ibm2030/EDUC8/E8Serial/Video terminal /ConstructionPack/Terminal.jpg

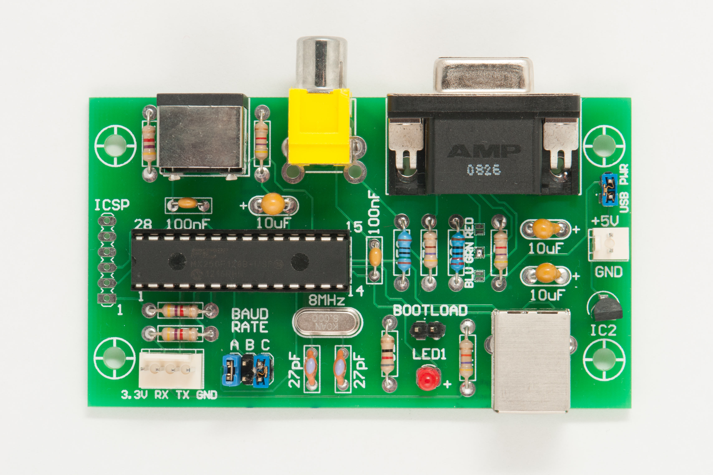
E8Serial/Video terminal /ConstructionPack/Terminal.jpg
