ibm2030/EDUC8/octal. keyboard/octal keyboard/assembled keyboard.jpeg

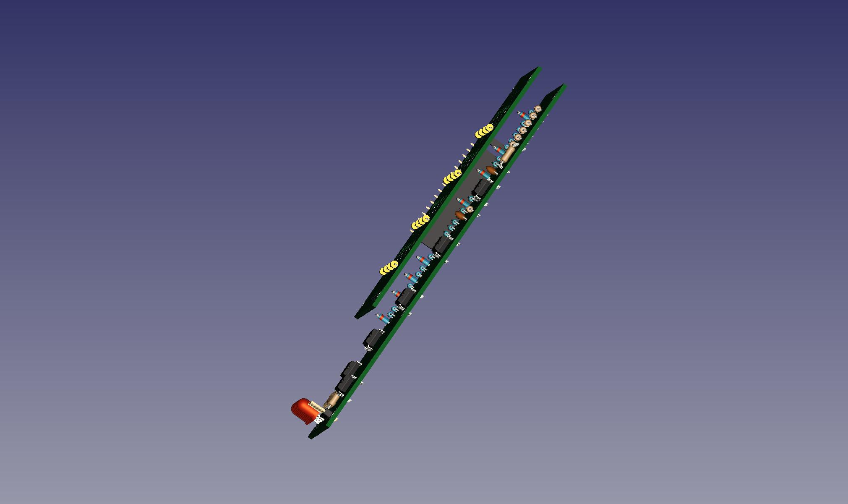
octal. keyboard/octal keyboard/assembled keyboard.jpeg
