ibm2030/EDUC8/README.md

# EDUC8
EDUC-8 recreation by Gwyllym Suter
