ibm2030/EDUC8/ASCII keyboard/DSAP008112.pdf

This Material Copyrighted By Its Respective Manufacturer
