ibm2030/EDUC8/256 word memory/2102.pdf - Google Drive.pdf

## Page 1 of 4

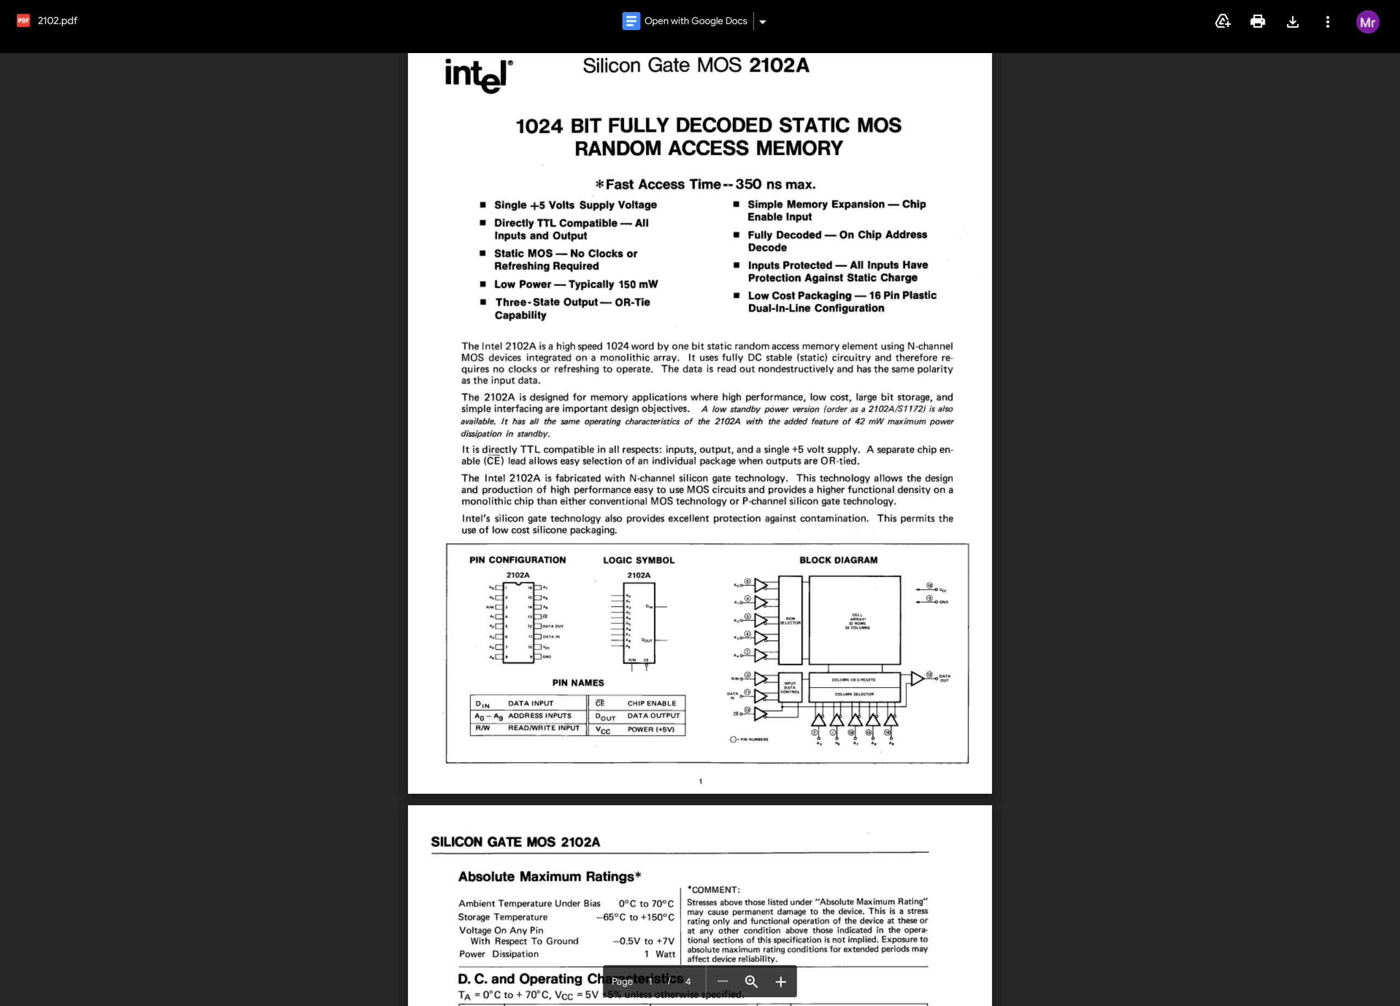
[picture p22: page 1]

## Page 2 of 4

Page | 1 | / | 4
2102.pdf | Open with Google Docs
