ibm2030/EDUC8/PC and ADDER 74LS74 MOD/7480.pdf

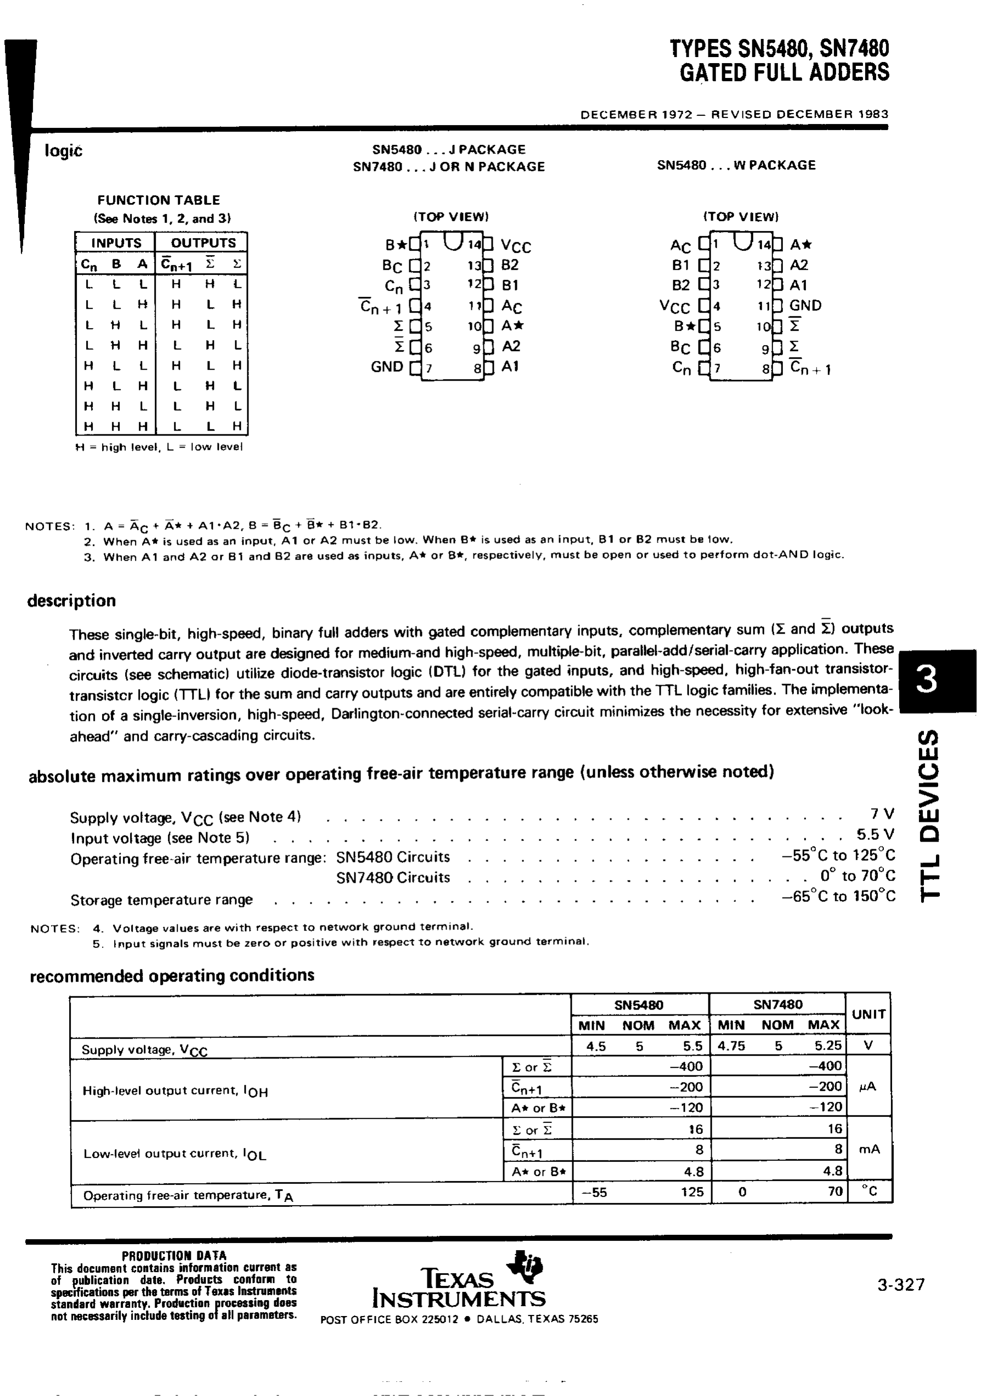
[picture p23: page 1]
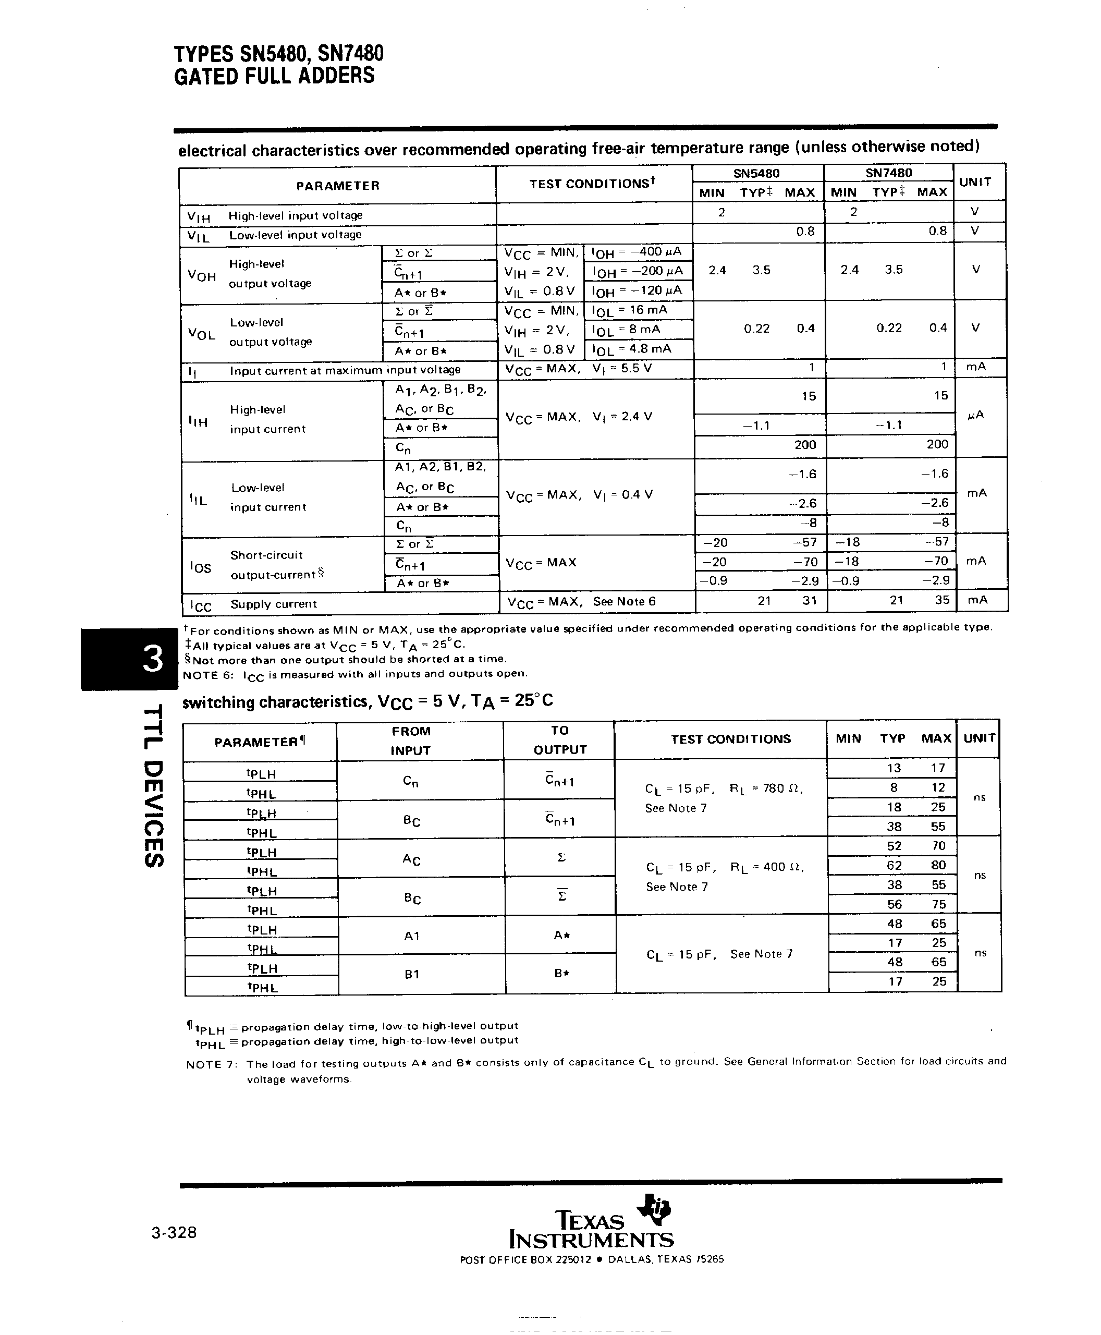
[picture p24: page 2]
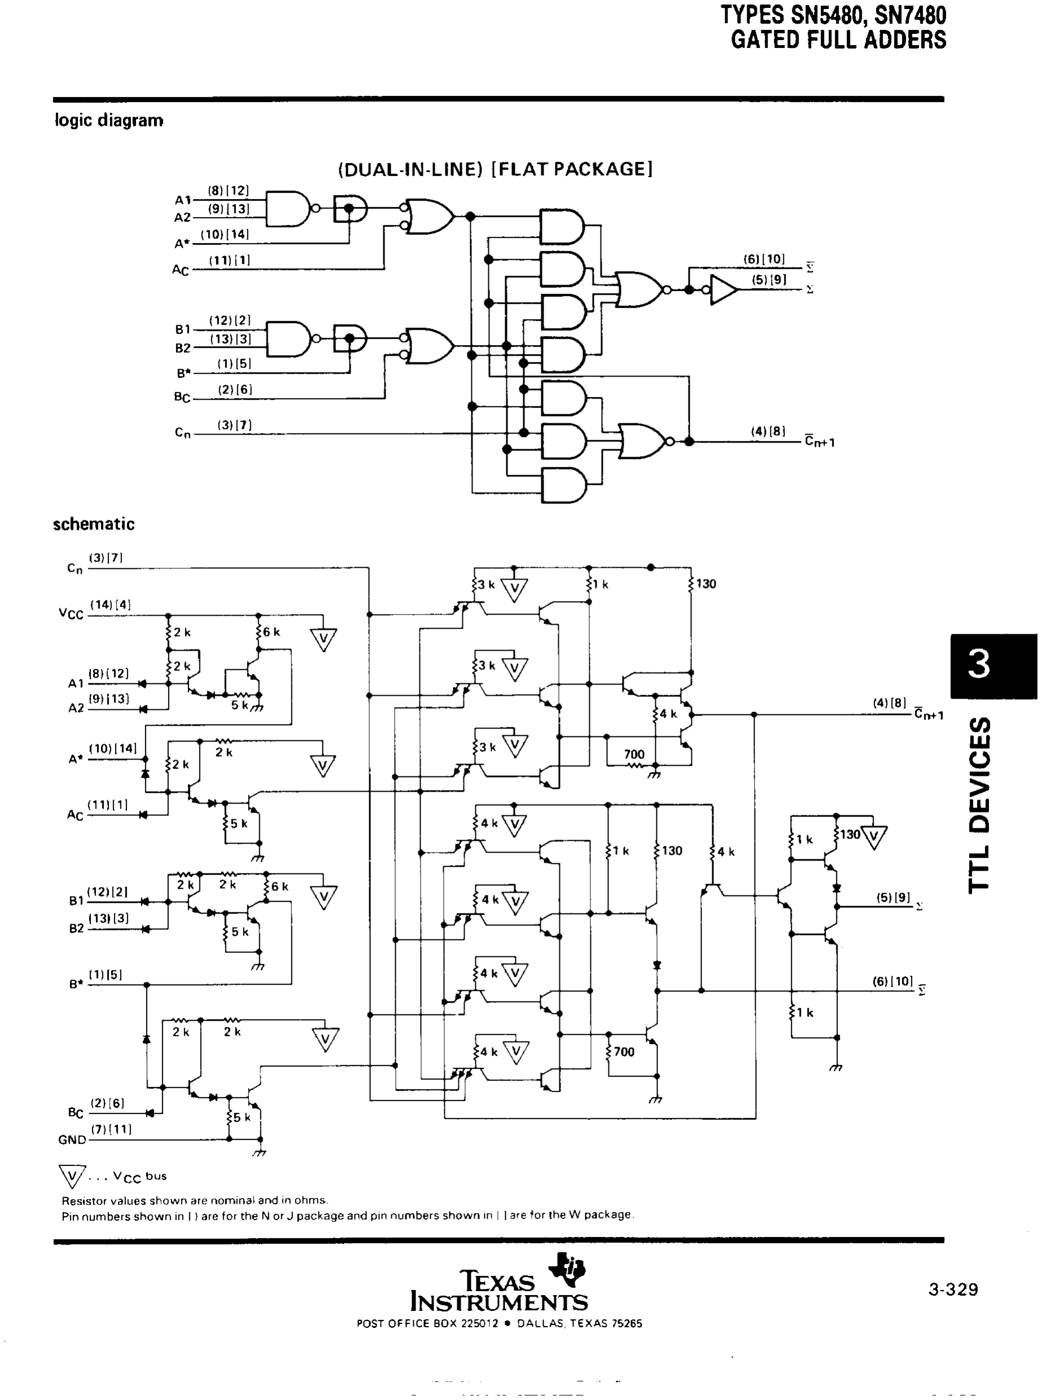
[picture p25: page 3]
