ibm2030/EDUC8/Octal display 2/DSA-300936.pdf

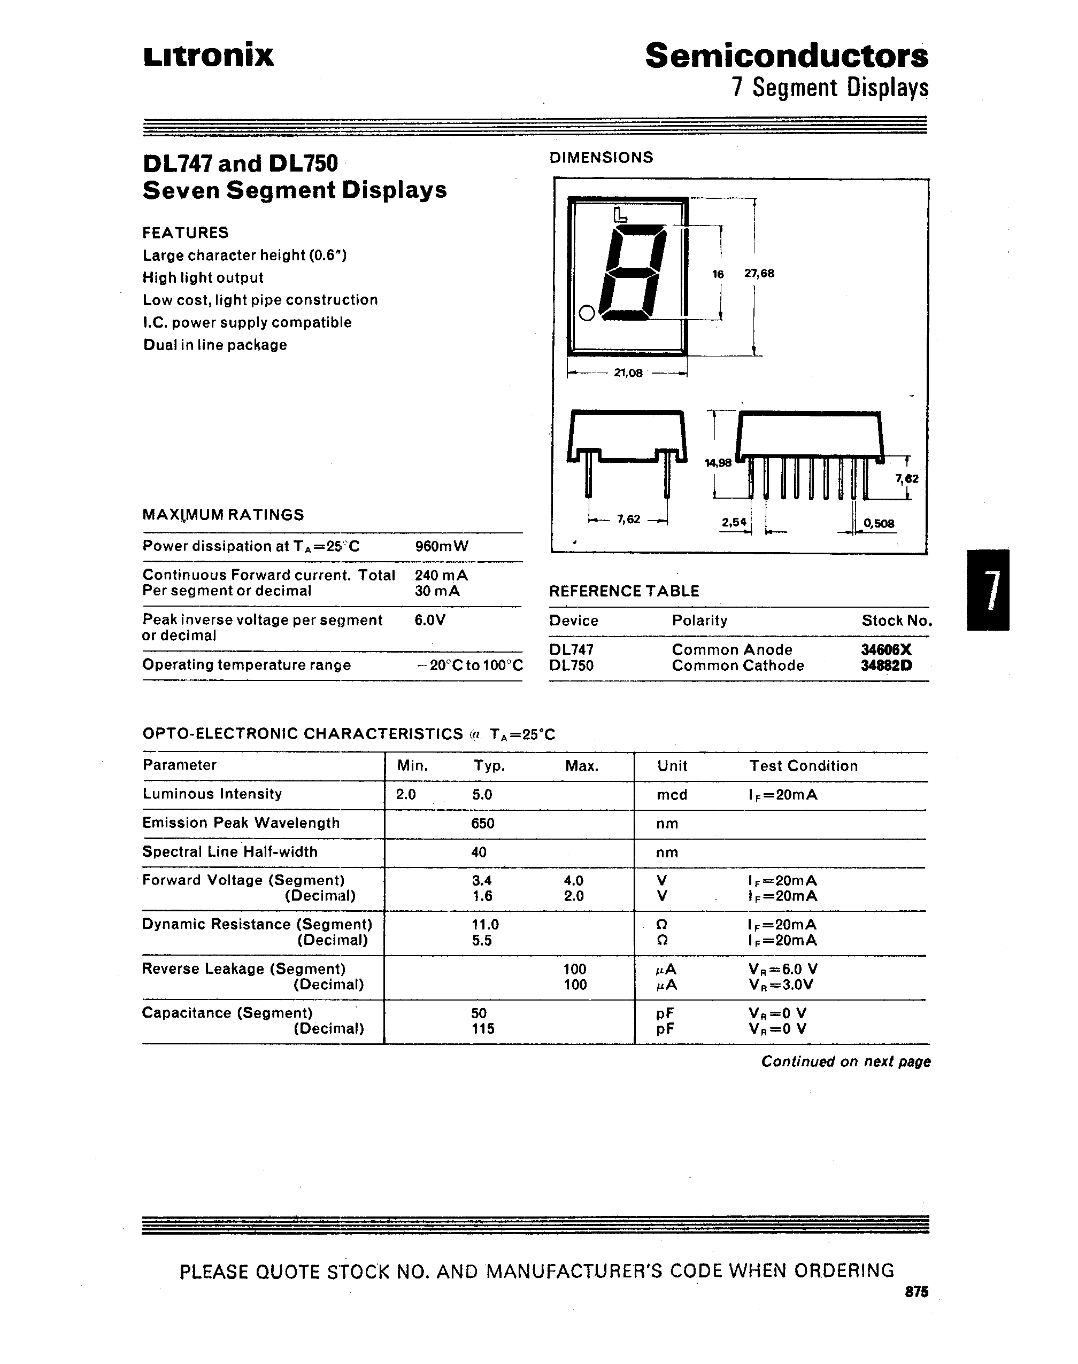
[picture p26: page 1]
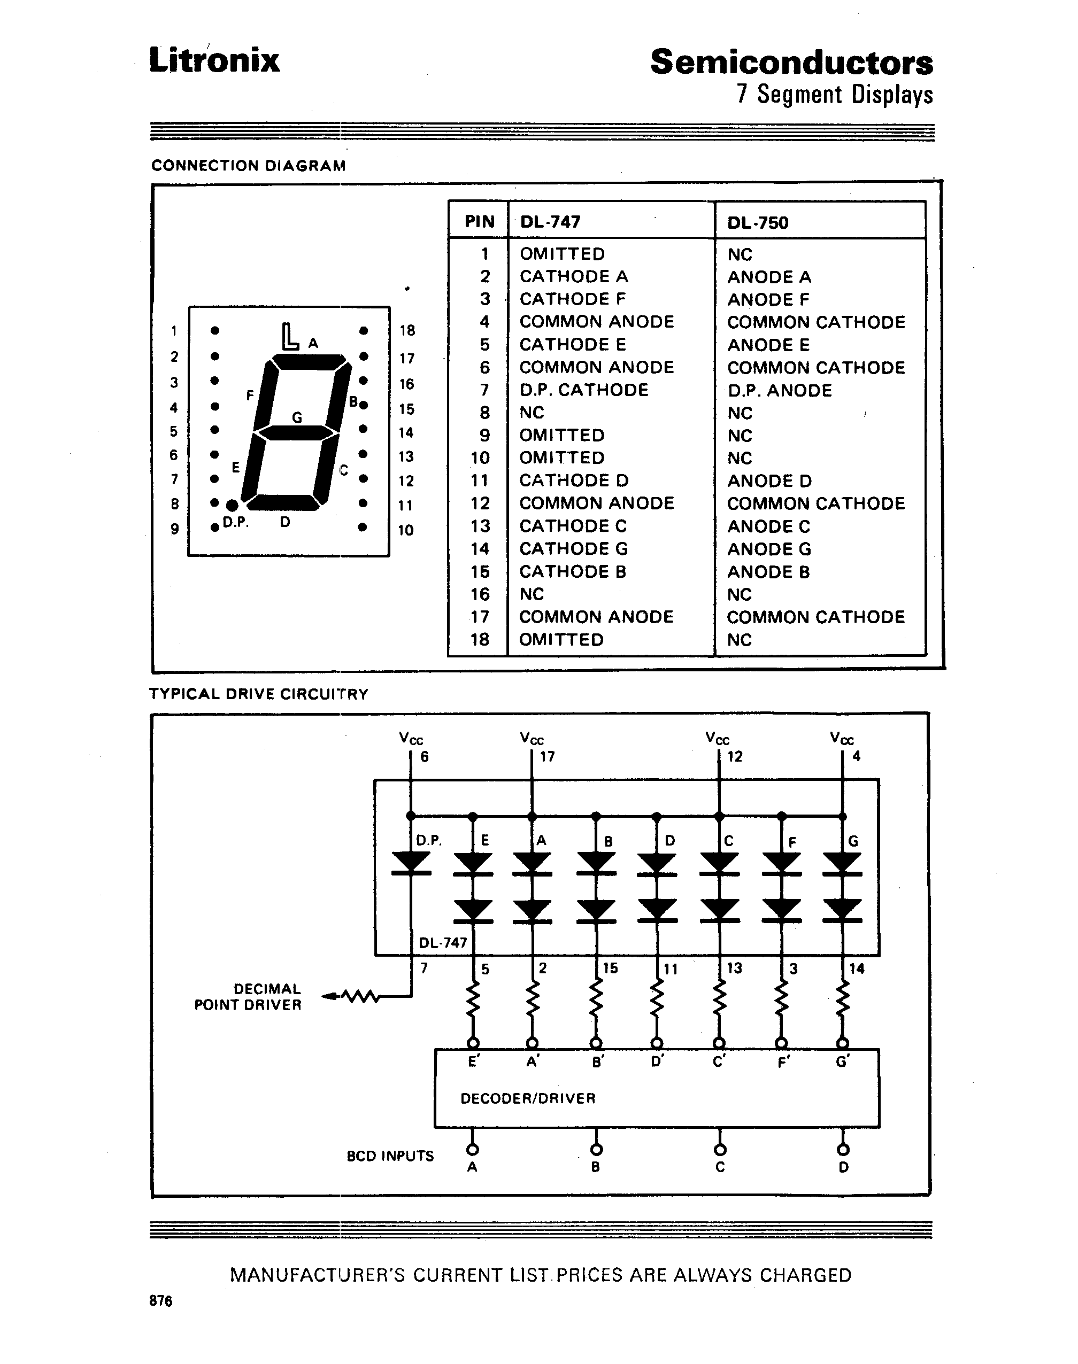
[picture p27: page 2]
