ibm2030/EDUC8/Music Player/DSA2IH0021361.pdf

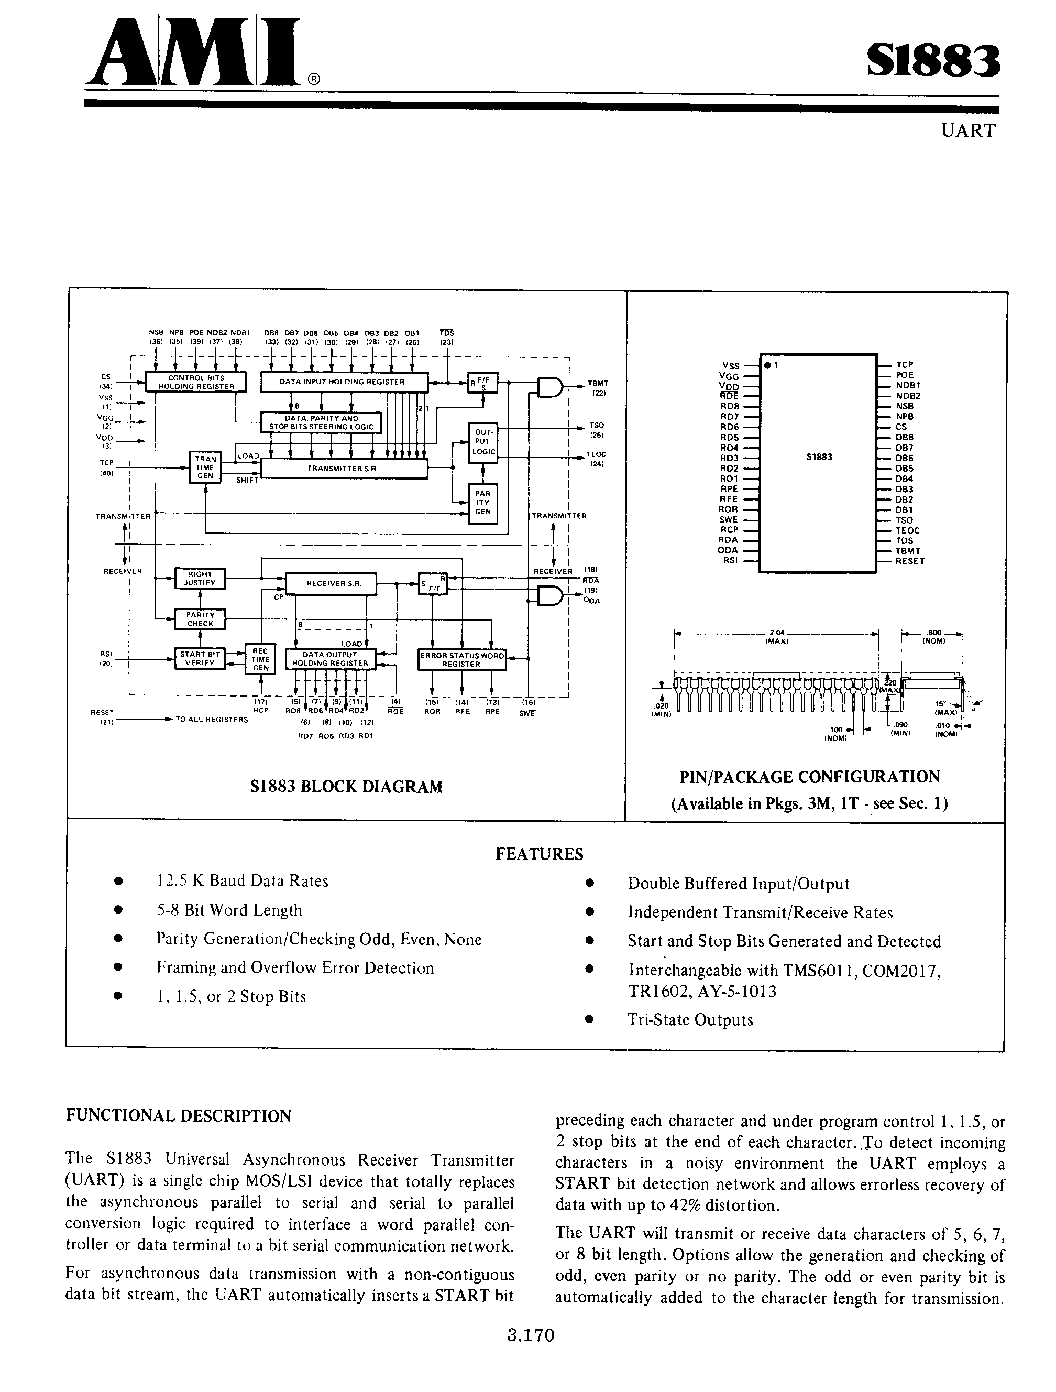
[picture p28: page 1]
