ibm2030/EDUC8/3D MODELS/din-5-connector-female-1/Renderings/IMG_002.JPG

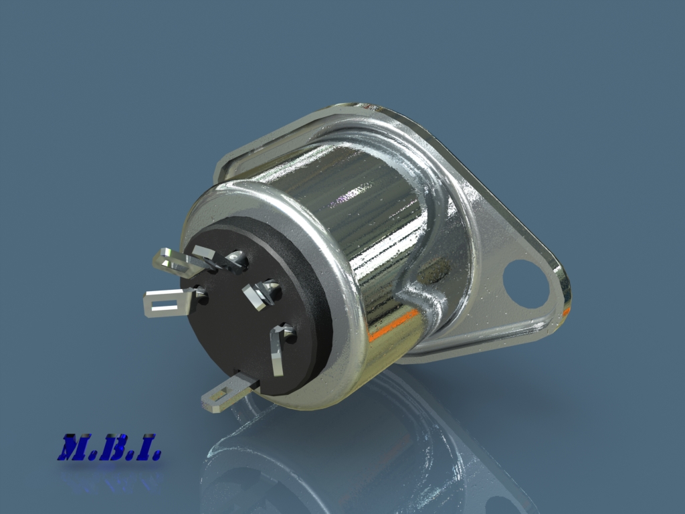
3D MODELS/din-5-connector-female-1/Renderings/IMG_002.JPG
