ibm2030/EDUC8/128 X 16 RAM V5 FINAL/128 X 16 RAM V4 FINAL .jpg

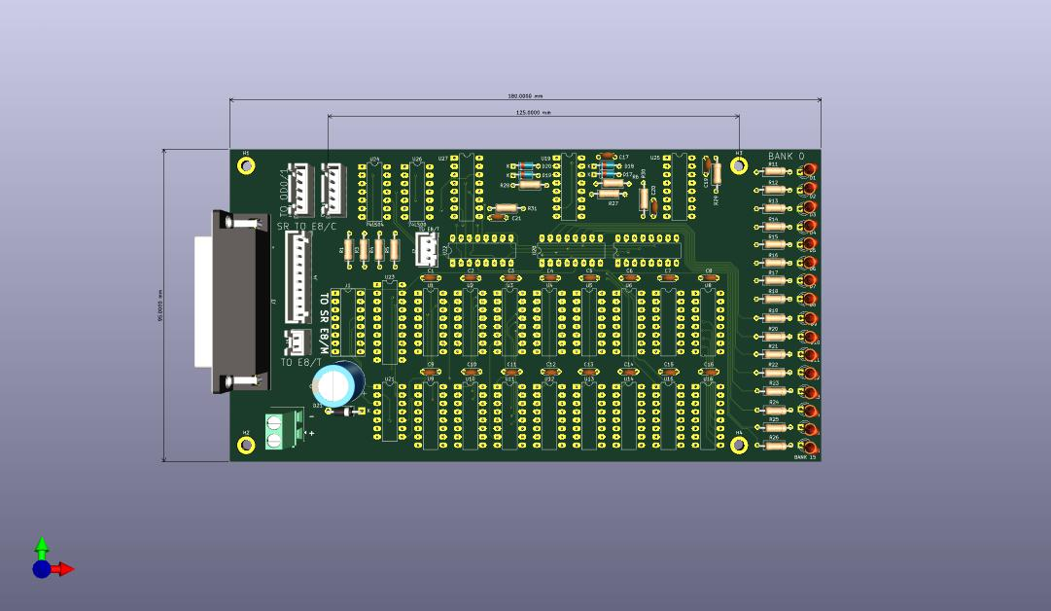
128 X 16 RAM V5 FINAL/128 X 16 RAM V4 FINAL .jpg
