ibm2030/EDUC8/256 word memory/256 word memory 2.0/256 word memory_2.0 bottom.jpg

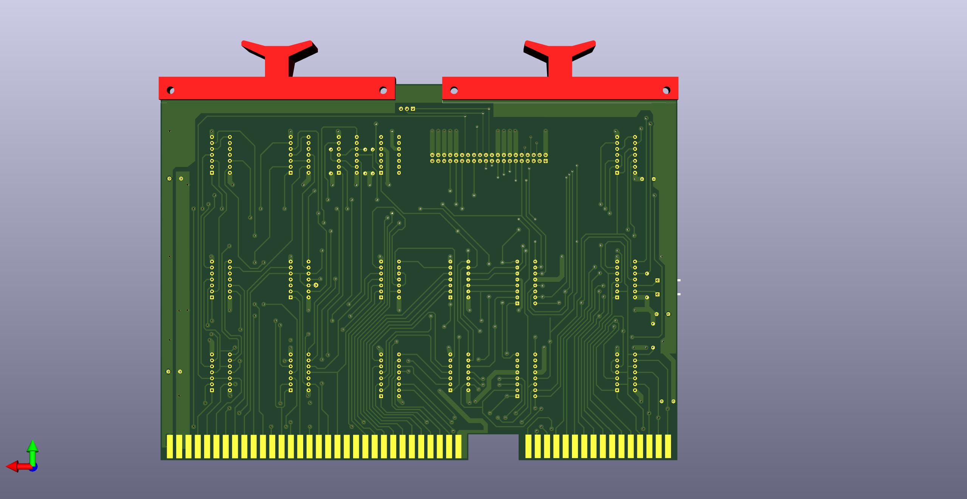
256 word memory/256 word memory 2.0/256 word memory_2.0 bottom.jpg
