ibm2030/EDUC8/256 word memory/256 word memory bottom.jpg

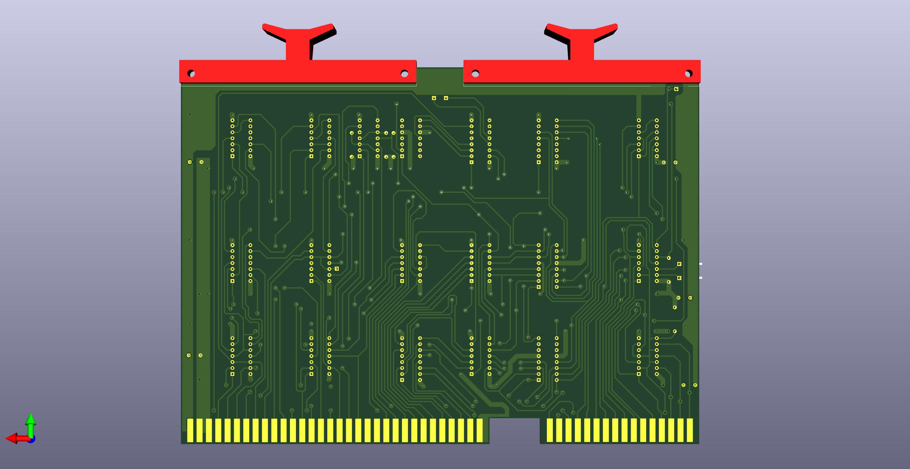
256 word memory/256 word memory bottom.jpg
