ibm2030/EDUC8/256 word memory/256 word memory.jpg

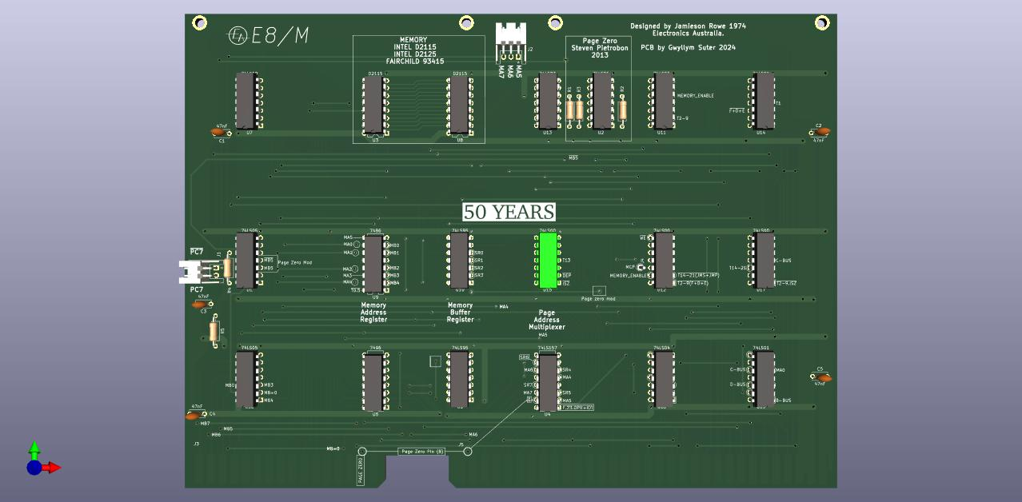
256 word memory/256 word memory.jpg
