ibm2030/EDUC8/20240601_193604.jpeg

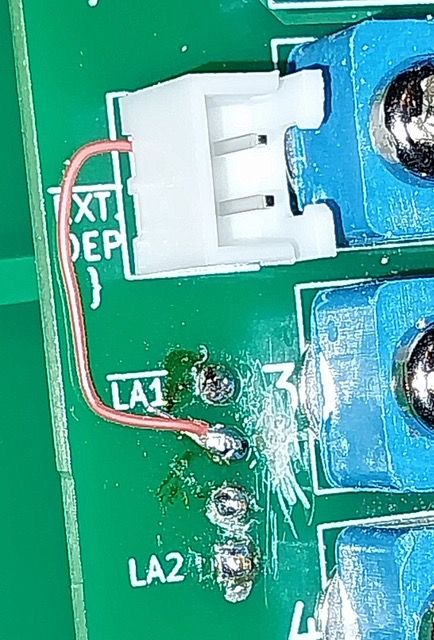
20240601_193604.jpeg
