ibm2030/EDUC8/Accumulator/Accumulator bottom.jpg

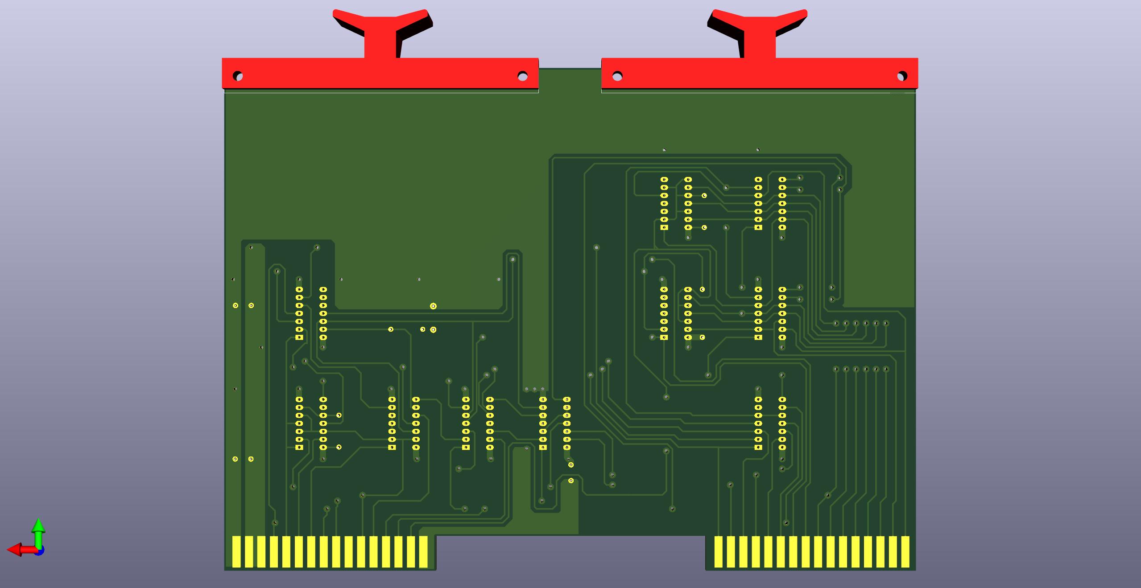
Accumulator/Accumulator bottom.jpg
