ibm2030/EDUC8/Accumulator/Accumulator top.jpg

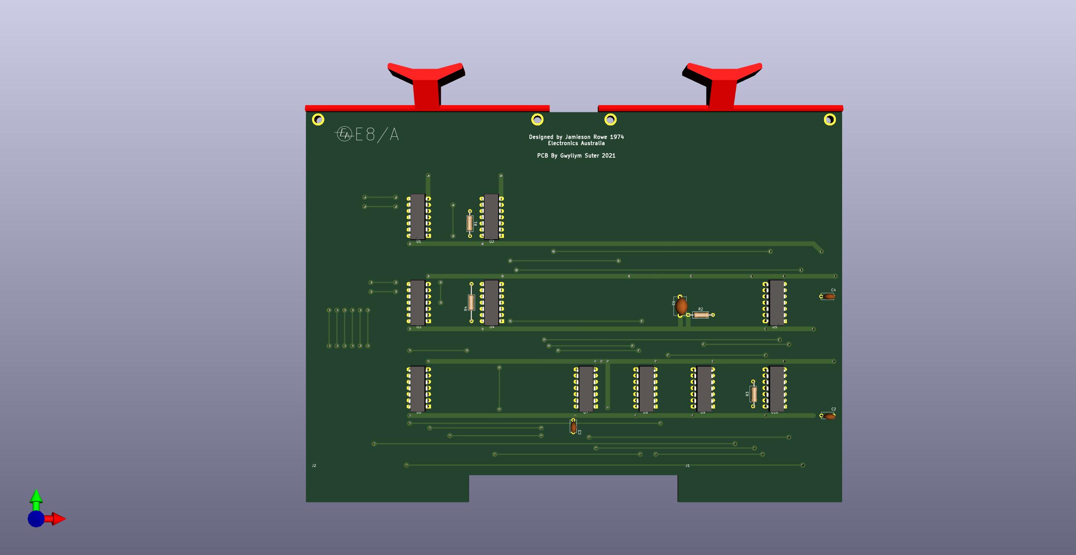
Accumulator/Accumulator top.jpg
