ibm2030/EDUC8/Accumulator/Accumulator.jpg

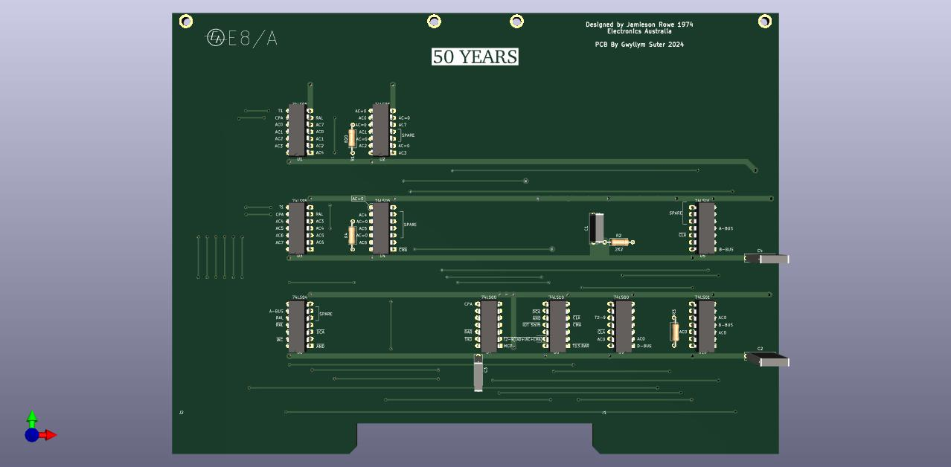
Accumulator/Accumulator.jpg
