ibm2030/EDUC8/ASCII keyboard/ASCII keyboard bottom..jpg

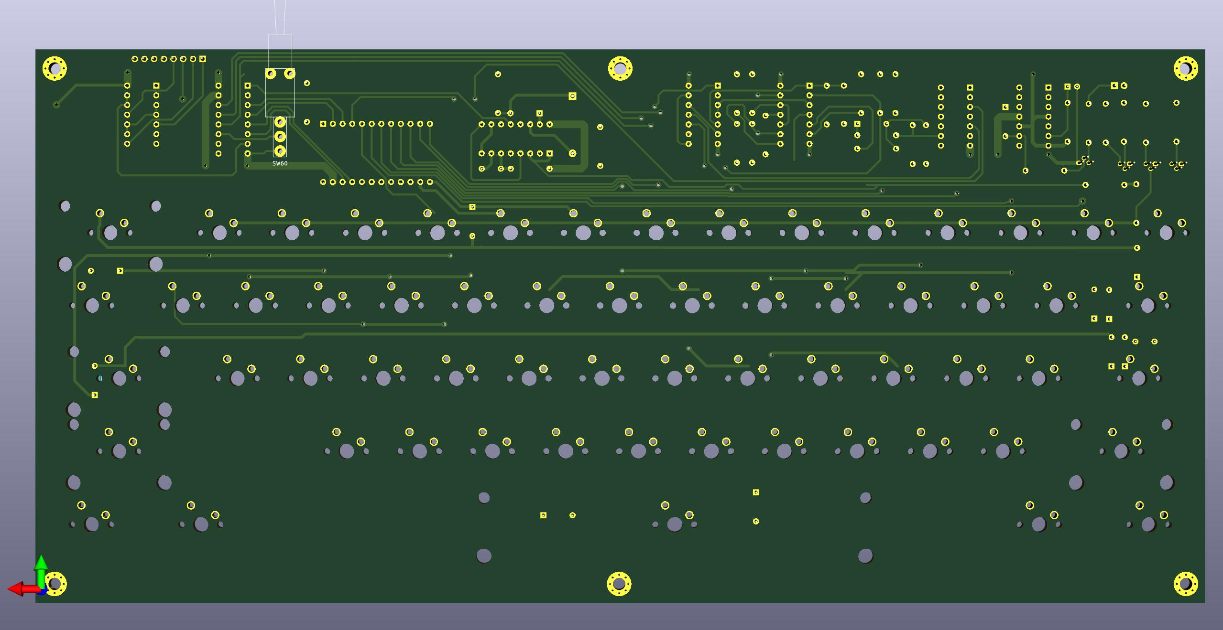
ASCII keyboard/ASCII keyboard bottom..jpg
