ibm2030/EDUC8/ASCII keyboard/ASCII keyboard.jpg

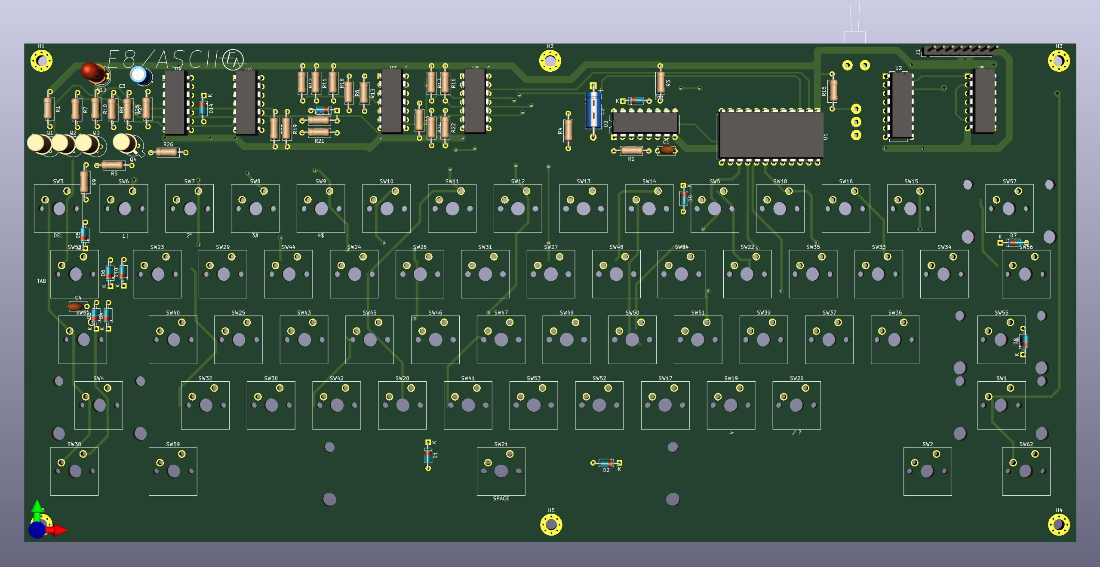
ASCII keyboard/ASCII keyboard.jpg
