ibm2030/EDUC8/ASCII keyboard/ASCII keyboard_bottom.jpg

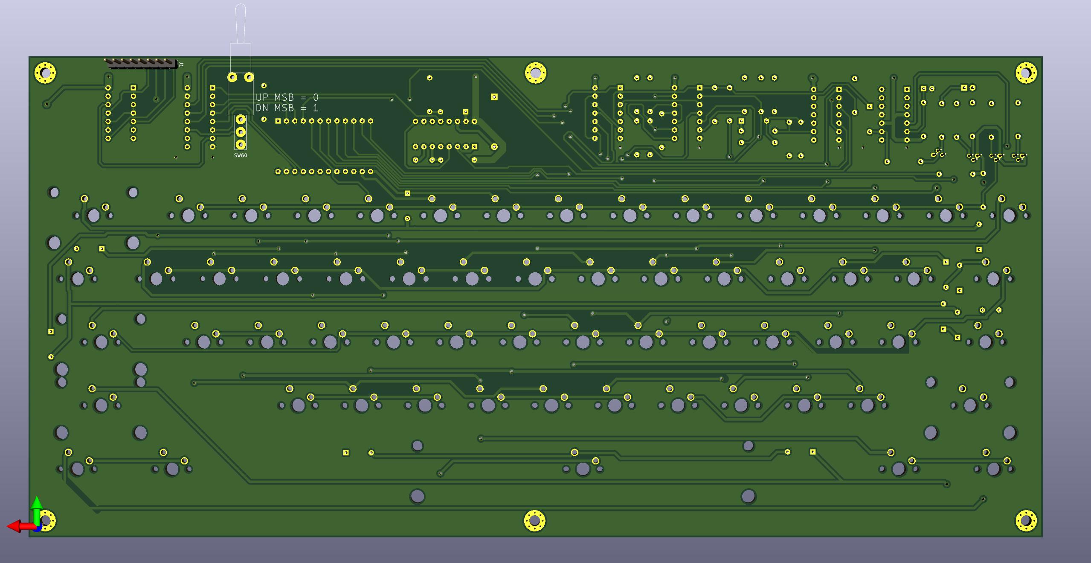
ASCII keyboard/ASCII keyboard_bottom.jpg
