ibm2030/EDUC8/ASCII keyboard/ASCII keyboard_top.jpg

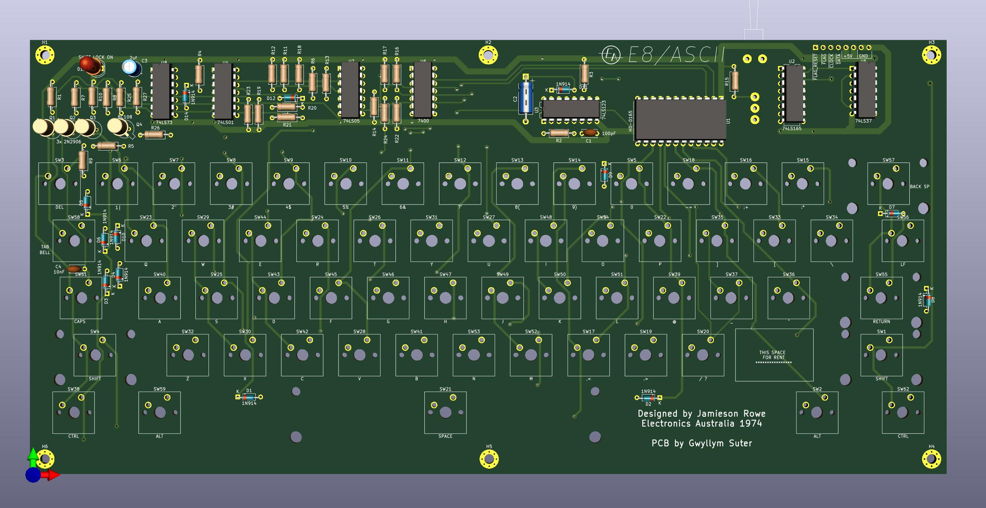
ASCII keyboard/ASCII keyboard_top.jpg
