ibm2030/EDUC8/Buffer/Buffer bottom.jpg

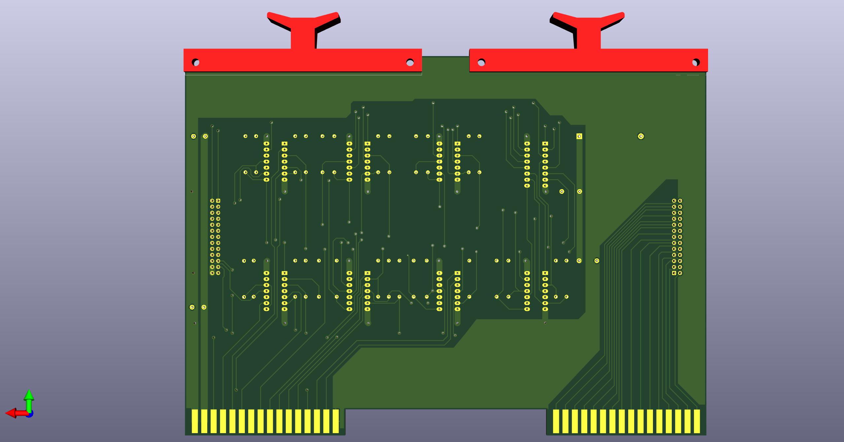
Buffer/Buffer bottom.jpg
