ibm2030/EDUC8/Buffer/Buffer.jpg

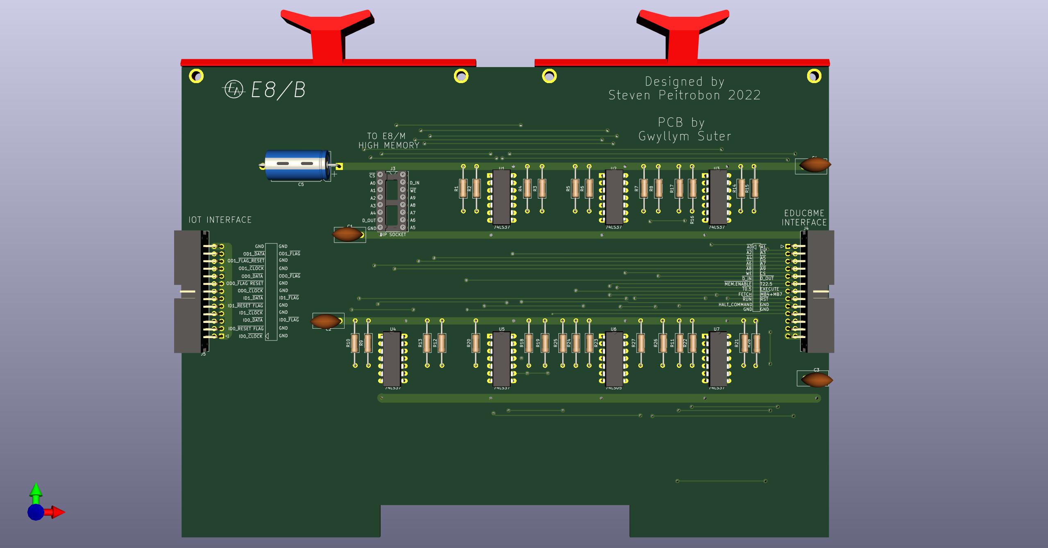
Buffer/Buffer.jpg
