ibm2030/EDUC8/Decoder/educ 8 decoder bottom.jpg

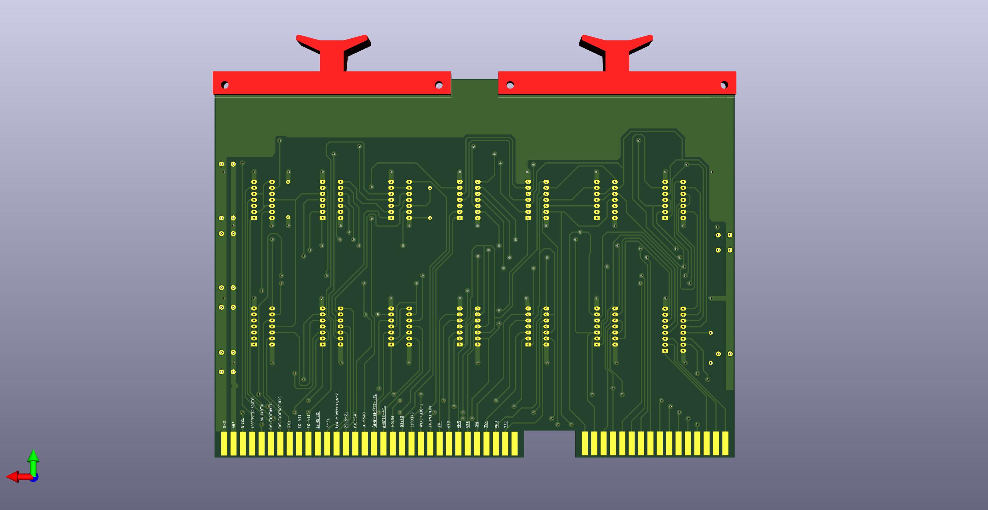
Decoder/educ 8 decoder bottom.jpg
