ibm2030/EDUC8/Decoder/educ 8 decoder top.jpg

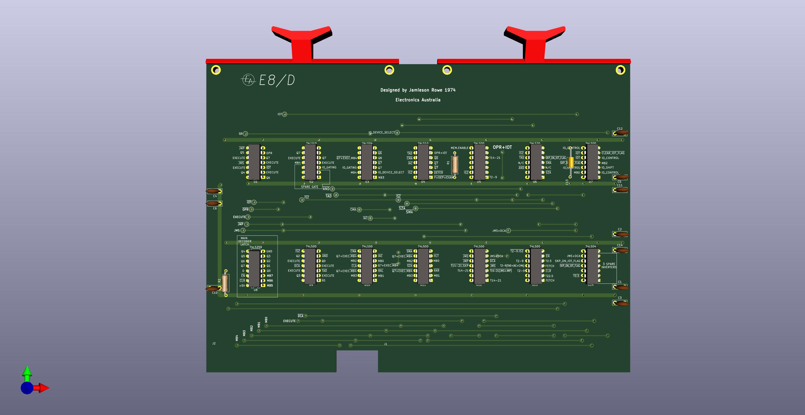
Decoder/educ 8 decoder top.jpg
