ibm2030/EDUC8/Decoder/educ 8 decoder.jpg

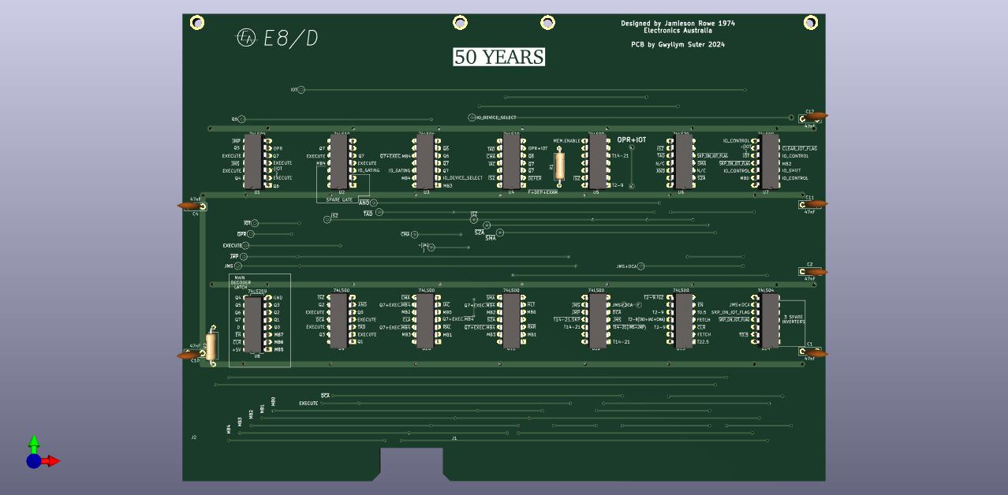
Decoder/educ 8 decoder.jpg
