ibm2030/EDUC8/Decoder/educ 8 decoder_bottom.jpg

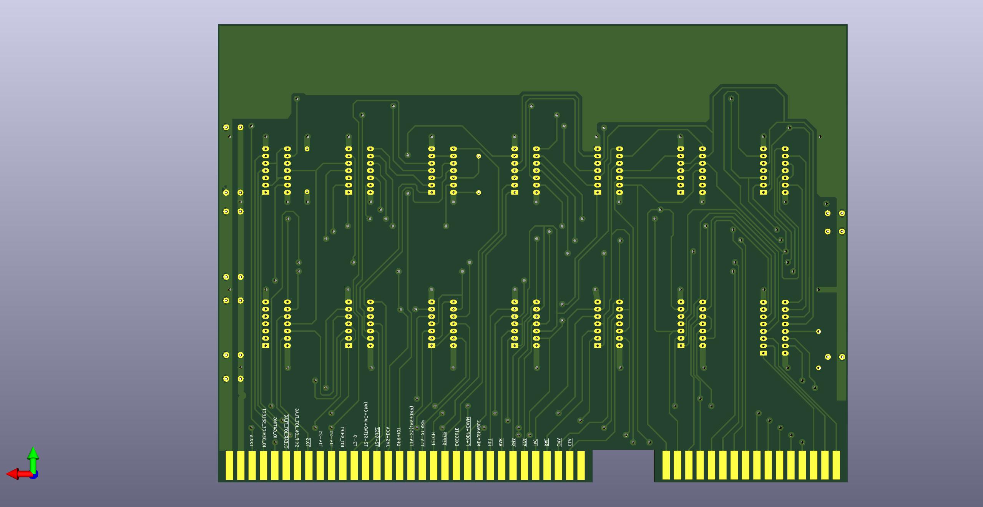
Decoder/educ 8 decoder_bottom.jpg
