ibm2030/EDUC8/E8Serial/Video terminal /ConstructionPack/Schematic V3.png

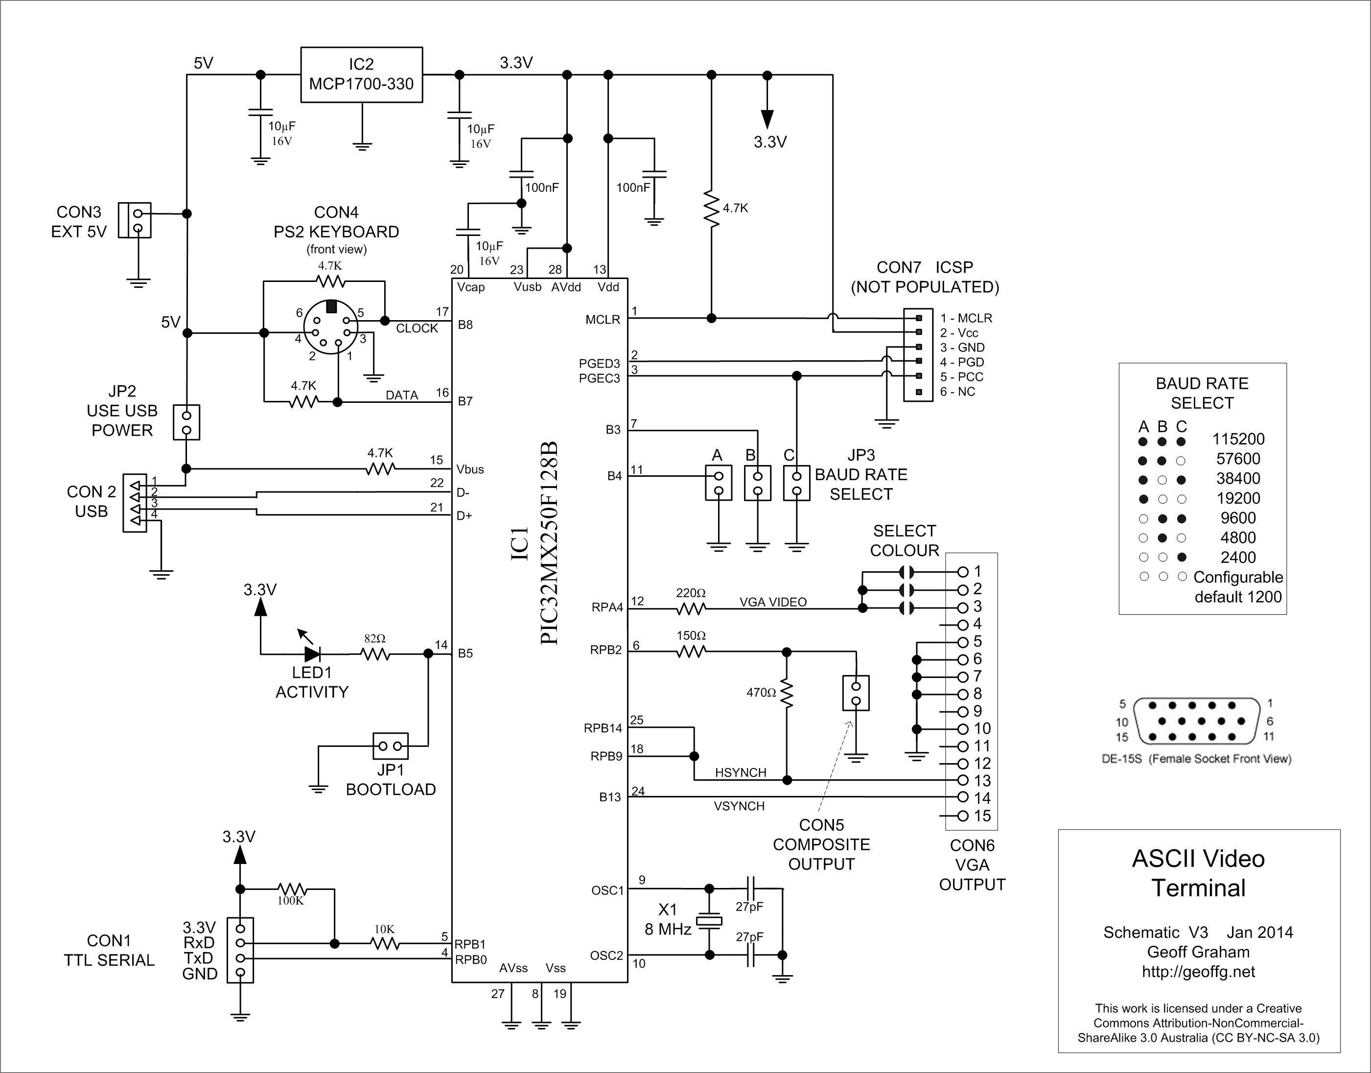
E8Serial/Video terminal /ConstructionPack/Schematic V3.png
