ibm2030/EDUC8/E8Serial/Video terminal /final video.jpeg

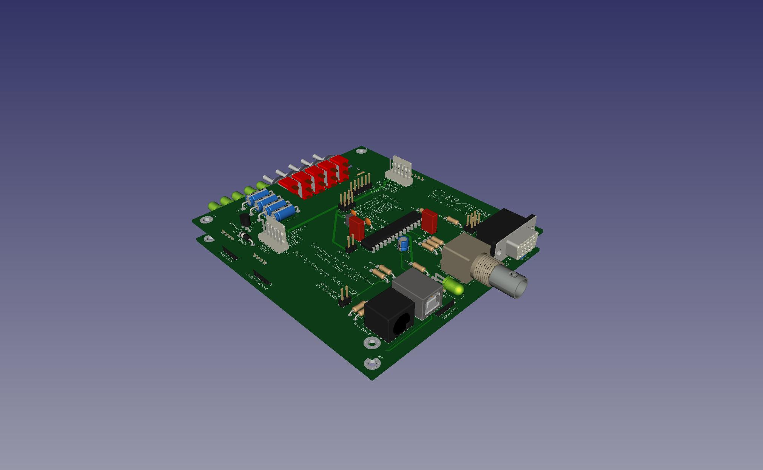
E8Serial/Video terminal /final video.jpeg
