ibm2030/EDUC8/E8Serial/Video terminal /Video terminal bottom.jpg

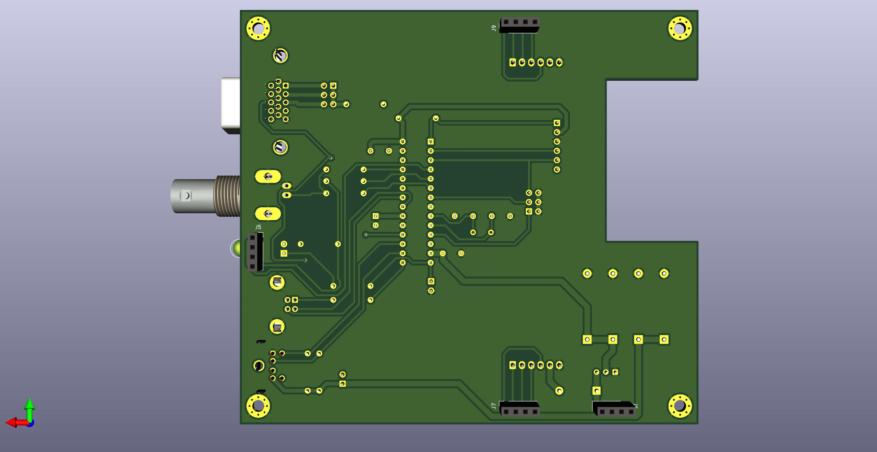
E8Serial/Video terminal /Video terminal bottom.jpg
