ibm2030/EDUC8/EXTENDER CARDS/EXTENDER CARD_BOTTOM.jpg

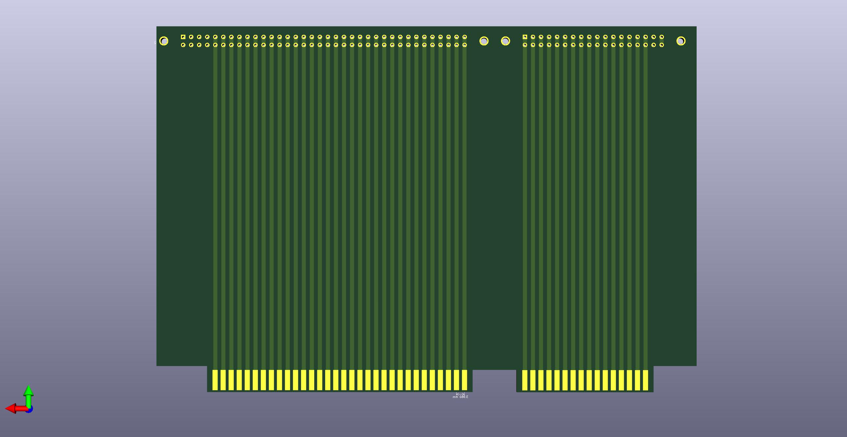
EXTENDER CARDS/EXTENDER CARD_BOTTOM.jpg
