ibm2030/EDUC8/EXTENDER CARDS/EXTENDER CARD_TOP.jpg

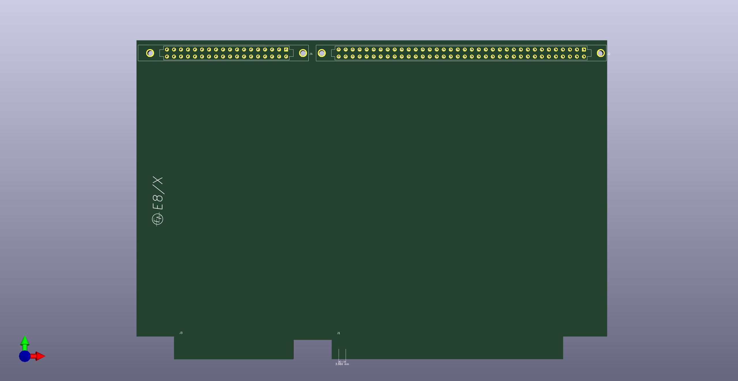
EXTENDER CARDS/EXTENDER CARD_TOP.jpg
