ibm2030/EDUC8/Front panel PCB/Front panel/Front panel.jpg

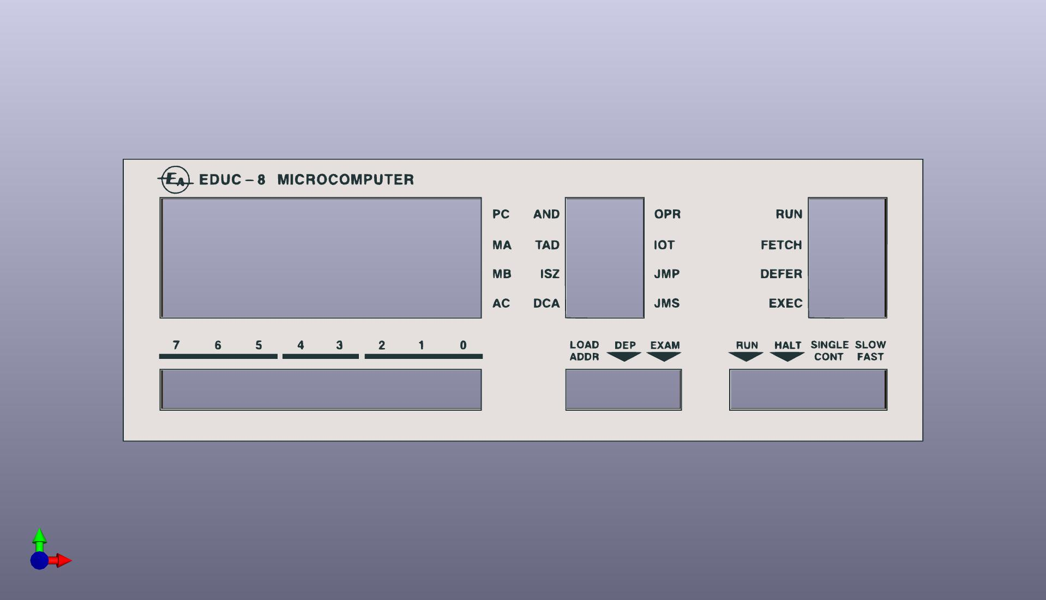
Front panel PCB/Front panel/Front panel.jpg
