ibm2030/EDUC8/front panel/Original with 9602/front panel 9602 bottom.jpg

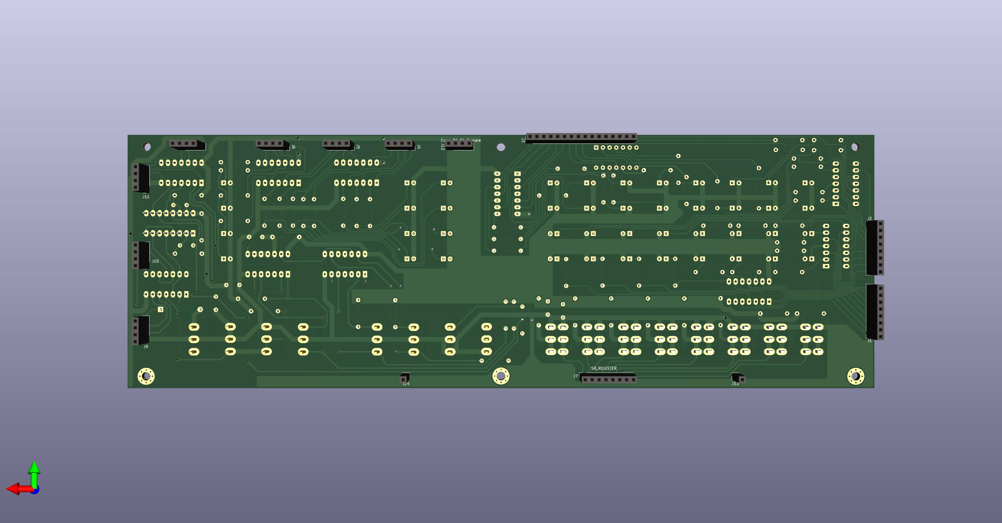
front panel/Original with 9602/front panel 9602 bottom.jpg
