ibm2030/EDUC8/Housing/switch lever/Blue swtich lever.jpeg

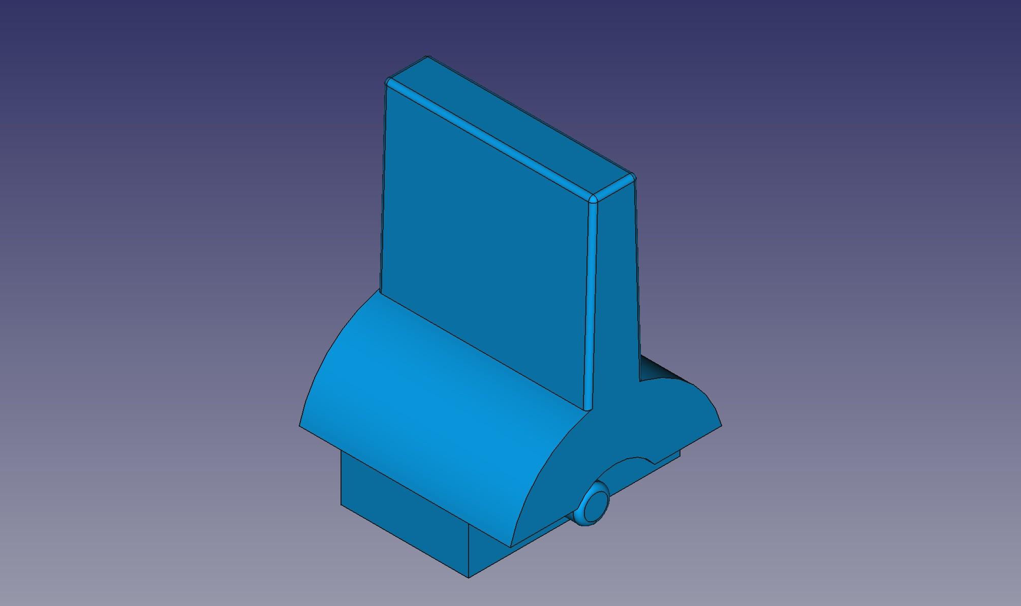
Housing/switch lever/Blue swtich lever.jpeg
