ibm2030/EDUC8/Housing/switch lever/Green switch lever.jpeg

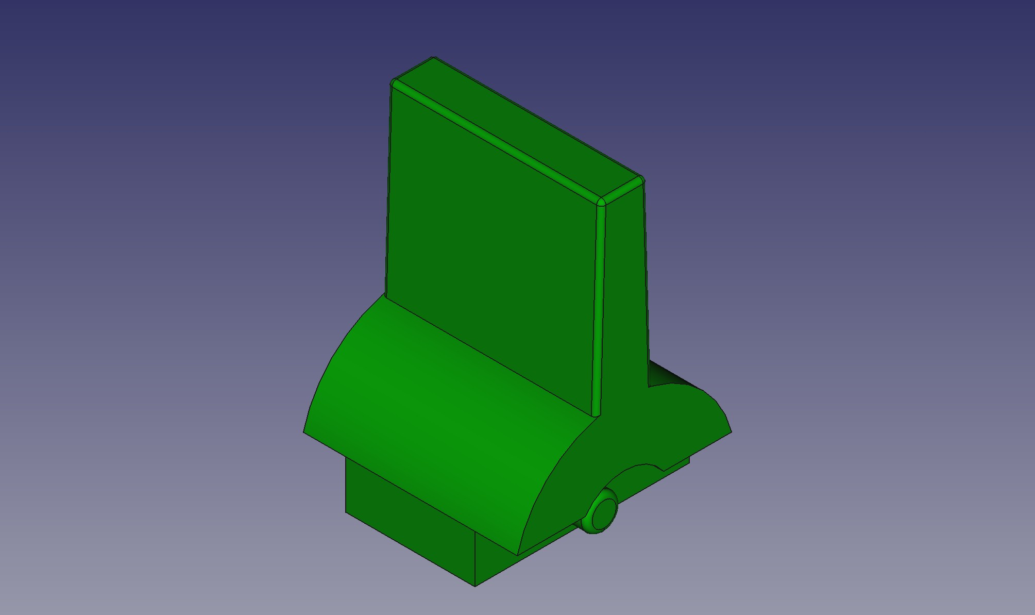
Housing/switch lever/Green switch lever.jpeg
