ibm2030/EDUC8/Input:Output Interface/Input:Output Interface.jpg

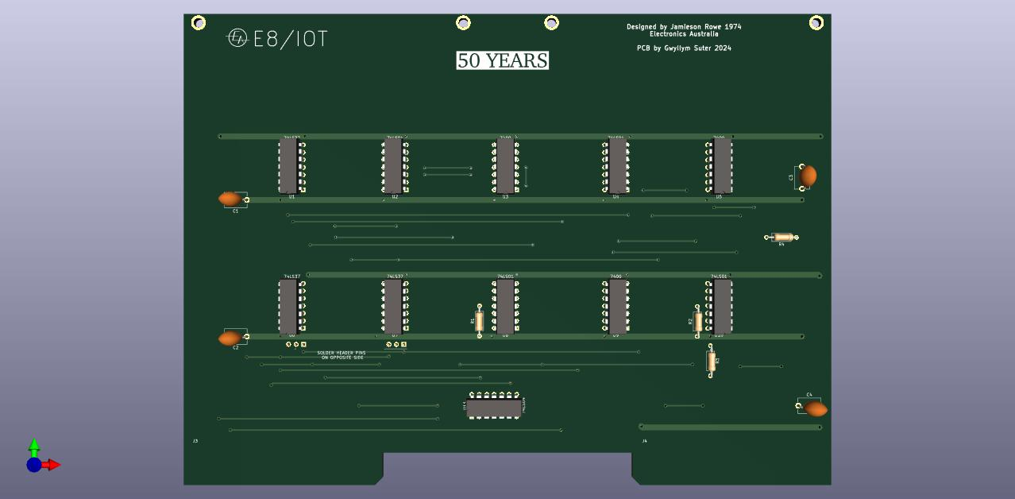
Input:Output Interface/Input:Output Interface.jpg
