ibm2030/EDUC8/motherboard/motherboard bottom.jpg

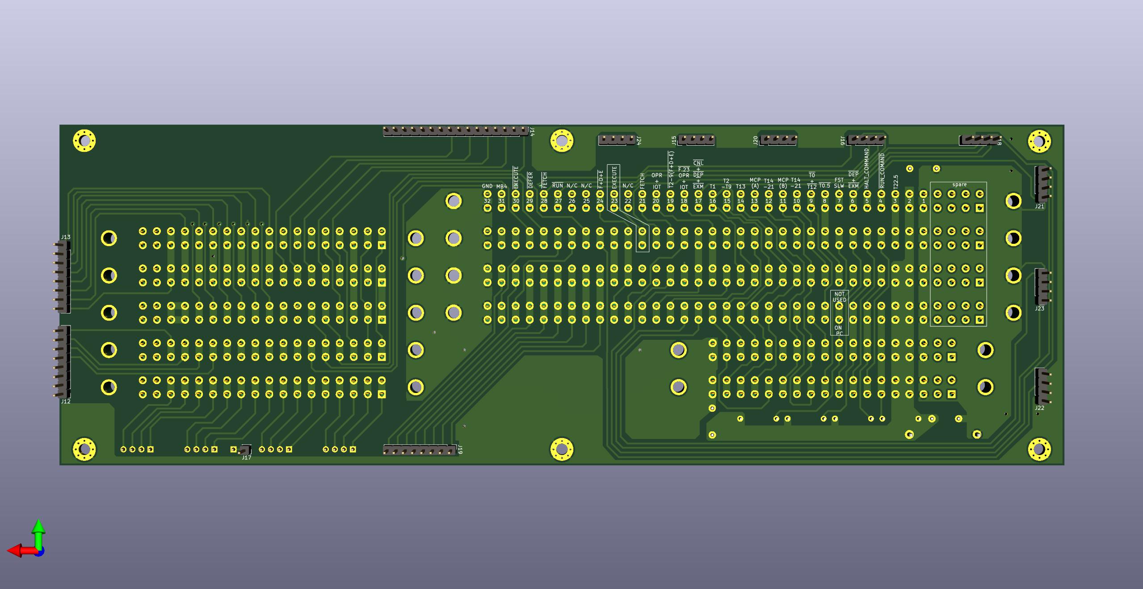
motherboard/motherboard bottom.jpg
