ibm2030/EDUC8/motherboard/motherboard top.jpg

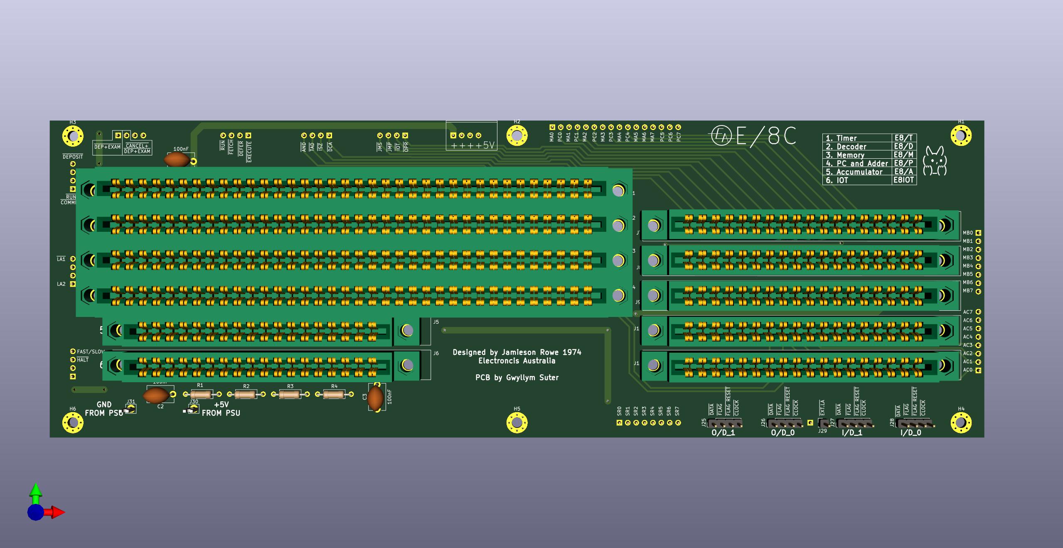
motherboard/motherboard top.jpg
