ibm2030/EDUC8/motherboard/motherboard.jpg

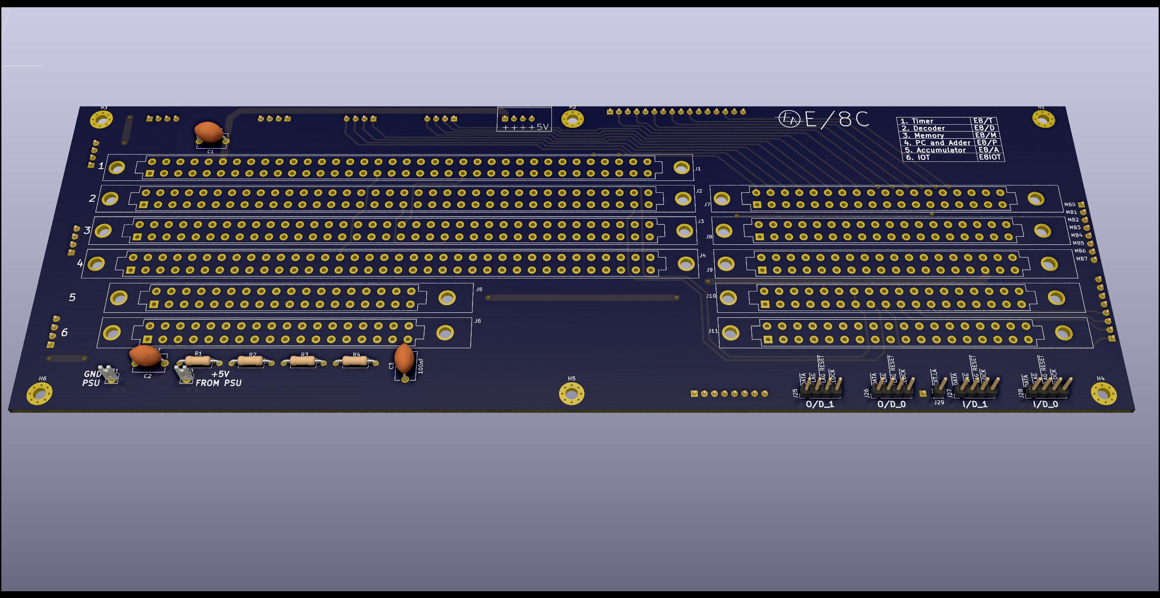
motherboard/motherboard.jpg
