ibm2030/EDUC8/motherboard/motherboard_bottom.jpg

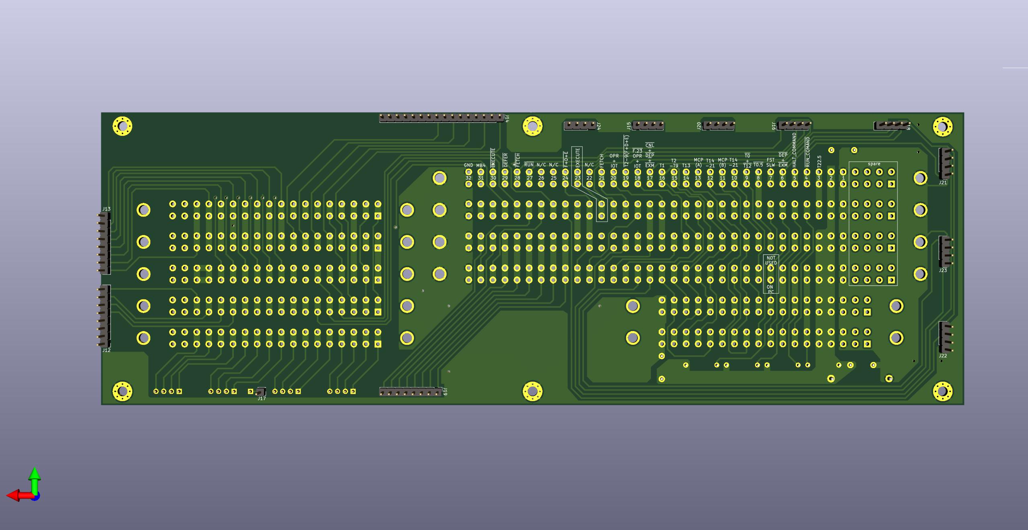
motherboard/motherboard_bottom.jpg
