ibm2030/EDUC8/multiplexer/E8MX:M/multiplexer bottom.jpg

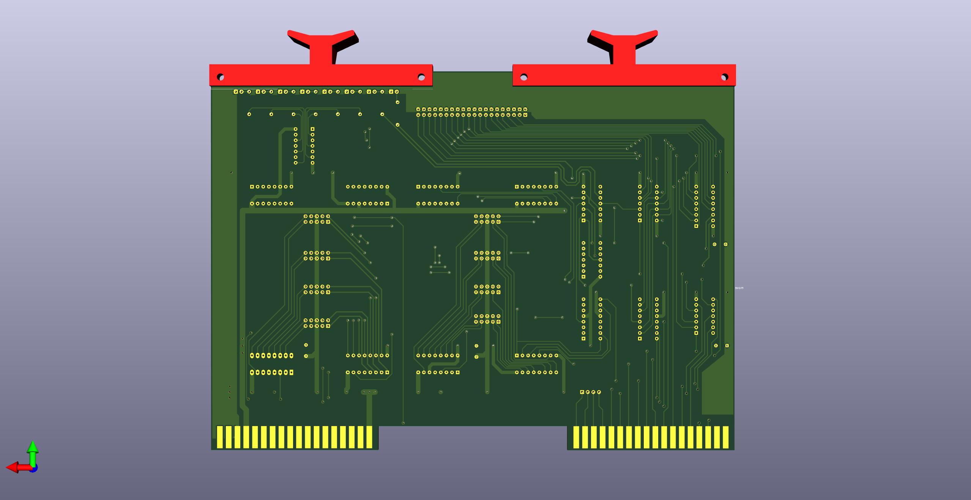
multiplexer/E8MX:M/multiplexer bottom.jpg
