ibm2030/EDUC8/multiplexer/E8MX:M/multiplexer top.jpg

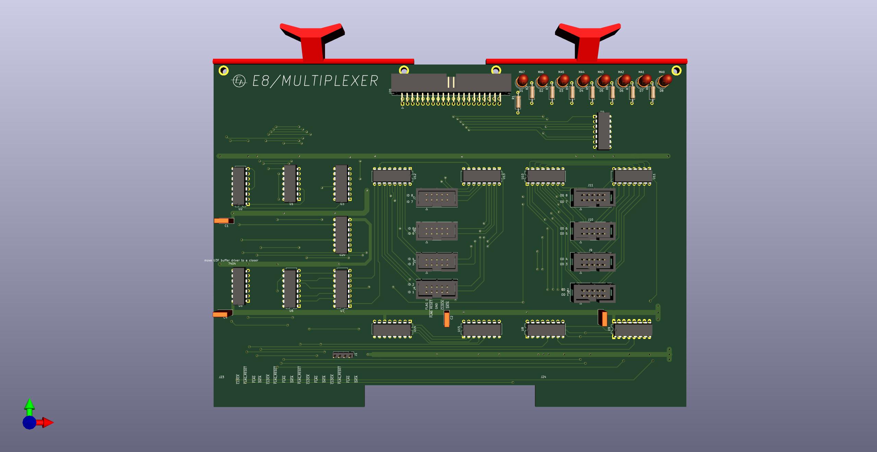
multiplexer/E8MX:M/multiplexer top.jpg
