ibm2030/EDUC8/multiplexer/E8MX:M/multiplexer.jpg

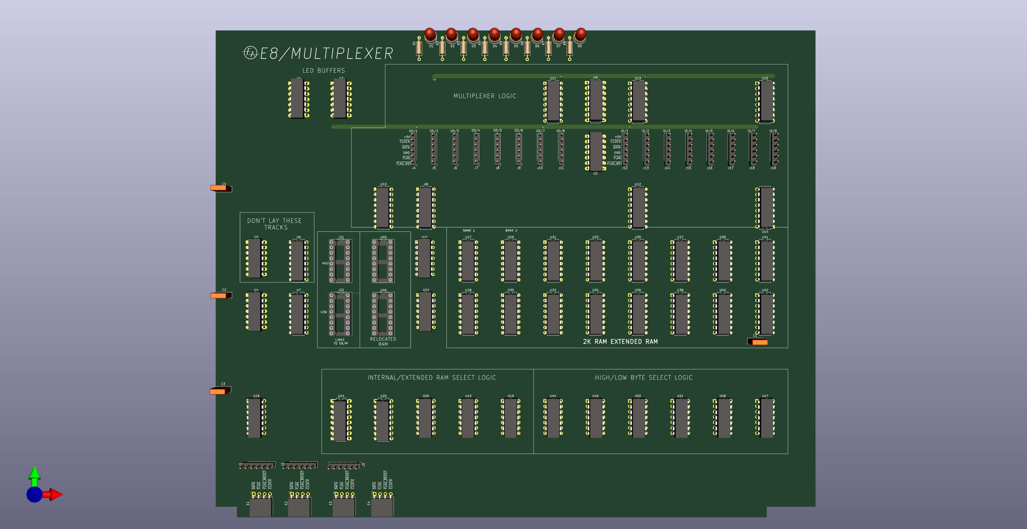
multiplexer/E8MX:M/multiplexer.jpg
