ibm2030/EDUC8/multiplexer/E8MX:M/multiplexer_BOTTOM.jpg

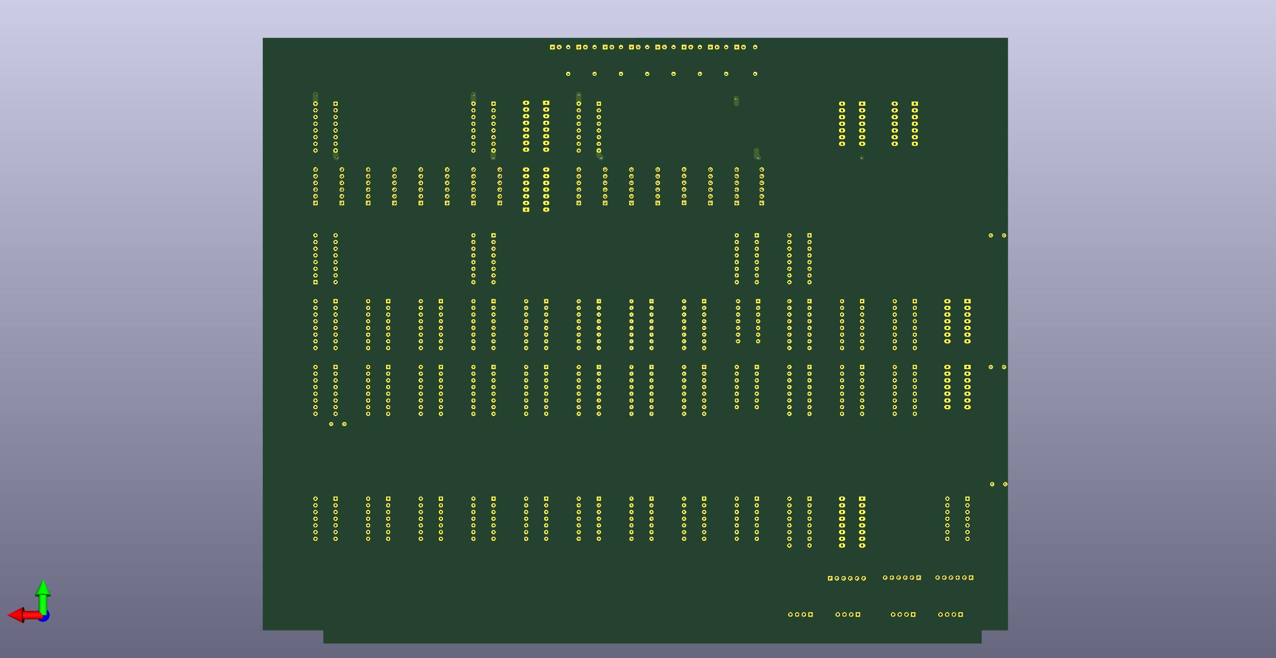
multiplexer/E8MX:M/multiplexer_BOTTOM.jpg
