ibm2030/EDUC8/multiplexer/E8MX:M/multiplexer_PLANNING-2.jpg

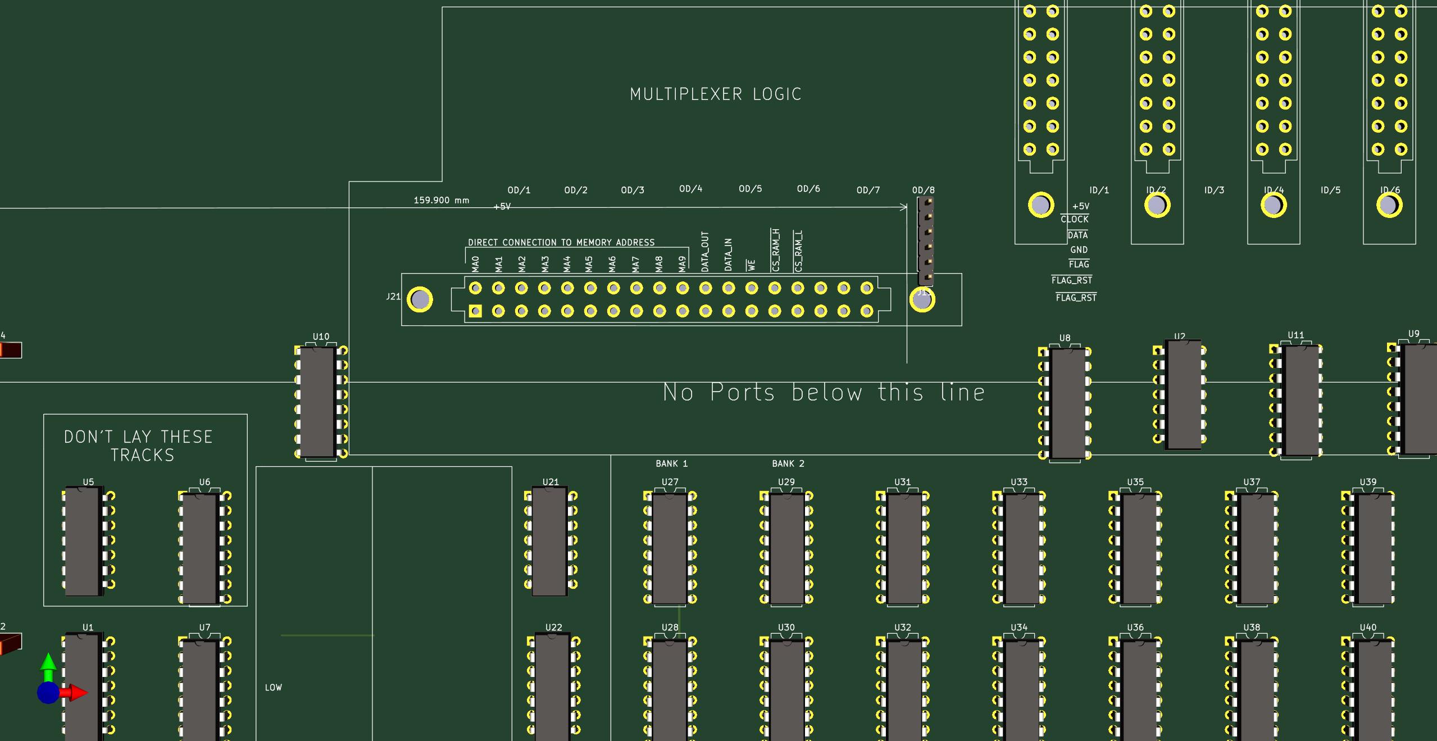
multiplexer/E8MX:M/multiplexer_PLANNING-2.jpg
