ibm2030/EDUC8/multiplexer/Rear connector board/Rear connector board bottom.jpg

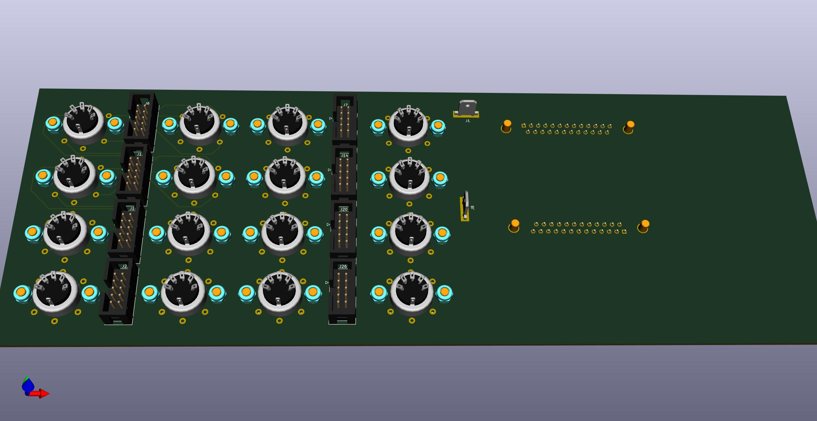
multiplexer/Rear connector board/Rear connector board bottom.jpg
