ibm2030/EDUC8/multiplexer/Rear connector board/Rear connector board top.jpg

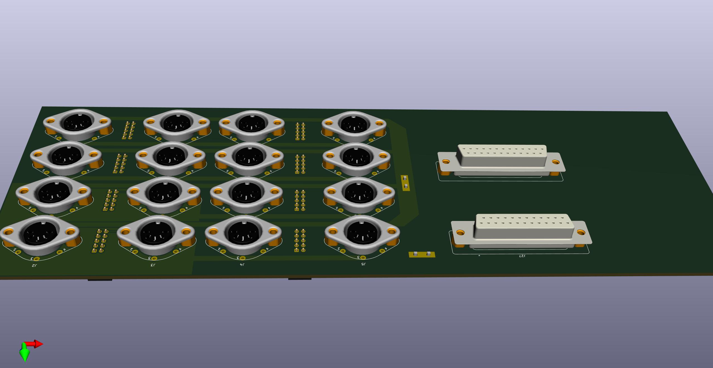
multiplexer/Rear connector board/Rear connector board top.jpg
