ibm2030/EDUC8/Octal display 2/Bit-FLASH-ADC-24.png

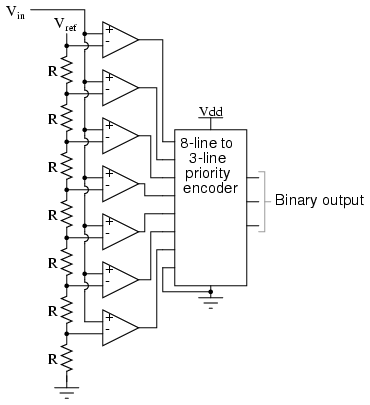
Octal display 2/Bit-FLASH-ADC-24.png
