ibm2030/EDUC8/Octal display 2/Octal display perspective.jpg

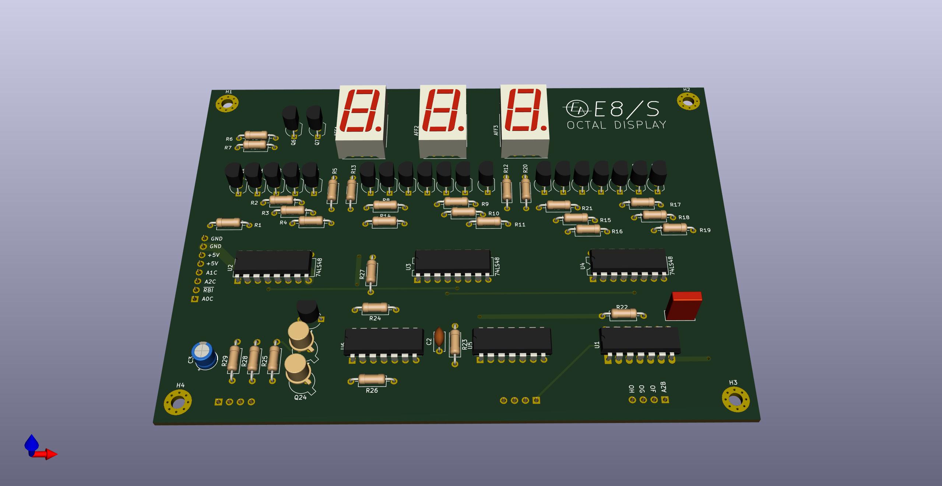
Octal display 2/Octal display perspective.jpg
