ibm2030/EDUC8/Octal display 2/Octal display_bottom.jpg

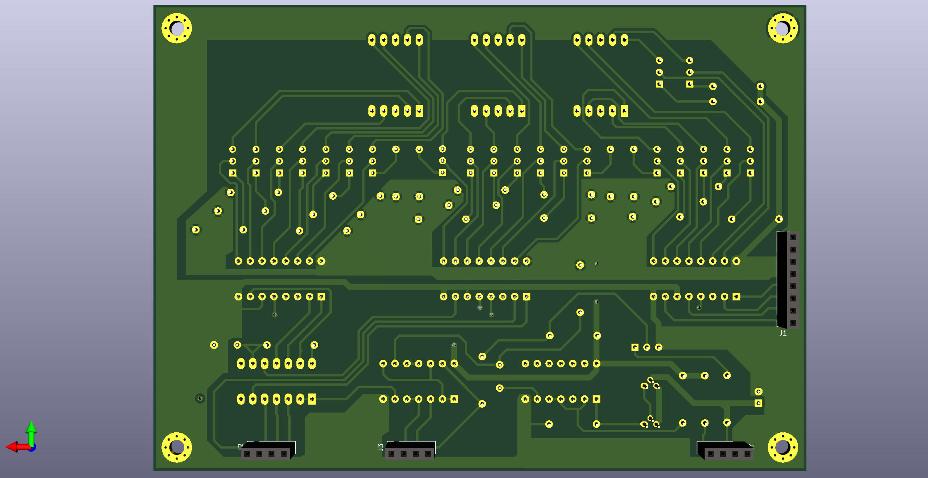
Octal display 2/Octal display_bottom.jpg
