ibm2030/EDUC8/Octal display 2/Octal display_top.jpg

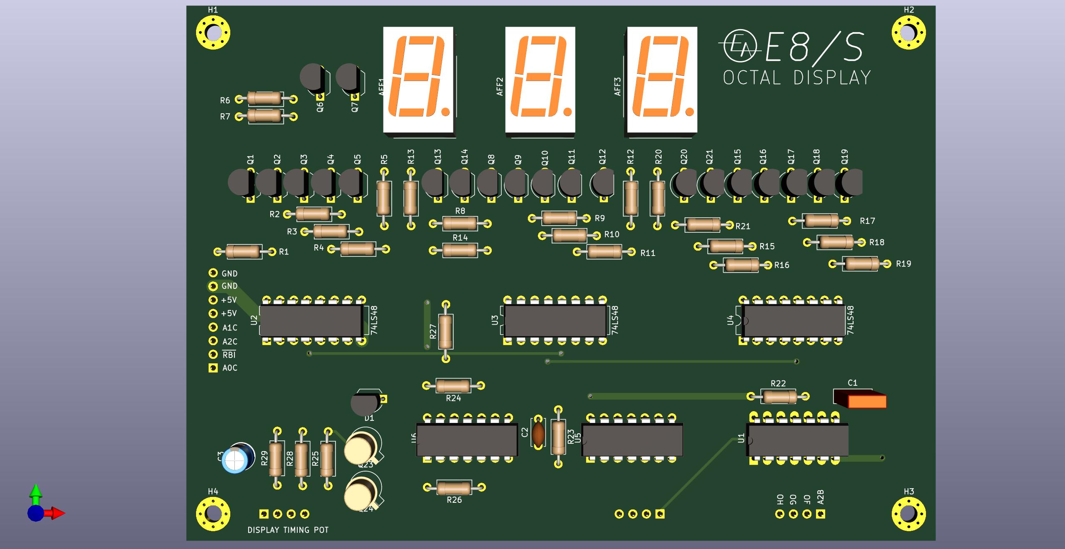
Octal display 2/Octal display_top.jpg
