ibm2030/EDUC8/Octal display 2/Pot and switch board/support PCB/support PCB bottom.jpg

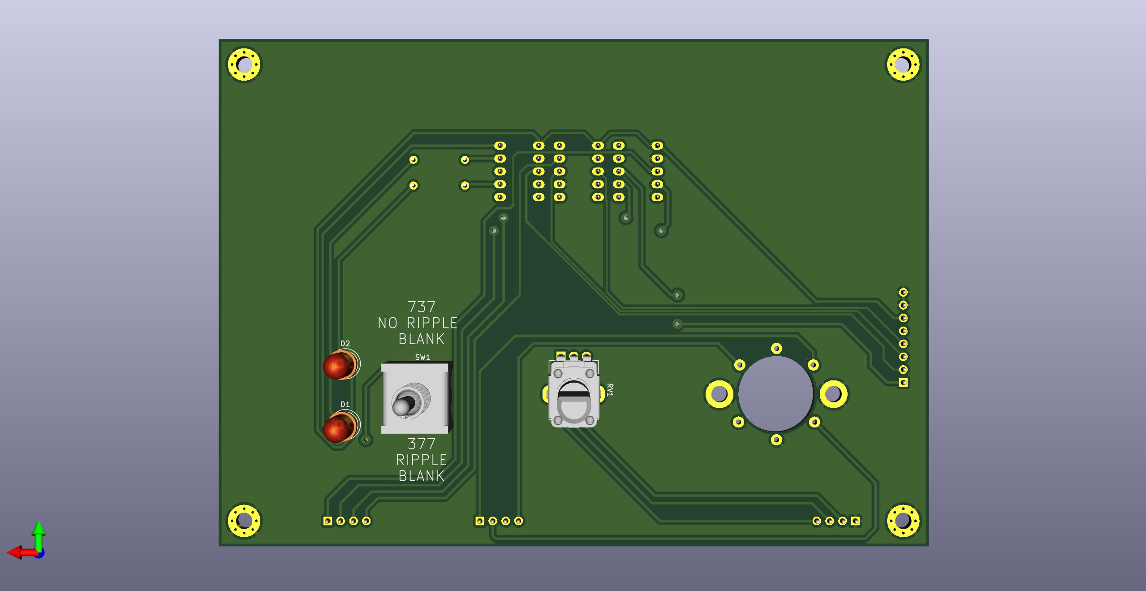
Octal display 2/Pot and switch board/support PCB/support PCB bottom.jpg
