ibm2030/EDUC8/Octal display 2/Pot and switch board/support PCB/support PCB top.jpg

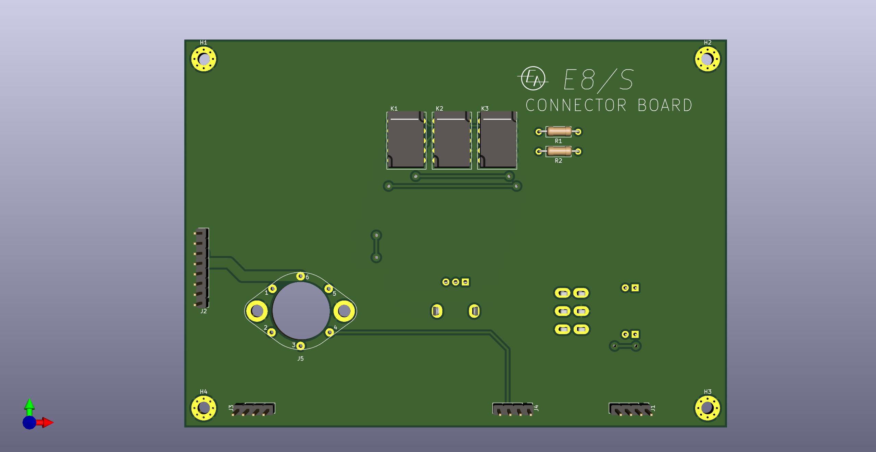
Octal display 2/Pot and switch board/support PCB/support PCB top.jpg
