ibm2030/EDUC8/octal. keyboard/octal keyboard/Keyboard interface bottom.jpg

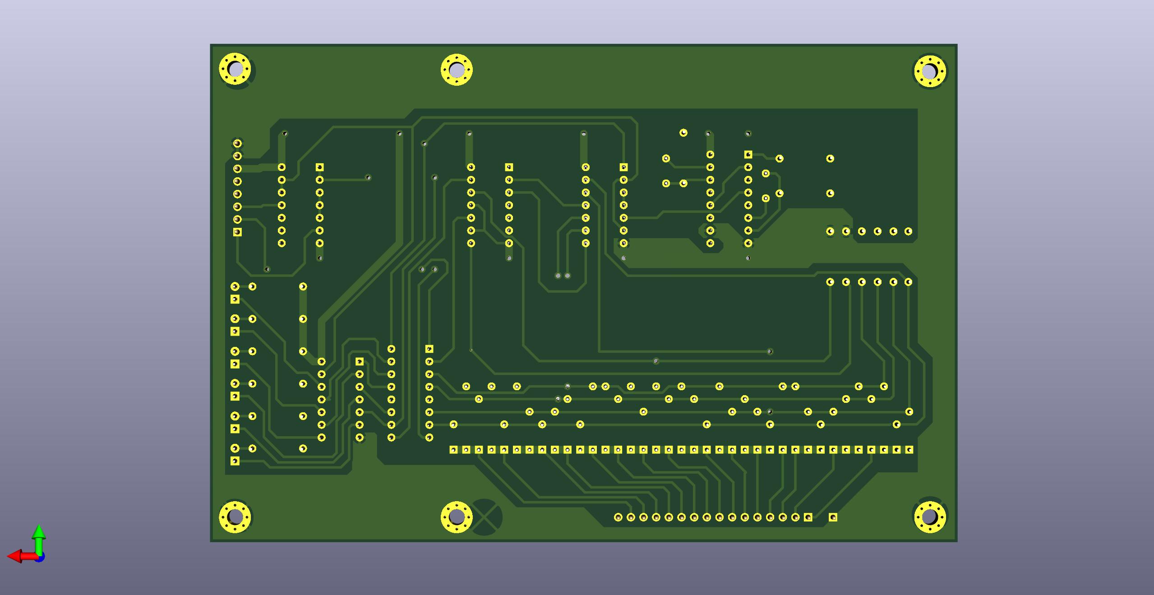
octal. keyboard/octal keyboard/Keyboard interface bottom.jpg
