ibm2030/EDUC8/octal. keyboard/octal keyboard/Keyboard interface top.jpg

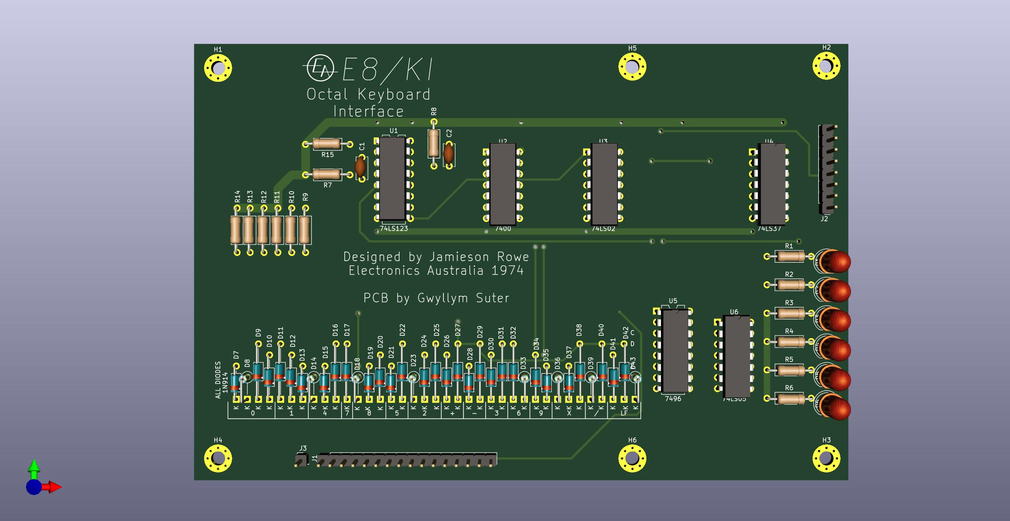
octal. keyboard/octal keyboard/Keyboard interface top.jpg
