ibm2030/EDUC8/octal. keyboard/octal keyboard/octal keyboard bottom.jpg

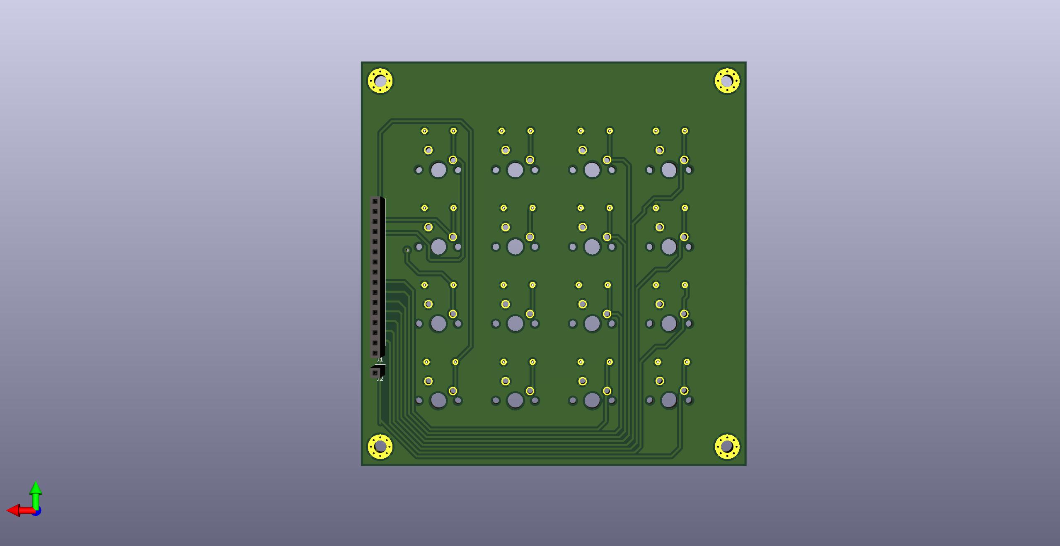
octal. keyboard/octal keyboard/octal keyboard bottom.jpg
