ibm2030/EDUC8/octal. keyboard/octal keyboard/octal keyboard top.jpg

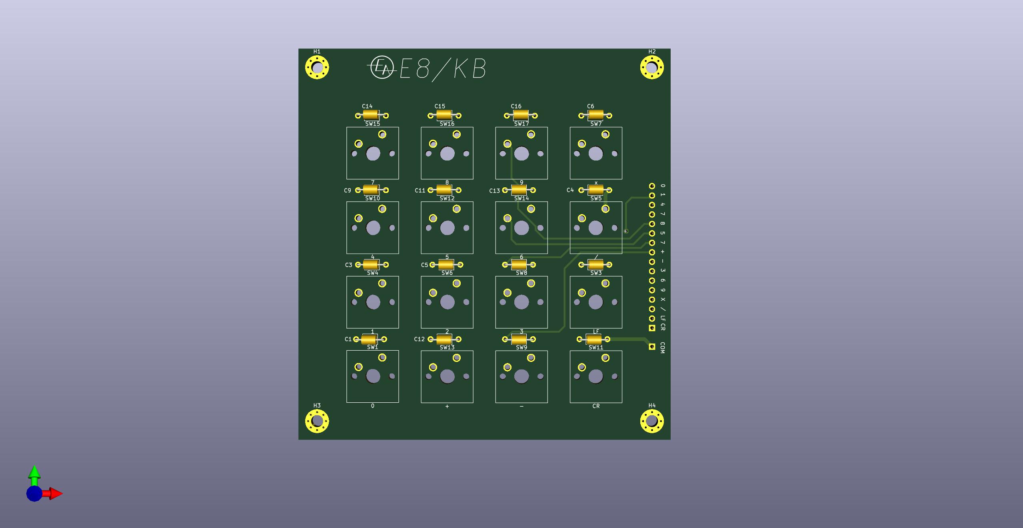
octal. keyboard/octal keyboard/octal keyboard top.jpg
