ibm2030/EDUC8/PC and ADDER 74LS74 MOD/PC and ADDER 74LS74 MOD.jpg

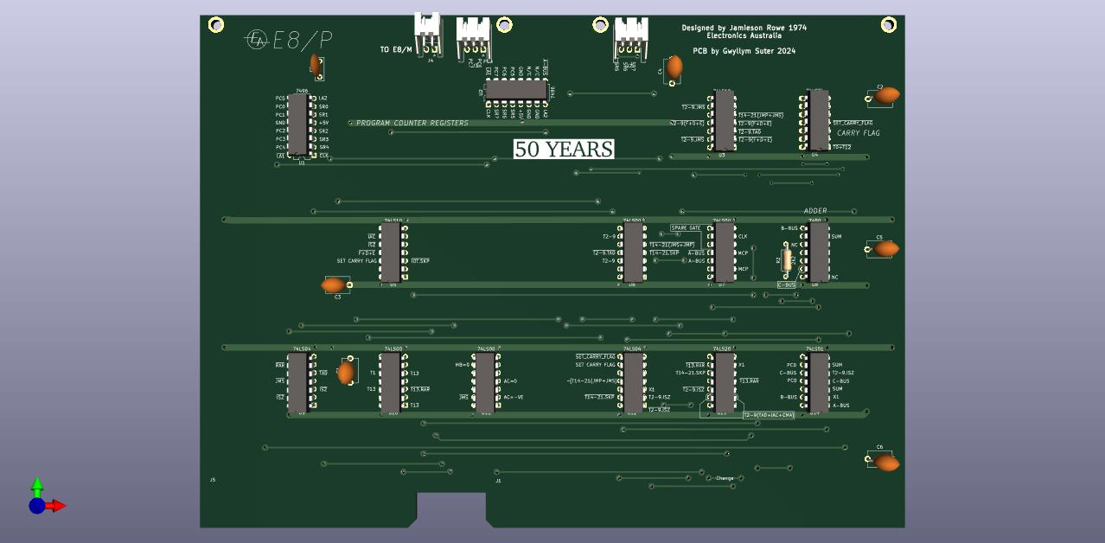
PC and ADDER 74LS74 MOD/PC and ADDER 74LS74 MOD.jpg
