ibm2030/EDUC8/Power Supply 2/EDUC-8 KiCAD.jpg

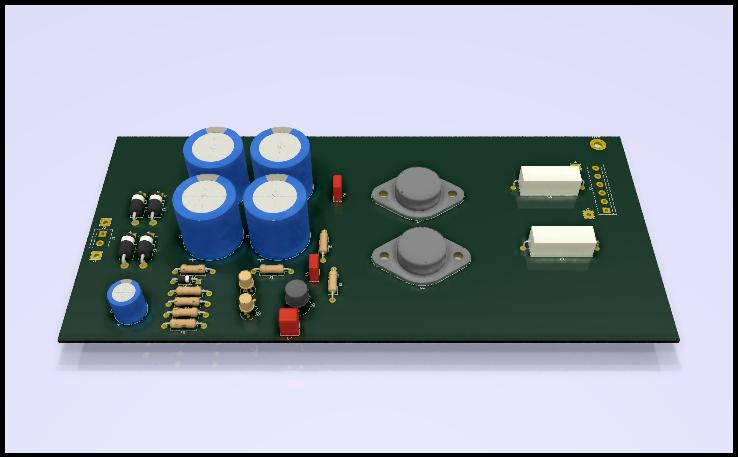
Power Supply 2/EDUC-8 KiCAD.jpg
