ibm2030/EDUC8/Power Supply 2/EDUC-8 PSU.jpg

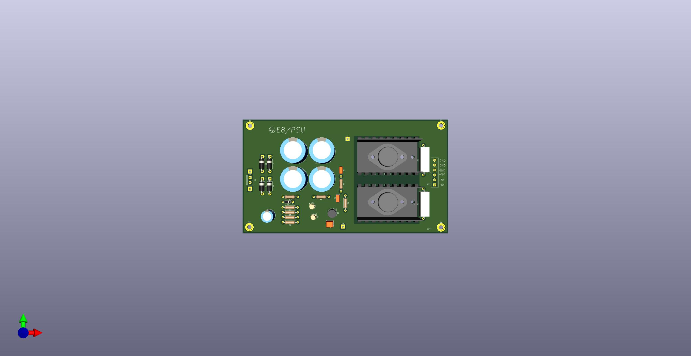
Power Supply 2/EDUC-8 PSU.jpg
