ibm2030/EDUC8/Power Supply/Crowbar/EDUC-8 Crowbar/EDUC-8 Crowbar.jpg

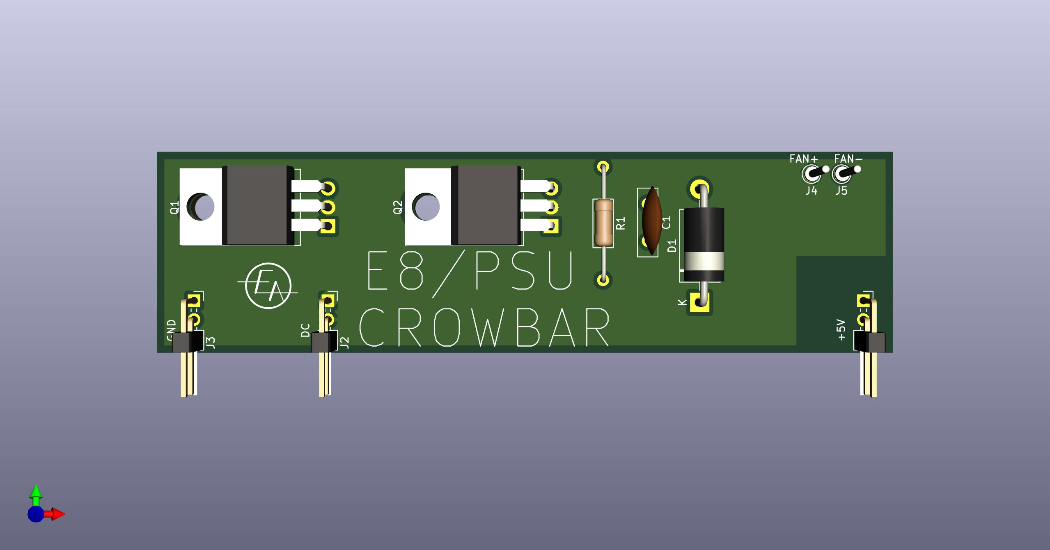
Power Supply/Crowbar/EDUC-8 Crowbar/EDUC-8 Crowbar.jpg
