ibm2030/EDUC8/Power Supply/EDUC-8 PSU.jpg

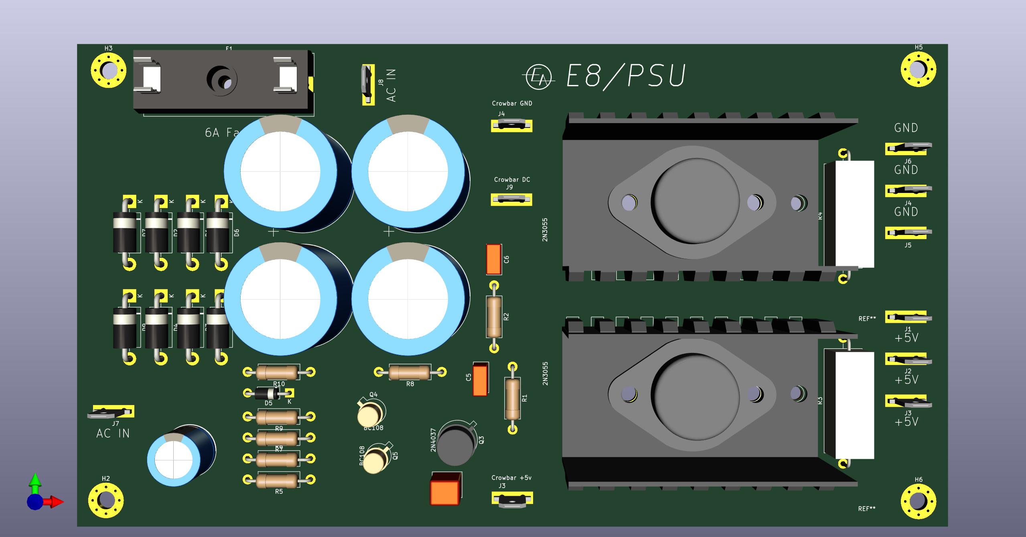
Power Supply/EDUC-8 PSU.jpg
