ibm2030/EDUC8/Serial interface/E8Serial/E8Serial TOP.jpg

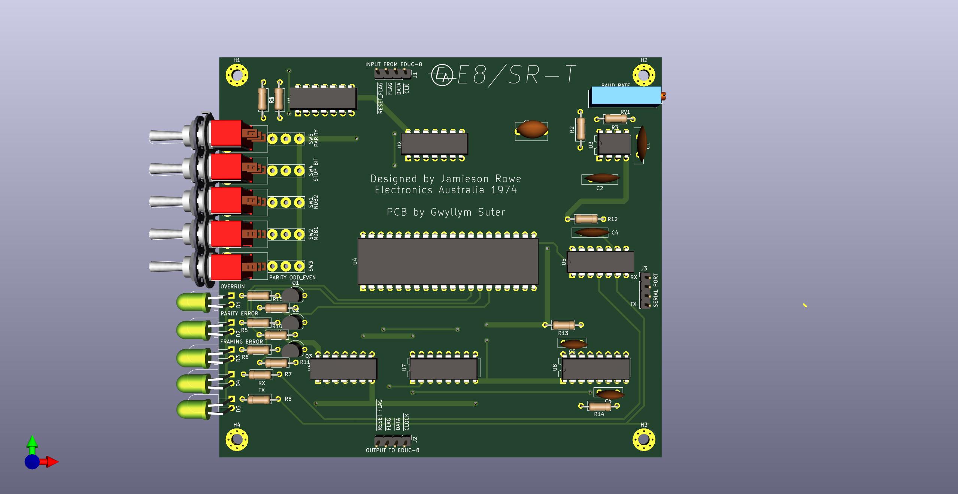
Serial interface/E8Serial/E8Serial TOP.jpg
