ibm2030/EDUC8/Serial interface/E8Serial/Video terminal /VIDEO TERMINAL.jpeg

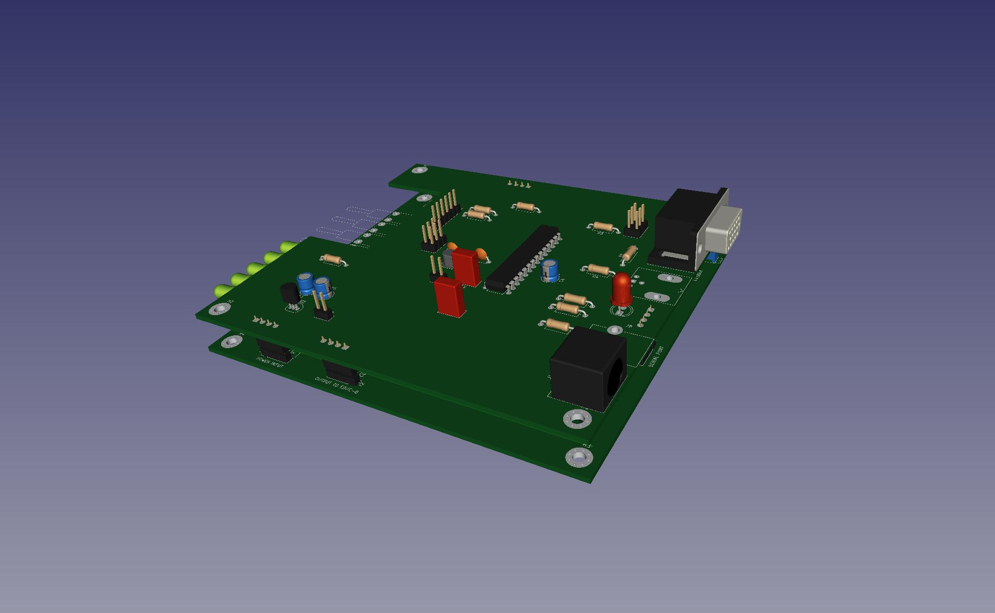
Serial interface/E8Serial/Video terminal /VIDEO TERMINAL.jpeg
