ibm2030/EDUC8/Serial interface/E8Serial/WIFI-MODEM/nodemcu-lua-wifi-esp8266-1/ESP8266 v7.png

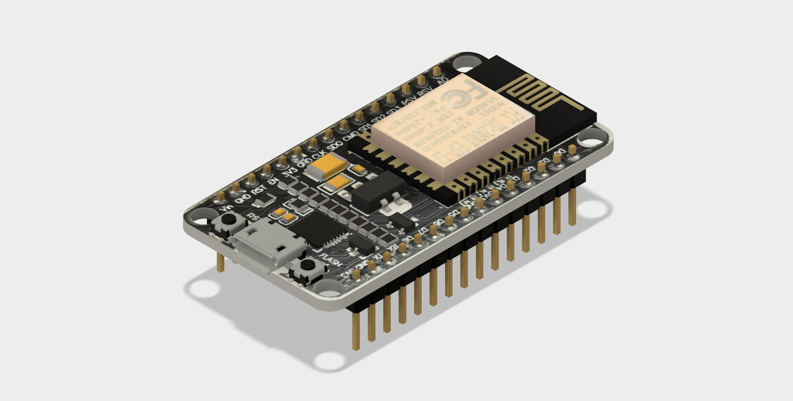
Serial interface/E8Serial/WIFI-MODEM/nodemcu-lua-wifi-esp8266-1/ESP8266 v7.png
