ibm2030/EDUC8/Serial interface/E8Serial/WIFI-MODEM/RS232 bottom.jpg

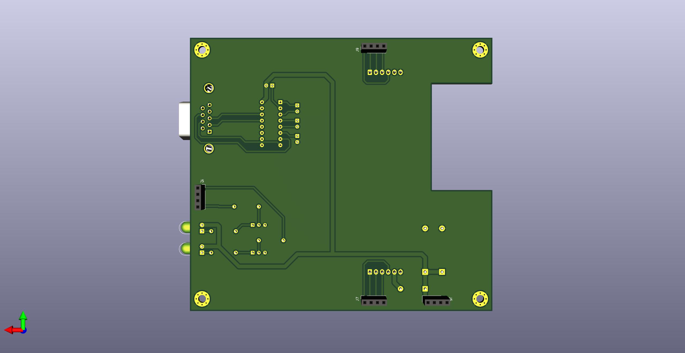
Serial interface/E8Serial/WIFI-MODEM/RS232 bottom.jpg
