ibm2030/EDUC8/Timing/educ 8 timing bottom.jpg

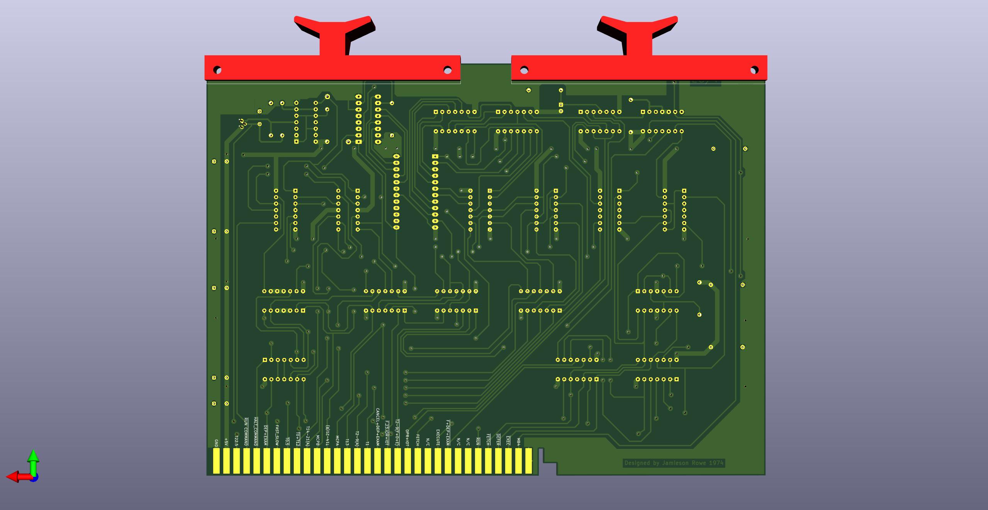
Timing/educ 8 timing bottom.jpg
