ibm2030/EDUC8/Timing/educ 8 timing top.jpg

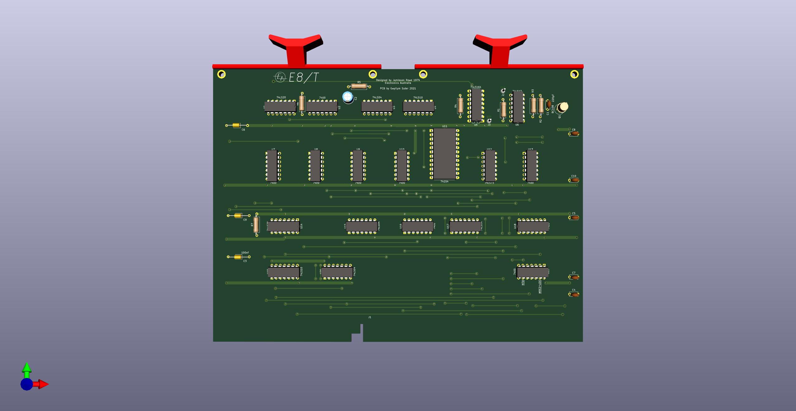
Timing/educ 8 timing top.jpg
