ibm2030/EDUC8/Timing/educ 8 timing with PDP8 handles.jpg

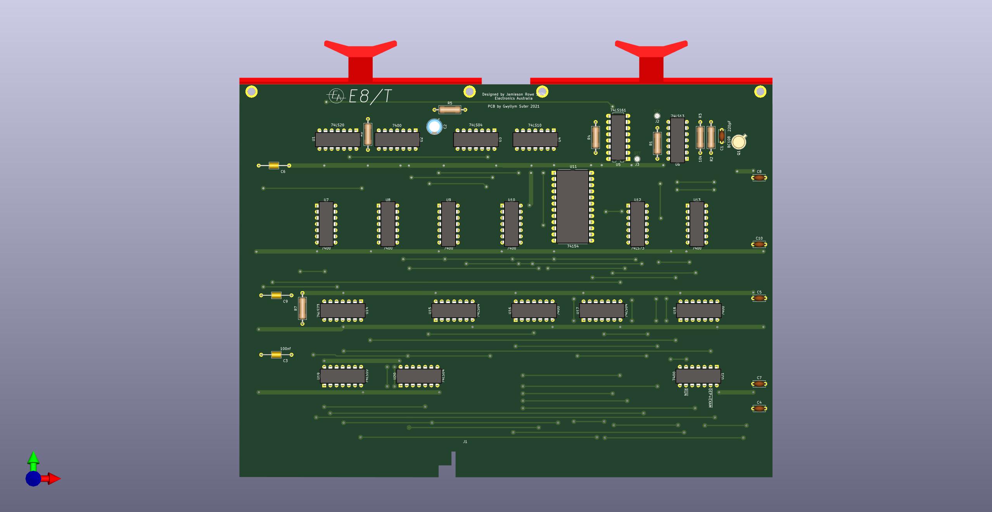
Timing/educ 8 timing with PDP8 handles.jpg
