ibm2030/EDUC8/BOM.odt

Unicorn Electronics http://www.unicornelectronics.com/ US$

15-pin D connector socket 1V CODB15S 1 0.45

1N753 6.2V 400 mW zener diode 1V 1N753 1 0.09

1N4148 Gene

Unicorn Electronics http://www.unicornelectronics.com/ US$

15-pin D connector socket 1V CODB15S 1 0.45

1N753 6.2V 400 mW zener diode 1V 1N753 1 0.09

1N4148 General purpose silicon diode 37K 1N4148 37 0.03

2N3055 TO-3 NPN power transisitors 2V 2N3055 2 0.79

BR1005 10 A, 50 V silcon rectifier bridge 1V BR1005 1 0.99

100pF 50V ceramic 1F+1K CPD10050 2 0.05

220pF 50V ceramic 1T CPD22050 1 0.05

.001µF 50V ceramic 1F+1K+1S CPD.00150 3 0.05

.022µF 50V ceramic 1V CPD.02250 1 0.06

.047µF 50V ceramic 2V+4T+3D+5A+6P+5M+4I+2K+1S CPD.04750 32 0.05

470µF 25V electrolytic 1V CPE47025 1 0.19

7400 quad 2-input gate IC 4F+9T+8D+2A+4P+6M+3I 7400 36 0.21

7401 quad 2-input gate (open collector) 2A+1P+1M+2I 7401 6 0.24

7402 quad 2-input positive NOR gate IC 1K 7402 1 0.24

7404 hex inverter IC 4T+2D+1A+2P+1M+3I 7404 13 0.24

7405 hex inverter (open collector) 5F+2A+2M 7405 9 0.24

7410 triple 3-input gate IC 2T+2D+1A+2P 7410 7 0.24

7413 dual Schmitt IC 1T+1S 7413 2 0.33

7417 hex buffer (open collector) 2F 7417 2 0.27

7420 dual 4-input gate IC 1T+1D+1P 7420 3 0.24

7437 quad 2-input buffer IC 3I+1K+1S 7437 5 0.19

7473 dual J-K flipflop IC 2T 7473 2 0.34

7480 gated full adder IC 1P 7480 1 0.79

7493 4-bit counter 1M 7493 1 0.34

7495 four-bit shift register 2A+2M 7495 4 0.39

7496 5-bit shift register 2P+2M+1K 7496 5 0.34

74105 high speed J-K flip-flop 1P 74105 1 1.99

74132 quad Schmitt trigger gate IC 1K 74132 1 0.39

74154 16-way decoder IC 1T 74154 1 1.19

74157 quad 2-input multiplexer 1M 74157 1 0.24

74161 synchronous 4-bit counter IC 1T 74161 1 0.39

74164 8-bit register IC 1S 74164 1 0.49

74248 decoders ICs 3S 74248 3 2.49

74259 eight bit addressable latch IC 1D 74259 1 0.69

9602 dual one-shot 1F+1K 9602 2 0.59

Intel 2115 1024-bit RAM 2M 2115-2 2 3.29

5mm red LED 44F LDRJ 44 0.10

16-pin DIL sockets 2M MT16 2 0.39

7493 4-bit counter 1M 7493 1 0.34ral purpose silicon diode 37K 1N4148 37 0.03

7495 four-bit shift register 2A+2M 7495 4 0.39

7496 5-bit shift register 2P+2M+1K 7496 5 0.34

74105 high speed J-K flip-flop 1P 74105 1 1.99

74132 quad Schmitt trigger gate IC 1K 74132 1 0.39

74154 16-way decoder IC 1T 74154 1 1.19

74157 quad 2-input multiplexer 1M 74157 1 0.24

74161 synchronous 4-bit counter IC 1T 74161 1 0.39

74164 8-bit register IC 1S 74164 1 0.49

74248 decoders ICs 3S 74248 3 2.49

74259 eight bit addressable latch IC 1D 74259 1 0.69

9602 dual one-shot 1F+1K 9602 2 0.59

Intel 2115 1024-bit RAM 2M 2115-2 2 3.29

5mm red LED 44F LDRJ 44 0.10

16-pin DIL sockets 2M MT16 2 0.39
