ibm2030/EDUC8/Octal display 2/Octal display.csv

Id | Designator | Package | Quantity | Designation | Supplier and ref
1 | R2,R21,R20,R19,R18,R17,R16,R15,R14,R13,R12,R11,R10,R9,R8,R7,R6,R5,R4,R3,R1 | R_Axial_DIN0207_L6.3mm_D2.5mm_P10.16mm_Horizontal | 21 | 81R
2 | U2,U4,U3 | DIP-16_W7.62mm | 3 | 74LS48
3 | U1 | DIP-14_W7.62mm_LongPads | 1 | 74164
4 | Q21,Q20,Q19,Q18,Q17,Q16,Q15,Q14,Q13,Q12,Q11,Q10,Q9,Q8,Q7,Q6,Q5,Q4,Q3,Q2,Q1 | TO-92_Inline_Wide | 21 | BC547
5 | AFF3,AFF2,AFF1 | 7SegmentLED_LTS6760_LTS6780 | 3 | LTS-6980HR
