ibm2030/EDUC8/Housing/Multiplexer/Main case multiplexer.FCStd

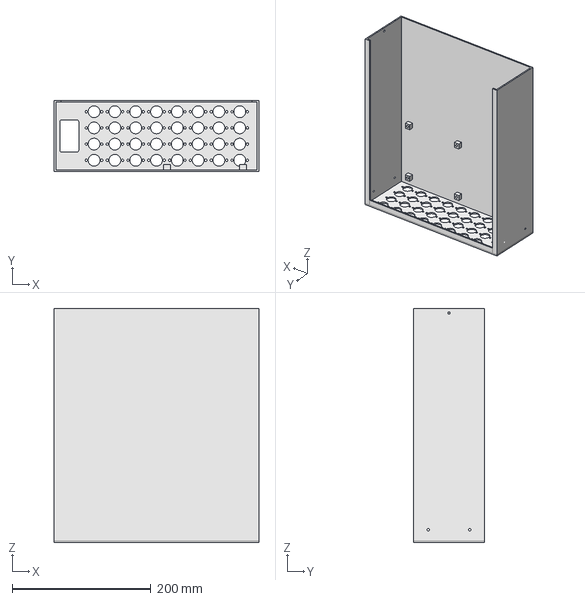
[picture p107: CAD file, 2025-07-23]
Housing/Multiplexer/Main case multiplexer.FCStd
295.0 x 103.0 x 337.4 mm
