ibm2030/EDUC8/ASCII keyboard/cherry-mx-1/asm_mx_asm_PCB.stp

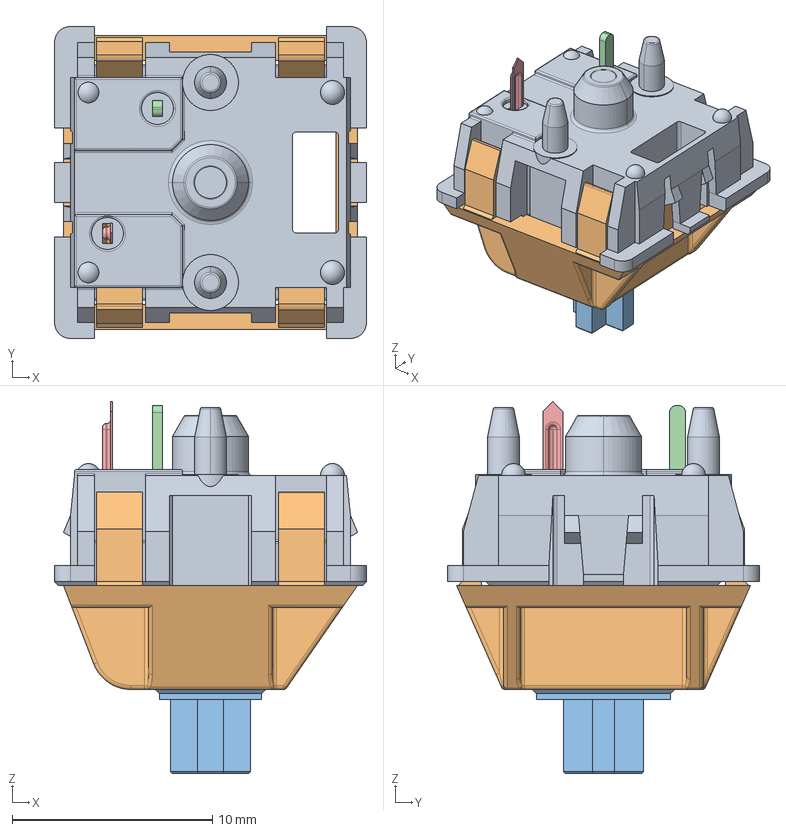
[picture p108: CAD file, 2023-03-05]
ASCII keyboard/cherry-mx-1/asm_mx_asm_PCB.stp
15.6 x 15.6 x 18.6 mm
MX_DOWN
MX_UP
UP_MX
MX_PIN
MX_SPRING
MX_CLICK
