ibm2030/EDUC8/ASCII keyboard/cherry-mx-stabilizer-mx-1/Cherry MX Stabilizer.SLDASM

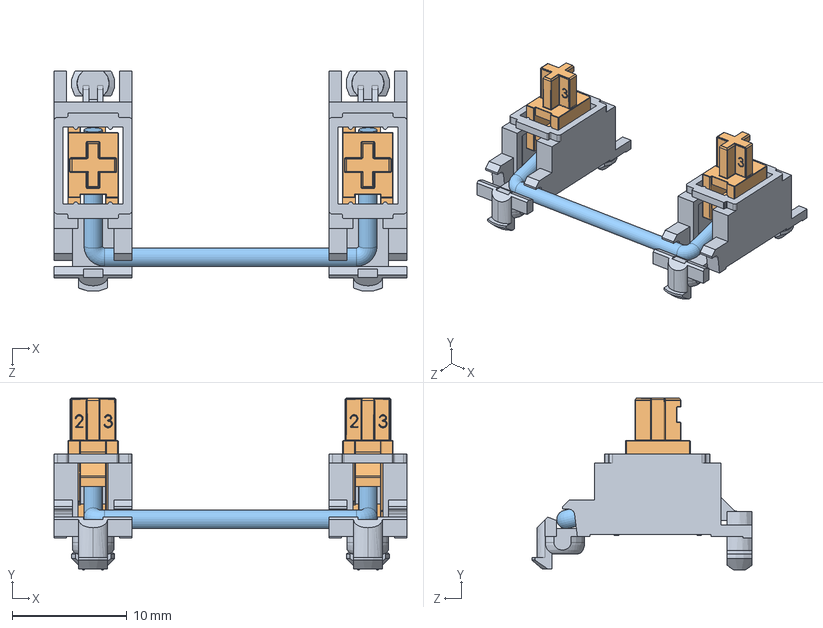
[picture p109: CAD file, 2023-03-05]
ASCII keyboard/cherry-mx-stabilizer-mx-1/Cherry MX Stabilizer.SLDASM
30.7 x 15.0 x 19.2 mm
mx Stabilizer base 16828 x 2
mx Stabilizer key 16828 x 2
metal stick 16828
