ibm2030/EDUC8/Housing/Main case-Body.3mf

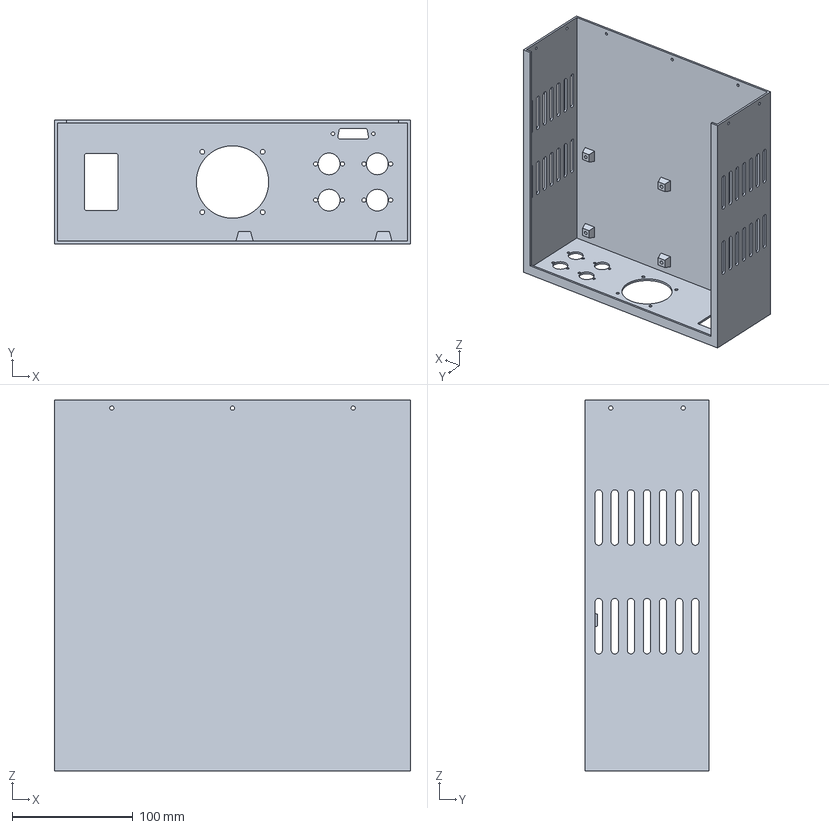
[picture p110: CAD file, 2025-07-23]
Housing/Main case-Body.3mf
295.0 x 103.0 x 307.4 mm
