ibm2030/EDUC8/256 word memory/256 word memory 2.0/E8M Gerber/256 word memory_2.0-PTH-drl_map.dxf

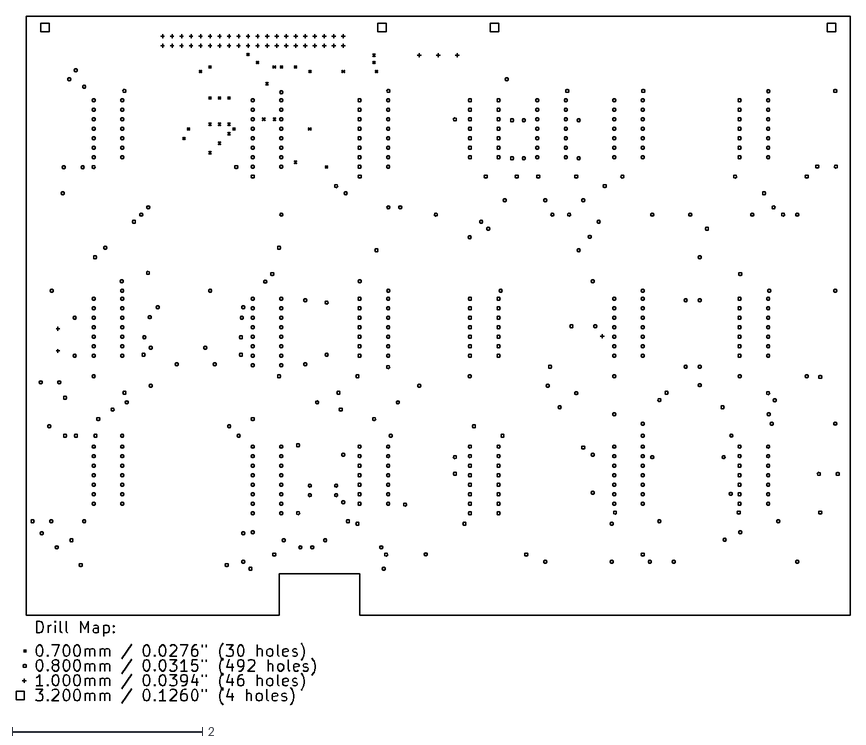
[picture p111: CAD file, 2023-03-05]
256 word memory/256 word memory 2.0/E8M Gerber/256 word memory_2.0-PTH-drl_map.dxf
8.77 x 7.24
