ibm2030/EDUC8/256 word memory/E8M Gerber/2.0_EXPANED/256 word memory-PTH-drl_map.dxf

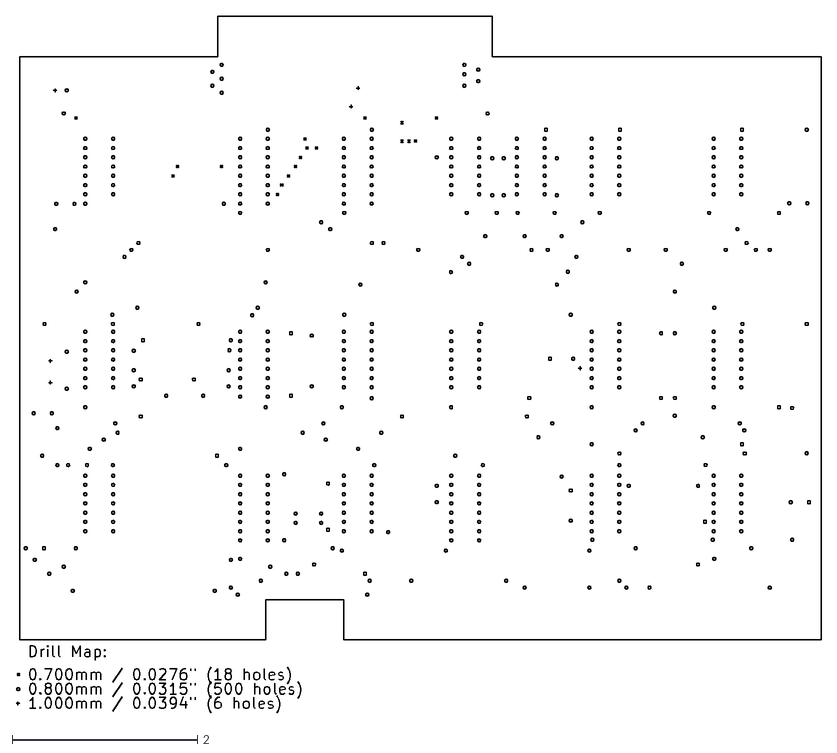
[picture p112: CAD file, 2023-03-05]
256 word memory/E8M Gerber/2.0_EXPANED/256 word memory-PTH-drl_map.dxf
8.70 x 7.53
