ibm2030/EDUC8/3D MODELS/36 pin edge conmnector.step

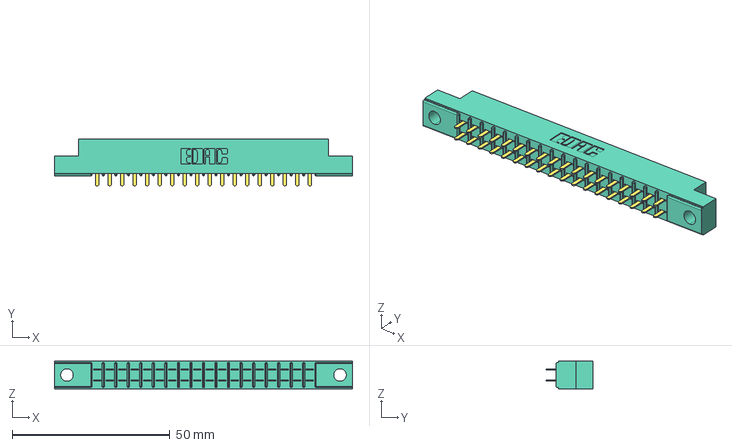
[picture p113: CAD file, 2023-03-05]
3D MODELS/36 pin edge conmnector.step
94.3 x 14.9 x 8.71 mm
305_Part_.156_Dia
