ibm2030/EDUC8/3D MODELS/din-5-connector-female-1/DIN 5 Connector (Female).STEP

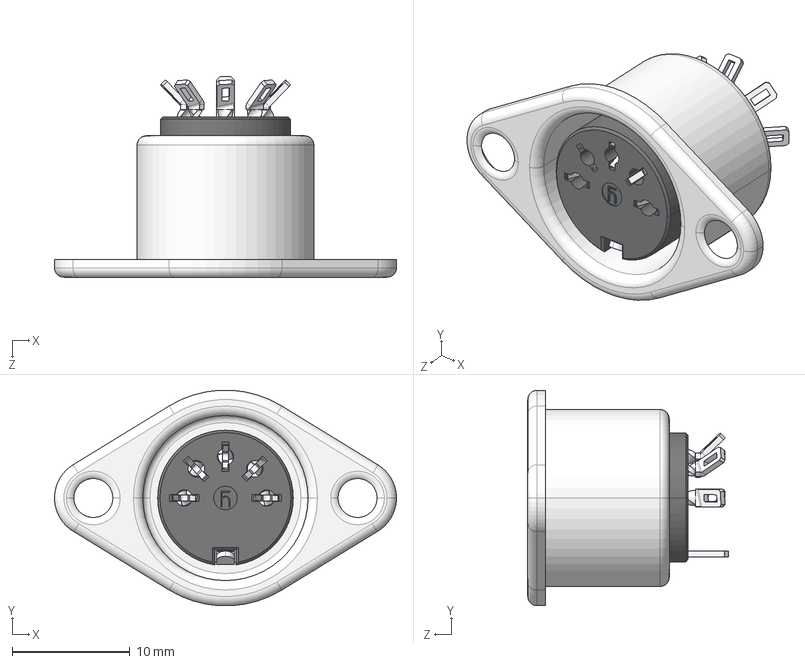
[picture p114: CAD file, 2023-03-05]
3D MODELS/din-5-connector-female-1/DIN 5 Connector (Female).STEP
29.0 x 18.3 x 17.0 mm
