ibm2030/EDUC8/Accumulator/Accumulator.step

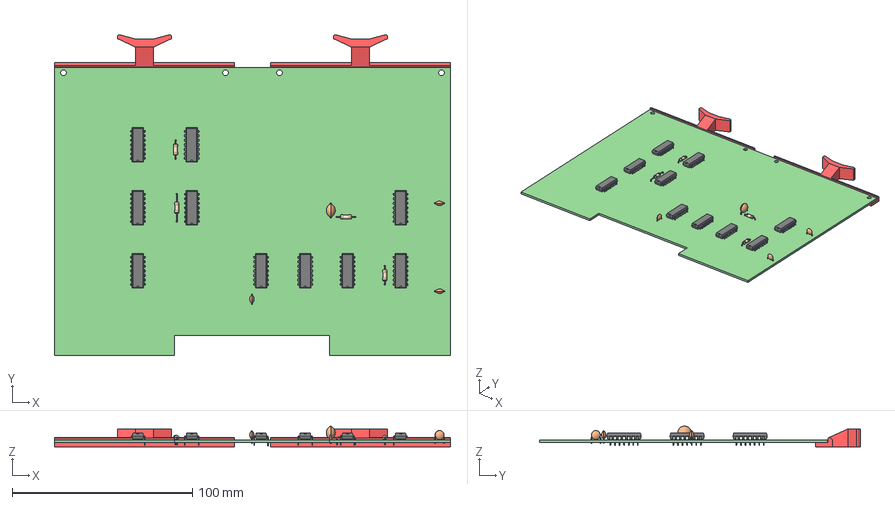
[picture p115: CAD file, 2023-03-05]
Accumulator/Accumulator.step
220.0 x 178.1 x 11.6 mm
