ibm2030/EDUC8/Accumulator/E8A Gerber/Accumulator-PTH-drl_map.dxf

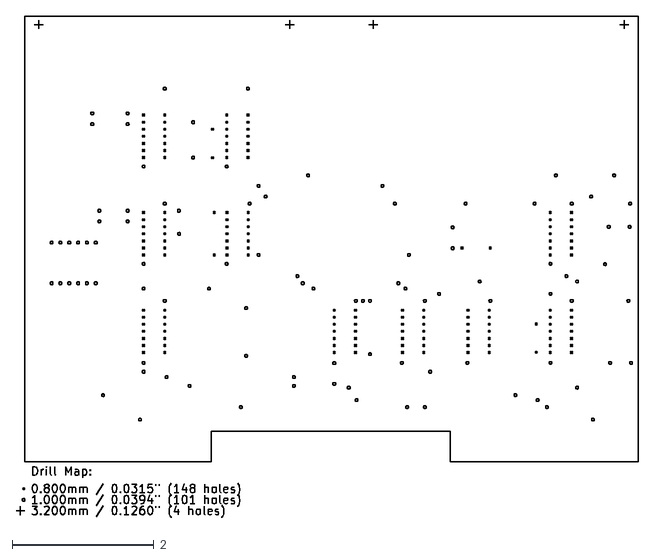
[picture p116: CAD file, 2023-03-05]
Accumulator/E8A Gerber/Accumulator-PTH-drl_map.dxf
8.79 x 7.09
