ibm2030/EDUC8/ASCII keyboard/cherry-mx-stabilizer-mx-1/mx Stabilizer base 16828.SLDPRT

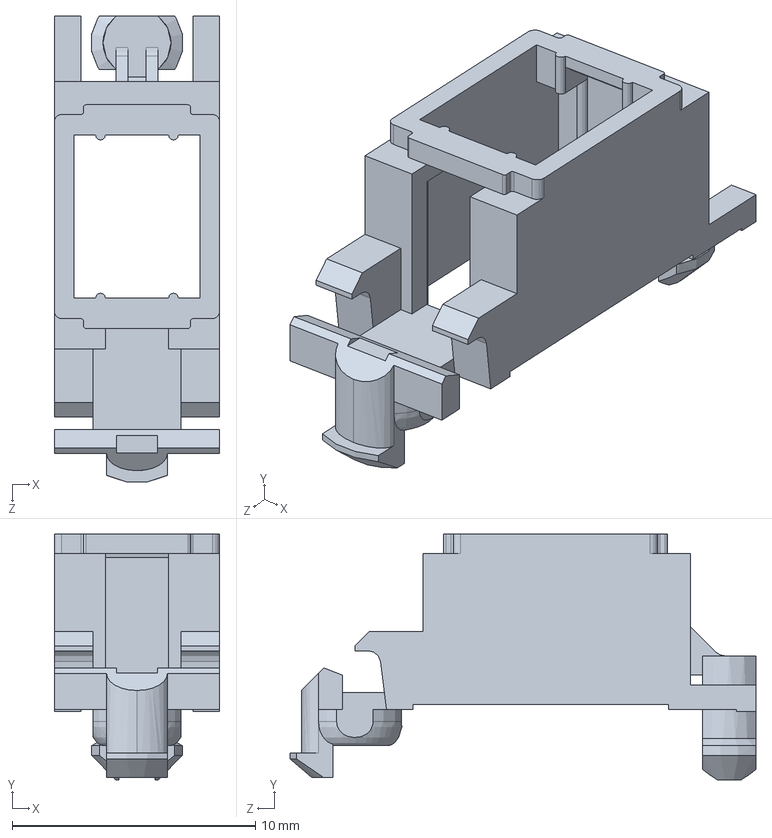
[picture p117: CAD file, 2023-03-05]
ASCII keyboard/cherry-mx-stabilizer-mx-1/mx Stabilizer base 16828.SLDPRT
6.80 x 10.1 x 19.2 mm
