ibm2030/EDUC8/ASCII keyboard/Gerber/ASCII keyboard-NPTH-drl_map.dxf

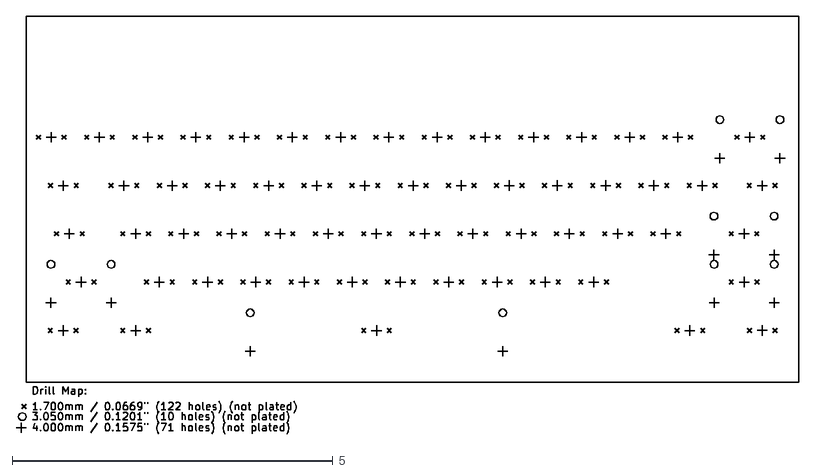
[picture p118: CAD file, 2023-03-05]
ASCII keyboard/Gerber/ASCII keyboard-NPTH-drl_map.dxf
12.2 x 6.51
