ibm2030/EDUC8/Buffer/Gerber/Buffer-NPTH-drl_map.dxf

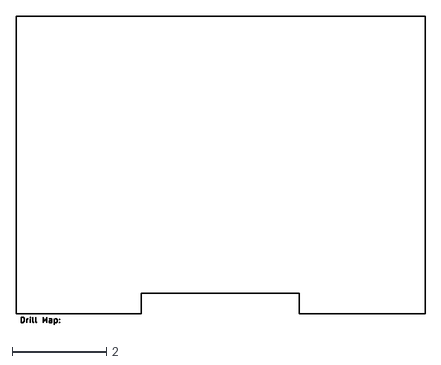
[picture p119: CAD file, 2023-03-05]
Buffer/Gerber/Buffer-NPTH-drl_map.dxf
8.66 x 6.52
