ibm2030/EDUC8/Decoder/E8D Gerber/educ 8 decoder-PTH-drl_map.dxf

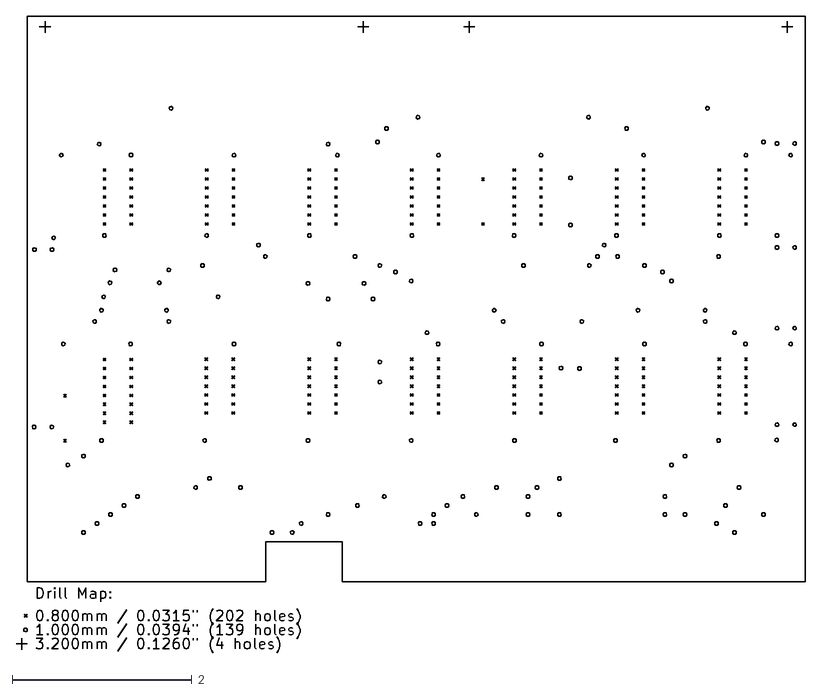
[picture p120: CAD file, 2023-03-05]
Decoder/E8D Gerber/educ 8 decoder-PTH-drl_map.dxf
8.79 x 7.09
