ibm2030/EDUC8/Decoder/educ 8 decoder.step

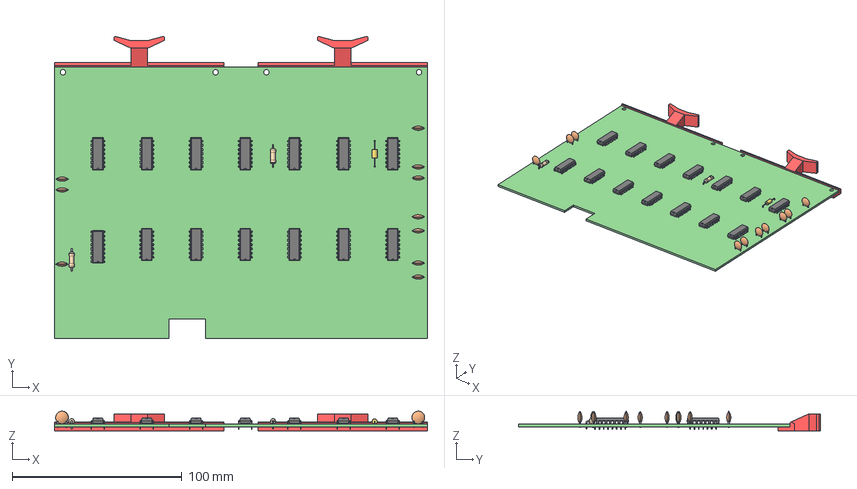
[picture p121: CAD file, 2023-03-05]
Decoder/educ 8 decoder.step
220.0 x 178.1 x 11.6 mm
