ibm2030/EDUC8/EXTENDER CARDS/Gerber/EXTENDER CARDS-PTH-drl_map.dxf

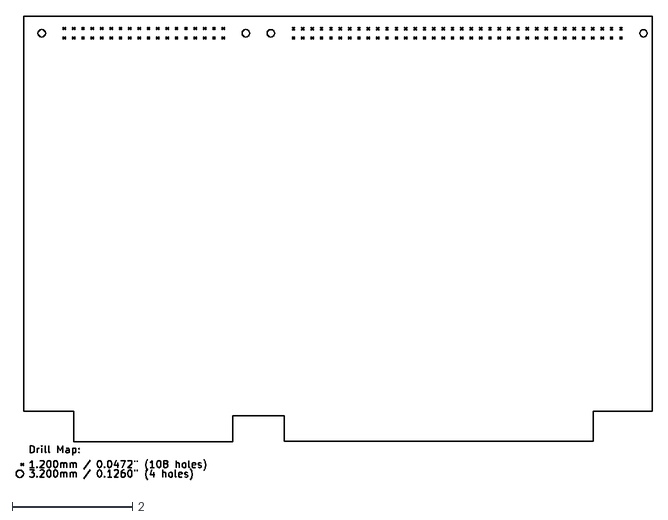
[picture p122: CAD file, 2023-03-05]
EXTENDER CARDS/Gerber/EXTENDER CARDS-PTH-drl_map.dxf
10.6 x 7.72
