ibm2030/EDUC8/Front panel PCB/Front panel/Front panel.step

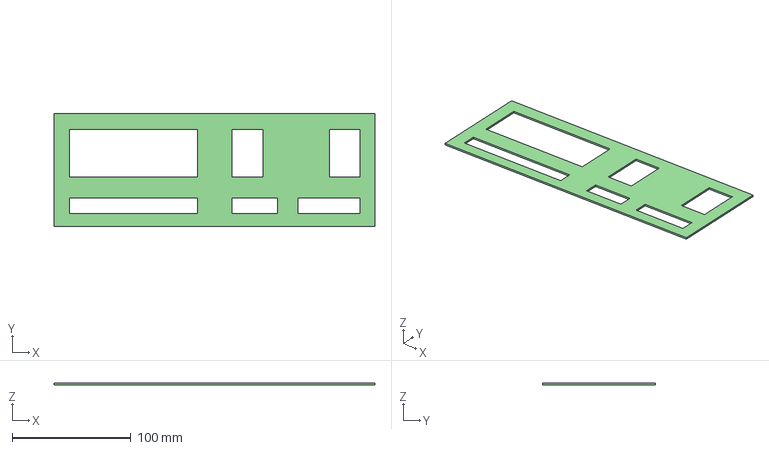
[picture p123: CAD file, 2023-03-05]
Front panel PCB/Front panel/Front panel.step
270.5 x 95.5 x 1.60 mm
