ibm2030/EDUC8/front panel/mechanical/Interboard support.FCStd

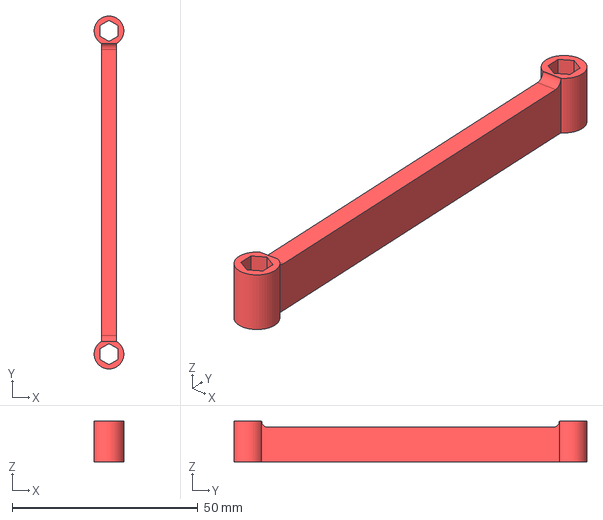
[picture p124: CAD file, 2023-03-05]
front panel/mechanical/Interboard support.FCStd
7.99 x 95.0 x 11.0 mm
