ibm2030/EDUC8/Housing/front panel 4.FCStd

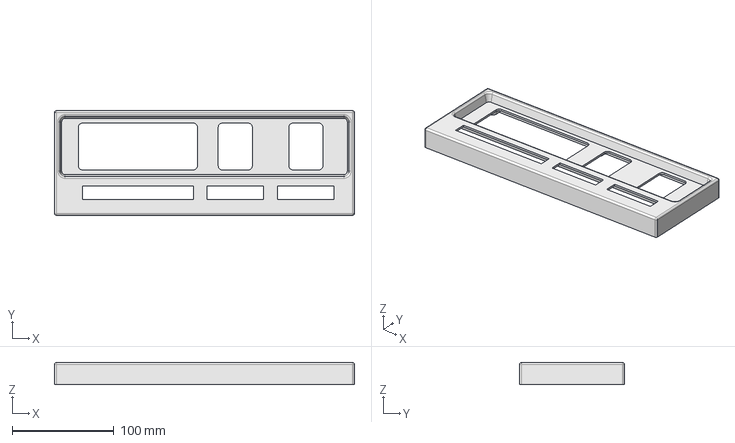
[picture p125: CAD file, 2025-07-23]
Housing/front panel 4.FCStd
295.0 x 103.0 x 22.0 mm
