ibm2030/EDUC8/Housing/Rubber feet/rubber feet.FCStd

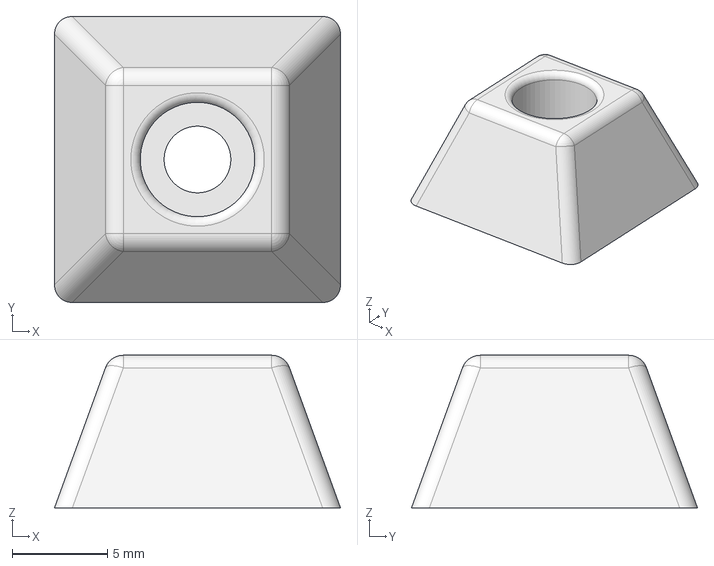
[picture p126: CAD file, 2025-07-23]
Housing/Rubber feet/rubber feet.FCStd
15.0 x 15.0 x 8.00 mm
