ibm2030/EDUC8/Input:Output Interface/E8T Gerber/Input:Output Interface-NPTH-drl_map.dxf

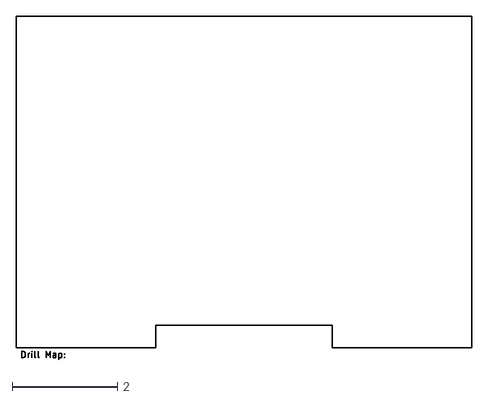
[picture p128: CAD file, 2023-03-05]
Input:Output Interface/E8T Gerber/Input:Output Interface-NPTH-drl_map.dxf
8.66 x 6.52
