ibm2030/EDUC8/Input:Output Interface/Input:Output Interface.step

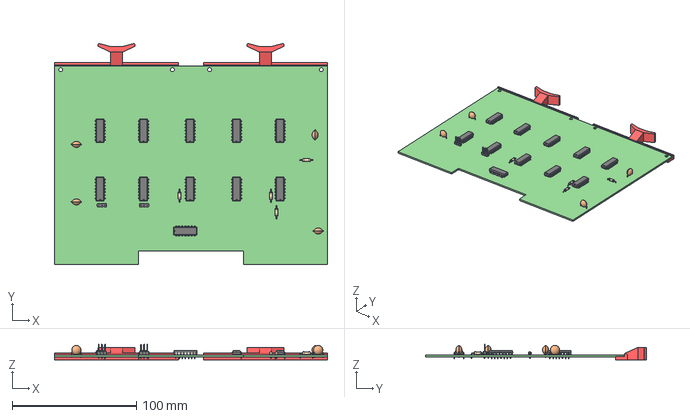
[picture p129: CAD file, 2023-03-05]
Input:Output Interface/Input:Output Interface.step
220.0 x 178.1 x 12.5 mm
