ibm2030/EDUC8/motherboard/Gerber/motherboard-PTH-drl_map.dxf

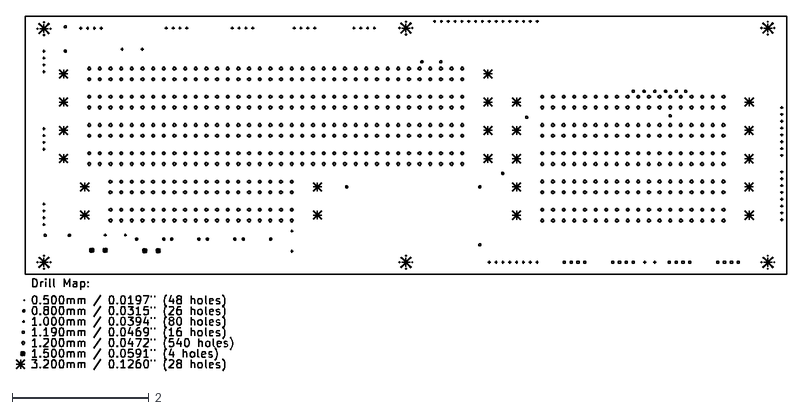
[picture p130: CAD file, 2023-03-05]
motherboard/Gerber/motherboard-PTH-drl_map.dxf
11.3 x 5.19
