ibm2030/EDUC8/Octal display 2/Gerber/Octal display-PTH-drl_map.dxf

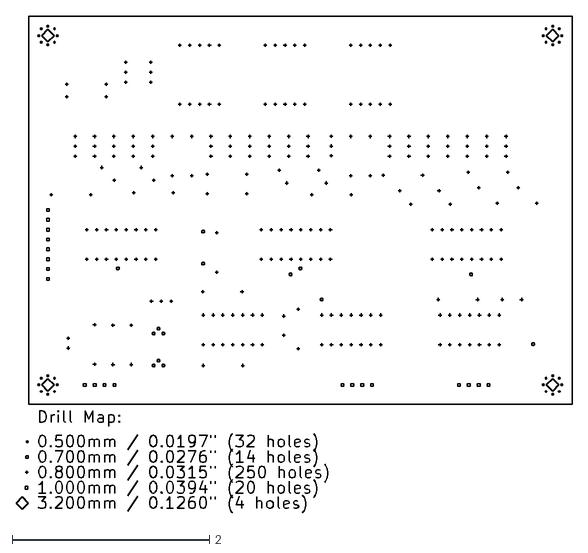
[picture p131: CAD file, 2023-03-05]
Octal display 2/Gerber/Octal display-PTH-drl_map.dxf
5.64 x 5.04
