ibm2030/EDUC8/Octal display 2/Pot and switch board/support PCB/Gerber/support PCB-NPTH-drl_map.dxf

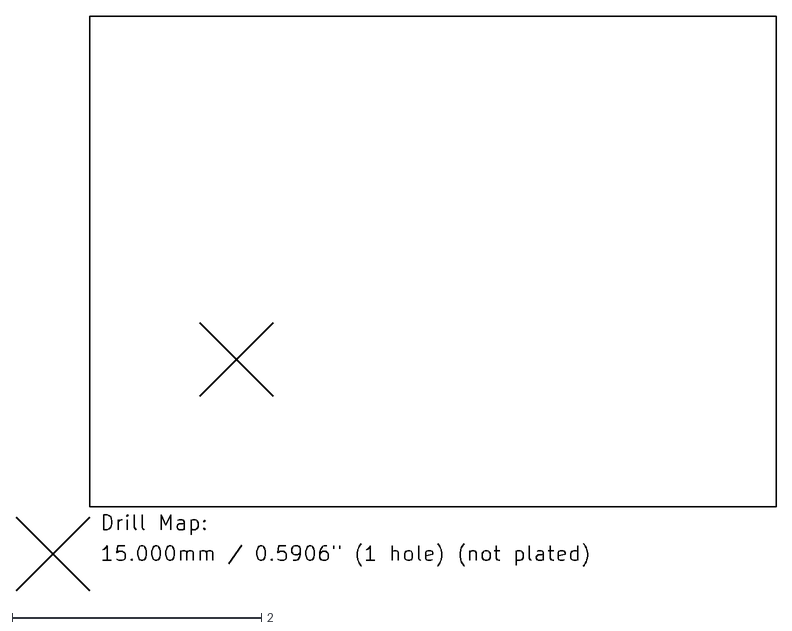
[picture p132: CAD file, 2023-03-05]
Octal display 2/Pot and switch board/support PCB/Gerber/support PCB-NPTH-drl_map.dxf
6.10 x 4.61
