ibm2030/EDUC8/Octal display/Housing for veroboard /Veroboard housing.FCStd

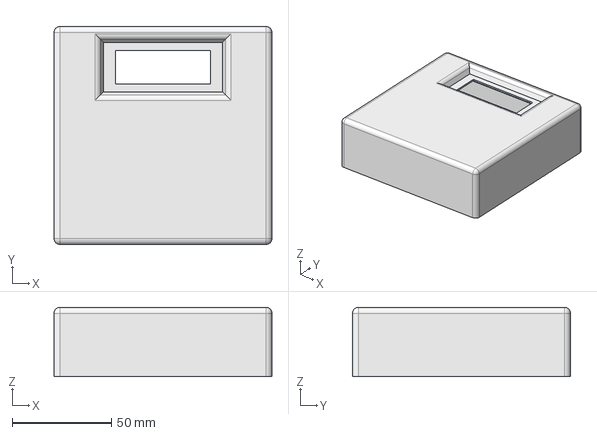
[picture p134: CAD file, 2024-06-13]
Octal display/Housing for veroboard /Veroboard housing.FCStd
110.0 x 110.0 x 35.0 mm
