ibm2030/EDUC8/Octal display/Production housing/octal display housing.FCStd

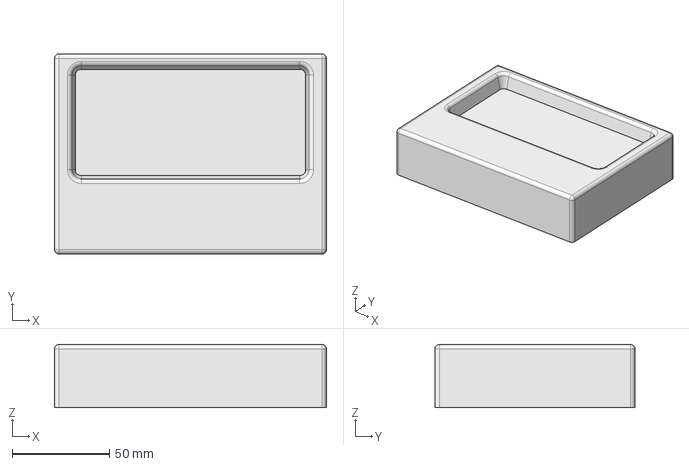
[picture p135: CAD file, 2024-06-13]
Octal display/Production housing/octal display housing.FCStd
139.8 x 103.0 x 32.4 mm
