ibm2030/EDUC8/octal. keyboard/octal keyboard/E8KB/octal keyboard-NPTH-drl_map.dxf

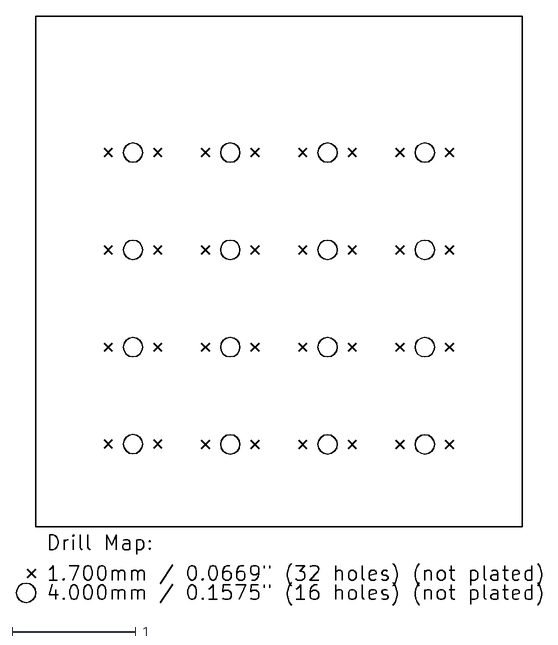
[picture p136: CAD file, 2023-03-05]
octal. keyboard/octal keyboard/E8KB/octal keyboard-NPTH-drl_map.dxf
4.25 x 4.77
