ibm2030/EDUC8/octal. keyboard/octal keyboard/Gerber/Keyboard interface-NPTH-drl_map.dxf

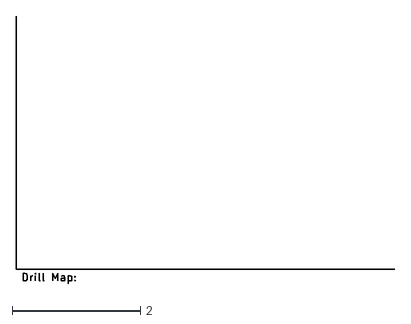
[picture p137: CAD file, 2023-03-05]
octal. keyboard/octal keyboard/Gerber/Keyboard interface-NPTH-drl_map.dxf
5.91 x 4.16
