ibm2030/EDUC8/Power Supply 2/Gerber/EDUC-8 PSU-PTH-drl_map.dxf

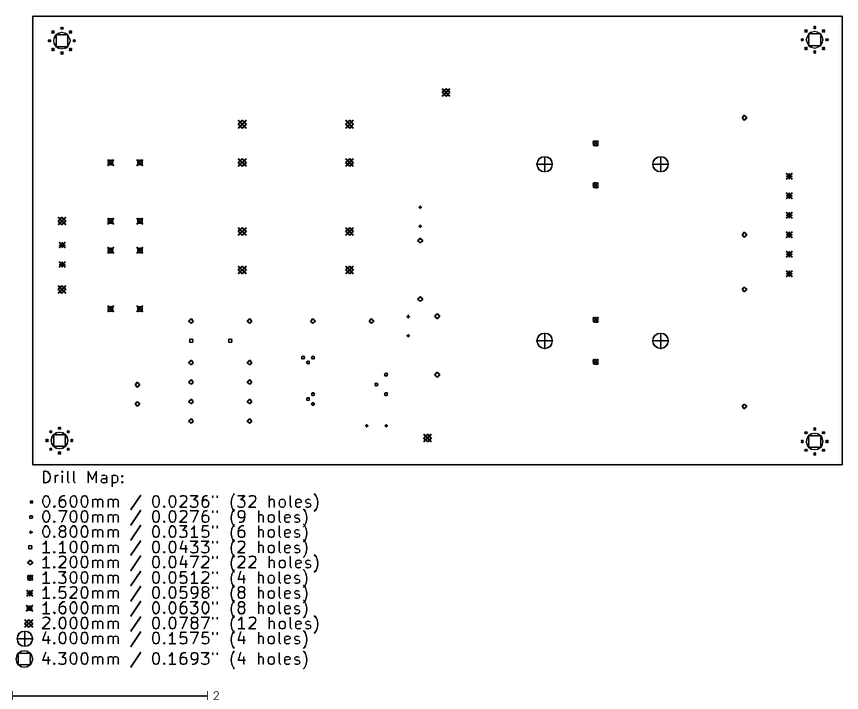
[picture p138: CAD file, 2023-03-05]
Power Supply 2/Gerber/EDUC-8 PSU-PTH-drl_map.dxf
8.47 x 6.69
