ibm2030/EDUC8/Power Supply/Crowbar/EDUC-8 Crowbar/GERBER/EDUC-8 Crowbar-NPTH-drl_map.dxf

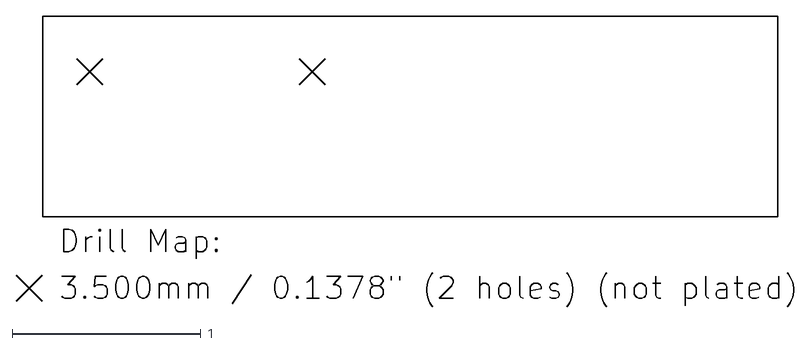
[picture p139: CAD file, 2023-03-05]
Power Supply/Crowbar/EDUC-8 Crowbar/GERBER/EDUC-8 Crowbar-NPTH-drl_map.dxf
4.12 x 1.54
