ibm2030/EDUC8/Power Supply/EDUC-8 PSU.step

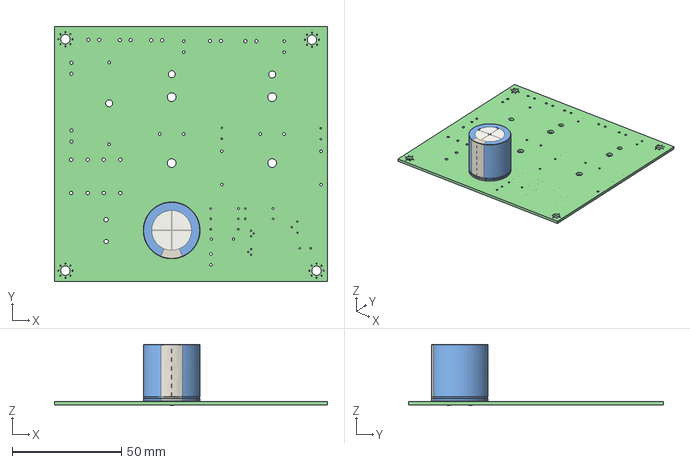
[picture p140: CAD file, 2023-03-05]
Power Supply/EDUC-8 PSU.step
125.0 x 116.8 x 28.0 mm
EDUC-8 PSU PCB
