ibm2030/EDUC8/Serial interface/E8Serial/Gerber/E8Serial-NPTH-drl_map.dxf

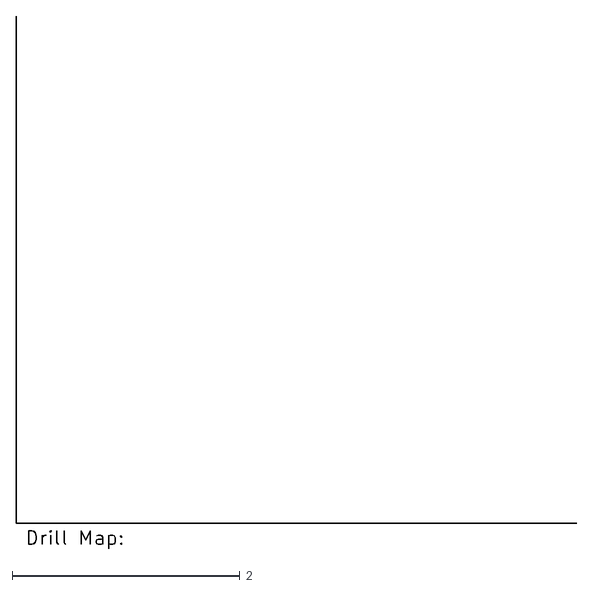
[picture p142: CAD file, 2023-03-05]
Serial interface/E8Serial/Gerber/E8Serial-NPTH-drl_map.dxf
4.92 x 4.67
