ibm2030/EDUC8/Serial interface/E8Serial/Housing/clam shell.FCStd

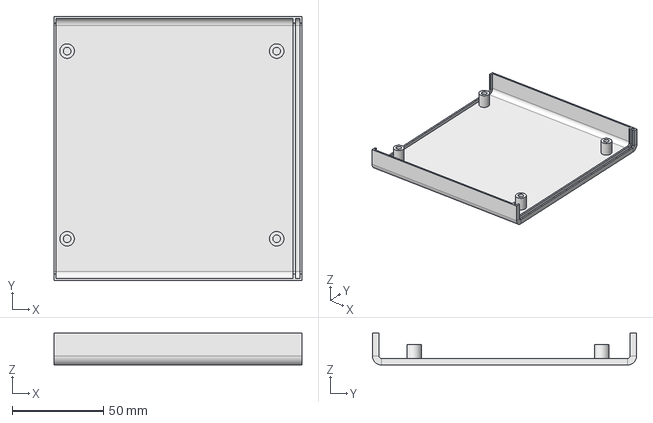
[picture p143: CAD file, 2024-06-13]
Serial interface/E8Serial/Housing/clam shell.FCStd
136.1 x 145.0 x 17.5 mm
