ibm2030/EDUC8/Serial interface/E8Serial/RS232-NEW/Gerber/FSK-PTH-drl_map.dxf

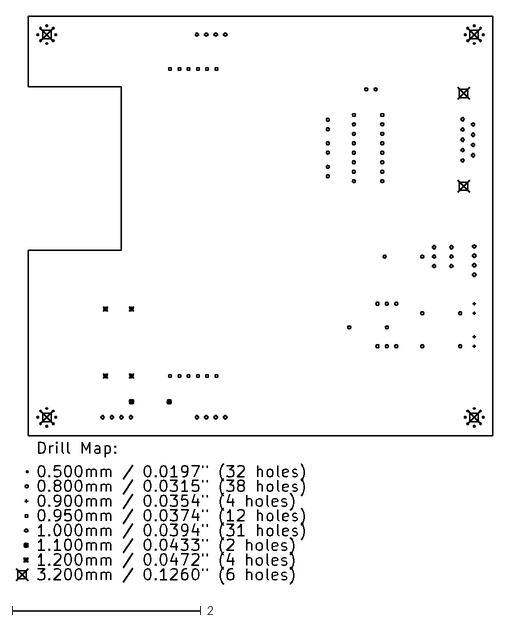
[picture p144: CAD file, 2023-03-05]
Serial interface/E8Serial/RS232-NEW/Gerber/FSK-PTH-drl_map.dxf
5.05 x 6.02
