ibm2030/EDUC8/Serial interface/E8Serial/Video terminal /GERBER/Video terminal -PTH-drl_map.dxf

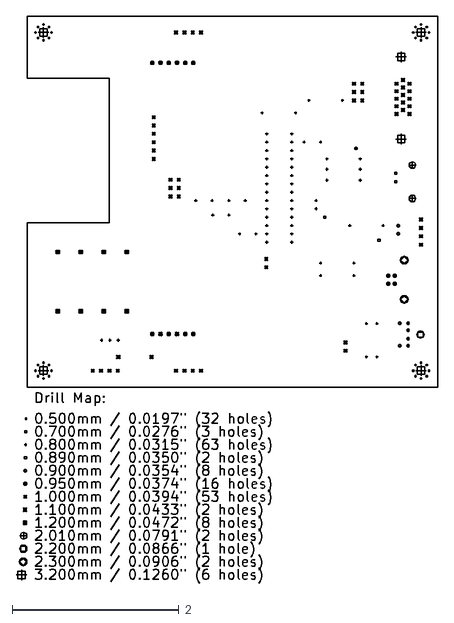
[picture p145: CAD file, 2023-03-05]
Serial interface/E8Serial/Video terminal /GERBER/Video terminal -PTH-drl_map.dxf
5.05 x 6.80
