ibm2030/EDUC8/Serial interface/E8Serial/WIFI-MODEM/Gerber/RS232-PTH-drl_map.dxf

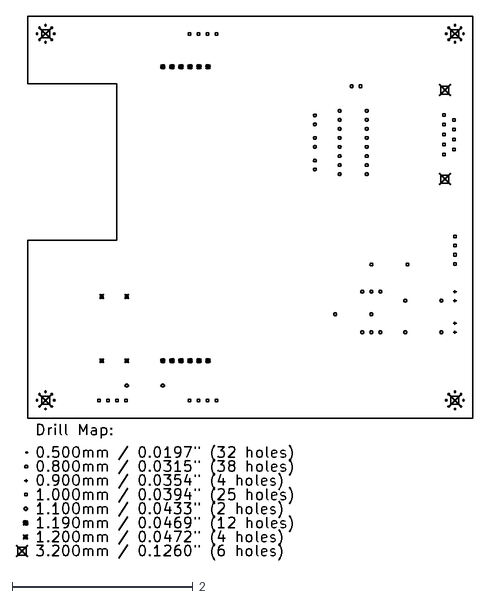
[picture p146: CAD file, 2023-03-05]
Serial interface/E8Serial/WIFI-MODEM/Gerber/RS232-PTH-drl_map.dxf
5.05 x 6.02
