ibm2030/EDUC8/Serial interface/E8Serial/WIFI-MODEM/nodemcu-lua-wifi-esp8266-1/ESP8266 v7.stp

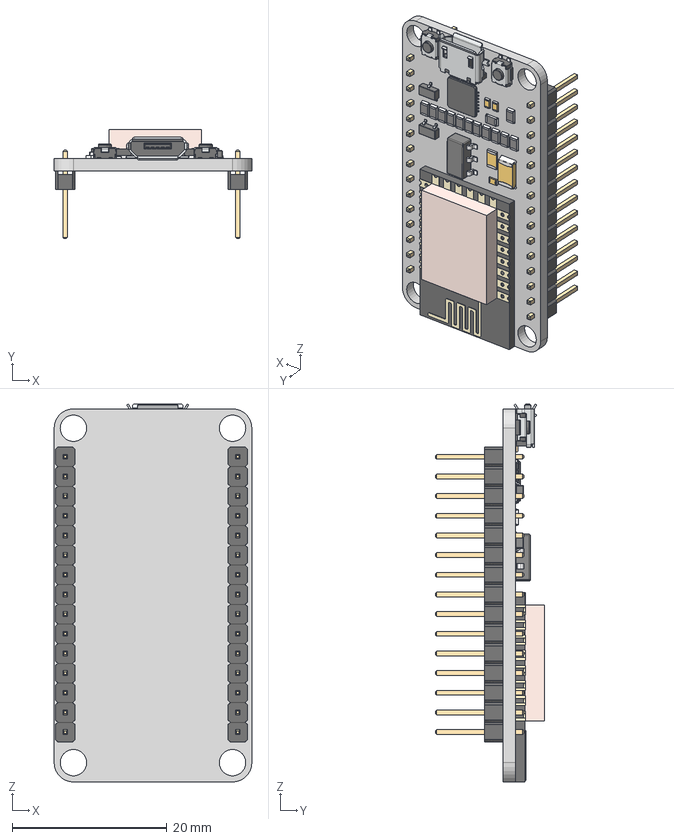
[picture p147: CAD file, 2023-03-05]
Serial interface/E8Serial/WIFI-MODEM/nodemcu-lua-wifi-esp8266-1/ESP8266 v7.stp
25.6 x 14.1 x 48.8 mm
micro usb shell
micro usb internal
micro usb contact x 5
switch v1
switch v1 (1)
spacer x 15
pin x 15
spacer (1) (1) x 15
pin (1) (1) x 15
TSOP-5 v4 v1
TSOP-5 v4 v1 (1)
TSOP-5 v4 v1 (1) (1)
R0805-NO v1 x 13
R0805-NO v1 (1) x 2
R0805-NO v1 (1) (1)
R0805-NO v1 (1) (2)
R0805-NO v1 (1) (3)
Cuerpo Microprocesador v1
