ibm2030/EDUC8/256 word memory/256 word memory 2.0/E8M Gerber/256 word memory_2.0-NPTH-drl_map.dxf

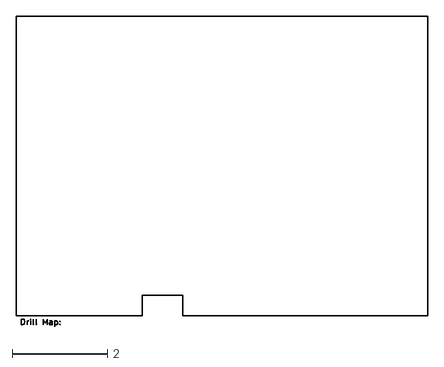
[picture p148: CAD file, 2023-03-05]
256 word memory/256 word memory 2.0/E8M Gerber/256 word memory_2.0-NPTH-drl_map.dxf
8.66 x 6.52
