ibm2030/EDUC8/256 word memory/E8M Gerber/2.0_EXPANED/256 word memory-NPTH-drl_map.dxf

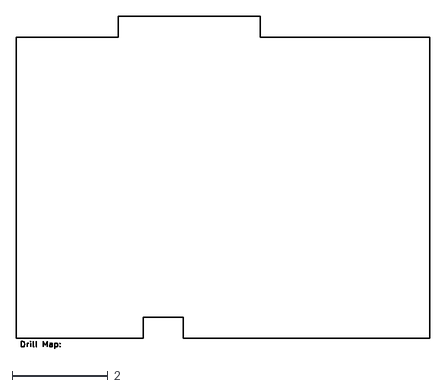
[picture p149: CAD file, 2023-03-05]
256 word memory/E8M Gerber/2.0_EXPANED/256 word memory-NPTH-drl_map.dxf
8.66 x 6.96
