ibm2030/EDUC8/3D MODELS/72 pin edge conmnector.step

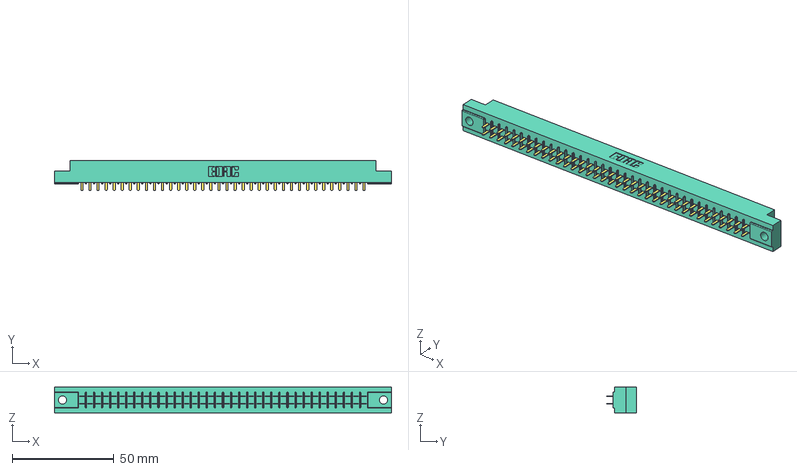
[picture p150: CAD file, 2023-03-05]
3D MODELS/72 pin edge conmnector.step
165.7 x 14.9 x 12.7 mm
305_Part_.156_Dia
