ibm2030/EDUC8/Accumulator/E8A Gerber/Accumulator-NPTH-drl_map.dxf

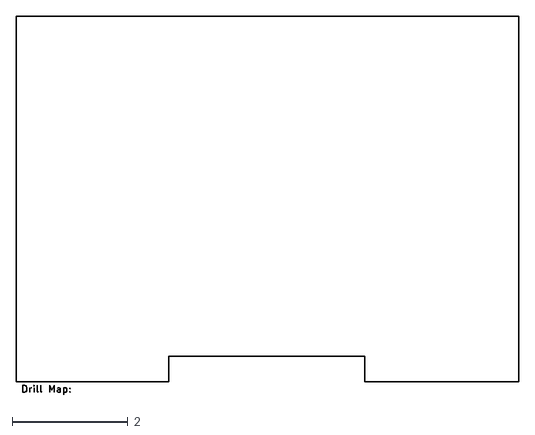
[picture p151: CAD file, 2023-03-05]
Accumulator/E8A Gerber/Accumulator-NPTH-drl_map.dxf
8.66 x 6.52
