ibm2030/EDUC8/ASCII keyboard/Gerber/ASCII keyboard-PTH-drl_map.dxf

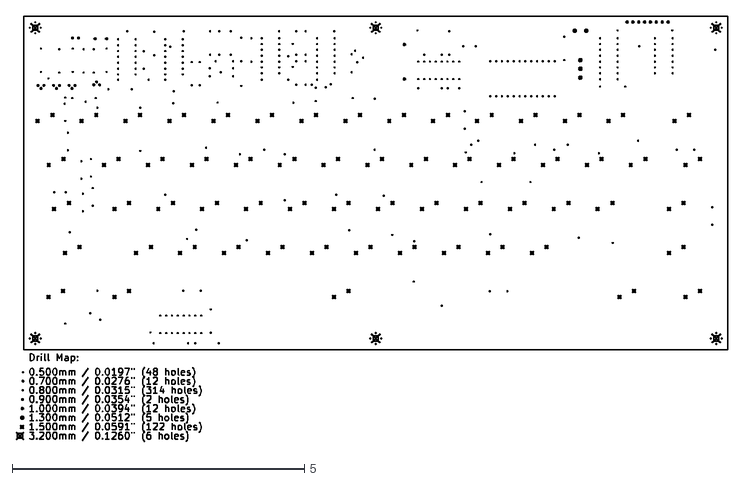
[picture p152: CAD file, 2023-03-05]
ASCII keyboard/Gerber/ASCII keyboard-PTH-drl_map.dxf
12.2 x 7.28
