ibm2030/EDUC8/Buffer/Gerber/Buffer-PTH-drl_map.dxf

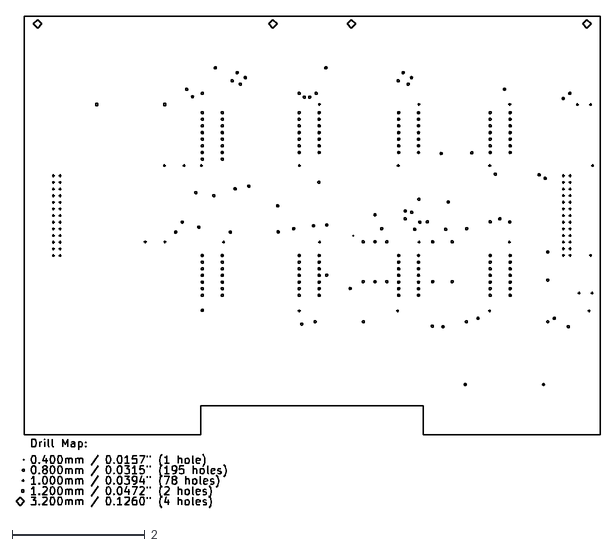
[picture p153: CAD file, 2023-03-05]
Buffer/Gerber/Buffer-PTH-drl_map.dxf
8.79 x 7.40
