ibm2030/EDUC8/Decoder/E8D Gerber/educ 8 decoder-NPTH-drl_map.dxf

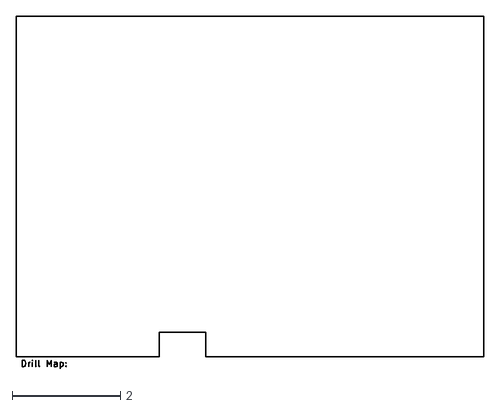
[picture p154: CAD file, 2023-03-05]
Decoder/E8D Gerber/educ 8 decoder-NPTH-drl_map.dxf
8.66 x 6.52
