ibm2030/EDUC8/EXTENDER CARDS/Gerber/EXTENDER CARDS-NPTH-drl_map.dxf

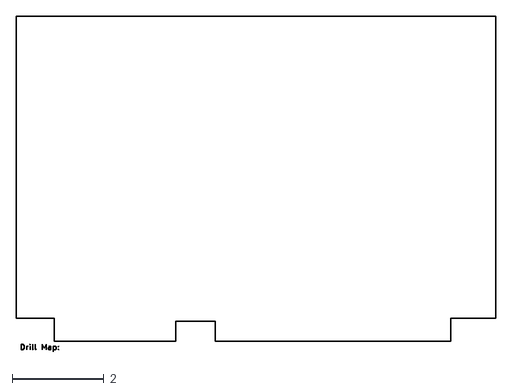
[picture p155: CAD file, 2023-03-05]
EXTENDER CARDS/Gerber/EXTENDER CARDS-NPTH-drl_map.dxf
10.5 x 7.31
