ibm2030/EDUC8/front panel/mechanical/Intercom-Body.stl

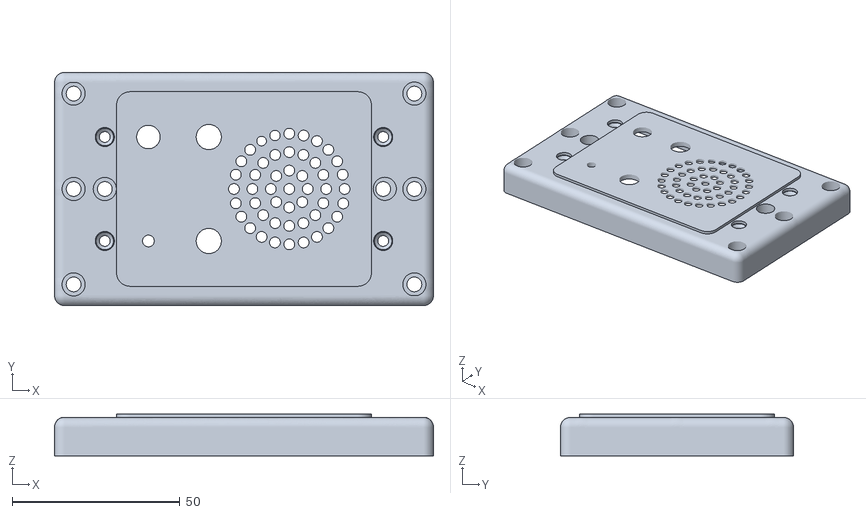
[picture p156: CAD file, 2023-03-05]
front panel/mechanical/Intercom-Body.stl
113.0 x 69.5 x 12.5
