ibm2030/EDUC8/Housing/switch lever/switch lever -Body (Meshed).stl

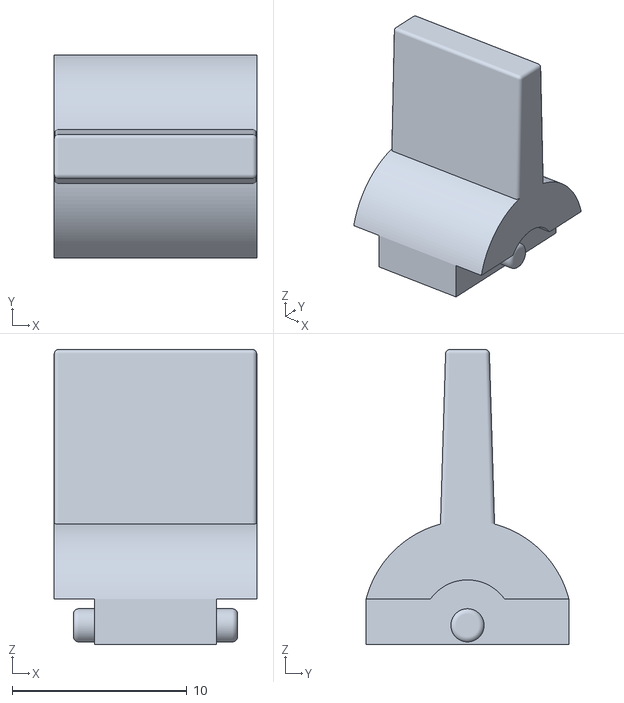
[picture p157: CAD file, 2025-07-23]
Housing/switch lever/switch lever -Body (Meshed).stl
11.6 x 11.6 x 16.9
