ibm2030/EDUC8/Input:Output Interface/E8T Gerber/Input:Output Interface-PTH-drl_map.dxf

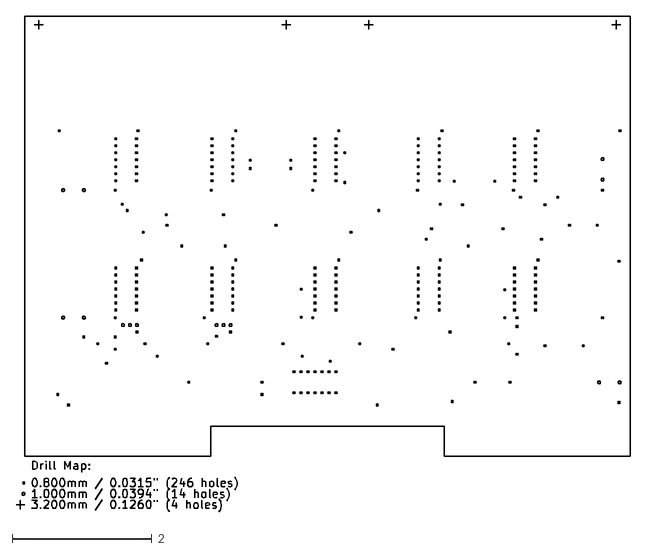
[picture p158: CAD file, 2023-03-05]
Input:Output Interface/E8T Gerber/Input:Output Interface-PTH-drl_map.dxf
8.79 x 7.09
