ibm2030/EDUC8/motherboard/Gerber/motherboard-NPTH-drl_map.dxf

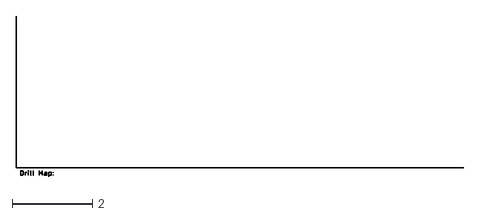
[picture p159: CAD file, 2023-03-05]
motherboard/Gerber/motherboard-NPTH-drl_map.dxf
11.1 x 4.00
