ibm2030/EDUC8/Octal display 2/Gerber/Octal display-NPTH-drl_map.dxf

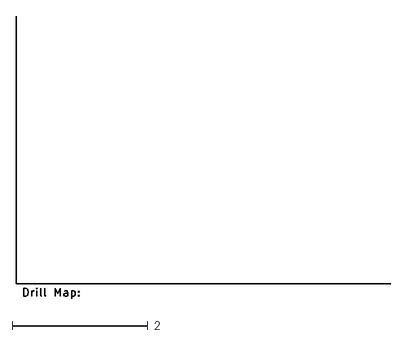
[picture p160: CAD file, 2023-03-05]
Octal display 2/Gerber/Octal display-NPTH-drl_map.dxf
5.51 x 4.16
