ibm2030/EDUC8/Octal display 2/Pot and switch board/support PCB/Gerber/support PCB-PTH-drl_map.dxf

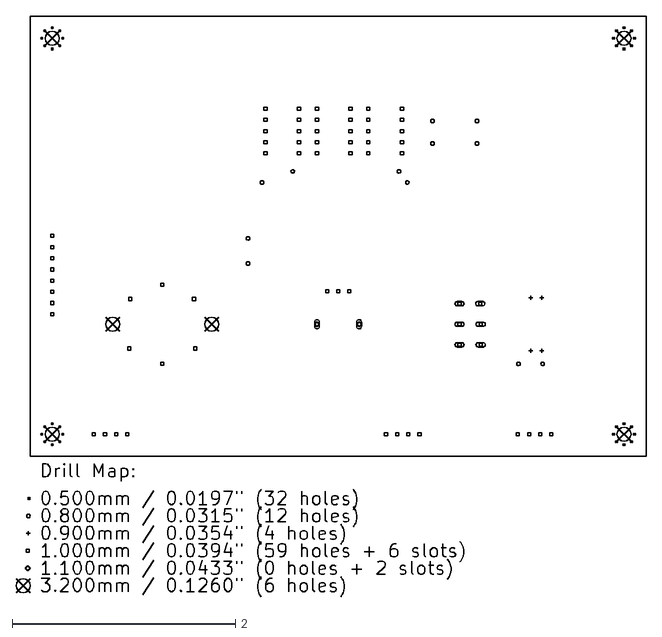
[picture p161: CAD file, 2023-03-05]
Octal display 2/Pot and switch board/support PCB/Gerber/support PCB-PTH-drl_map.dxf
5.64 x 5.19
