ibm2030/EDUC8/octal. keyboard/octal keyboard/E8KB/octal keyboard-PTH-drl_map.dxf

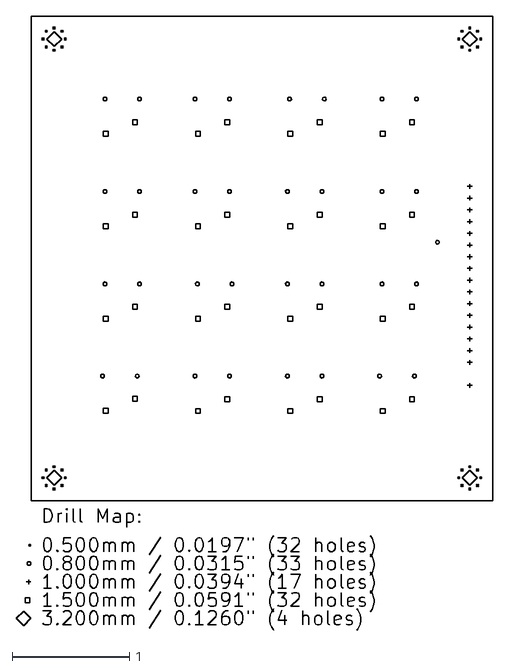
[picture p162: CAD file, 2023-03-05]
octal. keyboard/octal keyboard/E8KB/octal keyboard-PTH-drl_map.dxf
4.06 x 5.23
