ibm2030/EDUC8/octal. keyboard/octal keyboard/Gerber/Keyboard interface-PTH-drl_map.dxf

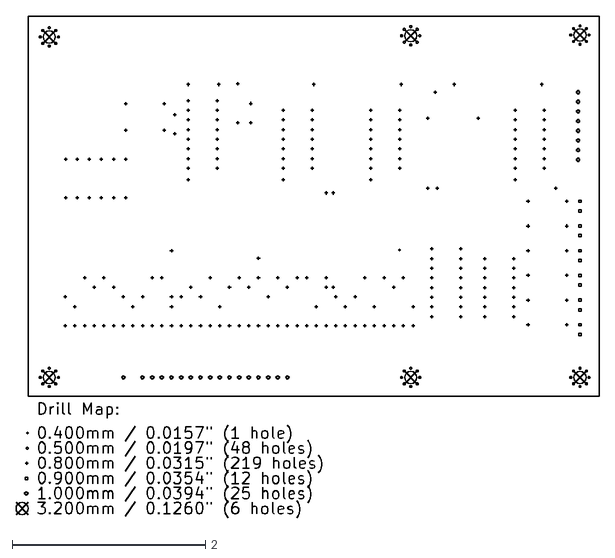
[picture p163: CAD file, 2023-03-05]
octal. keyboard/octal keyboard/Gerber/Keyboard interface-PTH-drl_map.dxf
6.03 x 5.19
