ibm2030/EDUC8/Power Supply 2/Gerber/EDUC-8 PSU-NPTH-drl_map.dxf

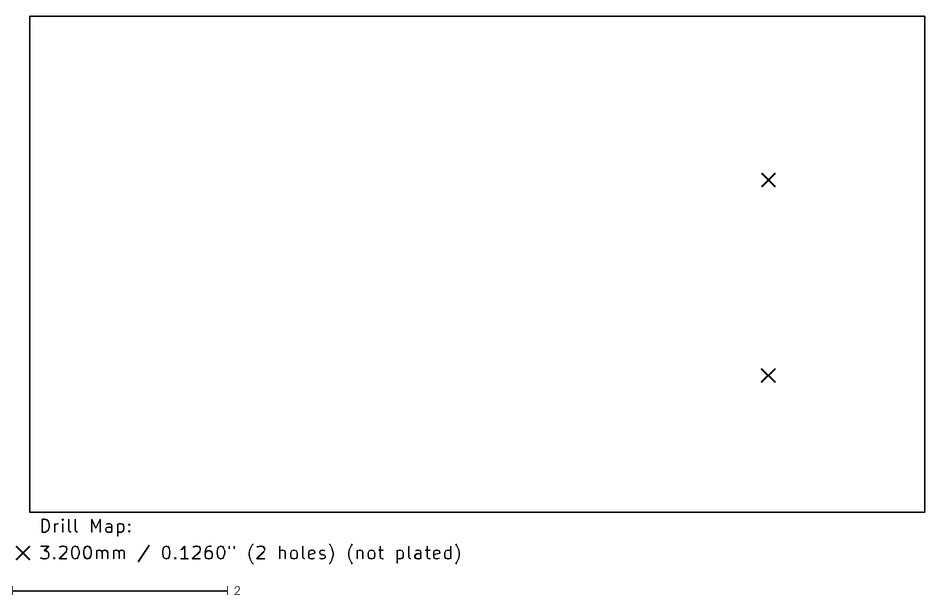
[picture p164: CAD file, 2023-03-05]
Power Supply 2/Gerber/EDUC-8 PSU-NPTH-drl_map.dxf
8.43 x 5.08
