ibm2030/EDUC8/Power Supply/Crowbar/EDUC-8 Crowbar/GERBER/EDUC-8 Crowbar-PTH-drl_map.dxf

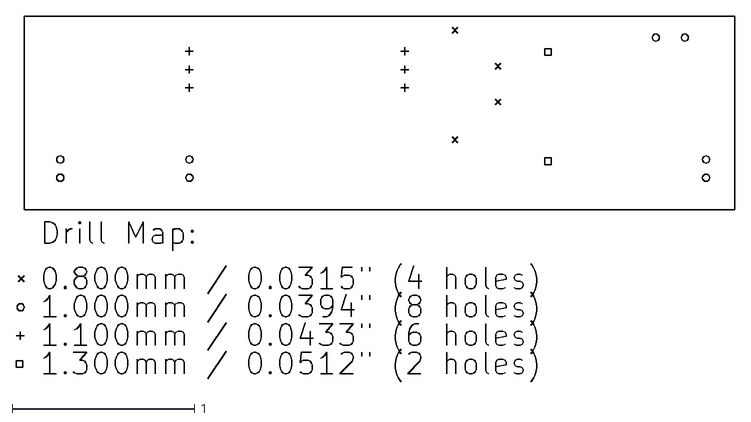
[picture p165: CAD file, 2023-03-05]
Power Supply/Crowbar/EDUC-8 Crowbar/GERBER/EDUC-8 Crowbar-PTH-drl_map.dxf
3.94 x 2.01
