ibm2030/EDUC8/Power Supply/Gerber/EDUC-8 PSU-PTH-drl_map.dxf

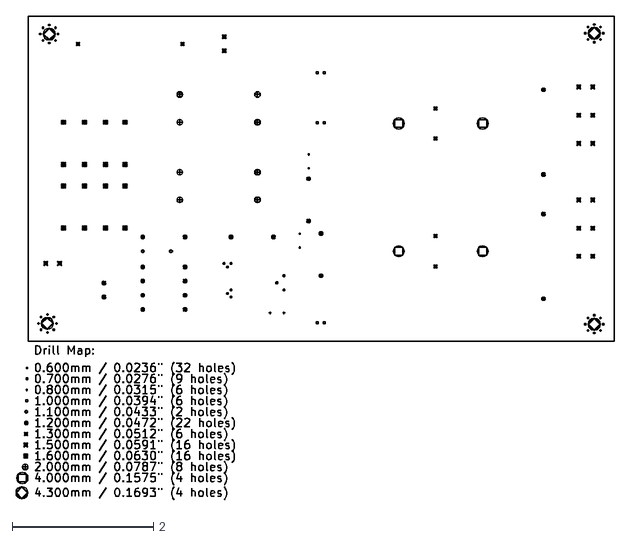
[picture p166: CAD file, 2023-03-05]
Power Supply/Gerber/EDUC-8 PSU-PTH-drl_map.dxf
8.47 x 6.85
