ibm2030/EDUC8/Serial interface/E8Serial/Gerber/E8Serial-PTH-drl_map.dxf

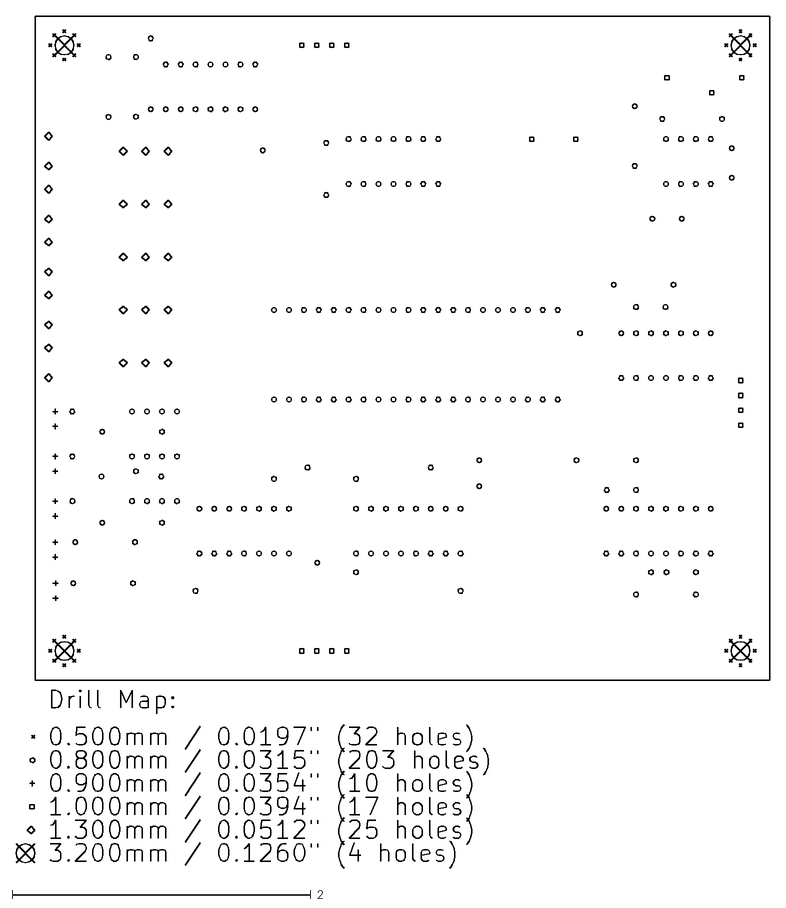
[picture p167: CAD file, 2023-03-05]
Serial interface/E8Serial/Gerber/E8Serial-PTH-drl_map.dxf
5.05 x 5.71
