ibm2030/EDUC8/Serial interface/E8Serial/Video terminal /GERBER/Video terminal -NPTH-drl_map.dxf

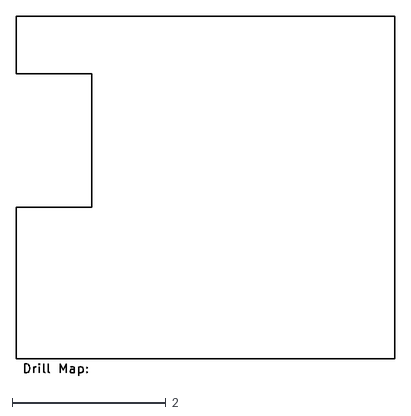
[picture p168: CAD file, 2023-03-05]
Serial interface/E8Serial/Video terminal /GERBER/Video terminal -NPTH-drl_map.dxf
4.92 x 4.67
