ibm2030/EDUC8/ASCII keyboard/cherry-mx-stabilizer-mx-1/mx Stabilizer key 16828.SLDPRT

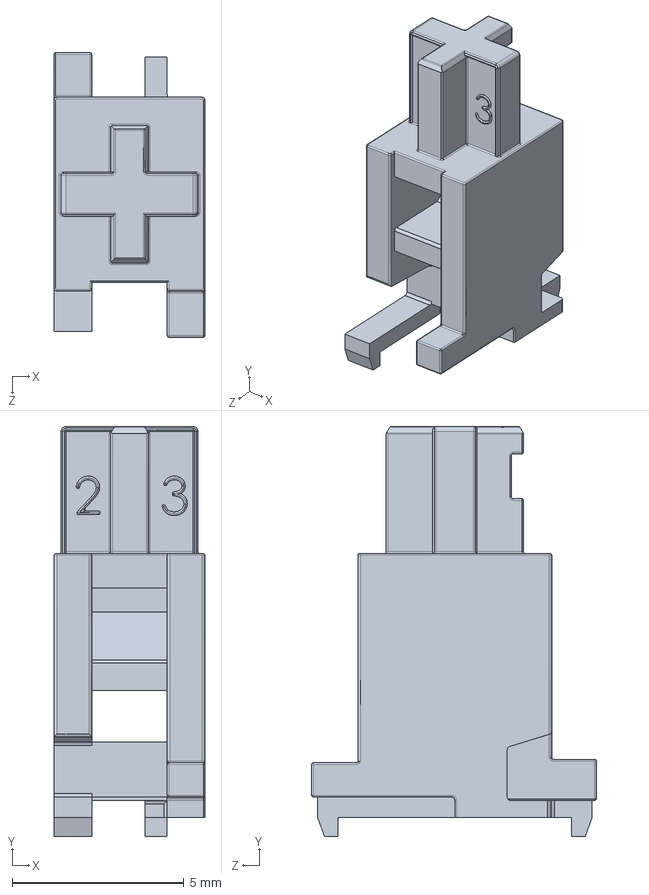
[picture p169: CAD file, 2023-03-05]
ASCII keyboard/cherry-mx-stabilizer-mx-1/mx Stabilizer key 16828.SLDPRT
4.40 x 11.9 x 8.30 mm
