ibm2030/EDUC8/front panel/mechanical/3D printed front panel.FCStd

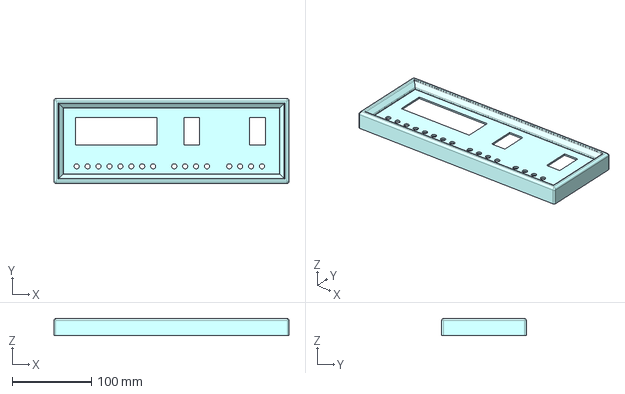
[picture p170: CAD file, 2023-03-05]
front panel/mechanical/3D printed front panel.FCStd
297.0 x 107.0 x 22.0 mm
