ibm2030/EDUC8/Housing/PCB support-Body.stl

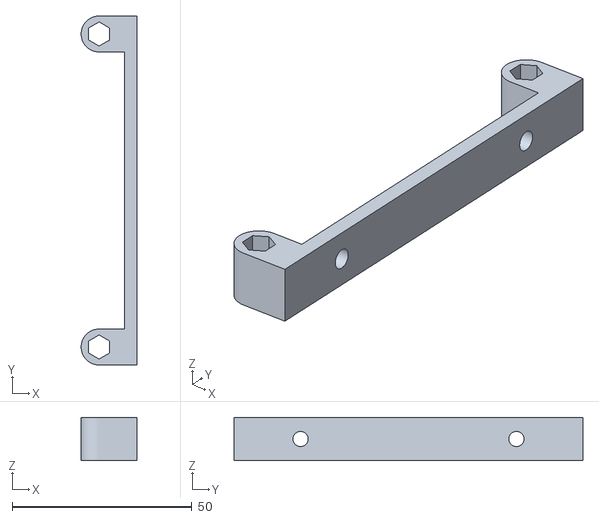
[picture p171: CAD file, 2025-07-23]
Housing/PCB support-Body.stl
15.5 x 97.0 x 12.0
