ibm2030/EDUC8/ASCII keyboard/cherry-mx-stabilizer-mx-1/metal stick 16828.SLDPRT

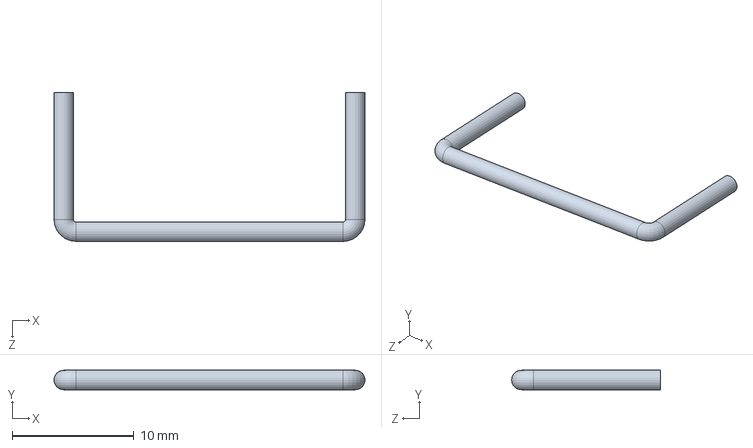
[picture p172: CAD file, 2023-03-05]
ASCII keyboard/cherry-mx-stabilizer-mx-1/metal stick 16828.SLDPRT
25.5 x 1.60 x 12.2 mm
