ibm2030/EDUC8/Housing/perspex window-Body.dxf

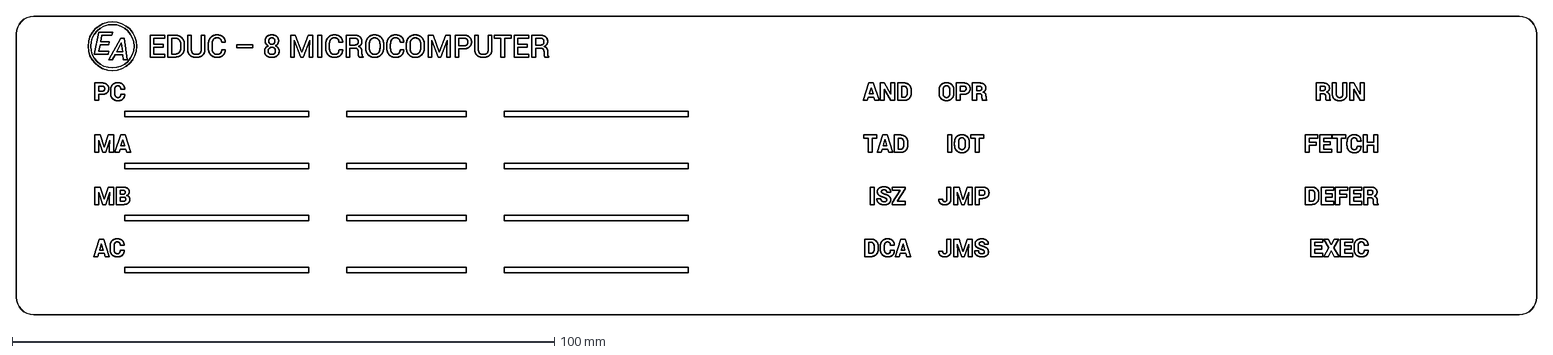
[picture p173: CAD file, 2025-07-23]
Housing/perspex window-Body.dxf
280.5 x 55.0 mm
