ibm2030/EDUC8/Housing/switch lever/switch lever MA-Body (Meshed).3mf

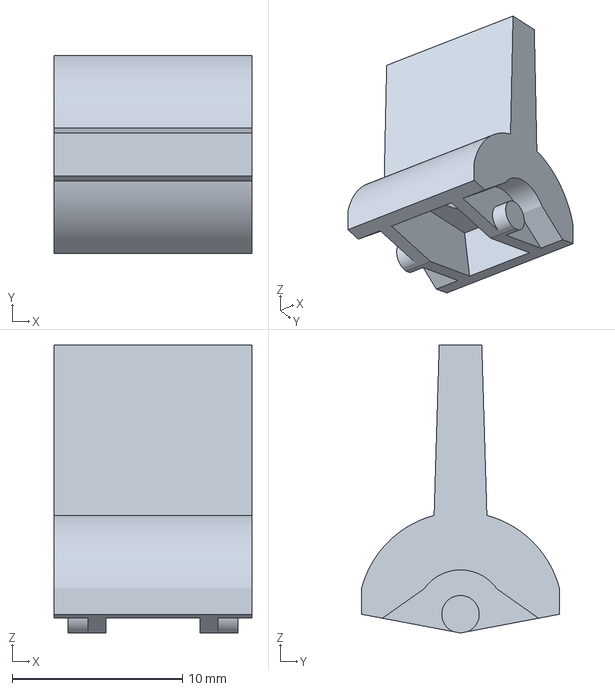
[picture p174: CAD file, 2025-07-23]
Housing/switch lever/switch lever MA-Body (Meshed).3mf
11.6 x 11.6 x 16.9 mm
