ibm2030/EDUC8/ASCII keyboard/cherry-mx-stabilizer-mx-1/Stabilizer - open.STEP

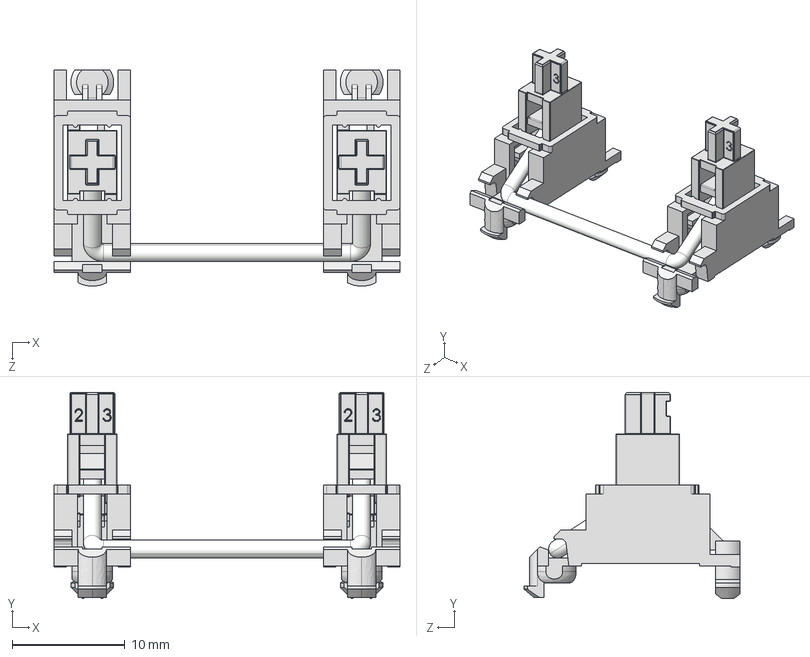
[picture p175: CAD file, 2023-03-05]
ASCII keyboard/cherry-mx-stabilizer-mx-1/Stabilizer - open.STEP
30.7 x 18.3 x 19.2 mm
mx Stabilizer base 16828 x 2
mx Stabilizer key 16828 x 2
metal stick 16828
