ibm2030/EDUC8/Housing/front panel-Body (Meshed).3mf

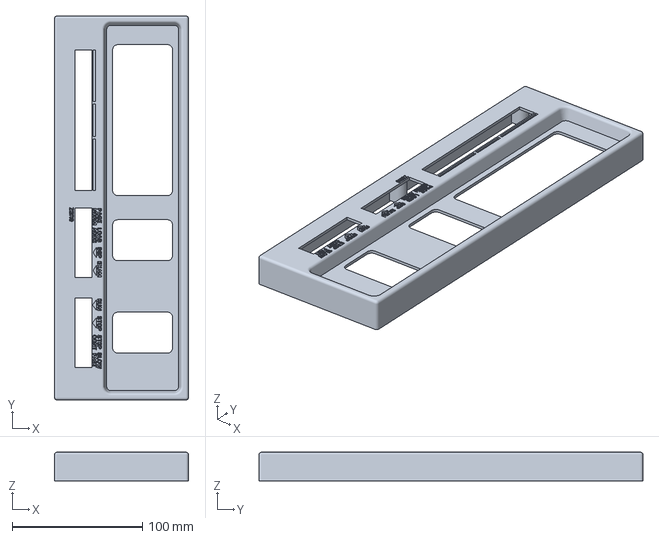
[picture p176: CAD file, 2025-07-23]
Housing/front panel-Body (Meshed).3mf
103.0 x 295.0 x 22.0 mm
