ibm2030/EDUC8/Housing/switch lever/switch lever .FCStd

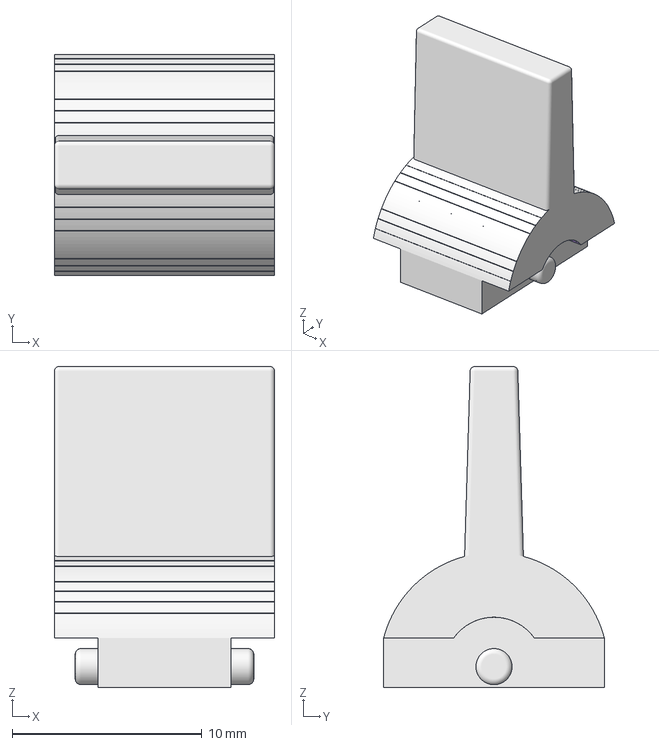
[picture p177: CAD file, 2025-07-23]
Housing/switch lever/switch lever .FCStd
11.6 x 11.6 x 16.9 mm
Body (Meshed)
