ibm2030/EDUC8/Housing/perspex window 3.FCStd

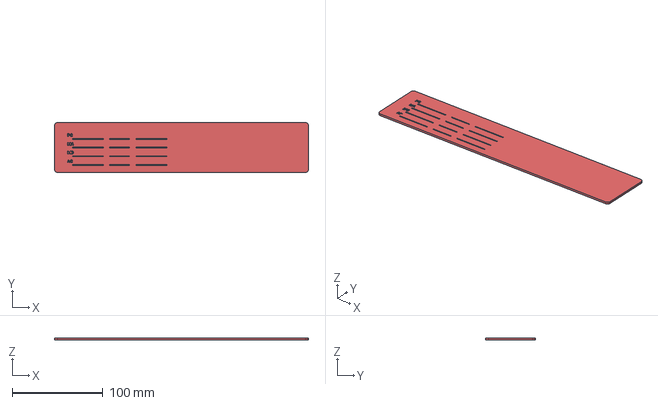
[picture p178: CAD file, 2025-07-23]
Housing/perspex window 3.FCStd
280.5 x 55.0 x 2.00 mm
