ibm2030/EDUC8/Housing/PCB support.FCStd

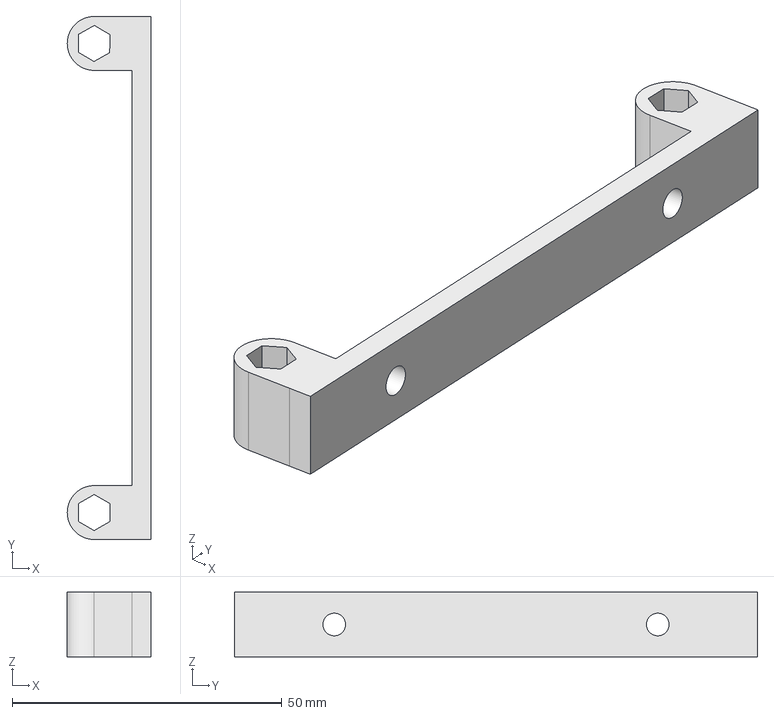
[picture p179: CAD file, 2025-07-23]
Housing/PCB support.FCStd
15.5 x 97.0 x 12.0 mm
