ibm2030/EDUC8/Housing/MULTIPLEXER FRONT PANEL.FCStd

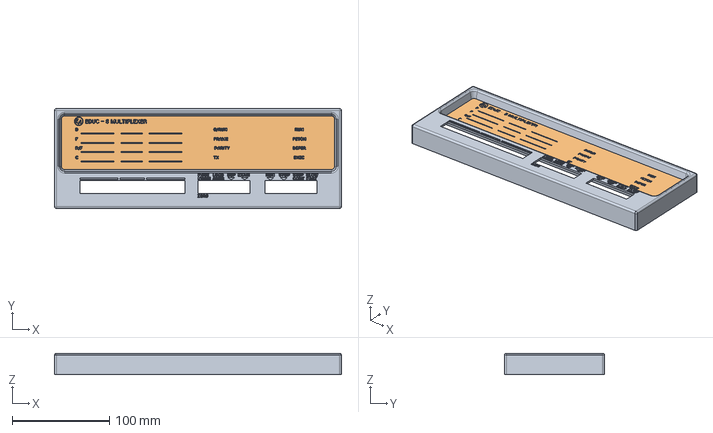
[picture p180: CAD file, 2025-07-23]
Housing/MULTIPLEXER FRONT PANEL.FCStd
295.0 x 103.0 x 22.0 mm
front panel_001
MULTIPLEXER perspex window_001
