ibm2030/EDUC8/Housing/gasket-PolarPattern (Meshed).stl

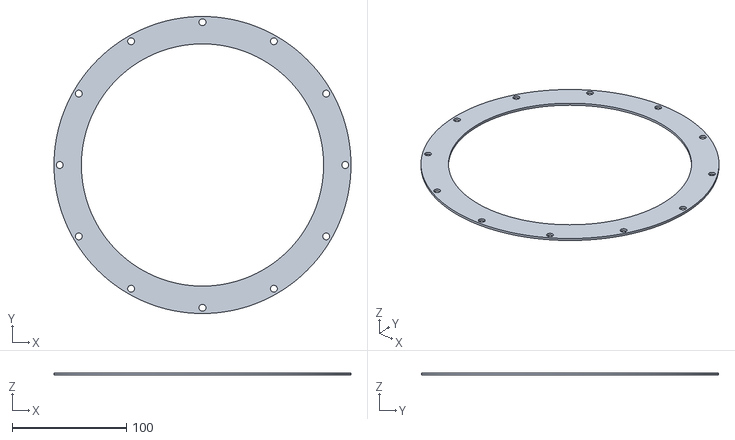
[picture p181: CAD file, 2025-07-23]
Housing/gasket-PolarPattern (Meshed).stl
260.0 x 260.0 x 2.00
