ibm2030/EDUC8/Housing/perspex window.FCStd

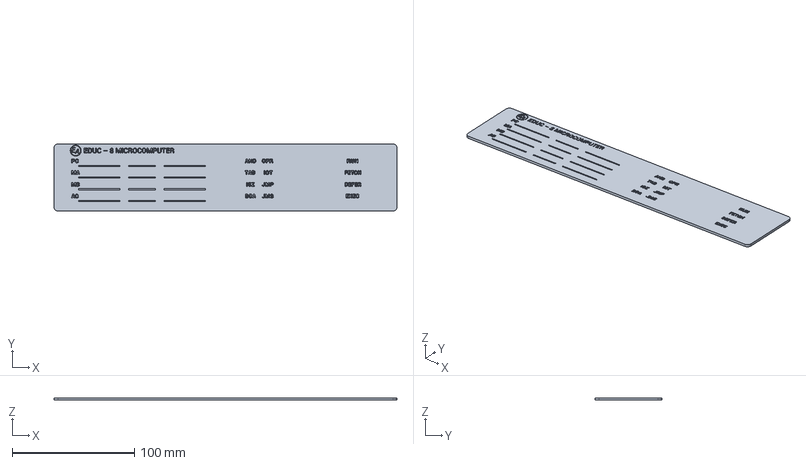
[picture p182: CAD file, 2025-07-23]
Housing/perspex window.FCStd
280.5 x 55.0 x 2.00 mm
