ibm2030/EDUC8/(list of files, cad)

Other CAD files:
ASCII keyboard/assembly.FCStd
Octal display 2/Pot and switch board/MECHANCAL ASSEMBLY/ASSY.FCStd
Housing/Main case-Body (Meshed).stl
Housing/Main case.FCStd
Mechanical front panel/Front panel mechanical drawings.FCStd
PC and ADDER 74LS74 MOD/PC and ADDER 74LS74 MOD.step
Housing/front panel 6.FCStd
Housing/Rubber feet/rubber feet-Body.stl
Mechanical front panel/Front panel.STEP
Octal display/Housing for veroboard /Veroboard housing-Body.stl
Housing/switch lever/Body (Meshed).stl
front panel/mechanical/3D printed front panel-Body.stl
Housing/front panel-Body.stl
Housing/switch lever/switch lever MA 3.FCStd
ASCII keyboard/cherry-mx-stabilizer-mx-1/Stabilizer - close.STEP
Housing/switch lever/switch lever MA-Body.3mf
Housing/front panel 5.FCStd
Housing/front panel 3.FCStd
Housing/perspex window 4.FCStd
Housing/front panel 7.FCStd
Housing/MULTIPLEXER perspex window.FCStd
Decoder/educ 8 decoder.stp
Housing/Main case-Body.stl
Housing/front panel-Body (Meshed).dxf
Housing/front panel-Body (Meshed).stl
Housing/switch lever/switch lever MA-Body (Meshed).stl
Serial interface/E8Serial/WIFI-MODEM/nodemcu-lua-wifi-esp8266-1/ESP8266 v7.f3d
Serial interface/E8Serial/WIFI-MODEM/nodemcu-lua-wifi-esp8266-1/Led RGB v4.f3d
