ibm2030/EDUC8/E8Serial/Video terminal /ConstructionPack/Composite Interface.png

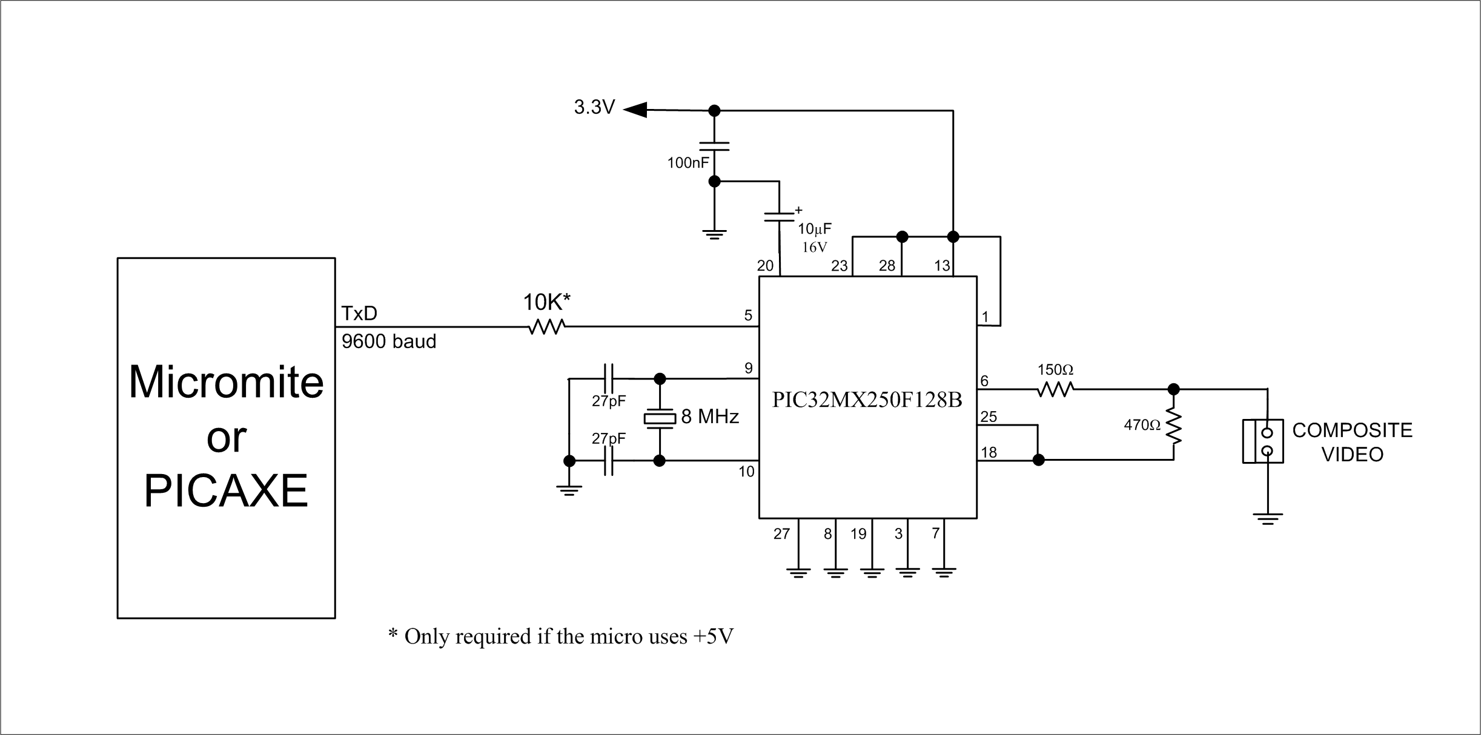
E8Serial/Video terminal /ConstructionPack/Composite Interface.png
