ibm2030/EDUC8/E8Serial/Video terminal /ConstructionPack/USB-to-Serial bridge.png

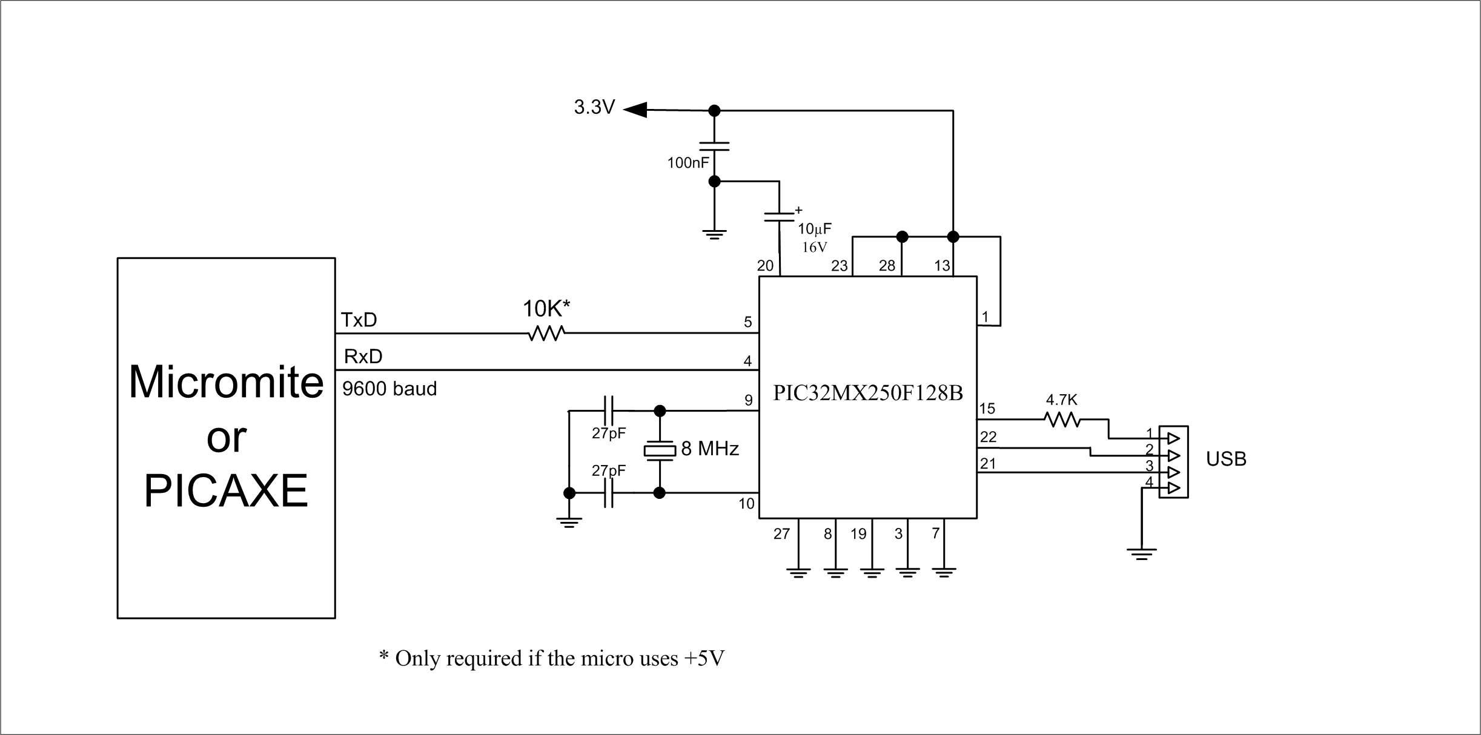
E8Serial/Video terminal /ConstructionPack/USB-to-Serial bridge.png
