ibm2030/EDUC8/Changelog 20-7-25.pdf

Changes 20-5-27

E8/T. Connected 3 missing supply rail tracks to ICS
Added flood fill top and bottom to reduce noise

E8/F Corrected labelling on RHS board to reflect EXT_LA not GND Changed fast slow switch operation so fast is in the DOWN position.

E8/C. Ran a new track to the 2 pin JST connector from EXT_LA from 10 pin connector on SR input.

Added files for E8MX, 2k byte memory expansion board
