ibm2030/EDUC8/rear panel wiring looms.pdf

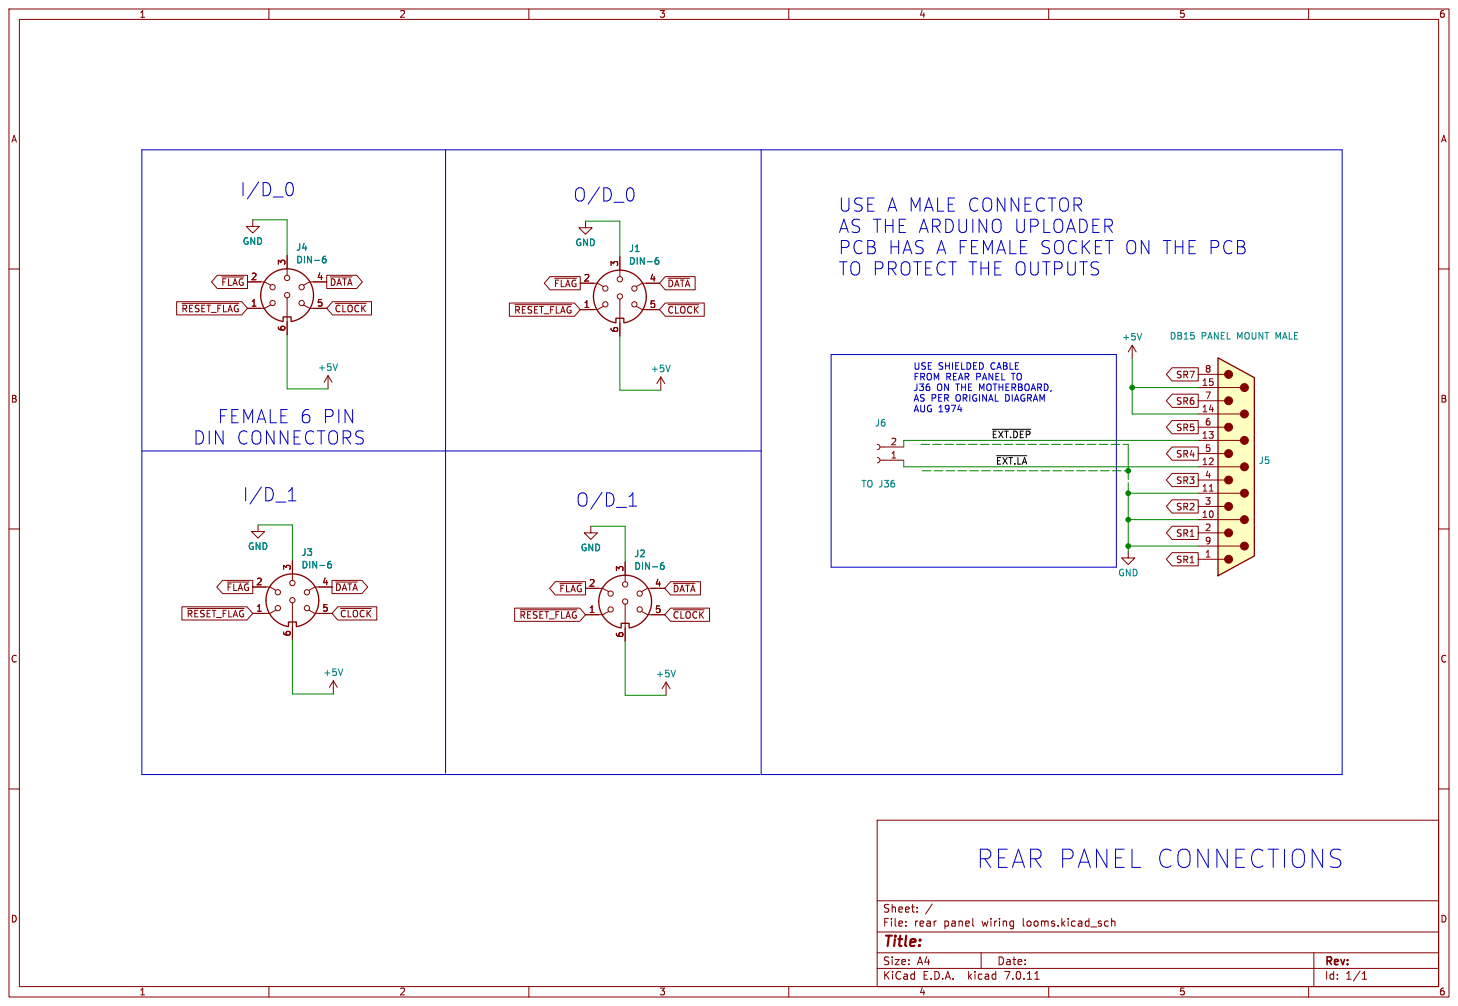
[picture p185: page 1]

USE A MALE CONNECTOR
AS THE ARDUINO UPLOADER
TO PROTECT THE OUTPUTS

USE SHIELDED CABLE
FROM REAR PANEL TO
J36 ON THE MOTHERBOARD, AS PER ORIGINAL DIAGRAM
