ibm2030/EDUC8/128 X 16 RAM V5 FINAL/plots/128 X 16 RAM V4 FINAL __Assembly.pdf

1 | 2 | 3 | 4 | 5 | 6

A

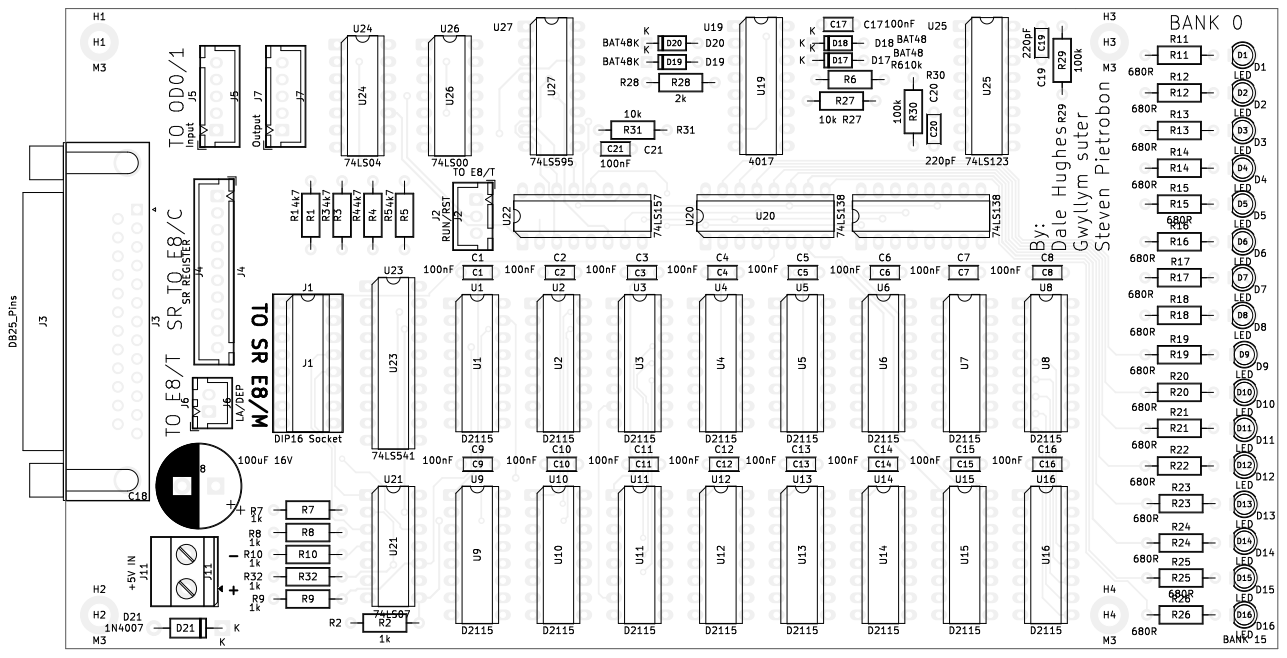
[picture p186: page 1]

Id: /1 Title: File: 128 X 16 RAM V4 FINAL .kicad_pcb Sheet: Black And White TOP

1 | 2 | 3 | 4 | 5 | 6

A

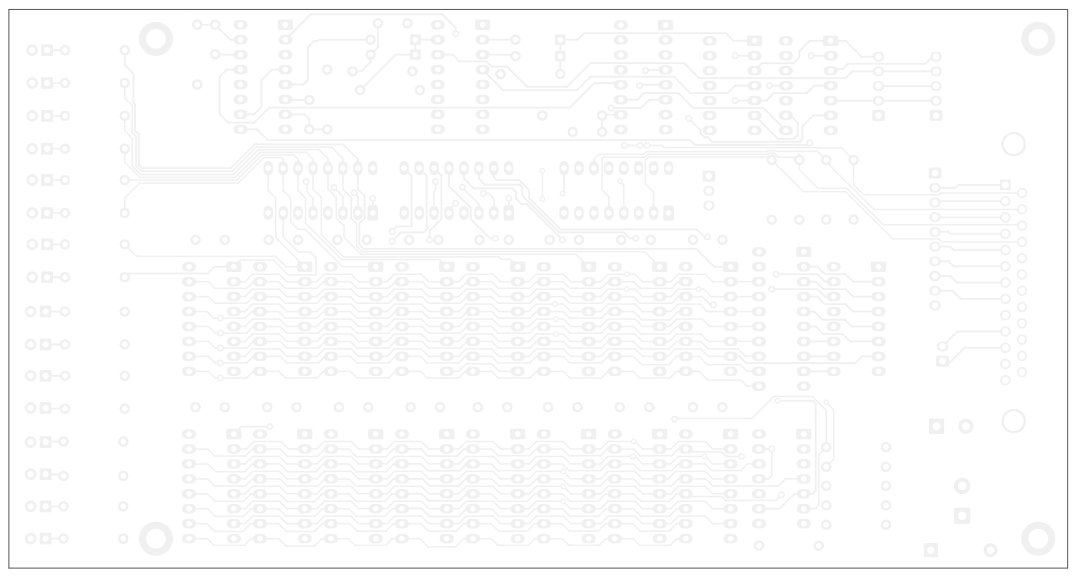
[picture p187: page 2]
D Date: KiCad; E.D.A. 9.0.1 Size: A4; Rev:; Id: /1 Title: File: 128 X; RAM V4; FINAL; .kicad_pcb Sheet: Black; And; White; BOT Board2Pdf:; Black; BOT -; Page 2/2
