ibm2030/EDUC8/Power Supply/plots/EDUC-8 PSU__Assembly.pdf

GND | +5V 2A Fast

# GND AC IN

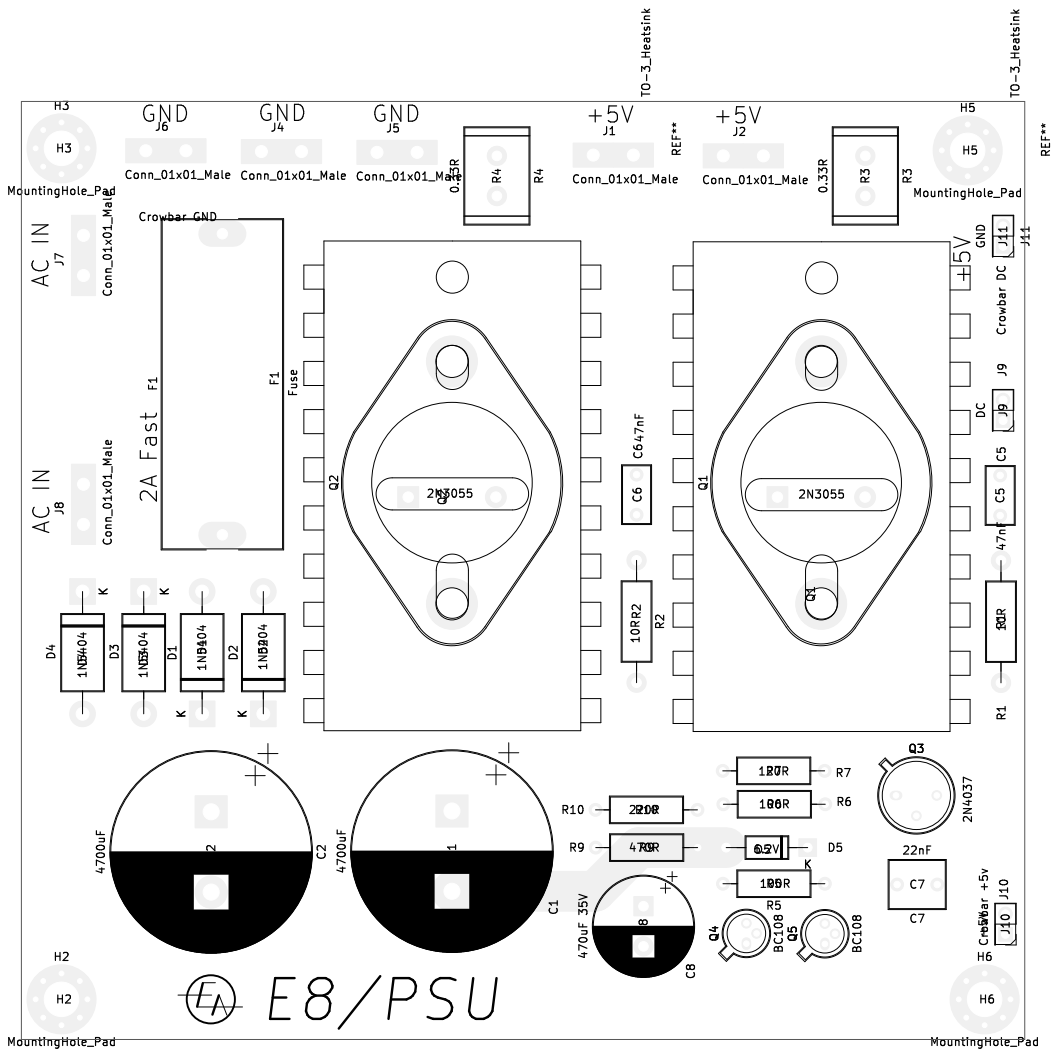
[picture p188: page 1]

1 | 2 | 3 | 4 | 5 | 6

A

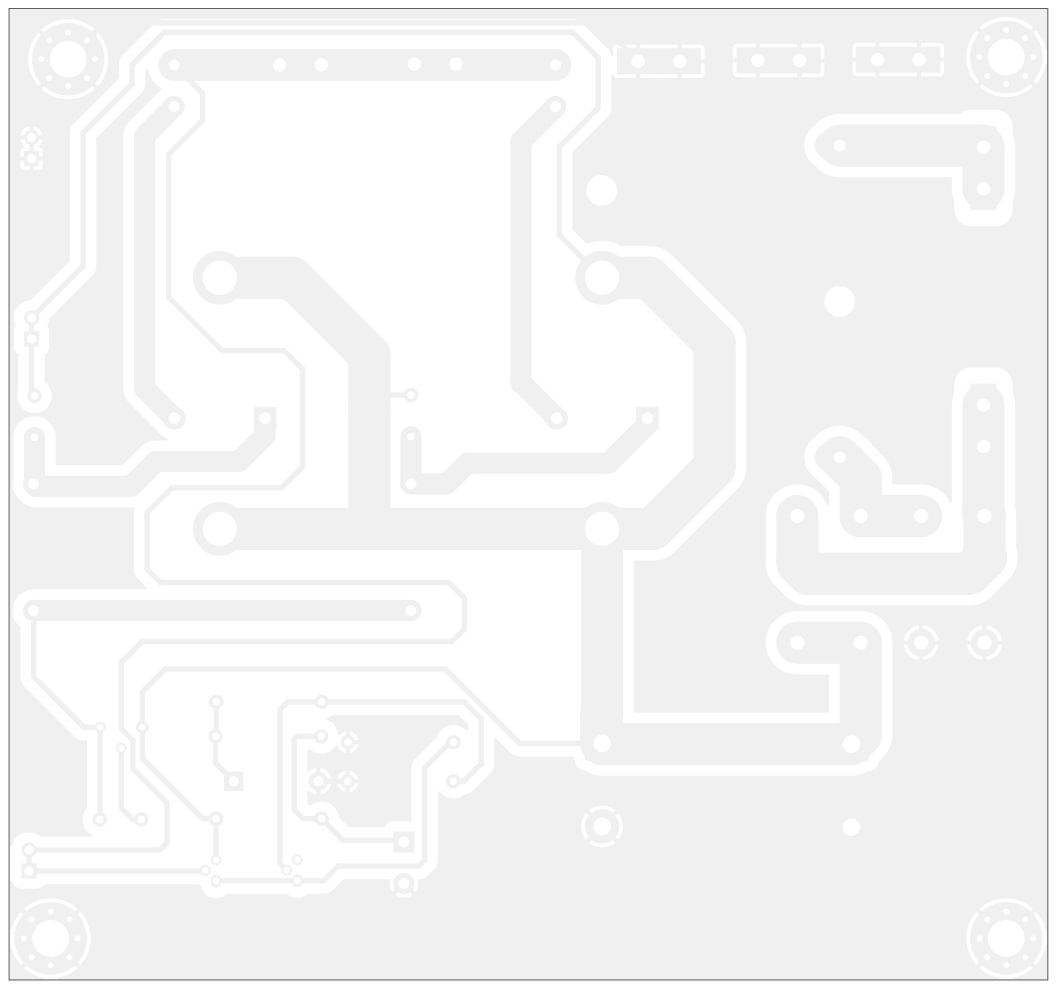
[picture p189: page 2]
D Date: KiCad; E.D.A. 9.0.1 Size: A4; Rev:; Id: /1 Title: File: EDUC-8; PSU.kicad_pcb Sheet: Black; And; White; BOT Board2Pdf:; Black; BOT -; Page 2/2
