ibm2030/EDUC8/Timing/plots/educ 8 timing __Assembly.pdf

# J2 CLK

# J4 Q¹ BC⁵⁴⁸

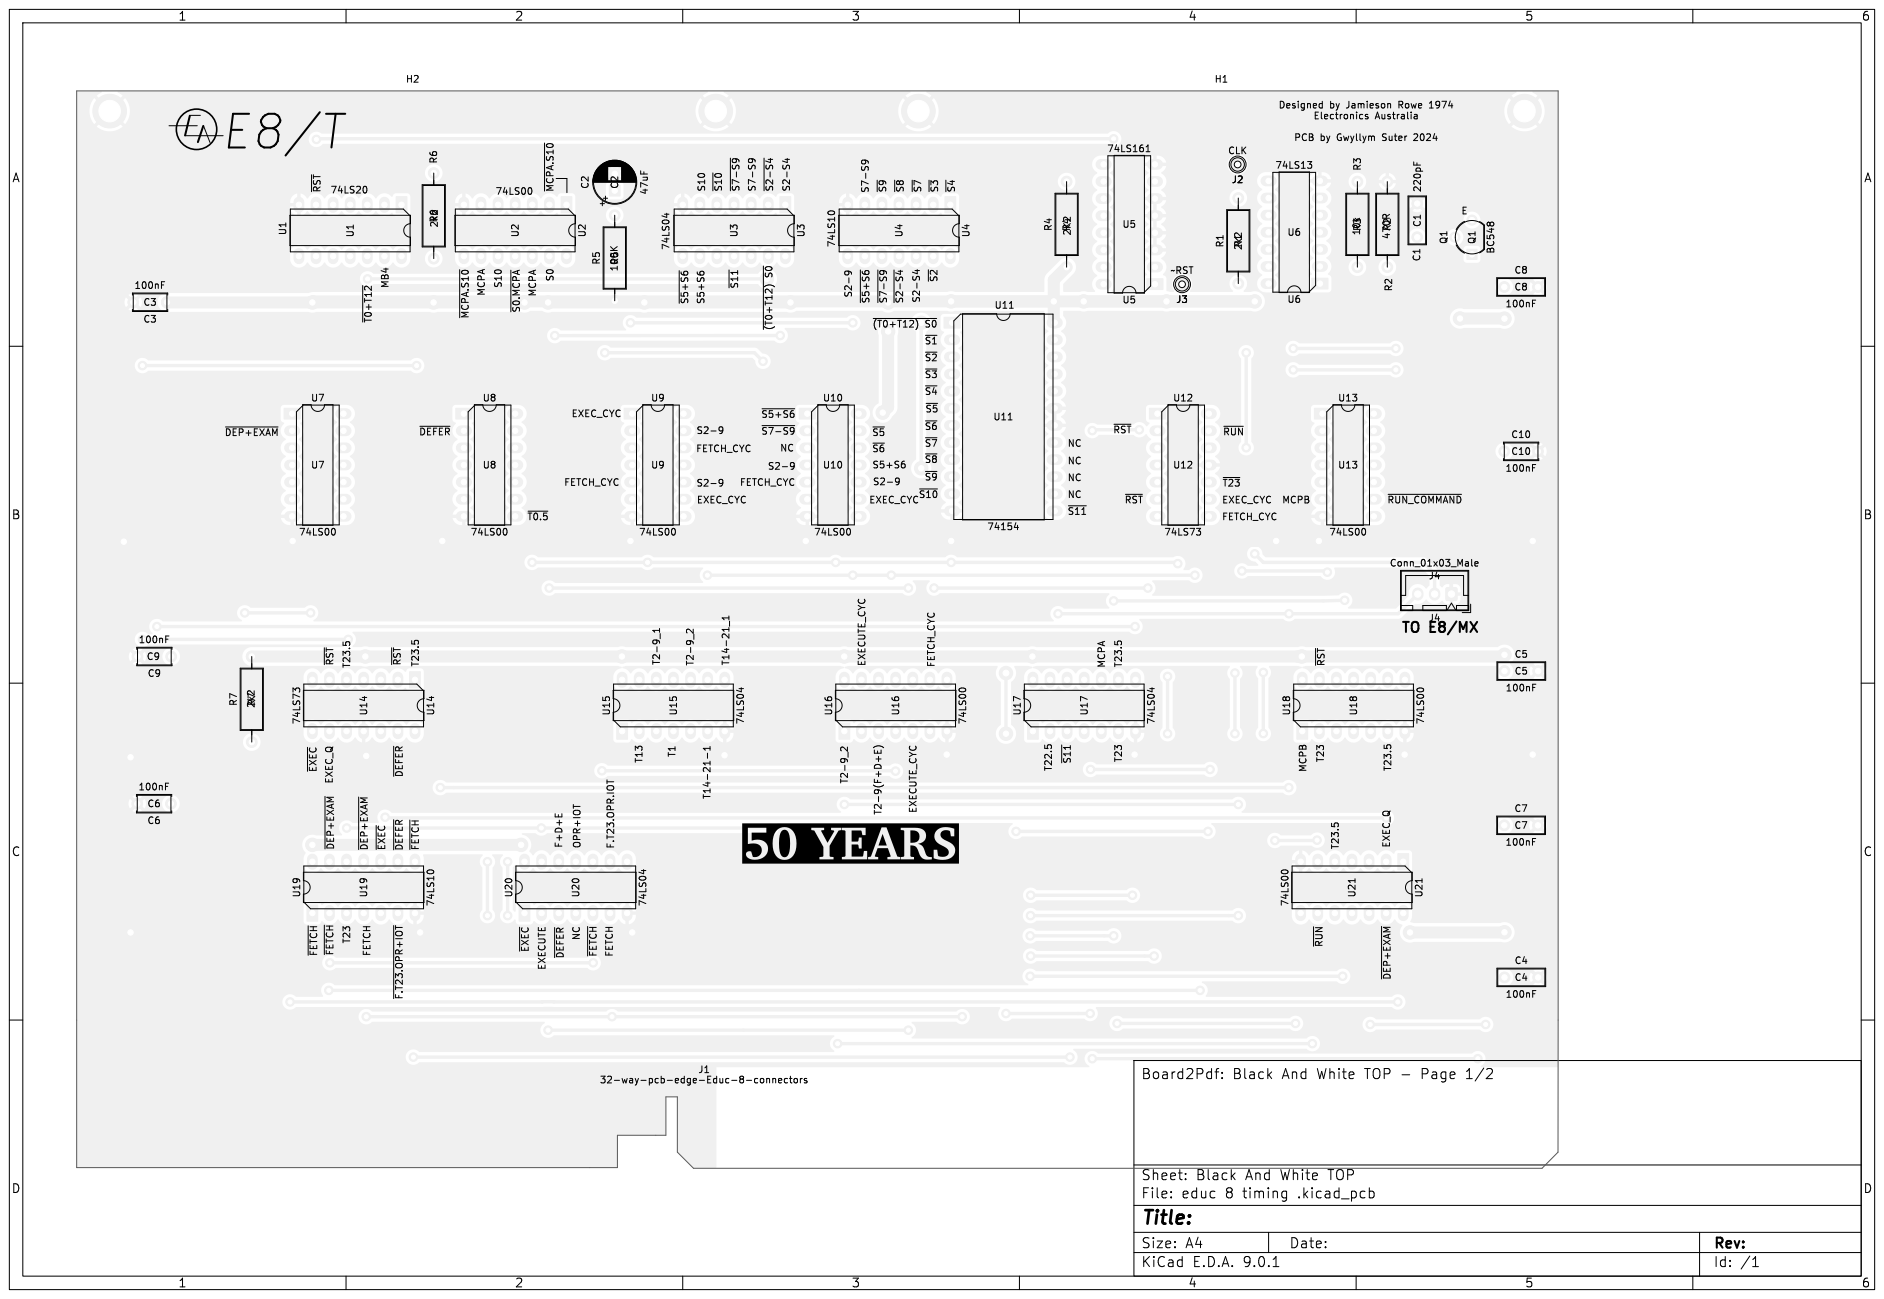
[picture p190: page 1]

32-way-pcb-edge-Educ-8-connectors

Id: /1 Title: File: educ 8 timing .kicad_pcb Sheet: Black And White TOP

1 | 2 | 3 | 4 | 5 | 6

A

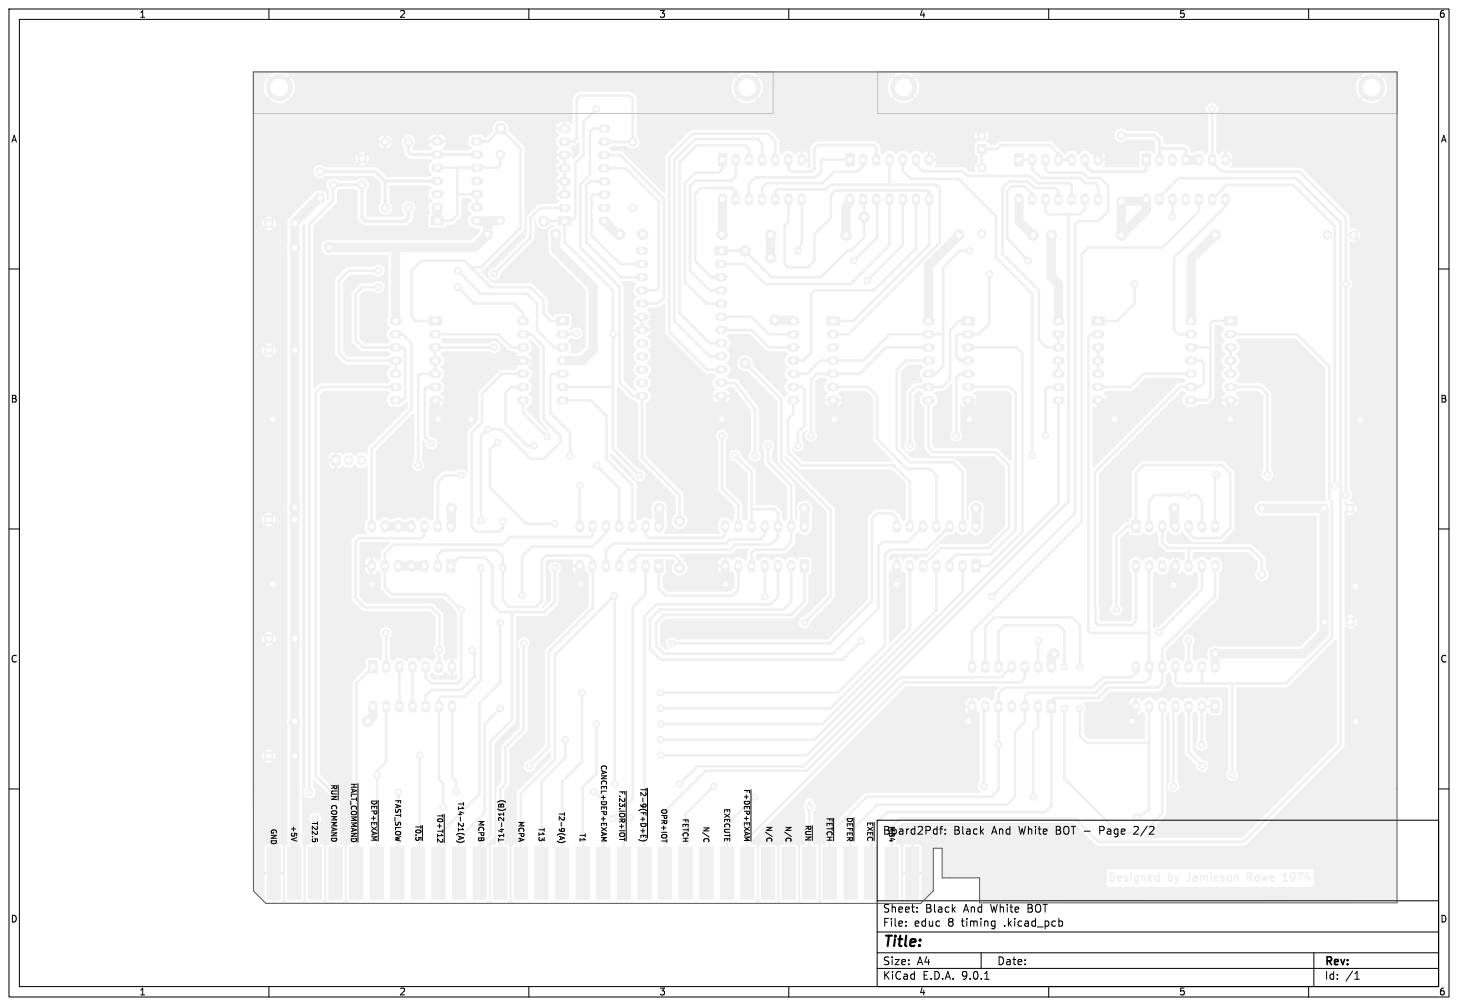
[picture p191: page 2]
Designed; by Jamieson; Rowe; ~{DEFER} N/C; MB4 FAST_SLOWGND; ~{F+DEP+EXAM} T2-9(A) ~{HALT_COMMAND}; ~{EXEC} T14-21(A) T22.5; FETCH OPR+IOT ~{F.23.IOR+IOT} T1; ~{FETCH} ~{RUN}COMMAND ⁺⁵V; ~{T2-9(F+D+E}) MCPA; EXECUTE ~{DEP+EXAM}; MCPB; ~{RUN} T14⁻21⁽B⁾; CANCEL+DEP+EXAM; D Date: KiCad; E.D.A. 9.0.1 Size: A4; Rev:; Id: /1 Title: File: educ 8 timing .kicad_pcb Sheet: Black; And; White; BOT Board2Pdf:; Black; BOT -; Page 2/2
