ibm2030/EDUC8/motherboard/rear panel loom/rear panel wiring looms/rear panel wiring looms.pdf

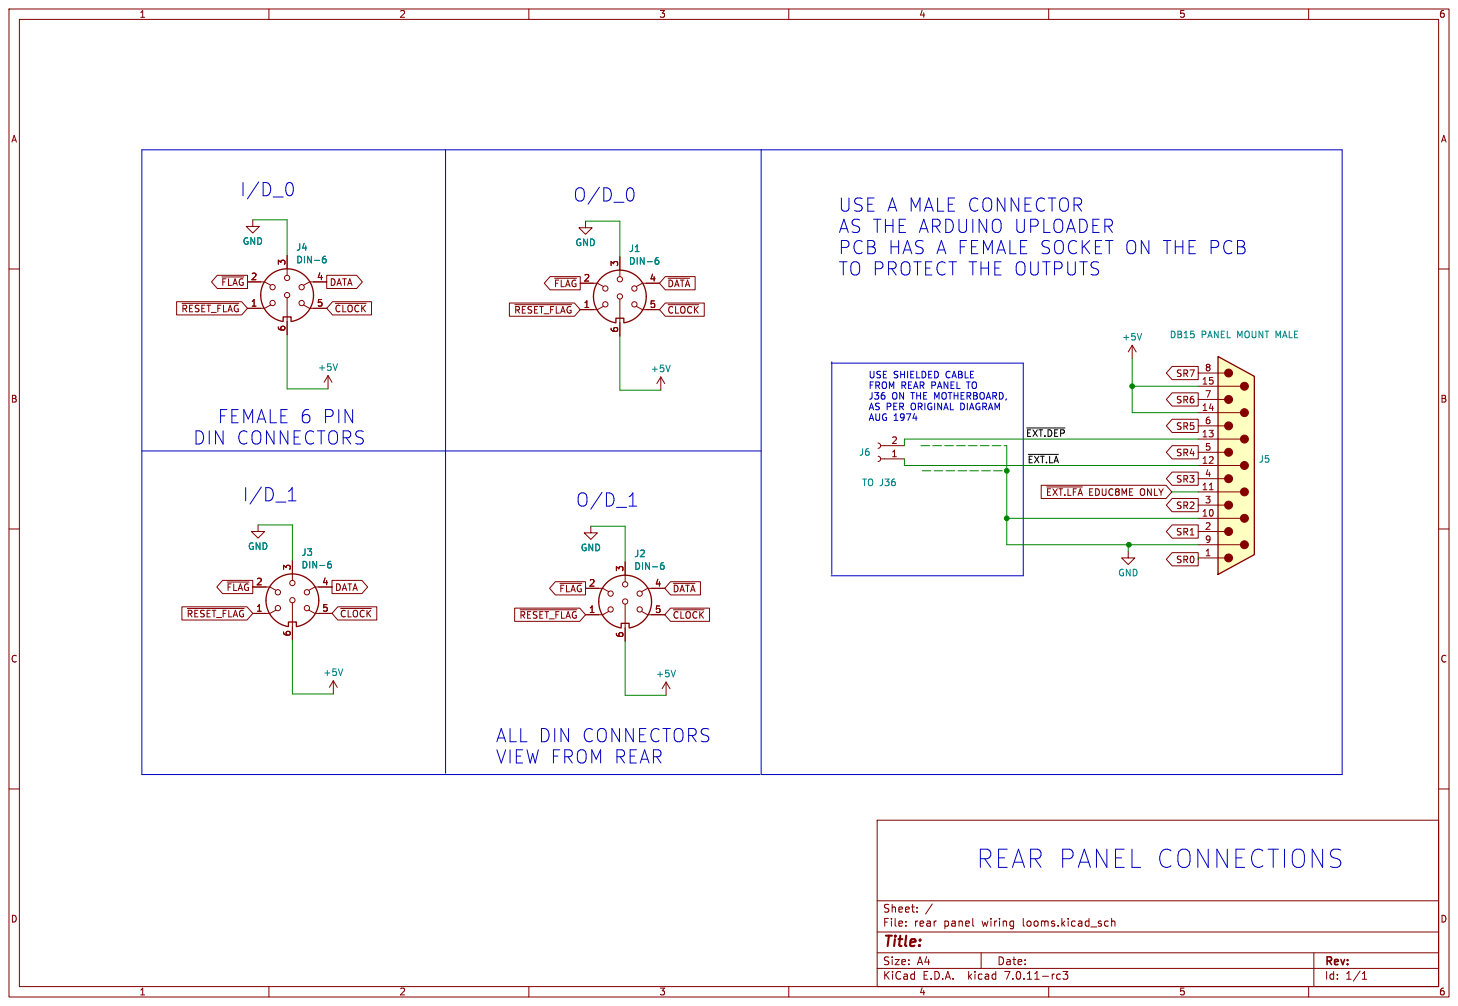
[picture p192: page 1]

USE A MALE CONNECTOR
AS THE ARDUINO UPLOADER
TO PROTECT THE OUTPUTS

J5 DB15 PANEL MOUNT MALE GND

USE SHIELDED CABLE
FROM REAR PANEL TO
J36 ON THE MOTHERBOARD, AS PER ORIGINAL DIAGRAM
