ibm2030/EDUC8/128 X 16 RAM V5 FINAL/128 X 16 RAM V4 FINAL .pdf

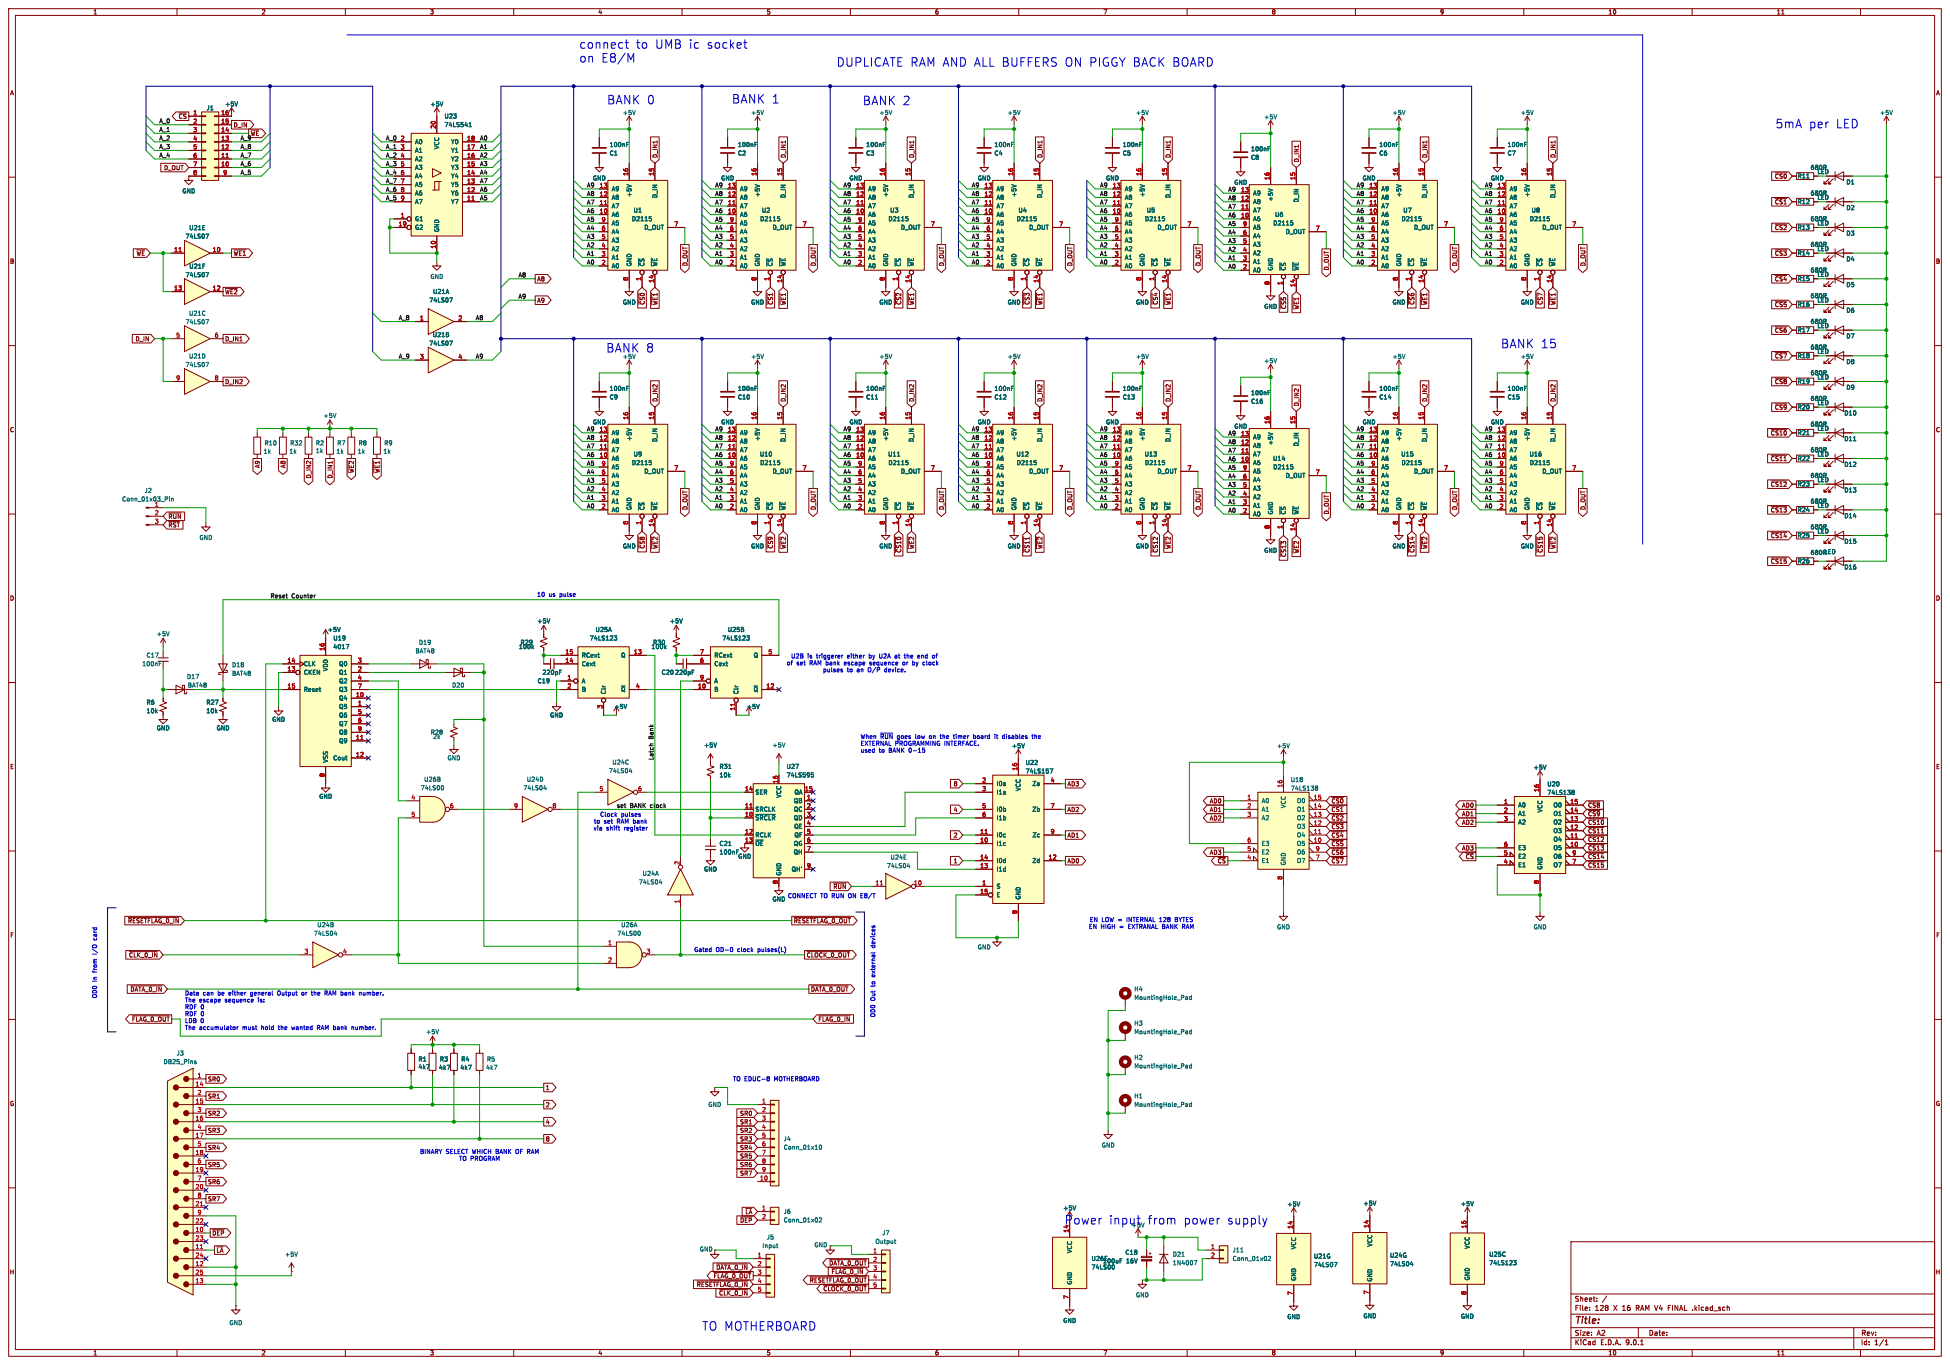
[picture p193: page 1]

connect to UMB ic socket

DUPLICATE RAM AND ALL BUFFERS ON PIGGY BACK BOARD

8 QA 15 QB 1 QC 2 QD 3 QE 4 QF 5 QG 6 QH 7 QH' 9 GND

8 Za 4 Zb 7 Zc 9 Zd 12 GND

set BANK clock
CONNECT TO RUN ON E8/T OD0 Out to external devices Clock pulses
to set RAM bank
via shift register

EN HIGH = EXTRANAL BANK RAM

Gated OD-0 clock pulses(L)

Data can be either general Output or the RAM bank number. The escape sequence is: RDF 0 RDF 0

BINARY SELECT WHICH BANK OF RAM

Power input from power supply
74LS00 VCC 14 GND
