ibm2030/EDUC8/Housing/main case.pdf

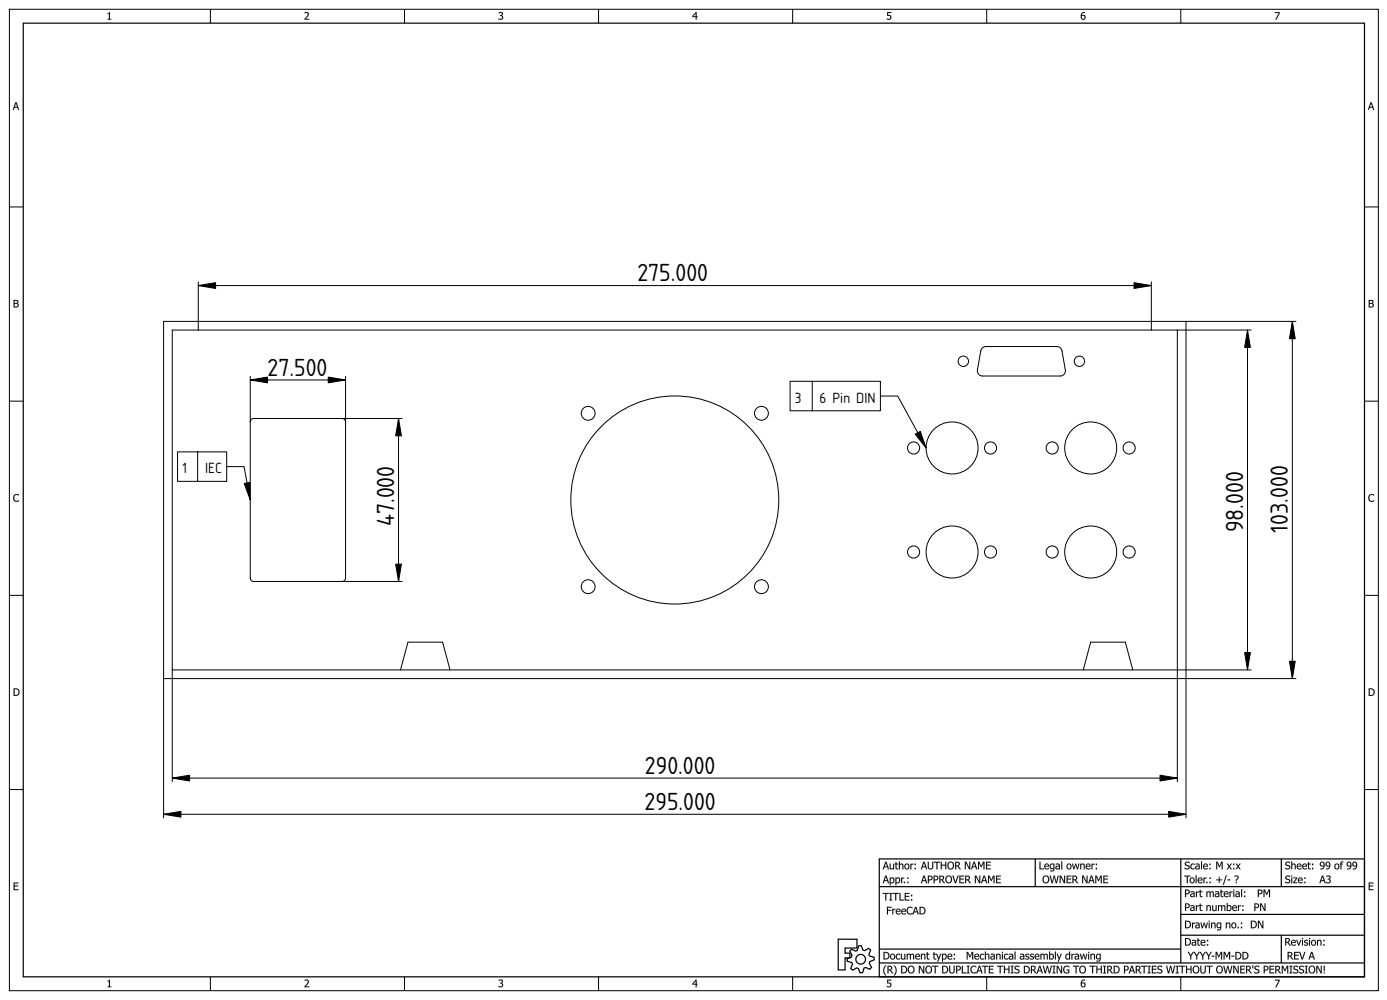
[picture p194: page 1]
DIN 1; IEC

3 | 6 Pin
