ibm2030/EDUC8/256 word memory/256 word memory.pdf

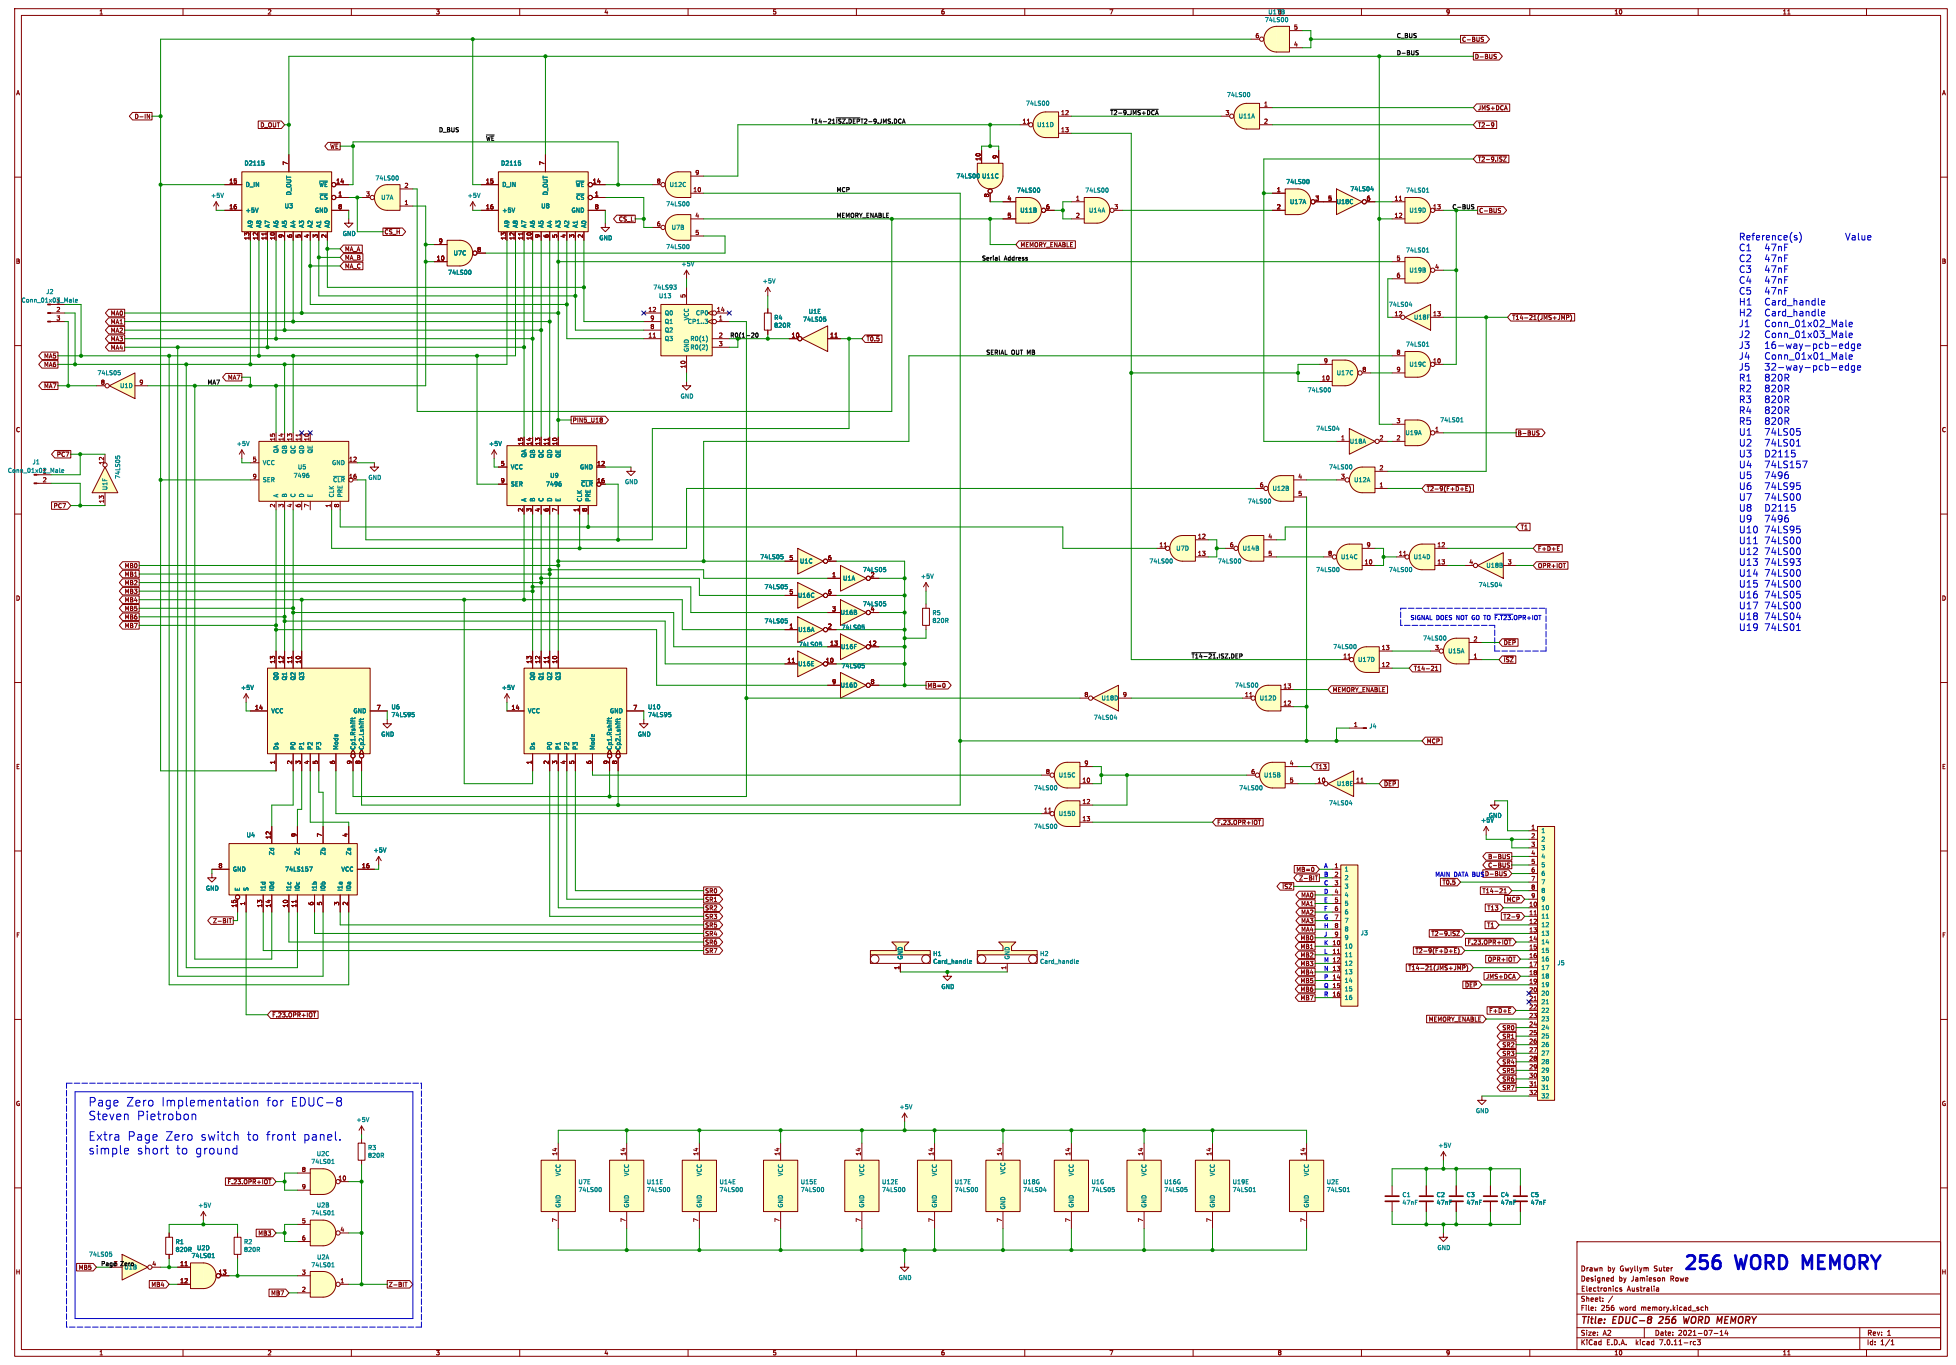
[picture p195: page 1]

T14-21~{ISZ.DEP}T2-9.JMS.DCA MEMORY_ENABLE

1 QE 10 QD 11 GND 12 QC 13 QB 14 QA 15

6 GND 7 Cp2.Lshift 8 Cp1.Rshift 9 GND

L Extra Page Zero switch to front panel.

simple short to ground
