ibm2030/EDUC8/Accumulator/Accumulator.pdf

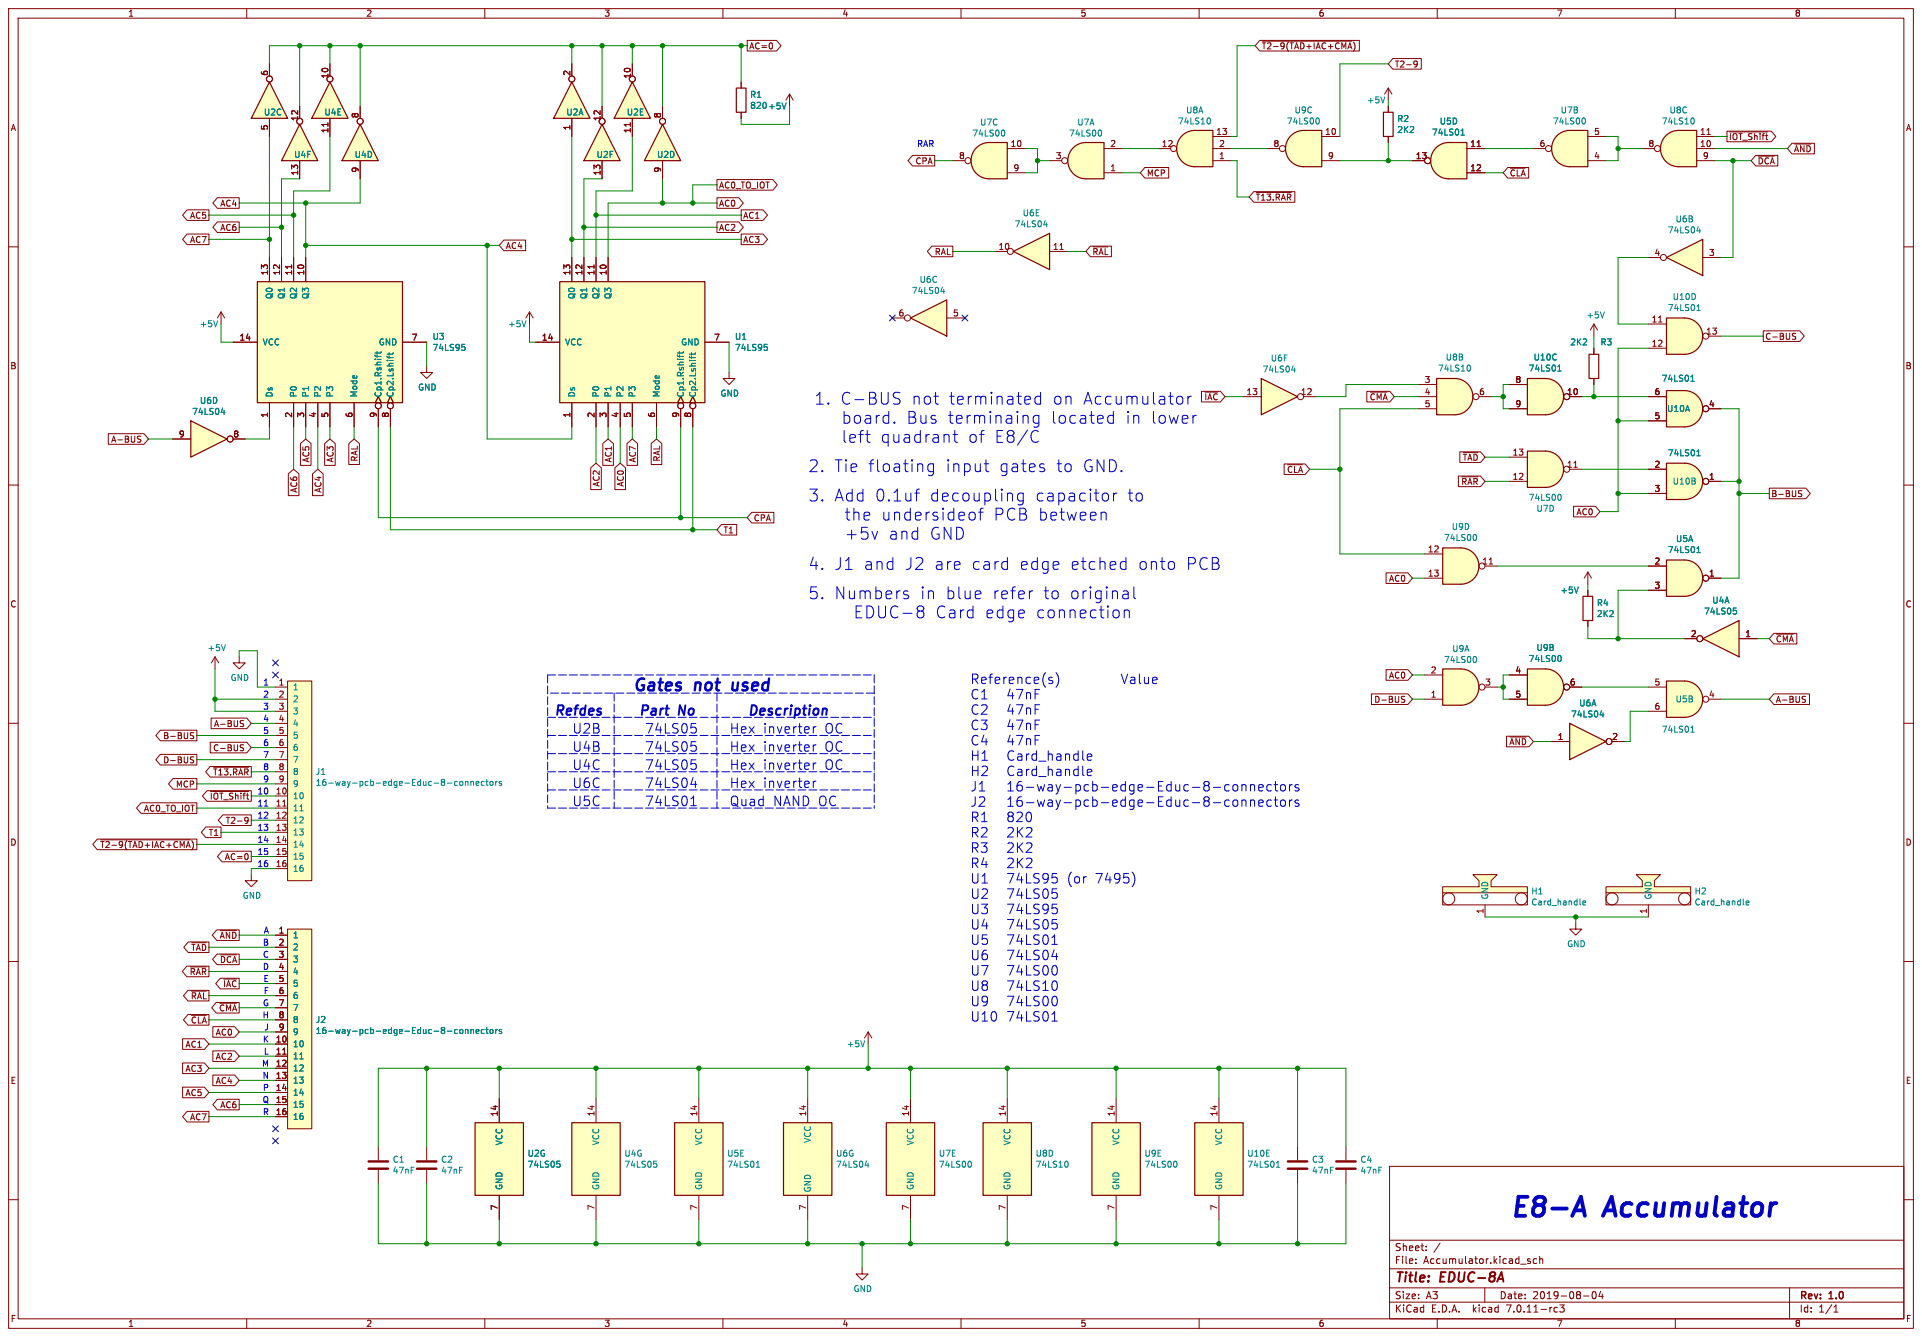
[picture p196: page 1]

6 GND 7 Cp2.Lshift 8 Cp1.Rshift 9 GND

EDUC-8 Card edge connection
