ibm2030/EDUC8/motherboard/motherboard.pdf

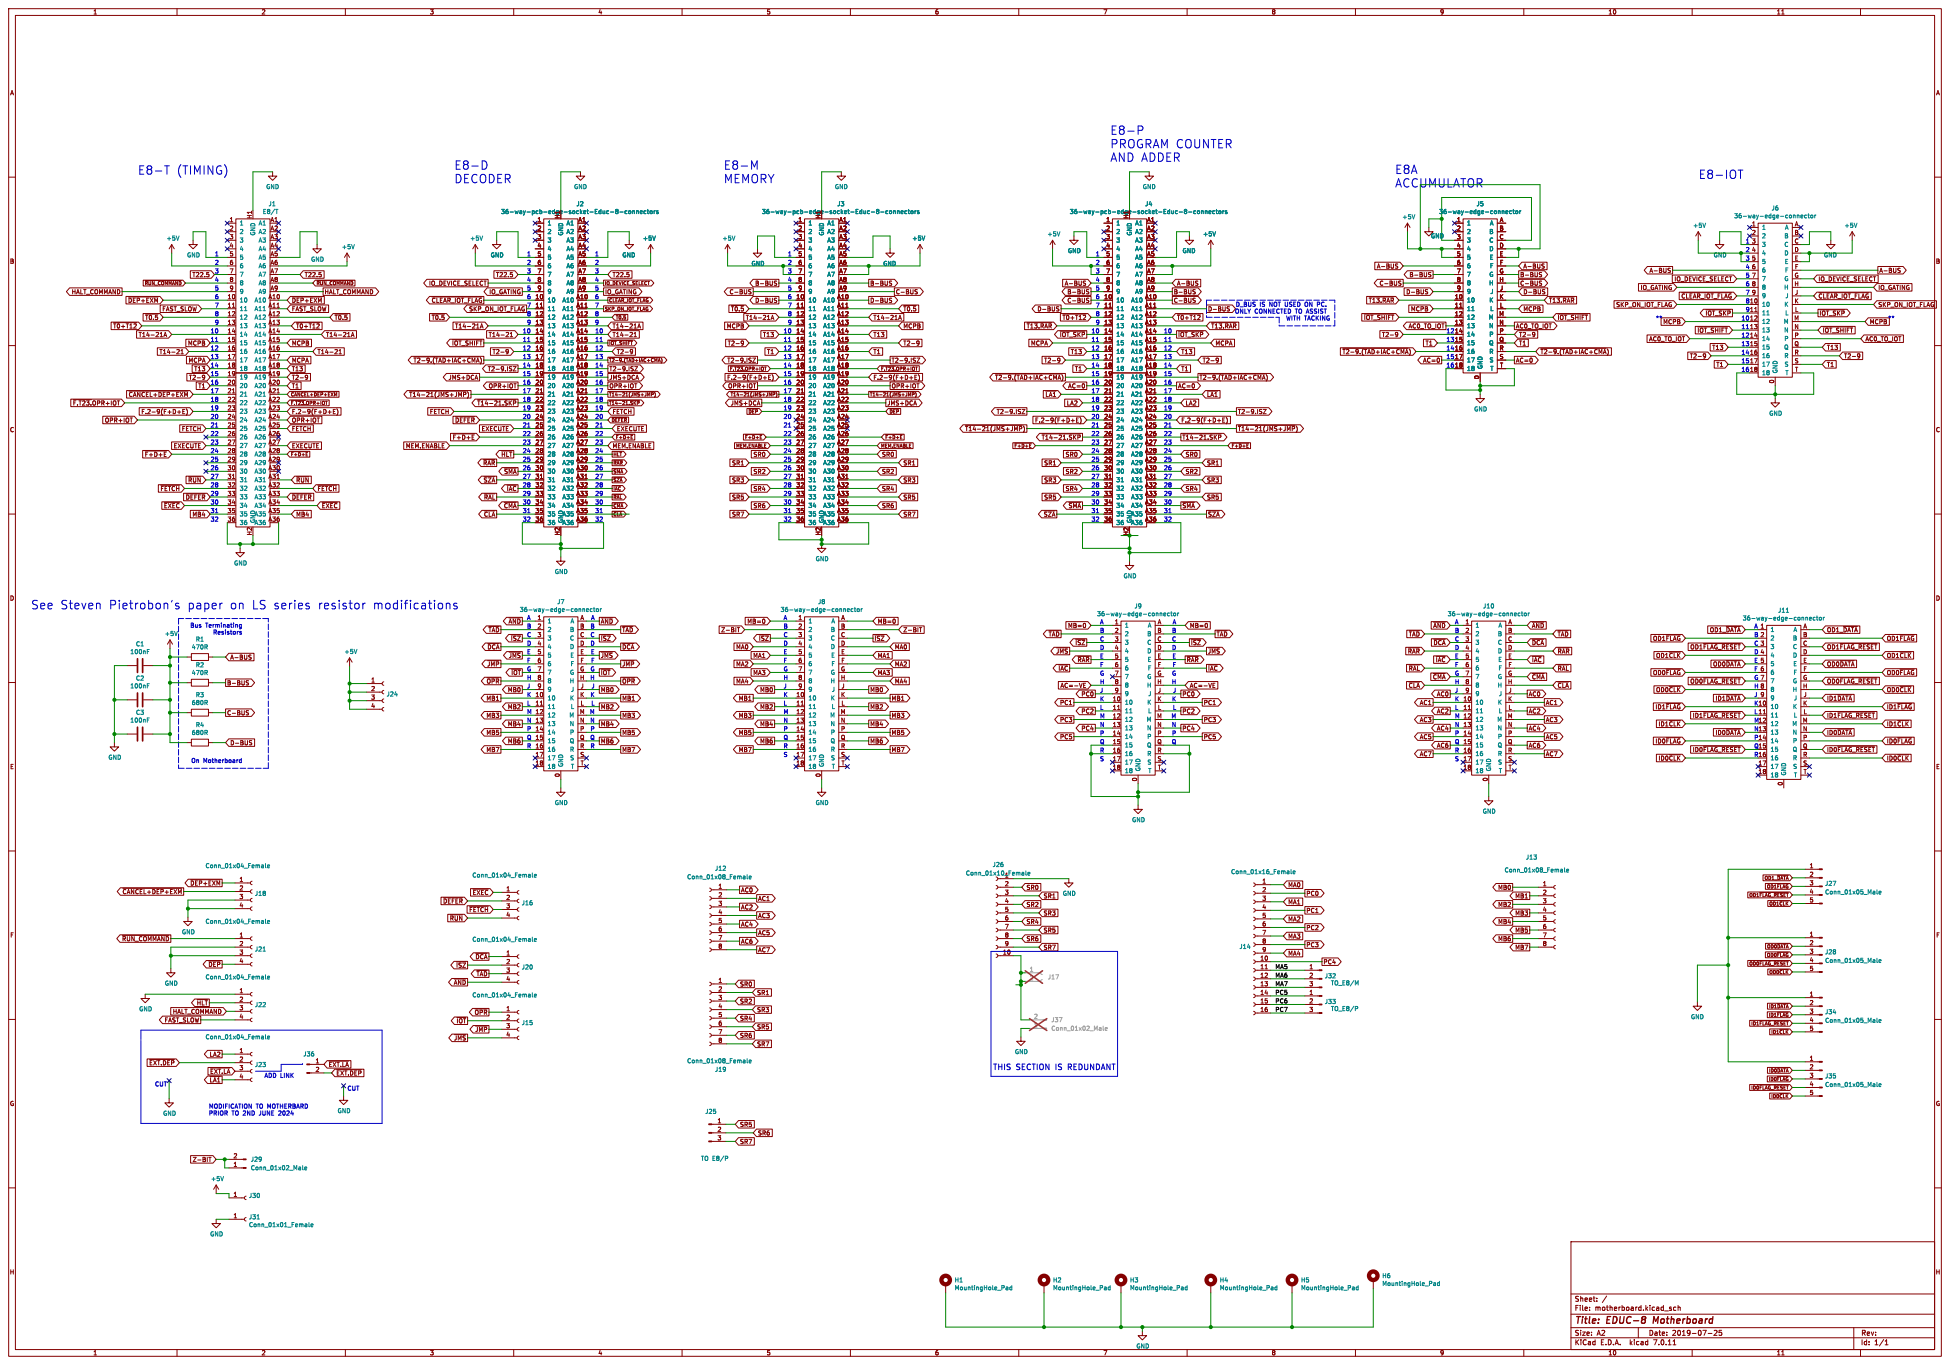
[picture p197: page 1]

36-way-edge-connector GND

36-way-pcb-edge-socket-Educ-8-connectors 1

D_BUS IS NOT USED ON PC. ONLY CONNECTED TO ASSIST WITH TACKING

T1 ~{ISZ} MB=0
~{T14-21(JMS+JMP}) SR3 SR1 MEM.ENABLE
JMS+DCA
~{DEP}

~{T2-9.(TAD+IAC+CMA}) AC=0 T1

~{T14-21(JMS+JMP}) OPR+IOT

MB=0 ~{CANCEL+DEP+EXM}

THIS SECTION IS REDUNDANT
