ibm2030/EDUC8/PC and ADDER 74LS74 MOD/PC and ADDER 74LS74 MOD.pdf

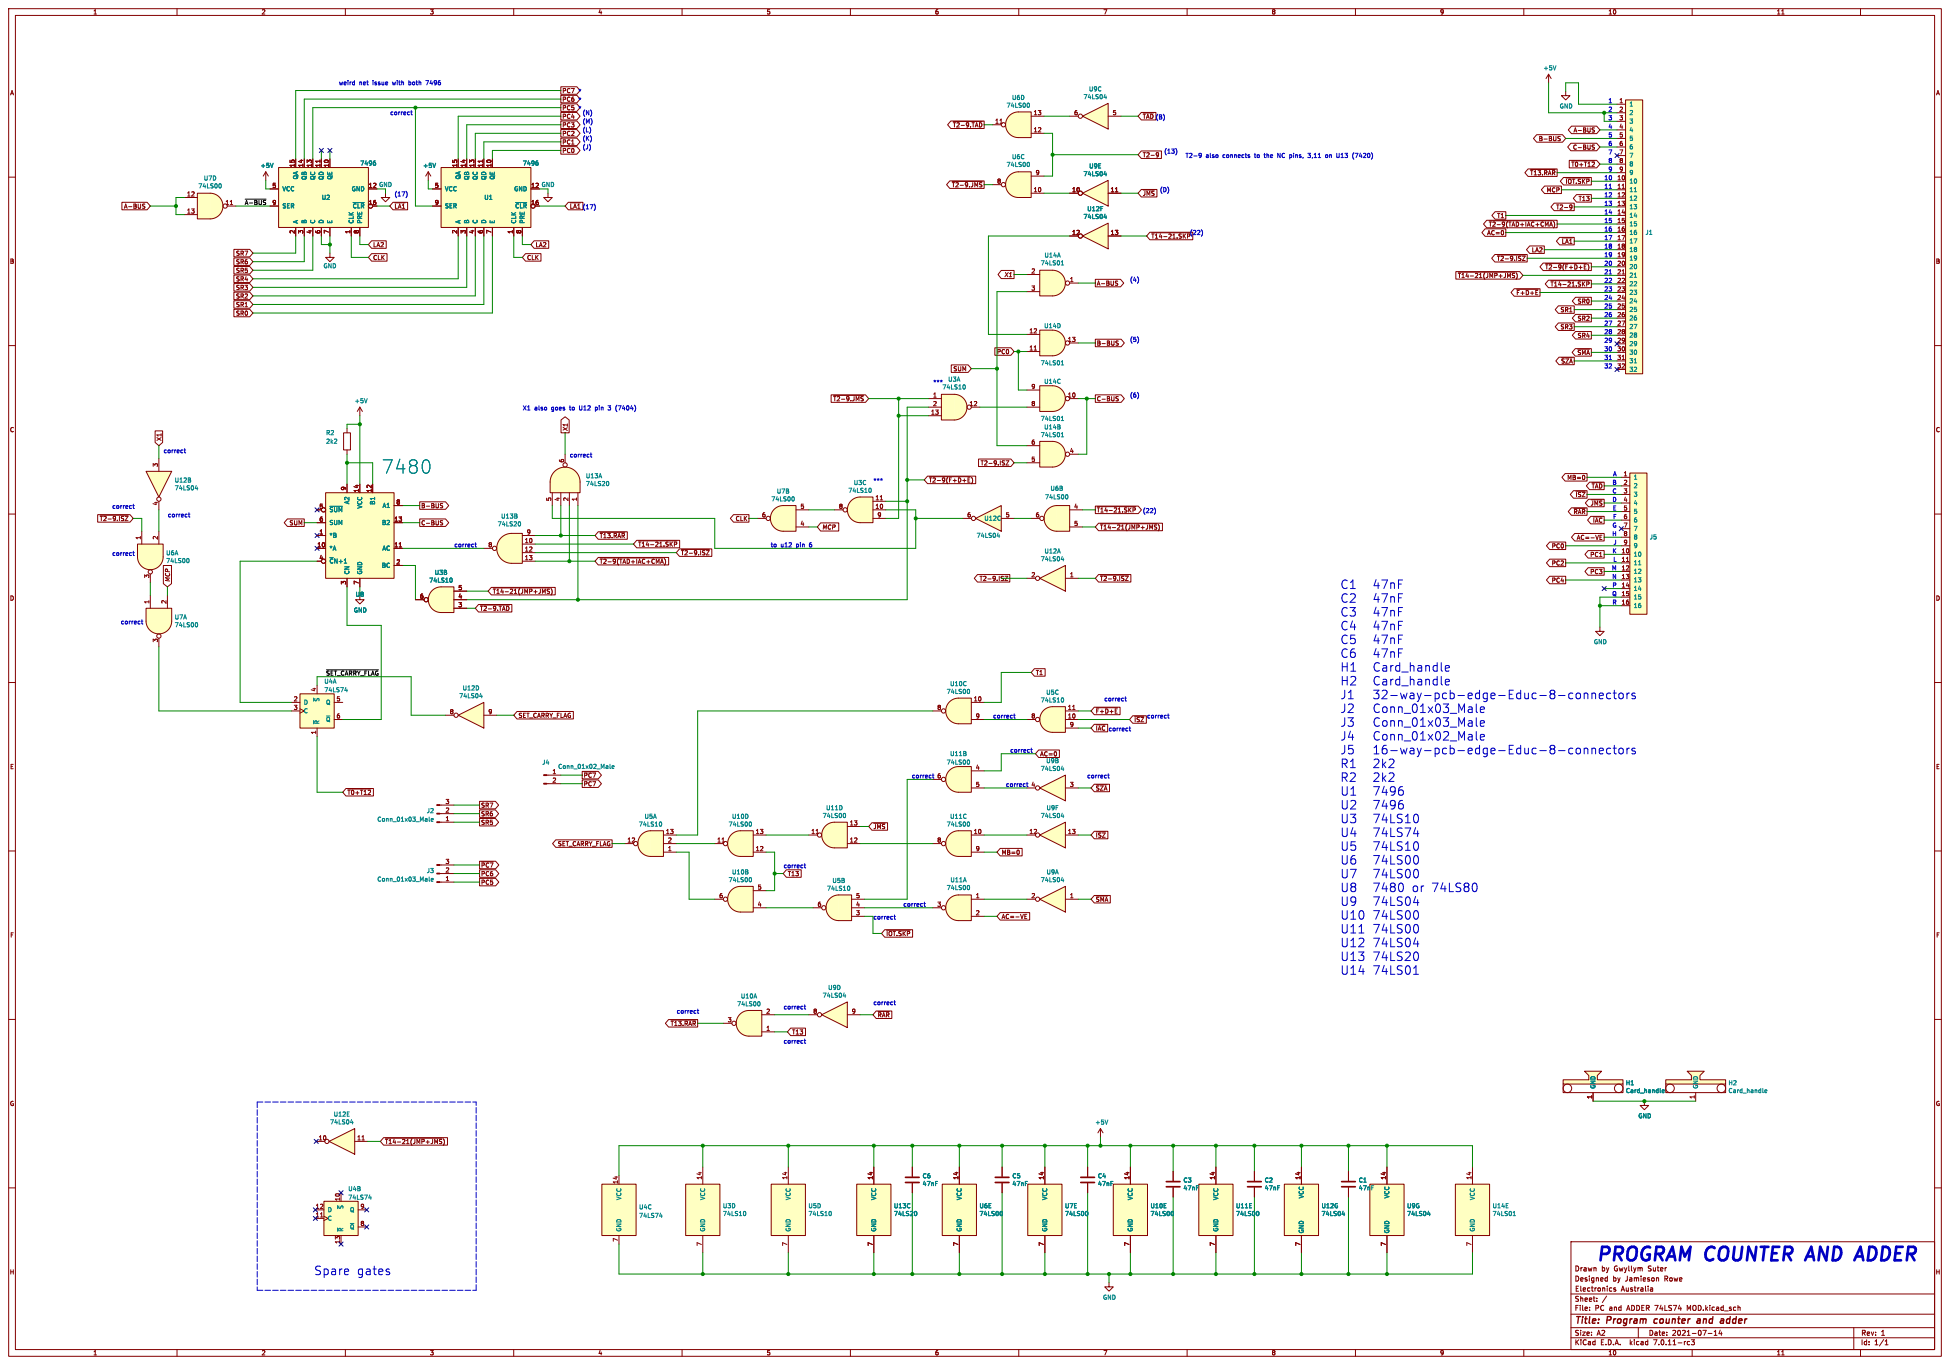
[picture p198: page 1]

weird net issue with both 7496

1 QE 10 QD 11 GND 12 QC 13 QB 14 QA 15

PROGRAM COUNTER AND ADDER
