ibm2030/EDUC8/Timing/educ 8 timing .pdf

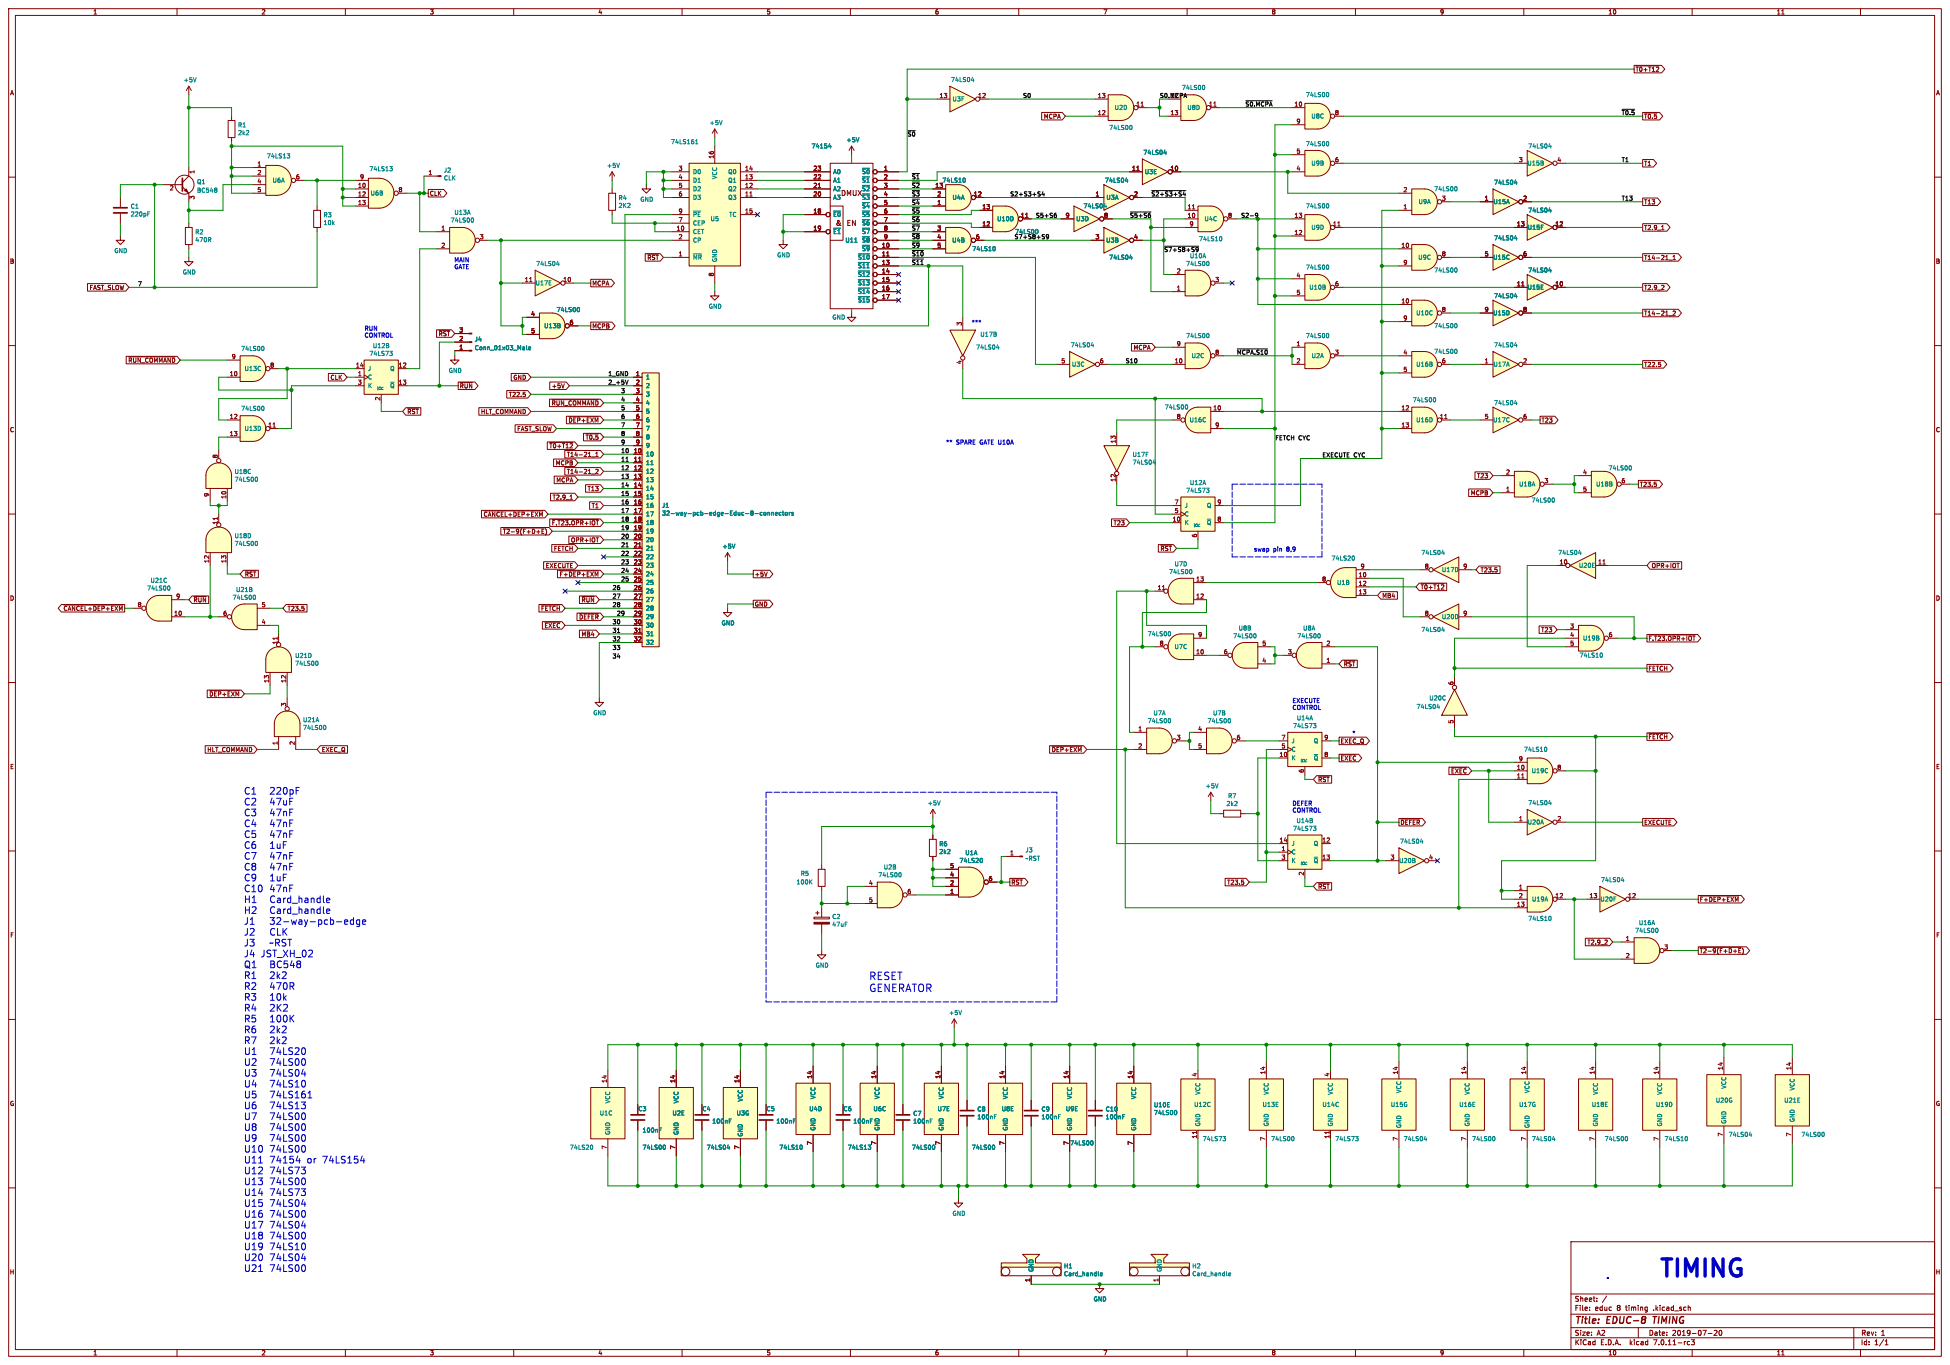
[picture p199: page 1]

T23 ~{DEFER} MB4 ~{FETCH} FETCHOPR+IOT

32-way-pcb-edge-Educ-8-connectors

File: educ 8 timing .kicad_sch Sheet: /
