ibm2030/EDUC8/Decoder/educ 8 decoder.pdf

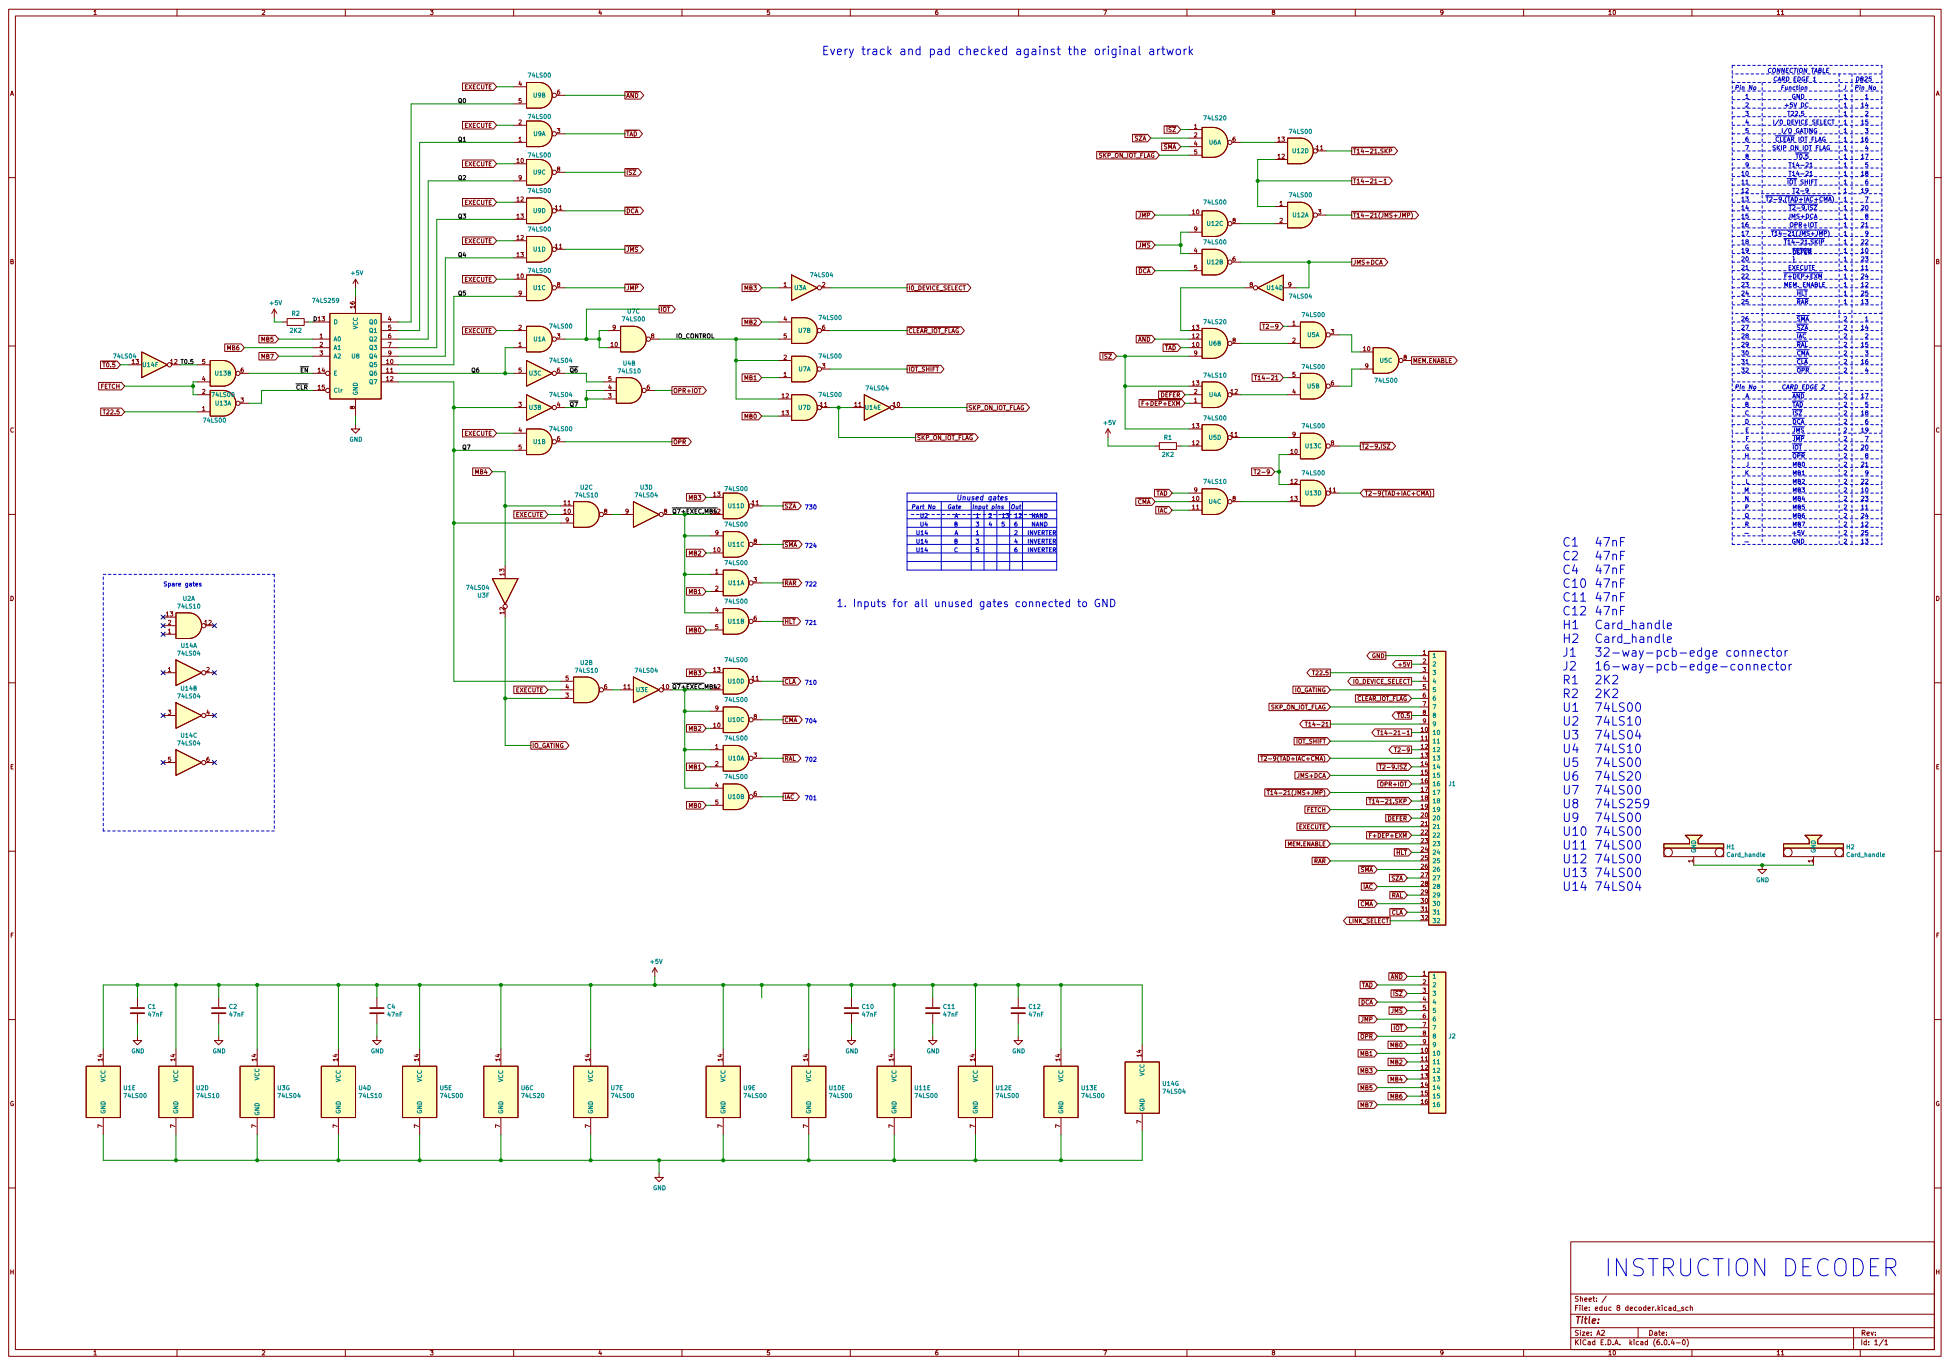
[picture p200: page 1]

1 Every track and pad checked against the original artwork

I/O GATING | 1 CONNECTION TABLE 1 | 3
6 3 | T14-21 Function | | 5 Pin No 2
2 | | 1 GND | 14
4 | I/0 DEVICE SELECT | 1 T22.5 ~{T0.5} 1

8 | EXECUTE CARD EDGE 1 ~{CLEAR} IOT FLAG | 1 | 16
Pin No
1 ~{F+DEP+EXM} 1 | 24 ~{T14-21(JMS+JMP}) 1 17
11 | ~{IAC} T14-21 +5V DC ~{IOT} SHIFT | 1 | 6

7 | SKIP ON IOT FLAG | 1 | 15 T2-9
5P 20 | | | 23

10 | | 1 | 18
2 | 8 MB0 FETCH 1

1 U2 1. Inputs for all unused gates connected to GND

12 | | | 19
13 | | 1 | 7
14 | | 1 | 20
15 | JMS+DCA | | 8
16 | OPR+IOT | 1 | 21

17 | | 1 ~{T2-9.ISZ} 1 1 | 9

25 | | 1 | 22 Pin No C
19 | ~{DEFER | | 10
} 26 ~{RAR}
21 | | 1
22 | ~{HLT} | 1 | 12
24 | ~{SMA} 23 | 1 | 13 MEM. ENABLE 25

27 | ~{SZA} | | 14

31D | ~{DCA} F ~{JMP} 30 | 2 ~{OPR} CARD EDGE 2

~{JMS} | 2 | 19

2 | 20

þÿ  KHG | | 2 | 9

~{IOT} | 2 2

~{T2-9(TAD+IAC+CMA}) FETCH

File: educ 8 decoder.kicad_sch Sheet: /
