ibm2030/EDUC8/program counter and adder logic/program counter and adder logic.pdf

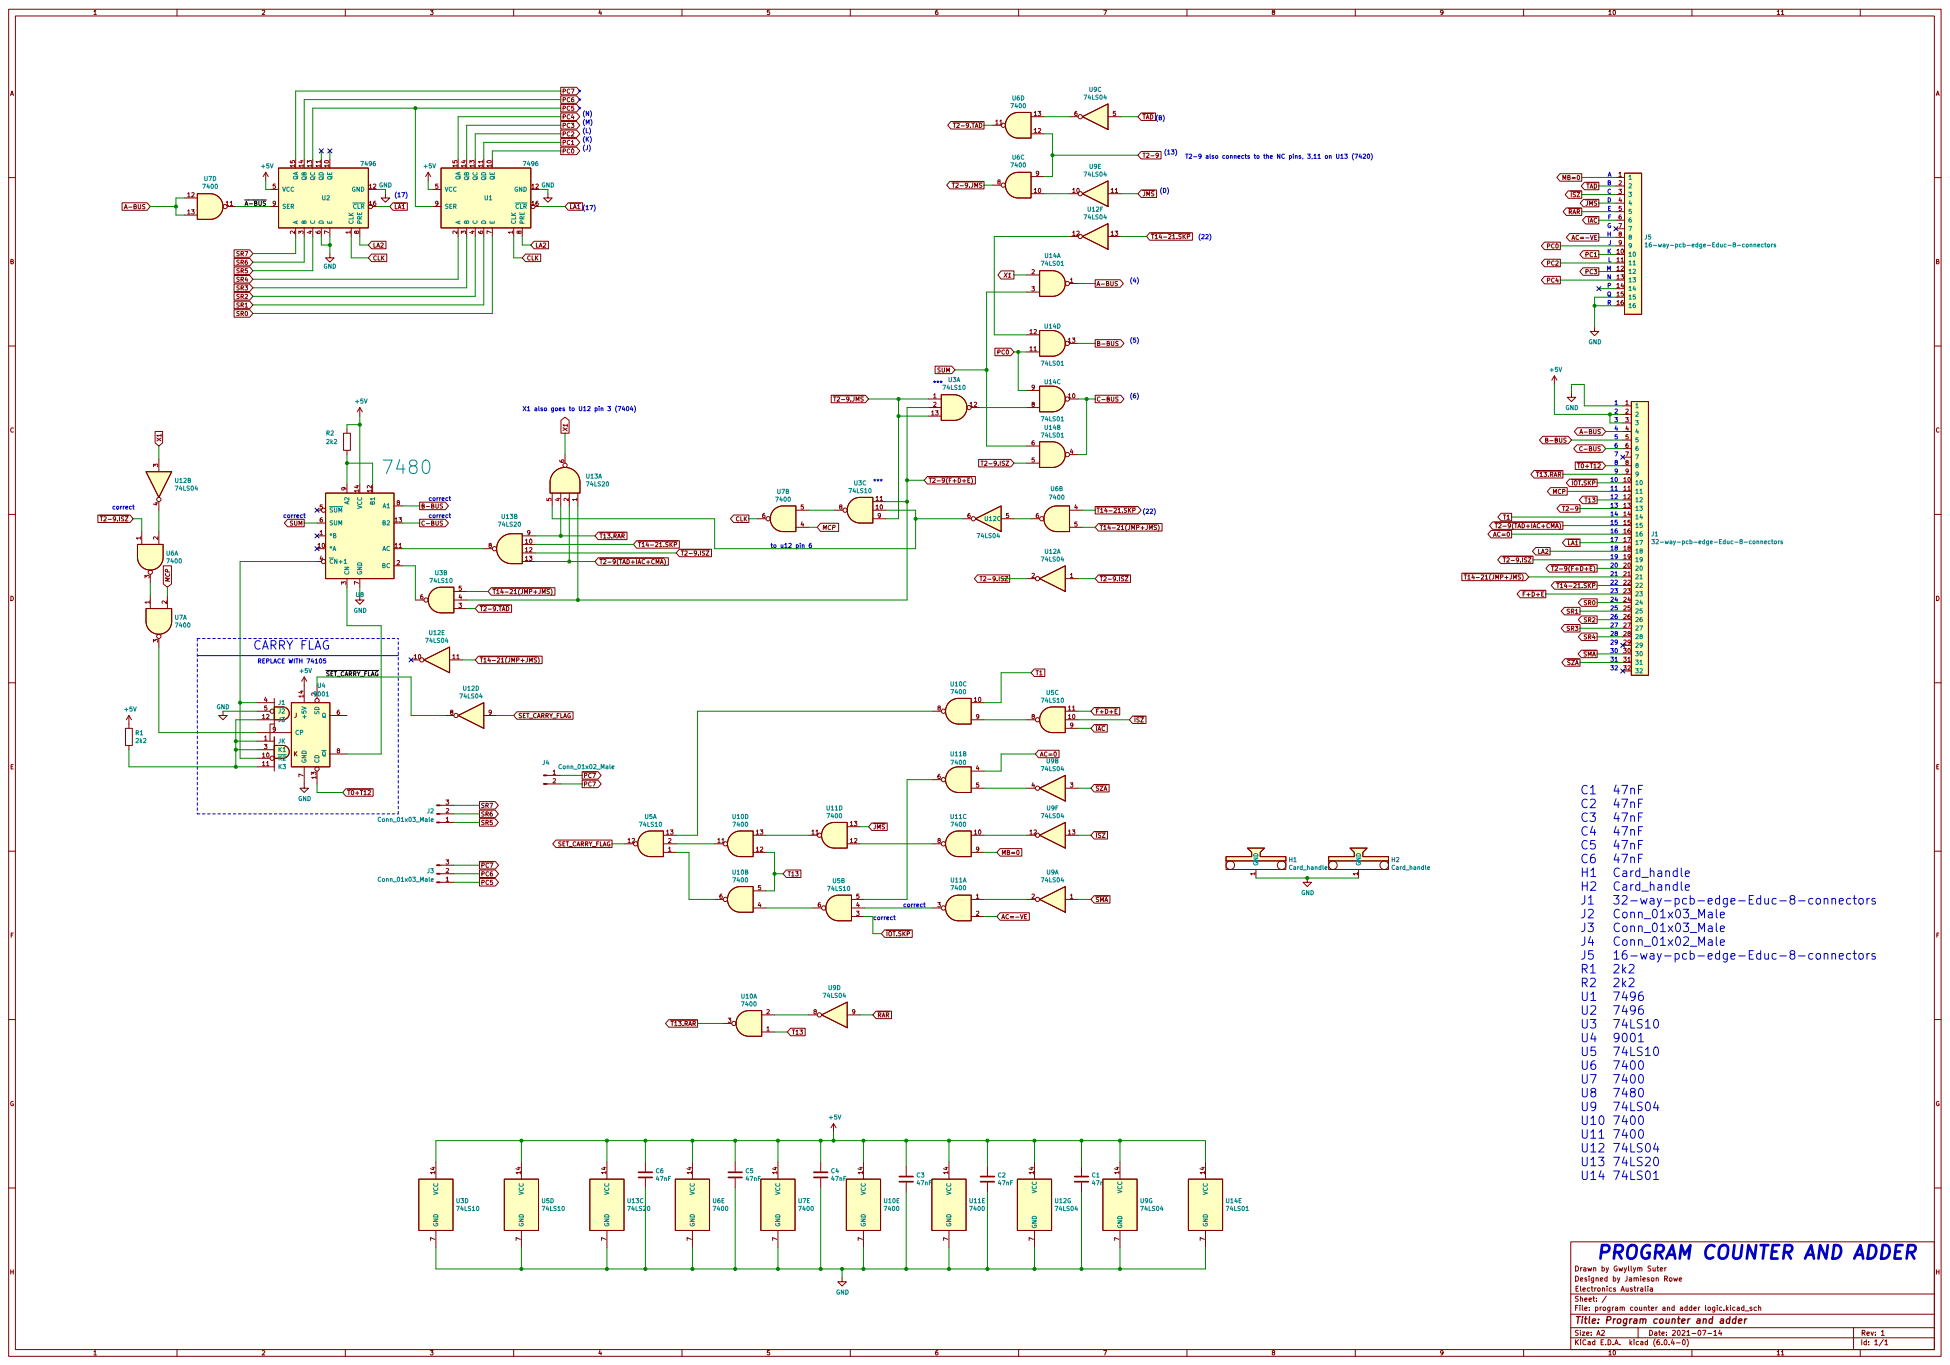
[picture p201: page 1]

T2-9 also connects to the NC pins, 3,11 on U13 (7420)

1 QE 10 QD 11 GND 12 QC 13 QB 14 QA 15

16-way-pcb-edge-Educ-8-connectors VCC 14 GND

32-way-pcb-edge-Educ-8-connectors VCC 14 GND

PROGRAM COUNTER AND ADDER

Drawn by Gwyllym Suter
File: program counter and adder logic.kicad_sch Sheet: / Electronics Australia Designed by Jamieson Rowe

Id: 1/1 Title: Program counter and adder
