ibm2030/EDUC8/Power Supply 2/EDUC-8 PSU.pdf

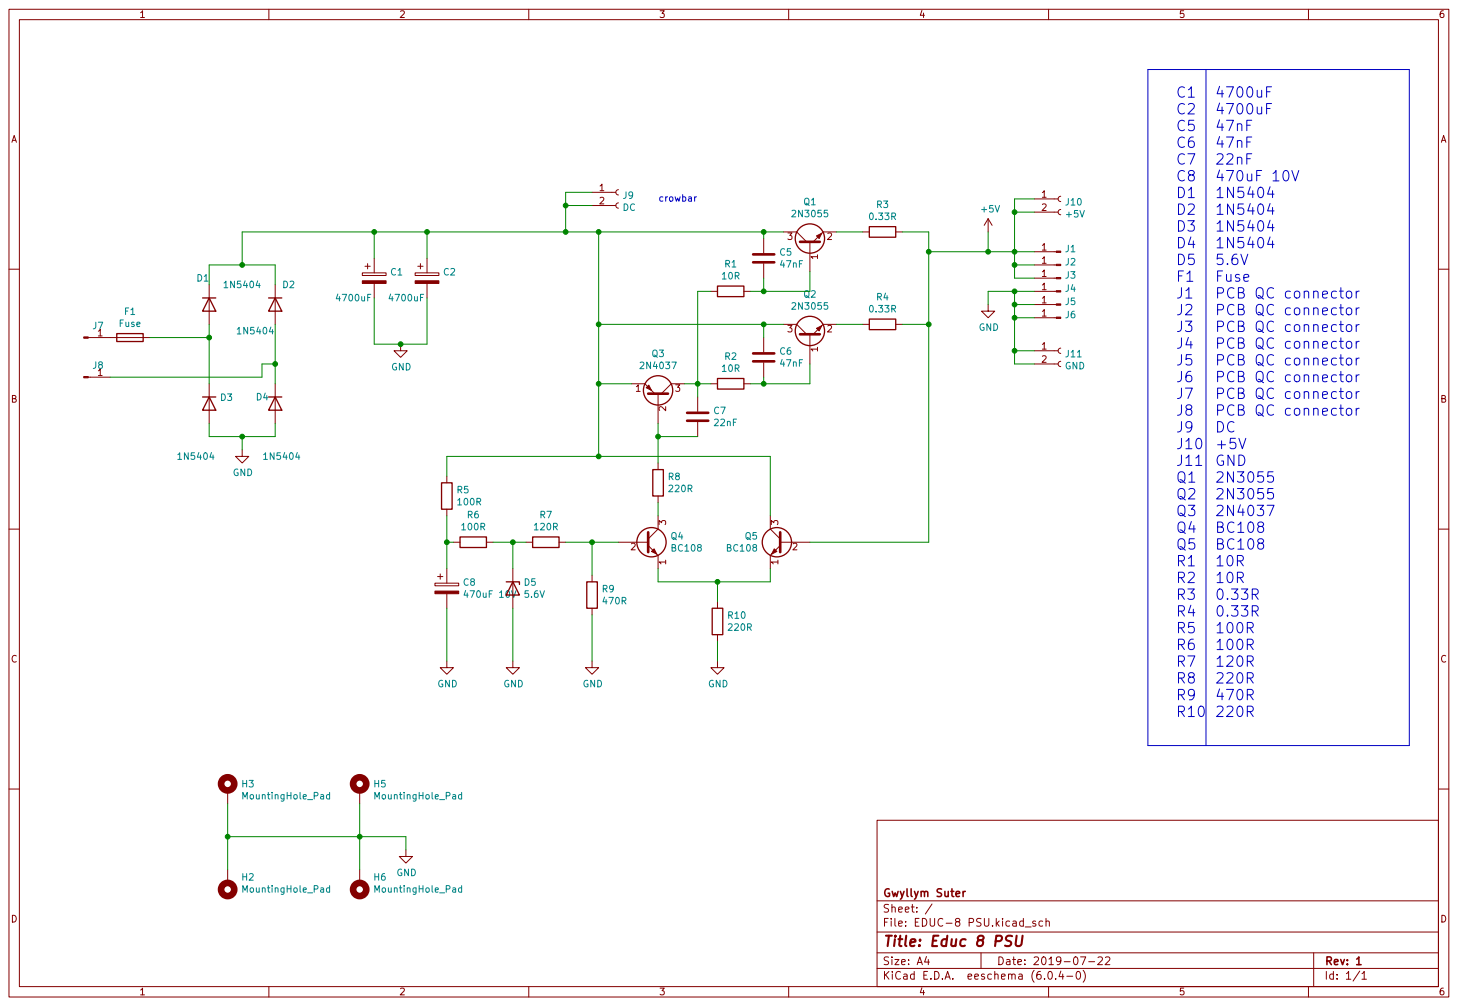
[picture p202: page 1]

File: EDUC-8 PSU.kicad_sch Sheet: / Gwyllym Suter

Id: 1/1 Title: Educ 8 PSU
