ibm2030/EDUC8/motherboard/motherboard 2.0.pdf

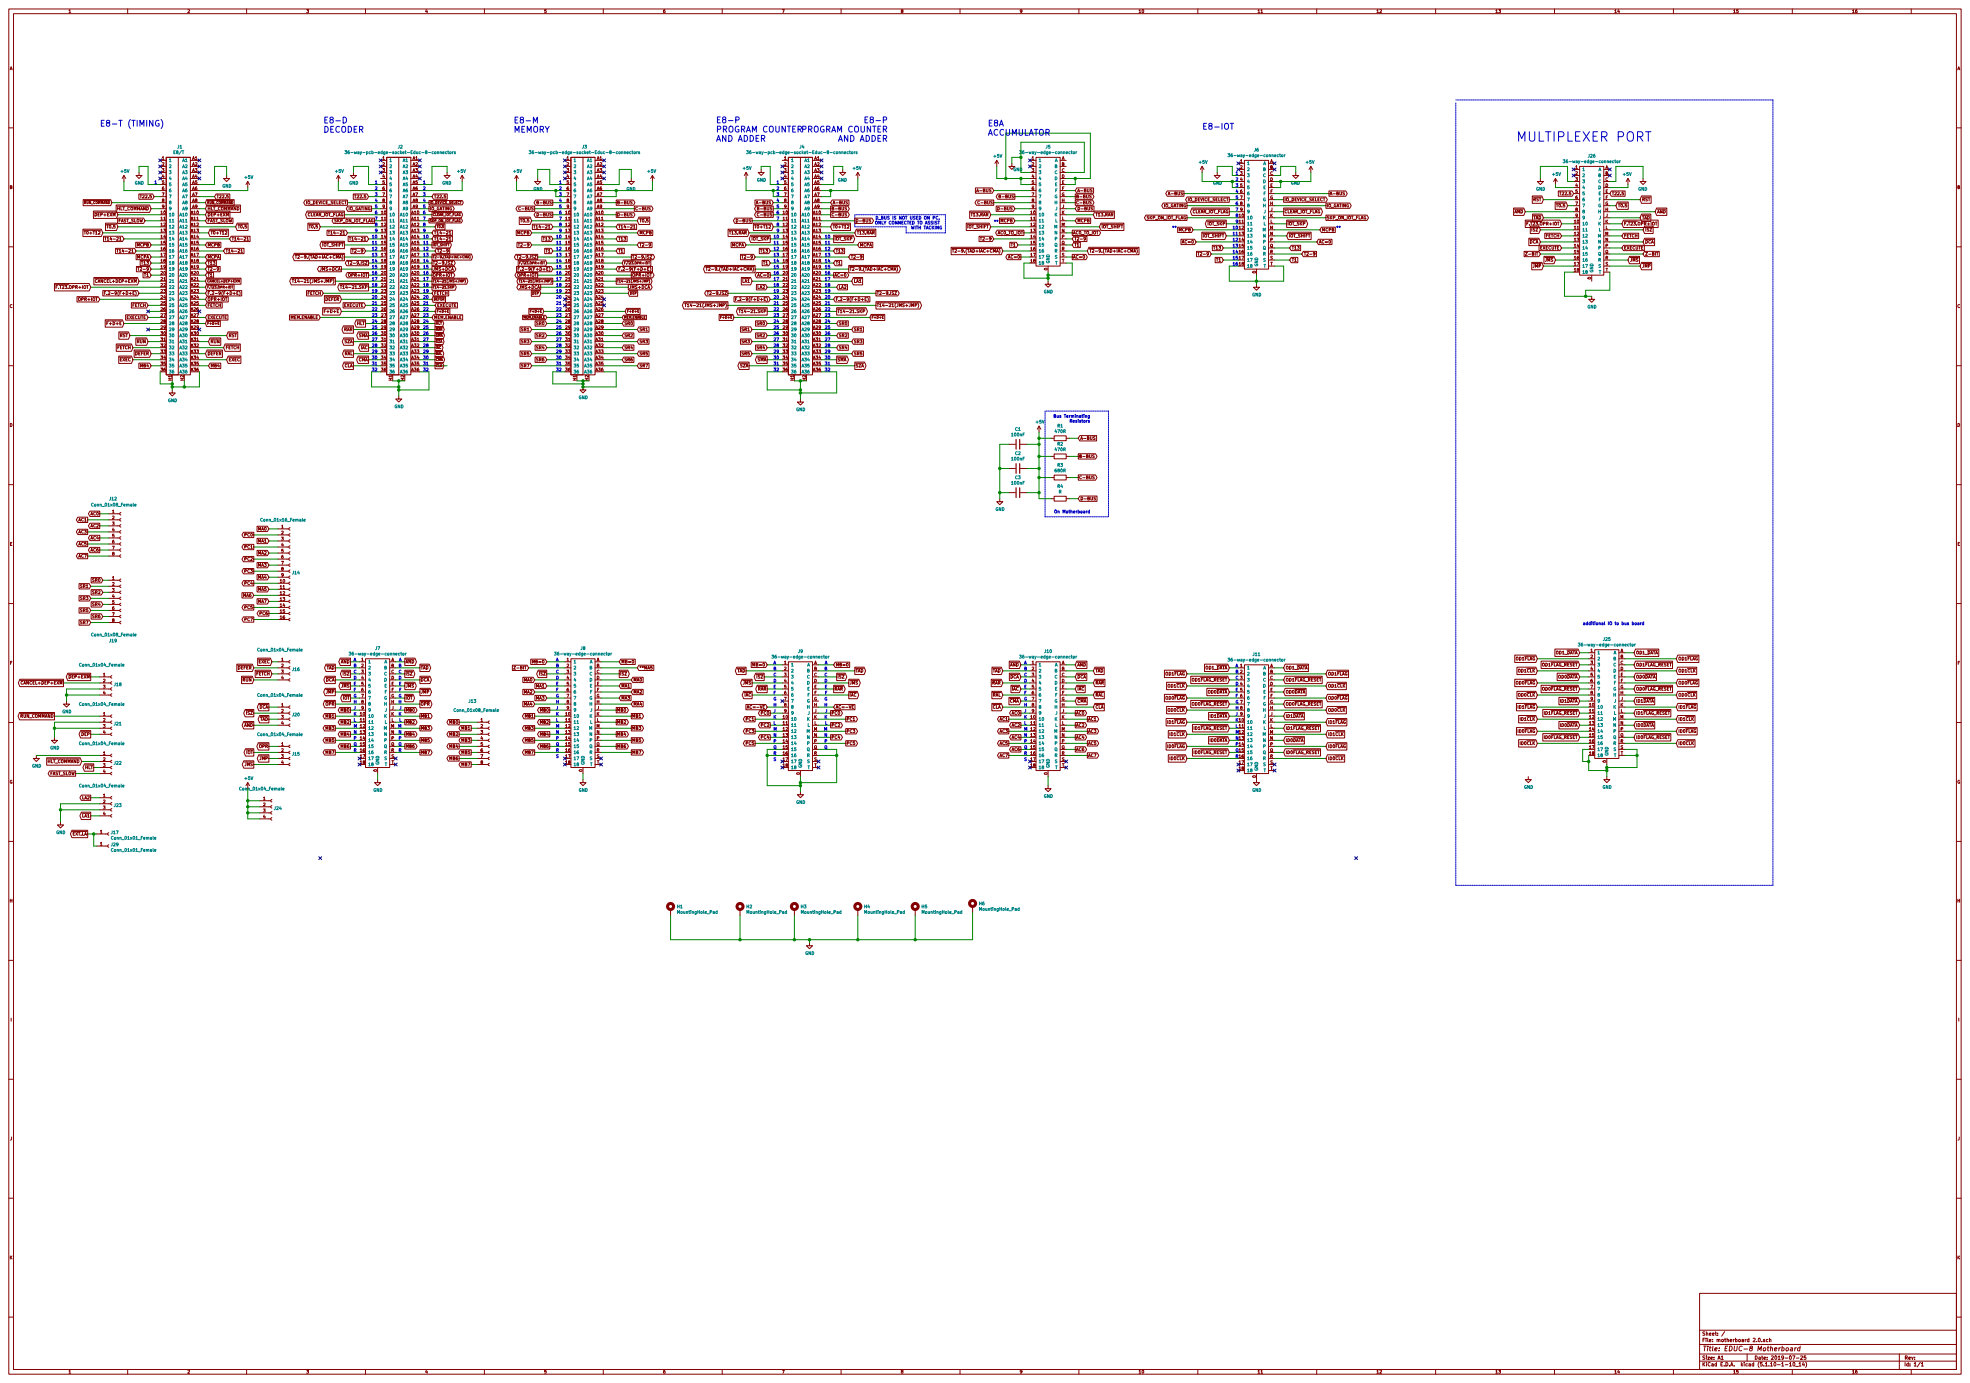
[picture p203: page 1]

36-way-pcb-edge-socket-Educ-8-connectors 1

36-way-pcb-edge-socket-Educ-8-connectors +5V

D_BUS IS NOT USED ON PC. ONLY CONNECTED TO ASSIST WITH TACKING

T14-21(JMS+JMP) OPR+IOT

CANCEL+DEP+EXM
F.T23.OPR+IOT OPR+IOT

Bus Terminating Resistors On Motherboard G

additional IO to bus board D

File: motherboard 2.0.sch Sheet: /
Id: 1/1 Title: EDUC-8 Motherboard
