ibm2030/EDUC8/EXTENDER CARDS/EXTENDER CARDS.pdf

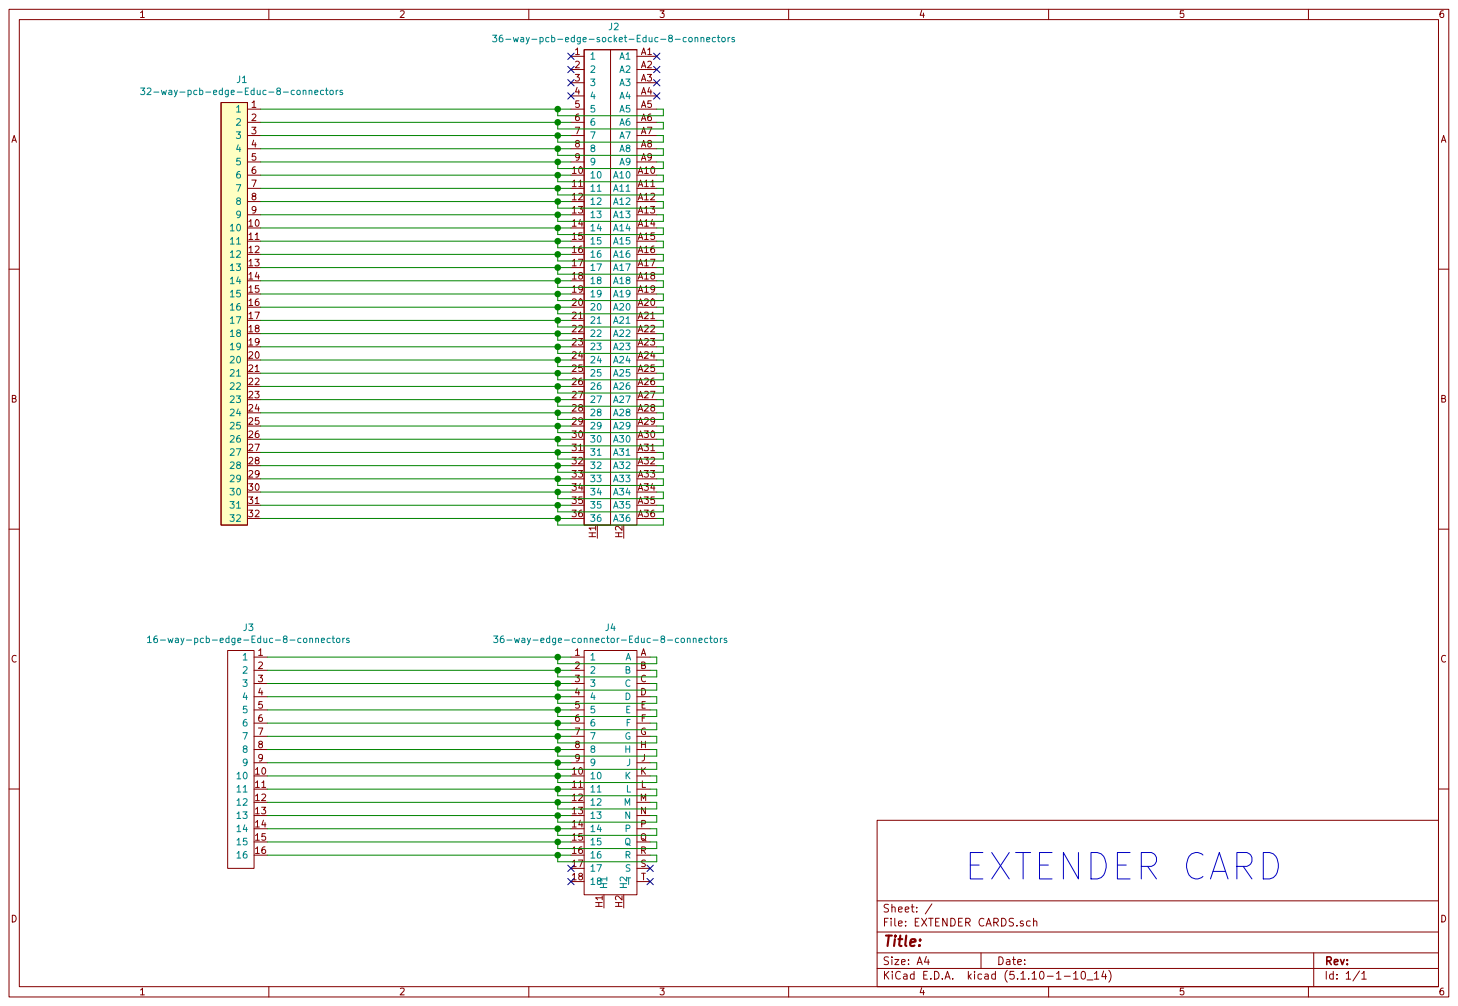
[picture p204: page 1]

Id: 1/1 Title: File: EXTENDER CARDS.sch Sheet: / 1 1

16-way-pcb-edge-Educ-8-connectors
