ibm2030/EDUC8/Buffer/e8me-b1.pdf

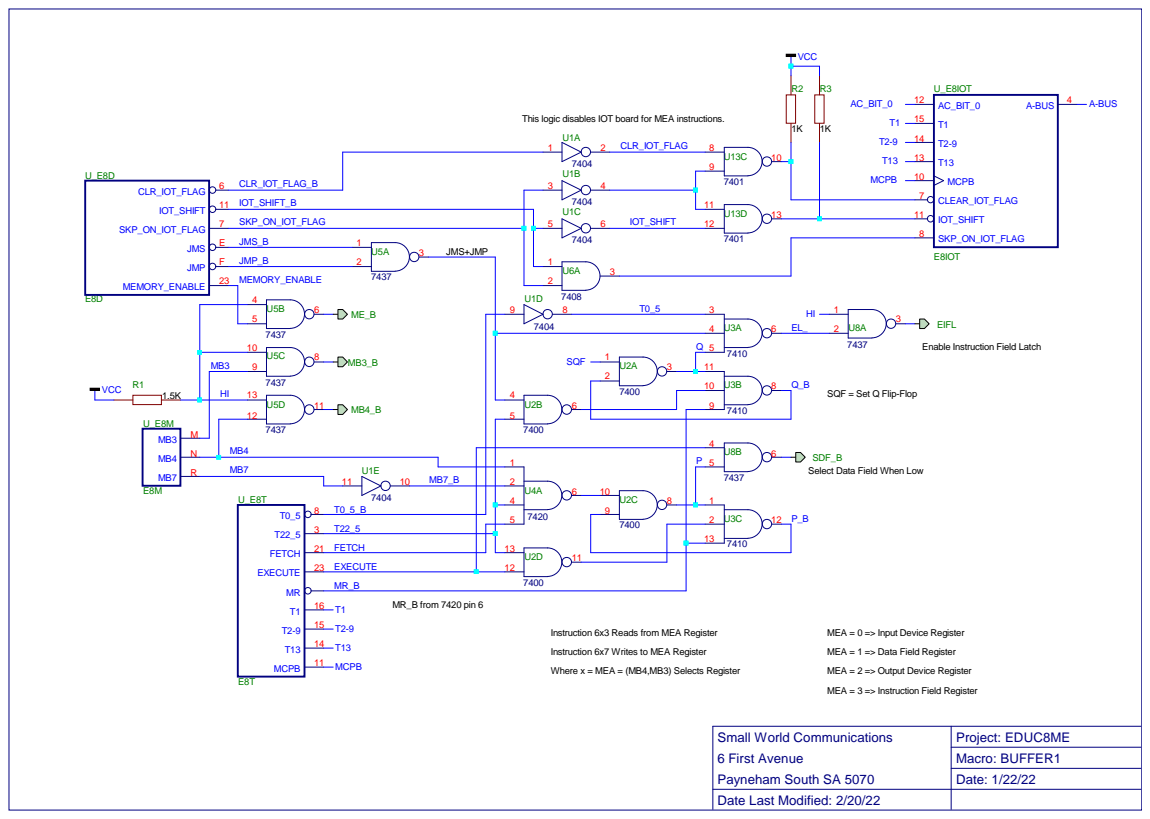
[picture p205: page 1]

This logic disables IOT board for MEA instructions.

Enable Instruction Field Latch

SQF = Set Q Flip-Flop

SDF_B
Select Data Field When Low

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

MEA = 0 => Input Device Register
MEA = 1 => Data Field Register
MEA = 2 => Output Device Register
MEA = 3 => Instruction Field Register
