ibm2030/EDUC8/Buffer/e8me-b2.pdf

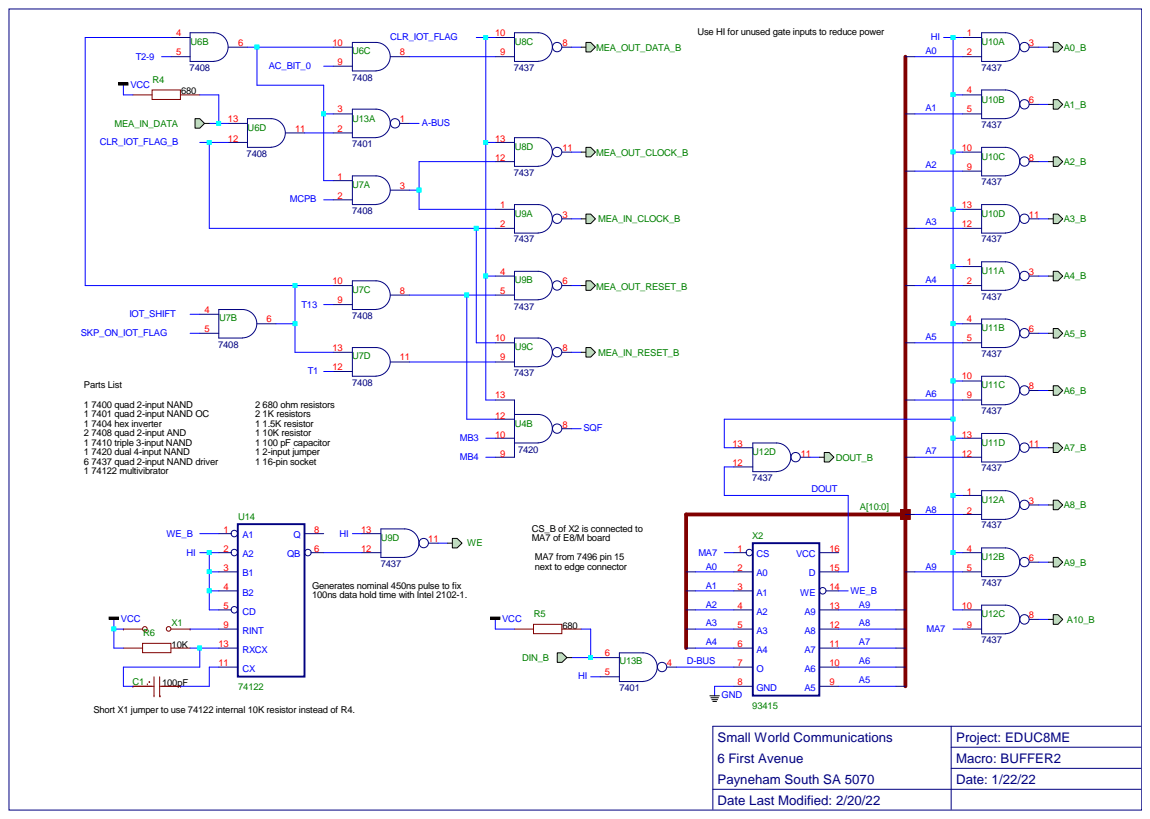
[picture p206: page 1]

Use HI for unused gate inputs to reduce power

Parts List
1 7400 quad 2-input NAND
1 7401 quad 2-input NAND OC
1 7404 hex inverter
2 7408 quad 2-input AND
1 7410 triple 3-input NAND
1 7420 dual 4-input NAND
6 7437 quad 2-input NAND driver
1 74122 multivibrator

CS_B of X2 is connected to
MA7 of E8/M board
MA7 from 7496 pin 15
next to edge connector

Generates nominal 450ns pulse to fix
100ns data hold time with Intel 2102-1.

Short X1 jumper to use 74122 internal 10K resistor instead of R4.
