ibm2030/EDUC8/256 word memory/256 word memory 2.0/256 word memory.pdf

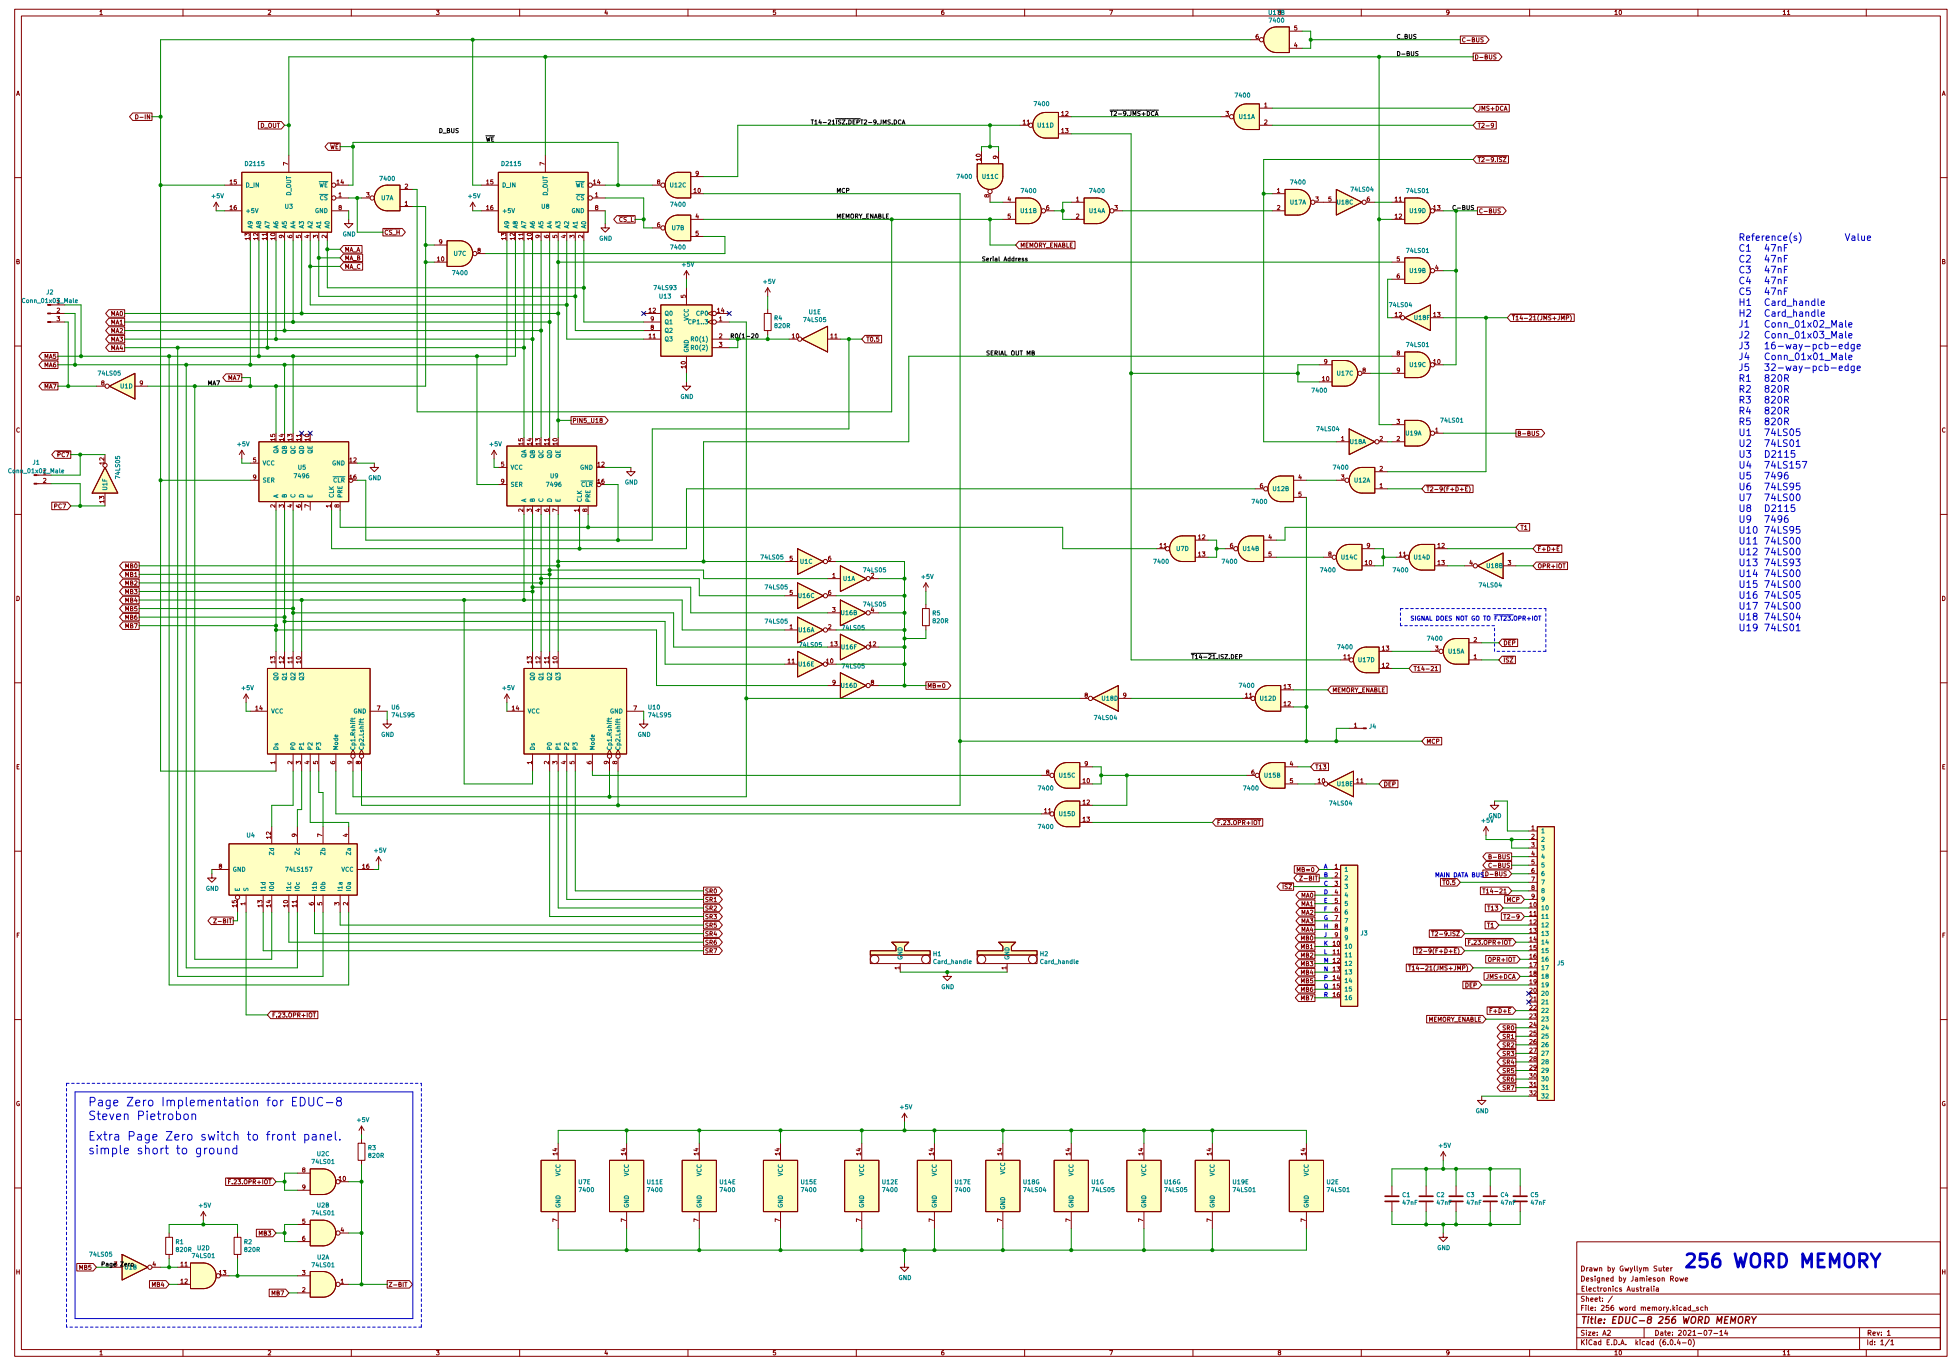
[picture p207: page 1]

Serial Address SERIAL OUT MB

1 QE 10 QD 11 GND 12 QC 13 QB 14 QA 15

SIGNAL DOES NOT GO TO ~{F.T23.}OPR+IOT

Page Zero Implementation for EDUC-8
Steven Pietrobon
Extra Page Zero switch to front panel.
simple short to ground

Drawn by Gwyllym Suter
File: 256 word memory.kicad_sch Sheet: / Electronics Australia Designed by Jamieson Rowe

Id: 1/1 Title: EDUC-8 256 WORD MEMORY
