ibm2030/EDUC8/octal. keyboard/octal keyboard/Keyboard interface.pdf

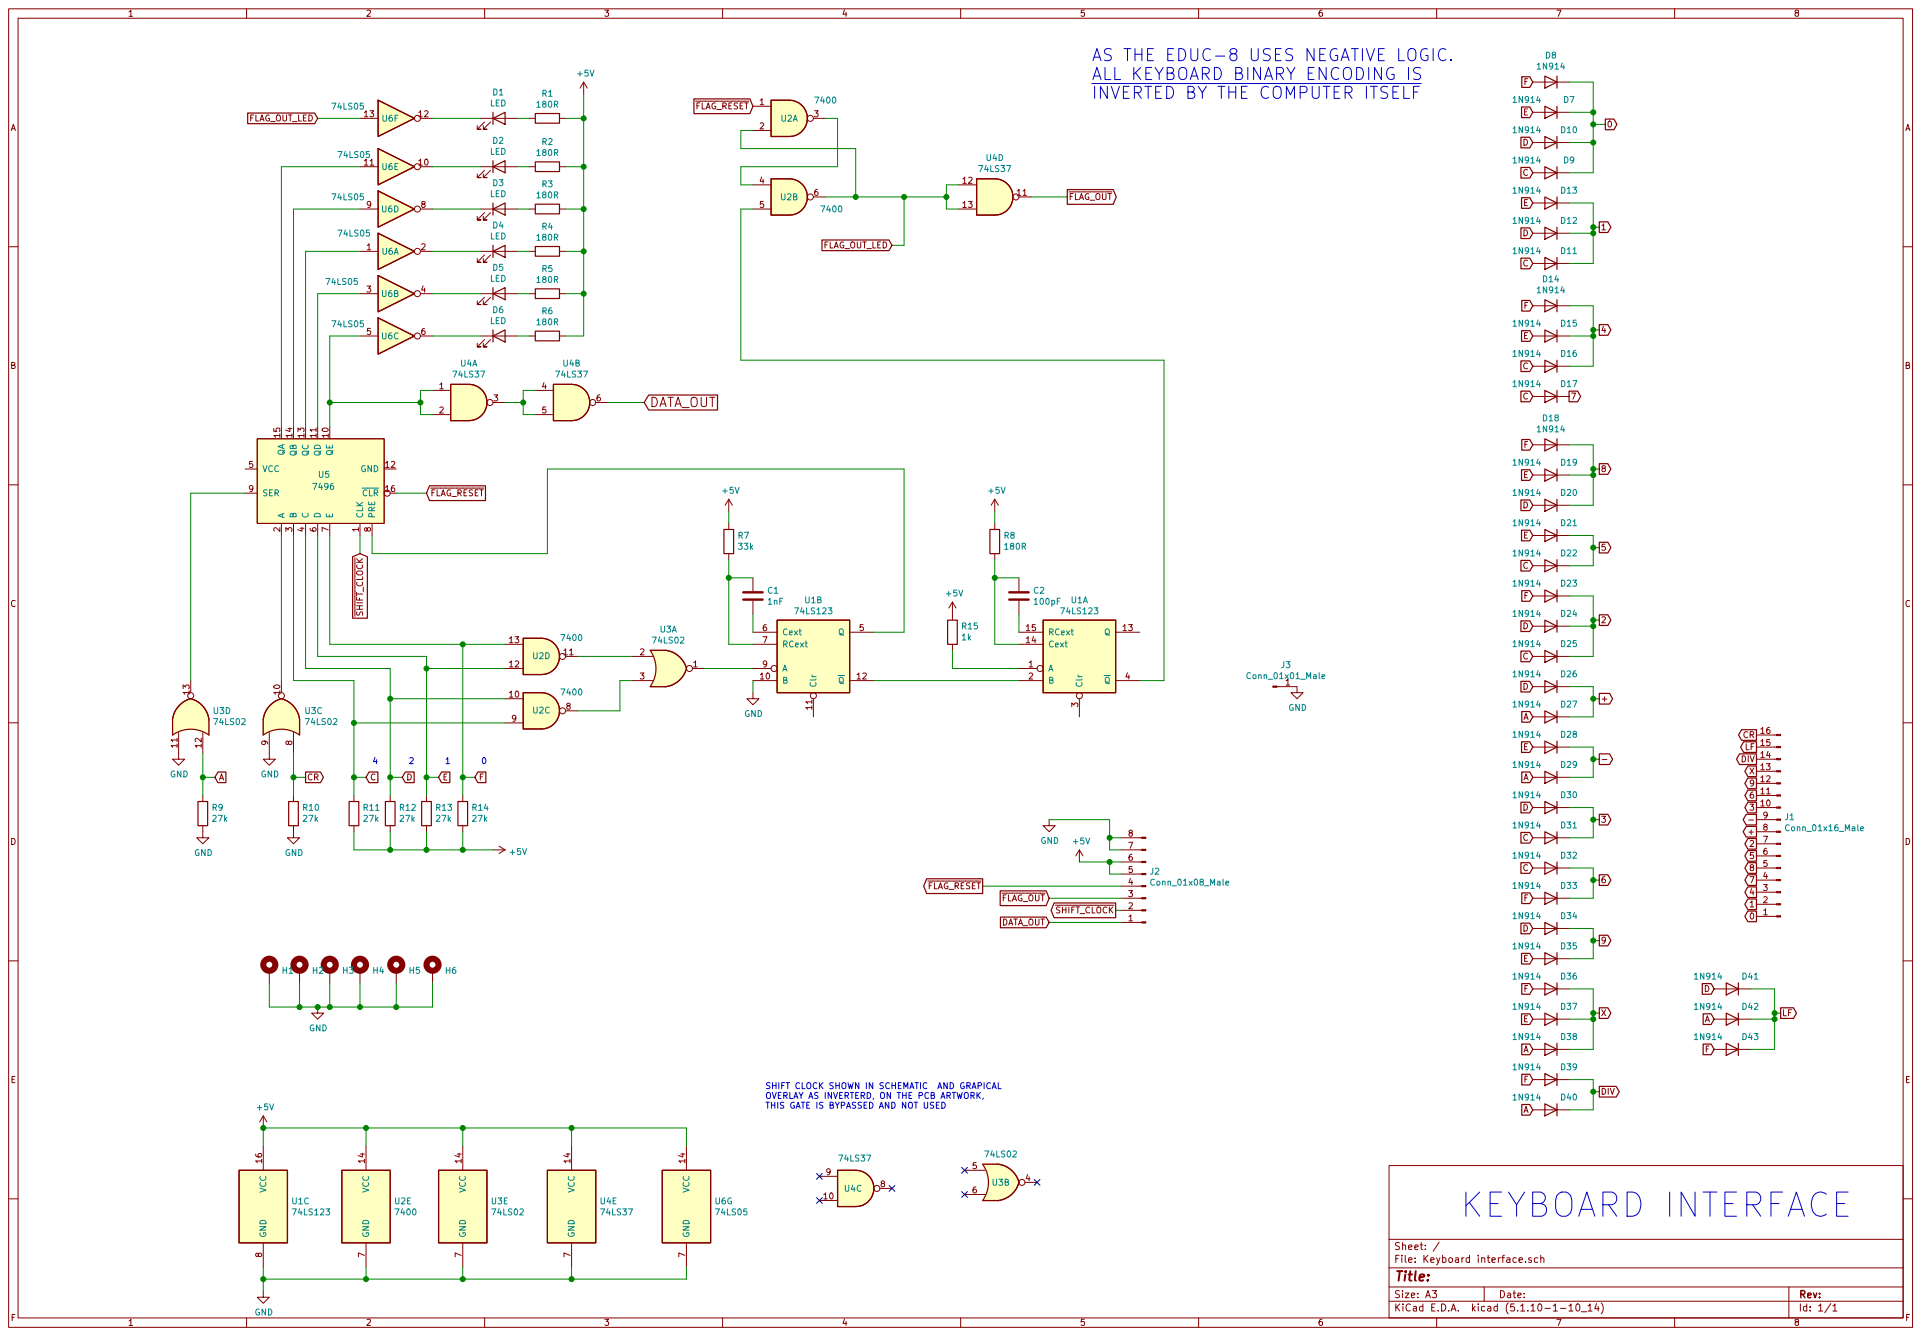
[picture p208: page 1]

AS THE EDUC-8 USES NEGATIVE LOGIC.
ALL KEYBOARD BINARY ENCODING IS
INVERTED BY THE COMPUTER ITSELF

1 QE 10 QD 11 GND 12 QC 13 QB 14 QA 15 CLR 16 A

File: Keyboard interface.sch Sheet: /
