ibm2030/EDUC8/multiplexer/E8MX:M/multiplexer.pdf

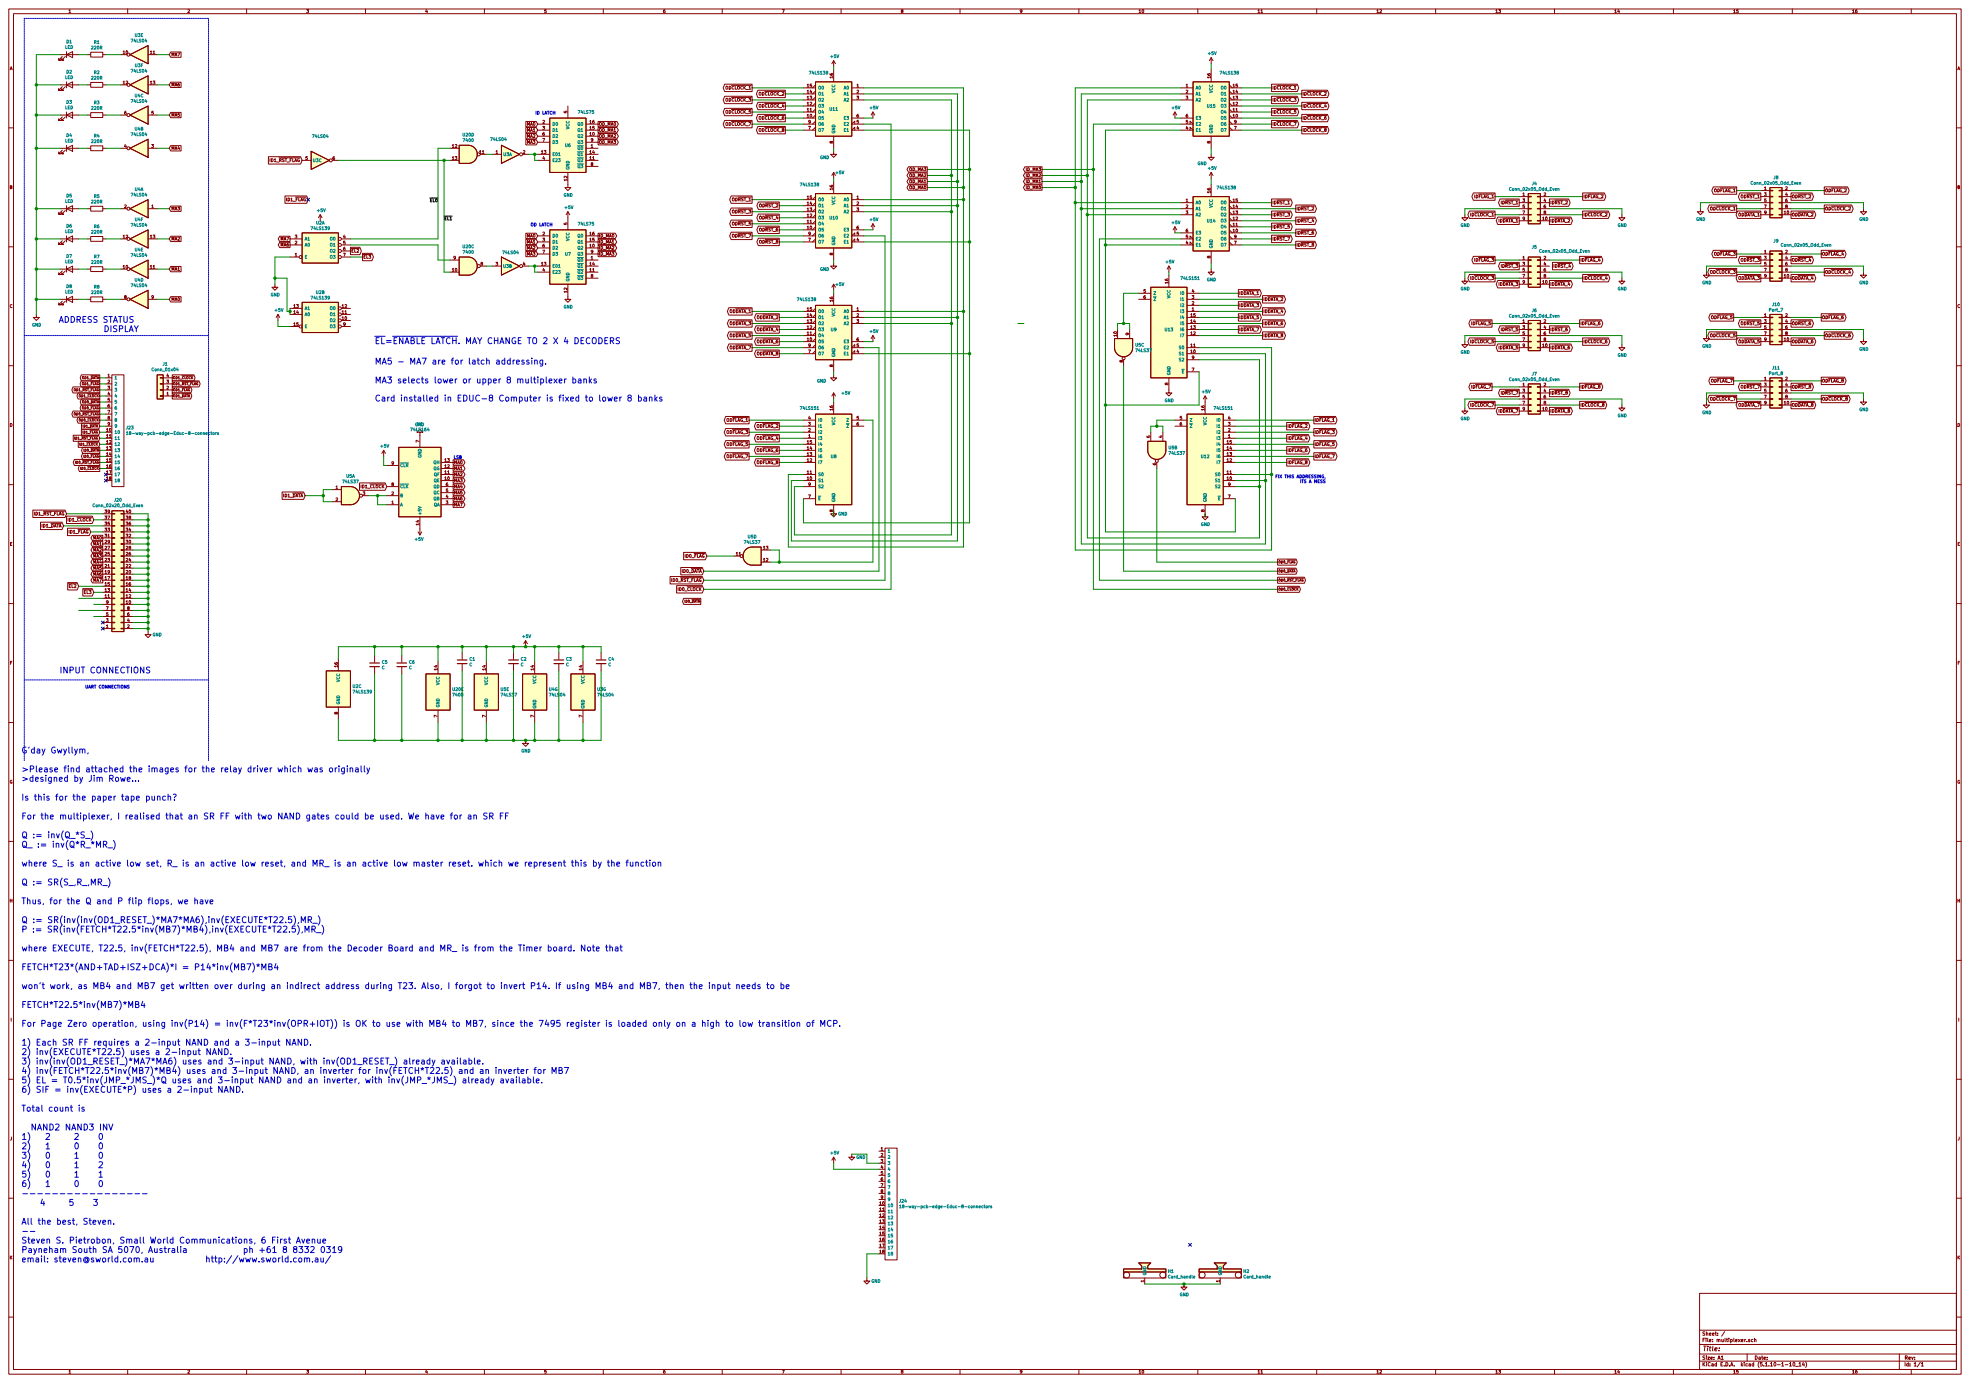
[picture p209: page 1]

EL=ENABLE LATCH. MAY CHANGE TO 2 X 4 DECODERS

MA5 - MA7 are for latch addressing.

MA3 selects lower or upper 8 multiplexer banks
Card installed in EDUC-8 Computer is fixed to lower 8 banks

>Please find attached the images for the relay driver which was originally
>designed by Jim Rowe...

Is this for the paper tape punch?

For the multiplexer, I realised that an SR FF with two NAND gates could be used. We have for an SR FF

where S_ is an active low set, R_ is an active low reset, and MR_ is an active low master reset. which we represent this by the function

Thus, for the Q and P flip flops, we have
Q := SR(inv(inv(OD1_RESET_)*MA7*MA6),inv(EXECUTE*T22.5),MR_)
P := SR(inv(FETCH*T22.5*inv(MB7)*MB4),inv(EXECUTE*T22.5),MR_)

where EXECUTE, T22.5, inv(FETCH*T22.5), MB4 and MB7 are from the Decoder Board and MR_ is from the Timer board. Note that

FETCH*T23*(AND+TAD+ISZ+DCA)*I = P14*inv(MB7)*MB4

won't work, as MB4 and MB7 get written over during an indirect address during T23. Also, I forgot to invert P14. If using MB4 and MB7, then the input needs to be

IJK
For Page Zero operation, using inv(P14) = inv(F*T23*inv(OPR+IOT)) is OK to use with MB4 to MB7, since the 7495 register is loaded only on a high to low transition of MCP.

1) Each SR FF requires a 2-input NAND and a 3-input NAND.
2) inv(EXECUTE*T22.5) uses a 2-input NAND.
3) inv(inv(OD1_RESET_)*MA7*MA6) uses and 3-input NAND, with inv(OD1_RESET_) already available.
4) inv(FETCH*T22.5*inv(MB7)*MB4) uses and 3-input NAND, an inverter for inv(FETCH*T22.5) and an inverter for MB7
5) EL = T0.5*inv(JMP_*JMS_)*Q uses and 3-input NAND and an inverter, with inv(JMP_*JMS_) already available.
6) SIF = inv(EXECUTE*P) uses a 2-input NAND.

18-way-pcb-edge-Educ-8-connectors

All the best, Steven. -- Steven S. Pietrobon, Small World Communications, 6 First Avenue

File: multiplexer.sch Sheet: /
