ibm2030/EDUC8/E8Serial/Video terminal /Video terminal .pdf

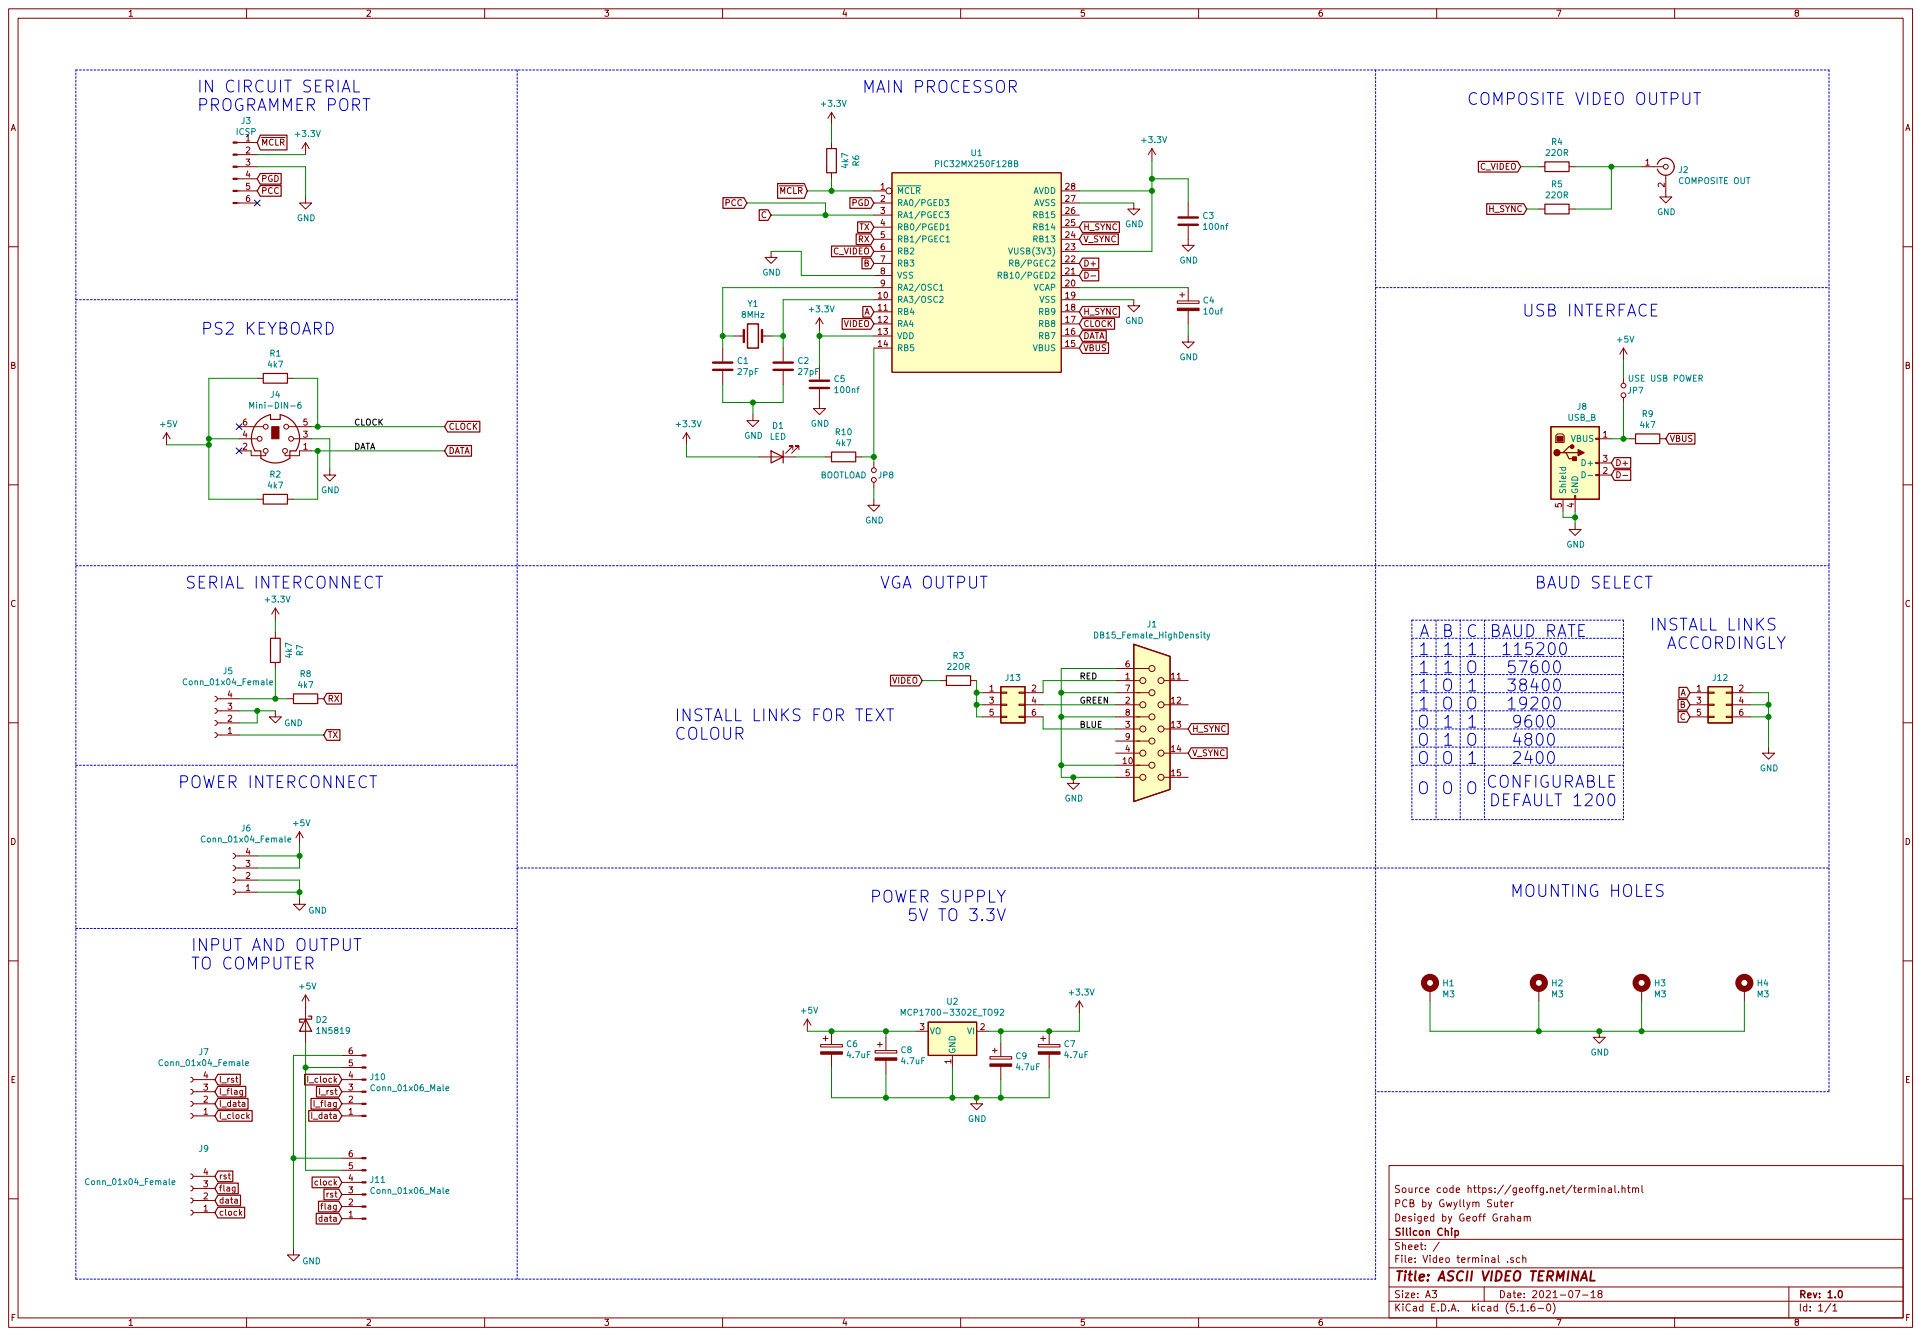
[picture p211: page 1]

+3.3V 4k7 R7 R8 | TX | VGA OUTPUT

B 1 OO | CO1 O1 O | BAUD SELECT A BAUD RATE O 115200

57600
38400

INSTALL LINKS FOR TEXT
COLOUR

PCB by Gwyllym Suter
Desiged by Geoff Graham
File: Video terminal .sch Sheet: / Silicon Chip

Id: 1/1 Title: ASCII VIDEO TERMINAL
