ibm2030/EDUC8/Octal display 2/Pot and switch board/support PCB/support PCB.pdf

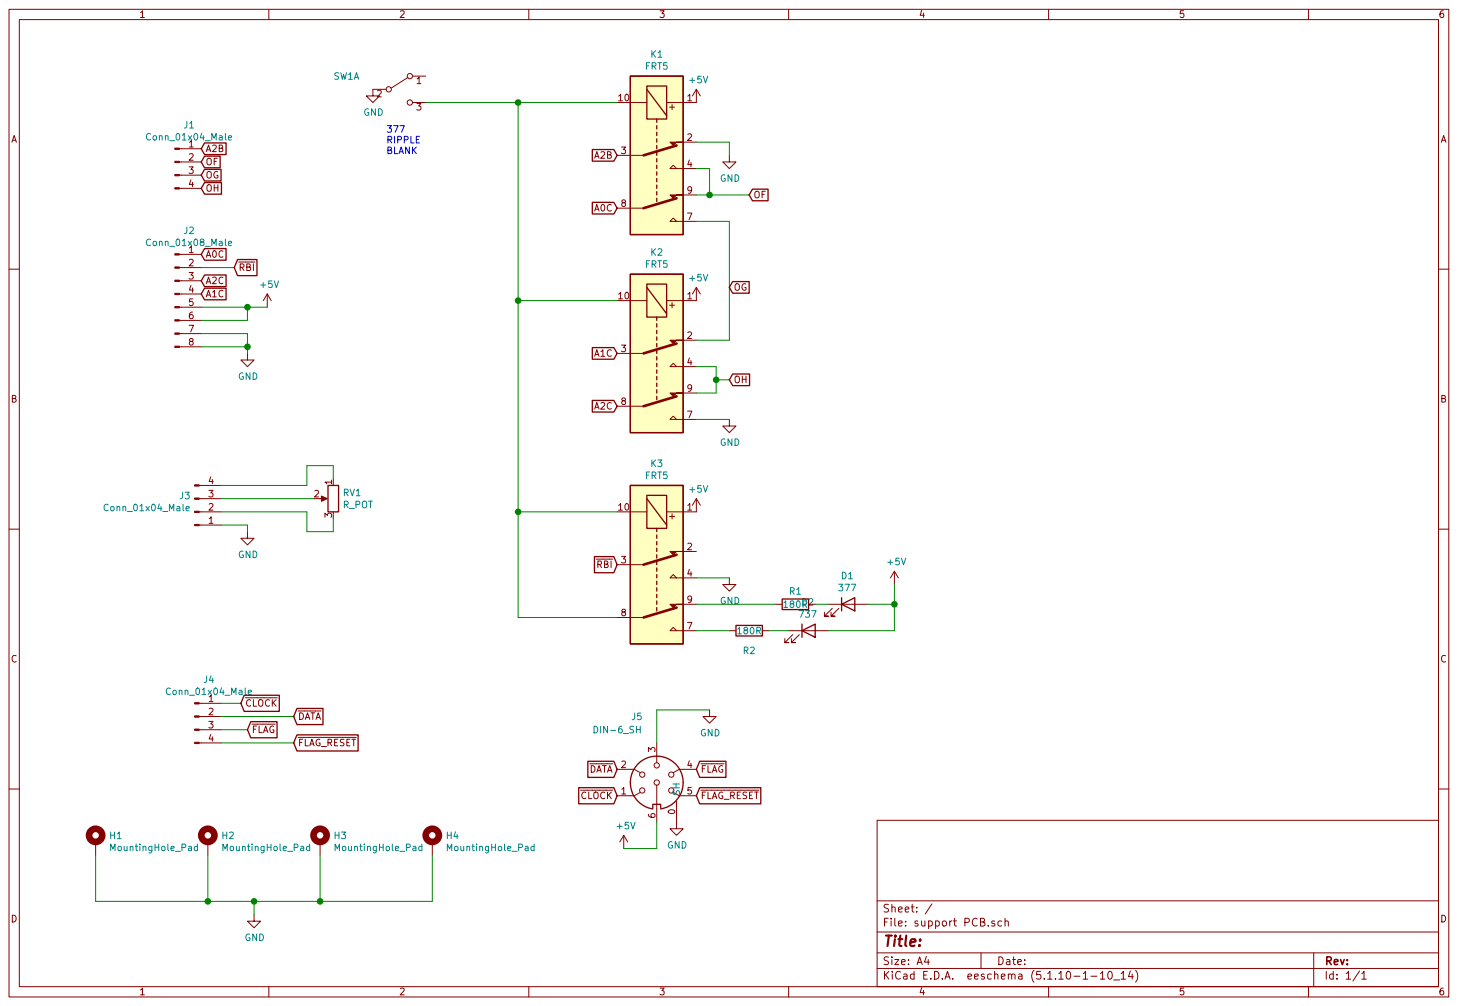
[picture p212: page 1]

File: support PCB.sch Sheet: /
