ibm2030/EDUC8/Housing/perspex window dimensions.pdf

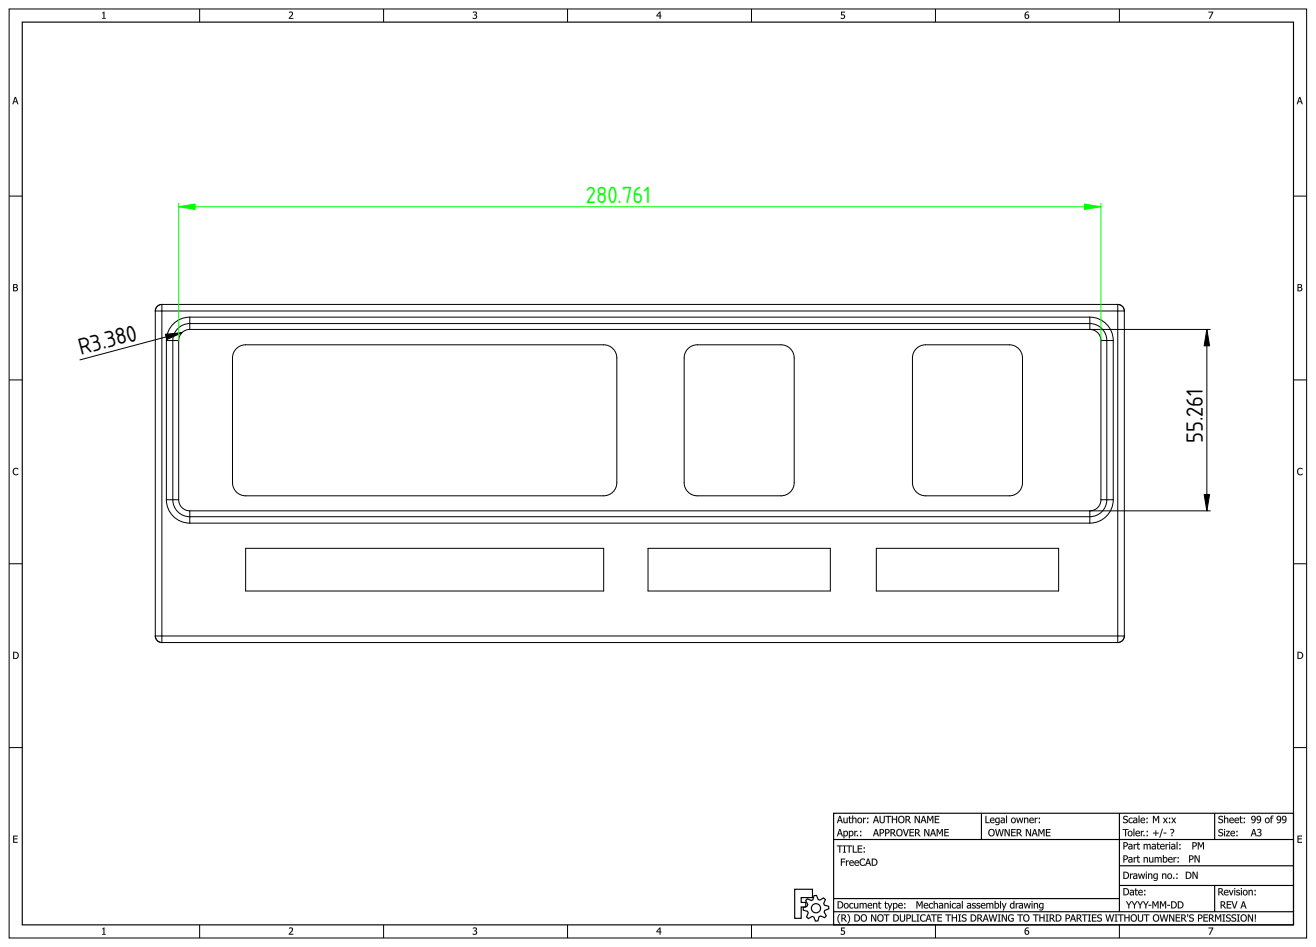
[picture p213: page 1]
