ibm2030/EDUC8/Input:Output Interface/Input-Output Interface.pdf

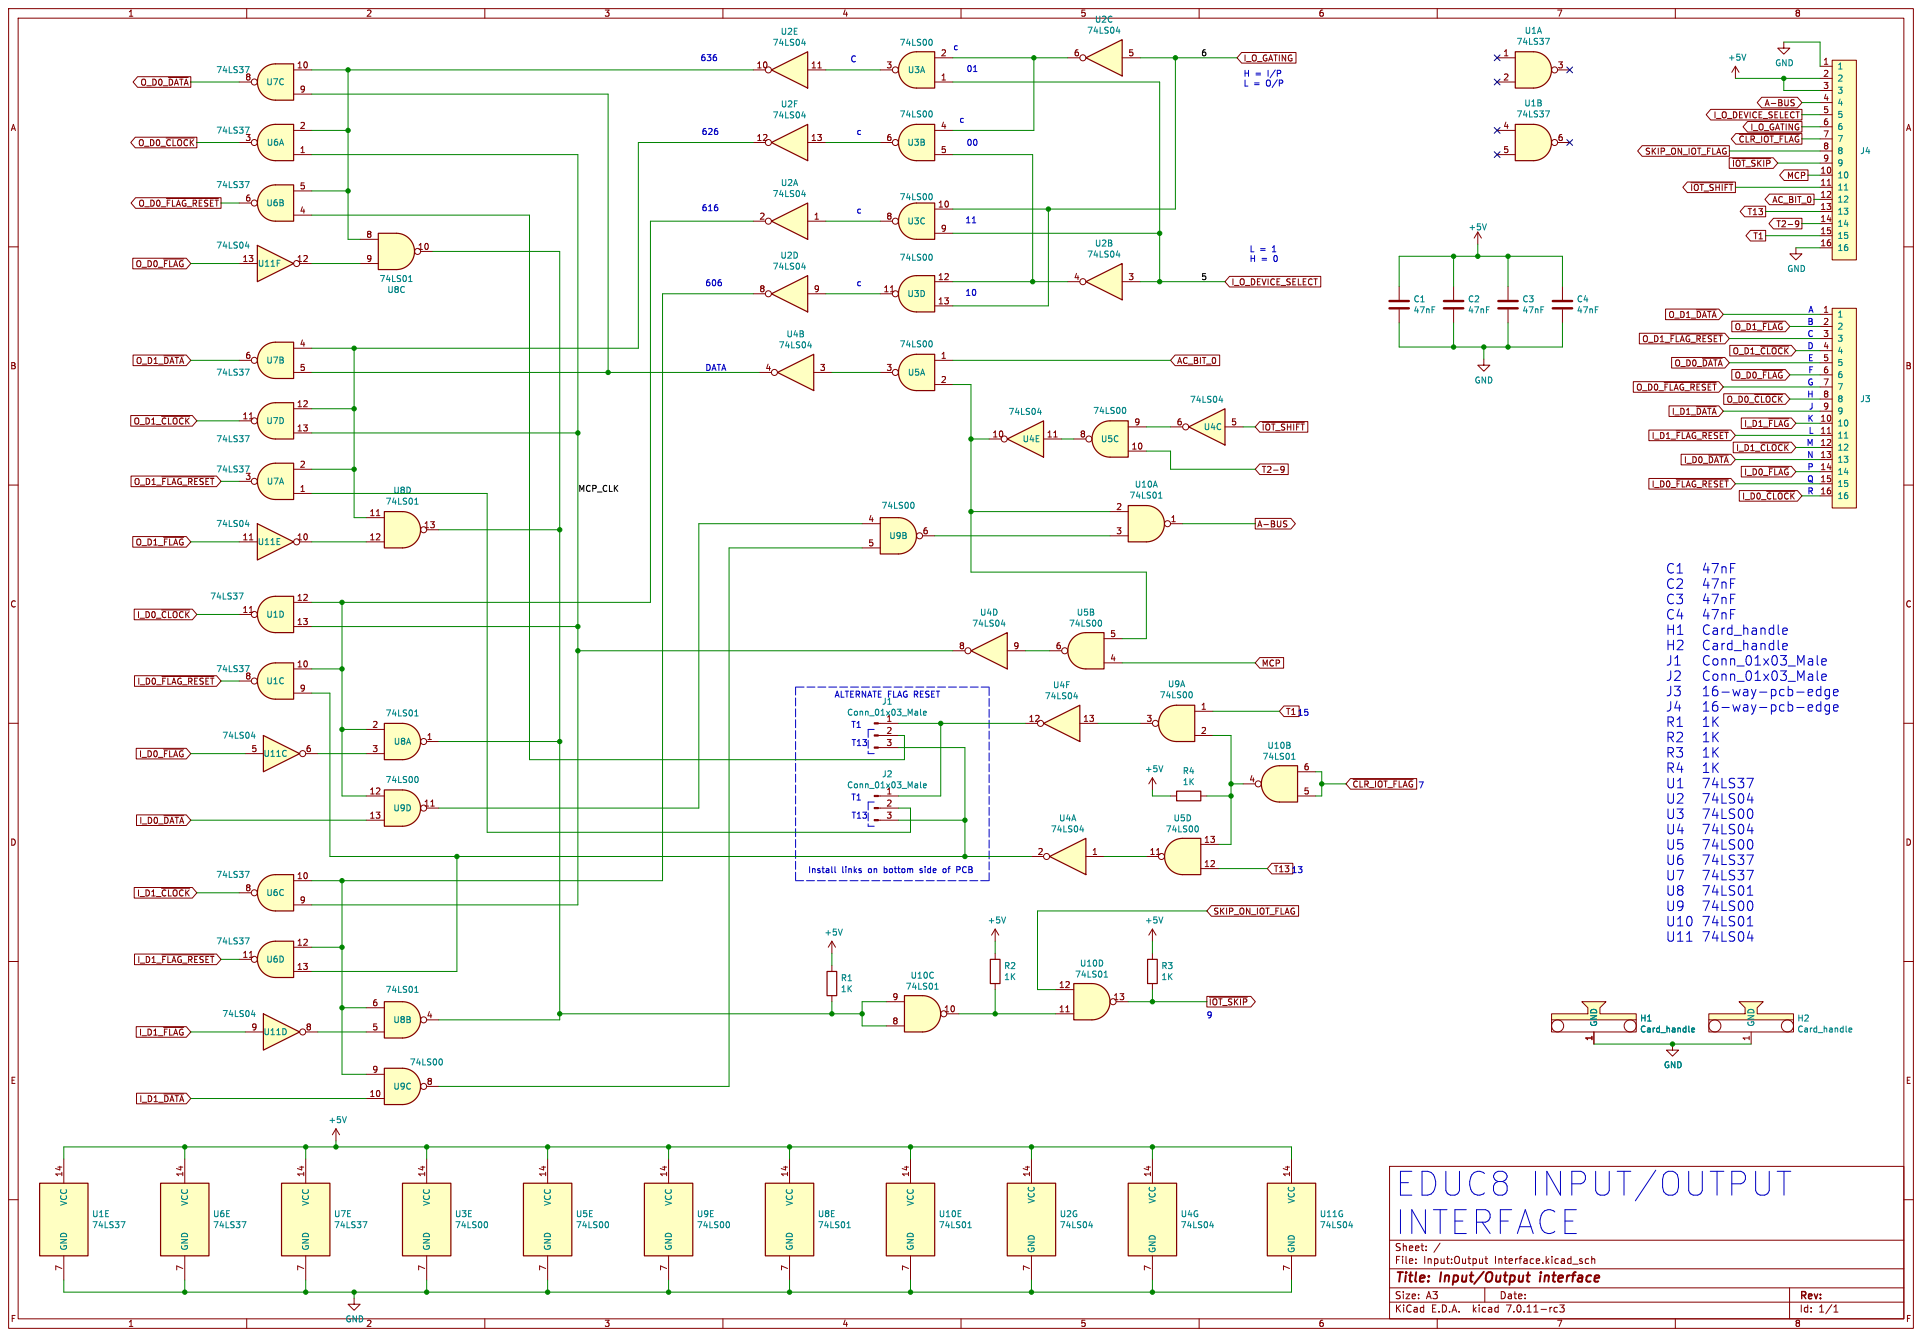
[picture p214: page 1]
