ibm2030/EDUC8/PC and ADDER 74LS74 MOD/74105 replacement.pdf

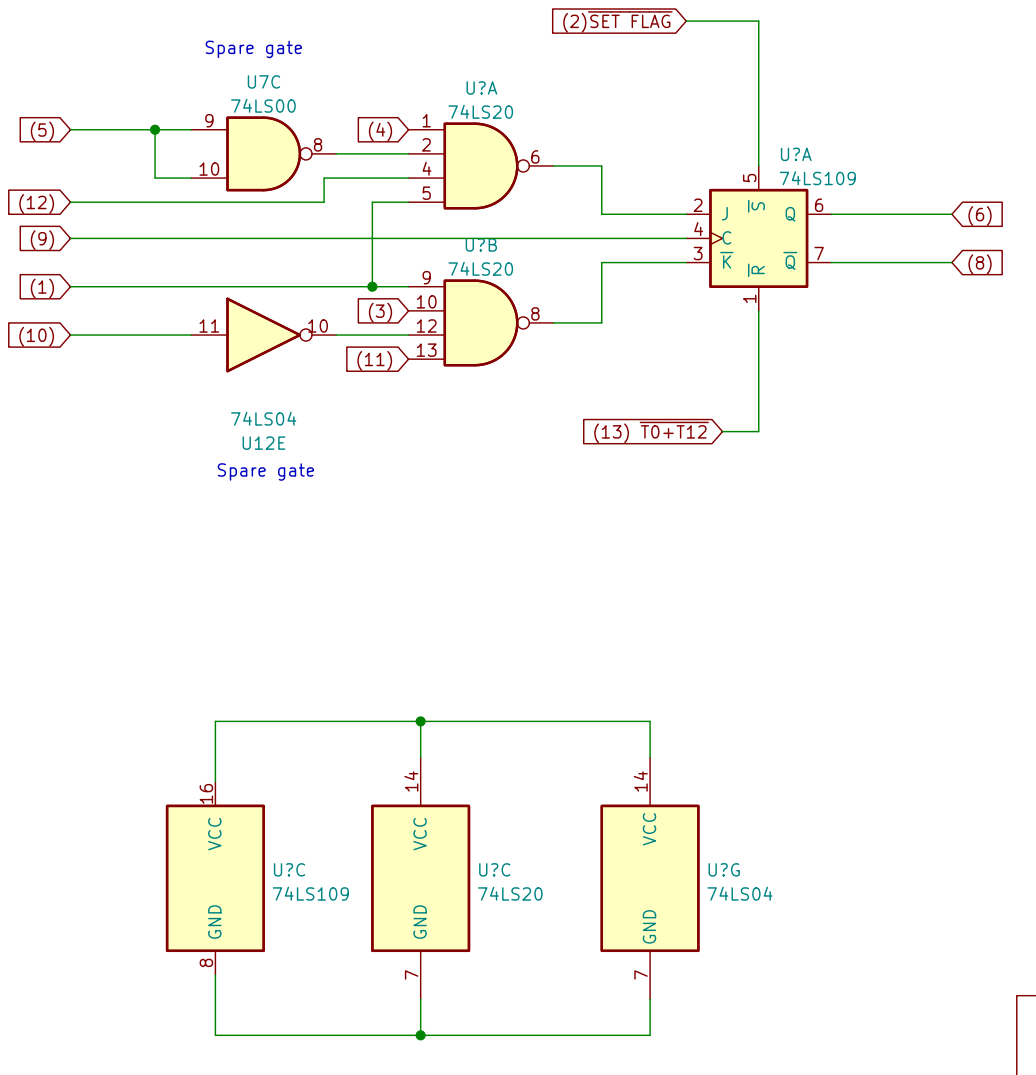
[picture p215: page 1]
