ibm2030/EDUC8/Octal display 2/Octal display.pdf

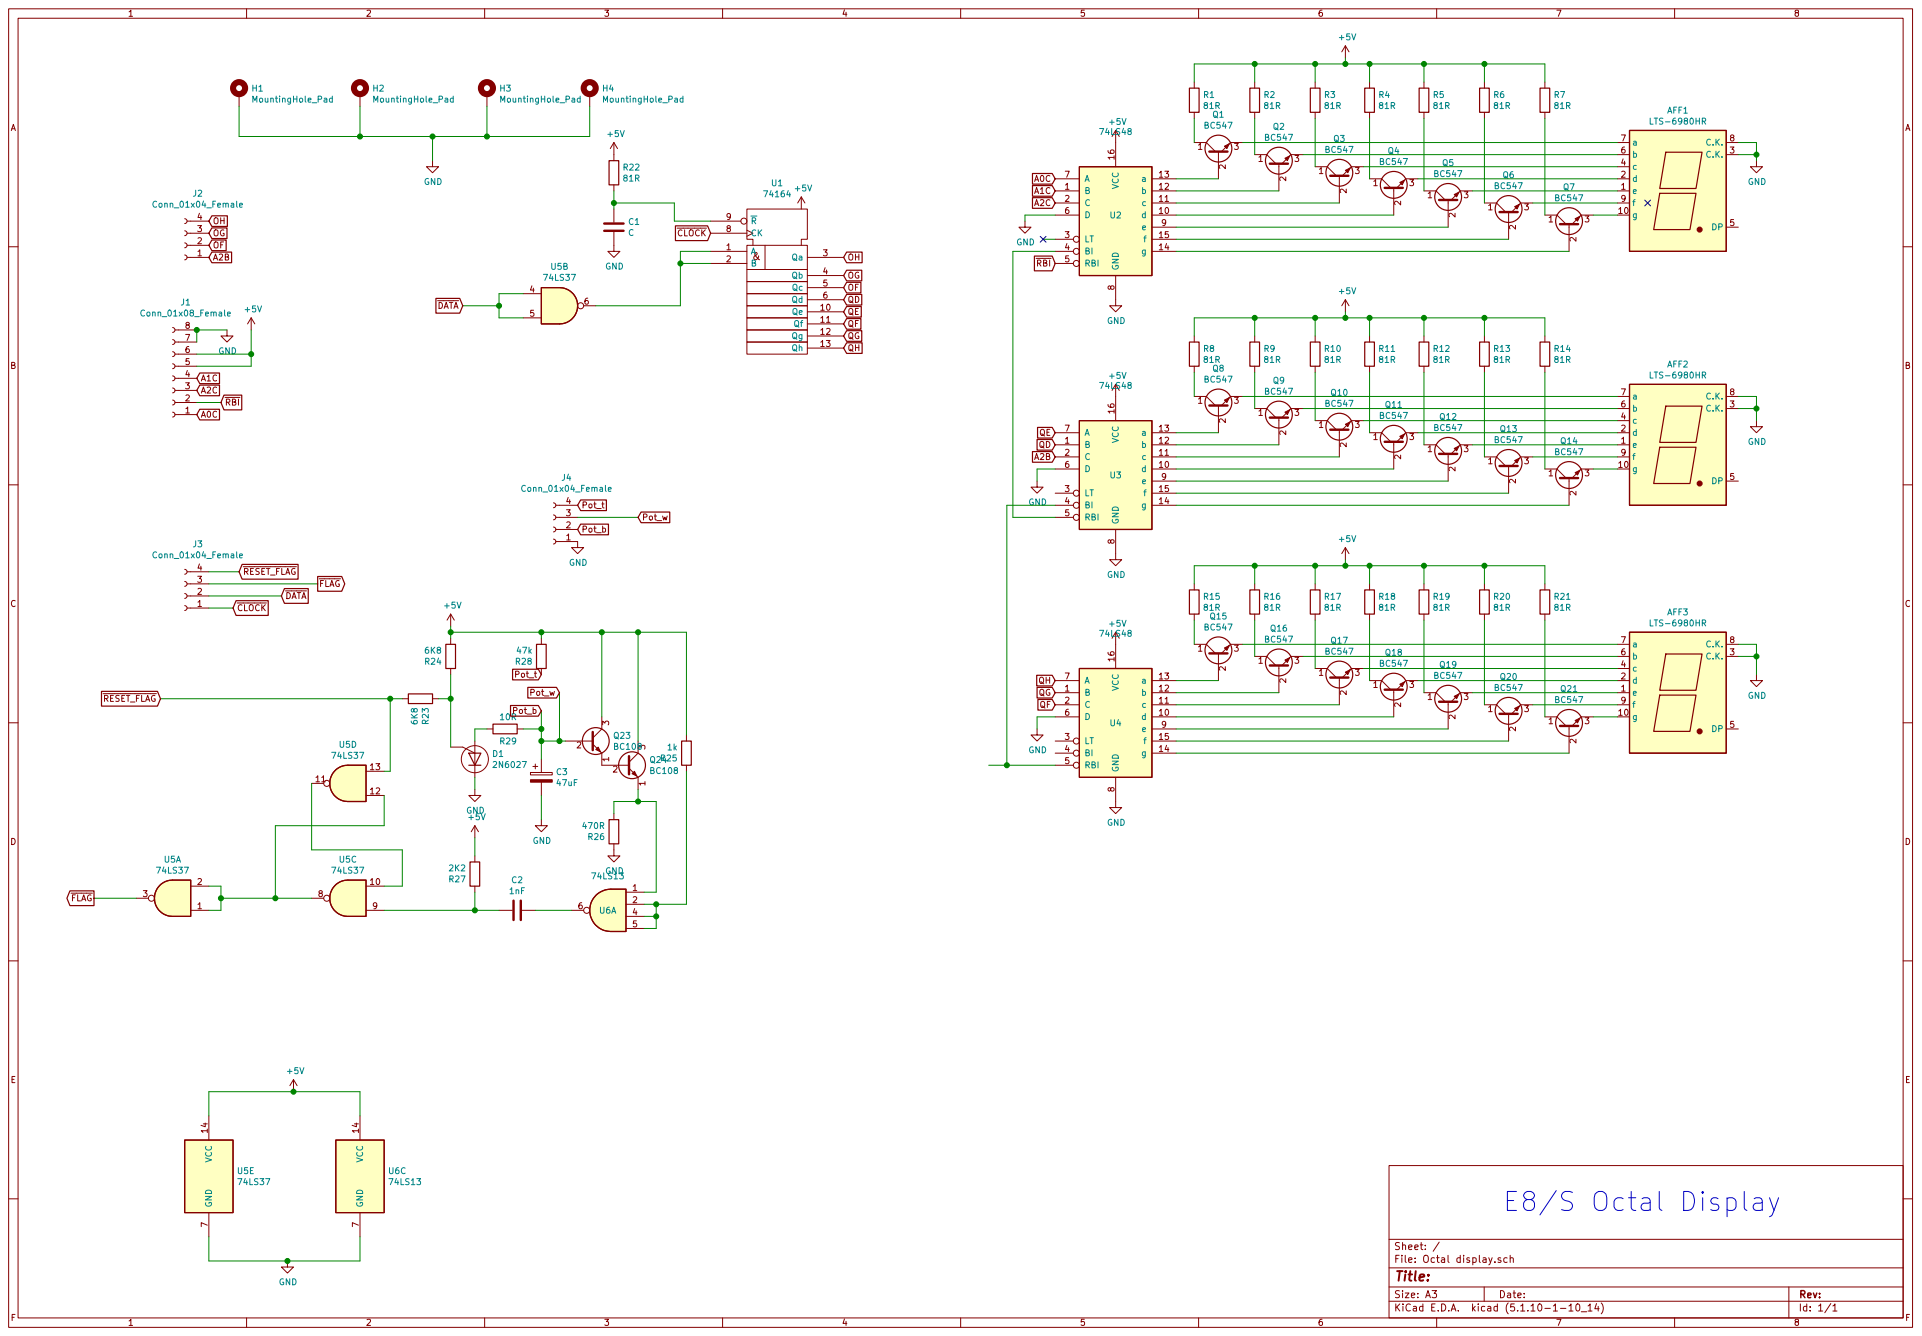
[picture p216: page 1]

File: Octal display.sch Sheet: /
