ibm2030/EDUC8/Buffer/Buffer.pdf

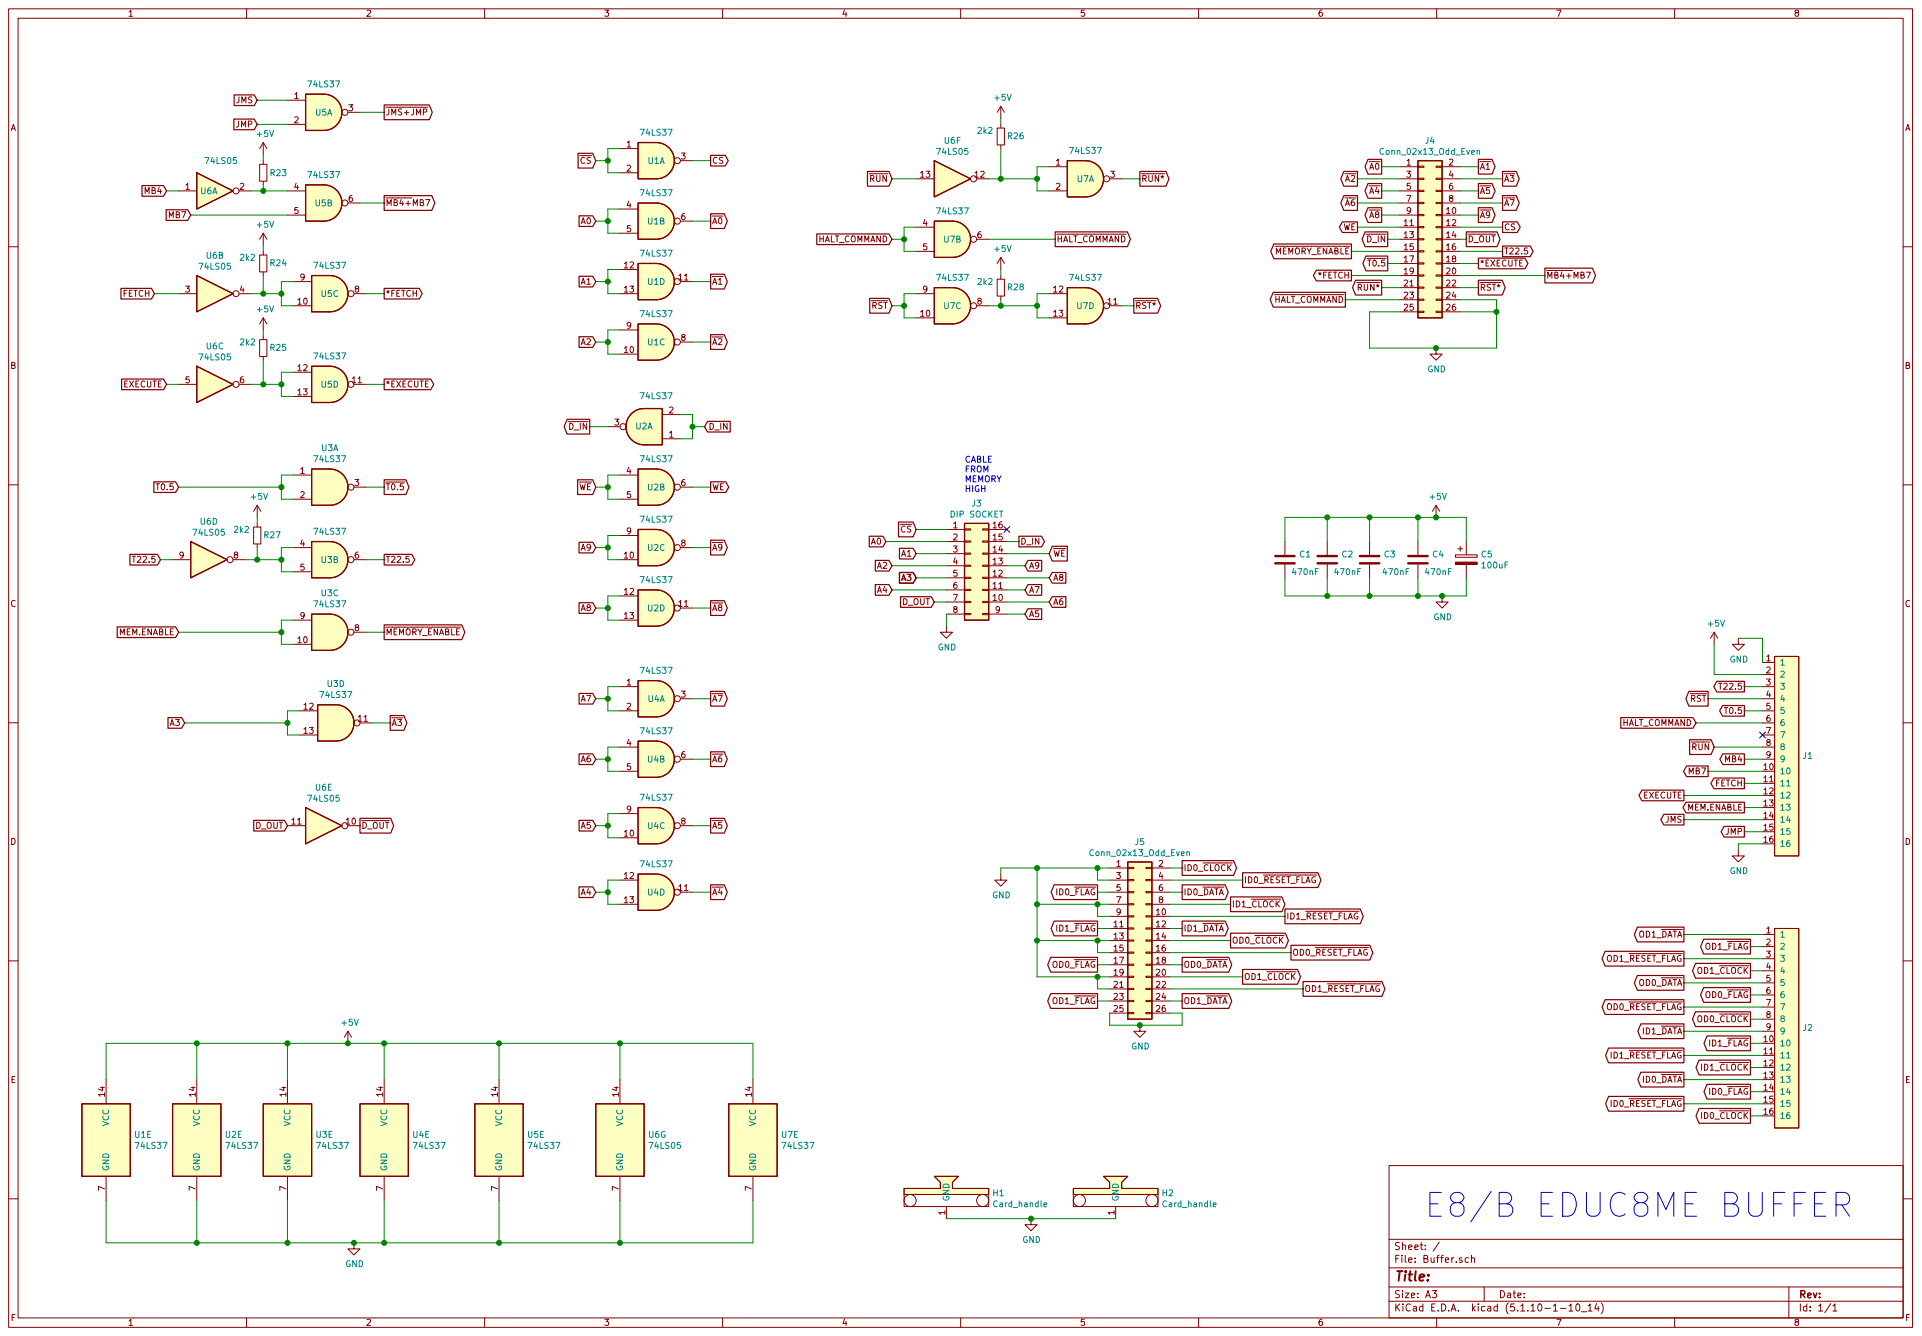
[picture p217: page 1]

Id: 1/1 Title: File: Buffer.sch Sheet: /
