ibm2030/EDUC8/ASCII keyboard/ASCII keyboard.pdf

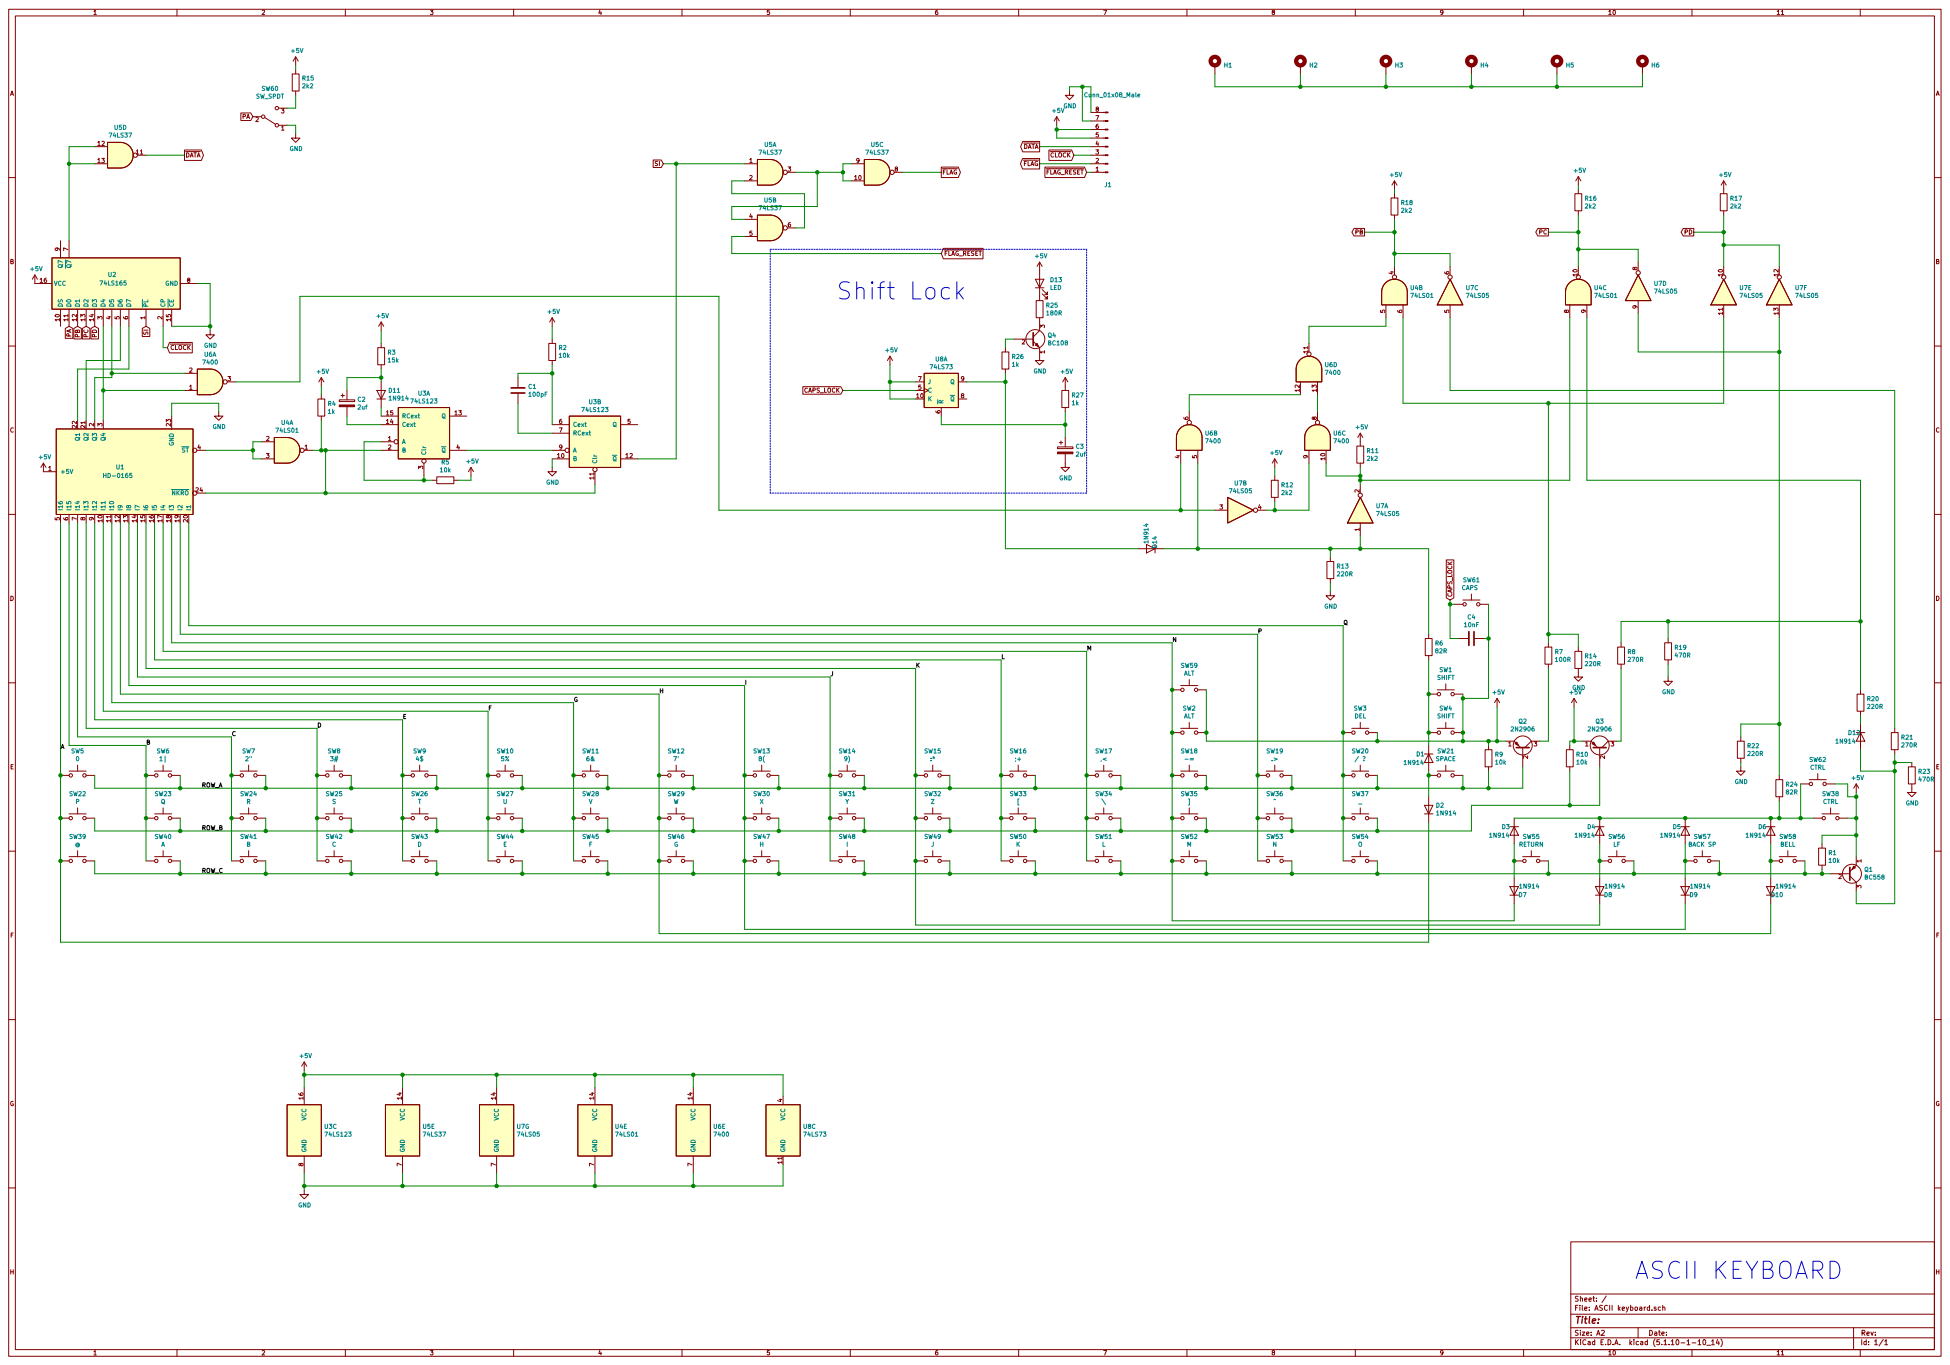
[picture p218: page 1]

1 DS 10 D0 11 D1 12 D2 13 D3 14 CE 15 VCC 16 CP

1N914 D3 | 1N914 D4 SW56 LF SW55 RETURN | 1N914 | SW58 BELL D5

File: ASCII keyboard.sch Sheet: /
