ibm2030/EDUC8/Accumulator/accumulator overlay.pdf

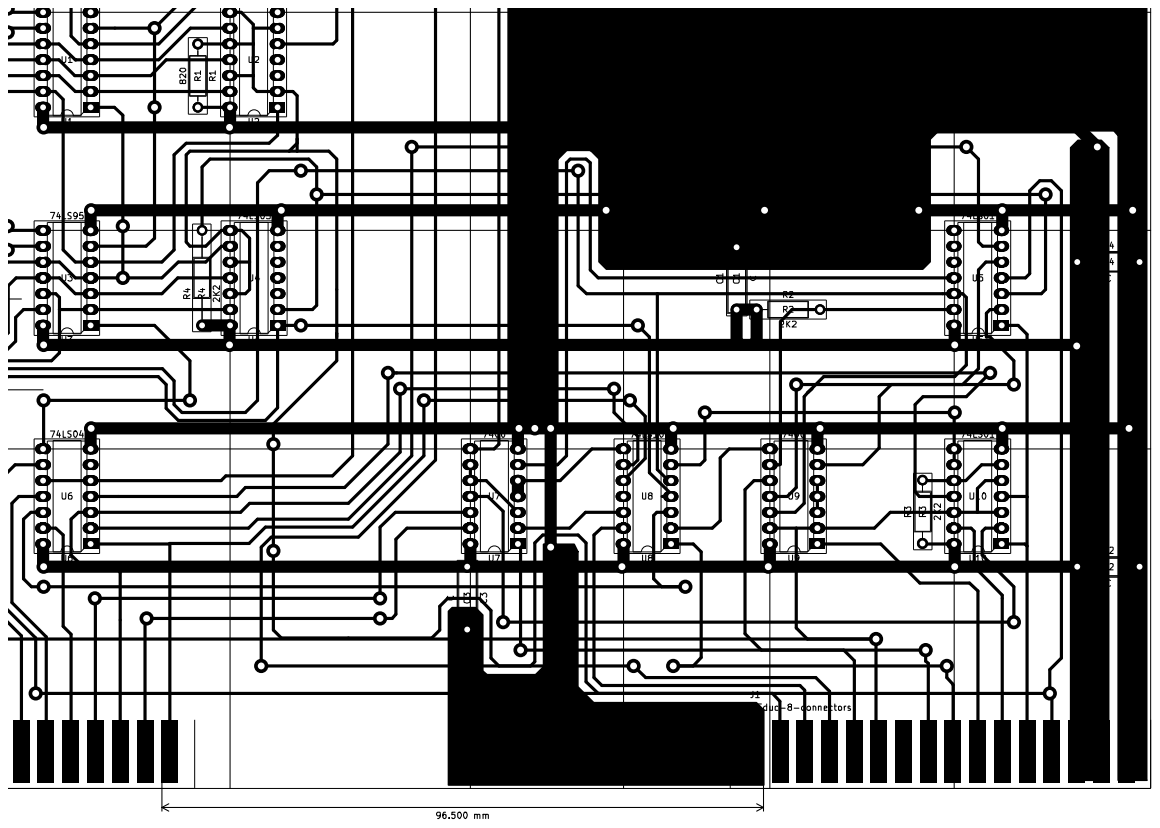
[picture p219: page 1]
