ibm2030/EDUC8/Original with 9602/PDF/front panel 9602-B_Silkscreen.pdf

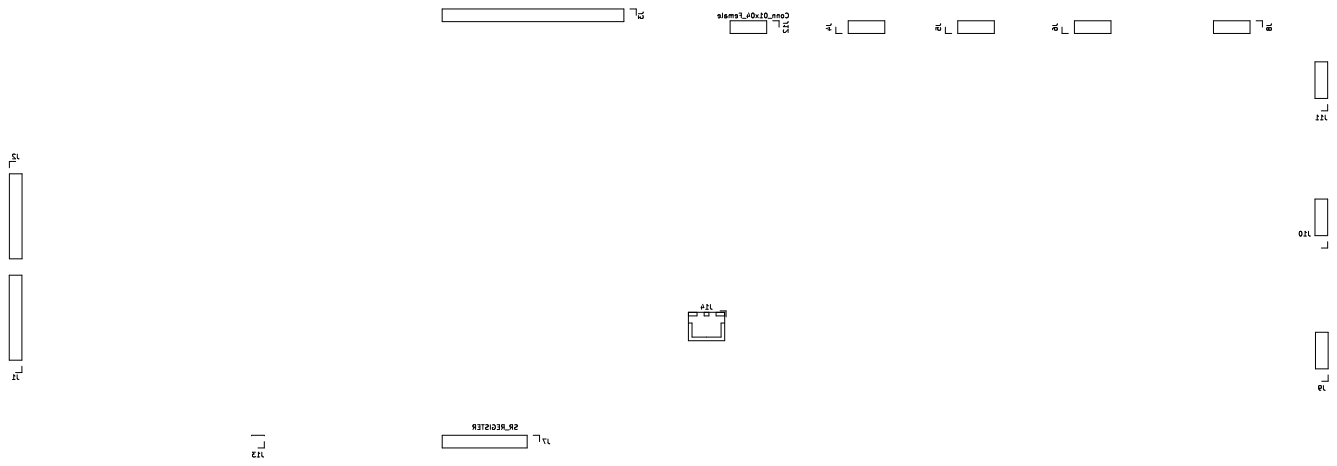
[picture p220: page 1]
