ibm2030/EDUC8/Original with 9602/PDF/front panel 9602-F_Silkscreen.pdf

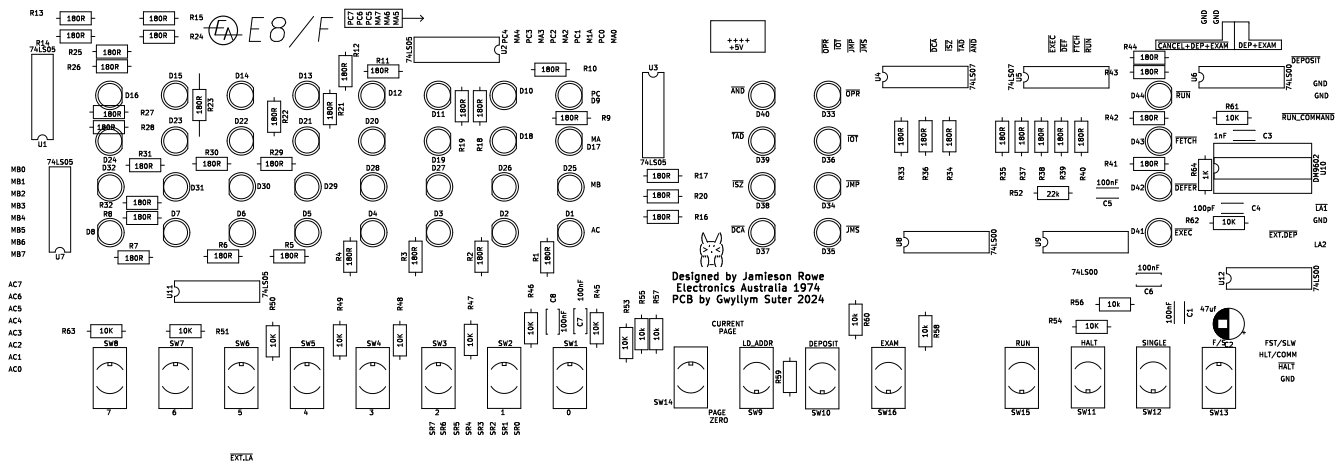
[picture p221: page 1]
