ibm2030/EDUC8/PC and ADDER 74LS74 MOD/74105 replacement/74105 replacement.pdf

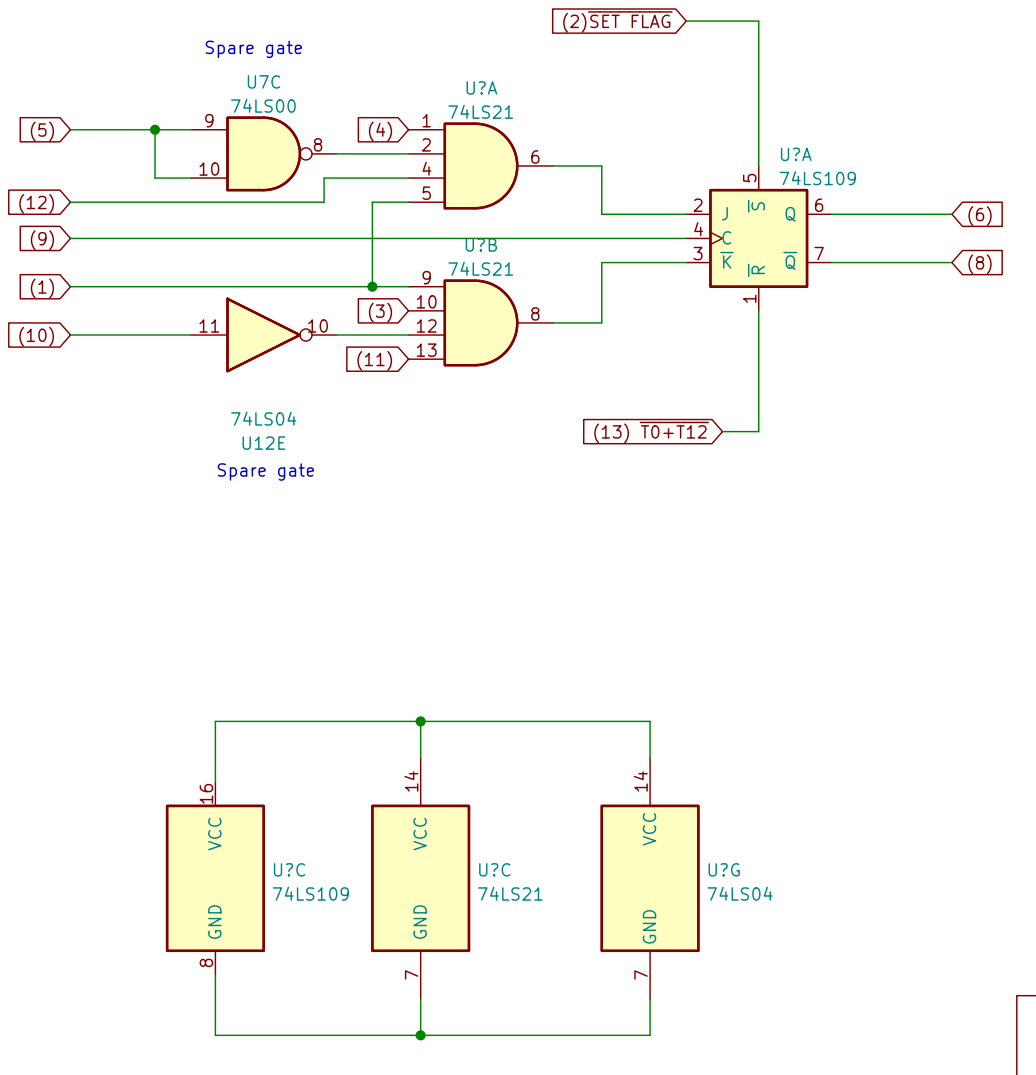
[picture p223: page 1]
