ibm2030/EDUC8/Music Player/Music player/Music player.pdf

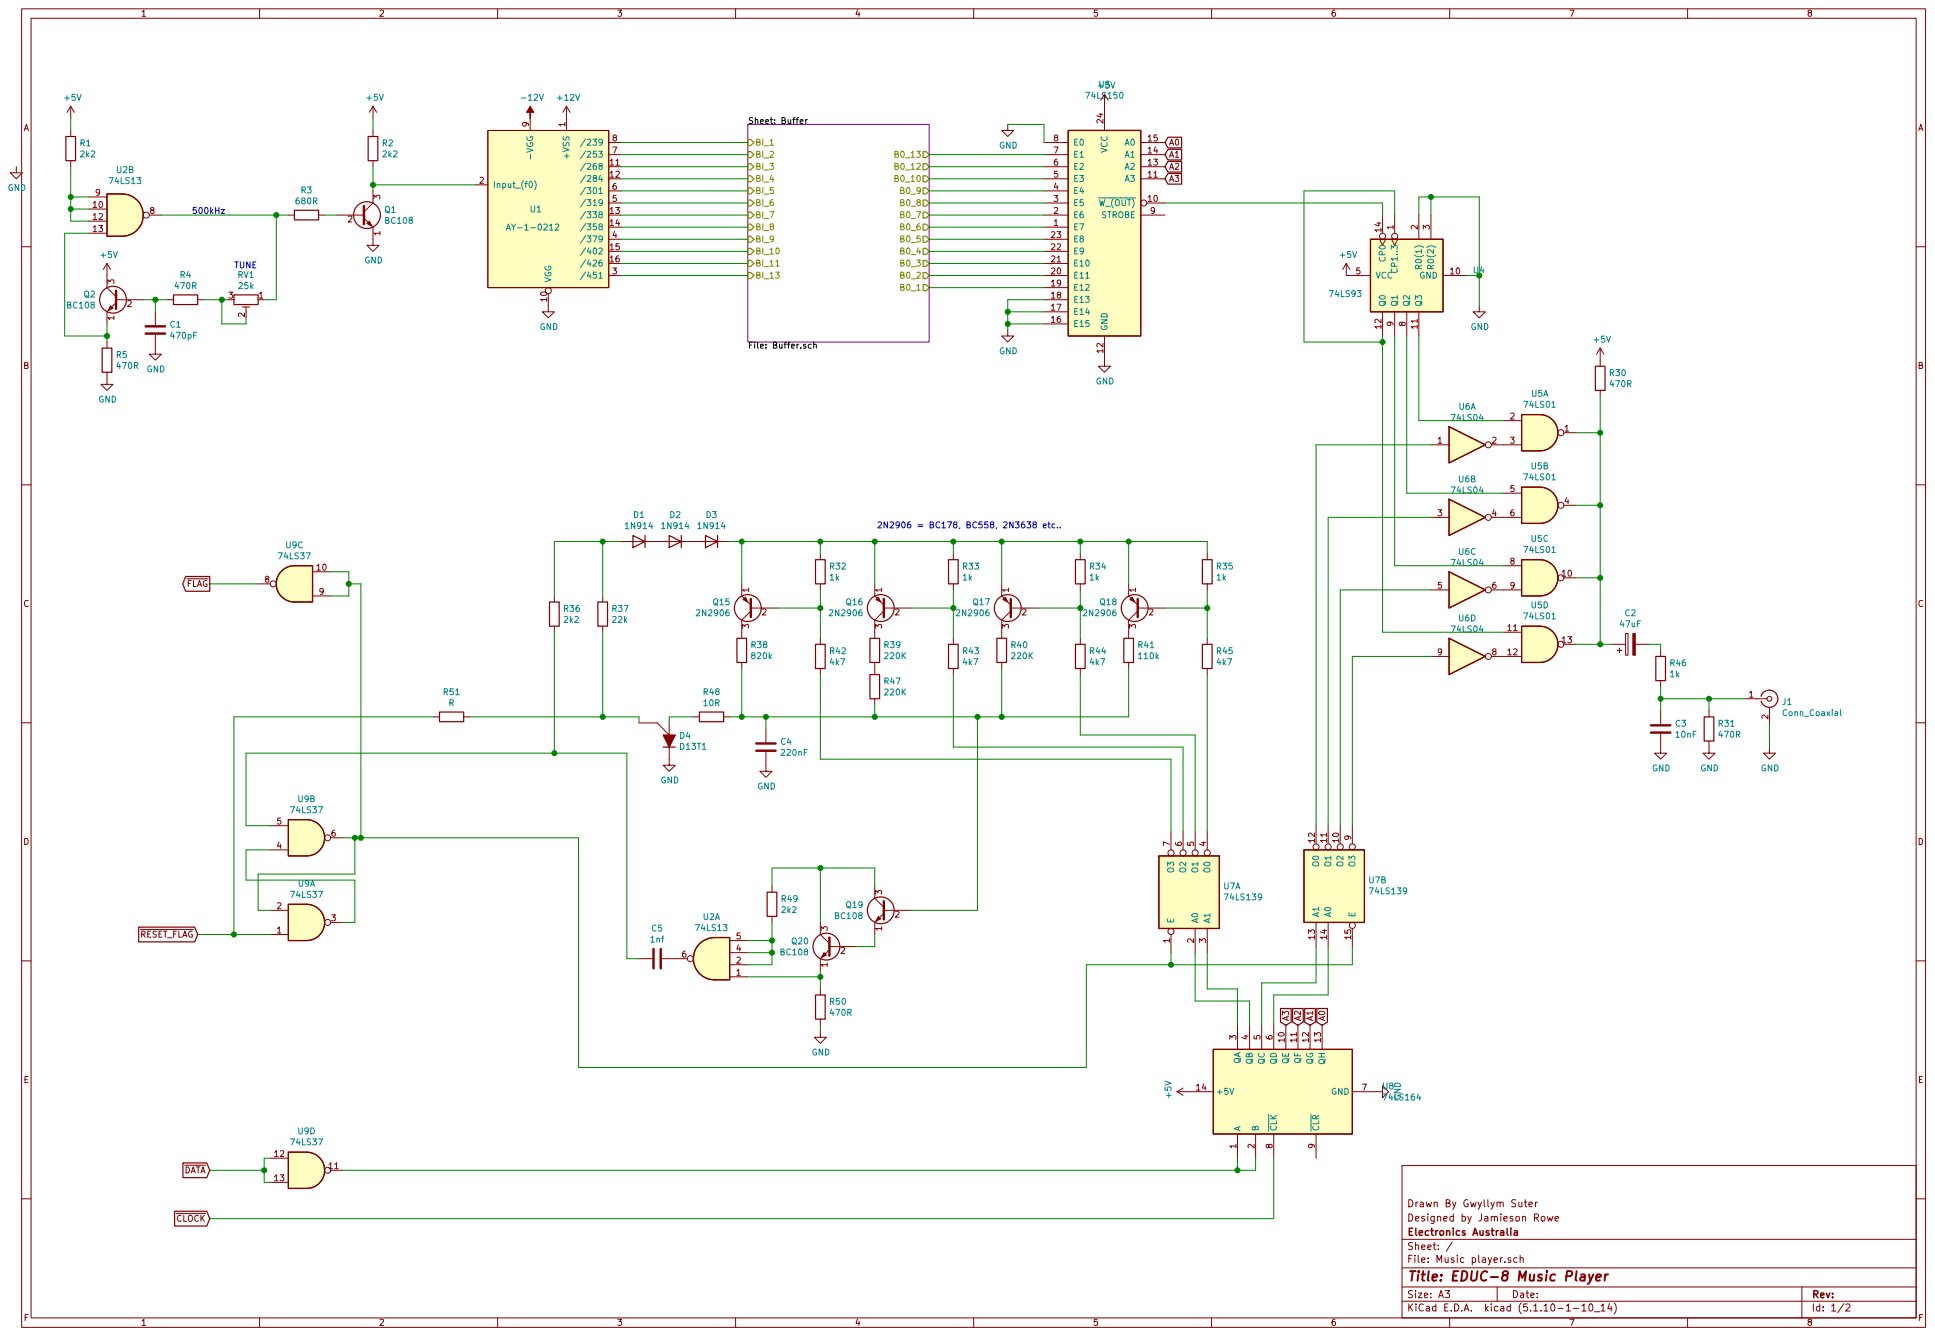
[picture p224: page 1]

9 U1 AY-1-0212 E7 1 W_(OUT) 10 A3 11 GND 12 A2 13 A1 14 A0 15 E15 16 E14 17 E13 18 E12 19 E6 2 E11 20 E10 21 E9 22 E8 23 VCC 24 E5 3 E4 4 E3 5 E2 6 E1 7 E0 8 STROBE 9 U3

Drawn By Gwyllym Suter
File: Music player.sch Sheet: / Electronics Australia Designed by Jamieson Rowe

Id: 1/2 Title: EDUC-8 Music Player

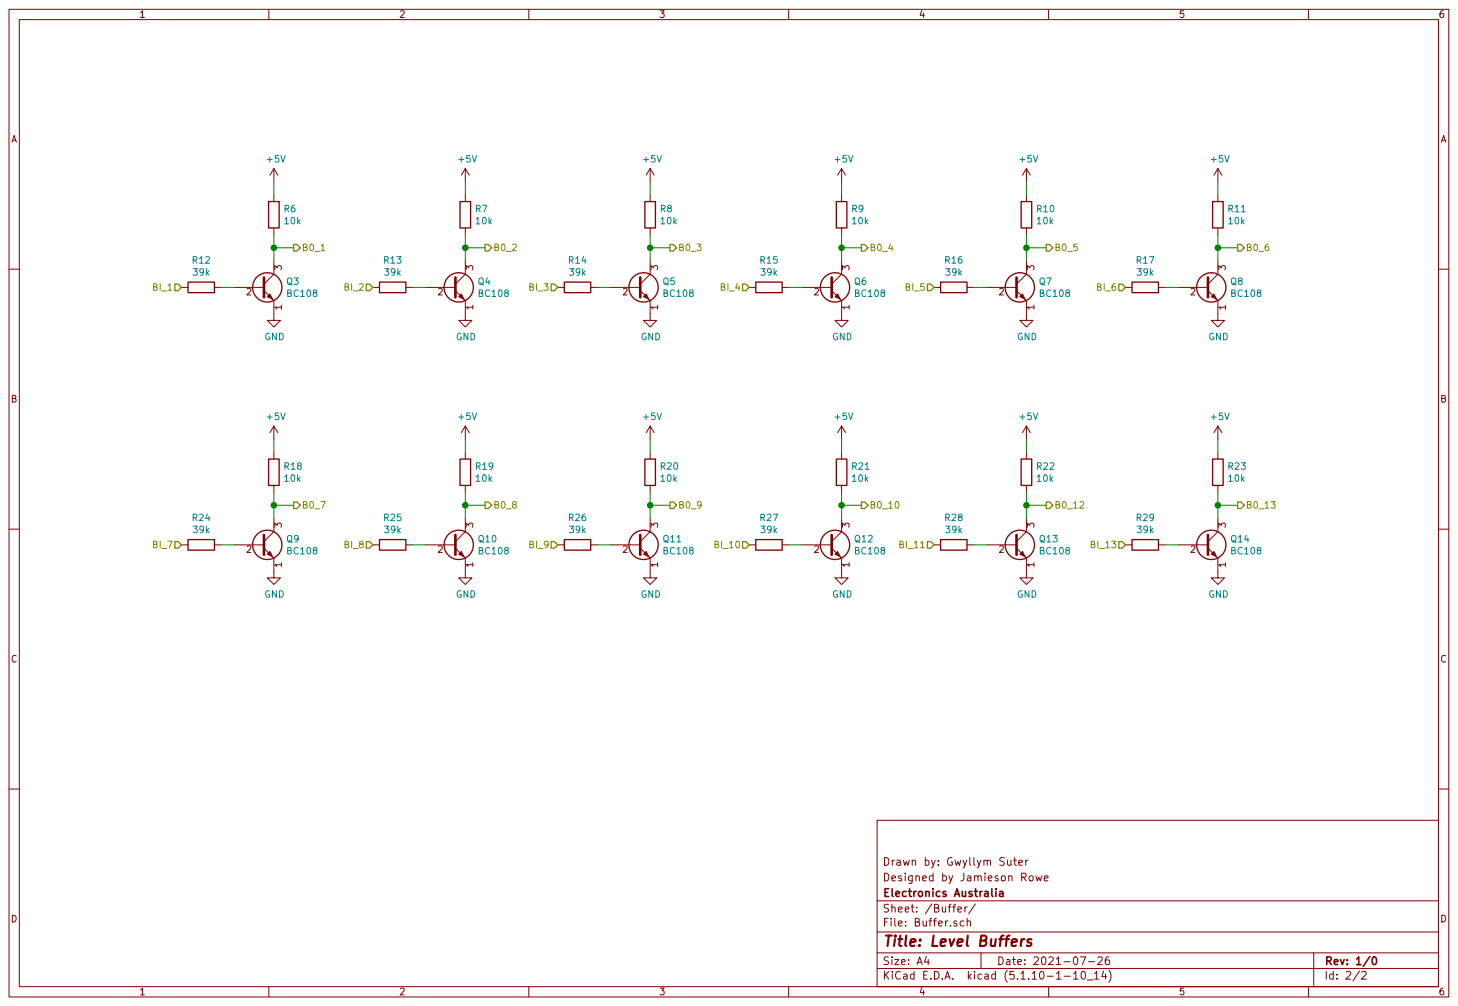
[picture p225: page 2]

Drawn by: Gwyllym Suter
File: Buffer.sch Sheet: /Buffer/ Electronics Australia Designed by Jamieson Rowe

Id: 2/2 Title: Level Buffers
