ibm2030/EDUC8/Serial interface/E8Serial/E8Serial.pdf

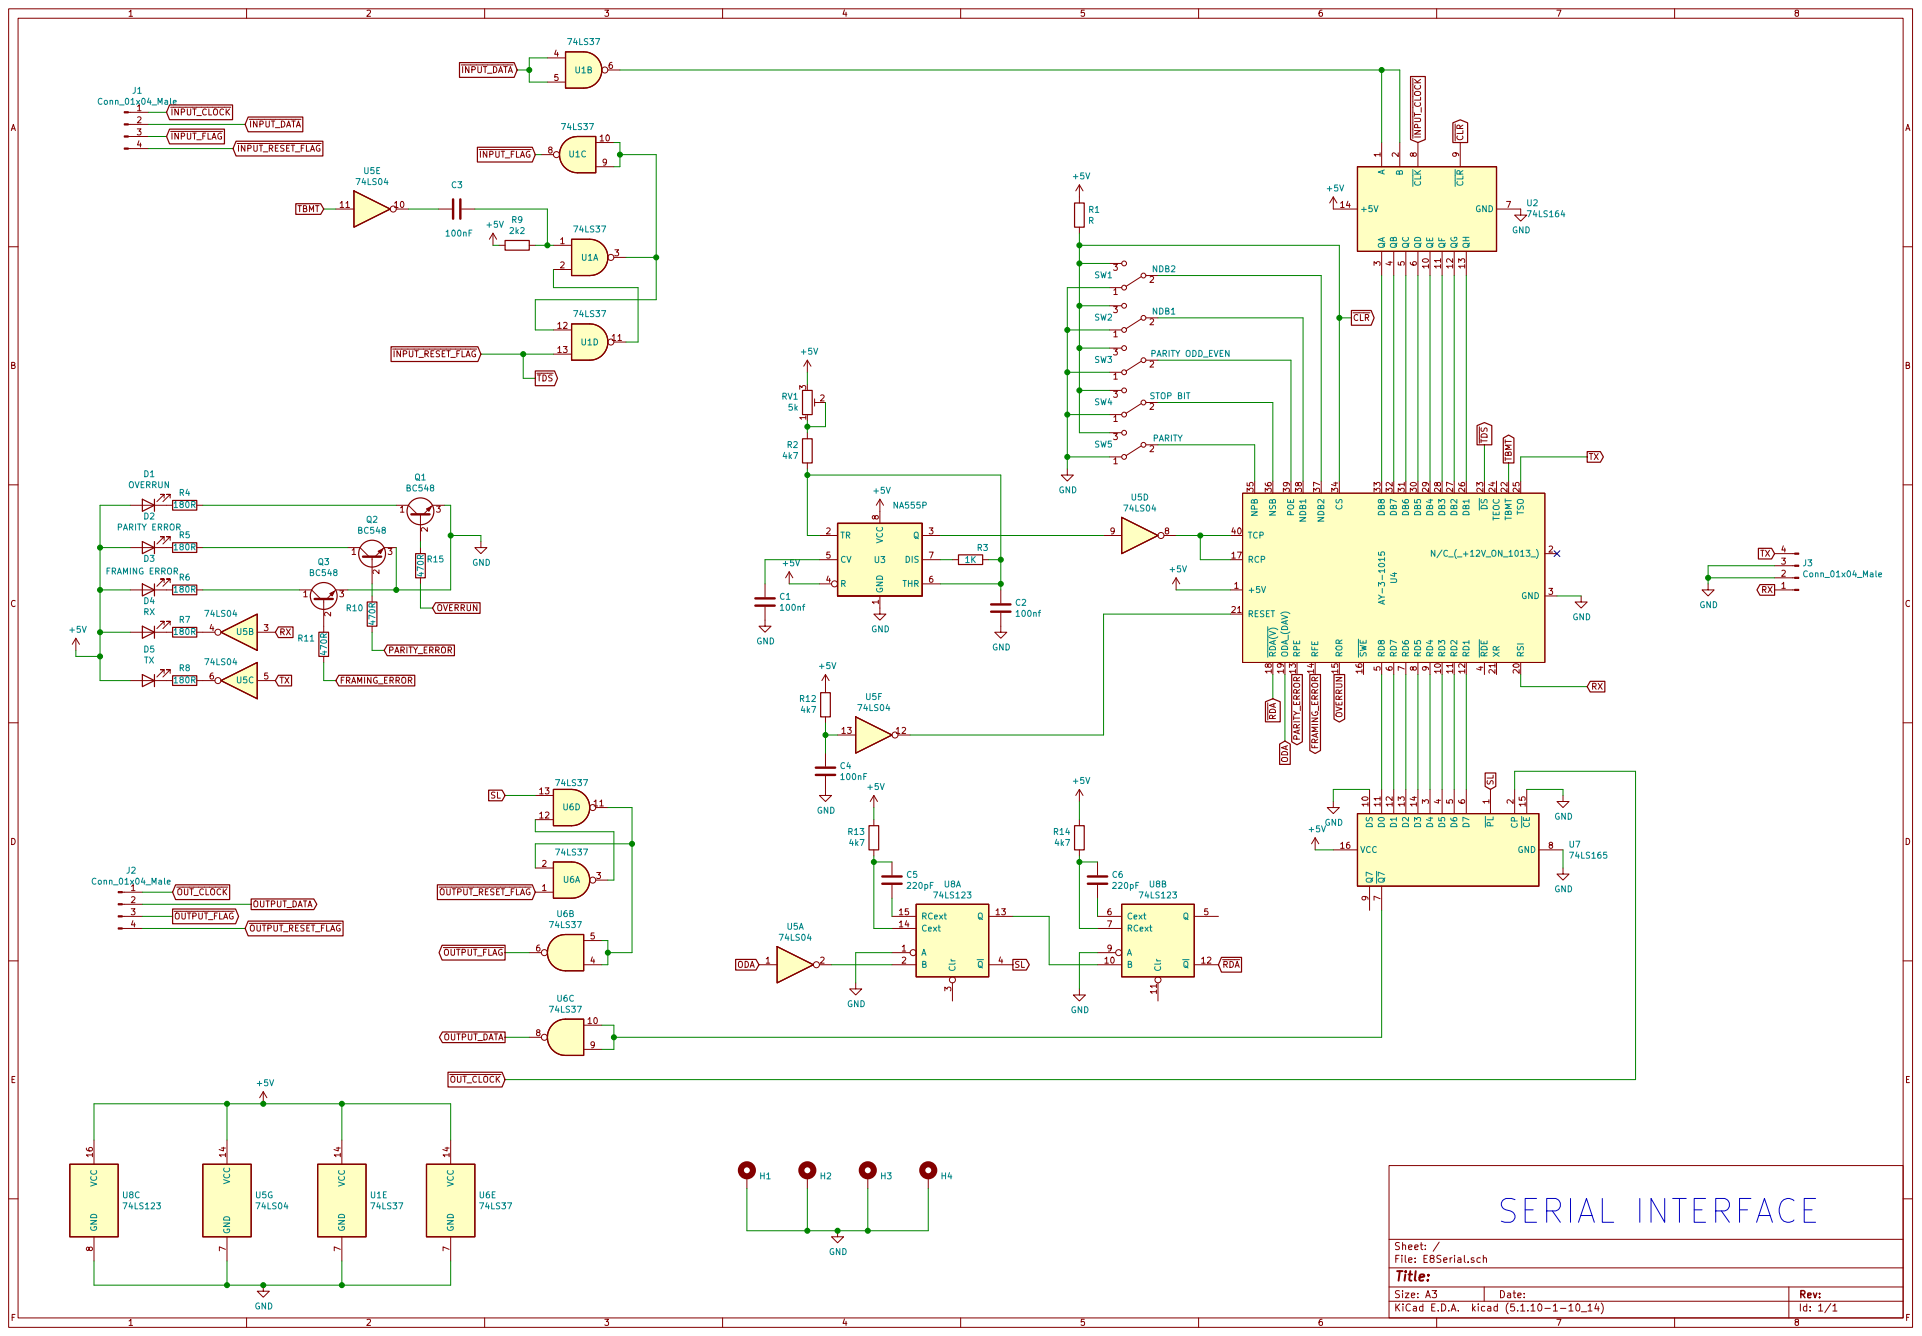
[picture p226: page 1]

1 DS 10 D0 11 D1 12 D2 13 D3 14 CE 15 VCC 16 CP
