ibm2030/EDUC8/octal. keyboard/octal keyboard/Octal Keyboard/octal keyboard.pdf

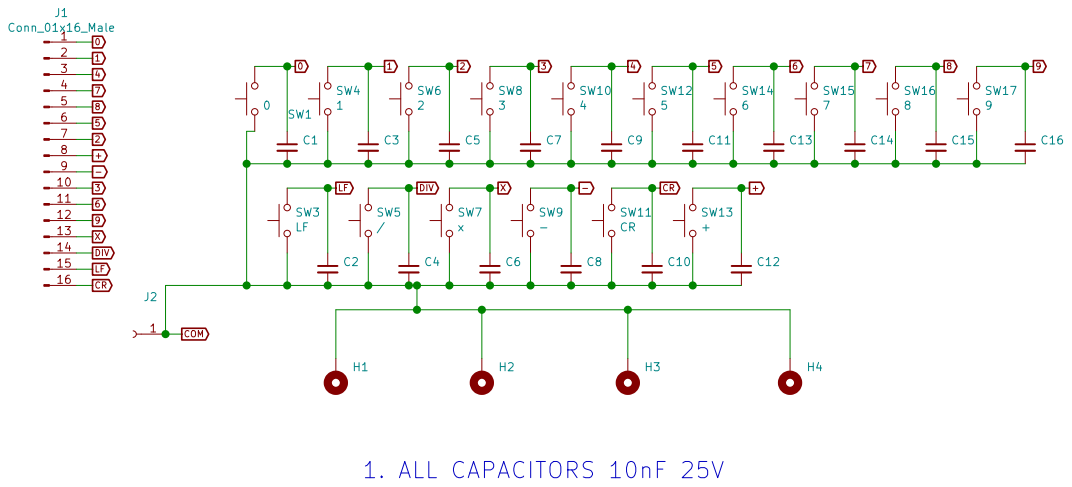
[picture p228: page 1]

File: octal keyboard.sch Sheet: /
Id: 1/1 Title:
