ibm2030/EDUC8/(list of files, drawings)

Other design files:
128 X 16 RAM V5 FINAL/temp-freerouting.dsn
