ibm2030/EDUC8/128 X 16 RAM V5 FINAL/128 X 16 RAM V4 FINAL .kicad_pcb

## KiCad design 128 X 16 RAM V5 FINAL/128 X 16 RAM V4 FINAL .kicad_pcb (2025-08-27)

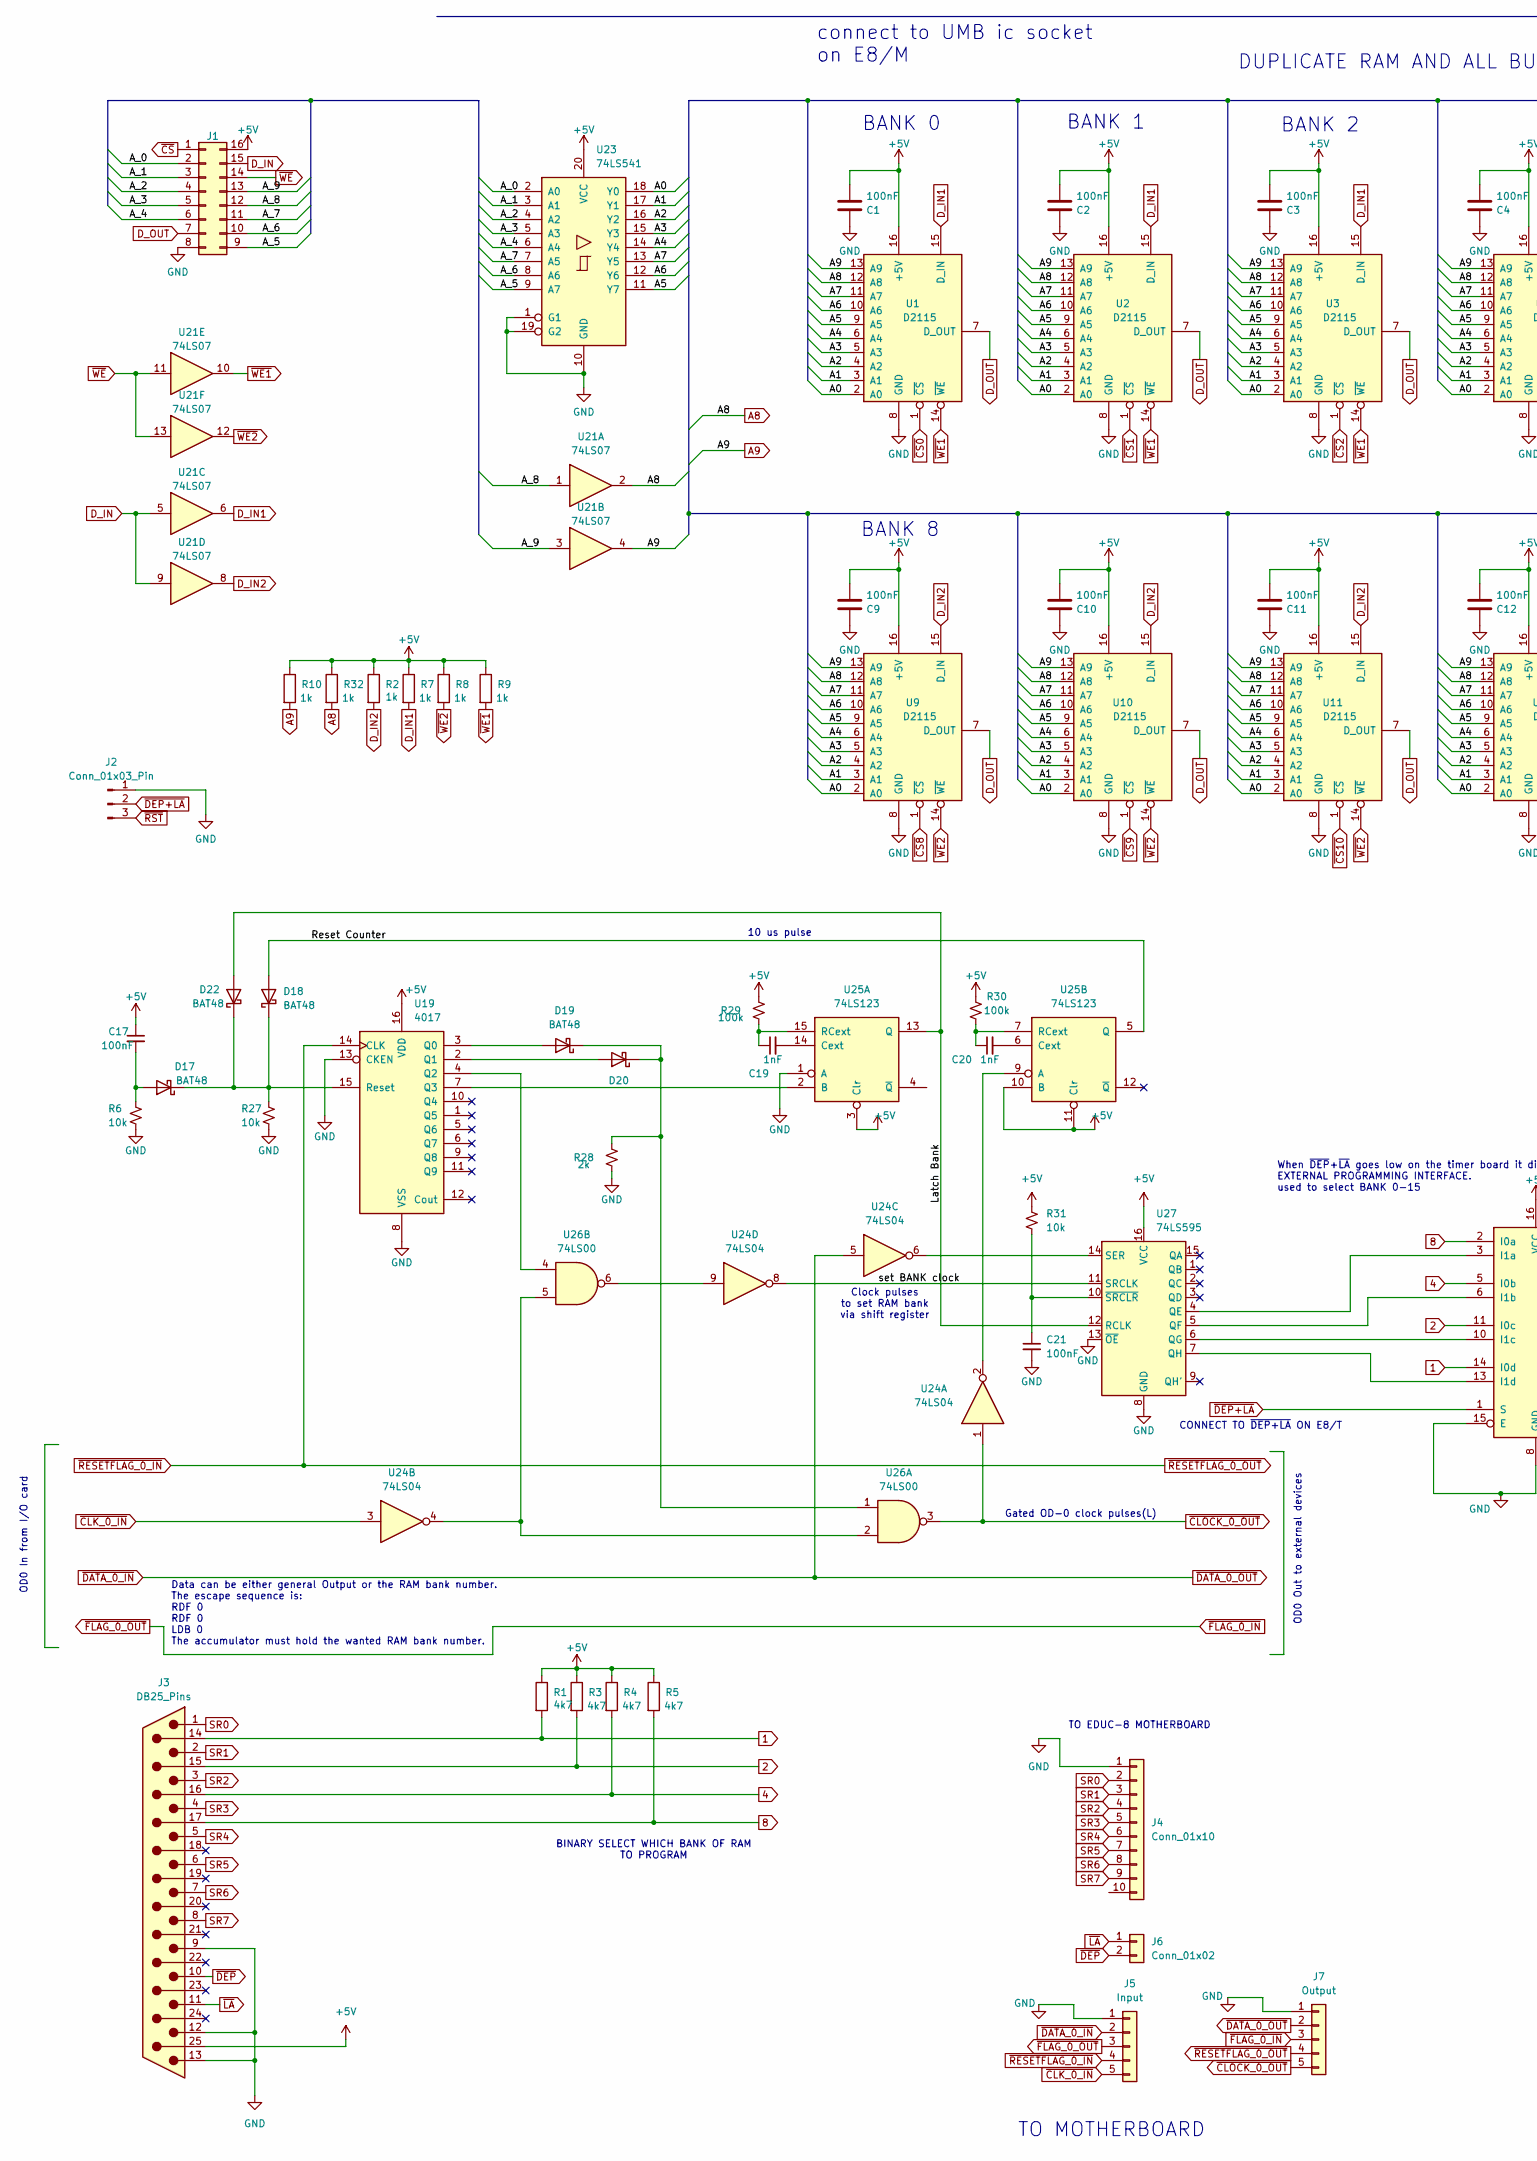
[picture p229: schematic 128 X 16 RAM V4 FINAL .kicad_sch, part in row 1, column 1]

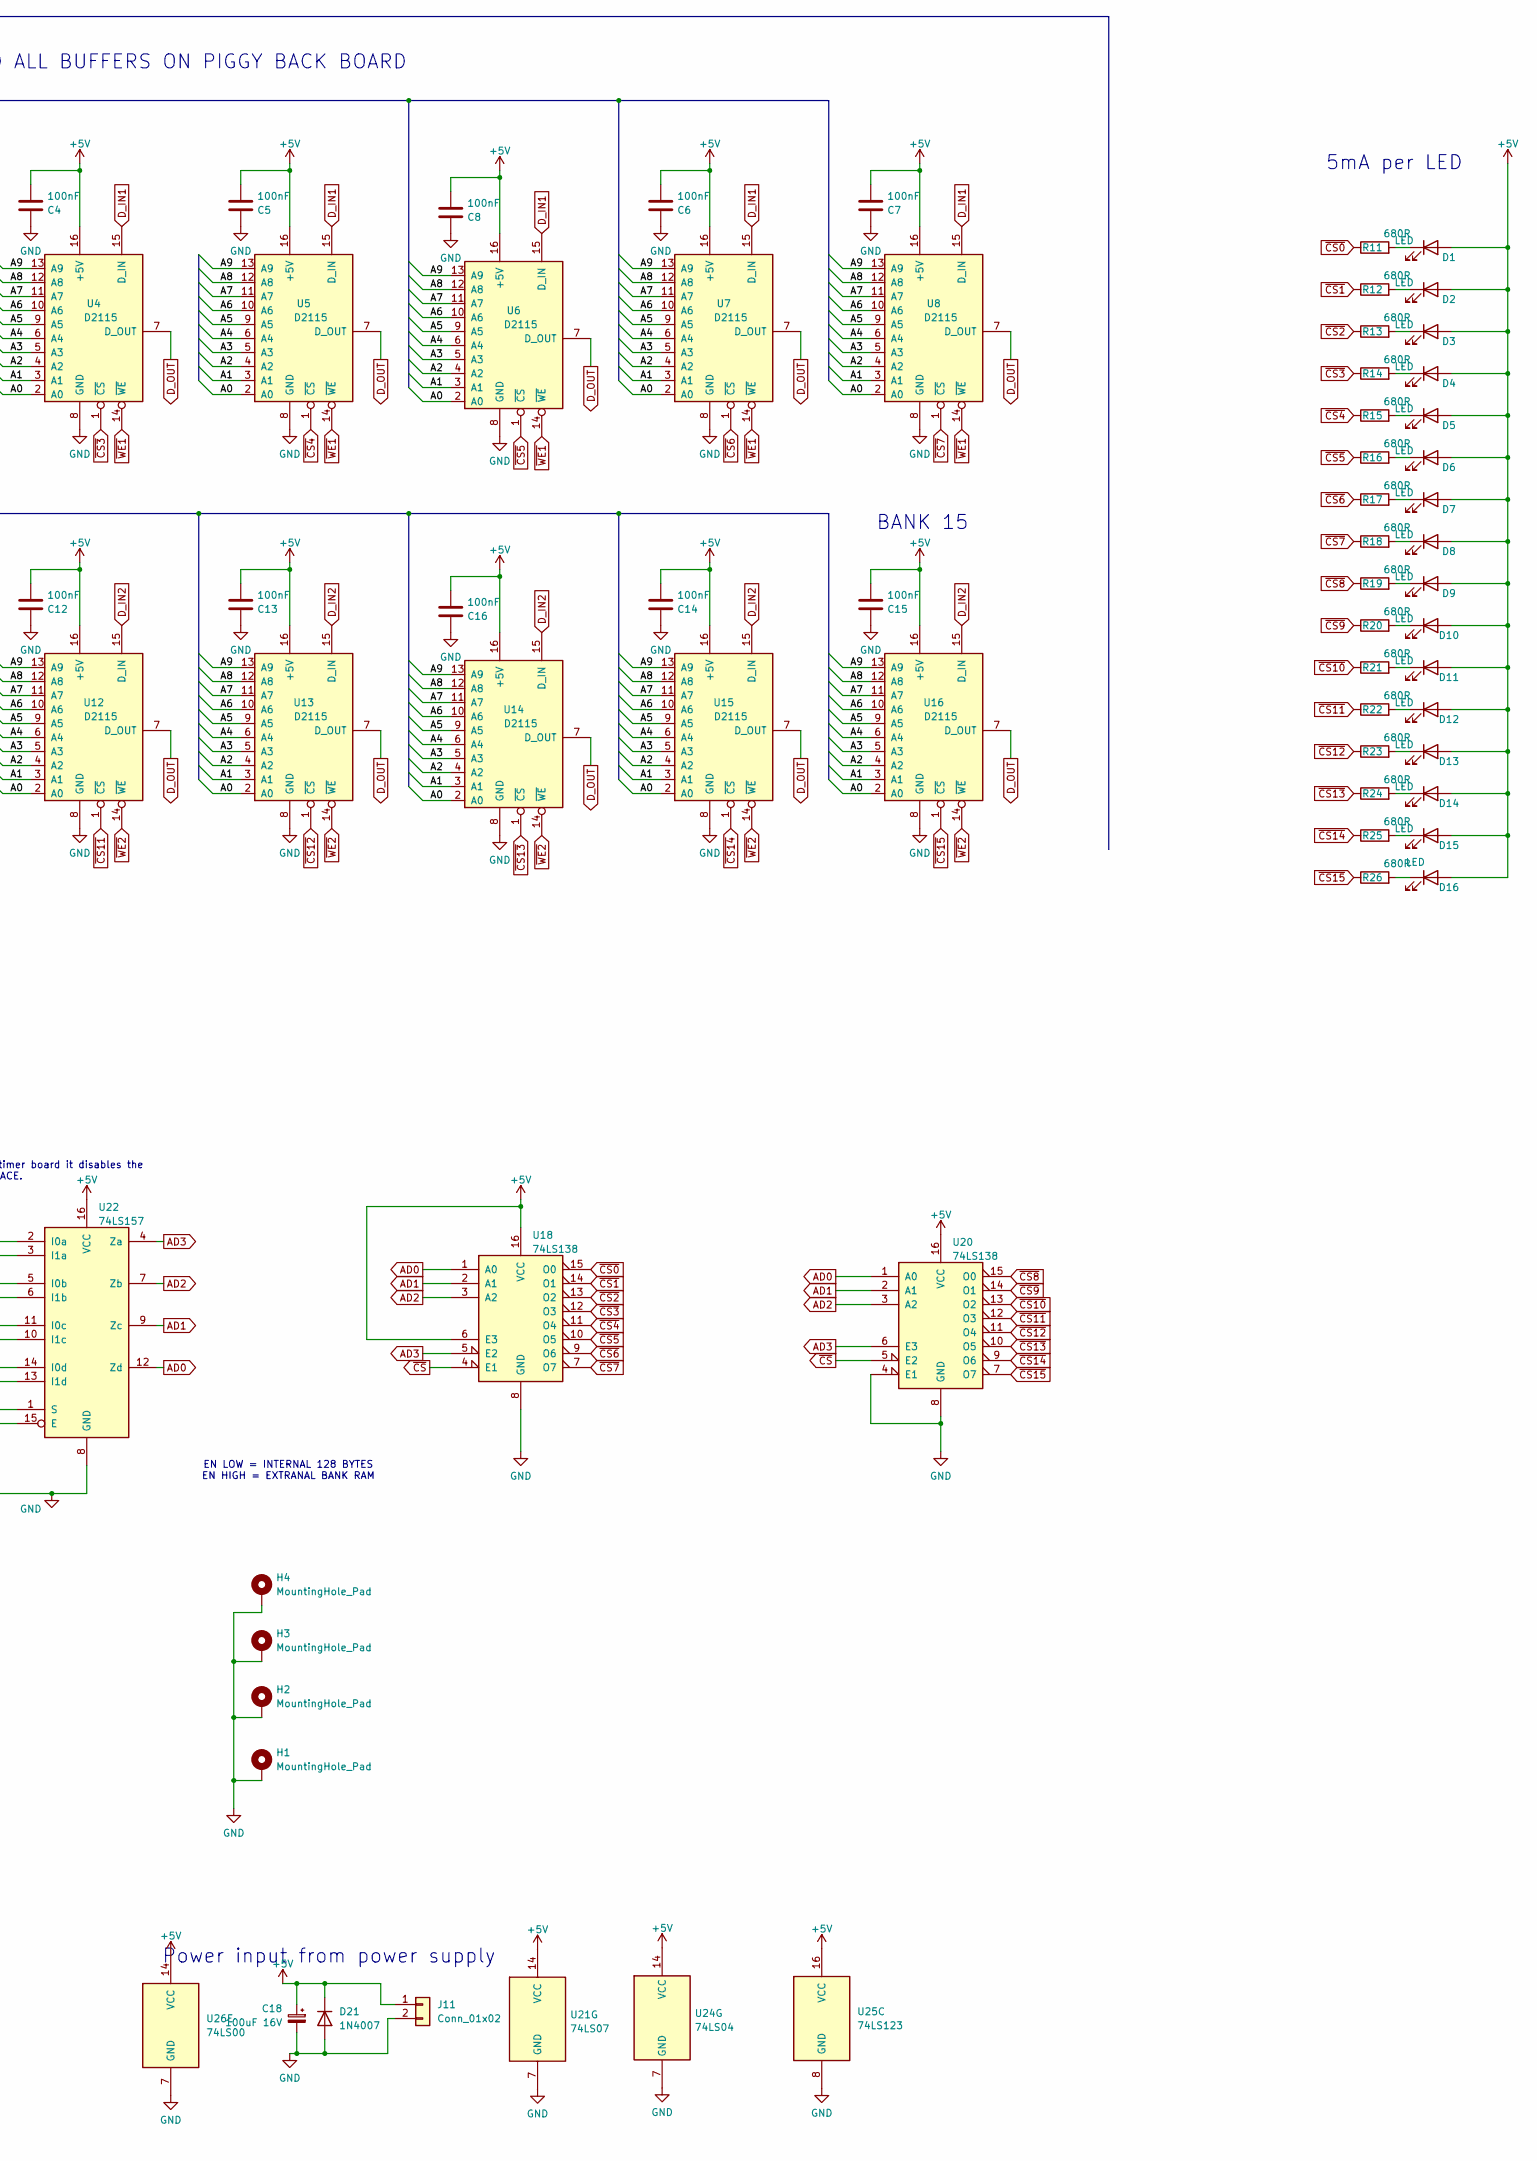
[picture p230: schematic 128 X 16 RAM V4 FINAL .kicad_sch, part in row 1, column 2]

Parts:
C1, C2, C3, C4, C5, C6, C7, C8, C9, C10, C11, C12, C13, C14, C15, C16, C17, C21: 100nF; C_Disc_D4.3mm_W1.9mm_P5.00mm
C18: 100uF 16V; CP_Radial_D12.5mm_P5.00mm
C19, C20: 1nF; C_Disc_D4.3mm_W1.9mm_P5.00mm
D1, D2, D3, D4, D5, D6, D7, D8, D9, D10, D11, D12, D13, D14, D15, D16: LED; LED_D3.0mm
D17, D18, D19, D20, D22: BAT48; D_DO-35_SOD27_P7.62mm_Horizontal
D21: 1N4007; D_DO-41_SOD81_P10.16mm_Horizontal
H1, H2, H3, H4: MountingHole_Pad; MountingHole_3.2mm_M3_DIN965_Pad
J1: Conn_02x08_Counter_Clockwise; DIP-16_W7.62mm_Socket_LongPads
J2: Conn_01x03_Pin; JST_XH_B3B-XH-A_1x03_P2.50mm_Vertical
J3: DB25_Pins; DSUB-25_Pins_Horizontal_P2.77x2.84mm_EdgePinOffset7.70mm_Ho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
J4: Conn_01x10; JST_XH_B10B-XH-A_1x10_P2.50mm_Vertical
J5: Input; JST_XH_B5B-XH-A_1x05_P2.50mm_Vertical
J6: Conn_01x02; JST_XH_B2B-XH-A_1x02_P2.50mm_Vertical
J7: Output; JST_XH_B5B-XH-A_1x05_P2.50mm_Vertical
J11: Conn_01x02; TerminalBlock_Phoenix_MKDS-1,5-2-5.08_1x02_P5.08mm_Horizont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
R1, R3, R4, R5: 4k7; R_Axial_DIN0207_L6.3mm_D2.5mm_P10.16mm_Horizontal
R2, R7, R8, R9, R10, R32: 1k; R_Axial_DIN0207_L6.3mm_D2.5mm_P10.16mm_Horizontal
R6, R27, R31: 10k; R_Axial_DIN0207_L6.3mm_D2.5mm_P10.16mm_Horizontal
R11, R12, R13, R14, R15, R16, R17, R18, R19, R20, R21, R22, R23, R24, R25, R26: 680R; R_Axial_DIN0207_L6.3mm_D2.5mm_P10.16mm_Horizontal
R28: 2k; R_Axial_DIN0207_L6.3mm_D2.5mm_P10.16mm_Horizontal
R29, R30: 100k; R_Axial_DIN0207_L6.3mm_D2.5mm_P10.16mm_Horizontal
U1, U2, U3, U4, U5, U6, U7, U8, U9, U10, U11, U12, U13, U14, U15, U16: D2115; DIP-16_W7.62mm_LongPads
U18, U20: 74LS138; DIP-16_W7.62mm_LongPads
U19: 4017; DIP-16_W7.62mm_LongPads
U21: 74LS07; DIP-14_W7.62mm_LongPads
U22: 74LS157; DIP-16_W7.62mm_LongPads
U23: 74LS541; DIP-20_W7.62mm_LongPads
U24: 74LS04; DIP-14_W7.62mm_LongPads
U25: 74LS123; DIP-16_W7.62mm_LongPads
U26: 74LS00; DIP-14_W7.62mm_LongPads
U27: 74LS595; DIP-16_W7.62mm

Connections:
1: J3.14, R1.2, U22.14 (I0d)
2: J3.15, R3.2, U22.11 (I0c)
4: J3.16, R4.2, U22.5 (I0b)
8: J3.17, R5.2, U22.2 (I0a)
+5V: C1.2, C2.2, C3.2, C4.2, C5.2, C6.2, C7.2, C8.2, C9.2, C10.2, C11.2, C12.2, C13.2, C14.2, C15.2, C16.2, C17.1, C18.1, D1.2 (A), D2.2 (A), D3.2 (A), D4.2 (A), D5.2 (A), D6.2 (A), D7.2 (A), D8.2 (A), D9.2 (A), D10.2 (A), D11.2 (A), D12.2 (A), D13.2 (A), D14.2 (A), D15.2 (A), D16.2 (A), D21.1 (K), J1.16, J3.25, J11.1, R1.1, R2.1, R3.1, R4.1, R5.1, R7.1, R8.1, R9.1, R10.1, R29.1, R30.1, R31.1, R32.1, U1.16 (+5V), U2.16 (+5V), U3.16 (+5V), U4.16 (+5V), U5.16 (+5V), U6.16 (+5V), U7.16 (+5V), U8.16 (+5V), U9.16 (+5V), U10.16 (+5V), U11.16 (+5V), U12.16 (+5V), U13.16 (+5V), U14.16 (+5V), U15.16 (+5V), U16.16 (+5V), U18.6 (E3), U18.16 (VCC), U19.16 (VDD), U20.16 (VCC), U21.14 (VCC), U22.16 (VCC), U23.20 (VCC), U24.14 (VCC), U25.3 (Clr), U25.10 (B), U25.11 (Clr), U25.16 (VCC), U26.14 (VCC), U27.16 (VCC)
/A0: U1.2 (A0), U2.2 (A0), U3.2 (A0), U4.2 (A0), U5.2 (A0), U6.2 (A0), U7.2 (A0), U8.2 (A0), U9.2 (A0), U10.2 (A0), U11.2 (A0), U12.2 (A0), U13.2 (A0), U14.2 (A0), U15.2 (A0), U16.2 (A0), U23.18 (Y0)
/A1: U1.3 (A1), U2.3 (A1), U3.3 (A1), U4.3 (A1), U5.3 (A1), U6.3 (A1), U7.3 (A1), U8.3 (A1), U9.3 (A1), U10.3 (A1), U11.3 (A1), U12.3 (A1), U13.3 (A1), U14.3 (A1), U15.3 (A1), U16.3 (A1), U23.17 (Y1)
/A2: U1.4 (A2), U2.4 (A2), U3.4 (A2), U4.4 (A2), U5.4 (A2), U6.4 (A2), U7.4 (A2), U8.4 (A2), U9.4 (A2), U10.4 (A2), U11.4 (A2), U12.4 (A2), U13.4 (A2), U14.4 (A2), U15.4 (A2), U16.4 (A2), U23.16 (Y2)
/A3: U1.5 (A3), U2.5 (A3), U3.5 (A3), U4.5 (A3), U5.5 (A3), U6.5 (A3), U7.5 (A3), U8.5 (A3), U9.5 (A3), U10.5 (A3), U11.5 (A3), U12.5 (A3), U13.5 (A3), U14.5 (A3), U15.5 (A3), U16.5 (A3), U23.15 (Y3)
/A4: U1.6 (A4), U2.6 (A4), U3.6 (A4), U4.6 (A4), U5.6 (A4), U6.6 (A4), U7.6 (A4), U8.6 (A4), U9.6 (A4), U10.6 (A4), U11.6 (A4), U12.6 (A4), U13.6 (A4), U14.6 (A4), U15.6 (A4), U16.6 (A4), U23.14 (Y4)
/A5: U1.9 (A5), U2.9 (A5), U3.9 (A5), U4.9 (A5), U5.9 (A5), U6.9 (A5), U7.9 (A5), U8.9 (A5), U9.9 (A5), U10.9 (A5), U11.9 (A5), U12.9 (A5), U13.9 (A5), U14.9 (A5), U15.9 (A5), U16.9 (A5), U23.11 (Y7)
/A6: U1.10 (A6), U2.10 (A6), U3.10 (A6), U4.10 (A6), U5.10 (A6), U6.10 (A6), U7.10 (A6), U8.10 (A6), U9.10 (A6), U10.10 (A6), U11.10 (A6), U12.10 (A6), U13.10 (A6), U14.10 (A6), U15.10 (A6), U16.10 (A6), U23.12 (Y6)
/A7: U1.11 (A7), U2.11 (A7), U3.11 (A7), U4.11 (A7), U5.11 (A7), U6.11 (A7), U7.11 (A7), U8.11 (A7), U9.11 (A7), U10.11 (A7), U11.11 (A7), U12.11 (A7), U13.11 (A7), U14.11 (A7), U15.11 (A7), U16.11 (A7), U23.13 (Y5)
/A_0: J1.2, U23.2 (A0)
/A_1: J1.3, U23.3 (A1)
/A_2: J1.4, U23.4 (A2)
/A_3: J1.5, U23.5 (A3)
/A_4: J1.6, U23.6 (A4)
/A_5: J1.9, U23.9 (A7)
/A_6: J1.10, U23.8 (A6)
/A_7: J1.11, U23.7 (A5)
/A_8: J1.12, U21.1
/A_9: J1.13, U21.3
/Latch Bank: D22.2 (A), U25.13 (Q), U27.12 (RCLK)
/Reset Counter: D18.2 (A), U25.5 (Q)
/set BANK clock: U24.8, U27.11 (SRCLK)
A8: R32.2, U1.12 (A8), U2.12 (A8), U3.12 (A8), U4.12 (A8), U5.12 (A8), U6.12 (A8), U7.12 (A8), U8.12 (A8), U9.12 (A8), U10.12 (A8), U11.12 (A8), U12.12 (A8), U13.12 (A8), U14.12 (A8), U15.12 (A8), U16.12 (A8), U21.2
A9: R10.2, U1.13 (A9), U2.13 (A9), U3.13 (A9), U4.13 (A9), U5.13 (A9), U6.13 (A9), U7.13 (A9), U8.13 (A9), U9.13 (A9), U10.13 (A9), U11.13 (A9), U12.13 (A9), U13.13 (A9), U14.13 (A9), U15.13 (A9), U16.13 (A9), U21.4
AD0: U18.1 (A0), U20.1 (A0), U22.12 (Zd)
AD1: U18.2 (A1), U20.2 (A1), U22.9 (Zc)
AD2: U18.3 (A2), U20.3 (A2), U22.7 (Zb)
AD3: U18.5 (E2), U20.6 (E3), U22.4 (Za)
D_IN: J1.15, U21.5, U21.9
D_IN1: R7.2, U1.15 (D_IN), U2.15 (D_IN), U3.15 (D_IN), U4.15 (D_IN), U5.15 (D_IN), U6.15 (D_IN), U7.15 (D_IN), U8.15 (D_IN), U21.6
D_IN2: R2.2, U9.15 (D_IN), U10.15 (D_IN), U11.15 (D_IN), U12.15 (D_IN), U13.15 (D_IN), U14.15 (D_IN), U15.15 (D_IN), U16.15 (D_IN), U21.8
D_OUT: J1.7, U1.7 (D_OUT), U2.7 (D_OUT), U3.7 (D_OUT), U4.7 (D_OUT), U5.7 (D_OUT), U6.7 (D_OUT), U7.7 (D_OUT), U8.7 (D_OUT), U9.7 (D_OUT), U10.7 (D_OUT), U11.7 (D_OUT), U12.7 (D_OUT), U13.7 (D_OUT), U14.7 (D_OUT), U15.7 (D_OUT), U16.7 (D_OUT)
GND: C1.1, C2.1, C3.1, C4.1, C5.1, C6.1, C7.1, C8.1, C9.1, C10.1, C11.1, C12.1, C13.1, C14.1, C15.1, C16.1, C18.2, C21.2, D21.2 (A), H1.1, H2.1, H3.1, H4.1, J1.8, J2.1, J3.9, J3.12, J3.13, J4.1, J5.1, J7.1, J11.2, R6.2, R27.2, R28.2, U1.8 (GND), U2.8 (GND), U3.8 (GND), U4.8 (GND), U5.8 (GND), U6.8 (GND), U7.8 (GND), U8.8 (GND), U9.8 (GND), U10.8 (GND), U11.8 (GND), U12.8 (GND), U13.8 (GND), U14.8 (GND), U15.8 (GND), U16.8 (GND), U18.8 (GND), U19.8 (VSS), U19.13 (CKEN), U20.4 (E1), U20.8 (GND), U21.7 (GND), U22.8 (GND), U22.15 (E), U23.1 (G1), U23.10 (GND), U23.19 (G2), U24.7 (GND), U25.1 (A), U25.8 (GND), U26.7 (GND), U27.8 (GND), U27.13 (~OE)
unnamed: D1.1 (K), R11.2
unnamed: D2.1 (K), R12.2
unnamed: D3.1 (K), R13.2
unnamed: D4.1 (K), R14.2
unnamed: D5.1 (K), R15.2
unnamed: D6.1 (K), R16.2
unnamed: D7.1 (K), R17.2
unnamed: D8.1 (K), R18.2
unnamed: D9.1 (K), R19.2
unnamed: D10.1 (K), R20.2
unnamed: D11.1 (K), R21.2
unnamed: D12.1 (K), R22.2
unnamed: D13.1 (K), R23.2
unnamed: D14.1 (K), R24.2
unnamed: D15.1 (K), R25.2
unnamed: D16.1 (K), R26.2
unnamed: C17.2, D17.2 (A), R6.1
unnamed: D17.1 (K), D18.1 (K), D22.1 (K), R27.1, U19.15 (Reset)
unnamed: D19.2 (A), U19.3 (Q0)
unnamed: D19.1 (K), D20.1 (K), R28.1, U26.1
unnamed: D20.2 (A), U19.2 (Q1)
unnamed: U19.4 (Q2), U26.4
unnamed: U19.7 (Q3), U25.2 (B)
unnamed: U22.3 (I1a), U27.4 (QE)
unnamed: U22.6 (I1b), U27.5 (QF)
unnamed: U22.10 (I1c), U27.6 (QG)
unnamed: U22.13 (I1d), U27.7 (QH)
unnamed: U24.4, U26.2, U26.5
unnamed: U24.9, U26.6
unnamed: C19.2, U25.14 (Cext)
unnamed: C19.1, R29.2, U25.15 (RCext)
unnamed: U24.2, U25.9 (A)
unnamed: C20.2, U25.6 (Cext)
unnamed: C20.1, R30.2, U25.7 (RCext)
unnamed: U24.6, U27.14 (SER)
unnamed: C21.1, R31.2, U27.10 (~SRCLR)
SR0: J3.1, J4.2
SR1: J3.2, J4.3
SR2: J3.3, J4.4
SR3: J3.4, J4.5
SR4: J3.5, J4.6
SR5: J3.6, J4.7
SR6: J3.7, J4.8
SR7: J3.8, J4.9
~CLK_0_IN: J5.5, U24.3
~CLOCK_0_OUT: J7.5, U24.1, U26.3
~CS0: R11.1, U1.1 (~CS), U18.15 (O0)
~CS1: R12.1, U2.1 (~CS), U18.14 (O1)
~CS2: R13.1, U3.1 (~CS), U18.13 (O2)
~CS3: R14.1, U4.1 (~CS), U18.12 (O3)
~CS4: R15.1, U5.1 (~CS), U18.11 (O4)
~CS5: R16.1, U6.1 (~CS), U18.10 (O5)
~CS6: R17.1, U7.1 (~CS), U18.9 (O6)
~CS7: R18.1, U8.1 (~CS), U18.7 (O7)
~CS8: R19.1, U9.1 (~CS), U20.15 (O0)
~CS9: R20.1, U10.1 (~CS), U20.14 (O1)
~CS10: R21.1, U11.1 (~CS), U20.13 (O2)
~CS11: R22.1, U12.1 (~CS), U20.12 (O3)
~CS12: R23.1, U13.1 (~CS), U20.11 (O4)
~CS13: R24.1, U14.1 (~CS), U20.10 (O5)
~CS14: R25.1, U15.1 (~CS), U20.9 (O6)
~CS15: R26.1, U16.1 (~CS), U20.7 (O7)
~CS: J1.1, U18.4 (E1), U20.5 (E2)
~DATA_0_IN: J5.2, J7.2, U24.5
~DEP+LA: J2.2, U22.1 (S)
~DEP: J3.10, J6.2
~FLAG_0_IN: J5.3, J7.3
~LA: J3.11, J6.1
~RESETFLAG_0_IN: J5.4, J7.4, U19.14 (CLK)
~RST: J2.3
~WE1: R9.2, U1.14 (~WE), U2.14 (~WE), U3.14 (~WE), U4.14 (~WE), U5.14 (~WE), U6.14 (~WE), U7.14 (~WE), U8.14 (~WE), U21.10
~WE2: R8.2, U9.14 (~WE), U10.14 (~WE), U11.14 (~WE), U12.14 (~WE), U13.14 (~WE), U14.14 (~WE), U15.14 (~WE), U16.14 (~WE), U21.12
~WE: J1.14, U21.11, U21.13

Notes on the sheet:
connect to UMB ic socket on E8/M
10 us pulse
BANK 15
EN LOW = INTERNAL 128 BYTES EN HIGH = EXTRANAL BANK RAM
BANK 0
DUPLICATE RAM AND ALL BUFFERS ON PIGGY BACK BOARD
Gated OD-0 clock pulses(L)
TO EDUC-8 MOTHERBOARD
OD0 Out to external devices
When ~{DEP}+~{LA} goes low on the timer board it disables the EXTERNAL PROGRAMMING INTERFACE. used to select BANK 0-15
OD0 In from I/O card
Clock pulses to set RAM bank via shift register
Power input from power supply
BANK 8
5mA per LED
Data can be either general Output or the RAM bank number. The escape sequence is: RDF 0 RDF 0 LDB 0 The accumulator must hold the wanted RAM bank number.
BANK 1
BANK 2
CONNECT TO ~{DEP+LA} ON E8/T
TO MOTHERBOARD
BINARY SELECT WHICH BANK OF RAM TO PROGRAM

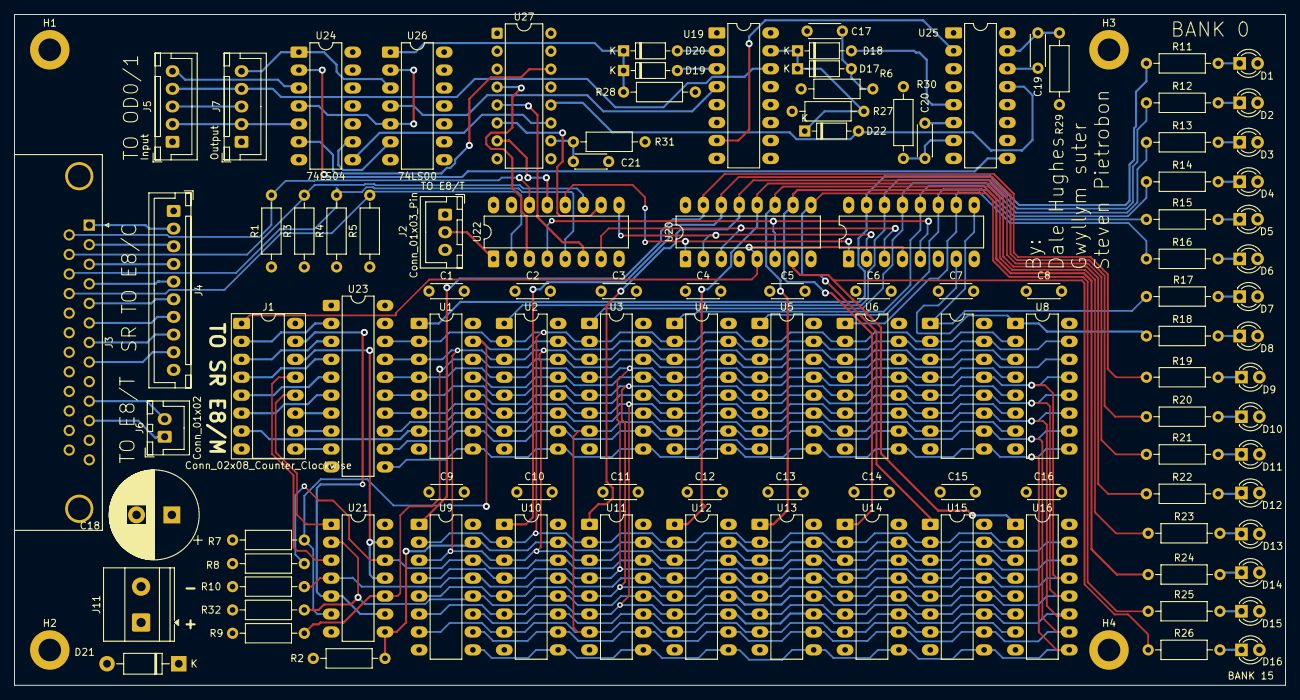
[picture p231: board 128 X 16 RAM V4 FINAL .kicad_pcb from above]

Board: 4 copper layers, 180.0 x 95.0 mm, 113 parts (0 on the bottom side), 109 nets.
