ibm2030/EDUC8/E8Serial/RS232/RS232.kicad_pcb

## KiCad design E8Serial/RS232/RS232.kicad_pcb (2025-07-23)

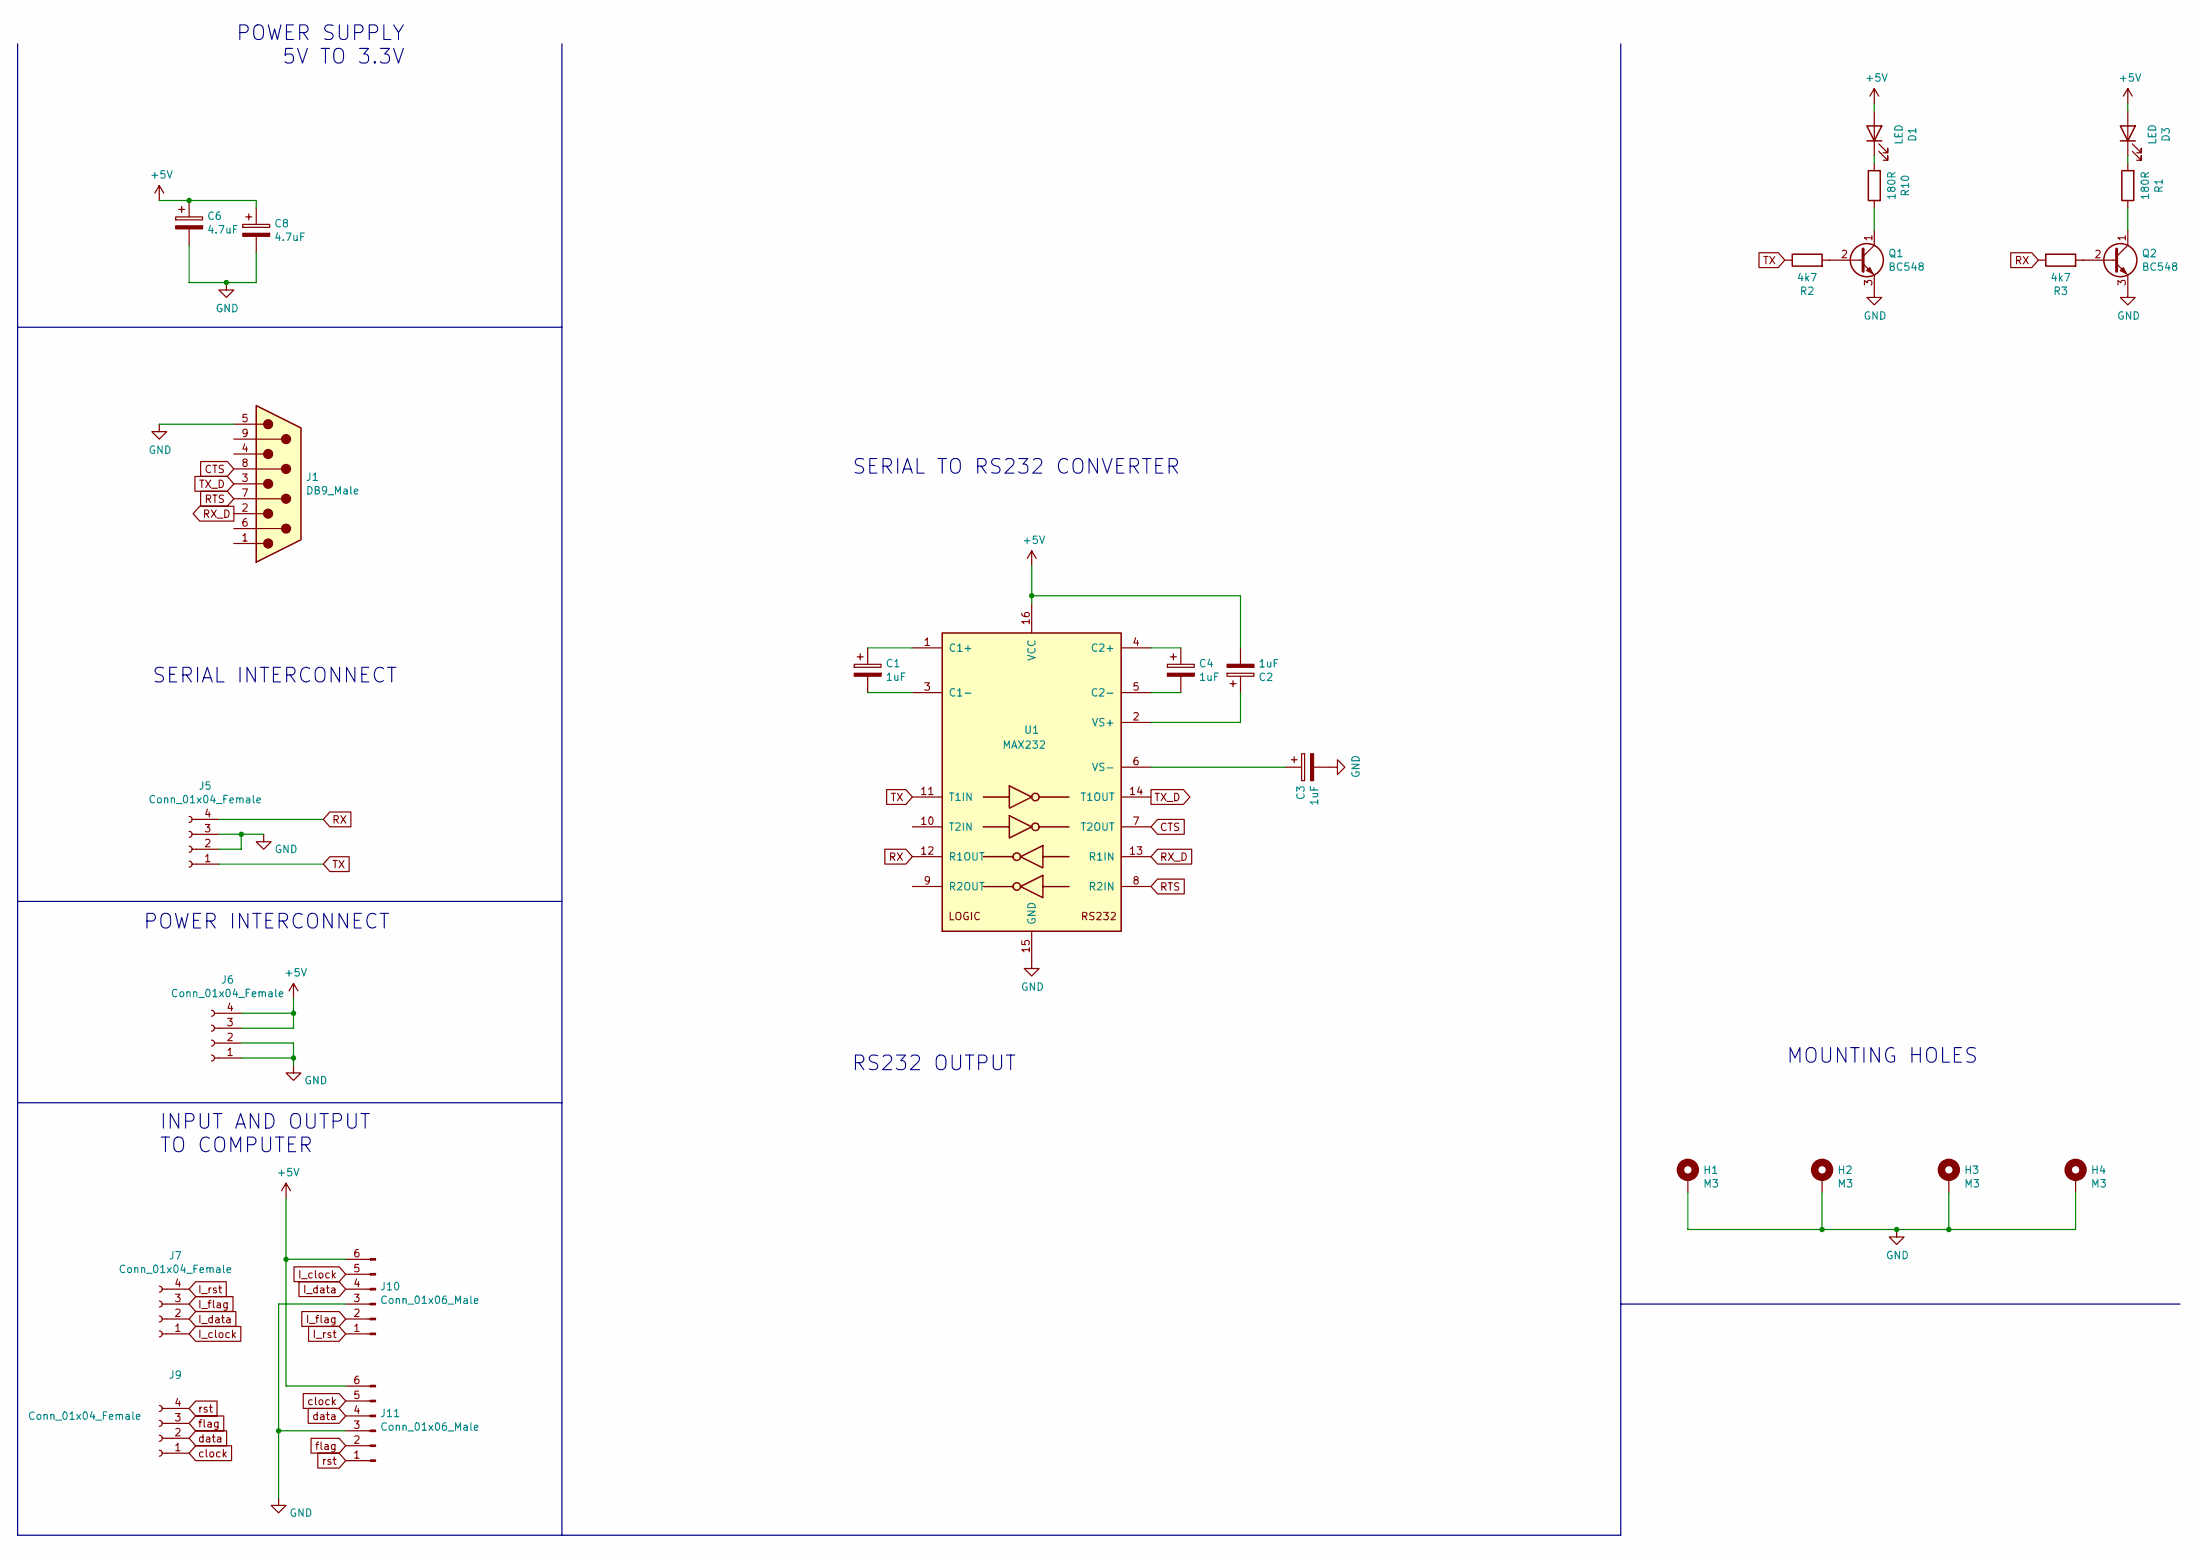
[picture p232: schematic RS232.kicad_sch, ASCII VIDEO TERMINAL]

Parts:
C1, C2, C3, C4: 1uF; CP_Radial_D5.0mm_P2.50mm
C6, C8: 4.7uF; CP_Axial_L11.0mm_D6.0mm_P18.00mm_Horizontal
D1, D3: LED; LED_D5.0mm_Horizontal_O1.27mm_Z3.0mm
H1, H2, H3, H4: M3; MountingHole_3.2mm_M3_Pad_Via
J1: DB9_Male; DSUB-9_Male_Horizontal_P2.77x2.84mm_EdgePinOffset4.94mm_Hou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
J5, J6, J7, J9: Conn_01x04_Female; PinSocket_1x04_P2.54mm_Vertical
J10, J11: Conn_01x06_Male; Molex_KK-254_AE-6410-06A_1x06_P2.54mm_Vertical
Q1, Q2: BC548; TO-92_Inline_Wide
R1, R10: 180R; R_Axial_DIN0207_L6.3mm_D2.5mm_P10.16mm_Horizontal
R2, R3: 4k7; R_Axial_DIN0207_L6.3mm_D2.5mm_P10.16mm_Horizontal
U1: MAX232; DIP-16_W7.62mm

Connections:
+5V: C2.2, C6.1, C8.1, D1.2 (A), D3.2 (A), J6.3, J6.4, J10.6, J11.6, U1.16 (VCC)
CTS: J1.8, U1.7 (T2OUT)
GND: C3.2, C6.2, C8.2, H1.1, H2.1, H3.1, H4.1, J1.5, J5.2, J5.3, J6.1, J6.2, J10.3, J11.3, Q1.3 (E), Q2.3 (E), U1.15 (GND)
I_clock: J7.1, J10.5
I_data: J7.2, J10.4
I_flag: J7.3, J10.2
I_rst: J7.4, J10.1
unnamed: C1.1, U1.1 (C1+)
unnamed: C1.2, U1.3 (C1-)
unnamed: C2.1, U1.2 (VS+)
unnamed: C3.1, U1.6 (VS-)
unnamed: C4.1, U1.4 (C2+)
unnamed: C4.2, U1.5 (C2-)
unnamed: D1.1 (K), R10.2
unnamed: D3.1 (K), R1.2
unnamed: Q1.1 (C), R10.1
unnamed: Q1.2 (B), R2.2
unnamed: Q2.1 (C), R1.1
unnamed: Q2.2 (B), R3.2
RTS: J1.7, U1.8 (R2IN)
RX: J5.4, R3.1, U1.12 (R1OUT)
RX_D: J1.2, U1.13 (R1IN)
TX: J5.1, R2.1, U1.11 (T1IN)
TX_D: J1.3, U1.14 (T1OUT)
clock: J9.1, J11.5
data: J9.2, J11.4
flag: J9.3, J11.2
rst: J9.4, J11.1

Notes on the sheet:
SERIAL INTERCONNECT
POWER INTERCONNECT
MOUNTING HOLES
SERIAL TO RS232 CONVERTER
POWER SUPPLY 5V TO 3.3V
RS232 OUTPUT
INPUT AND OUTPUT TO COMPUTER

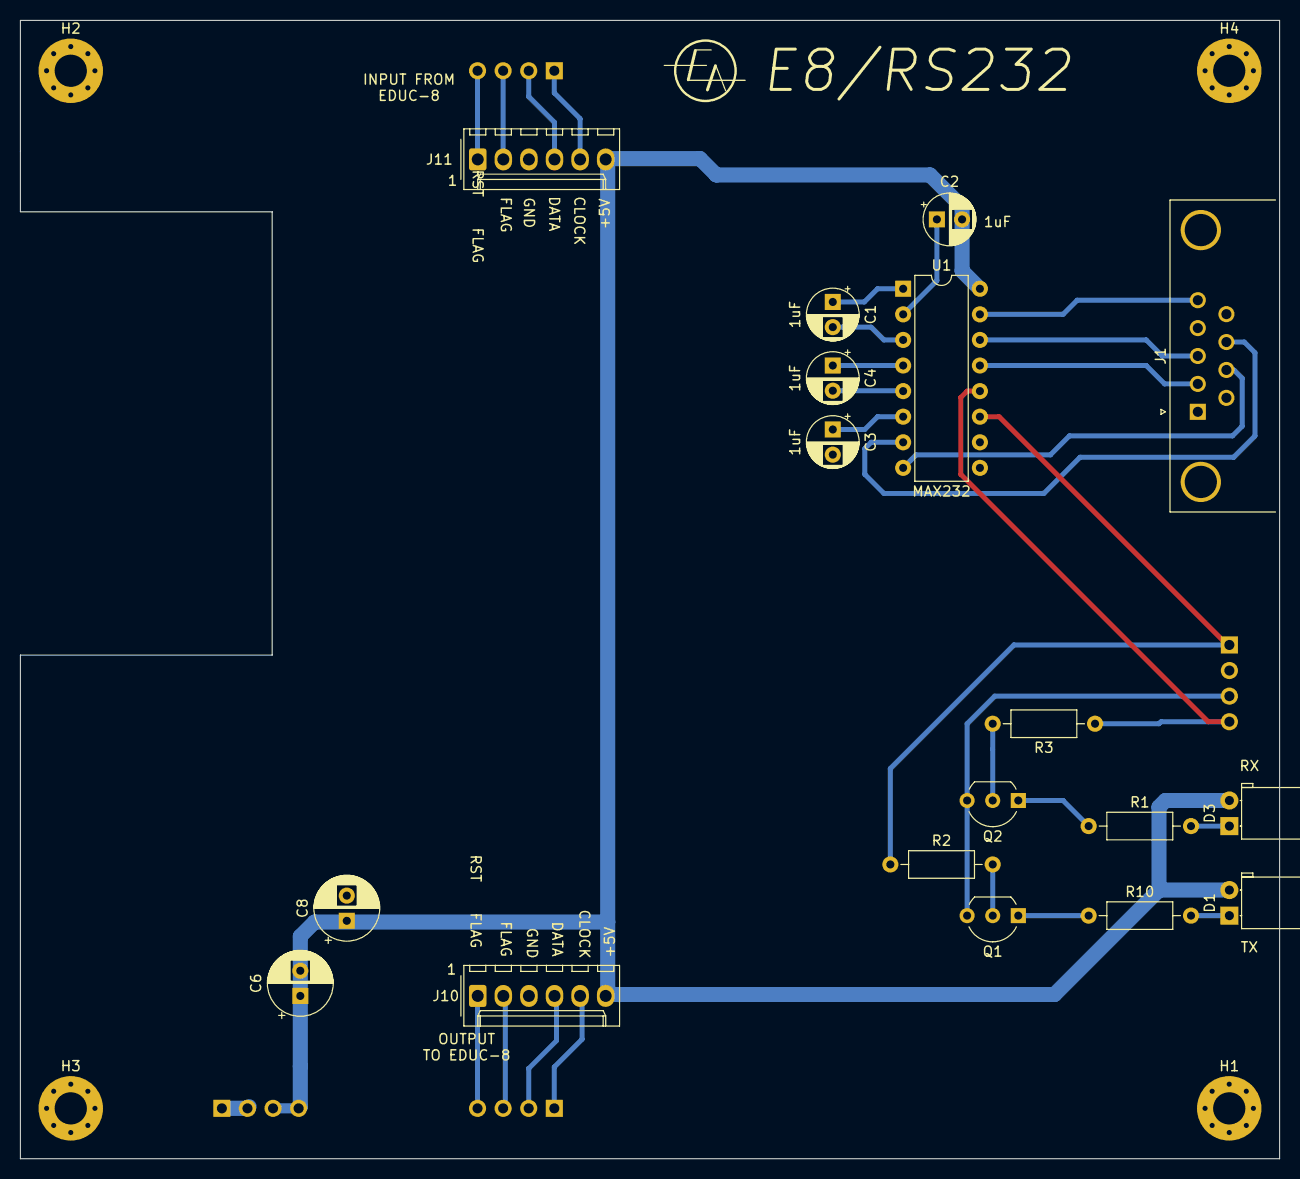
[picture p233: board E8Serial/RS232/RS232.kicad_pcb from above]

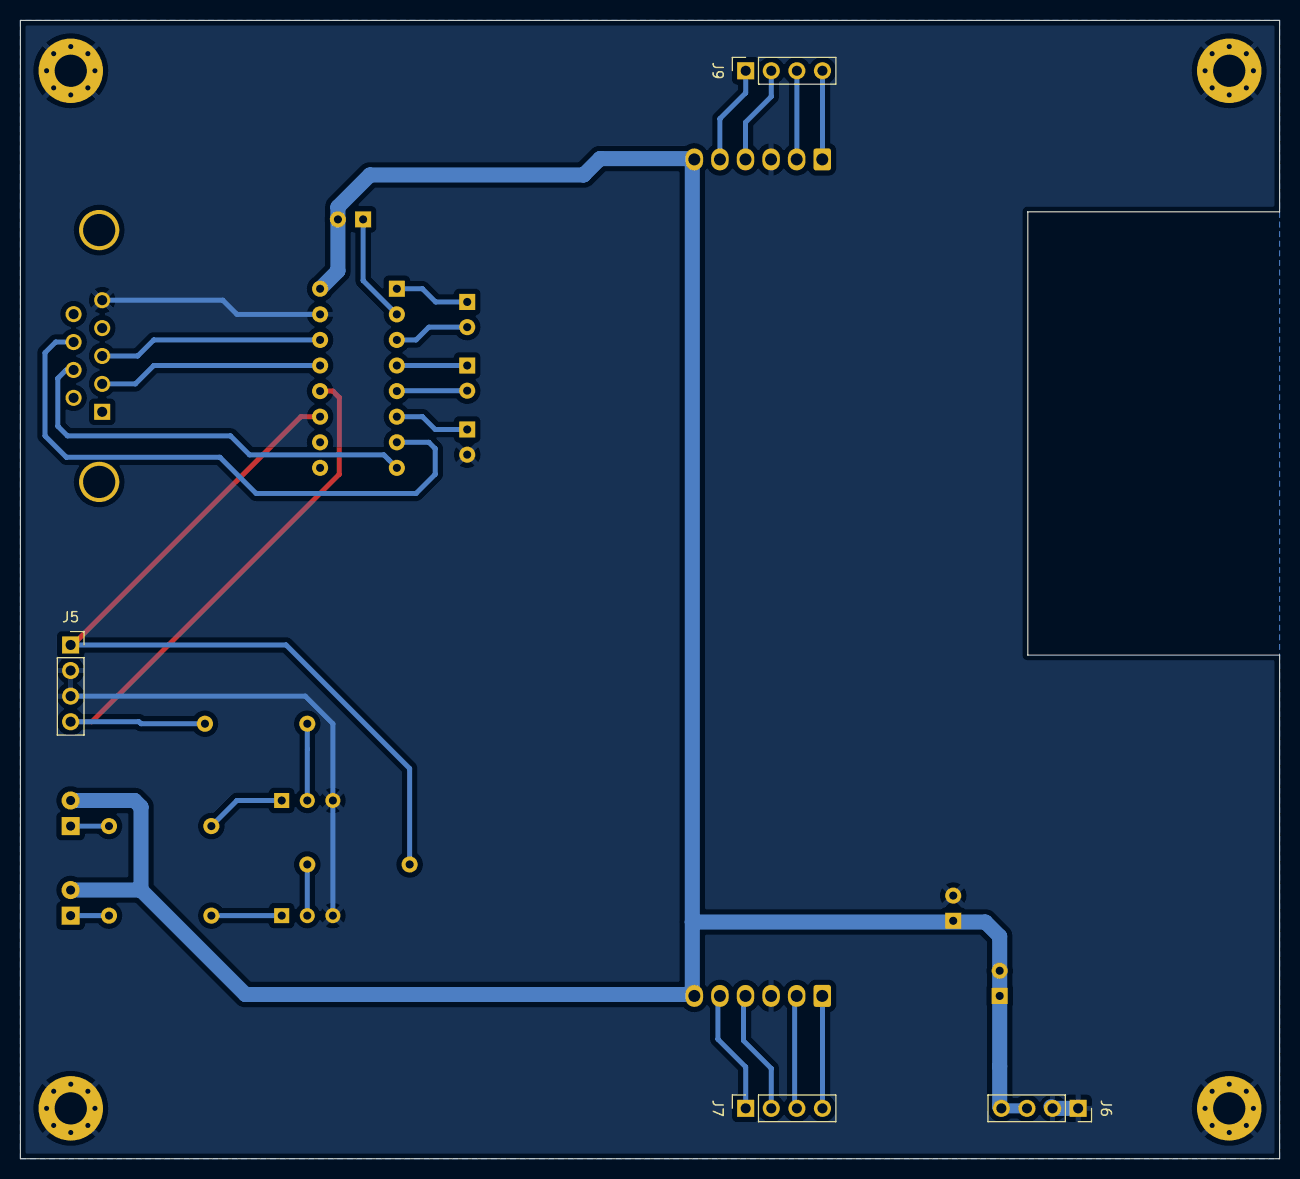
[picture p234: board E8Serial/RS232/RS232.kicad_pcb from below]

Board: 2 copper layers, 125.0 x 113.0 mm, 26 parts (4 on the bottom side), 28 nets.
