ibm2030/EDUC8/Power Supply/EDUC-8 PSU.kicad_pcb

## KiCad design Power Supply/EDUC-8 PSU.kicad_pcb (2025-07-23)

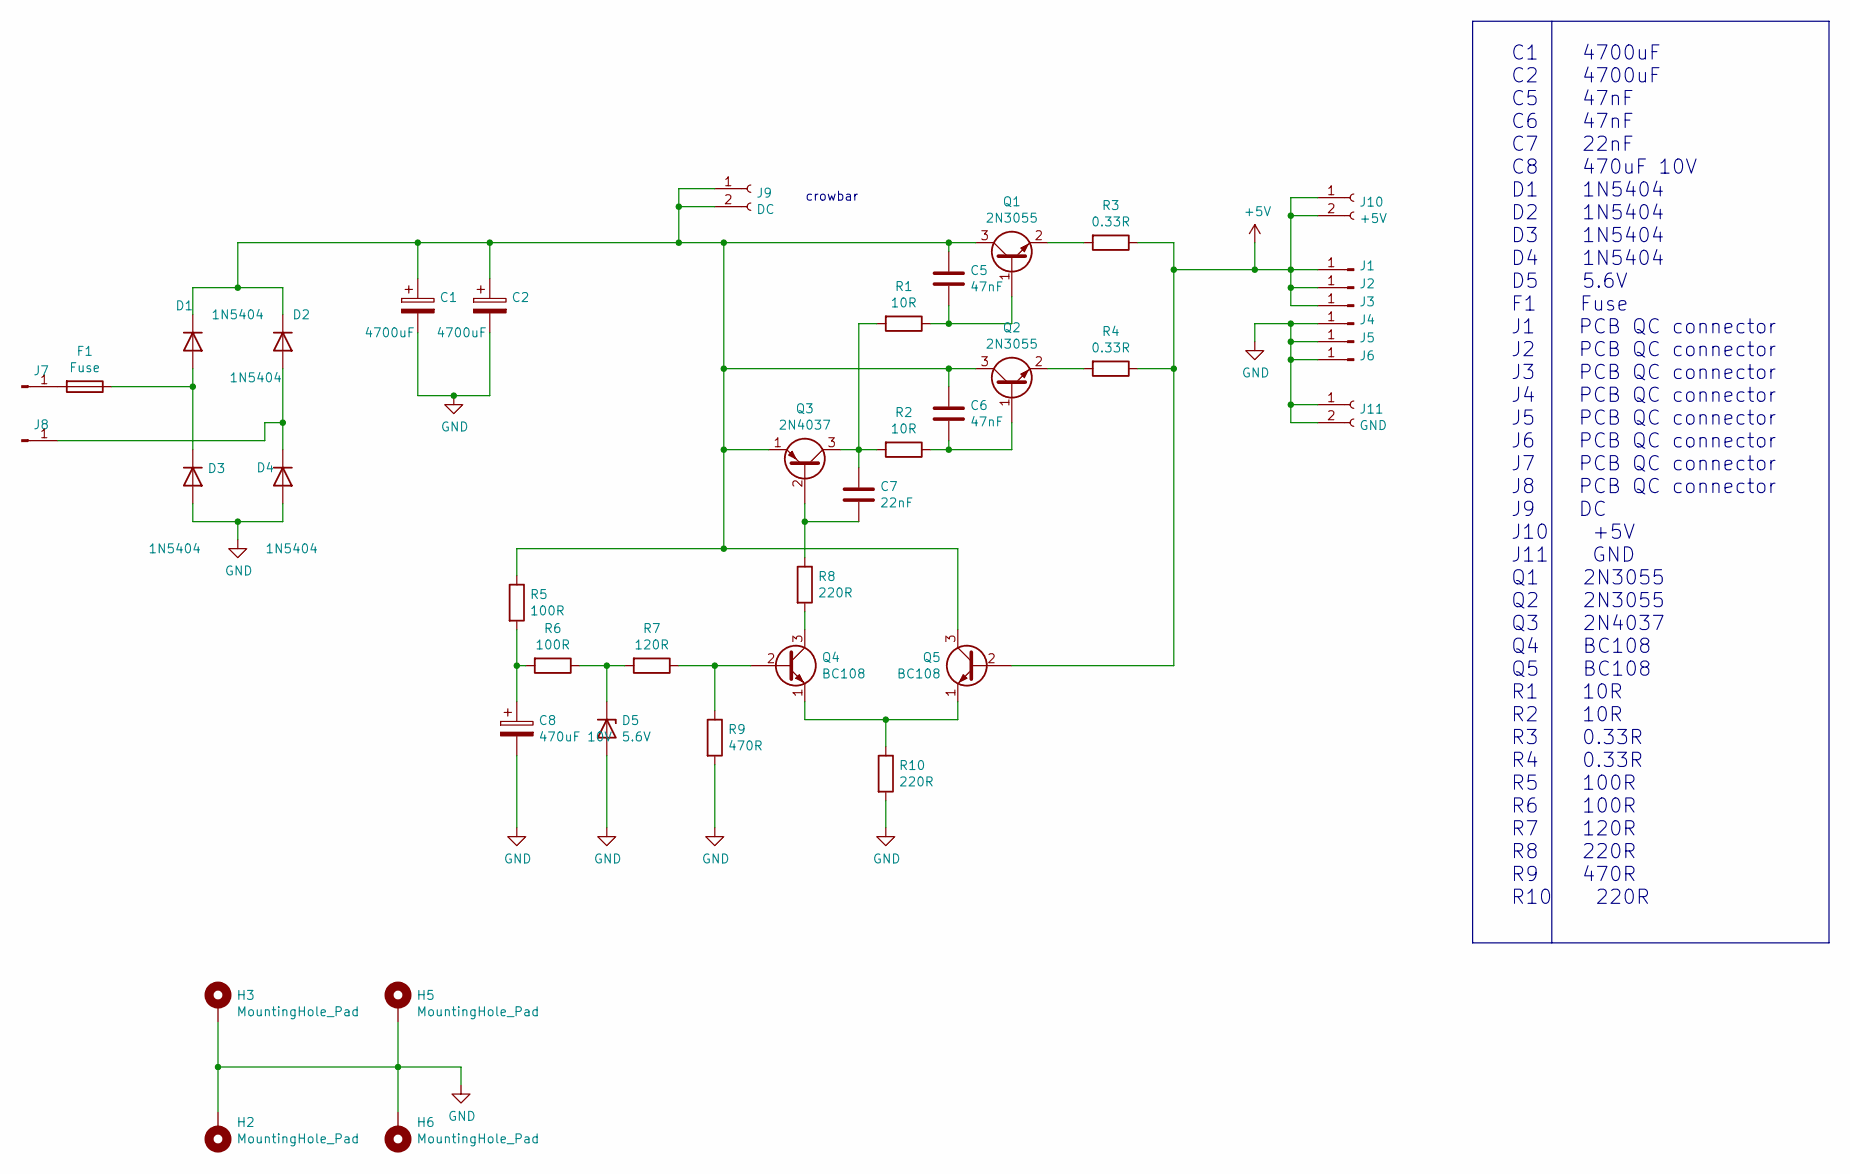
[picture p235: schematic EDUC-8 PSU.kicad_sch, Educ 8 PSU]

Parts:
C1, C2: 4700uF; CP_Radial_D25.0mm_P10.00mm_SnapIn
C5, C6: 47nF; C_Rect_L7.2mm_W3.5mm_P5.00mm_FKS2_FKP2_MKS2_MKP2
C7: 22nF; C_Rect_L7.0mm_W6.0mm_P5.00mm
C8: 470uF 10V; CP_Radial_D12.5mm_P5.00mm
D1, D2, D3, D4: 1N5404; D_DO-201AD_P15.24mm_Horizontal
D5: 5.6V; D_DO-41_SOD81_P10.16mm_Horizontal
F1: Fuse; Fuseholder_Cylinder-6.3x32mm_Schurter_0031-8002_Horizontal_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
H2, H3, H5, H6: MountingHole_Pad; MountingHole_4.3mm_M4_Pad_Via
J1, J2, J3, J4, J5, J6, J7, J8: Conn_01x01_Male; QC_Terminal_PCB_W6.3mm_P5mm_
J9: DC; PinSocket_2x01_P2.54mm_Vertical
J10: +5V; PinSocket_2x01_P2.54mm_Vertical
J11: GND; PinSocket_2x01_P2.54mm_Vertical
Q1, Q2: 2N3055; TO-3
Q3: 2N4037; TO-39-3
Q4, Q5: BC108; TO-18-3
R1, R2: 10R; R_Axial_DIN0411_L9.9mm_D3.6mm_P15.24mm_Horizontal
R3, R4: 0.33R; R_Axial_Power_L25.0mm_W9.0mm_P30.48mm
R5, R6: 100R; R_Axial_DIN0309_L9.0mm_D3.2mm_P12.70mm_Horizontal
R7: 120R; R_Axial_DIN0309_L9.0mm_D3.2mm_P12.70mm_Horizontal
R8, R10: 220R; R_Axial_DIN0309_L9.0mm_D3.2mm_P12.70mm_Horizontal
R9: 470R; R_Axial_DIN0309_L9.0mm_D3.2mm_P12.70mm_Horizontal

Connections:
+5V: J1.1, J2.1, J3.1, J10.1, J10.2, Q5.2 (B), R3.1, R4.1
GND: C1.2, C2.2, C8.2, D3.2 (A), D4.2 (A), D5.2 (A), H2.1, H3.1, H5.1, H6.1, J4.1, J5.1, J6.1, J11.1, J11.2, R9.2, R10.2
unnamed: C1.1, C2.1, C5.1, C6.1, D1.1 (K), D2.1 (K), J9.1, J9.2, Q1.3 (C), Q2.3 (C), Q3.1 (E), Q5.3 (C), R5.1
unnamed: C5.2, Q1.1 (B), R1.1
unnamed: C6.2, Q2.1 (B), R2.1
unnamed: C7.1, Q3.3 (C), R1.2, R2.2
unnamed: C7.2, Q3.2 (B), R8.1
unnamed: C8.1, R5.2, R6.2
unnamed: D1.2 (A), D3.1 (K), F1.1
unnamed: D2.2 (A), D4.1 (K), J8.1
unnamed: D5.1 (K), R6.1, R7.2
unnamed: F1.2, J7.1
unnamed: Q1.2 (E), R3.2
unnamed: Q2.2 (E), R4.2
unnamed: Q4.1 (E), Q5.1 (E), R10.1
unnamed: Q4.2 (B), R7.1, R9.1
unnamed: Q4.3 (C), R8.2

Notes on the sheet:
C1 4700uF C2 4700uF C5 47nF C6 47nF C7 22nF C8 470uF 10V D1 1N5404 D2 1N5404 D3 1N5404 D4 1N5404 D5 5.6V F1 Fuse J1 PCB QC connector J2 PCB QC connector J3 PCB QC connector J4 PCB QC connector J5 PCB QC connector J6 PCB QC connector J7 PCB QC connector J8 PCB QC connector J9 DC J10 +5V J11 GND Q1 2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
crowbar

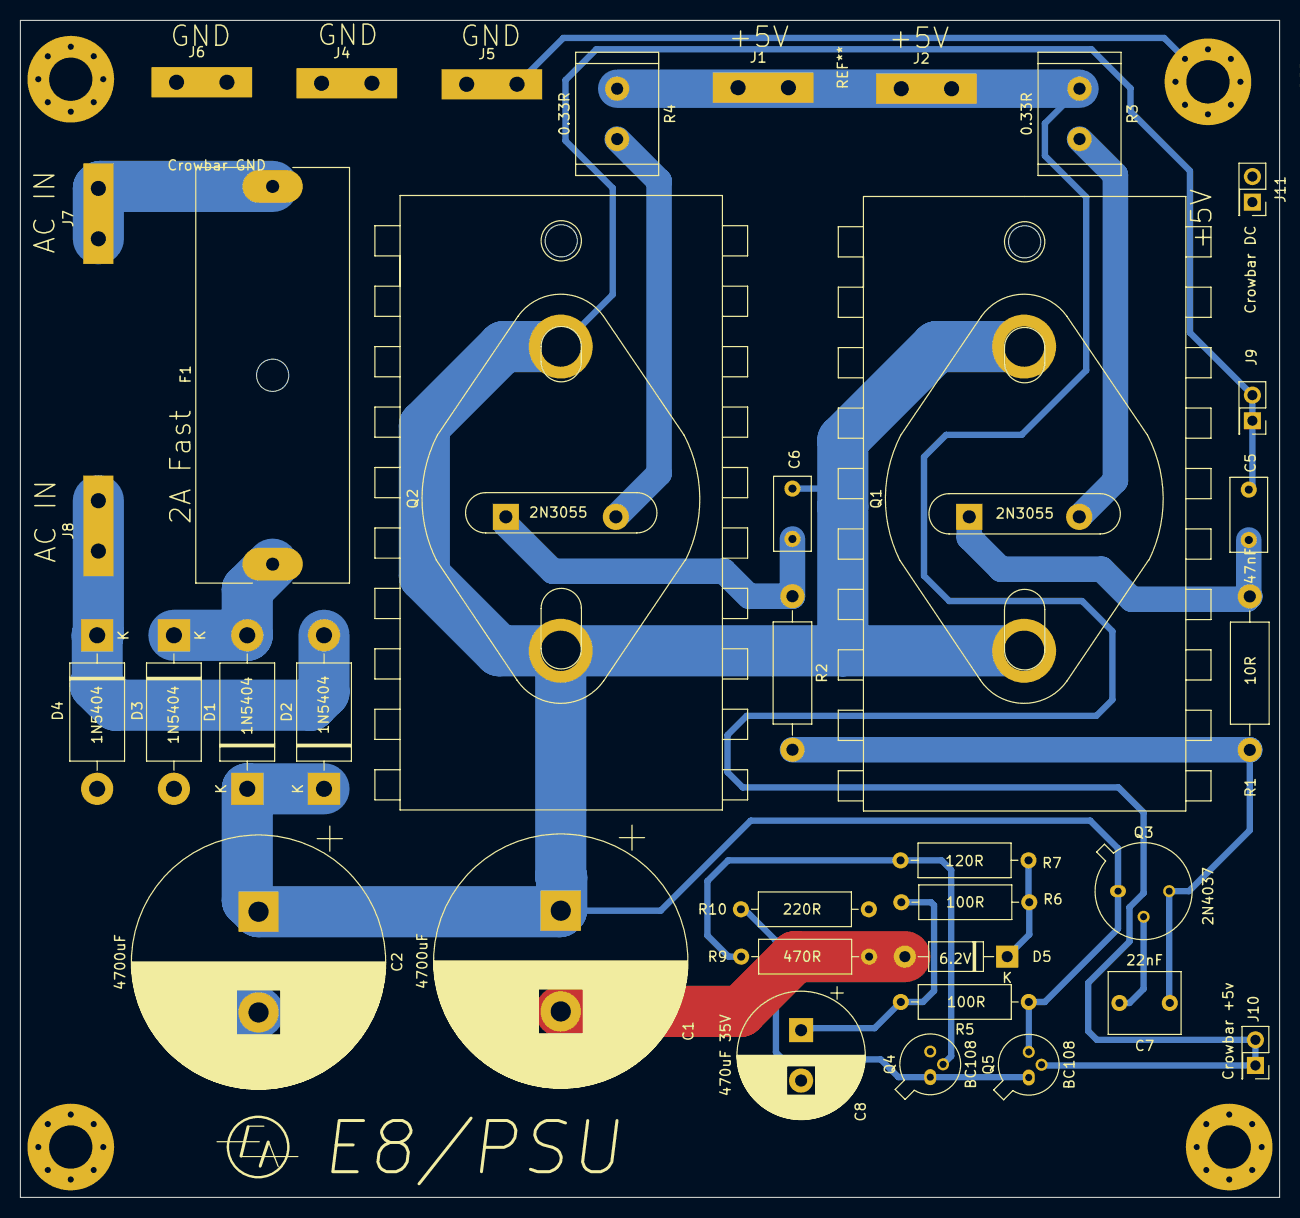
[picture p236: board EDUC-8 PSU.kicad_pcb from above]

Board: 2 copper layers, 125.0 x 116.8 mm, 40 parts (0 on the bottom side), 16 nets.
