ibm2030/EDUC8/PC and ADDER 74LS74 MOD/PC and ADDER 74LS74 MOD.kicad_pcb

## KiCad design PC and ADDER 74LS74 MOD/PC and ADDER 74LS74 MOD.kicad_pcb (2025-07-23)

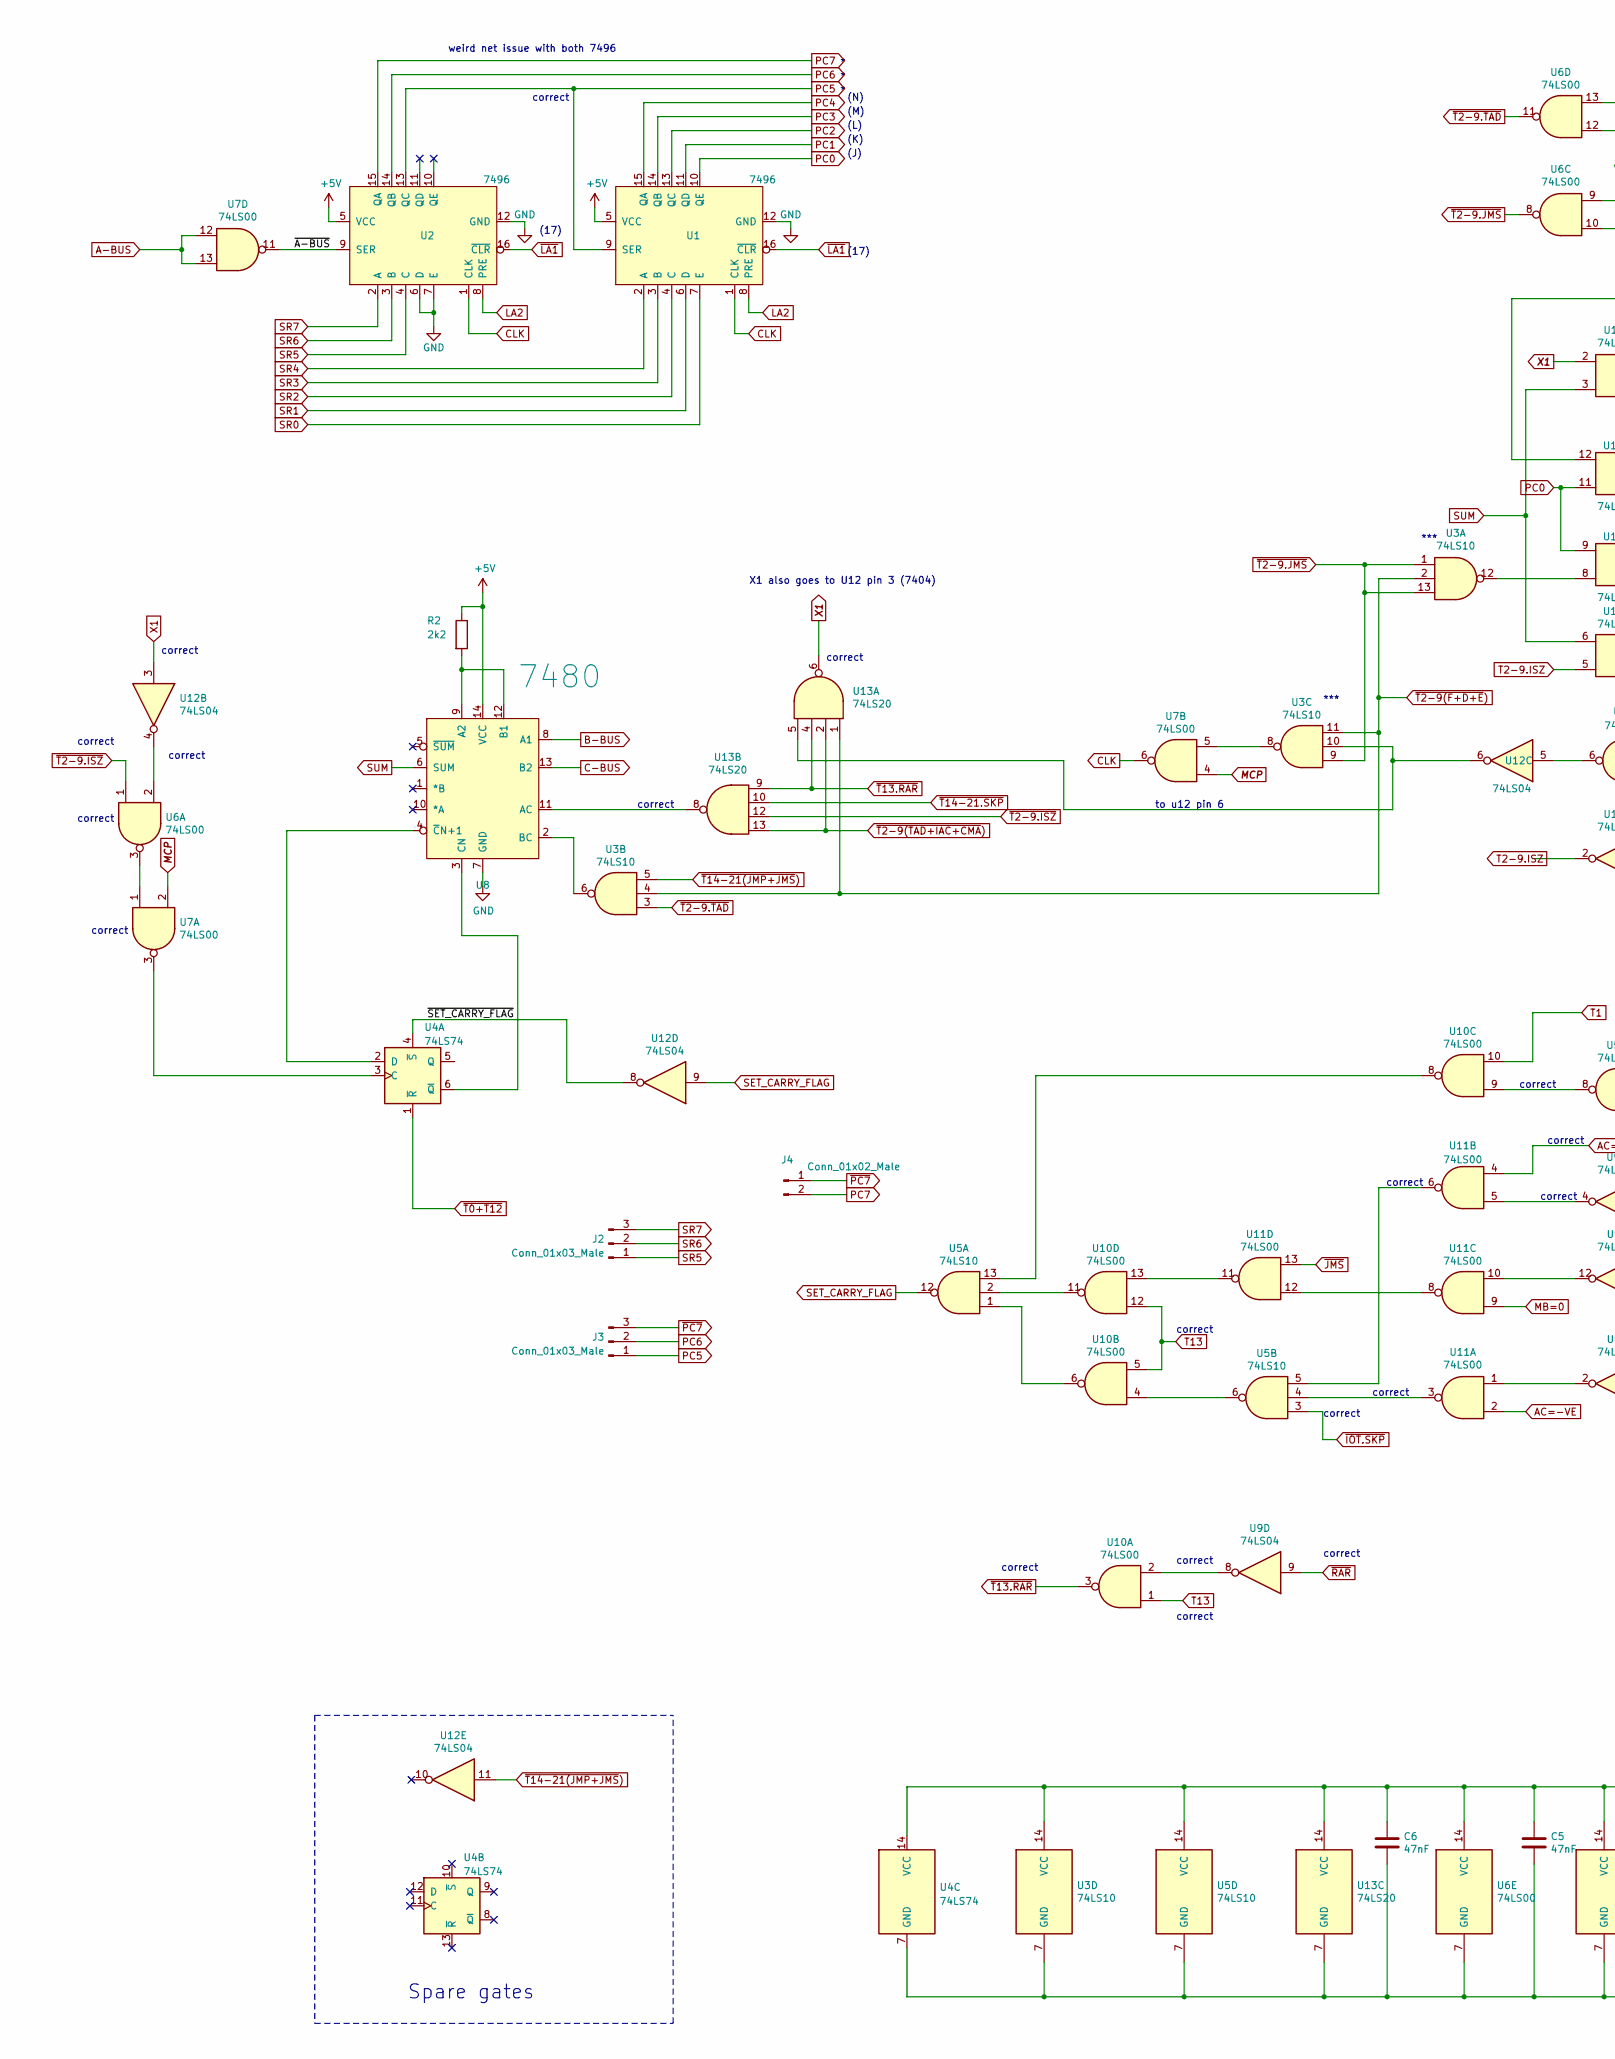
[picture p237: schematic PC and ADDER 74LS74 MOD.kicad_sch, Program counter and adder, part in row 1, column 1]

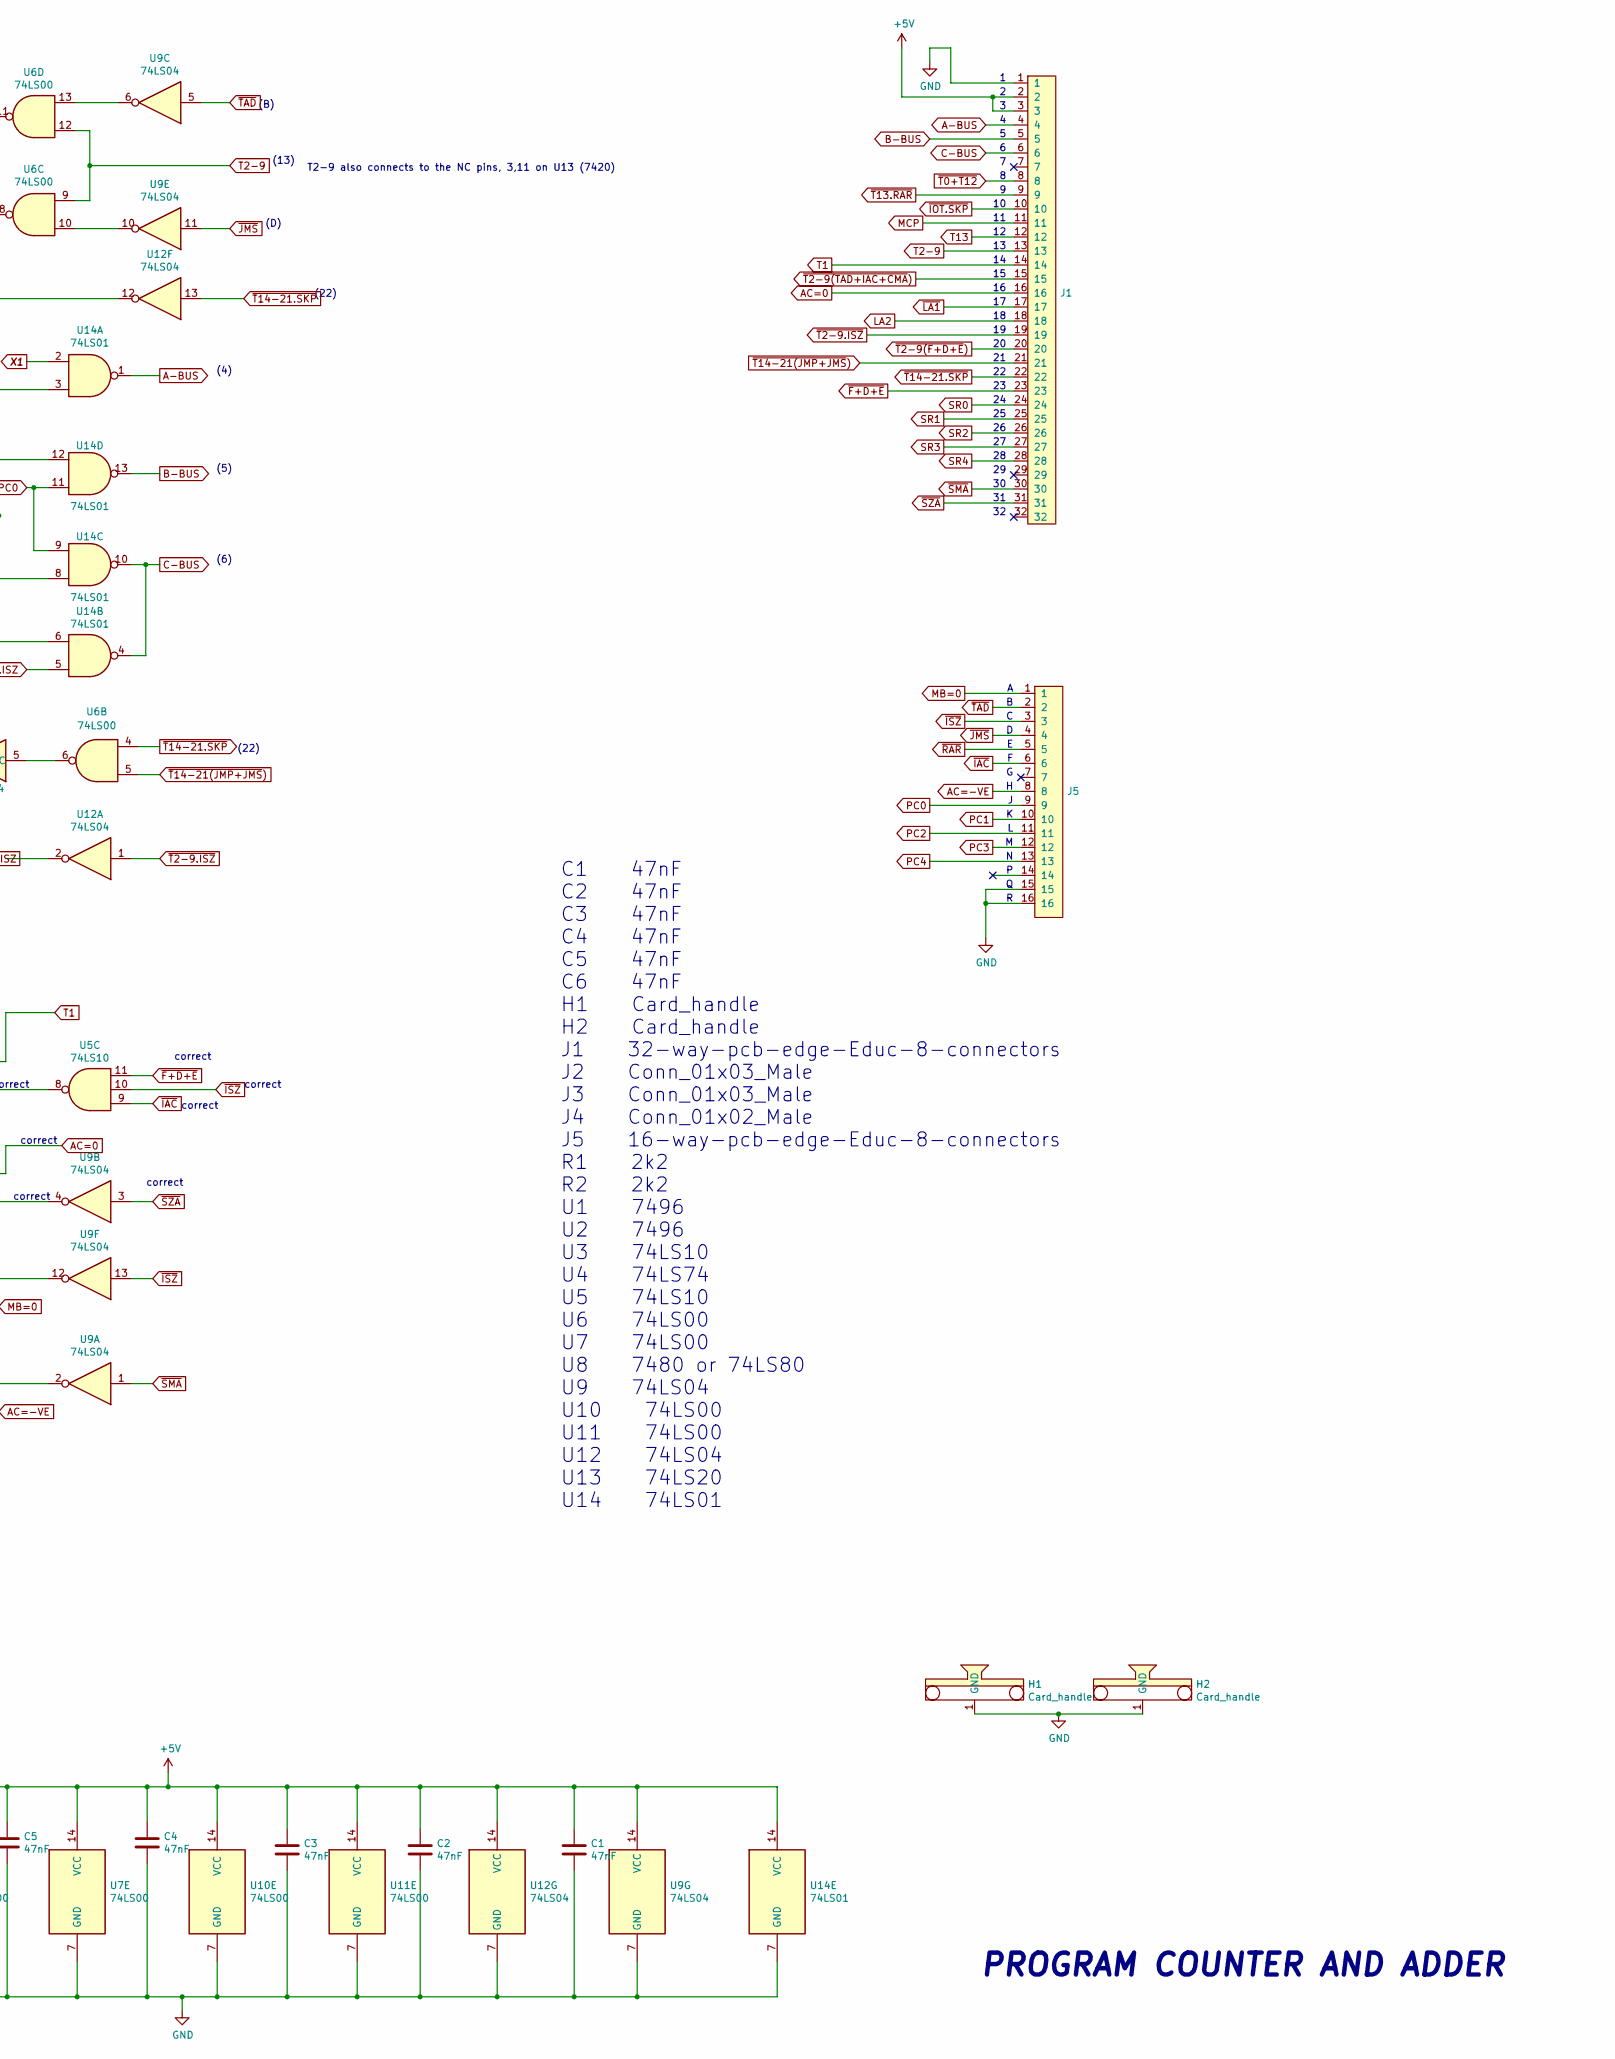
[picture p238: schematic PC and ADDER 74LS74 MOD.kicad_sch, Program counter and adder, part in row 1, column 2]

Parts:
C1, C2, C3, C4, C5, C6: 47nF; C_Disc_D7.5mm_W5.0mm_P7.50mm
H1, H2: Card_handle
J1: 32-way-pcb-edge-Educ-8-connectors; PCB_32pin
J2, J3: Conn_01x03_Male; JST_XH_B3B-XH-AM_1x03_P2.50mm_Vertical
J4: Conn_01x02_Male; JST_XH_B2B-XH-AM_1x02_P2.50mm_Vertical
J5: 16-way-pcb-edge-Educ-8-connectors; PCB_16pin
R2: 2k2; R_Axial_DIN0207_L6.3mm_D2.5mm_P10.16mm_Horizontal
U1, U2: 7496; DIP-16_W7.62mm
U3: 74LS10
U4: 74LS74; DIP-14_W7.62mm_LongPads
U5: 74LS10; DIP-14_W7.62mm
U6, U7: 74LS00; DIP-14_W7.62mm
U8: 7480; DIP-14_W7.62mm
U9: 74LS04
U10, U11: 74LS00
U12: 74LS04; DIP-14_W7.62mm
U13: 74LS20
U14: 74LS01

Connections:
+5V: C1.1, C2.1, C3.1, C4.1, C5.1, C6.1, J1.2, J1.3, R2.1, U1.5 (VCC), U2.5 (VCC), U3.14 (VCC), U4.14 (VCC), U5.14 (VCC), U6.14 (VCC), U7.14 (VCC), U8.14 (VCC), U9.14 (VCC), U10.14 (VCC), U11.14 (VCC), U12.14 (VCC), U13.14 (VCC), U14.14 (VCC); also elsewhere on the board
/~A-BUS: U2.9 (SER), U7.11
/~SET_CARRY_FLAG: U4.4 (~S), U12.8
A-BUS: J1.4, U7.12, U7.13, U14.1
AC=0: J1.16, U11.4
AC=-VE: J5.8, U11.2
B-BUS: J1.5, U8.8 (A1), U14.13
C-BUS: J1.6, U8.13 (B2), U14.4, U14.10
CLK: U1.1 (CLK), U2.1 (CLK), U7.6
GND: C1.2, C2.2, C3.2, C4.2, C5.2, C6.2, H1.1 (GND), H2.1 (GND), J1.1, J5.15, J5.16, U1.12 (GND), U2.6 (D), U2.7 (E), U2.12 (GND), U3.7 (GND), U4.7 (GND), U5.7 (GND), U6.7 (GND), U7.7 (GND), U8.7 (GND), U9.7 (GND), U10.7 (GND), U11.7 (GND), U12.7 (GND), U13.7 (GND), U14.7 (GND); also elsewhere on the board
LA2: J1.18, U1.8 (PRE), U2.8 (PRE)
MB=0: J5.1, U11.9
MCP: J1.11, U7.2, U7.4
unnamed: U3.8, U7.5
unnamed: U4.3 (C), U7.3
unnamed: U4.2 (D), U8.4 (~CN+1)
unnamed: U4.6 (~Q), U8.3 (CN)
unnamed: U6.3, U7.1
unnamed: U6.10, U9.10
unnamed: U6.13, U9.6
unnamed: R2.2, U8.9 (A2), U8.12 (B1)
unnamed: U8.11 (AC), U13.8
unnamed: U3.6, U8.2 (BC)
unnamed: U9.8, U10.2
unnamed: U5.6, U10.4
unnamed: U5.1, U10.6
unnamed: U5.13, U10.8
unnamed: U5.8, U10.9
unnamed: U5.2, U10.11
unnamed: U10.13, U11.11
unnamed: U9.2, U11.1
unnamed: U5.4, U11.3
unnamed: U9.4, U11.5
unnamed: U5.5, U11.6
unnamed: U9.12, U11.10
unnamed: U11.8, U11.12
unnamed: U6.2, U12.4
unnamed: U6.6, U12.5
unnamed: U3.10, U12.6, U13.5
unnamed: U12.12, U14.12
unnamed: U3.12, U14.8
PC0: J5.9, U1.10 (QE), U14.9, U14.11
PC1: J5.10, U1.11 (QD)
PC2: J5.11, U1.13 (QC)
PC3: J5.12, U1.14 (QB)
PC4: J5.13, U1.15 (QA)
PC5: J3.1, U1.9 (SER), U2.13 (QC)
PC6: J3.2, U2.14 (QB)
PC7: J4.2, U2.15 (QA)
SET_CARRY_FLAG: U5.12, U12.9
SR0: J1.24, U1.7 (E)
SR1: J1.25, U1.6 (D)
SR2: J1.26, U1.4 (C)
SR3: J1.27, U1.3 (B)
SR4: J1.28, U1.2 (A)
SR5: J2.1, U2.4 (C)
SR6: J2.2, U2.3 (B)
SR7: J2.3, U2.2 (A)
SUM: U8.6 (SUM), U14.3, U14.6
T1: J1.14, U10.10
T2-9: J1.13, U6.9, U6.12
T2-9.ISZ: U12.2, U14.5
T13: J1.12, U10.1, U10.5, U10.12
X1: U12.3, U13.6, U14.2
~F+D+E: J1.23, U5.11
~IAC: J5.6, U5.9
~IOT.SKP: J1.10, U5.3
~ISZ: J5.3, U5.10, U9.13
~JMS: J5.4, U9.11, U11.13
~LA1: J1.17, U1.16 (~CLR), U2.16 (~CLR)
~PC7: J3.3, J4.1
~RAR: J5.5, U9.9
~SMA: J1.30, U9.1
~SZA: J1.31, U9.3
~T0+T12: J1.8, U4.1 (~R)
~T2-9(F+D+E): J1.20, U3.2, U3.4, U3.11, U13.1
~T2-9(TAD+IAC+CMA): J1.15, U13.2, U13.13
~T2-9.ISZ: J1.19, U6.1, U12.1, U13.12
~T2-9.JMS: U3.1, U3.9, U3.13, U6.8
~T2-9.TAD: U3.3, U6.11
~T13.RAR: J1.9, U10.3, U13.4, U13.9
~T14-21(JMP+JMS): J1.21, U3.5, U6.5, U12.11
~T14-21.SKP: J1.22, U6.4, U12.13, U13.10
~TAD: J5.2, U9.5

Notes on the sheet:
correct
(M)
(B)
***
(L)
(22)
(17)
(13)
(6)
(5)
(K)
X1 also goes to U12 pin 3 (7404)
(J)
(N)
C1 47nF C2 47nF C3 47nF C4 47nF C5 47nF C6 47nF H1 Card_handle H2 Card_handle J1 32-way-pcb-edge-Educ-8-connectors J2 Conn_01x03_Male J3 Conn_01x03_Male J4 Conn_01x02_Male J5 16-way-pcb-edge-Educ-8-connectors R1 2k2 R2 2k2 U1 7496 U2 7496 U3 74LS10 U4 74LS74 U5 74LS10 U6 74LS00 U7 74LS00 U8 7480 or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
(4)
PROGRAM COUNTER AND ADDER
T2-9 also connects to the NC pins, 3,11 on U13 (7420)
weird net issue with both 7496
(D)
Spare gates
to u12 pin 6

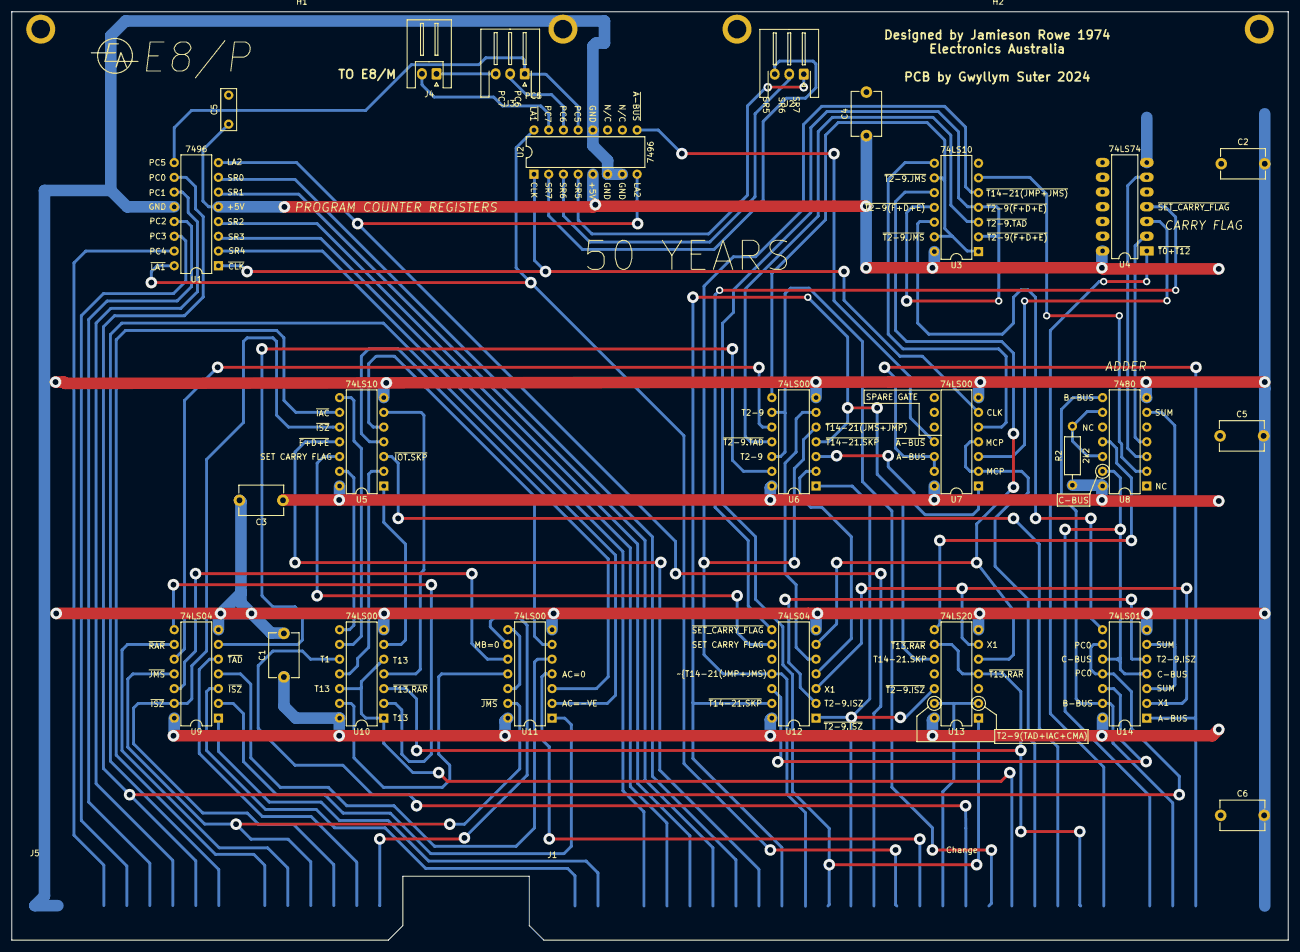
[picture p239: board PC and ADDER 74LS74 MOD.kicad_pcb from above]

Board: 2 copper layers, 220.0 x 160.0 mm, 29 parts (0 on the bottom side), 84 nets.

Other parts of the board:
C5#2: 47nF; C_Disc_D7.5mm_W5.0mm_P7.50mm

Their connections:
+5V: C5#2.1; also elsewhere on the board
GND: C5#2.2; also elsewhere on the board
