ibm2030/EDUC8/Timing/educ 8 timing .kicad_pcb

## KiCad design Timing/educ 8 timing .kicad_pcb (2025-07-23)

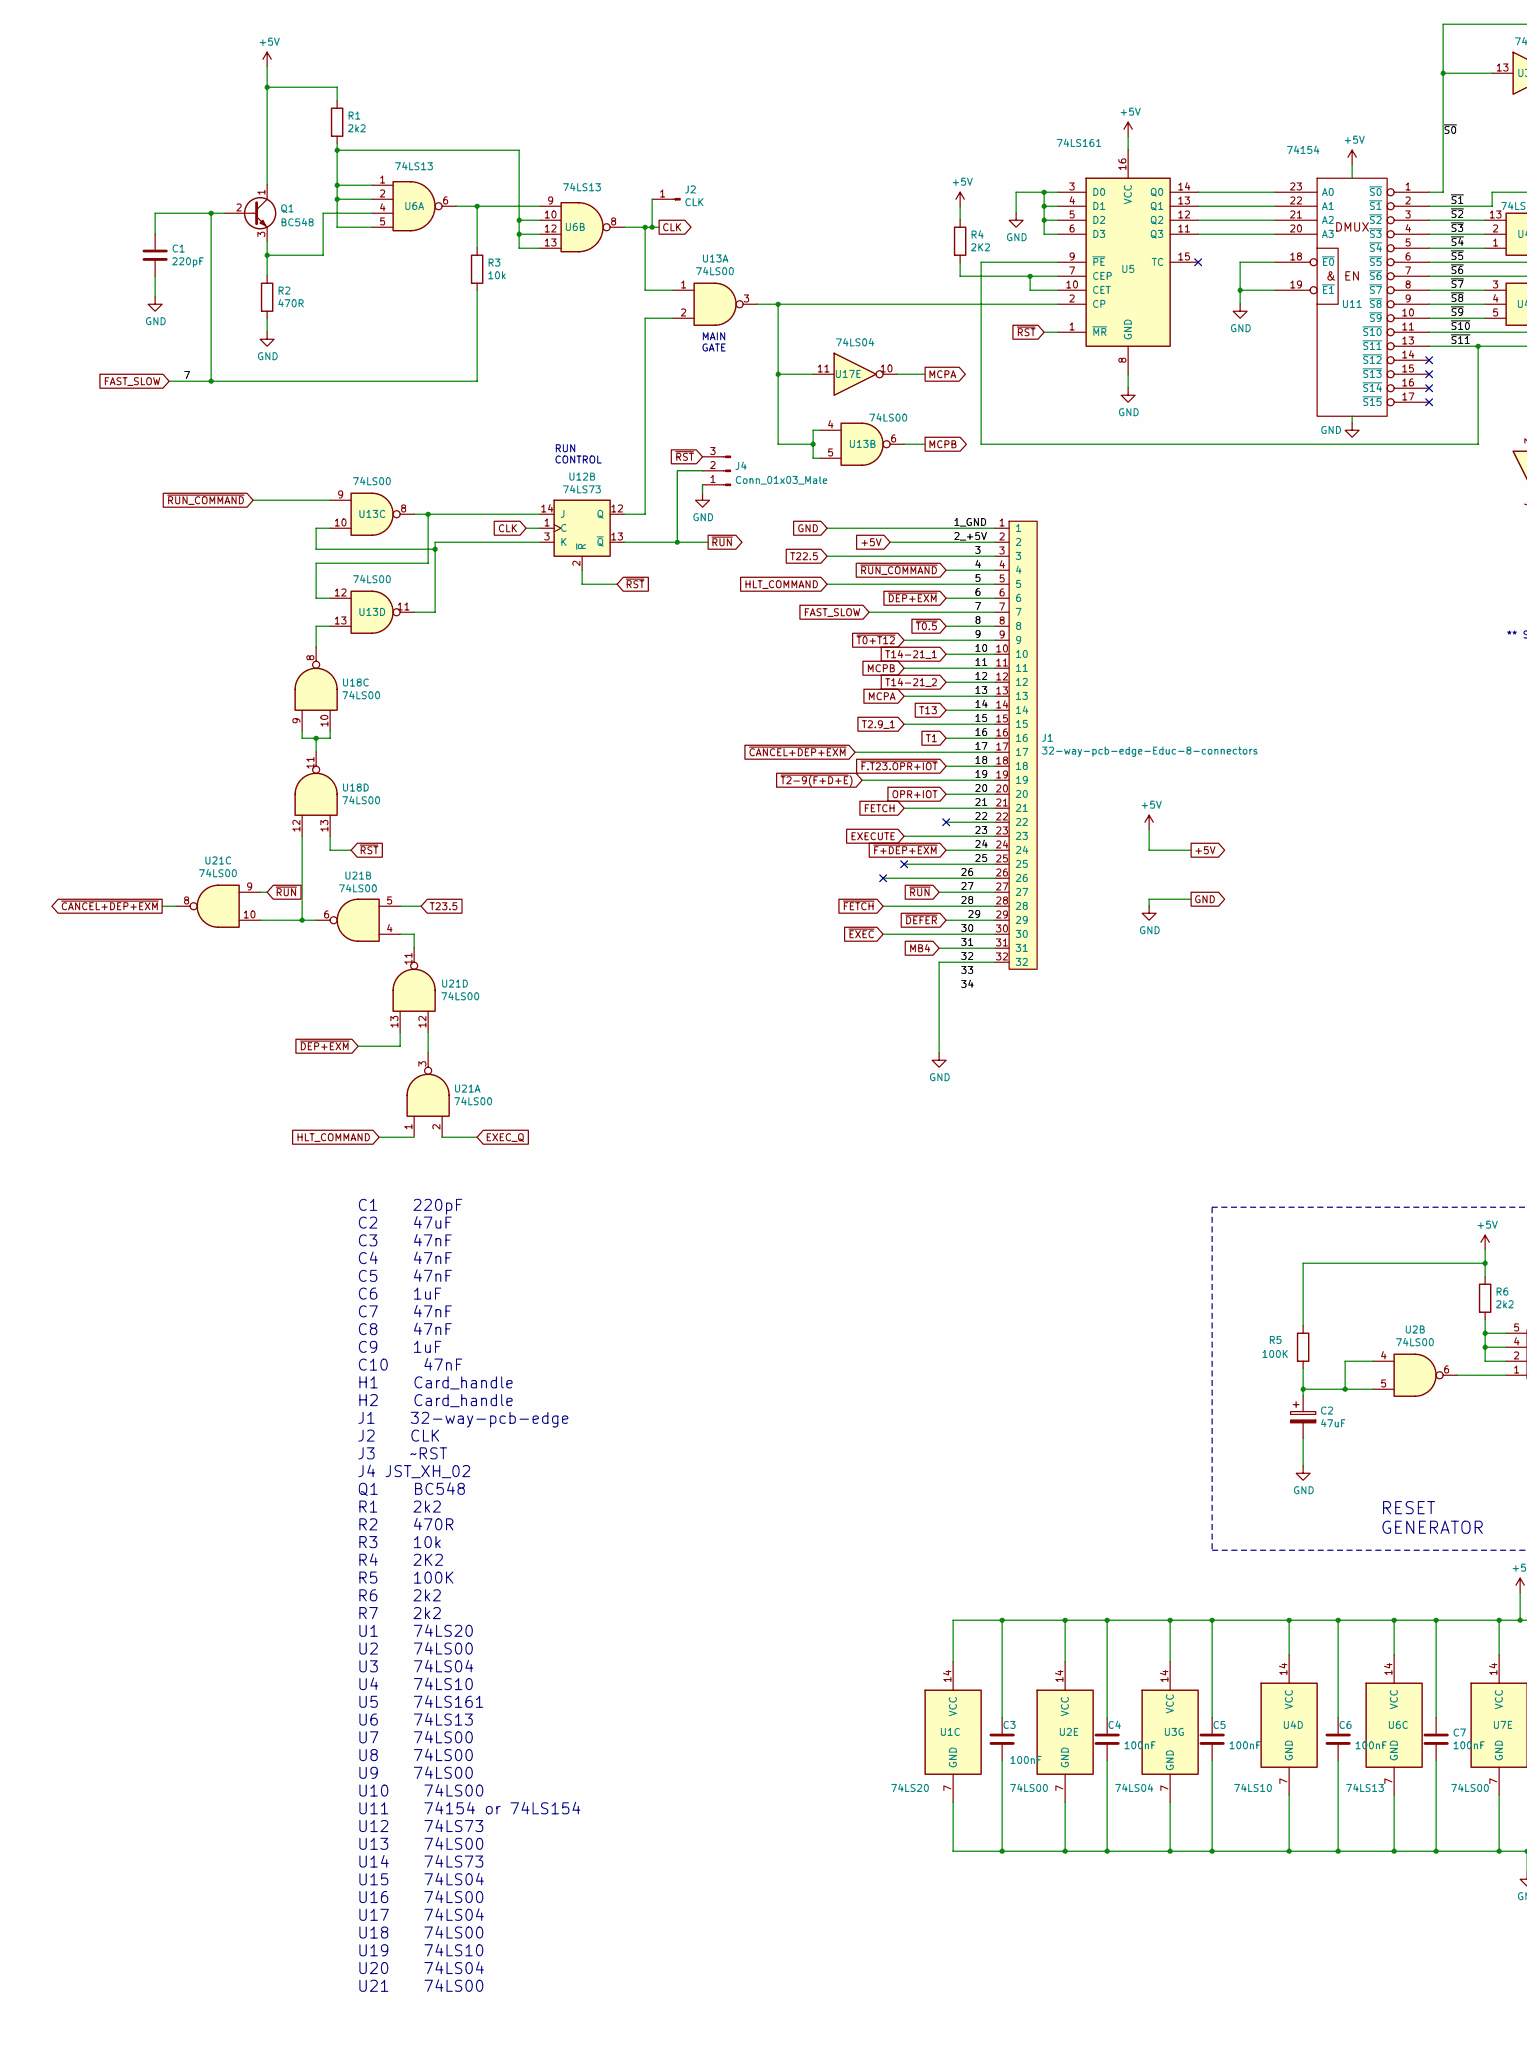
[picture p240: schematic educ 8 timing .kicad_sch, EDUC-8 TIMING, part in row 1, column 1]

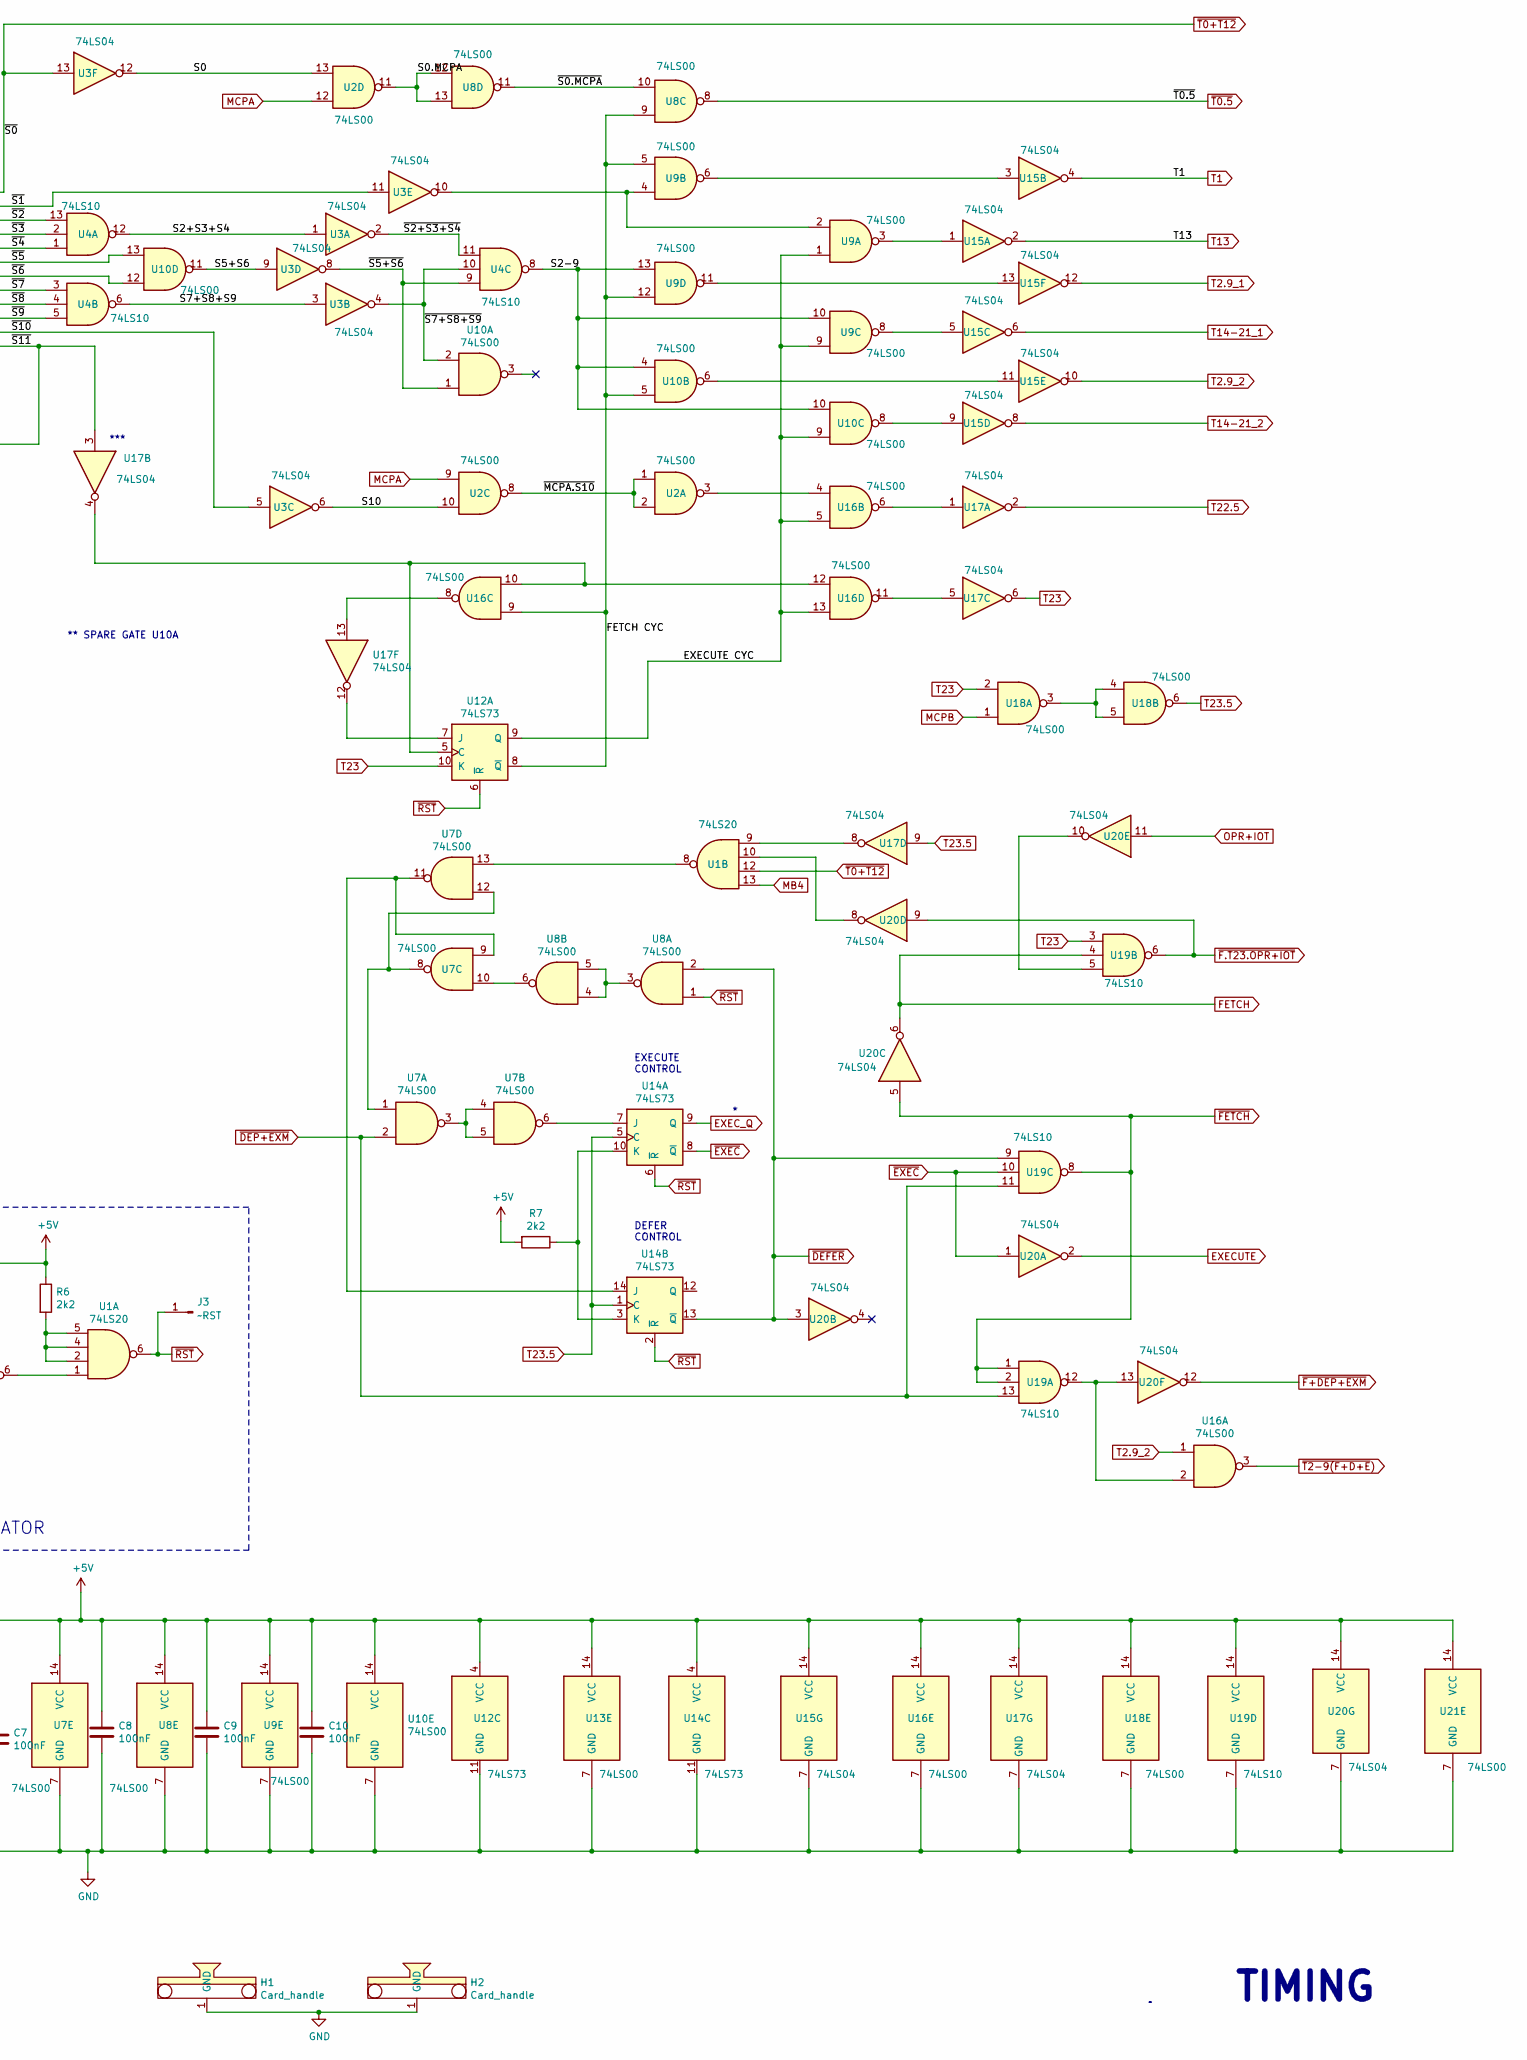
[picture p241: schematic educ 8 timing .kicad_sch, EDUC-8 TIMING, part in row 1, column 2]

Parts:
C1: 220pF; C_Disc_D7.0mm_W2.5mm_P5.00mm
C2: 47uF; CP_Radial_D6.3mm_P2.50mm
C3, C6, C9, C10: 100nF; C_Disc_D5.0mm_W2.5mm_P5.00mm
C4, C5, C7, C8: 100nF; C_Disc_D7.0mm_W2.5mm_P5.00mm
H1, H2: Card_handle
J1: 32-way-pcb-edge-Educ-8-connectors; PCB_32pin
J2: CLK; Pin_D1.0mm_L10.0mm
J3: ~RST; Pin_D1.0mm_L10.0mm
J4: Conn_01x03_Male; JST_XH_B3B-XH-A_1x03_P2.50mm_Vertical
Q1: BC548; TO-92_Wide
R1, R6, R7: 2k2; R_Axial_DIN0309_L9.0mm_D3.2mm_P12.70mm_Horizontal
R2: 470R; R_Axial_DIN0309_L9.0mm_D3.2mm_P12.70mm_Horizontal
R3: 10k; R_Axial_DIN0309_L9.0mm_D3.2mm_P12.70mm_Horizontal
R4: 2K2; R_Axial_DIN0309_L9.0mm_D3.2mm_P12.70mm_Horizontal
R5: 100K; R_Axial_DIN0309_L9.0mm_D3.2mm_P12.70mm_Horizontal
U1: 74LS20; DIP-14_W7.62mm_LongPads
U2, U7, U8, U9, U10, U13, U16, U18, U21: 74LS00; DIP-14_W7.62mm_LongPads
U3, U15, U17, U20: 74LS04; DIP-14_W7.62mm_LongPads
U4, U19: 74LS10; DIP-14_W7.62mm_LongPads
U5: 74LS161; DIP-16_W7.62mm_LongPads
U6: 74LS13; DIP-14_W7.62mm_LongPads
U11: 74154; DIP-24_W15.24mm_LongPads
U12, U14: 74LS73; DIP-14_W7.62mm_LongPads

Connections:
+5V: C3.1, C4.1, C5.1, C6.1, C7.1, C8.1, C9.1, C10.1, J1.2, Q1.1 (C), R1.1, R4.1, R5.1, R6.1, R7.2, U1.14 (VCC), U2.14 (VCC), U3.14 (VCC), U4.14 (VCC), U5.16 (VCC), U6.14 (VCC), U7.14 (VCC), U8.14 (VCC), U9.14 (VCC), U10.14 (VCC), U11.24 (VCC), U12.4 (VCC), U13.14 (VCC), U14.4 (VCC), U15.14 (VCC), U16.14 (VCC), U17.14 (VCC), U18.14 (VCC), U19.14 (VCC), U20.14 (VCC), U21.14 (VCC)
/22: J1.22
/25: J1.25
/26: J1.26
/EXECUTE CYC: U9.1, U9.9, U10.9, U12.9 (Q), U16.5, U16.13
/FETCH CYC: U8.9, U9.5, U9.12, U10.5, U12.8 (~Q), U16.9
/S0: U2.13, U3.12
/S0.MCPA: U2.11, U8.12, U8.13
/S2+S3+S4: U3.1, U4.12
/S2-9: U4.8, U9.10, U9.13, U10.4, U10.10
/S5+S6: U3.9, U10.11
/S7+S8+S9: U3.3, U4.6
/S10: U2.10, U3.6
/~MCPA.S10: U2.1, U2.2, U2.8
/~S0.MCPA: U8.10, U8.11
/~S1: U3.11, U11.2 (~S1)
/~S2+S3+S4: U3.2, U4.11
/~S2: U4.13, U11.3 (~S2)
/~S3: U4.2, U11.4 (~S3)
/~S4: U4.1, U11.5 (~S4)
/~S5+S6: U3.8, U4.9, U10.1
/~S5: U10.13, U11.6 (~S5)
/~S6: U10.12, U11.7 (~S6)
/~S7+S8+S9: U3.4, U4.10, U10.2
/~S7: U4.3, U11.8 (~S7)
/~S8: U4.4, U11.9 (~S8)
/~S9: U4.5, U11.10 (~S9)
/~S10: U3.5, U11.11 (~S10)
/~S11: U5.9 (~PE), U11.13 (~S11), U17.3
CLK: J2.1, U6.8, U12.1 (C), U13.1
EXECUTE: J1.23, U20.2
EXEC_Q: U14.9 (Q), U21.2
FAST_SLOW: C1.1, J1.7, Q1.2 (B), R3.2
FETCH: J1.21, U19.4, U20.6
GND: C1.2, C2.2, C3.2, C4.2, C5.2, C6.2, C7.2, C8.2, C9.2, C10.2, H1.1 (GND), H2.1 (GND), J1.1, J1.32, J4.1, R2.2, U1.7 (GND), U2.7 (GND), U3.7 (GND), U4.7 (GND), U5.3 (D0), U5.4 (D1), U5.5 (D2), U5.6 (D3), U5.8 (GND), U6.7 (GND), U7.7 (GND), U8.7 (GND), U9.7 (GND), U10.7 (GND), U11.12 (GND), U11.18 (~E0), U11.19 (~E1), U12.11 (GND), U13.7 (GND), U14.11 (GND), U15.7 (GND), U16.7 (GND), U17.7 (GND), U18.7 (GND), U19.7 (GND), U20.7 (GND), U21.7 (GND)
HLT_COMMAND: J1.5, U21.1
MB4: J1.31, U1.13
MCPA: J1.13, U2.9, U2.12, U17.10
MCPB: J1.11, U13.6, U18.1
unnamed: C2.1, R5.2, U2.4, U2.5
unnamed: Q1.3 (E), R2.1, U6.4
unnamed: R1.2, U6.1, U6.2, U6.5, U6.10, U6.12, U6.13
unnamed: R3.1, U6.6, U6.9
unnamed: R6.2, U1.2, U1.4, U1.5
unnamed: U1.1, U2.6
unnamed: U1.8, U7.13
unnamed: U1.9, U17.8
unnamed: U1.10, U20.8
unnamed: U3.10, U9.2, U9.4
unnamed: R4.2, U5.7 (CEP), U5.10 (CET)
unnamed: U5.2 (CP), U13.3, U13.4, U13.5, U17.11
unnamed: U7.1, U7.8, U7.12
unnamed: U7.3, U7.4, U7.5
unnamed: U7.10, U8.6
unnamed: U8.3, U8.4, U8.5
unnamed: U10.6, U15.11
unnamed: U10.8, U15.9
unnamed: U5.14 (Q0), U11.23 (A0)
unnamed: U5.13 (Q1), U11.22 (A1)
unnamed: U5.12 (Q2), U11.21 (A2)
unnamed: U5.11 (Q3), U11.20 (A3)
unnamed: U12.5 (C), U16.10, U16.12, U17.4
unnamed: U12.7 (J), U17.12
unnamed: U12.14 (J), U13.8, U13.12
unnamed: U12.3 (K), U13.10, U13.11
unnamed: U12.12 (Q), U13.2
unnamed: U13.13, U18.8
unnamed: U7.6, U14.7 (J)
unnamed: R7.1, U14.3 (K), U14.10 (K)
unnamed: U7.9, U7.11, U14.14 (J)
unnamed: U9.3, U15.1
unnamed: U9.6, U15.3
unnamed: U9.8, U15.5
unnamed: U9.11, U15.13
unnamed: U16.2, U19.12, U20.13
unnamed: U2.3, U16.4
unnamed: U16.6, U17.1
unnamed: U16.8, U17.13
unnamed: U16.11, U17.5
unnamed: U18.3, U18.4, U18.5
unnamed: U18.9, U18.10, U18.11
unnamed: U18.12, U21.6, U21.10
unnamed: U19.5, U20.10
unnamed: U21.4, U21.11
unnamed: U21.3, U21.12
OPR+IOT: J1.20, U20.11
T1: J1.16, U15.4
T2.9_1: J1.15, U15.12
T2.9_2: U15.10, U16.1
T13: J1.14, U15.2
T14-21_1: J1.10, U15.6
T14-21_2: J1.12, U15.8
T22.5: J1.3, U17.2
T23: U12.10 (K), U17.6, U18.2, U19.3
T23.5: U14.1 (C), U14.5 (C), U17.9, U18.6, U21.5
~CANCEL+DEP+EXM: J1.17, U21.8
~DEFER: J1.29, U8.2, U14.13 (~Q), U19.9, U20.3
~DEP+EXM: J1.6, U7.2, U19.11, U19.13, U21.13
~EXEC: J1.30, U14.8 (~Q), U19.10, U20.1
~F+DEP+EXM: J1.24, U20.12
~F.T23.OPR+IOT: J1.18, U19.6, U20.9
~FETCH: J1.28, U19.1, U19.2, U19.8, U20.5
~RST: J3.1, J4.3, U1.6, U5.1 (~MR), U8.1, U12.2 (~R), U12.6 (~R), U14.2 (~R), U14.6 (~R), U18.13
~RUN_COMMAND: J1.4, U13.9
~RUN: J1.27, J4.2, U12.13 (~Q), U21.9
~T0+T12: J1.9, U1.12, U3.13, U11.1 (~S0)
~T0.5: J1.8, U8.8
~T2-9(F+D+E): J1.19, U16.3

Notes on the sheet:
RUN CONTROL
DEFER CONTROL
EXECUTE CONTROL
***
TIMING
RESET GENERATOR
** SPARE GATE U10A
C1 220pF C2 47uF C3 47nF C4 47nF C5 47nF C6 1uF C7 47nF C8 47nF C9 1uF C10 47nF H1 Card_handle H2 Card_handle J1 32-way-pcb-edge J2 CLK J3 ~RST J4 JST_XH_02 Q1 BC548 R1 2k2 R2 470R R3 10k R4 2K2 R5 100K R6 2k2 R7 2k2 U1 74LS20 U2 74LS00 U3 74LS04 U4 74LS10 U5 74LS161 U6 74LS13 U7 74LS00 U8 74LS00 U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
MAIN GATE

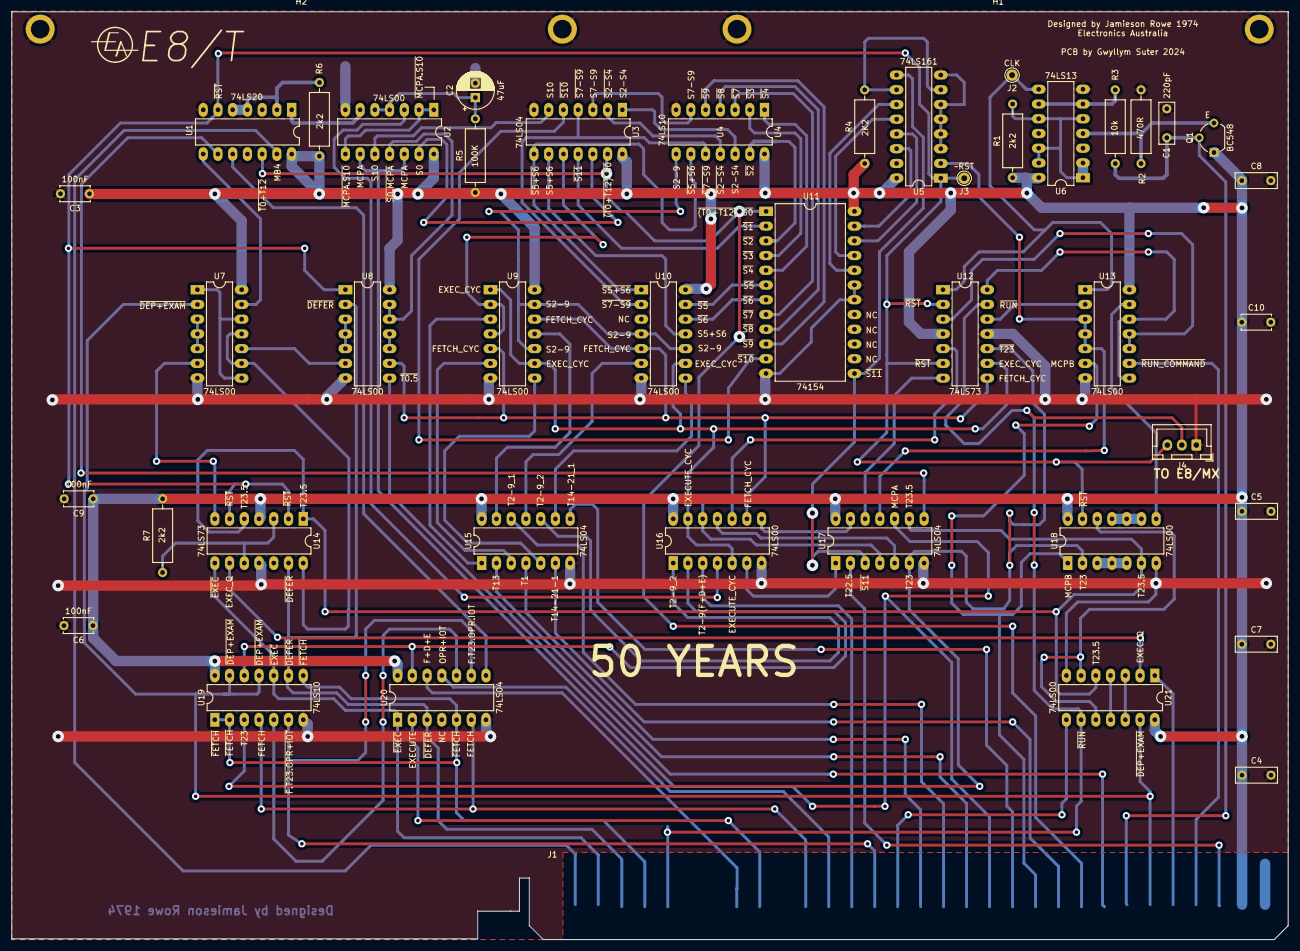
[picture p242: board educ 8 timing .kicad_pcb from above]

Board: 4 copper layers, 220.0 x 159.9 mm, 45 parts (0 on the bottom side), 105 nets.
