ibm2030/EDUC8/Power Supply/Crowbar/EDUC-8 Crowbar/EDUC-8 Crowbar.kicad_pcb

## KiCad design Power Supply/Crowbar/EDUC-8 Crowbar/EDUC-8 Crowbar.kicad_pcb (2025-07-23)

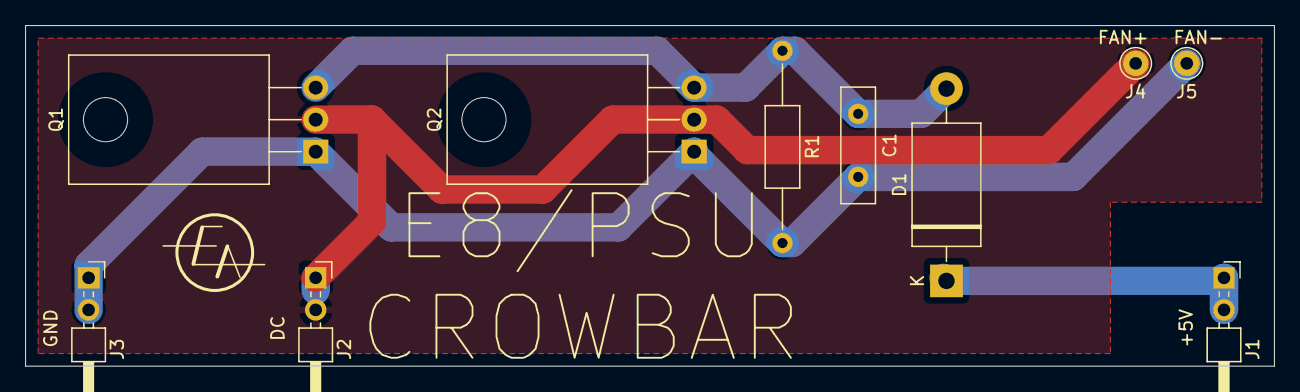
[picture p243: board EDUC-8 Crowbar.kicad_pcb from above]

Board: 2 copper layers, 99.0 x 27.0 mm, 10 parts (0 on the bottom side), 4 nets.

Parts:
C1: C; C_Disc_D9.0mm_W2.5mm_P5.00mm
D1: 1N5328B; D_DO-201_P15.24mm_Horizontal
J1: +5V; PinHeader_2x01_P2.54mm_Horizontal
J2: DC; PinHeader_2x01_P2.54mm_Horizontal
J3: GND; PinHeader_2x01_P2.54mm_Horizontal
J4: FAN+; Pin_D1.0mm_L10.0mm
J5: FAN-; Pin_D1.0mm_L10.0mm
Q1, Q2: TIC106; TO-220-3_Horizontal_TabDown
R1: R; R_Axial_DIN0207_L6.3mm_D2.5mm_P15.24mm_Horizontal

Connections:
unnamed: C1.1, D1.2, Q1.3, Q2.3, R1.1
unnamed: C1.2, J3.1, J3.2, J5.1, Q1.1, Q2.1, R1.2
unnamed: D1.1, J1.1, J1.2
unnamed: J2.1, J2.2, J4.1, Q1.2, Q2.2
