ibm2030/EDUC8/motherboard/motherboard.kicad_pcb

## KiCad design motherboard/motherboard.kicad_pcb (2025-07-23)

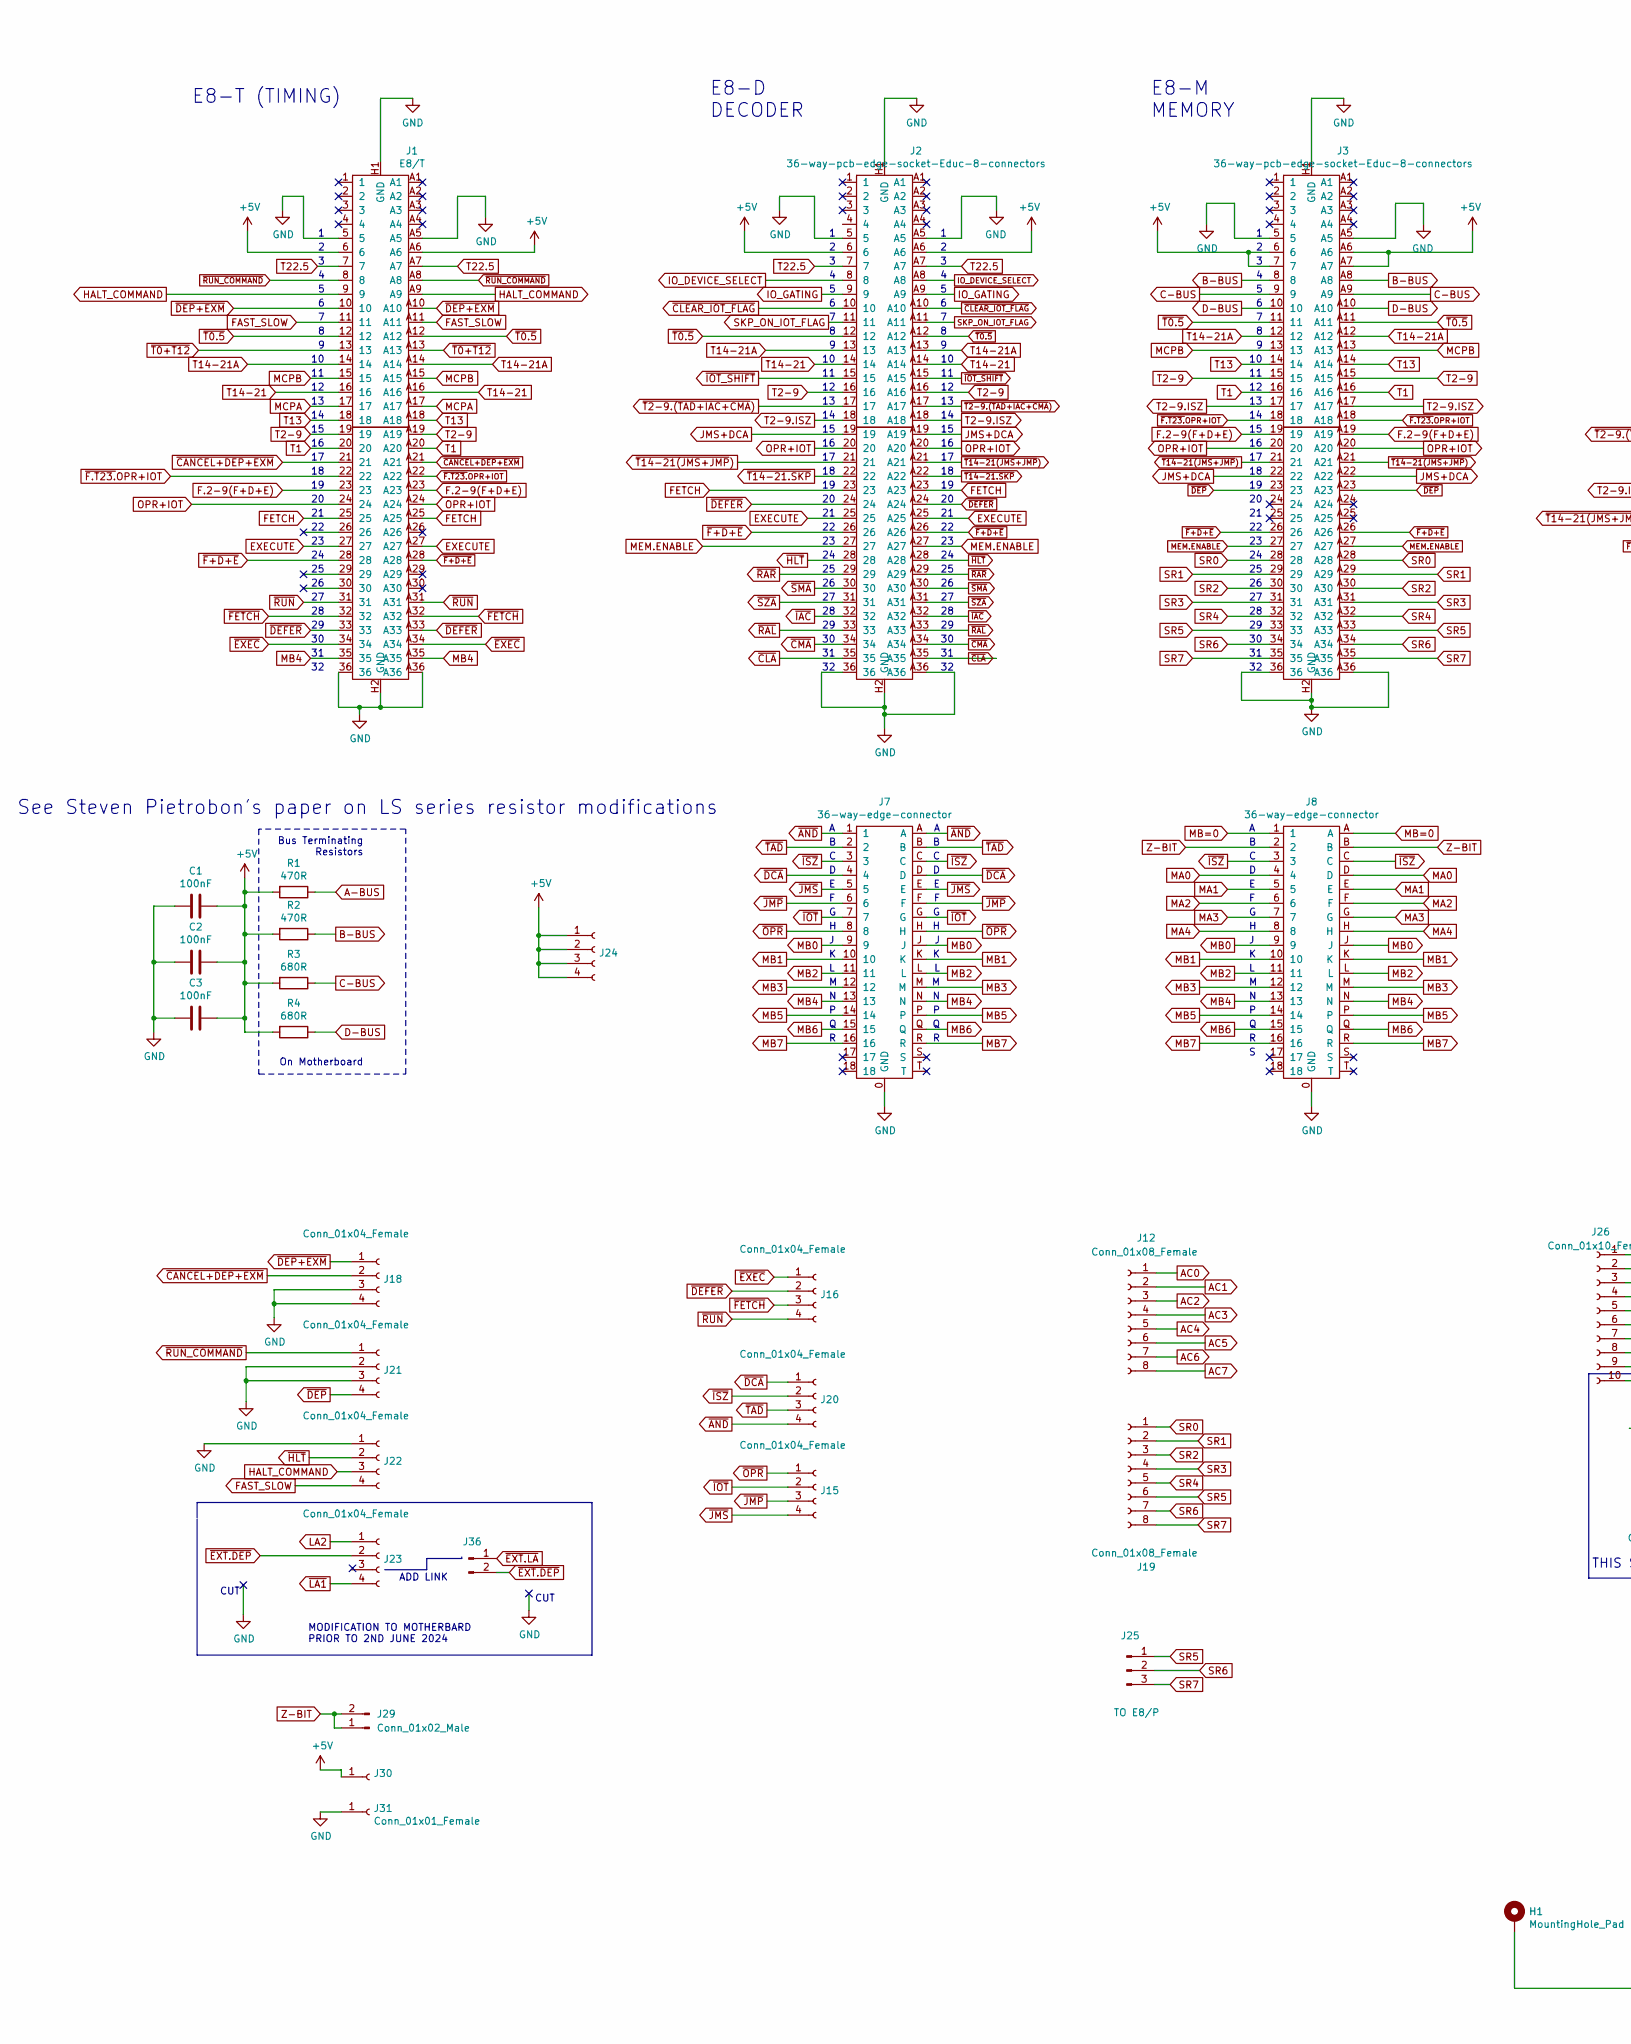
[picture p244: schematic motherboard.kicad_sch, EDUC-8 Motherboard, part in row 1, column 1]

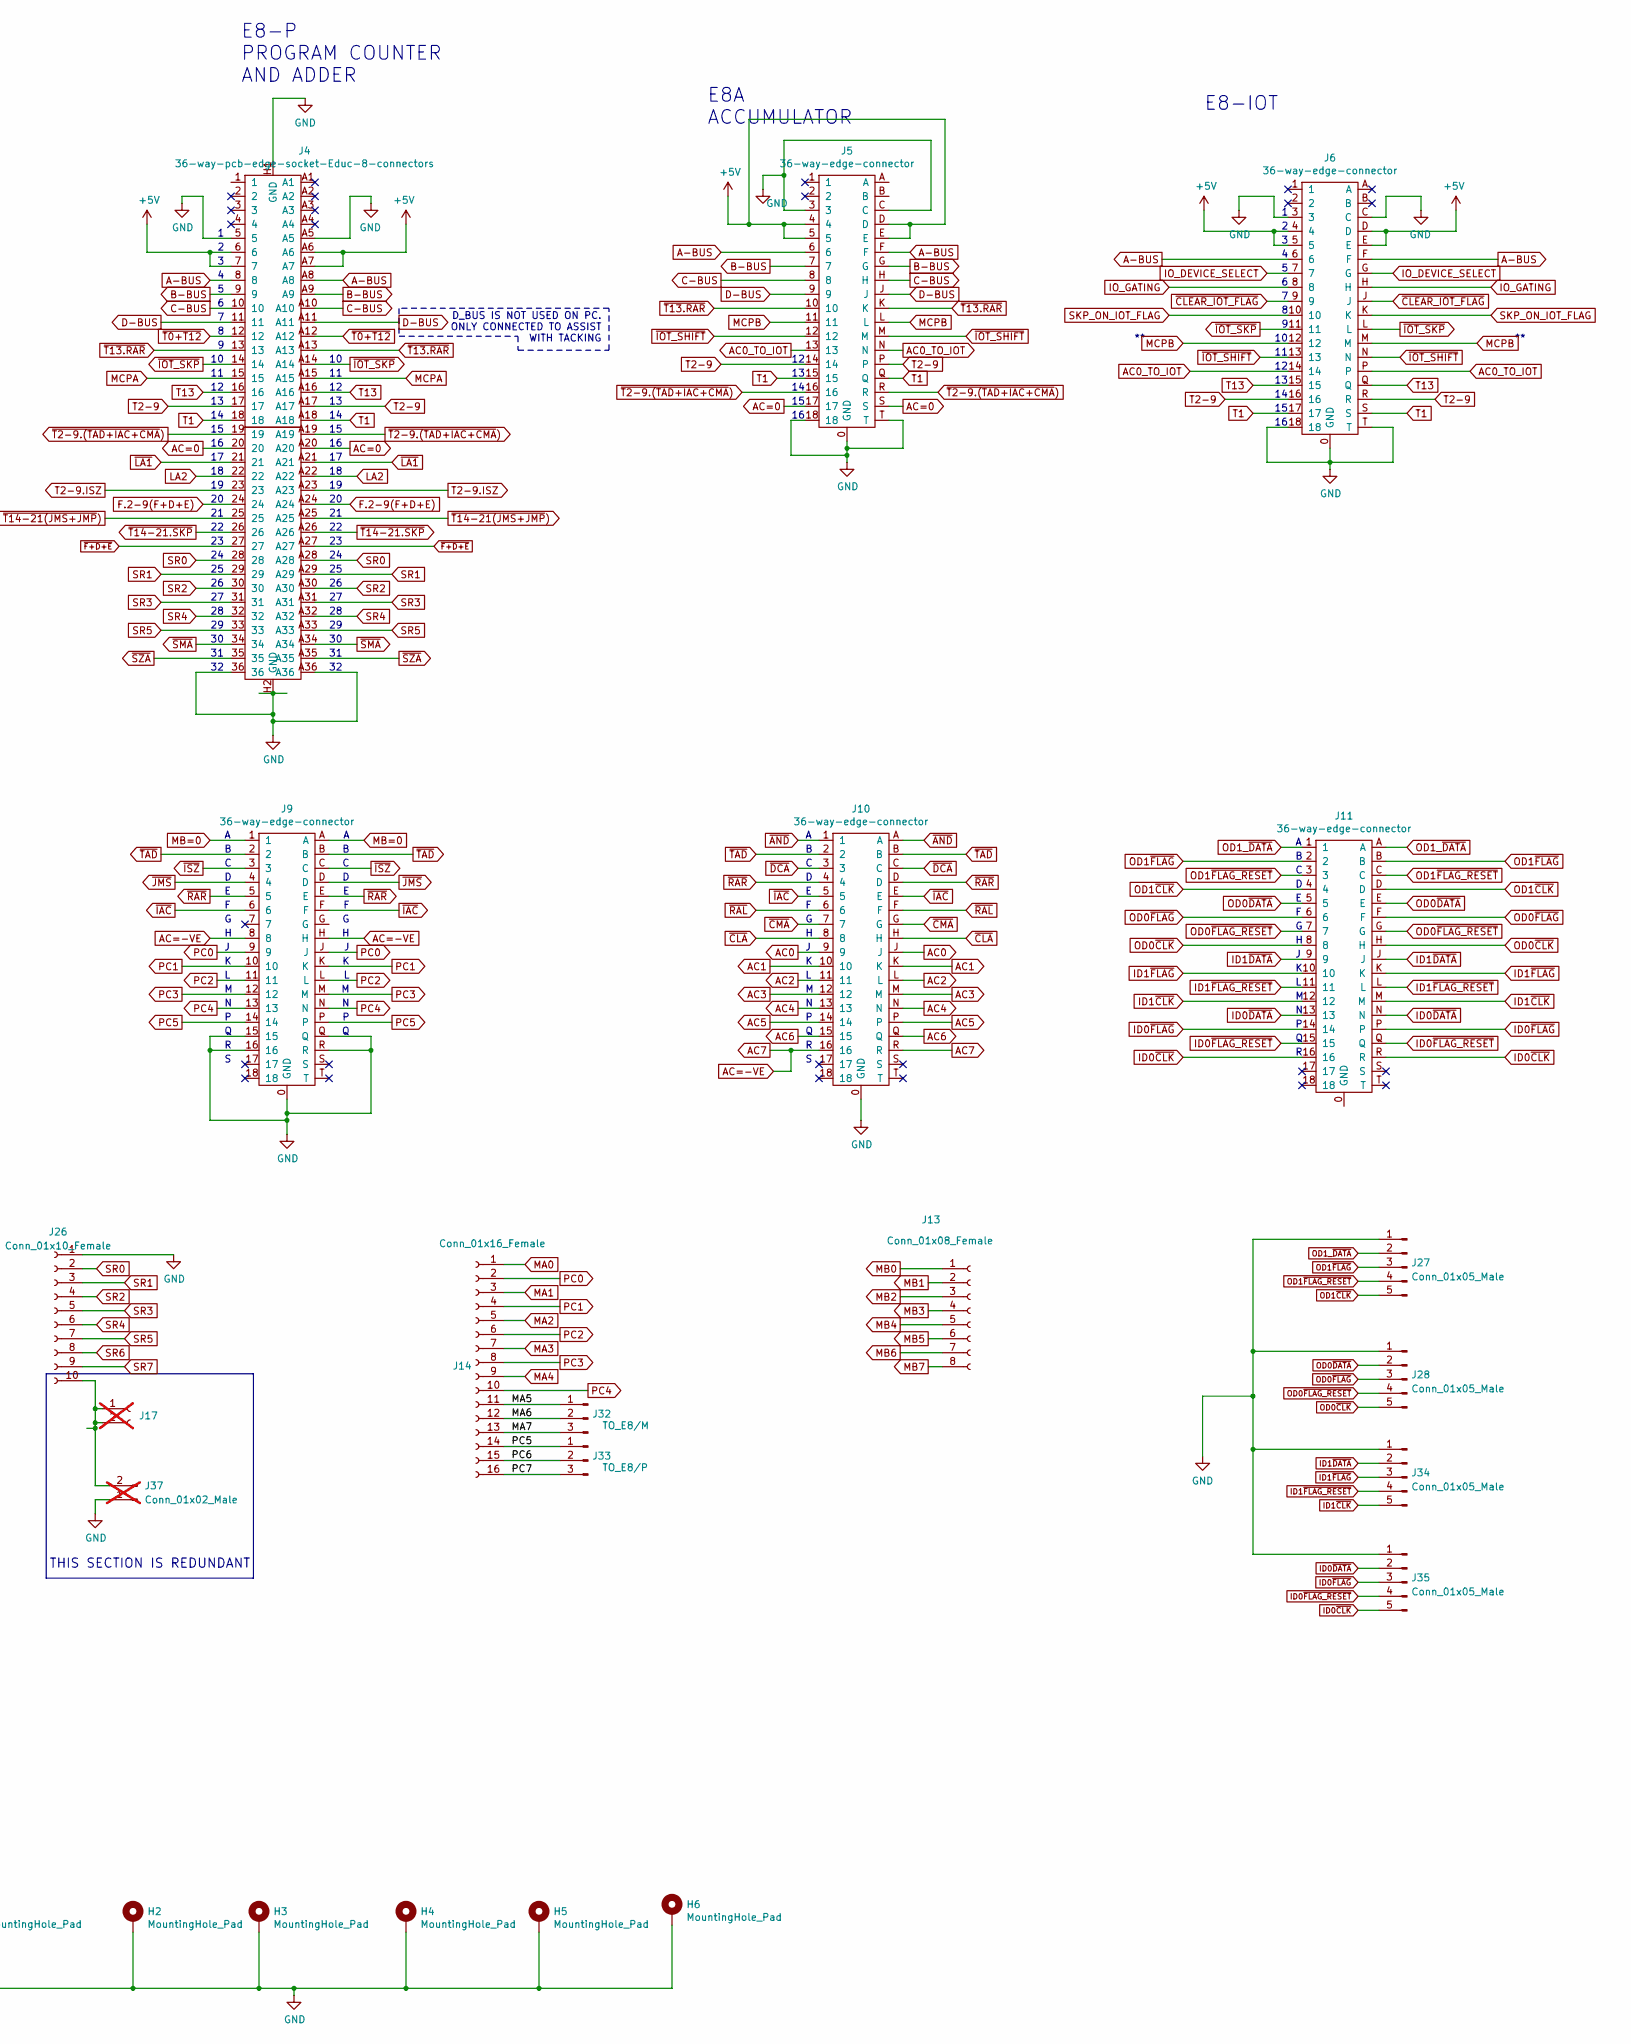
[picture p245: schematic motherboard.kicad_sch, EDUC-8 Motherboard, part in row 1, column 2]

Parts:
C1, C2, C3: 100nF; C_Disc_D8.0mm_W5.0mm_P7.50mm
H1, H2, H3, H4, H5, H6: MountingHole_Pad; MountingHole_3.2mm_M3_Pad_Via
J1: E8/T; 72_way_3.96mm_card_edge_socket
J2, J3, J4: 36-way-pcb-edge-socket-Educ-8-connectors; 72_way_3.96mm_card_edge_socket
J5, J6, J7, J8, J9, J10, J11: 36-way-edge-connector; 36_way_3.96mm_card_edge_socket
J12, J13, J19: Conn_01x08_Female; PinHeader_1x08_P2.54mm_Vertical
J14: Conn_01x16_Female; PinHeader_1x16_P2.54mm_Vertical
J15, J16, J18, J20, J21, J22, J23, J24: Conn_01x04_Female; PinHeader_1x04_P2.54mm_Vertical
J17: Conn_01x02_Female; PinSocket_1x02_P2.54mm_Vertical; not fitted
J25: TO E8/P
J26: Conn_01x10_Female; JST_XH_B10B-XH-AM_1x10_P2.50mm_Vertical
J27, J28, J34, J35: Conn_01x05_Male; JST_XH_B5B-XH-AM_1x05_P2.50mm_Vertical
J29, J36: Conn_01x02_Male; JST_XH_B2B-XH-AM_1x02_P2.50mm_Vertical
J30, J31: Conn_01x01_Female; Pin_D1.2mm_L10.2mm_W2.9mm_FlatFork
J32: TO_E8/M; JST_XA_B03B-XASK-1_1x03_P2.50mm_Vertical
J33: TO_E8/P; JST_XA_B03B-XASK-1_1x03_P2.50mm_Vertical
J37: Conn_01x02_Male; JST_XH_B2B-XH-AM_1x02_P2.50mm_Vertical; not fitted
R1, R2: 470R; R_Axial_DIN0207_L6.3mm_D2.5mm_P10.16mm_Horizontal
R3, R4: 680R; R_Axial_DIN0207_L6.3mm_D2.5mm_P10.16mm_Horizontal

Connections:
+5V: C1.1, C2.1, C3.1, J1.6, J1.A6, J2.6, J2.A6, J3.6, J3.7, J3.A6, J3.A7, J4.6, J4.7, J4.A6, J4.A7, J5.4, J5.5, J5.D, J5.E, J6.4, J6.5, J6.D, J6.E, J24.1, J24.2, J24.3, J24.4, J30.1, R1.2, R2.2, R3.2, R4.2
/MA5: J14.11, J32.1
/MA6: J14.12, J32.2
/MA7: J14.13, J32.3
/PC6: J14.15, J33.2
/PC7: J14.16, J33.3
A-BUS: J4.8, J4.A8, J5.6, J5.F, J6.6, J6.F, R1.1
AC0: J10.9, J10.J, J12.1
AC0_TO_IOT: J5.13, J5.N, J6.14, J6.P
AC1: J10.10, J10.K, J12.2
AC2: J10.11, J10.L, J12.3
AC3: J10.12, J10.M, J12.4
AC4: J10.13, J10.N, J12.5
AC5: J10.14, J10.P, J12.6
AC6: J10.15, J10.Q, J12.7
AC7: J9.8, J9.H, J10.16, J10.R, J12.8
AC=0: J4.20, J4.A20, J5.17, J5.S
B-BUS: J3.8, J3.A8, J4.9, J4.A9, J5.7, J5.G, R2.1
C-BUS: J3.9, J3.A9, J4.10, J4.A10, J5.8, J5.H, R3.1
D-BUS: J3.10, J3.A10, J4.11, J4.A11, J5.9, J5.J, R4.1
EXECUTE: J1.27, J1.A27, J2.25, J2.A25
F.2-9(F+D+E): J1.23, J1.A23, J3.19, J3.A19, J4.24, J4.A24
FAST_SLOW: J1.11, J1.A11, J22.4
FETCH: J1.25, J1.A25, J2.23, J2.A23
GND: C1.2, C2.2, C3.2, H1.1, H2.1, H3.1, H4.1, H5.1, H6.1, J1.5, J1.36, J1.A5, J1.A36, J1.H1 (GND), J1.H2 (GND), J2.5, J2.36, J2.A5, J2.A36, J2.H1 (GND), J2.H2 (GND), J3.5, J3.36, J3.A5, J3.A36, J3.H1 (GND), J3.H2 (GND), J4.5, J4.36, J4.A5, J4.A36, J4.H1 (GND), J4.H2 (GND), J5.0 (GND), J5.3, J5.18, J5.C, J5.T, J6.0 (GND), J6.3, J6.18, J6.C, J6.T, J7.0 (GND), J8.0 (GND), J9.0 (GND), J9.15, J9.16, J9.Q, J9.R, J10.0 (GND), J18.3, J18.4, J21.2, J21.3, J22.1, J26.1, J27.1, J28.1, J31.1, J34.1, J35.1, J37.1
HALT_COMMAND: J1.9, J1.A9, J22.3
ID0~CLK: J11.16, J11.R, J35.5
ID0~DATA: J11.13, J11.N, J35.2
ID0~FLAG_RESET: J11.15, J11.Q, J35.4
ID0~FLAG: J11.14, J11.P, J35.3
ID1~CLK: J11.12, J11.M, J34.5
ID1~DATA: J11.9, J11.J, J34.2
ID1~FLAG_RESET: J11.11, J11.L, J34.4
ID1~FLAG: J11.10, J11.K, J34.3
IO_DEVICE_SELECT: J2.8, J2.A8, J6.7, J6.G
IO_GATING: J2.9, J2.A9, J6.8, J6.H
JMS+DCA: J2.19, J2.A19, J3.22, J3.A22
LA2: J4.22, J4.A22, J23.1
MA0: J8.4, J8.D, J14.1
MA1: J8.5, J8.E, J14.3
MA2: J8.6, J8.F, J14.5
MA3: J8.7, J8.G, J14.7
MA4: J8.8, J8.H, J14.9
MB0: J7.9, J7.J, J8.9, J8.J, J13.1
MB1: J7.10, J7.K, J8.10, J8.K, J13.2
MB2: J7.11, J7.L, J8.11, J8.L, J13.3
MB3: J7.12, J7.M, J8.12, J8.M, J13.4
MB4: J1.35, J1.A35, J7.13, J7.N, J8.13, J8.N, J13.5
MB5: J7.14, J7.P, J8.14, J8.P, J13.6
MB6: J7.15, J7.Q, J8.15, J8.Q, J13.7
MB7: J7.16, J7.R, J8.16, J8.R, J13.8
MB=0: J8.1, J8.A, J9.1, J9.A
MCPA: J1.17, J1.A17, J4.15, J4.A15
MCPB: J1.15, J1.A15, J3.13, J3.A13, J5.11, J5.L, J6.12, J6.M
MEM.ENABLE: J2.27, J2.A27, J3.27, J3.A27
OD0~CLK: J11.8, J11.H, J28.5
OD0~DATA: J11.5, J11.E, J28.2
OD0~FLAG_RESET: J11.7, J11.G, J28.4
OD0~FLAG: J11.6, J11.F, J28.3
OD1_~DATA: J11.1, J11.A, J27.2
OD1~CLK: J11.4, J11.D, J27.5
OD1~FLAG_RESET: J11.3, J11.C, J27.4
OD1~FLAG: J11.2, J11.B, J27.3
OPR+IOT: J1.24, J1.A24, J2.20, J2.A20, J3.20, J3.A20
PC0: J9.9, J9.J, J14.2
PC1: J9.10, J9.K, J14.4
PC2: J9.11, J9.L, J14.6
PC3: J9.12, J9.M, J14.8
PC4: J9.13, J9.N, J14.10
PC5: J9.14, J9.P, J14.14, J33.1
SKP_ON_IOT_FLAG: J2.11, J2.A11, J6.10, J6.K
SR0: J3.28, J3.A28, J4.28, J4.A28, J19.1, J26.2
SR1: J3.29, J3.A29, J4.29, J4.A29, J19.2, J26.3
SR2: J3.30, J3.A30, J4.30, J4.A30, J19.3, J26.4
SR3: J3.31, J3.A31, J4.31, J4.A31, J19.4, J26.5
SR4: J3.32, J3.A32, J4.32, J4.A32, J19.5, J26.6
SR5: J3.33, J3.A33, J4.33, J4.A33, J19.6, J25.1, J26.7
SR6: J3.34, J3.A34, J19.7, J25.2, J26.8
SR7: J3.35, J3.A35, J19.8, J25.3, J26.9
T1: J1.20, J1.A20, J3.16, J3.A16, J4.18, J4.A18, J5.15, J5.Q, J6.17, J6.S
T2-9: J1.19, J1.A19, J2.16, J2.A16, J3.15, J3.A15, J4.17, J4.A17, J5.14, J5.P, J6.16, J6.R
T2-9.ISZ: J2.18, J2.A18, J3.17, J3.A17, J4.23, J4.A23
T13: J1.18, J1.A18, J3.14, J3.A14, J4.16, J4.A16, J6.15, J6.Q
T14-21: J1.16, J1.A16, J2.14, J2.A14
T14-21A: J1.14, J1.A14, J2.13, J2.A13, J3.12, J3.A12
T22.5: J1.7, J1.A7, J2.7, J2.A7
Z-BIT: J8.2, J8.B, J29.1, J29.2
~AND: J7.1, J7.A, J10.1, J10.A, J20.4
~CANCEL+DEP+EXM: J1.21, J1.A21, J18.2
~CLA: J2.35, J2.A35, J10.8, J10.H
~CLEAR_IOT_FLAG: J2.10, J2.A10, J6.9, J6.J
~CMA: J2.34, J2.A34, J10.7, J10.G
~DCA: J7.4, J7.D, J10.3, J10.C, J20.1
~DEFER: J1.33, J1.A33, J2.24, J2.A24, J16.2
~DEP+EXM: J1.10, J1.A10, J18.1
~DEP: J3.23, J3.A23, J21.4
~EXEC: J1.34, J1.A34, J16.1
~EXT.DEP: J23.2, J36.2
~F+D+E: J1.28, J1.A28, J2.26, J2.A26, J3.26, J3.A26, J4.27, J4.A27
~F.T23.OPR+IOT: J1.22, J1.A22, J3.18, J3.A18
~FETCH: J1.32, J1.A32, J16.3
~HLT: J2.28, J2.A28, J22.2
~IAC: J2.32, J2.A32, J9.6, J9.F, J10.5, J10.E
~IOT_SHIFT: J2.15, J2.A15, J5.12, J5.M, J6.13, J6.N
~IOT_SKP: J4.14, J4.A14, J6.11, J6.L
~IOT: J7.7, J7.G, J15.2
~ISZ: J7.3, J7.C, J8.3, J8.C, J9.3, J9.C, J20.2
~JMP: J7.6, J7.F, J15.3
~JMS: J7.5, J7.E, J9.4, J9.D, J15.4
~LA1: J4.21, J4.A21, J23.4
~OPR: J7.8, J7.H, J15.1
~RAL: J2.33, J2.A33, J10.6, J10.F
~RAR: J2.29, J2.A29, J9.5, J9.E, J10.4, J10.D
~RUN_COMMAND: J1.8, J1.A8, J21.1
~RUN: J1.31, J1.A31, J16.4
~SMA: J2.30, J2.A30, J4.34, J4.A34
~SZA: J2.31, J2.A31, J4.35, J4.A35
~T0+T12: J1.13, J1.A13, J4.12, J4.A12
~T0.5: J1.12, J1.A12, J2.12, J2.A12, J3.11, J3.A11
~T2-9.(TAD+IAC+CMA): J2.17, J2.A17, J4.19, J4.A19, J5.16, J5.R
~T13.RAR: J4.13, J4.A13, J5.10, J5.K
~T14-21(JMS+JMP): J2.21, J2.A21, J3.21, J3.A21, J4.25, J4.A25
~T14-21.SKP: J2.22, J2.A22, J4.26, J4.A26
~TAD: J7.2, J7.B, J9.2, J9.B, J10.2, J10.B, J20.3

Notes on the sheet:
On Motherboard
ADD LINK
CUT
E8-D DECODER
E8-M MEMORY
E8-IOT
E8-P PROGRAM COUNTER AND ADDER
D_BUS IS NOT USED ON PC. ONLY CONNECTED TO ASSIST WITH TACKING
THIS SECTION IS REDUNDANT
See Steven Pietrobon's paper on LS series resistor modifications
MODIFICATION TO MOTHERBARD PRIOR TO 2ND JUNE 2024
E8-T (TIMING)
Bus Terminating Resistors
E8A ACCUMULATOR

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
