ibm2030/EDUC8/motherboard/motherboard.kicad_pcb

## KiCad design motherboard/motherboard.kicad_pcb (continued)

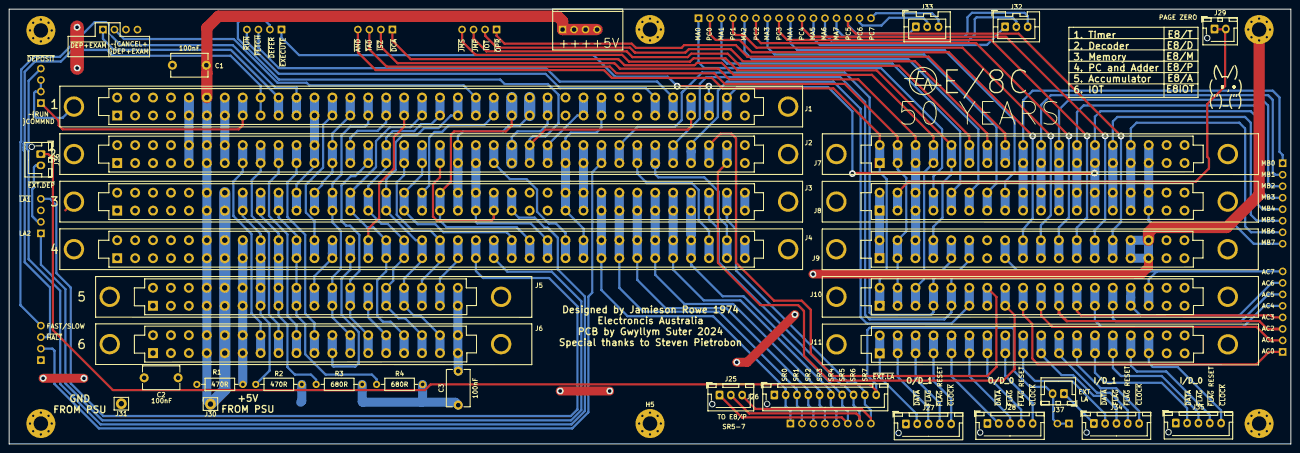
[picture p246: board motherboard.kicad_pcb from above]

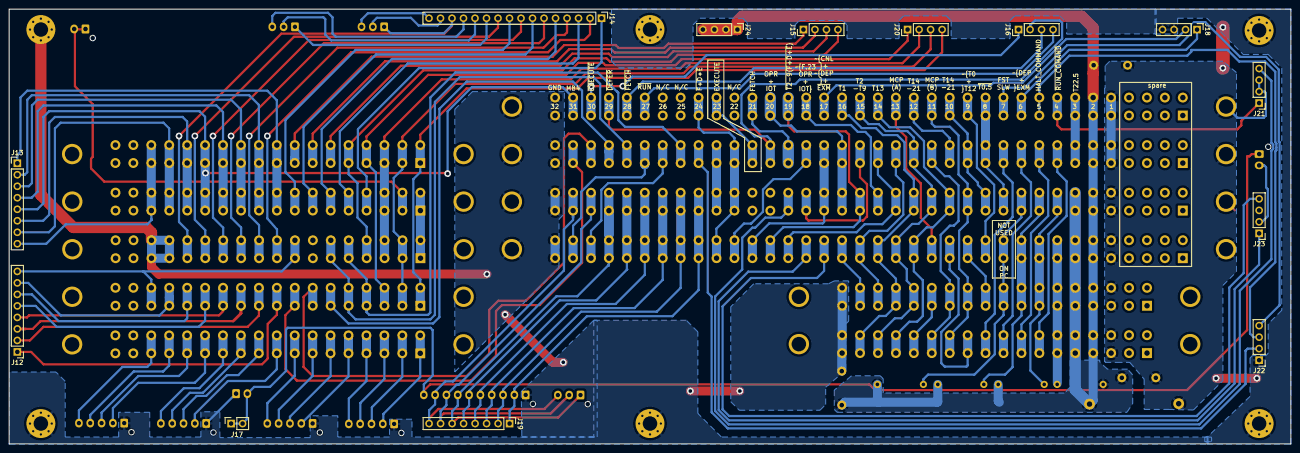
[picture p247: board motherboard.kicad_pcb from below]

Board: 2 copper layers, 283.0 x 96.0 mm, 50 parts (13 on the bottom side), 125 nets.
