ibm2030/EDUC8/EXTENDER CARDS/EXTENDER CARDS.kicad_pcb

## KiCad design EXTENDER CARDS/EXTENDER CARDS.kicad_pcb (2025-07-23)

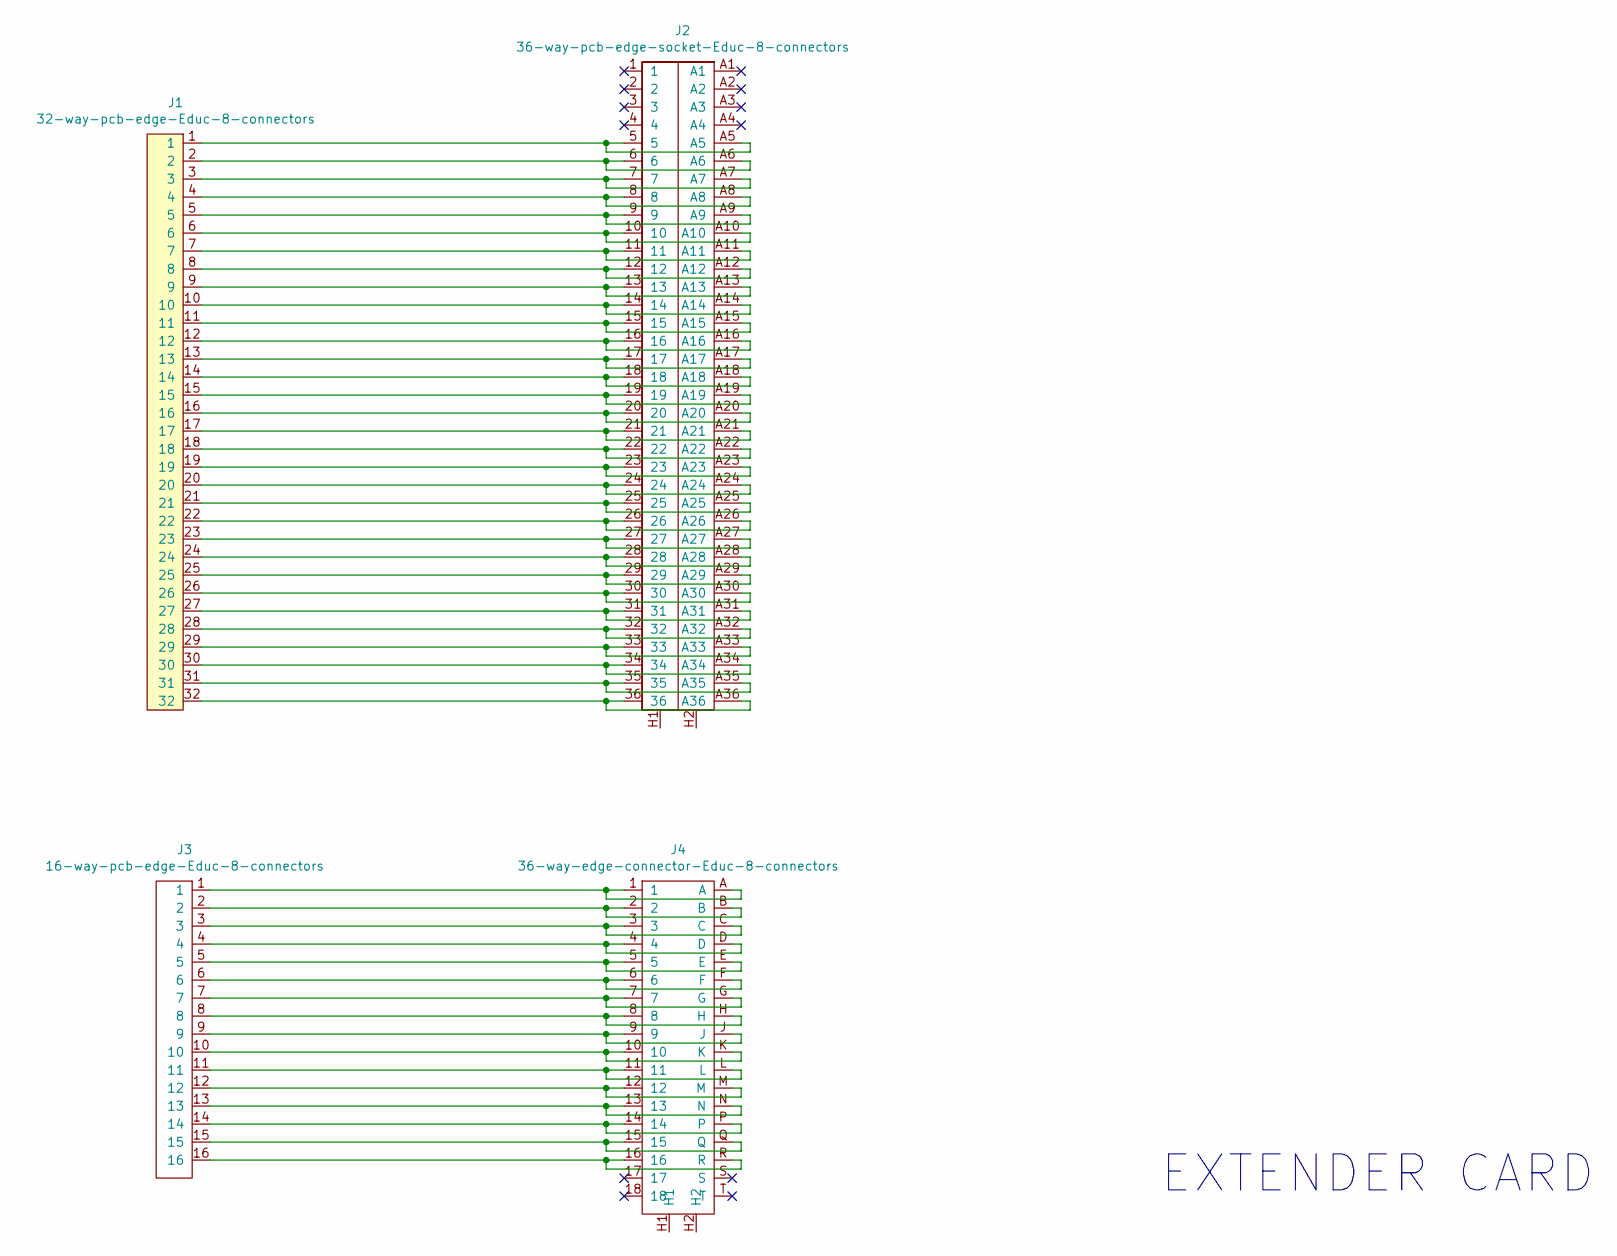
[picture p248: schematic EXTENDER CARDS.sch]

Parts:
J1: 32-way-pcb-edge-Educ-8-connectors; PCB_32pin
J2: 36-way-pcb-edge-socket-Educ-8-connectors; 72_way_3.96mm_card_edge_socket
J3: 16-way-pcb-edge-Educ-8-connectors; PCB_16pin
J4: 36-way-edge-connector-Educ-8-connectors; 36_way_3.96mm_card_edge_socket

Connections:
unnamed: J1.1, J2.5, J2.A5
unnamed: J1.2, J2.6, J2.A6
unnamed: J1.3, J2.7, J2.A7
unnamed: J1.4, J2.8, J2.A8
unnamed: J1.5, J2.9, J2.A9
unnamed: J1.6, J2.10, J2.A10
unnamed: J1.7, J2.11, J2.A11
unnamed: J1.8, J2.12, J2.A12
unnamed: J1.9, J2.13, J2.A13
unnamed: J1.10, J2.14, J2.A14
unnamed: J1.11, J2.15, J2.A15
unnamed: J1.12, J2.16, J2.A16
unnamed: J1.13, J2.17, J2.A17
unnamed: J1.14, J2.18, J2.A18
unnamed: J1.15, J2.19, J2.A19
unnamed: J1.16, J2.20, J2.A20
unnamed: J1.17, J2.21, J2.A21
unnamed: J1.18, J2.22, J2.A22
unnamed: J1.19, J2.23, J2.A23
unnamed: J1.20, J2.24, J2.A24
unnamed: J1.21, J2.25, J2.A25
unnamed: J1.22, J2.26, J2.A26
unnamed: J1.23, J2.27, J2.A27
unnamed: J1.24, J2.28, J2.A28
unnamed: J1.25, J2.29, J2.A29
unnamed: J1.26, J2.30, J2.A30
unnamed: J1.27, J2.31, J2.A31
unnamed: J1.28, J2.32, J2.A32
unnamed: J1.29, J2.33, J2.A33
unnamed: J1.30, J2.34, J2.A34
unnamed: J1.31, J2.35, J2.A35
unnamed: J1.32, J2.36, J2.A36
unnamed: J3.1, J4.1, J4.A
unnamed: J3.2, J4.2, J4.B
unnamed: J3.3, J4.3, J4.C
unnamed: J3.4, J4.4, J4.D
unnamed: J3.5, J4.5, J4.E
unnamed: J3.6, J4.6, J4.F
unnamed: J3.7, J4.7, J4.G
unnamed: J3.8, J4.8, J4.H
unnamed: J3.9, J4.9, J4.J
unnamed: J3.10, J4.10, J4.K
unnamed: J3.11, J4.11, J4.L
unnamed: J3.12, J4.12, J4.M
unnamed: J3.13, J4.13, J4.N
unnamed: J3.14, J4.14, J4.P
unnamed: J3.15, J4.15, J4.Q
unnamed: J3.16, J4.16, J4.R
unnamed: J4.17, J4.S
unnamed: J4.18, J4.T

Notes on the sheet:
EXTENDER CARD

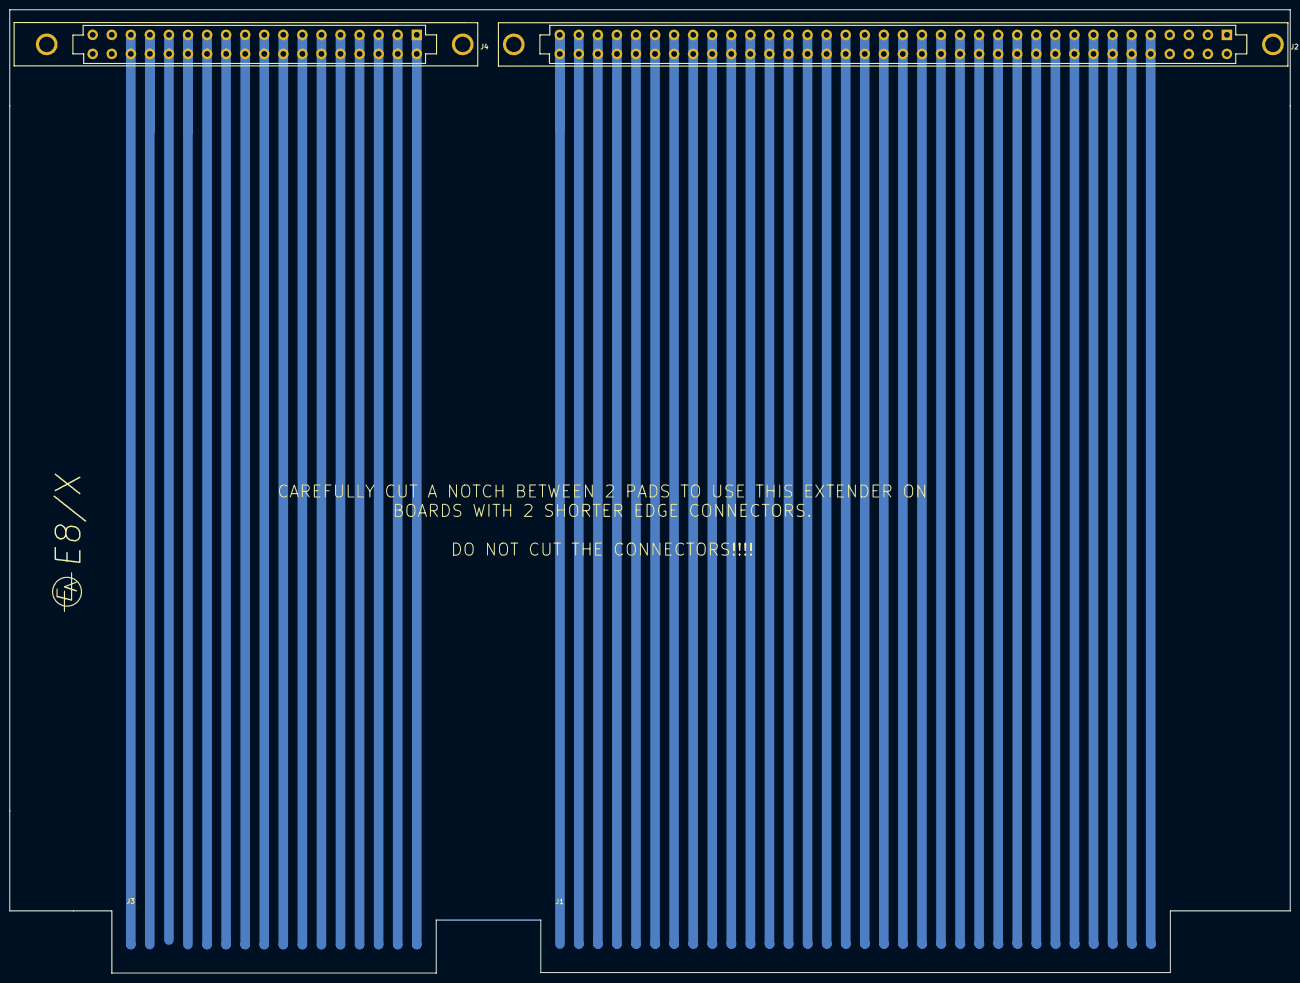
[picture p249: board EXTENDER CARDS.kicad_pcb from above]

Board: 2 copper layers, 266.0 x 200.1 mm, 4 parts (0 on the bottom side), 50 nets.
