ibm2030/EDUC8/Original with 9602/front panel 9602.kicad_pcb

## KiCad design Original with 9602/front panel 9602.kicad_pcb (2025-07-23)

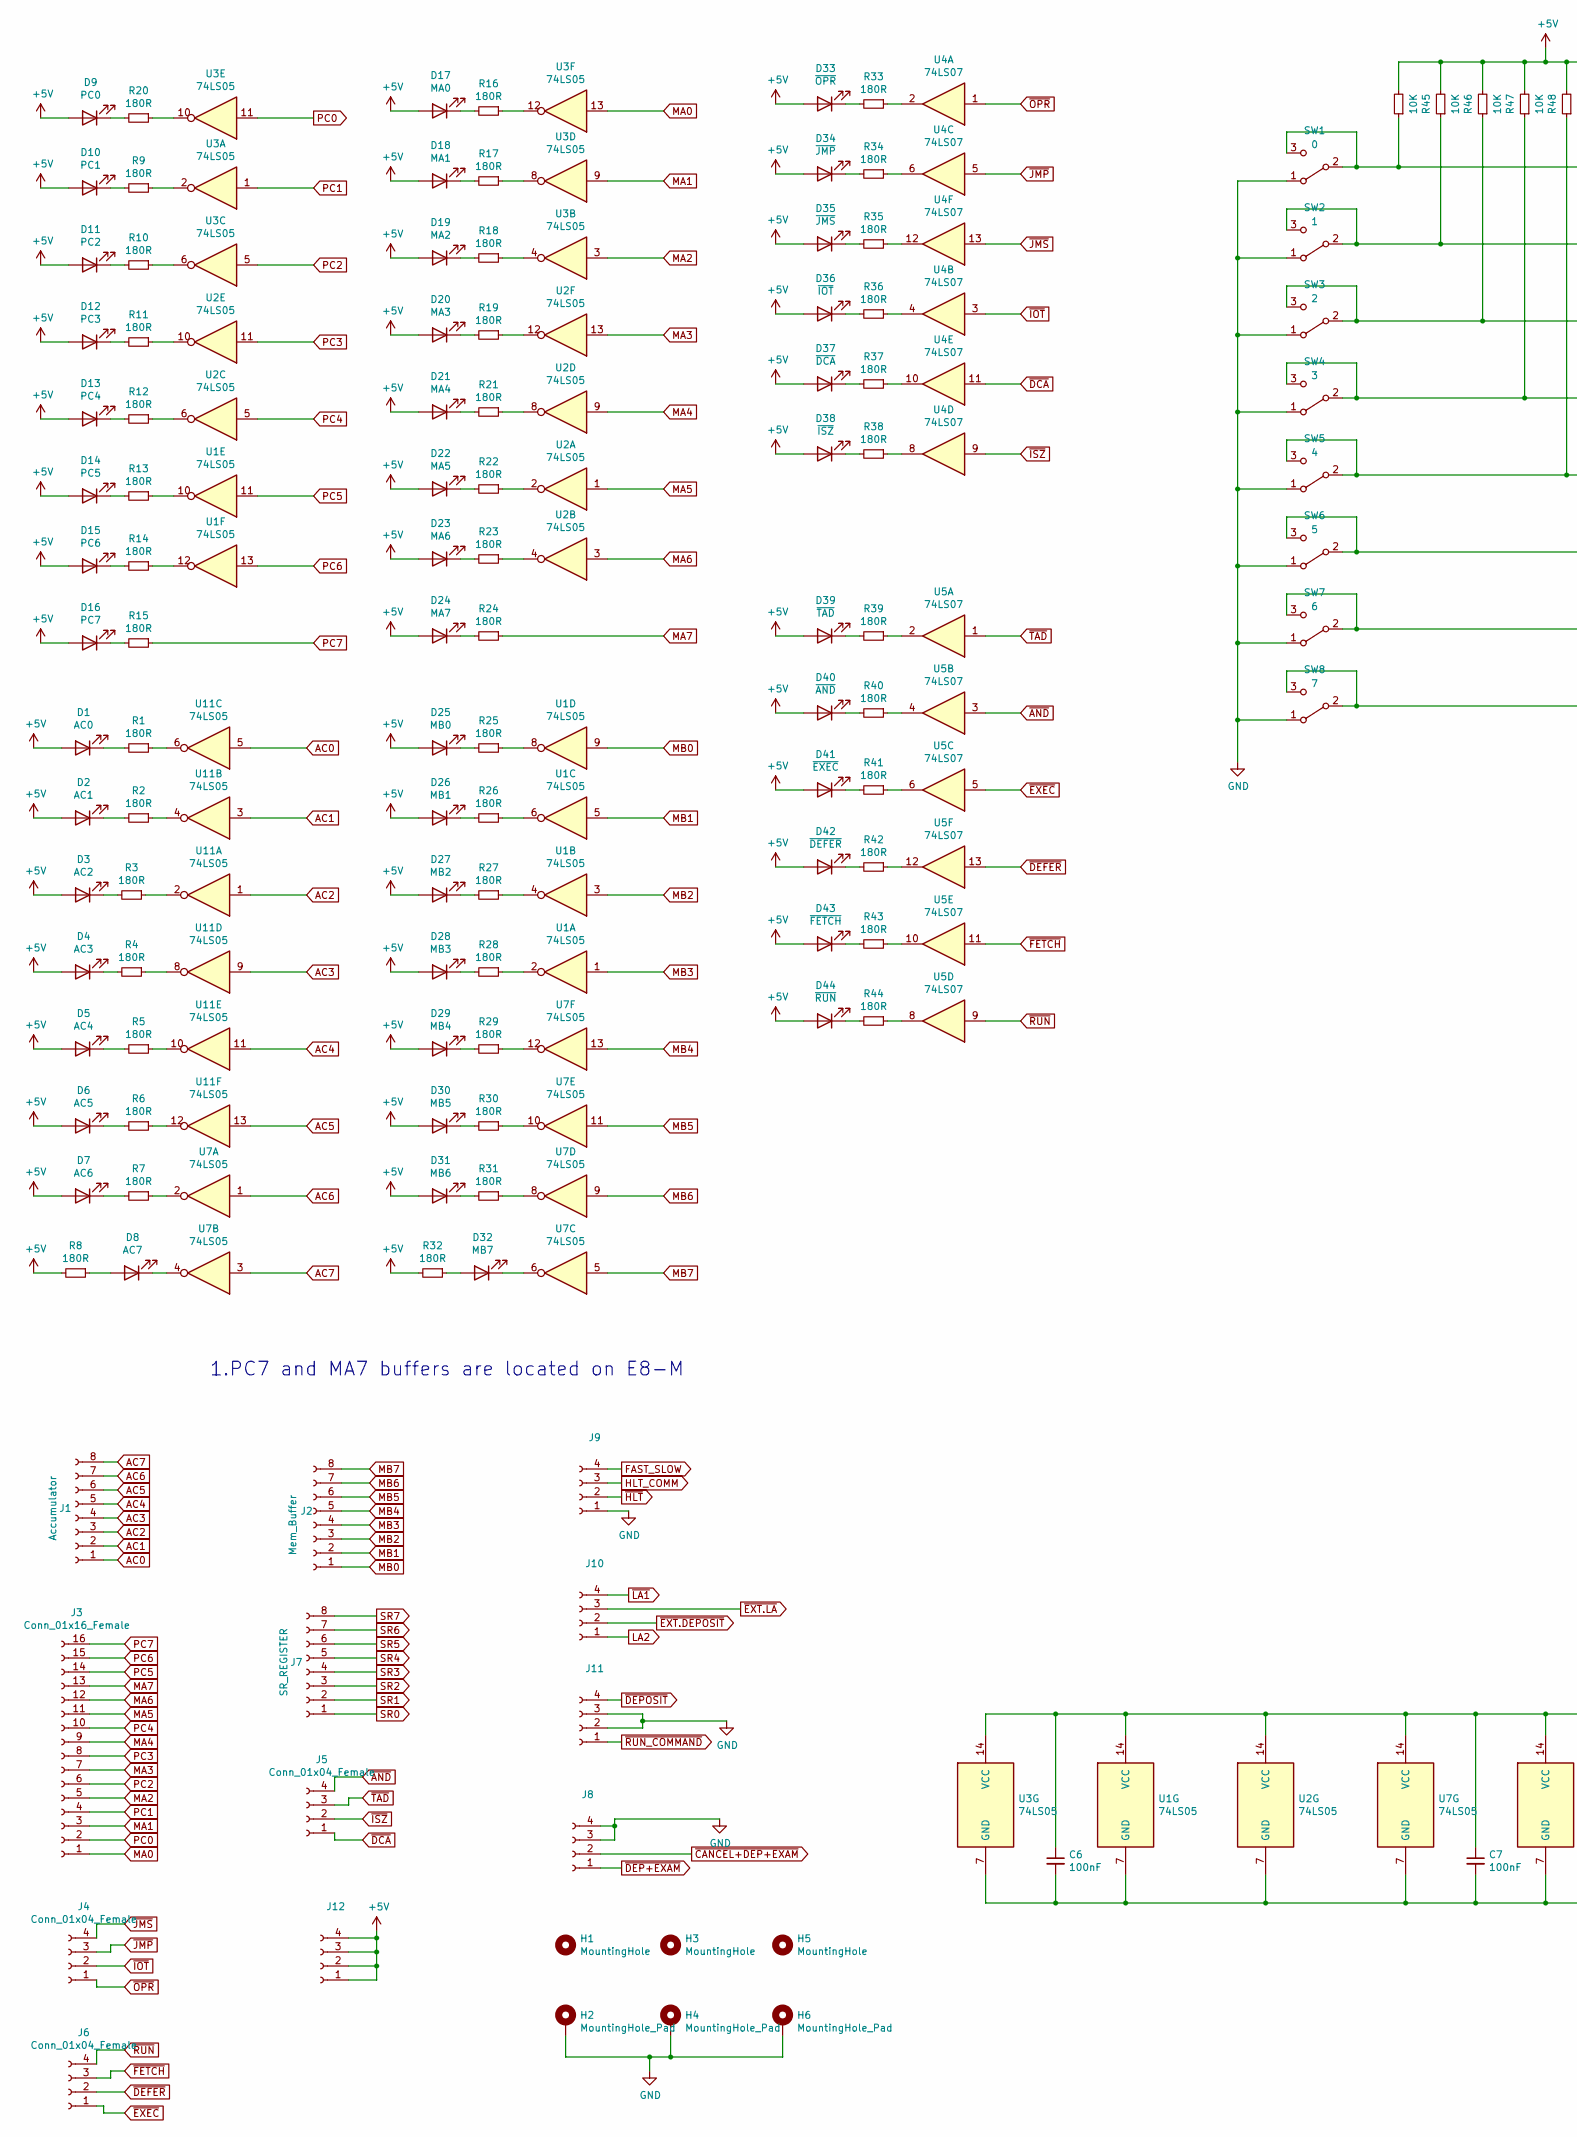
[picture p250: schematic front panel 9602.kicad_sch, EDUC-8 FRONT PANEL, part in row 1, column 1]

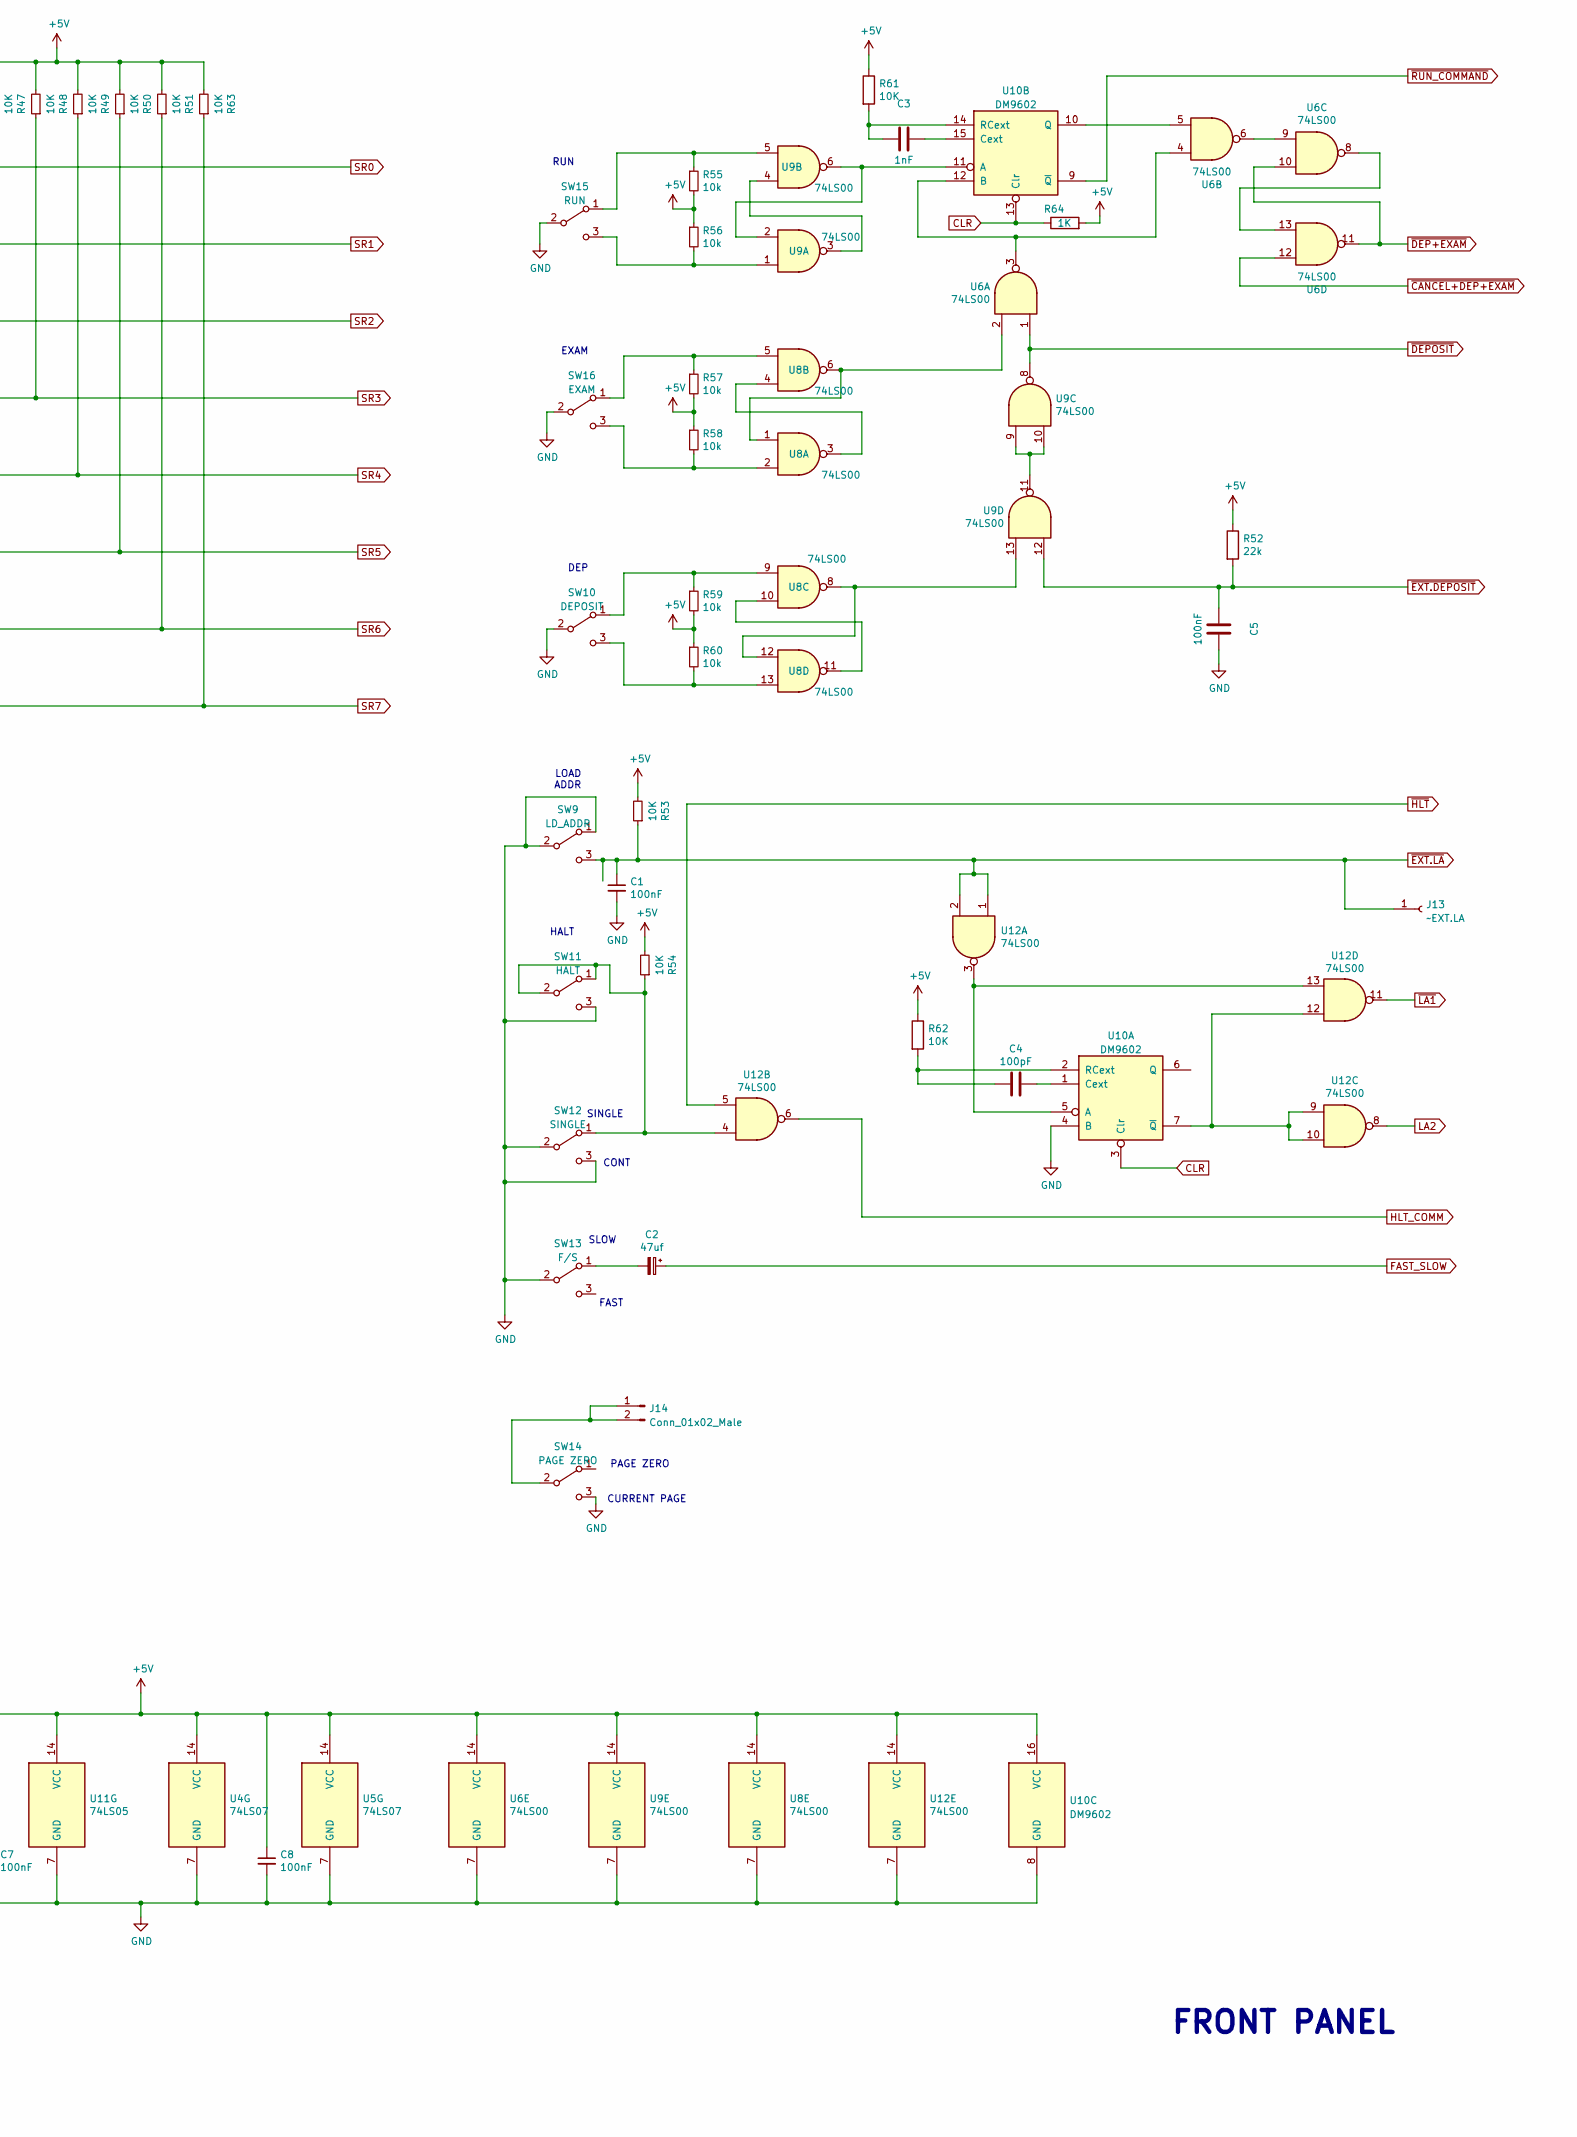
[picture p251: schematic front panel 9602.kicad_sch, EDUC-8 FRONT PANEL, part in row 1, column 2]

Parts:
C1, C5: 100nF; C_Disc_D4.3mm_W1.9mm_P5.00mm
C2: 47uf; CP_Axial_L10.0mm_D6.0mm_P15.00mm_Horizontal
C3: 1nF; C_Disc_D4.3mm_W1.9mm_P5.00mm
C4: 100pF; C_Disc_D4.3mm_W1.9mm_P5.00mm
C6, C7, C8: 100nF; C_Disc_D5.0mm_W2.5mm_P5.00mm
D1: AC0; LED_D5.0mm
D2: AC1; LED_D5.0mm
D3: AC2; LED_D5.0mm
D4: AC3; LED_D5.0mm
D5: AC4; LED_D5.0mm
D6: AC5; LED_D5.0mm
D7: AC6; LED_D5.0mm
D8: AC7; LED_D5.0mm
D9: PC0; LED_D5.0mm
D10: PC1; LED_D5.0mm
D11: PC2; LED_D5.0mm
D12: PC3; LED_D5.0mm
D13: PC4; LED_D5.0mm
D14: PC5; LED_D5.0mm
D15: PC6; LED_D5.0mm
D16: PC7; LED_D5.0mm
D17: MA0; LED_D5.0mm
D18: MA1; LED_D5.0mm
D19: MA2; LED_D5.0mm
D20: MA3; LED_D5.0mm
D21: MA4; LED_D5.0mm
D22: MA5; LED_D5.0mm
D23: MA6; LED_D5.0mm
D24: MA7; LED_D5.0mm
D25: MB0; LED_D5.0mm
D26: MB1; LED_D5.0mm
D27: MB2; LED_D5.0mm
D28: MB3; LED_D5.0mm
D29: MB4; LED_D5.0mm
D30: MB5; LED_D5.0mm
D31: MB6; LED_D5.0mm
D32: MB7; LED_D5.0mm
D33: ~{OPR}; LED_D5.0mm
D34: ~{JMP}; LED_D5.0mm
D35: ~{JMS}; LED_D5.0mm
D36: ~{IOT}; LED_D5.0mm
D37: ~{DCA}; LED_D5.0mm
D38: ~{ISZ}; LED_D5.0mm
D39: ~{TAD}; LED_D5.0mm
D40: ~{AND}; LED_D5.0mm
D41: ~{EXEC}; LED_D5.0mm
D42: ~{DEFER}; LED_D5.0mm
D43: ~{FETCH}; LED_D5.0mm
D44: ~{RUN}; LED_D5.0mm
H1, H3, H5: MountingHole; MountingHole_3.2mm_M3
H2, H4, H6: MountingHole_Pad; MountingHole_3.2mm_M3_Pad_Via
J1: Accumulator; PinSocket_1x08_P2.54mm_Vertical
J2: Mem_Buffer; PinSocket_1x08_P2.54mm_Vertical
J3: Conn_01x16_Female; PinSocket_1x16_P2.54mm_Vertical
J4, J5, J6, J8, J9, J10, J11, J12: Conn_01x04_Female; PinSocket_1x04_P2.54mm_Vertical
J7: SR_REGISTER; PinSocket_1x08_P2.54mm_Vertical
J13: ~EXT.LA; PinSocket_1x01_P2.54mm_Vertical
J14: Conn_01x02_Male; JST_XH_B2B-XH-A_1x02_P2.50mm_Vertical
R1, R2, R3, R4, R5, R6, R7, R8, R9, R10, R11, R12, R13, R14, R15, R16, R17, R18, R19, R20, R21, R22, R24, R25, R26, R27, R28, R29, R30, R31, R32, R33, R34, R35, R36, R37, R38, R39, R40, R41, R42, R43, R44: 180R; R_Axial_DIN0207_L6.3mm_D2.5mm_P10.16mm_Horizontal
R23: 180R; R_Axial_DIN0207_L6.3mm_D2.5mm_P15.24mm_Horizontal
R45, R46, R47, R48, R49, R50, R51, R53, R54, R61, R62, R63: 10K; R_Axial_DIN0207_L6.3mm_D2.5mm_P10.16mm_Horizontal
R52: 22k; R_Axial_DIN0207_L6.3mm_D2.5mm_P10.16mm_Horizontal
R55, R56, R57, R58, R59, R60: 10k; R_Axial_DIN0207_L6.3mm_D2.5mm_P10.16mm_Horizontal
R64: 1K; R_Axial_DIN0207_L6.3mm_D2.5mm_P10.16mm_Horizontal
SW1: 0; SPDT_toggle_switch_wired
SW2: 1; SPDT_toggle_switch_wired
SW3: 2; SPDT_toggle_switch_wired
SW4: 3; SPDT_toggle_switch_wired
SW5: 4; SPDT_toggle_switch_wired
SW6: 5; SPDT_toggle_switch_wired
SW7: 6; SPDT_toggle_switch_wired
SW8: 7; SPDT_toggle_switch_wired
SW9: LD_ADDR; SPDT_toggle_switch_wired
SW10: DEPOSIT; SPDT_toggle_switch_wired
SW11: HALT; SPDT_toggle_switch_wired
SW12: SINGLE; SPDT_toggle_switch_wired
SW13: F/S; SPDT_toggle_switch_wired
SW14: PAGE ZERO; SPDT_toggle_switch_wired
SW15: RUN; SPDT_toggle_switch_wired
SW16: EXAM; SPDT_toggle_switch_wired
U1, U3, U7, U11: 74LS05; DIP-14_W7.62mm_LongPads
U2: 74LS05; DIP-14_W7.62mm
U4, U5: 74LS07; DIP-14_W7.62mm_LongPads
U6, U8, U9, U12: 74LS00; DIP-14_W7.62mm_LongPads
U10: DM9602; DIP-16_W7.62mm_Socket_LongPads

Connections:
+5V: C6.1, C7.1, C8.1, D1.2 (A), D2.2 (A), D3.2 (A), D4.2 (A), D5.2 (A), D6.2 (A), D7.2 (A), D9.2 (A), D10.2 (A), D11.2 (A), D12.2 (A), D13.2 (A), D14.2 (A), D15.2 (A), D16.2 (A), D17.2 (A), D18.2 (A), D19.2 (A), D20.2 (A), D21.2 (A), D22.2 (A), D23.2 (A), D24.2 (A), D25.2 (A), D26.2 (A), D27.2 (A), D28.2 (A), D29.2 (A), D30.2 (A), D31.2 (A), D33.2 (A), D34.2 (A), D35.2 (A), D36.2 (A), D37.2 (A), D38.2 (A), D39.2 (A), D40.2 (A), D41.2 (A), D42.2 (A), D43.2 (A), D44.2 (A), J12.1, J12.2, J12.3, J12.4, R8.2, R32.2, R45.2, R46.2, R47.2, R48.2, R49.2, R50.2, R51.2, R52.1, R53.2, R54.2, R55.2, R56.1, R57.2, R58.1, R59.2, R60.1, R61.1, R62.1, R63.2, R64.2, U1.14 (VCC), U2.14 (VCC), U3.14 (VCC), U4.14 (VCC), U5.14 (VCC), U6.14 (VCC), U7.14 (VCC), U8.14 (VCC), U9.14 (VCC), U10.16 (VCC), U11.14 (VCC), U12.14 (VCC)
AC0: J1.1, U11.5
AC1: J1.2, U11.3
AC2: J1.3, U11.1
AC3: J1.4, U11.9
AC4: J1.5, U11.11
AC5: J1.6, U11.13
AC6: J1.7, U7.1
AC7: J1.8, U7.3
CLR: R64.1, U10.3 (Clr), U10.13 (Clr)
FAST_SLOW: C2.1, J9.4
GND: C1.2, C5.1, C6.2, C7.2, C8.2, H2.1, H4.1, H6.1, J8.3, J8.4, J9.1, J11.2, J11.3, SW1.1 (A), SW2.1 (A), SW3.1 (A), SW4.1 (A), SW5.1 (A), SW6.1 (A), SW7.1 (A), SW8.1 (A), SW9.1 (A), SW9.2 (B), SW10.2 (B), SW11.3 (C), SW12.2 (B), SW12.3 (C), SW13.2 (B), SW14.3 (C), SW15.2 (B), SW16.2 (B), U1.7 (GND), U2.7 (GND), U3.7 (GND), U4.7 (GND), U5.7 (GND), U6.7 (GND), U7.7 (GND), U8.7 (GND), U9.7 (GND), U10.4 (B), U10.8 (GND), U11.7 (GND), U12.7 (GND)
HLT_COMM: J9.3, U12.6
LA2: J10.1, U12.8
MA0: J3.1, U3.13
MA1: J3.3, U3.9
MA2: J3.5, U3.3
MA3: J3.7, U2.13
MA4: J3.9, U2.9
MA5: J3.11, U2.1
MA6: J3.12, U2.3
MA7: J3.13, R24.1
MB0: J2.1, U1.9
MB1: J2.2, U1.5
MB2: J2.3, U1.3
MB3: J2.4, U1.1
MB4: J2.5, U7.13
MB5: J2.6, U7.11
MB6: J2.7, U7.9
MB7: J2.8, U7.5
unnamed: C3.1, U10.15 (Cext)
unnamed: C3.2, R61.2, U10.14 (RCext)
unnamed: C4.1, U10.1 (Cext)
unnamed: C4.2, R62.2, U10.2 (RCext)
unnamed: D1.1 (K), R1.2
unnamed: D2.1 (K), R2.2
unnamed: D3.1 (K), R3.2
unnamed: D4.1 (K), R4.2
unnamed: D5.1 (K), R5.2
unnamed: D6.1 (K), R6.2
unnamed: D7.1 (K), R7.2
unnamed: D8.1 (K), U7.4
unnamed: D8.2 (A), R8.1
unnamed: D9.1 (K), R20.2
unnamed: D10.1 (K), R9.2
unnamed: D11.1 (K), R10.2
unnamed: D12.1 (K), R11.2
unnamed: D13.1 (K), R12.2
unnamed: D14.1 (K), R13.2
unnamed: D15.1 (K), R14.2
unnamed: D16.1 (K), R15.2
unnamed: D17.1 (K), R16.2
unnamed: D18.1 (K), R17.2
unnamed: D19.1 (K), R18.2
unnamed: D20.1 (K), R19.2
unnamed: D21.1 (K), R21.2
unnamed: D22.1 (K), R22.2
unnamed: D23.1 (K), R23.2
unnamed: D24.1 (K), R24.2
unnamed: D25.1 (K), R25.2
unnamed: D26.1 (K), R26.2
unnamed: D27.1 (K), R27.2
unnamed: D28.1 (K), R28.2
unnamed: D29.1 (K), R29.2
unnamed: D30.1 (K), R30.2
unnamed: D31.1 (K), R31.2
unnamed: D32.1 (K), U7.6
unnamed: D32.2 (A), R32.1
unnamed: D33.1 (K), R33.2
unnamed: D34.1 (K), R34.2
unnamed: D35.1 (K), R35.2
unnamed: D36.1 (K), R36.2
unnamed: D37.1 (K), R37.2
unnamed: D38.1 (K), R38.2
unnamed: D39.1 (K), R39.2
unnamed: D40.1 (K), R40.2
unnamed: D41.1 (K), R41.2
unnamed: D42.1 (K), R42.2
unnamed: D43.1 (K), R43.2
unnamed: D44.1 (K), R44.2
unnamed: R1.1, U11.6
unnamed: R2.1, U11.4
unnamed: R3.1, U11.2
unnamed: R4.1, U11.8
unnamed: R5.1, U11.10
unnamed: R6.1, U11.12
unnamed: R7.1, U7.2
unnamed: R9.1, U3.2
unnamed: R10.1, U3.6
unnamed: R11.1, U2.10
unnamed: R12.1, U2.6
unnamed: R13.1, U1.10
unnamed: R14.1, U1.12
unnamed: R16.1, U3.12
unnamed: R17.1, U3.8
unnamed: R18.1, U3.4
unnamed: R19.1, U2.12
unnamed: R20.1, U3.10
unnamed: R21.1, U2.8
unnamed: R22.1, U2.2
unnamed: R23.1, U2.4
unnamed: R25.1, U1.8
unnamed: R26.1, U1.6
unnamed: R27.1, U1.4
unnamed: R28.1, U1.2
unnamed: R29.1, U7.12
unnamed: R30.1, U7.10
unnamed: R31.1, U7.8
unnamed: R33.1, U4.2
unnamed: R34.1, U4.6
unnamed: R35.1, U4.12
unnamed: R36.1, U4.4
unnamed: R37.1, U4.10
unnamed: R38.1, U4.8
unnamed: R39.1, U5.2
unnamed: R40.1, U5.4
unnamed: R41.1, U5.6
unnamed: R42.1, U5.12
unnamed: R43.1, U5.10
unnamed: R44.1, U5.8
unnamed: R54.1, SW11.1 (A), SW11.2 (B), SW12.1 (A), U12.4
unnamed: R55.1, SW15.1 (A), U9.5
unnamed: R56.2, SW15.3 (C), U9.1
unnamed: R57.1, SW16.1 (A), U8.5
unnamed: R58.2, SW16.3 (C), U8.2
unnamed: R59.1, SW10.1 (A), U8.9
unnamed: R60.2, SW10.3 (C), U8.13
unnamed: J14.1, J14.2, SW14.2 (B)
unnamed: U6.2, U8.1, U8.6
unnamed: U6.6, U6.9
unnamed: U6.8, U6.13
unnamed: U8.3, U8.4
unnamed: U8.10, U8.11
unnamed: U8.8, U8.12, U9.13
unnamed: U9.3, U9.4
unnamed: U9.9, U9.10, U9.11
unnamed: U10.5 (A), U12.3, U12.13
unnamed: U10.7 (~Q), U12.9, U12.10, U12.12
unnamed: U6.5, U10.10 (Q)
unnamed: U9.2, U9.6, U10.11 (A)
unnamed: U6.3, U6.4, U10.12 (B)
PC0: J3.2, U3.11
PC1: J3.4, U3.1
PC2: J3.6, U3.5
PC3: J3.8, U2.11
PC4: J3.10, U2.5
PC5: J3.14, U1.11
PC6: J3.15, U1.13
PC7: J3.16, R15.1
SR0: J7.1, R45.1, SW1.2 (B), SW1.3 (C)
SR1: J7.2, R46.1, SW2.2 (B), SW2.3 (C)
SR2: J7.3, R47.1, SW3.2 (B), SW3.3 (C)
SR3: J7.4, R48.1, SW4.2 (B), SW4.3 (C)
SR4: J7.5, R49.1, SW5.2 (B), SW5.3 (C)
SR5: J7.6, R50.1, SW6.2 (B), SW6.3 (C)
SR6: J7.7, R51.1, SW7.2 (B), SW7.3 (C)
SR7: J7.8, R63.1, SW8.2 (B), SW8.3 (C)
~AND: J5.4, U5.3
~CANCEL+DEP+EXAM: J8.2, U6.12
~DCA: J5.1, U4.11
~DEFER: J6.2, U5.13
~DEP+EXAM: J8.1, U6.10, U6.11
~DEPOSIT: J11.4, U6.1, U9.8
~EXEC: J6.1, U5.5
~EXT.DEPOSIT: C5.2, J10.2, R52.2, U9.12
~EXT.LA: C1.1, J10.3, J13.1, R53.1, SW9.3 (C), U12.1, U12.2
~FETCH: J6.3, U5.11
~HLT: J9.2, U12.5
~IOT: J4.2, U4.3
~ISZ: J5.2, U4.9
~JMP: J4.3, U4.5
~JMS: J4.4, U4.13
~LA1: J10.4, U12.11
~OPR: J4.1, U4.1
~RUN_COMMAND: J11.1, U10.9 (~Q)
~RUN: J6.4, U5.9
~TAD: J5.3, U5.1

Notes on the sheet:
SINGLE
PAGE ZERO
1.PC7 and MA7 buffers are located on E8-M
EXAM
HALT
CONT
FAST
FRONT PANEL
RUN
SLOW
CURRENT PAGE
LOAD ADDR
DEP

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
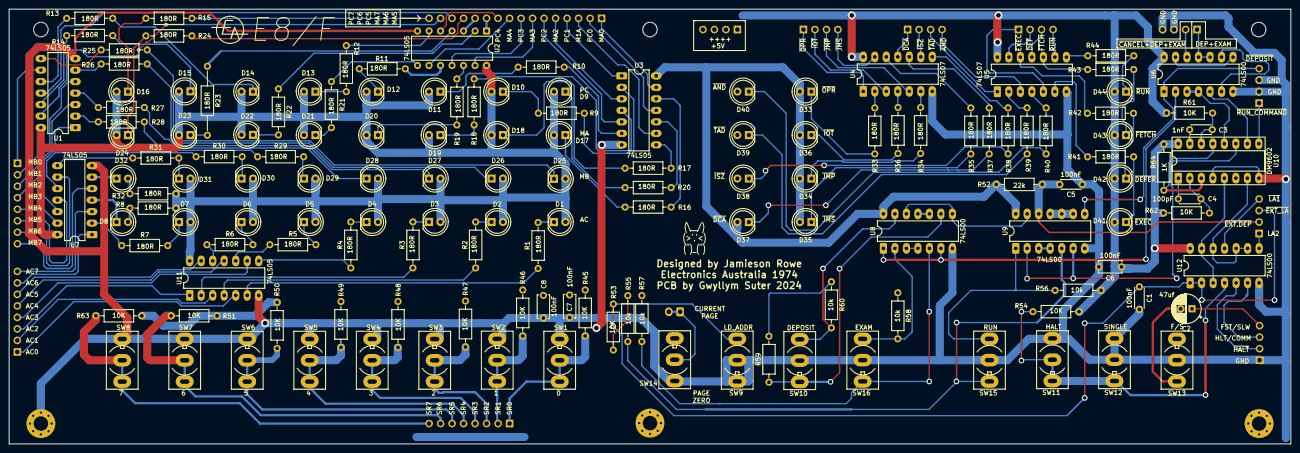
[picture p252: board front panel 9602.kicad_pcb from above]

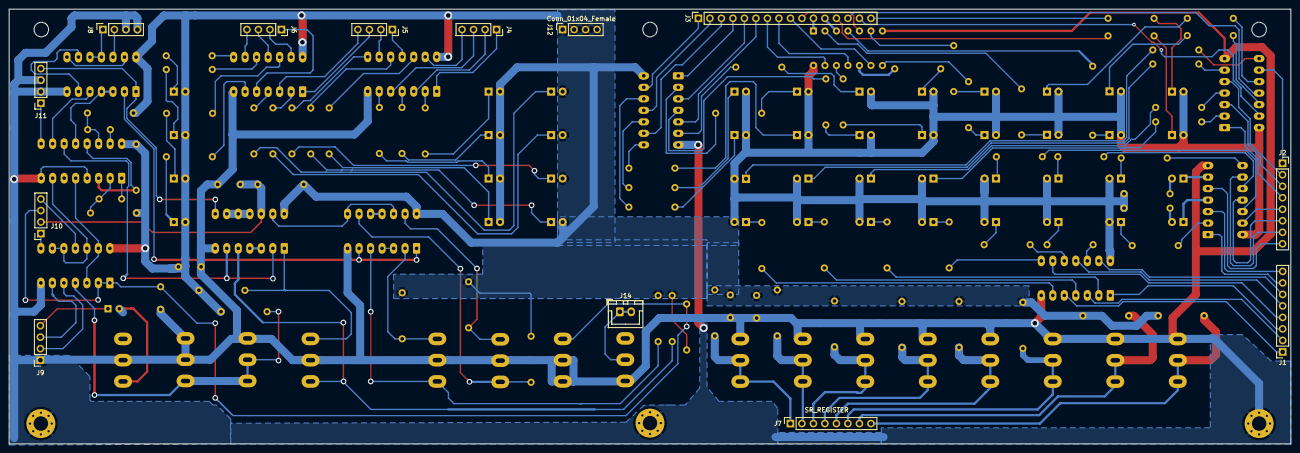
[picture p253: board front panel 9602.kicad_pcb from below]

Board: 2 copper layers, 283.0 x 96.0 mm, 163 parts (13 on the bottom side), 178 nets.

Other parts of the board:
HE: MountingHole; MountingHole_3.2mm_M3
