ibm2030/EDUC8/Input:Output Interface/Input:Output Interface.kicad_pcb

## KiCad design Input:Output Interface/Input:Output Interface.kicad_pcb (2025-07-23)

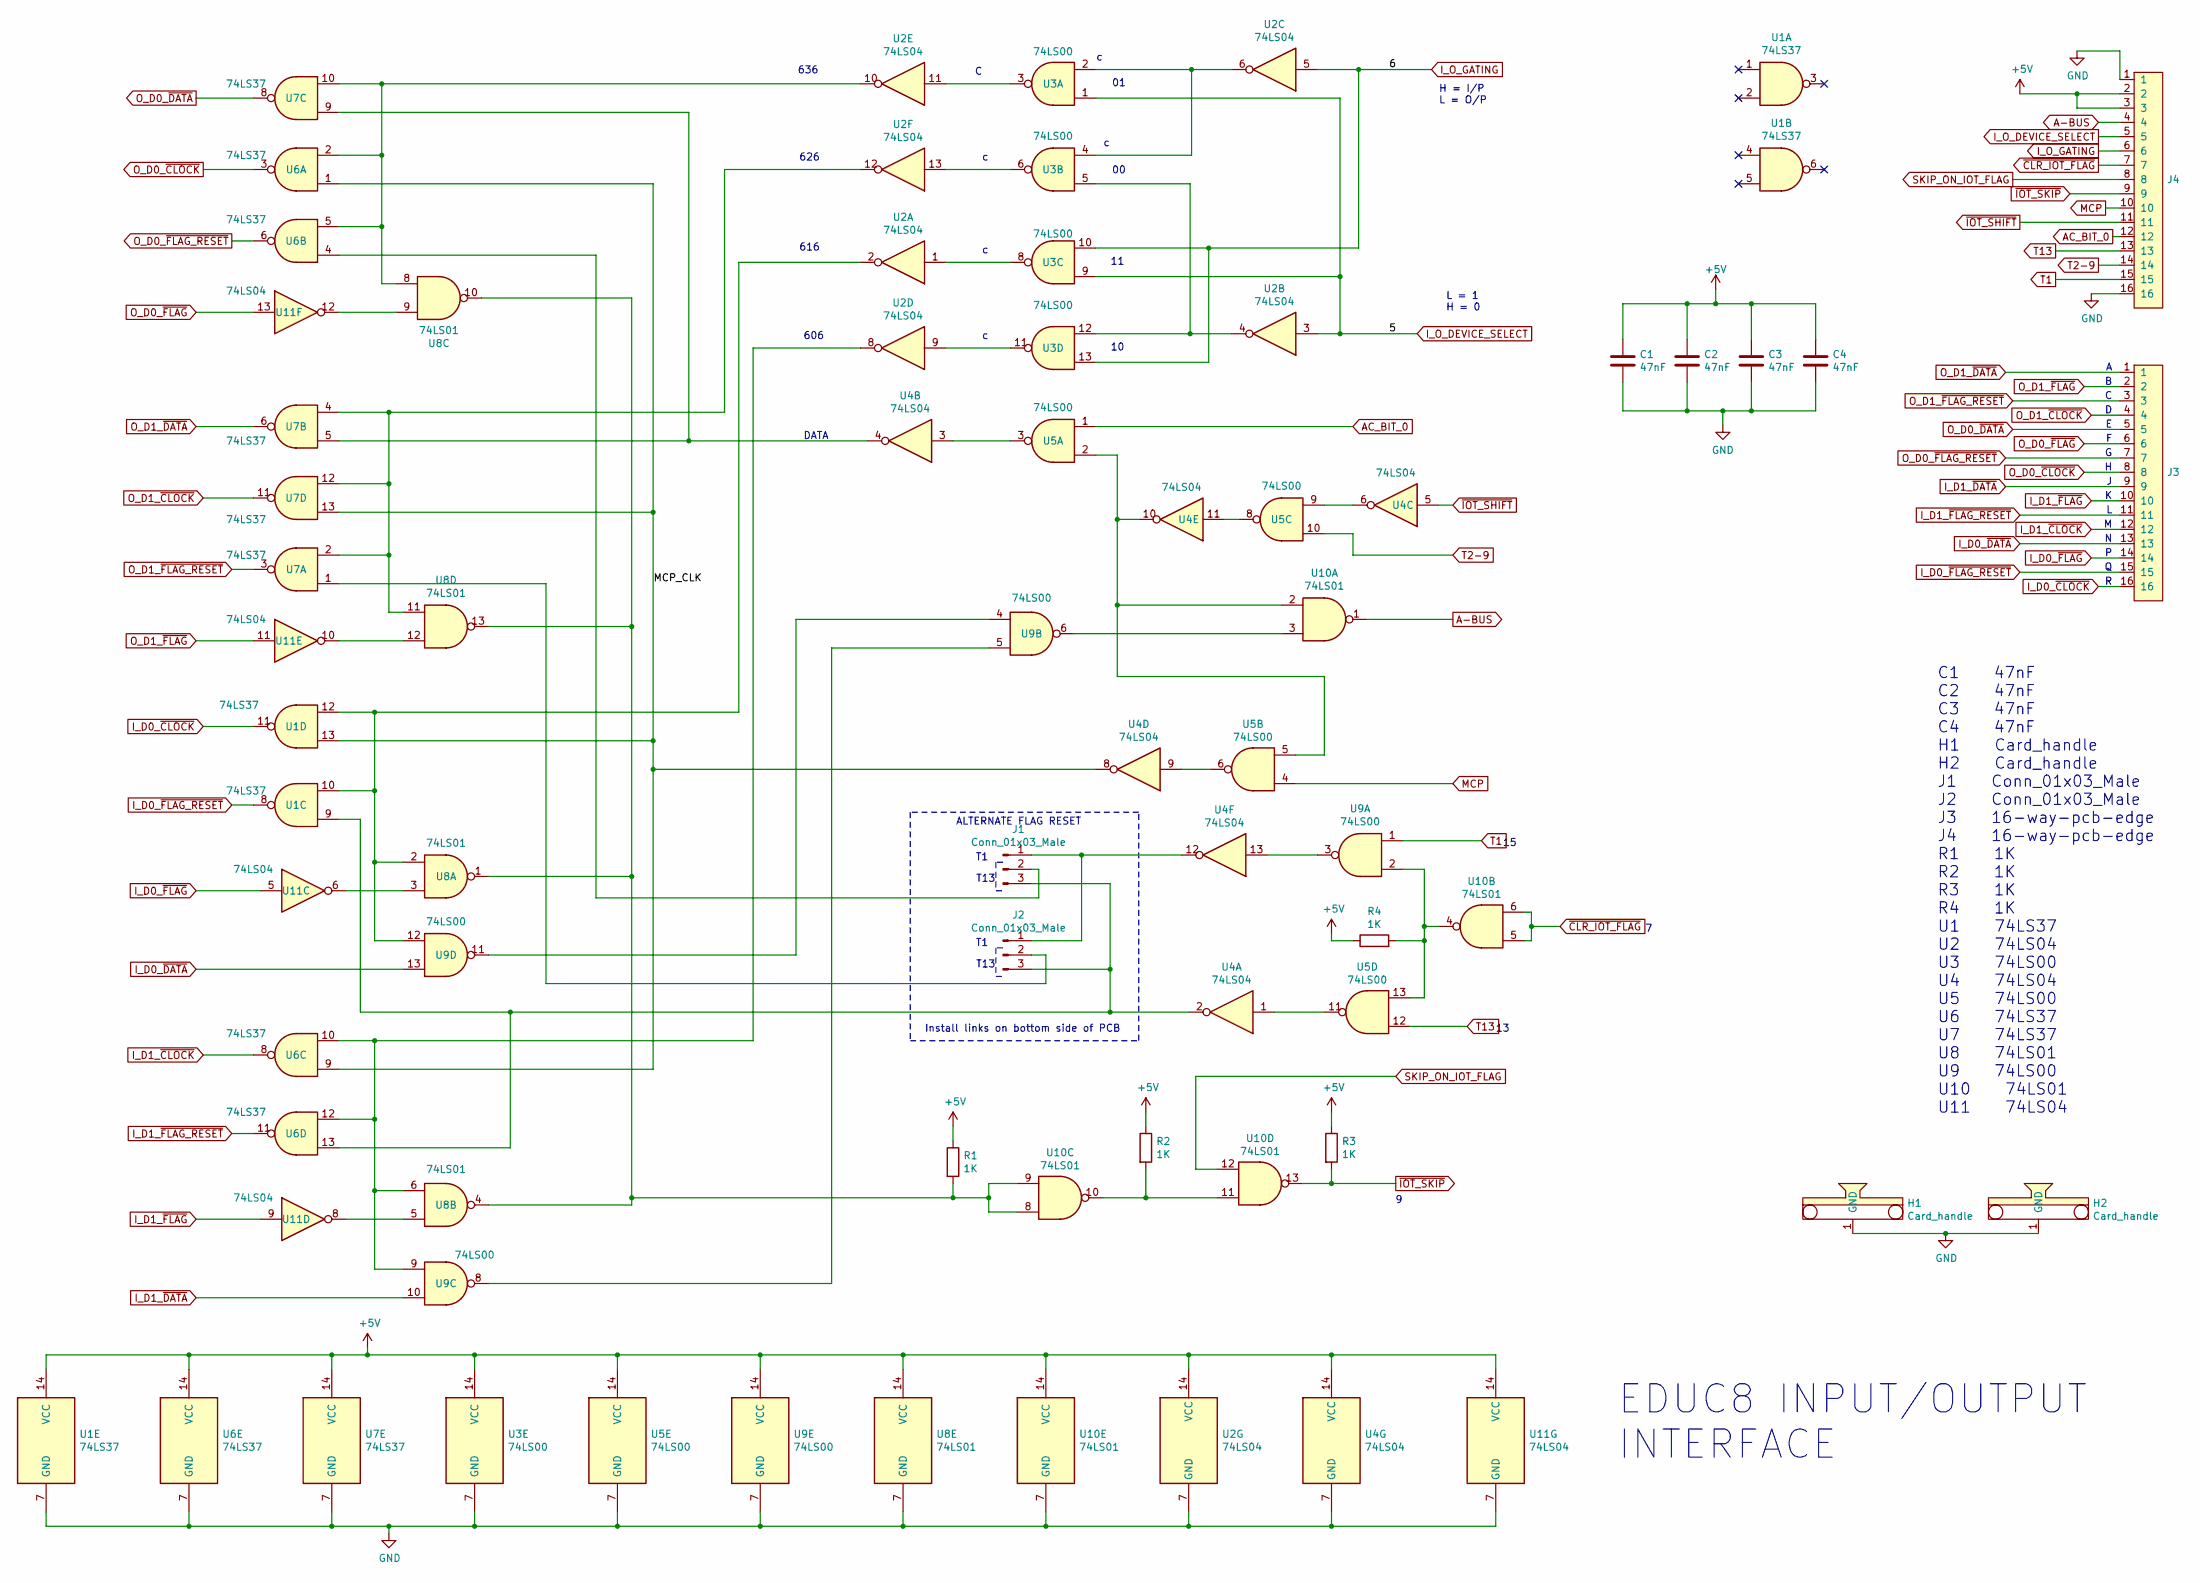
[picture p254: schematic Input:Output Interface.kicad_sch, Input/Output interface]

Parts:
C1, C2, C3, C4: 47nF; C_Disc_D7.5mm_W5.0mm_P7.50mm
H1, H2: Card_handle
J1, J2: Conn_01x03_Male; PinHeader_1x03_P2.54mm_Vertical
J3, J4: 16-way-pcb-edge-Educ-8-connectors; PCB_16pin
R1, R2, R3, R4: 1K; R_Axial_DIN0207_L6.3mm_D2.5mm_P10.16mm_Horizontal
U1, U6, U7: 74LS37; DIP-14_W7.62mm
U2, U4, U11: 74LS04; DIP-14_W7.62mm
U3: 74LS00
U5, U9: 74LS00; DIP-14_W7.62mm
U8, U10: 74LS01; DIP-14_W7.62mm

Connections:
+5V: C1.1, C2.1, C3.1, C4.1, J4.2, J4.3, R1.1, R2.1, R3.1, R4.1, U1.14 (VCC), U2.14 (VCC), U3.14 (VCC), U4.14 (VCC), U5.14 (VCC), U6.14 (VCC), U7.14 (VCC), U8.14 (VCC), U9.14 (VCC), U10.14 (VCC), U11.14 (VCC)
/MCP_CLK: U1.13, U4.8, U6.1, U6.9, U7.13
A-BUS: J4.4, U10.1
AC_BIT_0: J4.12, U5.1
GND: C1.2, C2.2, C3.2, C4.2, H1.1, H2.1, J4.1, J4.16, U1.7 (GND), U2.7 (GND), U3.7 (GND), U4.7 (GND), U5.7 (GND), U6.7 (GND), U7.7 (GND), U8.7 (GND), U9.7 (GND), U10.7 (GND), U11.7 (GND)
I_D0_~CLOCK: J3.16, U1.11
I_D0_~DATA: J3.13, U9.13
I_D0_~FLAG_RESET: J3.15, U1.8
I_D0_~FLAG: J3.14, U11.5
I_D1_~CLOCK: J3.12, U6.8
I_D1_~DATA: J3.9, U9.10
I_D1_~FLAG_RESET: J3.11, U6.11
I_D1_~FLAG: J3.10, U11.9
I_O_DEVICE_SELECT: J4.5, U2.3, U3.1, U3.9
I_O_GATING: J4.6, U2.5, U3.10, U3.13
MCP: J4.10, U5.4
unnamed: J1.1, J2.1, U4.12
unnamed: J1.2, U6.4
unnamed: J1.3, J2.3, U1.9, U4.2, U6.13
unnamed: J2.2, U7.1
unnamed: R1.2, U8.1, U8.4, U8.10, U8.13, U10.8, U10.9
unnamed: R2.2, U10.10, U10.11
unnamed: R4.2, U5.13, U9.2, U10.4
unnamed: U1.10, U1.12, U2.2, U8.2, U9.12
unnamed: U2.1, U3.8
unnamed: U2.4, U3.5, U3.12
unnamed: U2.6, U3.2, U3.4
unnamed: U2.8, U6.10, U6.12, U8.6, U9.9
unnamed: U2.9, U3.11
unnamed: U2.10, U6.2, U6.5, U7.10, U8.8
unnamed: U2.11, U3.3
unnamed: U2.12, U7.2, U7.4, U7.12, U8.11
unnamed: U2.13, U3.6
unnamed: U4.1, U5.11
unnamed: U4.3, U5.3
unnamed: U4.4, U7.5, U7.9
unnamed: U4.6, U5.9
unnamed: U4.9, U5.6
unnamed: U4.11, U5.8
unnamed: U4.13, U9.3
unnamed: U9.5, U9.8
unnamed: U9.4, U9.11
unnamed: U4.10, U5.2, U5.5, U10.2
unnamed: U9.6, U10.3
unnamed: U8.3, U11.6
unnamed: U8.5, U11.8
unnamed: U8.12, U11.10
unnamed: U8.9, U11.12
O_D0_~CLOCK: J3.8, U6.3
O_D0_~DATA: J3.5, U7.8
O_D0_~FLAG_RESET: J3.7, U6.6
O_D0_~FLAG: J3.6, U11.13
O_D1_~CLOCK: J3.4, U7.11
O_D1_~DATA: J3.1, U7.6
O_D1_~FLAG_RESET: J3.3, U7.3
O_D1_~FLAG: J3.2, U11.11
SKIP_ON_IOT_FLAG: J4.8, U10.12
T1: J4.15, U9.1
T2-9: J4.14, U5.10
T13: J4.13, U5.12
~CLR_IOT_FLAG: J4.7, U10.5, U10.6
~IOT_SHIFT: J4.11, U4.5
~IOT_SKIP: J4.9, R3.2, U10.13

Notes on the sheet:
616
EDUC8 INPUT/OUTPUT INTERFACE
T13
H = I/P L = O/P
DATA
L = 1 H = 0
Install links on bottom side of PCB
636
626
606
C1 47nF C2 47nF C3 47nF C4 47nF H1 Card_handle H2 Card_handle J1 Conn_01x03_Male J2 Conn_01x03_Male J3 16-way-pcb-edge J4 16-way-pcb-edge R1 1K R2 1K R3 1K R4 1K U1 74LS37 U2 74LS04 U3 74LS00 U4 74LS04 U5 74LS00 U6 74LS37 U7 74LS37 U8 74LS01 U9 74LS00 U10 74LS01 U11 74LS04
ALTERNATE FLAG RESET

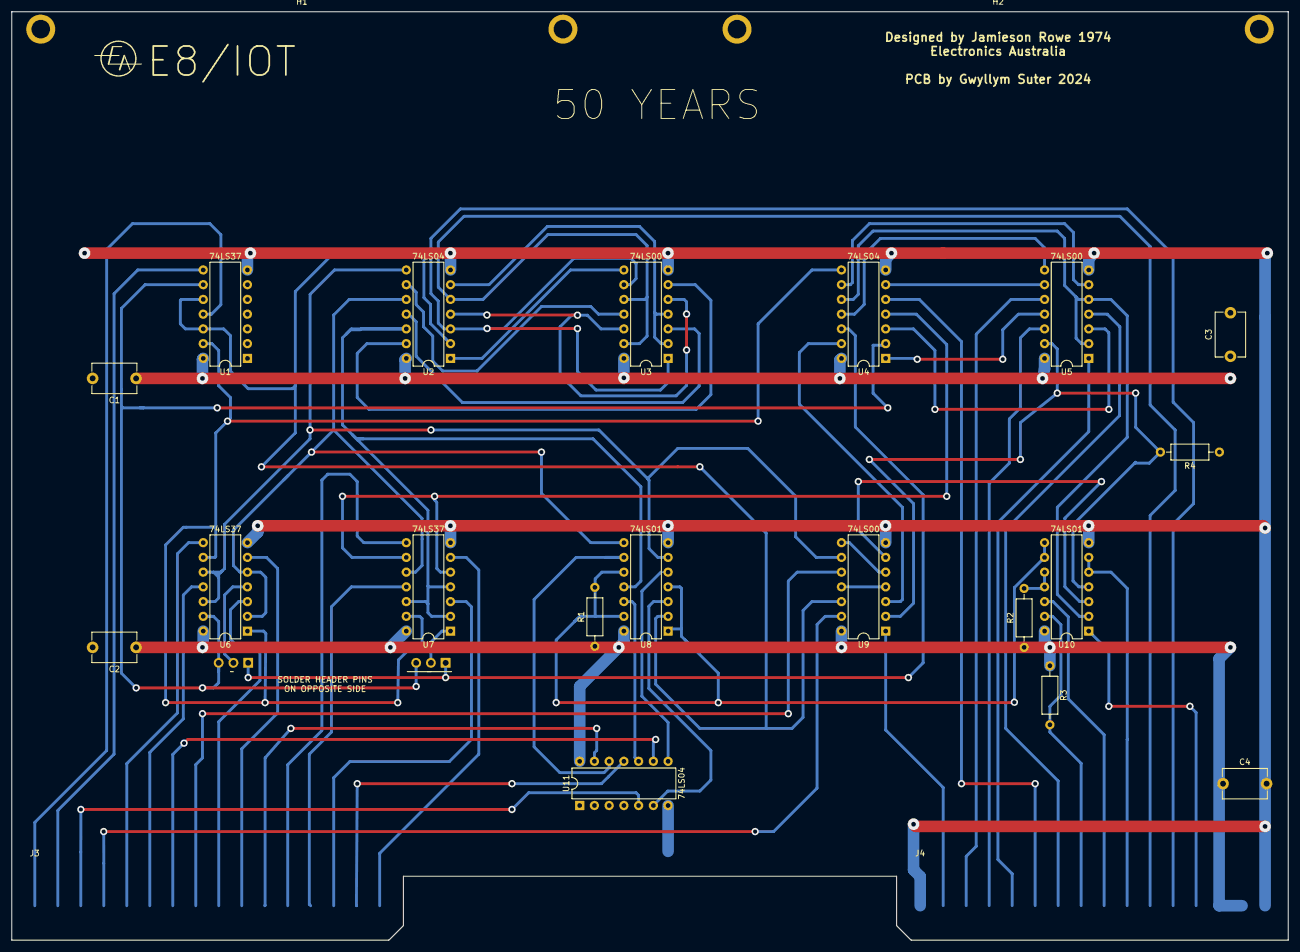
[picture p255: board Input:Output Interface.kicad_pcb from above]

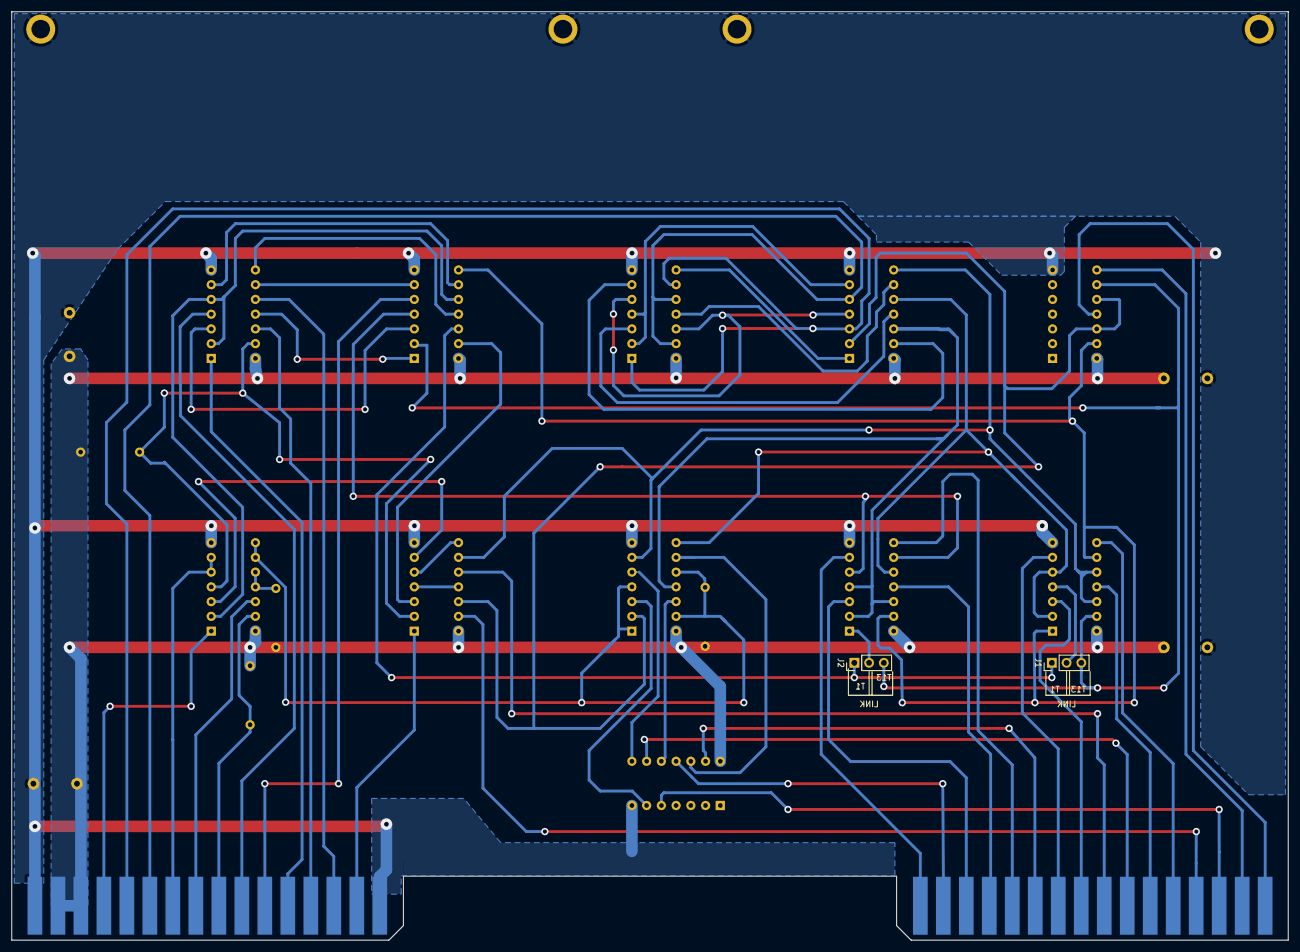
[picture p256: board Input:Output Interface.kicad_pcb from below]

Board: 2 copper layers, 220.0 x 160.0 mm, 25 parts (2 on the bottom side), 63 nets.
