ibm2030/EDUC8/Accumulator/Accumulator.kicad_pcb

## KiCad design Accumulator/Accumulator.kicad_pcb (2025-07-23)

Schematic: Accumulator.kicad_sch, EDUC-8A

Parts:
C1, C2, C3, C4: 47nF; C_Rect_L11.0mm_W2.8mm_P10.00mm_MKT
H1, H2: Card_handle
J1, J2: 16-way-pcb-edge-Educ-8-connectors; PCB_16pin
R1: 820; R_Axial_DIN0207_L6.3mm_D2.5mm_P10.16mm_Horizontal
R2, R3, R4: 2K2; R_Axial_DIN0207_L6.3mm_D2.5mm_P10.16mm_Horizontal
U1, U3: 74LS95; DIP-14_W7.62mm_LongPads
U2, U4: 74LS05; DIP-14_W7.62mm_LongPads
U5, U10: 74LS01; DIP-14_W7.62mm_LongPads
U6: 74LS04; DIP-14_W7.62mm_LongPads
U7, U9: 7400
U8: 74LS10

Connections:
+5V: C1.1, C2.1, C3.1, C4.1, J1.2, J1.3, R1.2, R2.1, R3.1, R4.1, U1.14 (VCC), U2.14 (VCC), U3.14 (VCC), U4.14 (VCC), U5.14 (VCC), U6.14 (VCC), U7.14 (VCC), U8.14 (VCC), U9.14 (VCC), U10.14 (VCC)
A-BUS: J1.4, U5.4, U6.9
AC0: J1.11, J2.9, U1.4 (P2), U1.10 (Q3), U2.9, U9.2, U9.13, U10.3, U10.5, U10.12
AC1: J2.10, U1.3 (P1), U1.11 (Q2), U2.11
AC2: J2.11, U1.2 (P0), U1.12 (Q1), U2.13
AC3: J2.12, U1.13 (Q0), U2.1, U3.5 (P3)
AC4: J2.13, U1.1 (Ds), U3.4 (P2), U3.10 (Q3), U4.9
AC5: J2.14, U3.3 (P1), U3.11 (Q2), U4.11
AC6: J2.15, U3.2 (P0), U3.12 (Q1), U4.13
AC7: J2.16, U1.5 (P3), U2.5, U3.13 (Q0)
AC=0: J1.15, R1.1, U2.2, U2.6, U2.8, U2.10, U2.12, U4.8, U4.10, U4.12
B-BUS: J1.5, U5.1, U10.1, U10.4
C-BUS: J1.6, U10.13
CPA: U1.9 (Cp1.Rshift), U3.9 (Cp1.Rshift), U7.8
D-BUS: J1.7, U9.1
GND: C1.2, C2.2, C3.2, C4.2, H1.1, H2.1, J1.1, J1.16, U1.7 (GND), U2.7 (GND), U3.7 (GND), U4.7 (GND), U5.7 (GND), U6.7 (GND), U7.7 (GND), U8.7 (GND), U9.7 (GND), U10.7 (GND)
MCP: J1.9, U7.1
unnamed: R2.2, U5.13, U9.9
unnamed: R3.2, U10.6, U10.10
unnamed: R4.2, U4.2, U5.3
unnamed: U3.1 (Ds), U6.8
unnamed: U5.2, U9.11
unnamed: U5.5, U9.6
unnamed: U5.6, U6.2
unnamed: U5.11, U7.6
unnamed: U6.12, U8.3
unnamed: U7.2, U8.12
unnamed: U7.4, U7.5, U8.8
unnamed: U7.3, U7.9, U7.10
unnamed: U8.2, U9.8
unnamed: U9.3, U9.4, U9.5
unnamed: U7.11, U10.2
unnamed: U8.6, U10.8, U10.9
unnamed: U6.4, U10.11
RAL: U1.6 (Mode), U3.6 (Mode), U6.5, U6.10
T1: J1.13, U1.8 (Cp2.Lshift), U3.8 (Cp2.Lshift)
T2-9: J1.12, U9.10
~AND: J2.1, U6.1, U8.10
~CLA: J2.8, U5.12, U8.5, U9.12
~CMA: J2.7, U4.1, U8.4
~DCA: J2.3, U6.3, U8.9
~IAC: J2.5, U6.13
~IOT_Shift: J1.10, U8.11
~RAL: J2.6, U6.11
~RAR: J2.4, U7.12
~T2-9(TAD+IAC+CMA): J1.14, U8.13
~T13.RAR: J1.8, U8.1
~TAD: J2.2, U7.13

Notes on the sheet:
7410
7495
Hex inverter OC
U6C
7405
Part No
Description
Quad NAND OC
U4B
820R
U5C
1/4 watt resistor
1. C-BUS not terminated on Accumulator board. Bus terminaing located in lower left quadrant of E8/C
2K2
Polyester capacitor
shift register
2. Tie floating input gates to GND.
E8-A Accumulator
7404
Hex inverter
Triple 3 input NAND
0.47uF
U4C
RAR
U2B
7400
Refdes
4. J1 and J2 are card edge etched onto PCB
Gates not used
Quad NAND
7401
7401
U10
5. Numbers in blue refer to original EDUC-8 Card edge connection
3. Add 0.1uf decoupling capacitor to the undersideof PCB between +5v and GND

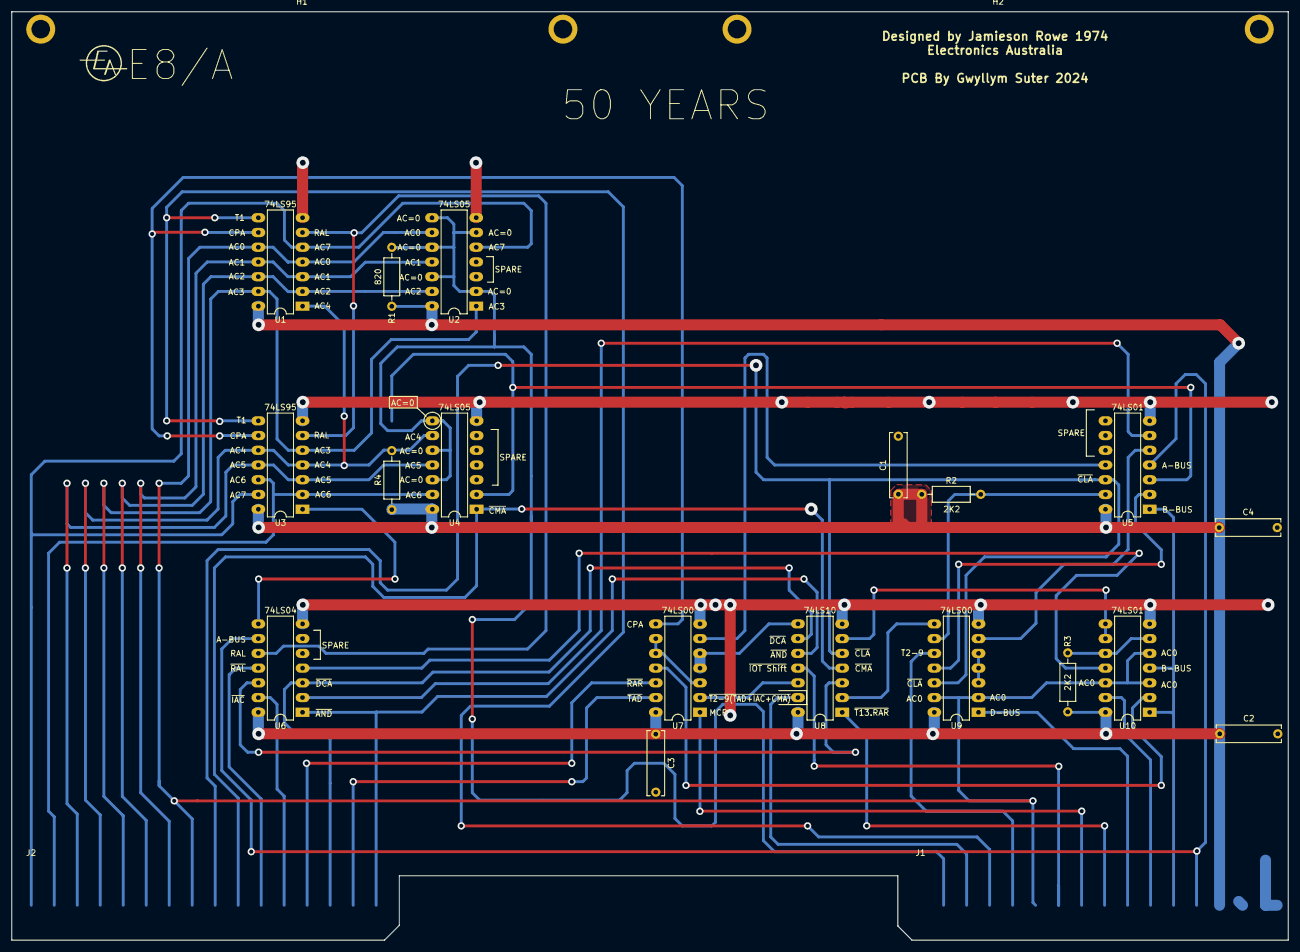
[picture p257: board Accumulator.kicad_pcb from above]

Board: 2 copper layers, 220.0 x 160.0 mm, 22 parts (0 on the bottom side), 48 nets.
