ibm2030/EDUC8/E8Serial/E8SRT/E8Serial.kicad_pcb

## KiCad design E8Serial/E8SRT/E8Serial.kicad_pcb (2025-07-23)

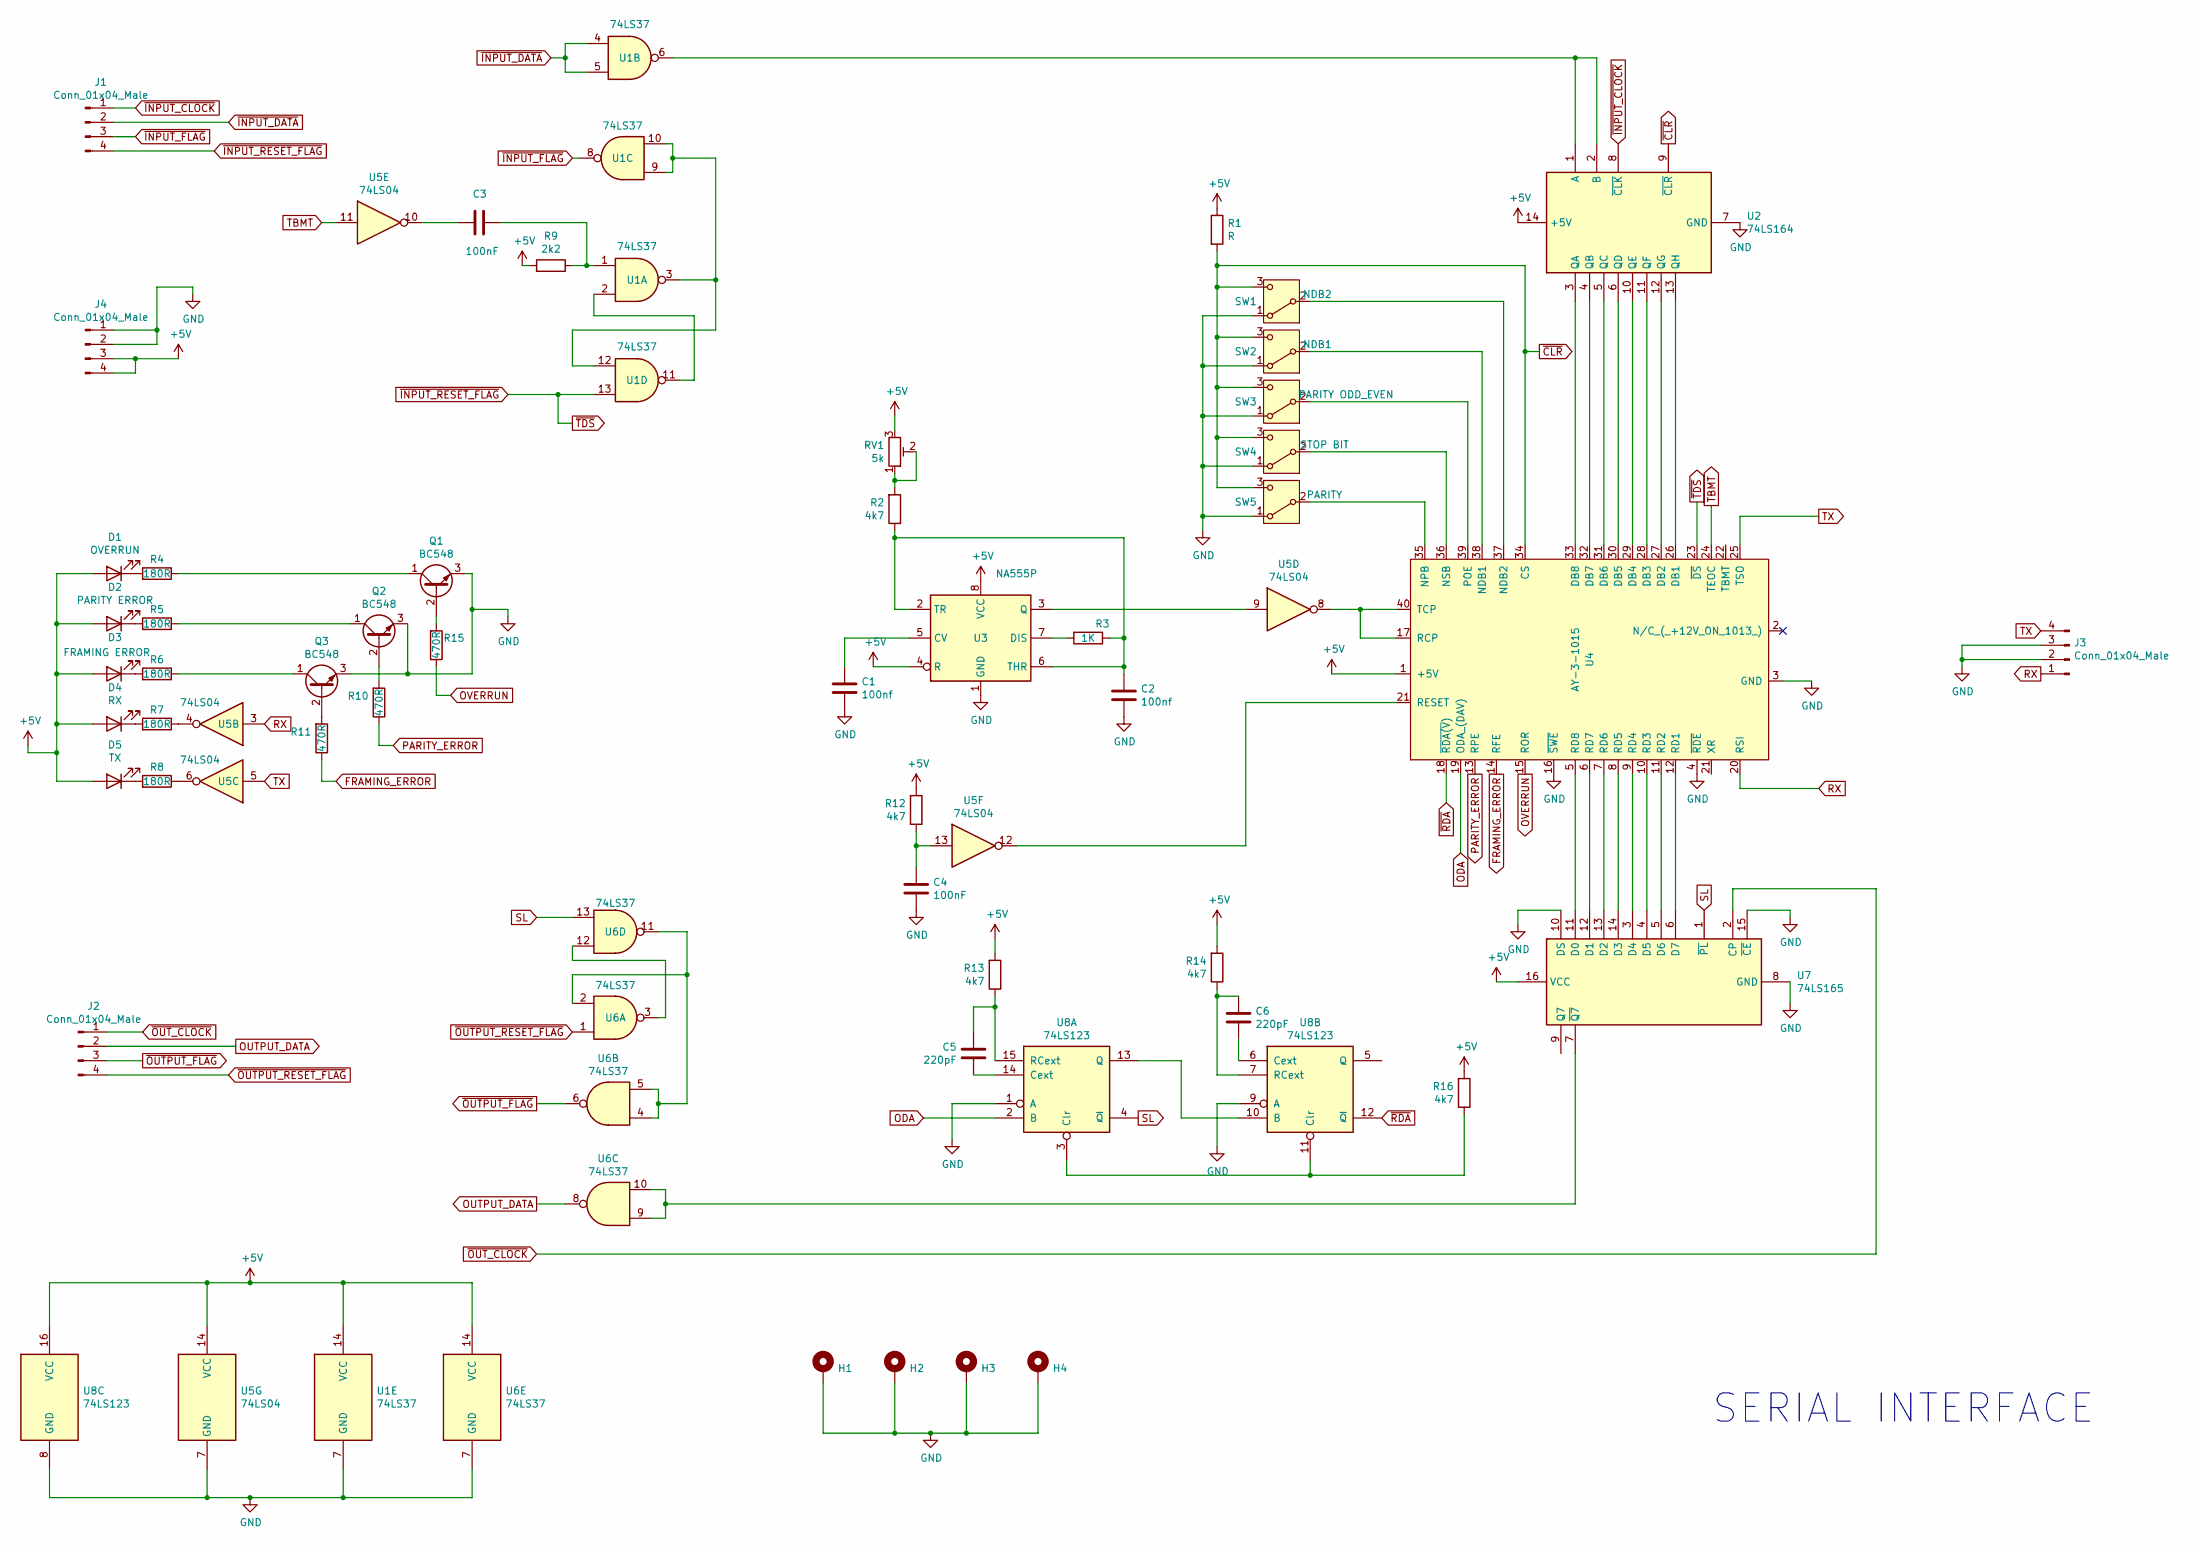
[picture p258: schematic E8Serial.kicad_sch]

Parts:
C1, C2: 100nf; C_Disc_D10.0mm_W2.5mm_P5.00mm
C3, C4: 100nF; C_Disc_D10.0mm_W2.5mm_P5.00mm
C5, C6: 220pF; C_Disc_D8.0mm_W2.5mm_P5.00mm
D1: OVERRUN; LED_D5.0mm_Horizontal_O3.81mm_Z9.0mm
D2: PARITY ERROR; LED_D5.0mm_Horizontal_O3.81mm_Z9.0mm
D3: FRAMING ERROR; LED_D5.0mm_Horizontal_O3.81mm_Z9.0mm
D4: RX; LED_D5.0mm_Horizontal_O3.81mm_Z9.0mm
D5: TX; LED_D5.0mm_Horizontal_O3.81mm_Z9.0mm
H1, H2, H3, H4: MountingHole_Pad; MountingHole_3.2mm_M3_Pad_Via
J1, J2, J3, J4: Conn_01x04_Male; PinHeader_1x04_P2.54mm_Vertical
Q1, Q2, Q3: BC548; TO-92_Inline_Wide
R1: R; R_Axial_DIN0207_L6.3mm_D2.5mm_P10.16mm_Horizontal
R2, R12, R13, R14, R16: 4k7; R_Axial_DIN0207_L6.3mm_D2.5mm_P10.16mm_Horizontal
R3: 1K; R_Axial_DIN0207_L6.3mm_D2.5mm_P10.16mm_Horizontal
R4, R5, R6, R7, R8: 180R; R_Axial_DIN0207_L6.3mm_D2.5mm_P10.16mm_Horizontal
R9: 2k2; R_Axial_DIN0207_L6.3mm_D2.5mm_P10.16mm_Horizontal
R10, R11, R15: 470R; R_Axial_DIN0207_L6.3mm_D2.5mm_P10.16mm_Horizontal
RV1: 5k; Potentiometer_Bourns_3006P_Horizontal
SW1: NDB2; S1320_SPDP_Toggle_switch_PCB_right_angle
SW2: NDB1; S1320_SPDP_Toggle_switch_PCB_right_angle
SW3: PARITY ODD_EVEN; S1320_SPDP_Toggle_switch_PCB_right_angle
SW4: STOP BIT; S1320_SPDP_Toggle_switch_PCB_right_angle
SW5: PARITY; S1320_SPDP_Toggle_switch_PCB_right_angle
U1, U6: 74LS37; DIP-14_W7.62mm
U2: 74LS164; DIP-14_W7.62mm
U3: NA555P; DIP-8_W7.62mm
U4: AY-3-1015; DIP-40_W15.24mm
U5: 74LS04; DIP-14_W7.62mm
U7: 74LS165; DIP-16_W7.62mm
U8: 74LS123; DIP-16_W7.62mm

Connections:
+5V: D1.2 (A), D2.2 (A), D3.2 (A), D4.2 (A), D5.2 (A), J4.3, J4.4, R1.1, R9.2, R12.2, R13.2, R14.2, R16.2, RV1.3, U1.14 (VCC), U2.14 (+5V), U3.4 (R), U3.8 (VCC), U4.1 (+5V), U5.14 (VCC), U6.14 (VCC), U7.16 (VCC), U8.16 (VCC)
FRAMING_ERROR: R11.1, U4.14 (RFE)
GND: C1.2, C2.2, C4.2, H1.1, H2.1, H3.1, H4.1, J3.2, J3.3, J4.1, J4.2, Q1.3 (E), Q2.3 (E), Q3.3 (E), SW1.1 (A), SW2.1 (A), SW3.1 (A), SW4.1 (A), SW5.1 (A), U1.7 (GND), U2.7 (GND), U3.1 (GND), U4.3 (GND), U4.4 (~RDE), U4.16 (~SWE), U5.7 (GND), U6.7 (GND), U7.8 (GND), U7.10 (DS), U7.15 (~CE), U8.1 (A), U8.8 (GND), U8.9 (A)
unnamed: C3.1, R9.1, U1.1
unnamed: C3.2, U5.10
unnamed: C4.1, R12.1, U5.13
unnamed: D1.1 (K), R4.2
unnamed: D2.1 (K), R5.2
unnamed: D3.1 (K), R6.2
unnamed: D4.1 (K), R7.2
unnamed: D5.1 (K), R8.2
unnamed: Q1.2 (B), R15.2
unnamed: Q1.1 (C), R4.1
unnamed: Q2.2 (B), R10.2
unnamed: Q2.1 (C), R5.1
unnamed: Q3.2 (B), R11.2
unnamed: Q3.1 (C), R6.1
unnamed: R2.2, RV1.1, RV1.2
unnamed: R7.1, U5.4
unnamed: R8.1, U5.6
unnamed: SW1.2 (B), U4.37 (NDB2)
unnamed: SW2.2 (B), U4.38 (NDB1)
unnamed: SW3.2 (B), U4.39 (POE)
unnamed: SW4.2 (B), U4.36 (NSB)
unnamed: SW5.2 (B), U4.35 (NPB)
unnamed: U1.3, U1.9, U1.10, U1.12
unnamed: U1.2, U1.11
unnamed: U1.6, U2.1 (A), U2.2 (B)
unnamed: U2.3 (QA), U4.33 (DB8)
unnamed: U2.4 (QB), U4.32 (DB7)
unnamed: U2.5 (QC), U4.31 (DB6)
unnamed: U2.6 (QD), U4.30 (DB5)
unnamed: U2.10 (QE), U4.29 (DB4)
unnamed: U2.11 (QF), U4.28 (DB3)
unnamed: U2.12 (QG), U4.27 (DB2)
unnamed: U2.13 (QH), U4.26 (DB1)
unnamed: C1.1, U3.5 (CV)
unnamed: R3.2, U3.7 (DIS)
unnamed: U3.3 (Q), U5.9
unnamed: C2.1, R2.1, R3.1, U3.2 (TR), U3.6 (THR)
unnamed: U4.17 (RCP), U4.40 (TCP), U5.8
unnamed: U4.12 (RD1), U7.6 (D7)
unnamed: U4.11 (RD2), U7.5 (D6)
unnamed: U4.10 (RD3), U7.4 (D5)
unnamed: U4.9 (RD4), U7.3 (D4)
unnamed: U4.8 (RD5), U7.14 (D3)
unnamed: U4.7 (RD6), U7.13 (D2)
unnamed: U4.6 (RD7), U7.12 (D1)
unnamed: U4.5 (RD8), U7.11 (D0)
unnamed: U4.21 (RESET), U5.12
unnamed: U6.2, U6.4, U6.5, U6.11
unnamed: U6.3, U6.12
unnamed: U6.9, U6.10, U7.7 (~Q7)
unnamed: C5.2, U8.14 (Cext)
unnamed: R16.1, U8.3 (Clr), U8.11 (Clr)
unnamed: U8.10 (B), U8.13 (Q)
unnamed: C5.1, R13.1, U8.15 (RCext)
unnamed: C6.2, U8.6 (Cext)
unnamed: C6.1, R14.1, U8.7 (RCext)
ODA: U4.19 (ODA_(DAV)), U8.2 (B)
OUTPUT_DATA: J2.2, U6.8
OVERRUN: R15.1, U4.15 (ROR)
PARITY_ERROR: R10.1, U4.13 (RPE)
RX: J3.1, U4.20 (RSI), U5.3
SL: U6.13, U7.1 (~PL), U8.4 (~Q)
TBMT: U4.24 (TEOC), U5.11
TX: J3.4, U4.25 (TSO), U5.5
~CLR: R1.2, SW1.3 (C), SW2.3 (C), SW3.3 (C), SW4.3 (C), SW5.3 (C), U2.9 (~CLR), U4.34 (CS)
~INPUT_CLOCK: J1.1, U2.8 (~CLK)
~INPUT_DATA: J1.2, U1.4, U1.5
~INPUT_FLAG: J1.3, U1.8
~INPUT_RESET_FLAG: J1.4, U1.13, U4.23 (~DS)
~OUTPUT_FLAG: J2.3, U6.6
~OUTPUT_RESET_FLAG: J2.4, U6.1
~OUT_CLOCK: J2.1, U7.2 (CP)
~RDA: U4.18 (~RDA(V)), U8.12 (~Q)

Notes on the sheet:
SERIAL INTERFACE

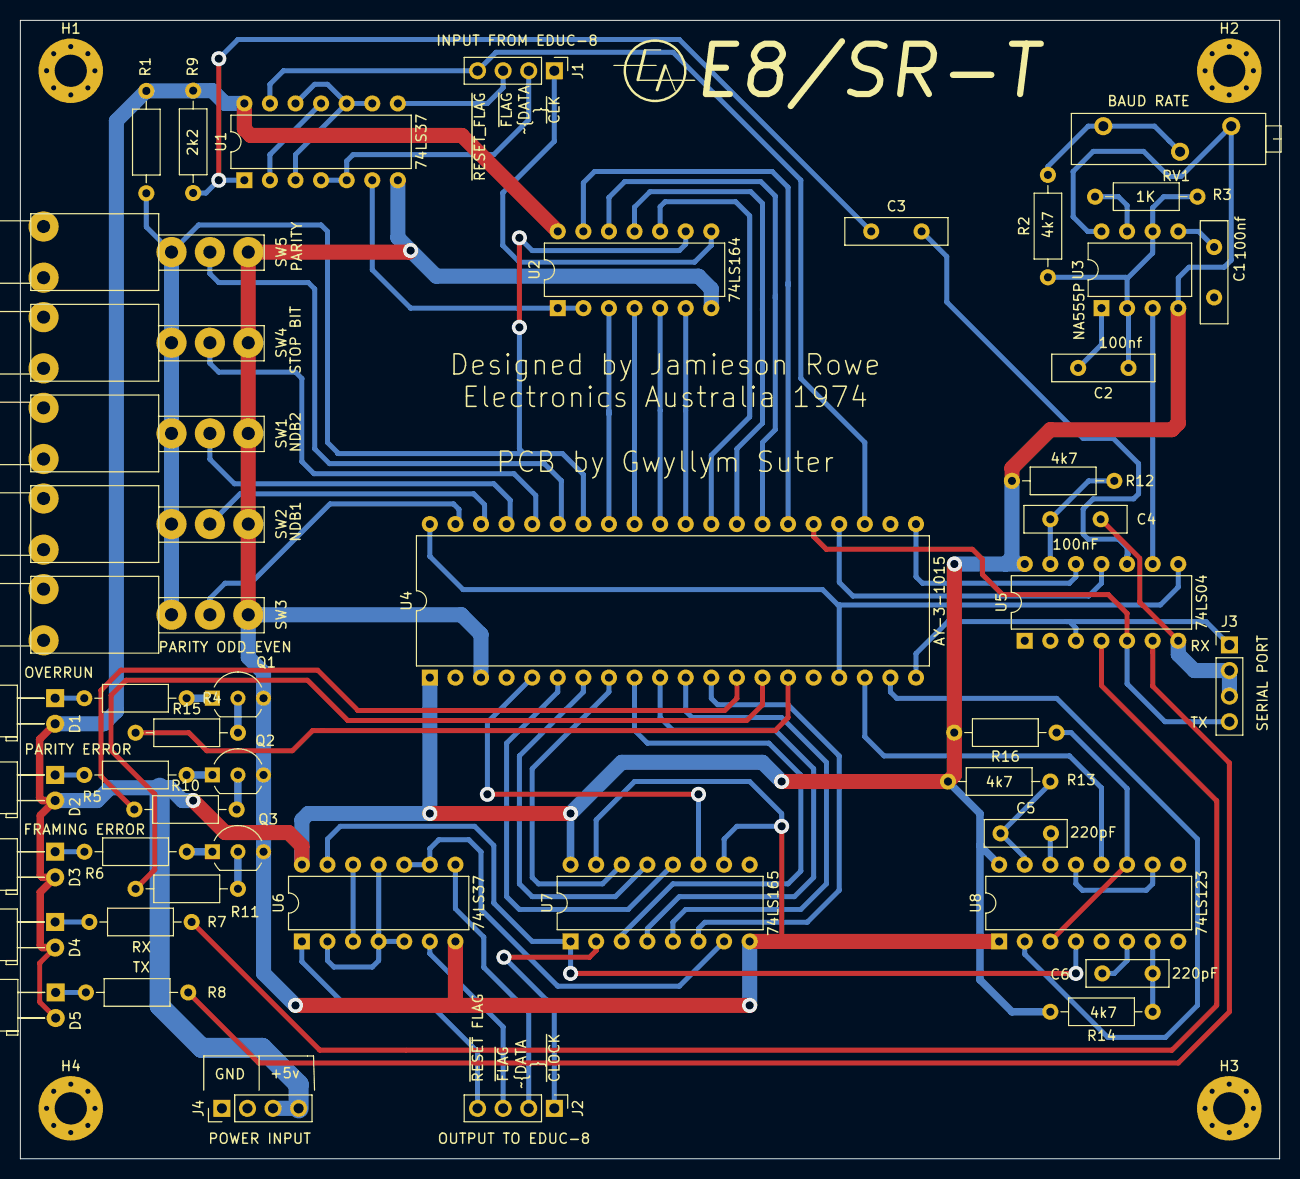
[picture p259: board E8Serial.kicad_pcb from above]

Board: 2 copper layers, 125.0 x 113.0 mm, 52 parts (0 on the bottom side), 76 nets.
