ibm2030/EDUC8/E8Serial/Video terminal /Video terminal .kicad_pcb

## KiCad design E8Serial/Video terminal /Video terminal .kicad_pcb (2025-07-23)

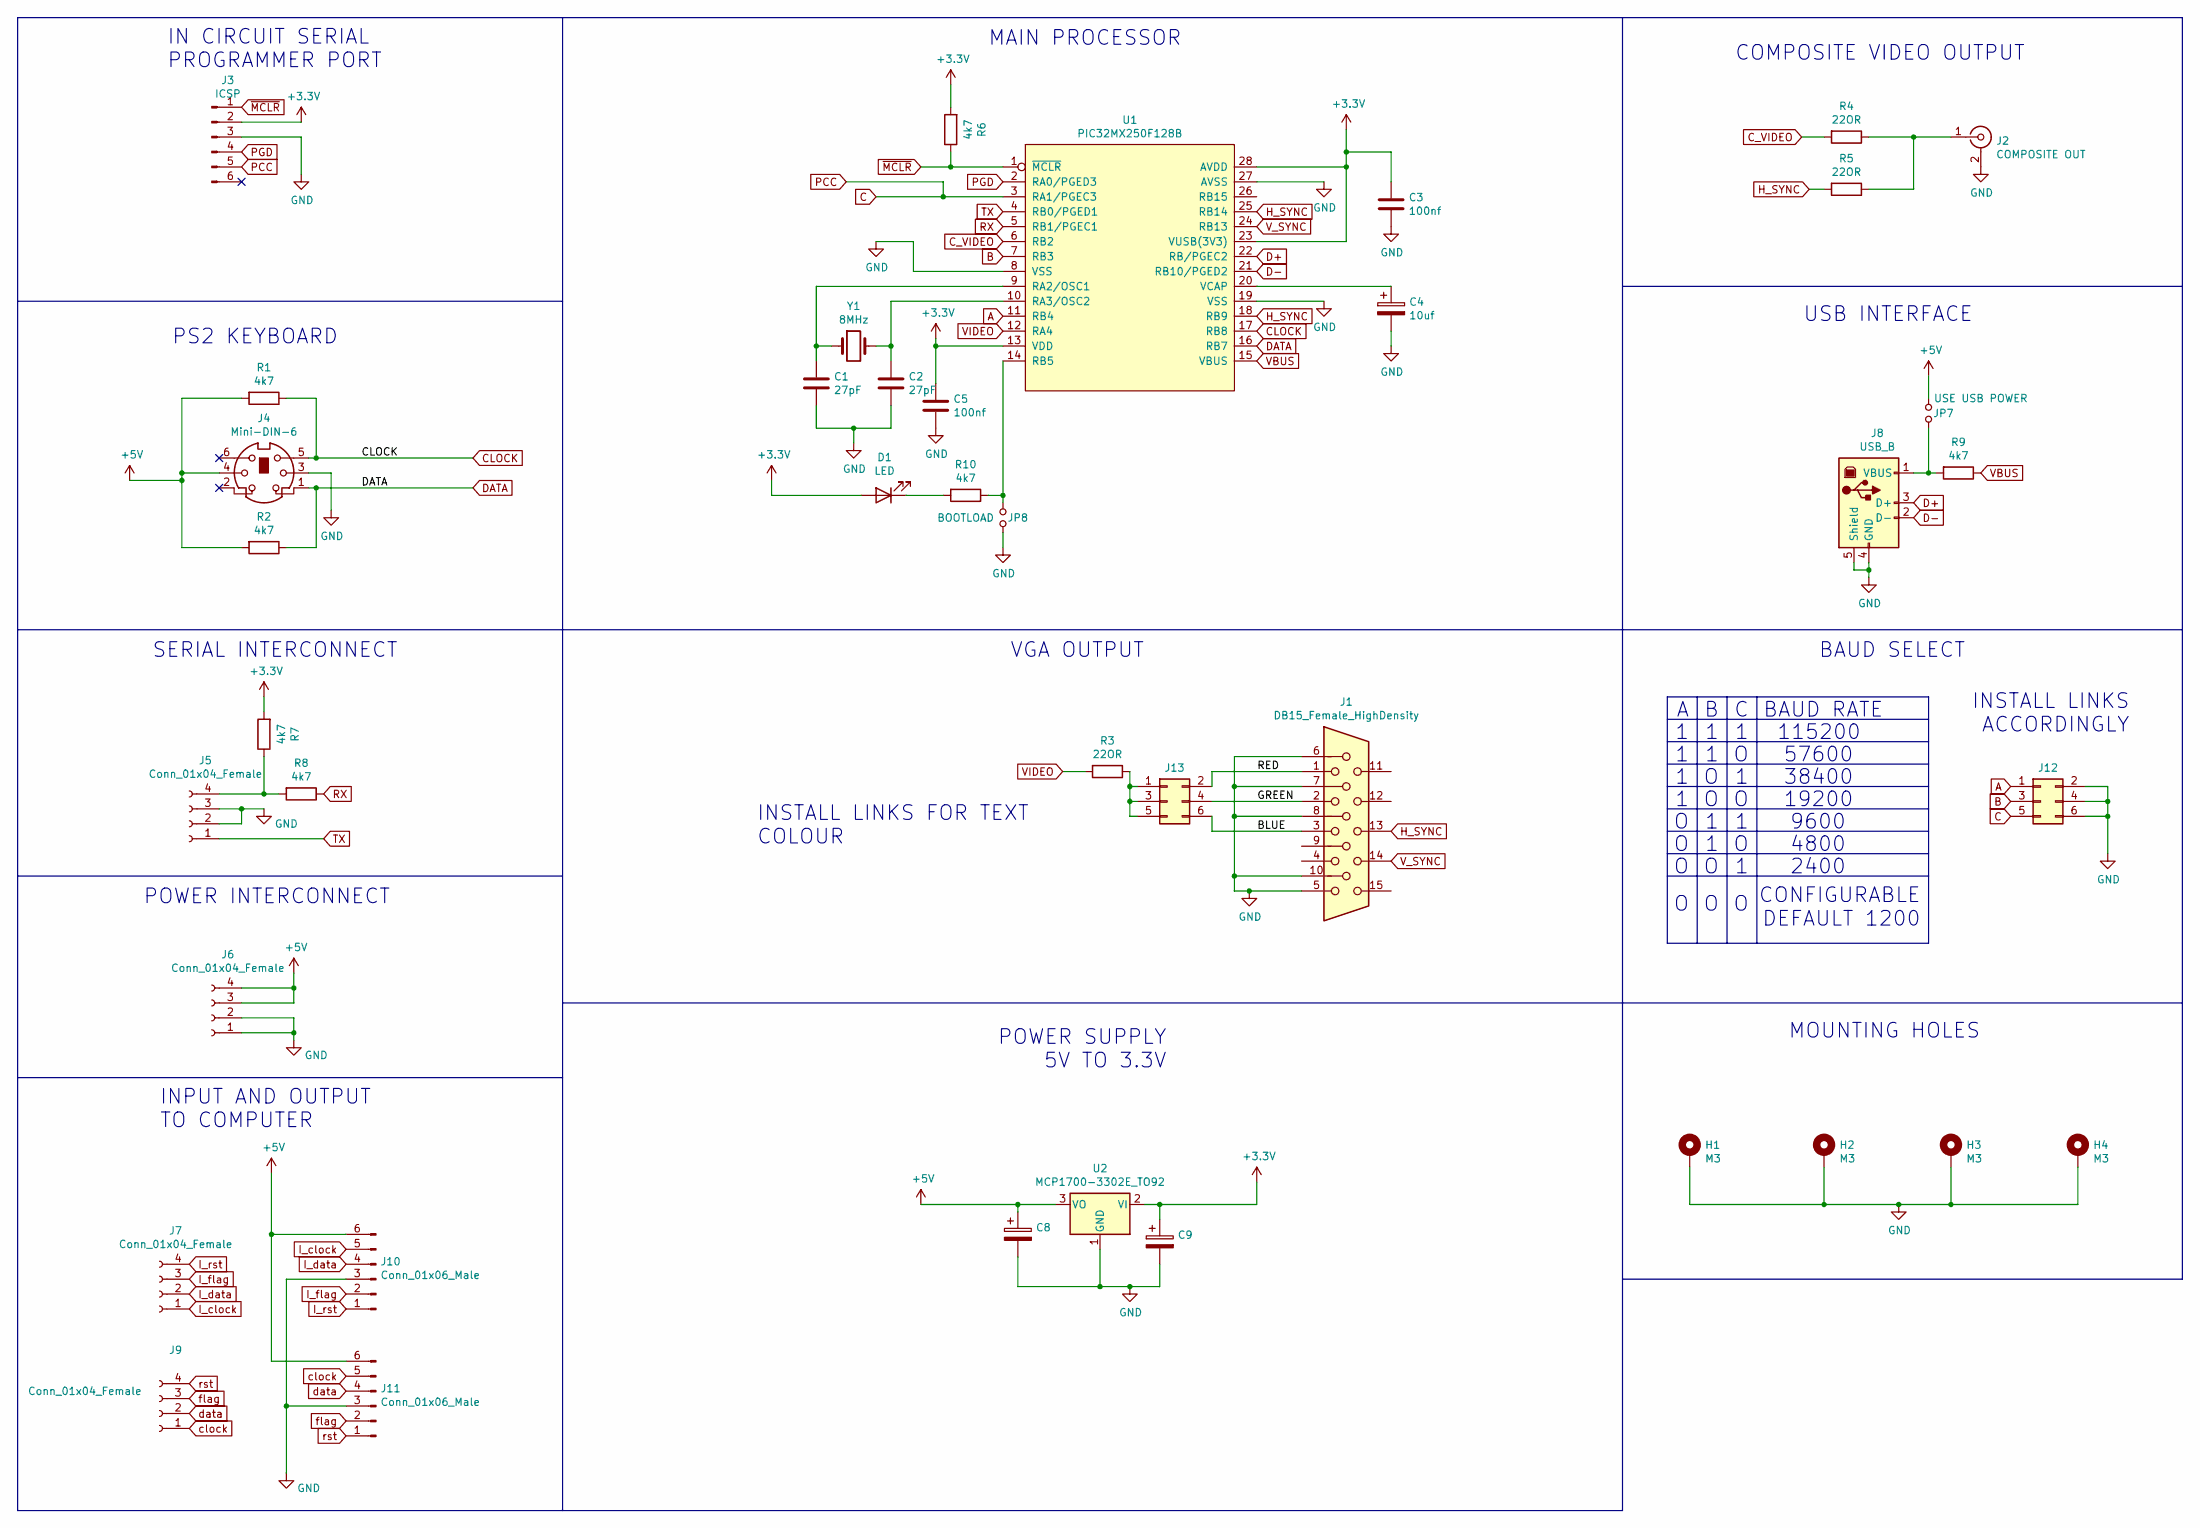
[picture p260: schematic Video terminal .kicad_sch, ASCII VIDEO TERMINAL]

Parts:
C1, C2: 27pF; C_Disc_D4.3mm_W1.9mm_P5.00mm
C3, C5: 100nf; C_Rect_L7.0mm_W3.5mm_P5.00mm
C4: 10uf; CP_Radial_D5.0mm_P2.50mm
C8, C9: CP_Radial_D6.3mm_P2.50mm
D1: LED; LED_D5.0mm_Horizontal_O1.27mm_Z3.0mm
H1, H2, H3, H4: M3; MountingHole_3.2mm_M3_Pad_Via
J1: DB15_Female_HighDensity; DSUB-15-HD_Female_Horizontal_P2.29x1.98mm_EdgePinOffset3.03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
J2: COMPOSITE OUT; BNC_Amphenol_031-6575_Horizontal
J3: ICSP; PinHeader_1x06_P2.54mm_Vertical
J4: Mini-DIN-6; 6_pin_mini_din
J5, J6, J7, J9: Conn_01x04_Female; PinSocket_1x04_P2.54mm_Vertical
J8: USB_B; USB_B_Lumberg_2411_02_Horizontal
J10, J11: Conn_01x06_Male; Molex_KK-254_AE-6410-06A_1x06_P2.54mm_Vertical
J12, J13: Conn_02x03_Odd_Even; PinHeader_2x03_P2.54mm_Vertical
JP7: USE USB POWER; PinHeader_2x01_P2.54mm_Vertical
JP8: BOOTLOAD; PinHeader_2x01_P2.54mm_Vertical
R1, R2, R6, R7, R8, R9, R10: 4k7; R_Axial_DIN0207_L6.3mm_D2.5mm_P10.16mm_Horizontal
R3, R4, R5: 22OR; R_Axial_DIN0207_L6.3mm_D2.5mm_P10.16mm_Horizontal
U1: PIC32MX250F128B; DIP-28_W7.62mm
U2: MCP1700-3302E_TO92; TO-92_Inline_Wide
Y1: 8MHz; Crystal_HC49-4H_Vertical

Connections:
+3V3: C3.1, C5.1, C9.1, D1.2 (A), J3.2, R6.2, R7.2, U1.13 (VDD), U1.23 (VUSB(3V3)), U1.28 (AVDD), U2.2 (VI)
+5V: C8.1, J4.4, J6.3, J6.4, J10.6, J11.6, JP7.1, R1.2, R2.2, U2.3 (VO)
/BLUE: J1.3, J13.6
/GREEN: J1.2, J13.4
/RED: J1.1, J13.2
A: J12.1, U1.11 (RB4)
B: J12.3, U1.7 (RB3)
C: J3.5, J12.5, U1.3 (RA1/PGEC3)
CLOCK: J4.5, R1.1, U1.17 (RB8)
C_VIDEO: R4.2, U1.6 (RB2)
D+: J8.3 (D+), U1.22 (RB/PGEC2)
D-: J8.2 (D-), U1.21 (RB10/PGED2)
DATA: J4.1, R2.1, U1.16 (RB7)
GND: C1.2, C2.2, C3.2, C4.2, C5.2, C8.2, C9.2, H1.1, H2.1, H3.1, H4.1, J1.5, J1.6, J1.7, J1.8, J1.10, J2.2 (Ext), J3.3, J4.3, J5.2, J5.3, J6.1, J6.2, J8.4 (GND), J8.5 (Shield), J10.3, J11.3, J12.2, J12.4, J12.6, JP8.2, U1.8 (VSS), U1.19 (VSS), U1.27 (AVSS), U2.1 (GND)
H_SYNC: J1.13, R5.2, U1.18 (RB9), U1.25 (RB14)
I_clock: J7.1, J10.5
I_data: J7.2, J10.4
I_flag: J7.3, J10.2
I_rst: J7.4, J10.1
unnamed: C1.1, U1.9 (RA2/OSC1), Y1.1
unnamed: C2.1, U1.10 (RA3/OSC2), Y1.2
unnamed: C4.1, U1.20 (VCAP)
unnamed: D1.1 (K), R10.2
unnamed: J2.1 (In), R4.1, R5.1
unnamed: J5.4, R7.1, R8.2
unnamed: J8.1 (VBUS), JP7.2, R9.2
unnamed: J13.1, J13.3, J13.5, R3.1
unnamed: JP8.1, R10.1, U1.14 (RB5)
PGD: J3.4, U1.2 (RA0/PGED3)
RX: R8.1, U1.5 (RB1/PGEC1)
TX: J5.1, U1.4 (RB0/PGED1)
VBUS: R9.1, U1.15 (VBUS)
VIDEO: R3.2, U1.12 (RA4)
V_SYNC: J1.14, U1.24 (RB13)
clock: J9.1, J11.5
data: J9.2, J11.4
flag: J9.3, J11.2
rst: J9.4, J11.1
~MCLR: J3.1, R6.1, U1.1 (~MCLR)

Notes on the sheet:
MAIN PROCESSOR
BAUD SELECT
38400
115200
4800
COMPOSITE VIDEO OUTPUT
INSTALL LINKS ACCORDINGLY
9600
2400
IN CIRCUIT SERIAL PROGRAMMER PORT
INSTALL LINKS FOR TEXT COLOUR
POWER SUPPLY 5V TO 3.3V
SERIAL INTERCONNECT
POWER INTERCONNECT
USB INTERFACE
19200
57600
PS2 KEYBOARD
INPUT AND OUTPUT TO COMPUTER
MOUNTING HOLES
CONFIGURABLE DEFAULT 1200
VGA OUTPUT
BAUD RATE

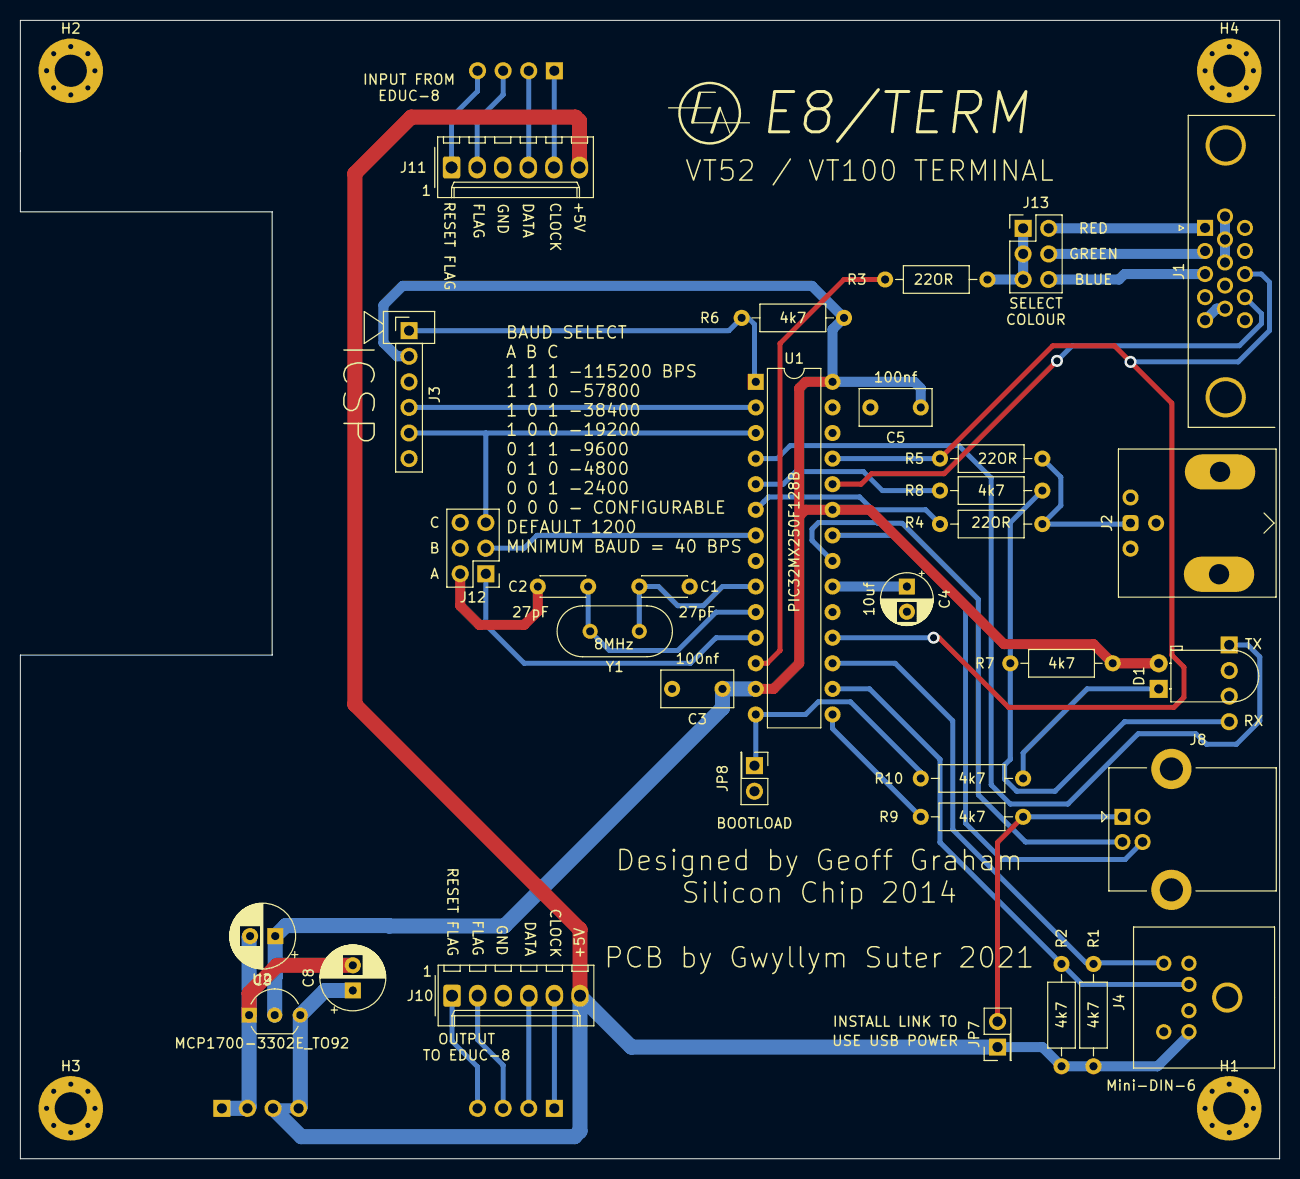
[picture p261: board Video terminal .kicad_pcb from above]

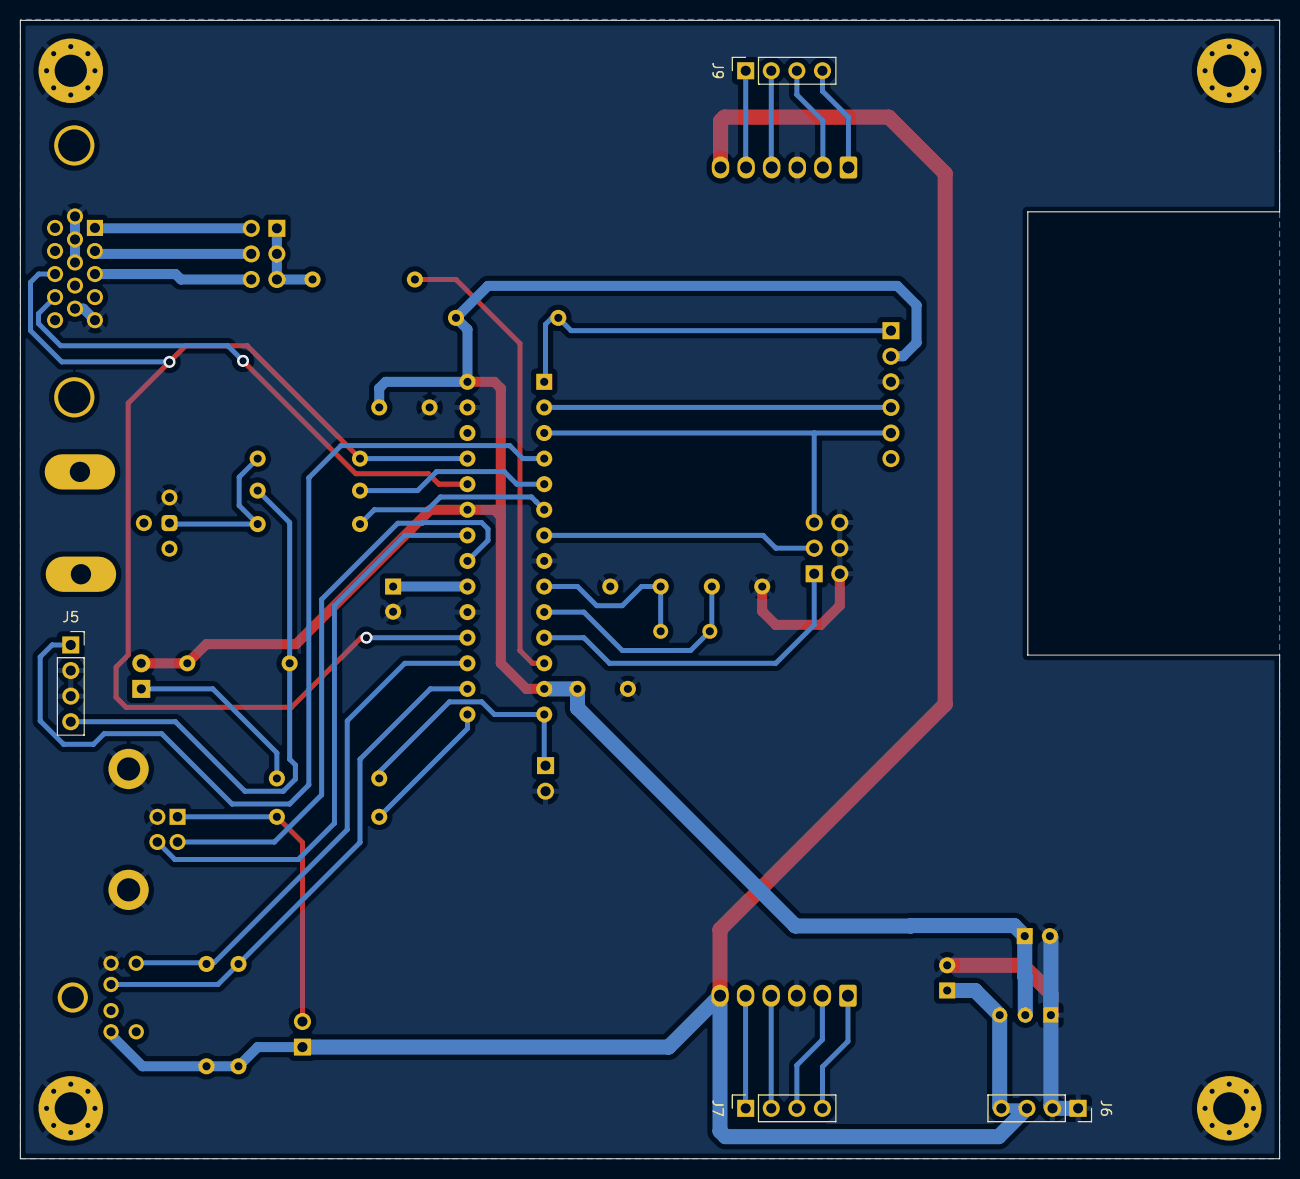
[picture p262: board Video terminal .kicad_pcb from below]

Board: 2 copper layers, 125.0 x 113.0 mm, 40 parts (4 on the bottom side), 39 nets.
