ibm2030/EDUC8/Decoder/educ 8 decoder.kicad_pcb

## KiCad design Decoder/educ 8 decoder.kicad_pcb (2025-07-23)

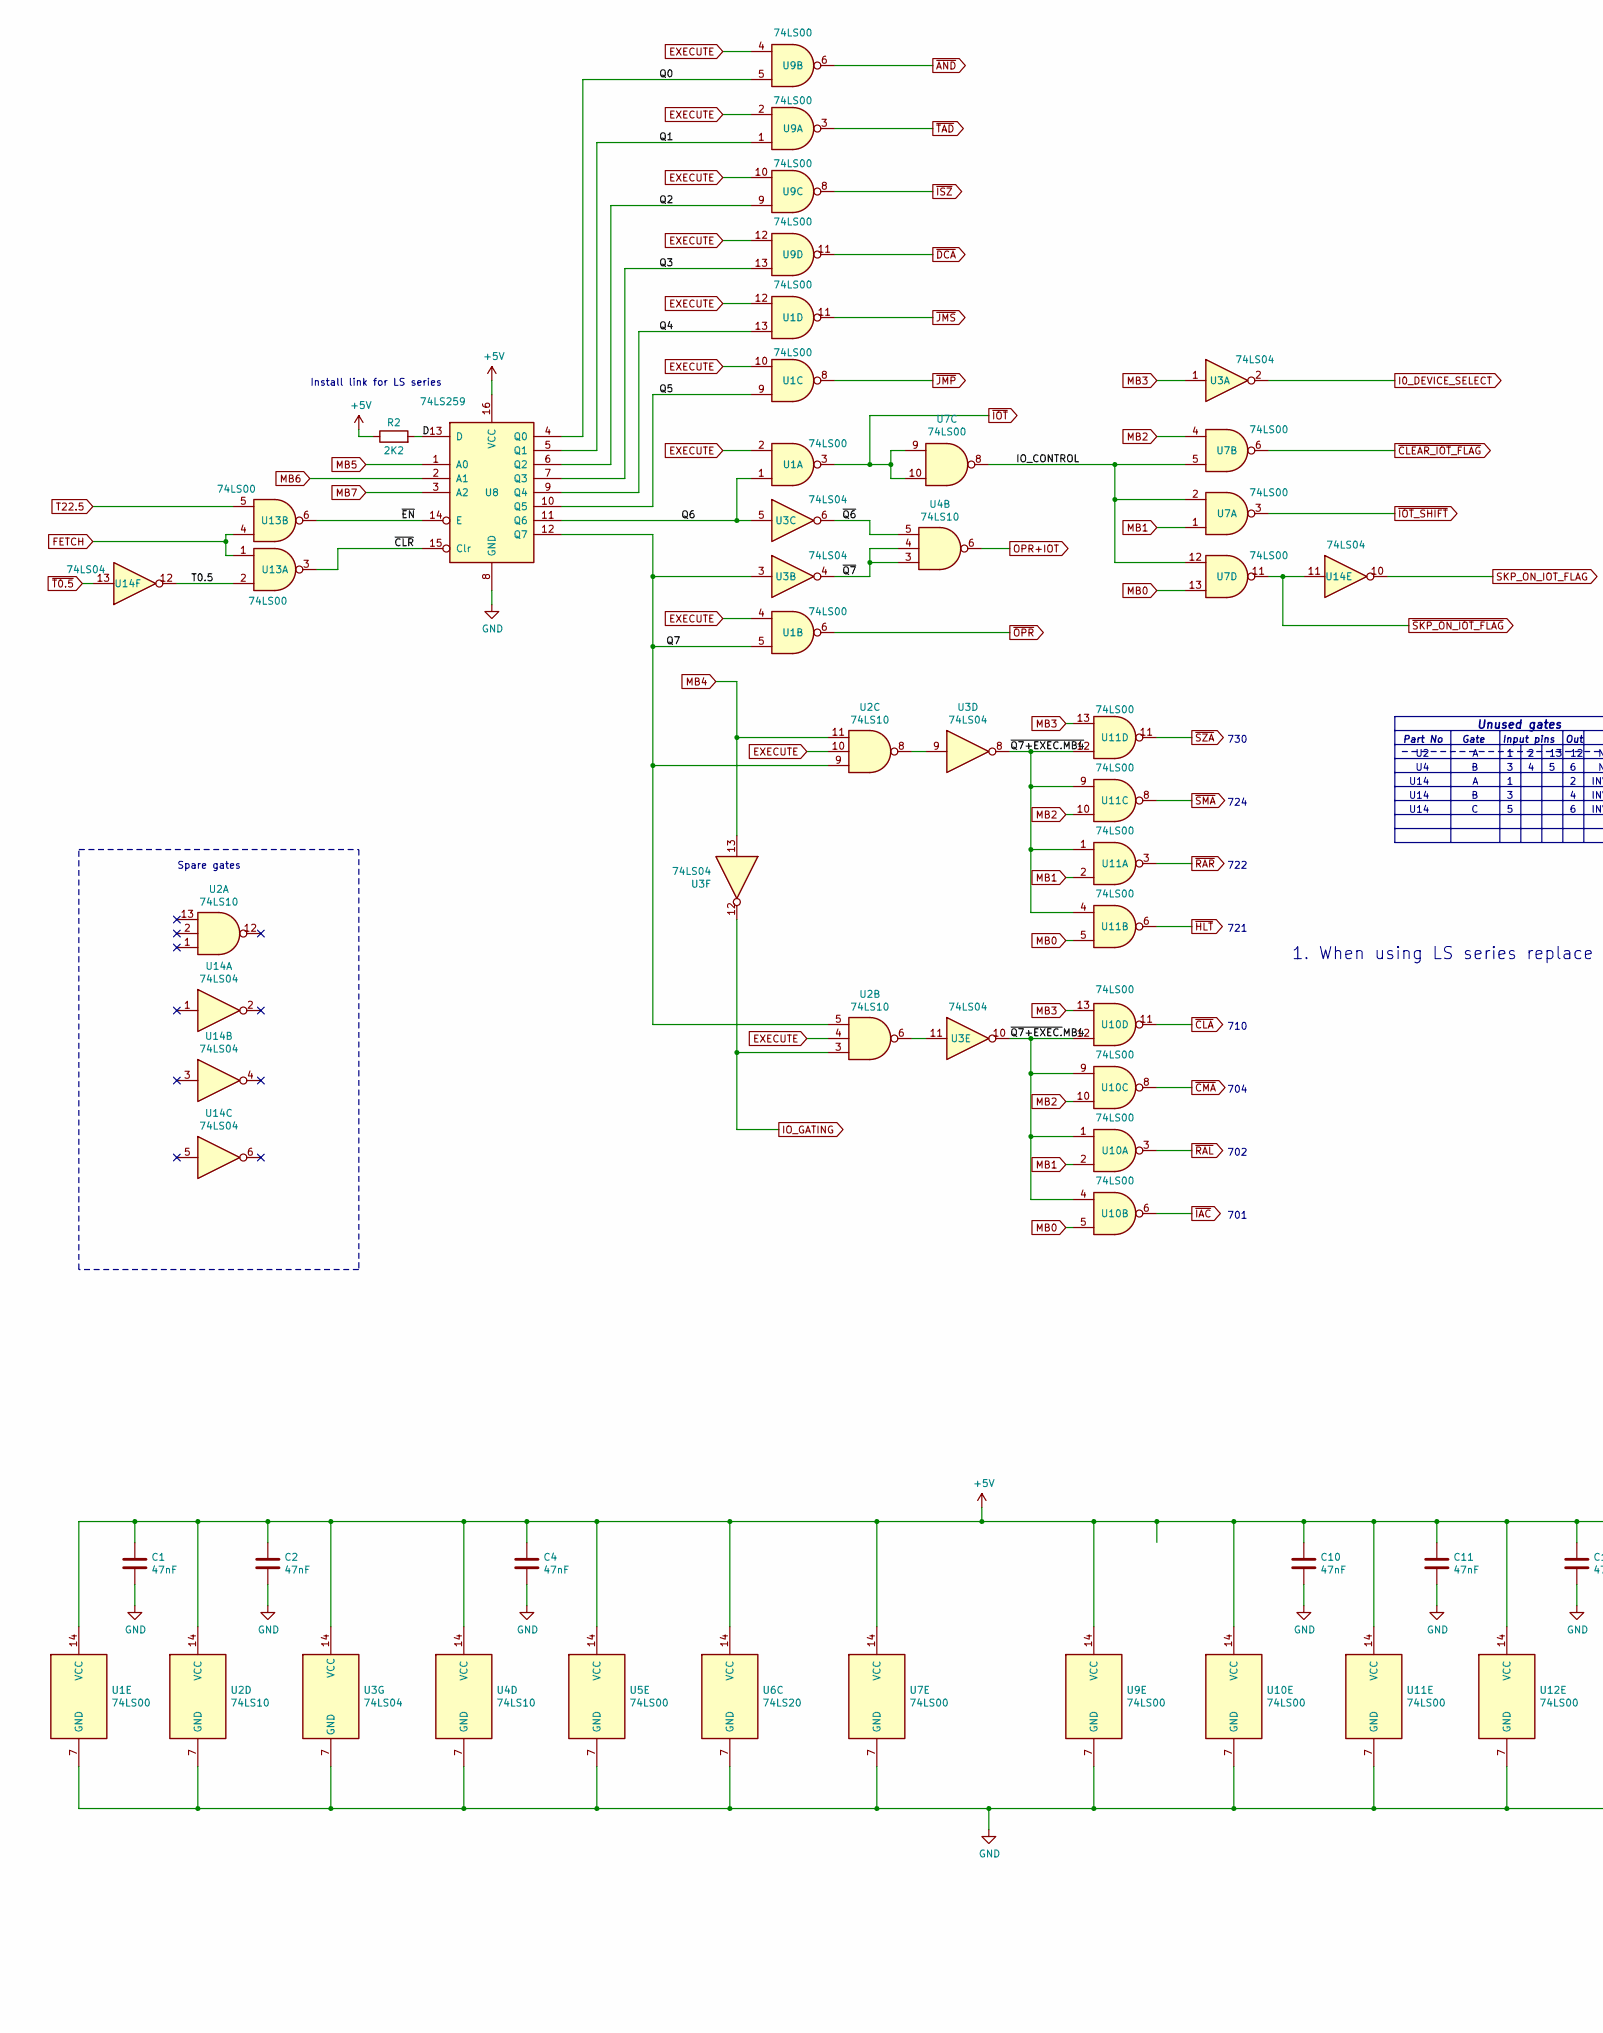
[picture p263: schematic educ 8 decoder.kicad_sch, part in row 1, column 1]

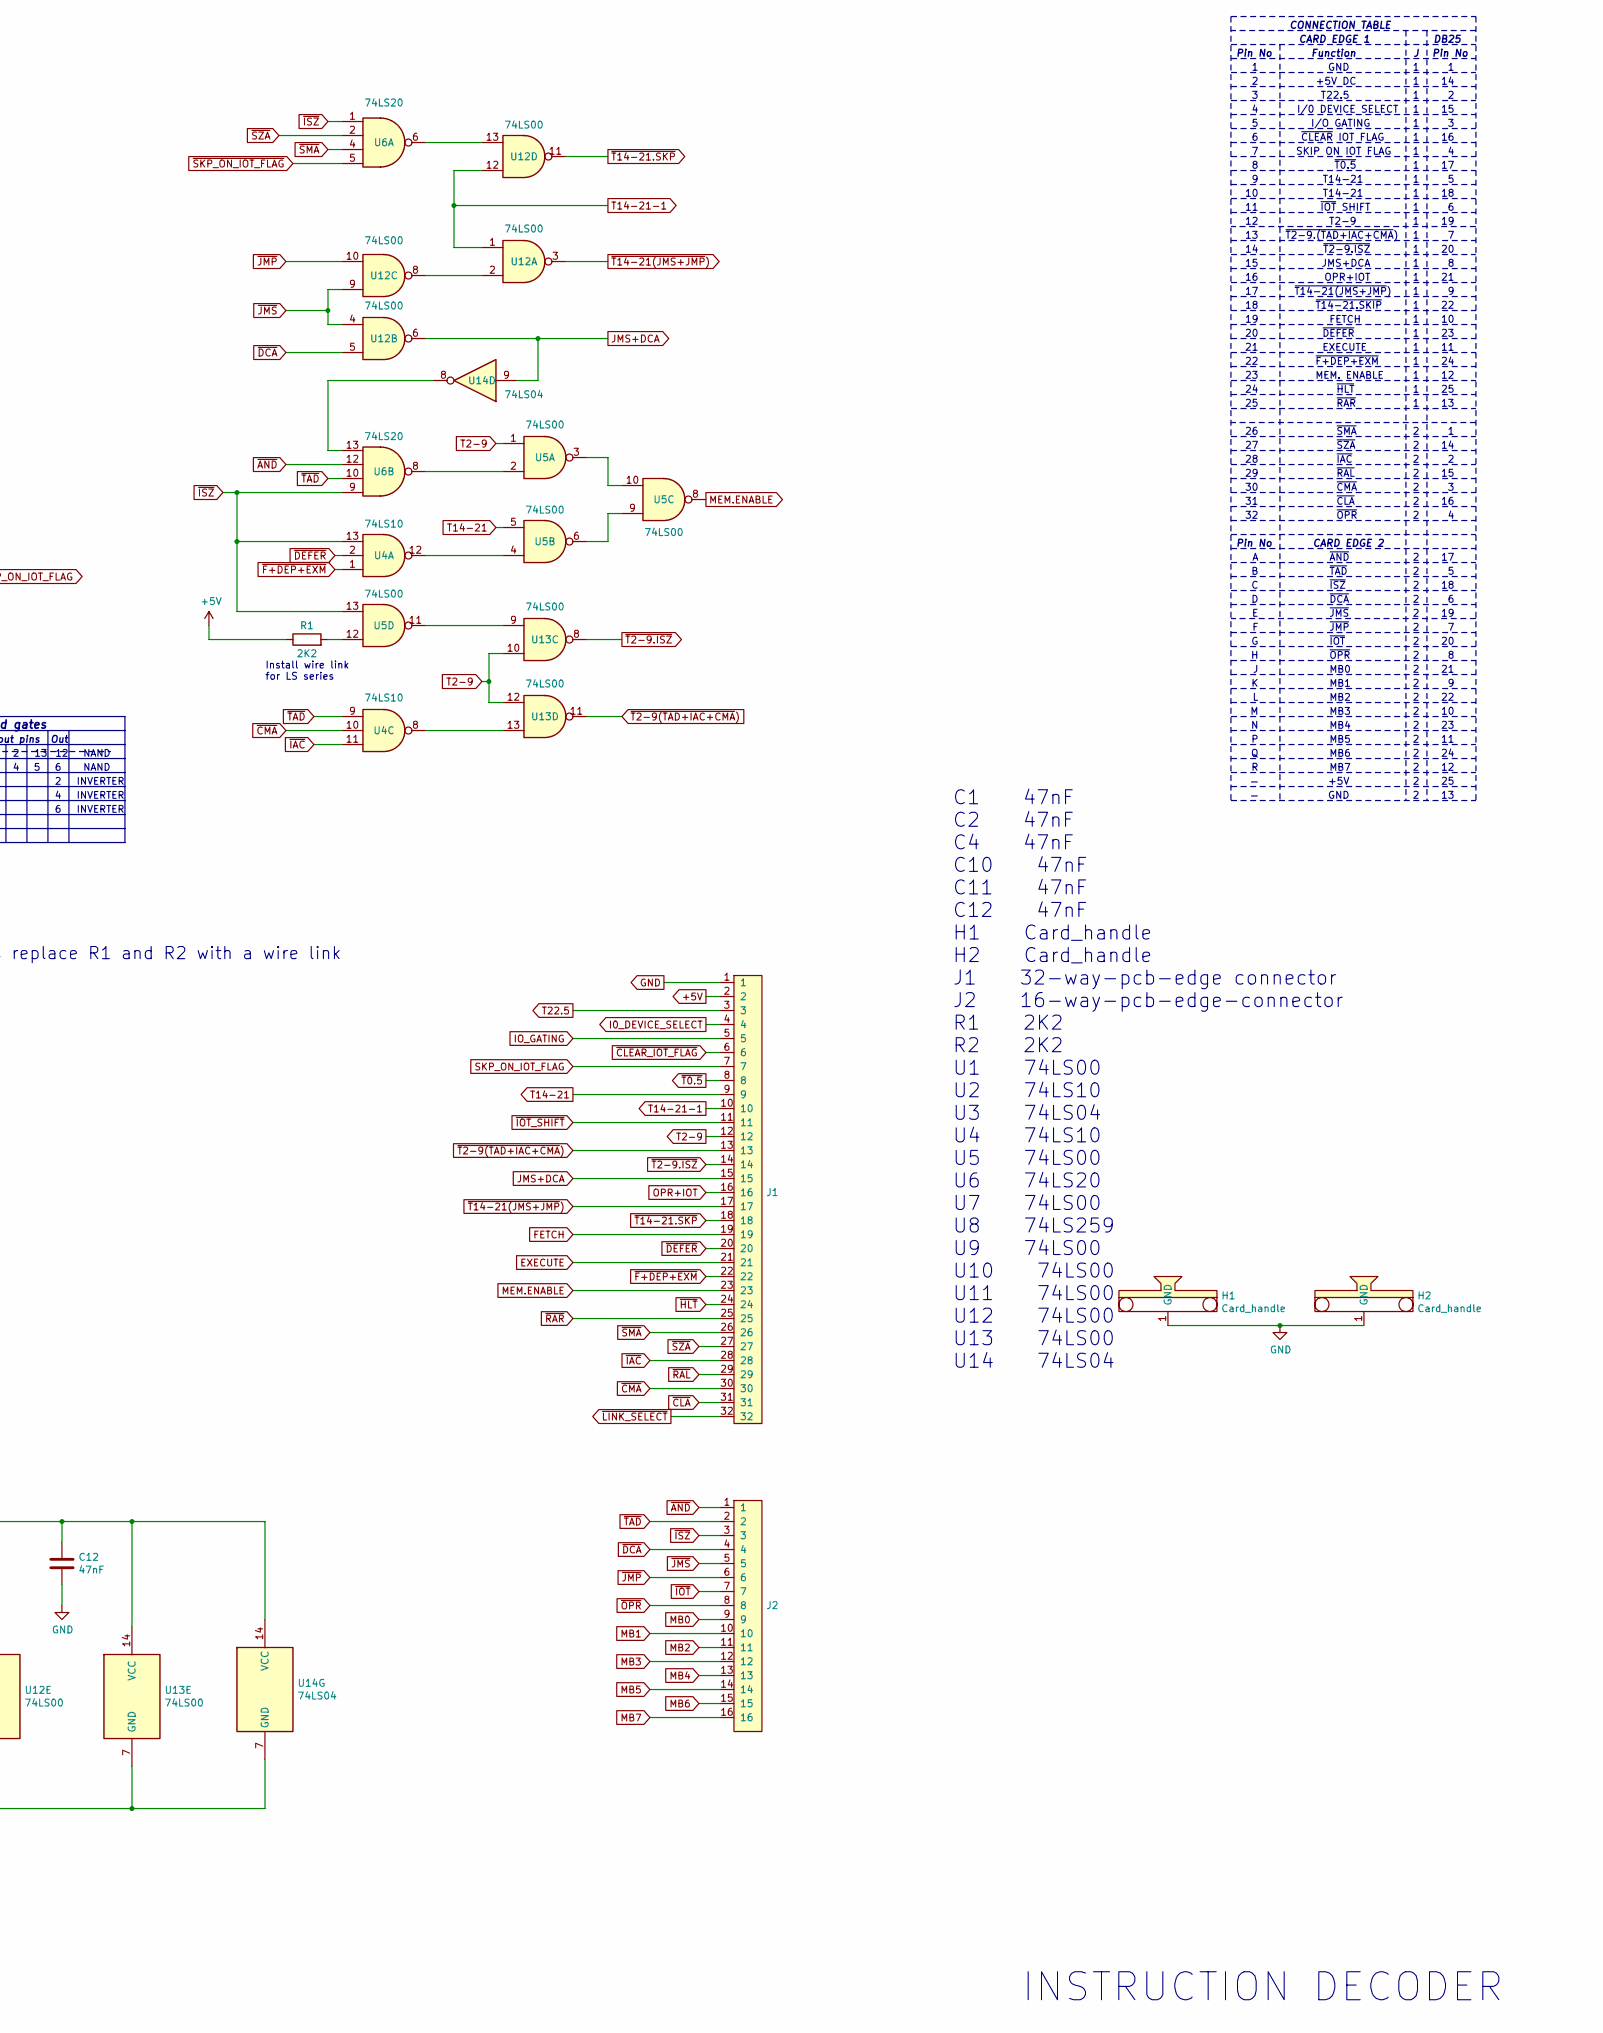
[picture p264: schematic educ 8 decoder.kicad_sch, part in row 1, column 2]

Parts:
C1, C2, C4, C10, C11, C12: 47nF; C_Disc_D7.5mm_W2.5mm_P5.00mm
H1, H2: Card_handle
J1: 32-way-pcb-edge-Educ-8-connectors; PCB_32pin
J2: 16-way-pcb-edge-Educ-8-connectors; PCB_16pin
R1, R2: 2K2; R_Axial_DIN0414_L11.9mm_D4.5mm_P15.24mm_Horizontal
U1, U7, U9, U10, U11, U12: 74LS00; DIP-14_W7.62mm_LongPads
U2, U4: 74LS10; DIP-14_W7.62mm_LongPads
U3, U14: 74LS04; DIP-14_W7.62mm_LongPads
U5: 74LS00
U6: 74LS20; DIP-14_W7.62mm_LongPads
U8: 74LS259; DIP-16_W7.62mm_LongPads
U13: 74LS00; iot_shift

Connections:
+5V: C1.1, C2.1, C4.1, C10.1, C11.1, C12.1, J1.2, R1.1, R2.1, U1.14 (VCC), U2.14 (VCC), U3.14 (VCC), U4.14 (VCC), U5.14 (VCC), U6.14 (VCC), U7.14 (VCC), U8.16 (VCC), U9.14 (VCC), U10.14 (VCC), U11.14 (VCC), U12.14 (VCC), U13.14 (VCC), U14.14 (VCC)
/D: R2.2, U8.13 (D)
/IO_CONTROL: U7.2, U7.5, U7.8, U7.12
/Q0: U8.4 (Q0), U9.5
/Q1: U8.5 (Q1), U9.1
/Q2: U8.6 (Q2), U9.9
/Q3: U8.7 (Q3), U9.13
/Q4: U1.13, U8.9 (Q4)
/Q5: U1.9, U8.10 (Q5)
/Q6: U1.1, U3.5, U8.11 (Q6)
/Q7: U1.5, U2.5, U2.9, U3.3, U8.12 (Q7)
/~CLR: U8.15 (Clr), U13.3
/~EN: U8.14 (E), U13.6
/~Q6: U3.6, U4.5
/~Q7+EXEC.MB4: U3.8, U11.1, U11.4, U11.9, U11.12
/~Q7+EXEC.MB4: U3.10, U10.1, U10.4, U10.9, U10.12
/~Q7: U3.4, U4.3, U4.4
EXECUTE: J1.21, U1.2, U1.4, U1.10, U1.12, U2.4, U2.10, U9.2, U9.4, U9.10, U9.12
GND: C1.2, C2.2, C4.2, C10.2, C11.2, C12.2, H1.1 (GND), H2.1 (GND), J1.1, U1.7 (GND), U2.7 (GND), U3.7 (GND), U4.7 (GND), U5.7 (GND), U6.7 (GND), U7.7 (GND), U8.8 (GND), U9.7 (GND), U10.7 (GND), U11.7 (GND), U12.7 (GND), U13.7 (GND), U14.7 (GND)
I0_DEVICE_SELECT: J1.4, U3.2
IO_GATING: J1.5, U2.3, U3.12
JMS+DCA: J1.15, U12.6, U14.9
MB0: J2.9, U7.13, U10.5, U11.5
MB1: J2.10, U7.1, U10.2, U11.2
MB2: J2.11, U7.4, U10.10, U11.10
MB3: J2.12, U3.1, U10.13, U11.13
MB4: J2.13, U2.11, U3.13
MB5: J2.14, U8.1 (A0)
MB6: J2.15, U8.2 (A1)
MB7: J2.16, U8.3 (A2)
MEM.ENABLE: J1.23, U5.8
unnamed: R1.2, U5.12
unnamed: U2.6, U3.11
unnamed: U2.8, U3.9
unnamed: U4.12, U5.4
unnamed: U5.2, U6.8
unnamed: U5.6, U5.9
unnamed: U5.3, U5.10
unnamed: U12.2, U12.8
unnamed: U6.6, U12.13
unnamed: U5.11, U13.9
unnamed: U4.8, U13.13
unnamed: U6.13, U14.8
OPR+IOT: J1.16, U4.6
SKP_ON_IOT_FLAG: J1.7, U14.10
T2-9: J1.12, U5.1, U13.10, U13.12
T14-21: J1.9, U5.5
T14-21-1: J1.10, U12.1, U12.12
~AND: J2.1, U6.12, U9.6
~CLA: J1.31, U10.11
~CLEAR_IOT_FLAG: J1.6, U7.6
~CMA: J1.30, U4.10, U10.8
~DCA: J2.4, U9.11, U12.5
~DEFER: J1.20, U4.2
~F+DEP+EXM: J1.22, U4.1
~HLT: J1.24, U11.6
~IAC: J1.28, U4.11, U10.6
~IOT_SHIFT: J1.11, U7.3
~IOT: J2.7, U1.3, U7.9, U7.10
~ISZ: J2.3, U4.13, U5.13, U6.1, U6.9, U9.8
~JMP: J2.6, U1.8, U12.10
~JMS: J2.5, U1.11, U12.4, U12.9
~OPR: J2.8, U1.6
~RAL: J1.29, U10.3
~RAR: J1.25, U11.3
~SKP_ON_IOT_FLAG: U6.5, U7.11, U14.11
~SMA: J1.26, U6.4, U11.8
~SZA: J1.27, U6.2, U11.11
~T0.5: J1.8, U14.13
~T2-9(TAD+IAC+CMA): J1.13, U13.11
~T2-9.ISZ: J1.14, U13.8
~T14-21(JMS+JMP): J1.17, U12.3
~T14-21.SKP: J1.18, U12.11
~TAD: J2.2, U4.9, U6.10, U9.3

Notes on the sheet:
Install wire link for LS series
~{CLA}
MB5
U14
704
~{T2-9.ISZ}
Spare gates
CONNECTION TABLE
~{CLEAR} IOT FLAG
INVERTER
I/O GATING
MB4
+5V
EXECUTE
T22.5
Pin No
NAND
Unused gates
Install link for LS series
~{IOT}
~{DEFER}
~{TAD}
~{ISZ}
1. When using LS series replace R1 and R2 with a wire link
MB2
Function
Input pins
T14-21
CARD EDGE 2
~{RAL}
~{OPR}
Gate
MB6
JMS+DCA
~{T14-21(JMS+JMP})
GND
~{SMA}
MB0
~{RAR}
CARD EDGE 1
~{JMS}
+5V DC
C1 47nF C2 47nF C4 47nF C10 47nF C11 47nF C12 47nF H1 Card_handle H2 Card_handle J1 32-way-pcb-edge connector J2 16-way-pcb-edge-connector R1 2K2 R2 2K2 U1 74LS00 U2 74LS10 U3 74LS04 U4 74LS10 U5 74LS00 U6 74LS20 U7 74LS00 U8 74LS259 U9 74LS00 U10 74LS00 U11 74LS00 U12 74LS00 U13 74LS00 U14 74LS04
~{IAC}
T2-9
~{AND}
702
Part No
INSTRUCTION DECODER
~{F+DEP+EXM}
~{IOT} SHIFT
710
~{SZA}
GND
730
724
FETCH
~{T14-21.SKIP}
~{JMP}
DB25
~{DCA}
MB7
MB3
721
~{HLT}
OPR+IOT
701
~{CMA}
SKIP ON IOT FLAG
722
~{T2-9.(TAD+IAC+CMA})
~{T0.5}
Out
MEM. ENABLE
I/0 DEVICE SELECT
MB1

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
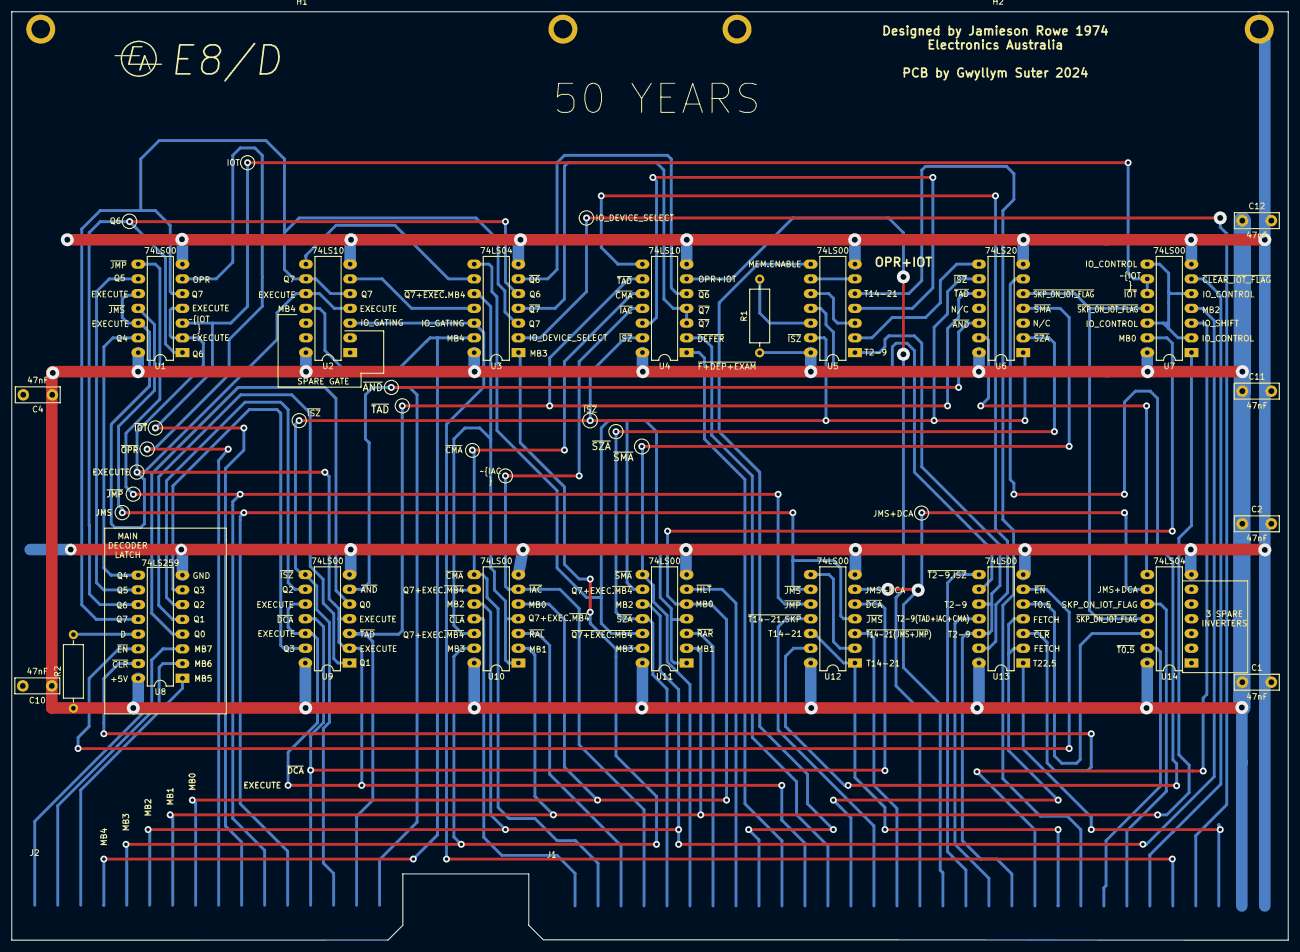
[picture p265: board educ 8 decoder.kicad_pcb from above]

Board: 2 copper layers, 220.0 x 160.0 mm, 26 parts (0 on the bottom side), 77 nets.
