ibm2030/EDUC8/256 word memory/256 word memory.kicad_pcb

## KiCad design 256 word memory/256 word memory.kicad_pcb (2025-07-23)

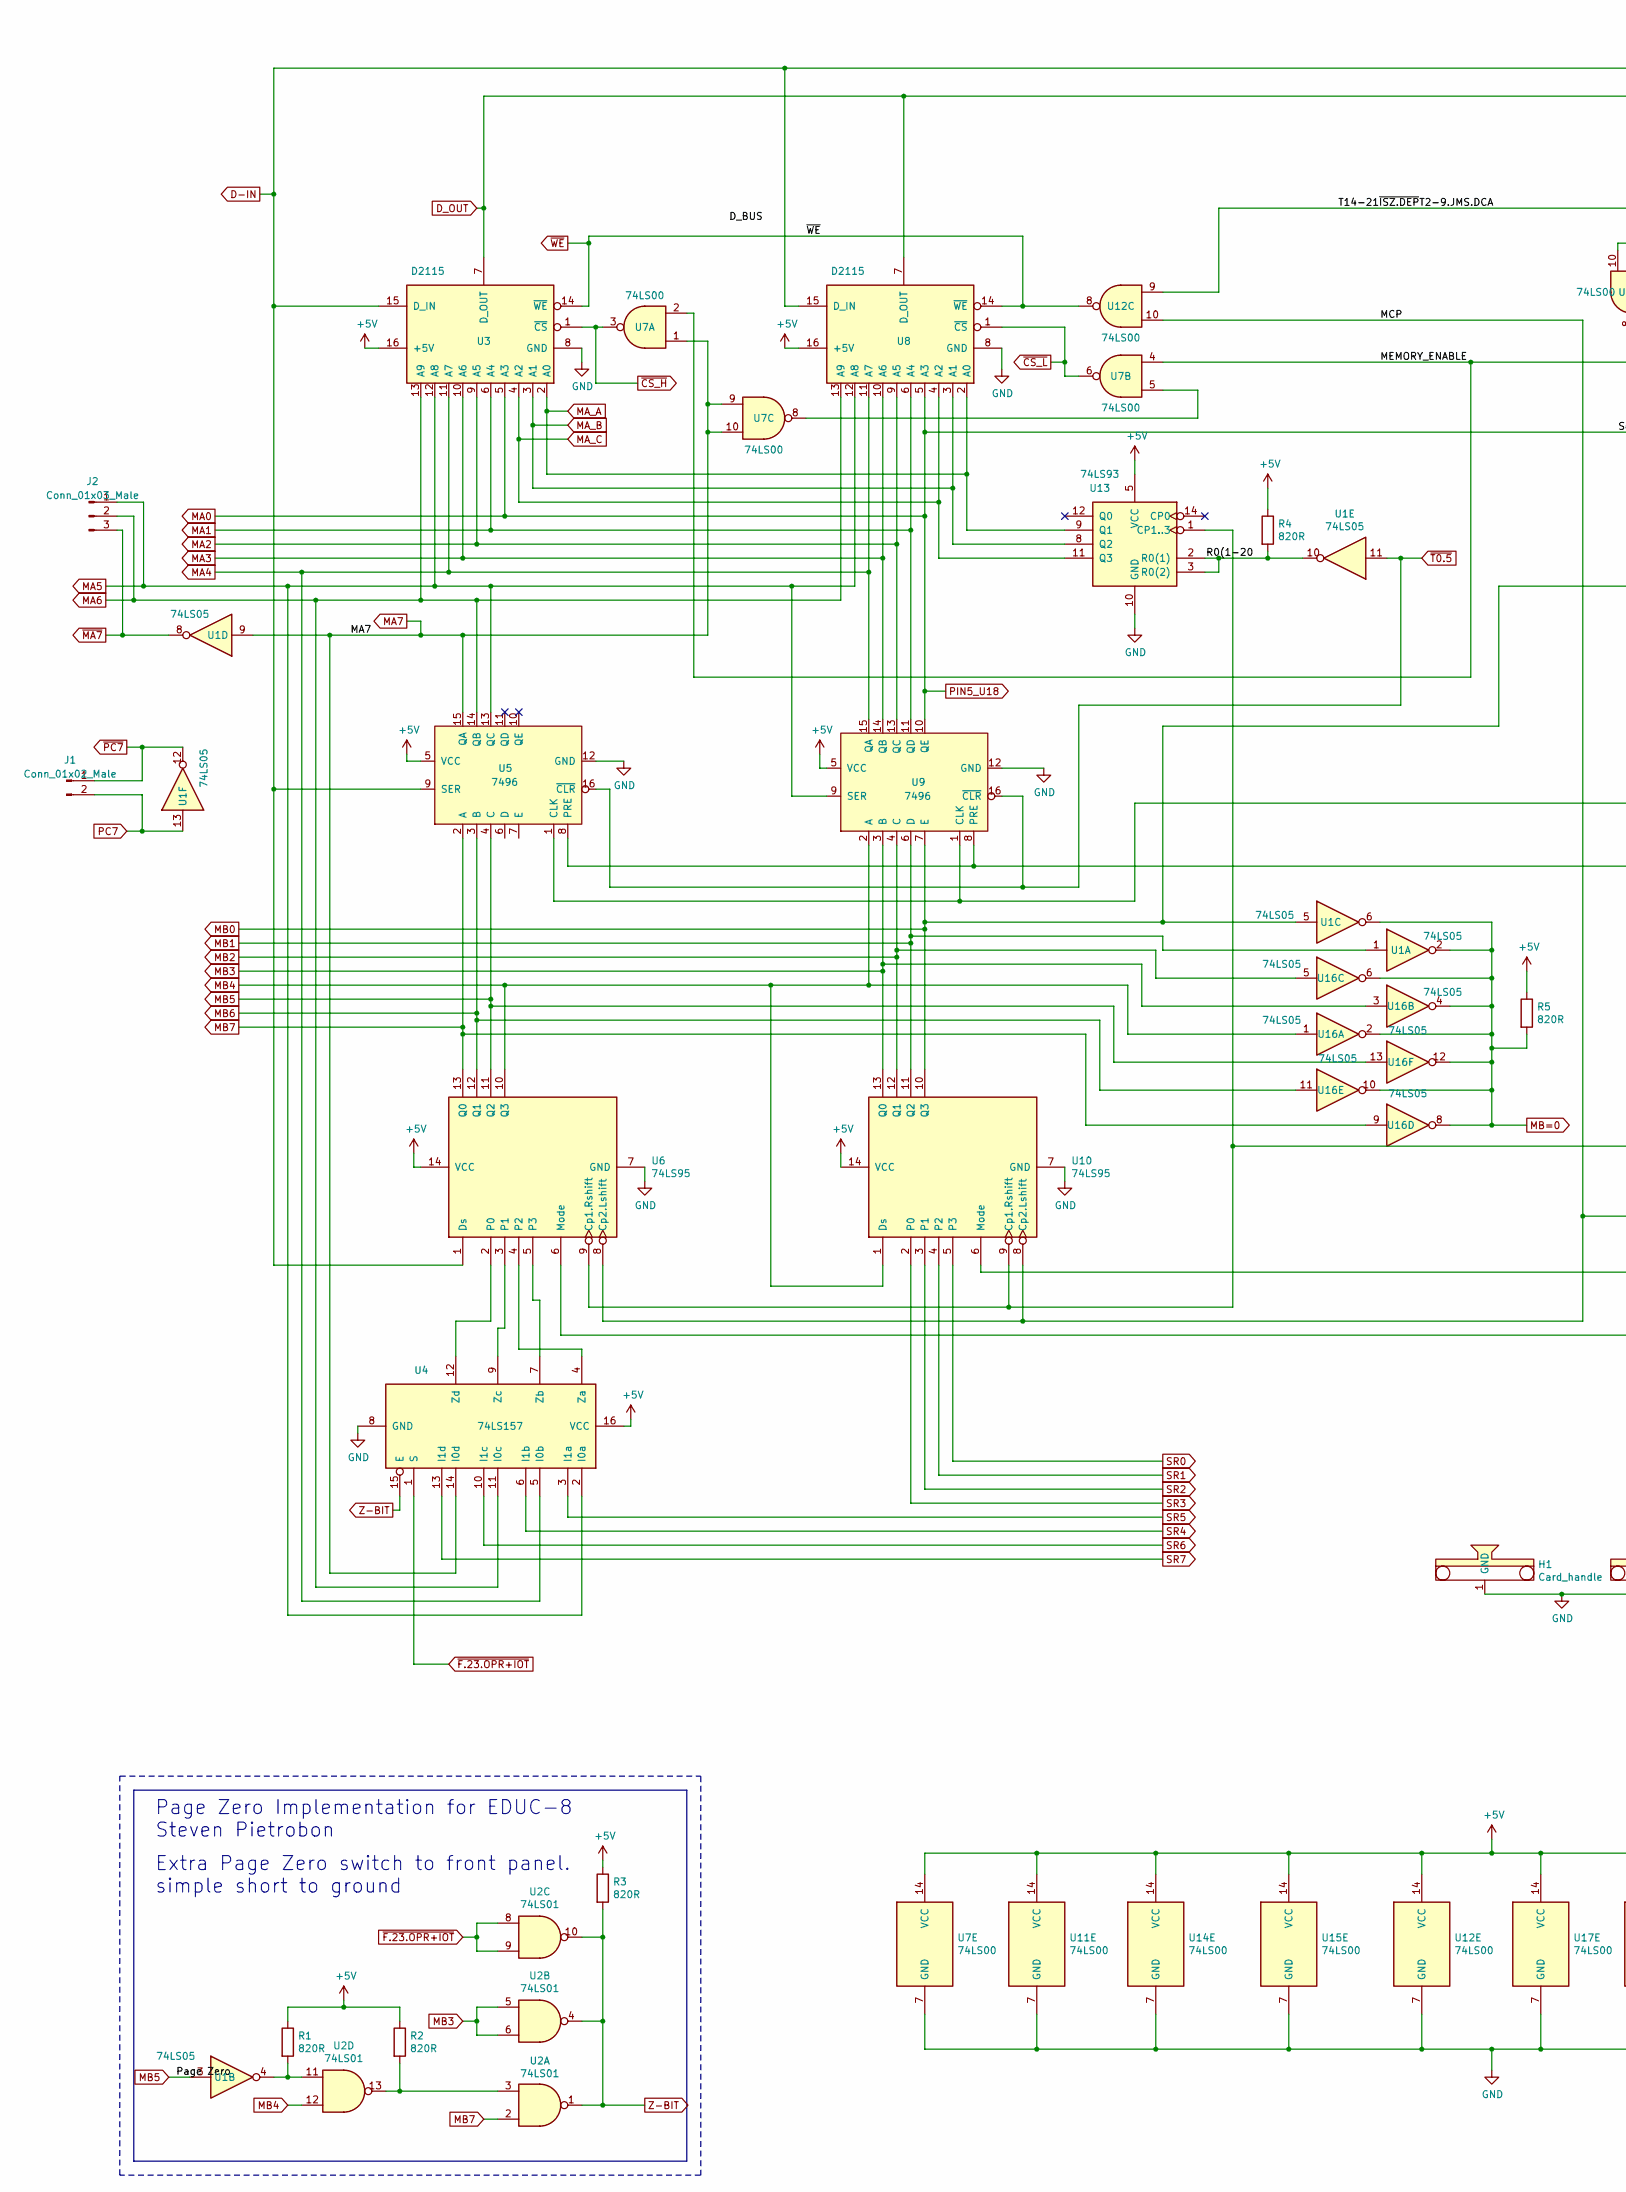
[picture p266: schematic 256 word memory.kicad_sch, EDUC-8 256 WORD MEMORY, part in row 1, column 1]

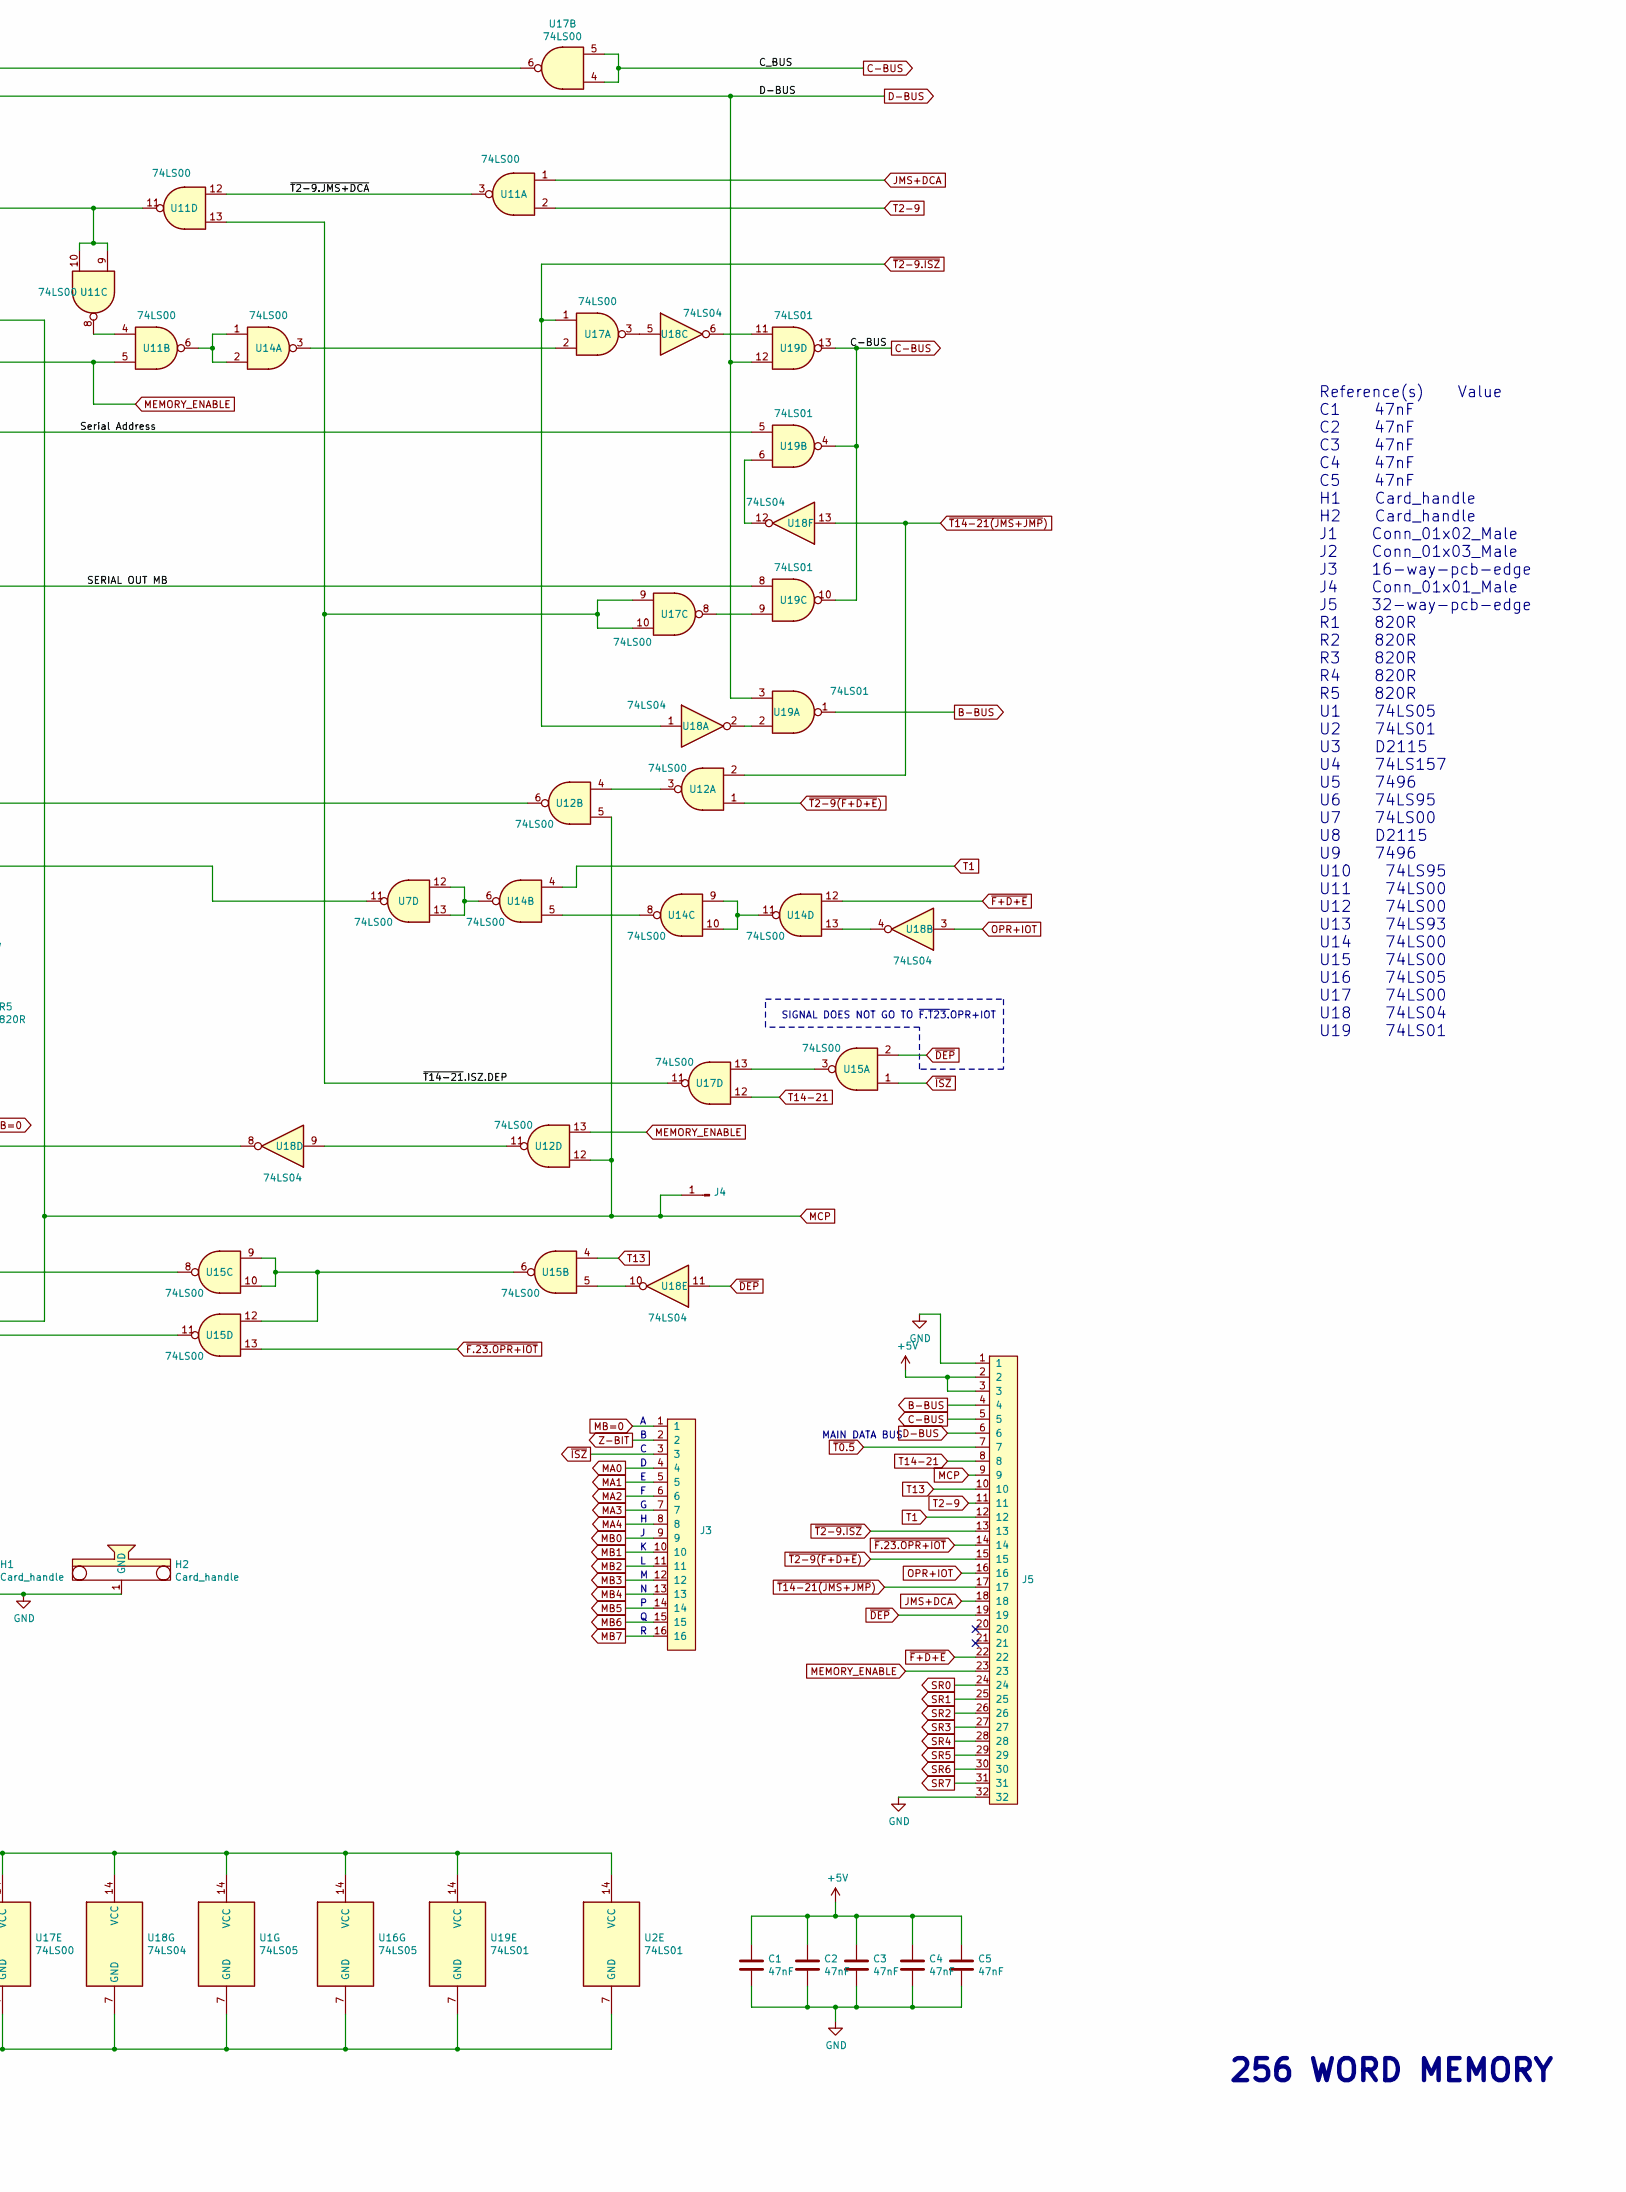
[picture p267: schematic 256 word memory.kicad_sch, EDUC-8 256 WORD MEMORY, part in row 1, column 2]

Parts:
C1, C2, C3, C4, C5: 47nF; C_Disc_D5.0mm_W2.5mm_P5.00mm
H1, H2: Card_handle
J1: Conn_01x02_Male; JST_XH_S2B-XH-A_1x02_P2.50mm_Horizontal
J2: Conn_01x03_Male; JST_XH_S3B-XH-A_1x03_P2.50mm_Horizontal
J3: 16-way-pcb-edge-Educ-8-connectors; PCB_16pin
J4: Conn_01x01_Male; Pin_D1.0mm_L10.0mm
J5: 32-way-pcb-edge-Educ-8-connectors; PCB_32pin
R1, R2, R3, R4, R5: 820R; R_Axial_DIN0207_L6.3mm_D2.5mm_P10.16mm_Horizontal
U1, U16: 74LS05; DIP-14_W7.62mm
U2, U19: 74LS01; DIP-14_W7.62mm
U3, U8: D2115; DIP-16_W7.62mm
U4: 74LS157; DIP-16_W7.62mm
U5, U9: 7496; DIP-16_W7.62mm
U6, U10: 74LS95; DIP-14_W7.62mm
U7, U11, U12, U14, U15, U17: 74LS00; DIP-14_W7.62mm
U13: 74LS93; DIP-14_W7.62mm
U18: 74LS04; DIP-14_W7.62mm

Connections:
+5V: C1.1, C2.1, C3.1, C4.1, C5.1, J5.2, J5.3, R1.1, R2.1, R3.1, R4.1, R5.1, U1.14 (VCC), U2.14 (VCC), U3.16 (+5V), U4.16 (VCC), U5.5 (VCC), U6.14 (VCC), U7.14 (VCC), U8.16 (+5V), U9.5 (VCC), U10.14 (VCC), U11.14 (VCC), U12.14 (VCC), U13.5 (VCC), U14.14 (VCC), U15.14 (VCC), U16.14 (VCC), U17.14 (VCC), U18.14 (VCC), U19.14 (VCC)
/R0(1-20: R4.2, U1.10, U13.2 (R0(1)), U13.3 (R0(2))
/T14-21~ISZ.DEPT2-9.JMS.DCA: U11.9, U11.10, U11.11, U12.9
/~T2-9.JMS+DCA: U11.3, U11.12
/~T14-21.ISZ.DEP: U11.13, U17.9, U17.10, U17.11
B-BUS: J5.4, U19.1
C-BUS: J5.5, U17.4, U17.5, U19.4, U19.10, U19.13
D-BUS: J5.6, U3.7 (D_OUT), U8.7 (D_OUT), U19.3, U19.12
D-IN: U3.15 (D_IN), U5.9 (SER), U6.1 (Ds), U8.15 (D_IN), U17.6
GND: C1.2, C2.2, C3.2, C4.2, C5.2, H1.1 (GND), H2.1 (GND), J5.1, J5.32, U1.7 (GND), U2.7 (GND), U3.8 (GND), U4.8 (GND), U5.12 (GND), U6.7 (GND), U7.7 (GND), U8.8 (GND), U9.12 (GND), U10.7 (GND), U11.7 (GND), U12.7 (GND), U13.10 (GND), U14.7 (GND), U15.7 (GND), U16.7 (GND), U17.7 (GND), U18.7 (GND), U19.7 (GND)
JMS+DCA: J5.18, U11.1
MA0: J3.4, U3.5 (A3), U8.5 (A3), U9.10 (QE), U19.5
MA1: J3.5, U3.6 (A4), U8.6 (A4), U9.11 (QD)
MA2: J3.6, U3.9 (A5), U8.9 (A5), U9.13 (QC)
MA3: J3.7, U3.10 (A6), U8.10 (A6), U9.14 (QB)
MA4: J3.8, U3.11 (A7), U4.5 (I0b), U8.11 (A7), U9.15 (QA)
MA5: J2.1, U3.12 (A8), U4.2 (I0a), U5.13 (QC), U8.12 (A8), U9.9 (SER)
MA6: J2.2, U3.13 (A9), U4.11 (I0c), U5.14 (QB), U8.13 (A9)
MA7: U1.9, U4.14 (I0d), U5.15 (QA), U7.1, U7.9, U7.10
MA_A: U3.2 (A0), U8.2 (A0), U13.9 (Q1)
MA_B: U3.3 (A1), U8.3 (A1), U13.8 (Q2)
MA_C: U3.4 (A2), U8.4 (A2), U13.11 (Q3)
MB0: J3.9, U1.5, U9.7 (E), U10.10 (Q3), U19.8
MB1: J3.10, U1.1, U9.6 (D), U10.11 (Q2)
MB2: J3.11, U9.4 (C), U10.12 (Q1), U16.5
MB3: J3.12, U2.5, U2.6, U9.3 (B), U10.13 (Q0), U16.3
MB4: J3.13, U2.12, U6.10 (Q3), U9.2 (A), U10.1 (Ds), U16.1
MB5: J3.14, U1.3, U5.4 (C), U6.11 (Q2), U16.13
MB6: J3.15, U5.3 (B), U6.12 (Q1), U16.11
MB7: J3.16, U2.2, U5.2 (A), U6.13 (Q0), U16.9
MB=0: J3.1, R5.2, U1.2, U1.6, U16.2, U16.4, U16.6, U16.8, U16.10, U16.12
MCP: J4.1, J5.9, U6.8 (Cp2.Lshift), U10.8 (Cp2.Lshift), U12.5, U12.10, U12.12
MEMORY_ENABLE: J5.23, U7.2, U7.4, U11.5, U12.13
unnamed: R1.2, U1.4, U2.11
unnamed: R2.2, U2.3, U2.13
unnamed: U4.4 (Za), U6.4 (P2)
unnamed: U4.7 (Zb), U6.5 (P3)
unnamed: U4.9 (Zc), U6.3 (P1)
unnamed: U4.12 (Zd), U6.2 (P0)
unnamed: U5.1 (CLK), U9.1 (CLK), U12.6
unnamed: U5.8 (PRE), U7.11, U9.8 (PRE)
unnamed: U6.6 (Mode), U15.11
unnamed: U7.5, U7.8
unnamed: U6.9 (Cp1.Rshift), U10.9 (Cp1.Rshift), U13.1 (CP1..3), U18.8
unnamed: U10.6 (Mode), U15.8
unnamed: U11.4, U11.8
unnamed: U11.6, U14.1, U14.2
unnamed: U12.3, U12.4
unnamed: U12.11, U18.9
unnamed: U14.3, U17.2
unnamed: U14.5, U14.8
unnamed: U7.12, U7.13, U14.6
unnamed: U14.9, U14.10, U14.11
unnamed: U14.13, U18.4
unnamed: U15.3, U17.13
unnamed: U15.5, U18.10
unnamed: U15.6, U15.9, U15.10, U15.12
unnamed: U17.3, U18.5
unnamed: U17.8, U19.9
unnamed: U18.2, U19.2
unnamed: U18.6, U19.11
unnamed: U18.12, U19.6
OPR+IOT: J5.16, U18.3
PC7: J1.2, U1.13
SR0: J5.24, U10.5 (P3)
SR1: J5.25, U10.4 (P2)
SR2: J5.26, U10.3 (P1)
SR3: J5.27, U10.2 (P0)
SR4: J5.28, U4.6 (I1b)
SR5: J5.29, U4.3 (I1a)
SR6: J5.30, U4.10 (I1c)
SR7: J5.31, U4.13 (I1d)
T1: J5.12, U14.4
T2-9: J5.11, U11.2
T13: J5.10, U15.4
T14-21: J5.8, U17.12
Z-BIT: J3.2, R3.2, U2.1, U2.4, U2.10, U4.15 (E)
~CS_H: U3.1 (~CS), U7.3
~CS_L: U7.6, U8.1 (~CS)
~DEP: J5.19, U15.2, U18.11
~F+D+E: J5.22, U14.12
~F.23.OPR+IOT: J5.14, U2.8, U2.9, U4.1 (S), U15.13
~ISZ: J3.3, U15.1
~MA7: J2.3, U1.8
~PC7: J1.1, U1.12
~T0.5: J5.7, U1.11, U5.16 (~CLR), U9.16 (~CLR)
~T2-9(F+D+E): J5.15, U12.1
~T2-9.ISZ: J5.13, U17.1, U18.1
~T14-21(JMS+JMP): J5.17, U12.2, U18.13
~WE: U3.14 (~WE), U8.14 (~WE), U12.8

Notes on the sheet:
SIGNAL DOES NOT GO TO ~{F.T23.}OPR+IOT
Extra Page Zero switch to front panel. simple short to ground
Reference(s) Value C1 47nF C2 47nF C3 47nF C4 47nF C5 47nF H1 Card_handle H2 Card_handle J1 Conn_01x02_Male J2 Conn_01x03_Male J3 16-way-pcb-edge J4 Conn_01x01_Male J5 32-way-pcb-edge R1 820R R2 820R R3 820R R4 820R R5 820R U1 74LS05 U2 74LS01 U3 D2115 U4 74LS157 U5 7496 U6 74LS95 U7 74LS00 U8 D211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
Page Zero Implementation for EDUC-8 Steven Pietrobon
256 WORD MEMORY
MAIN DATA BUS

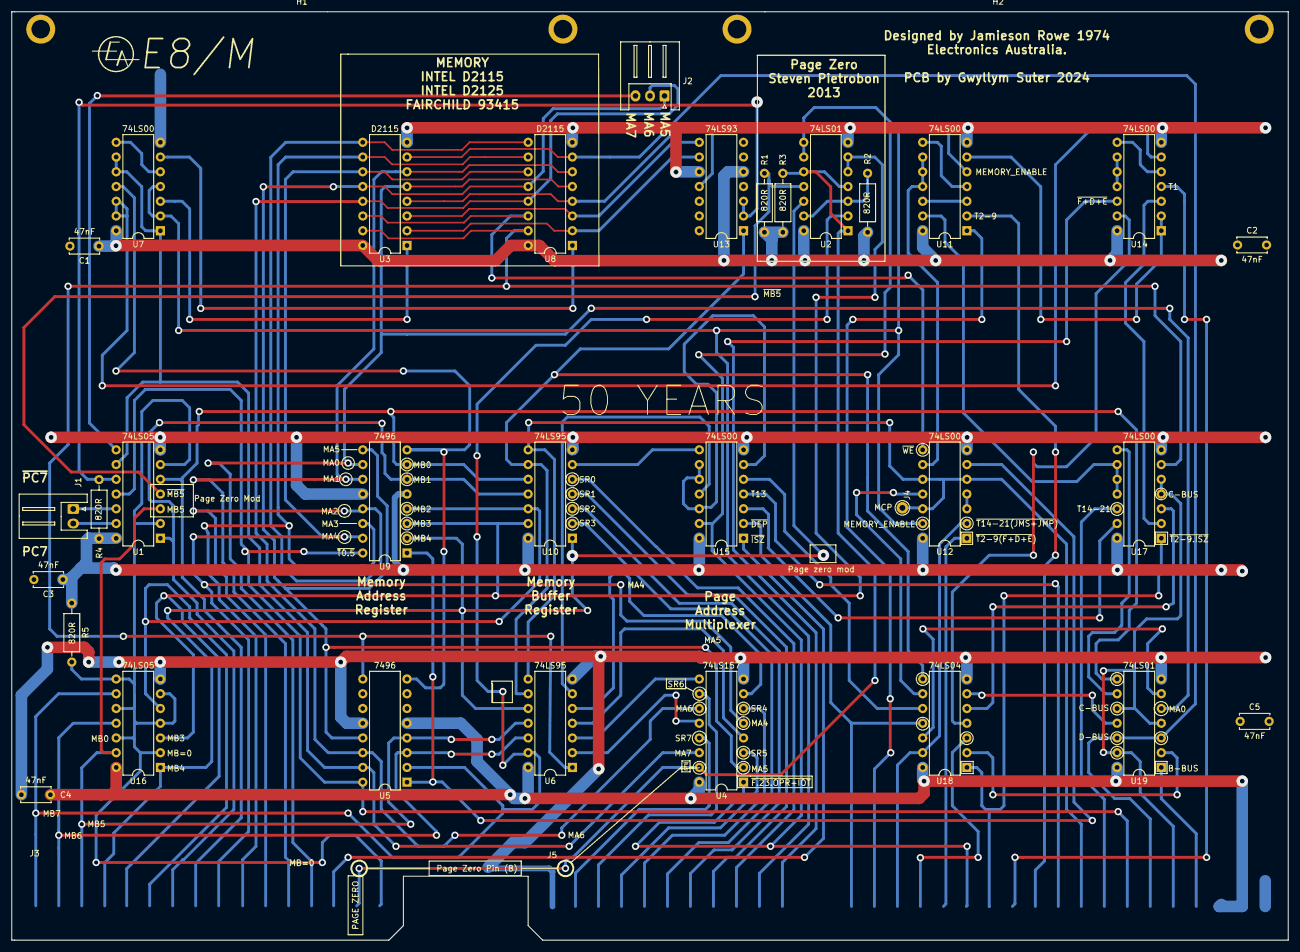
[picture p268: board 256 word memory.kicad_pcb from above]

Board: 2 copper layers, 220.0 x 160.0 mm, 36 parts (0 on the bottom side), 90 nets.
