ibm2030/EDUC8/Octal display/Octal display.kicad_pcb

## KiCad design Octal display/Octal display.kicad_pcb (2024-06-13)

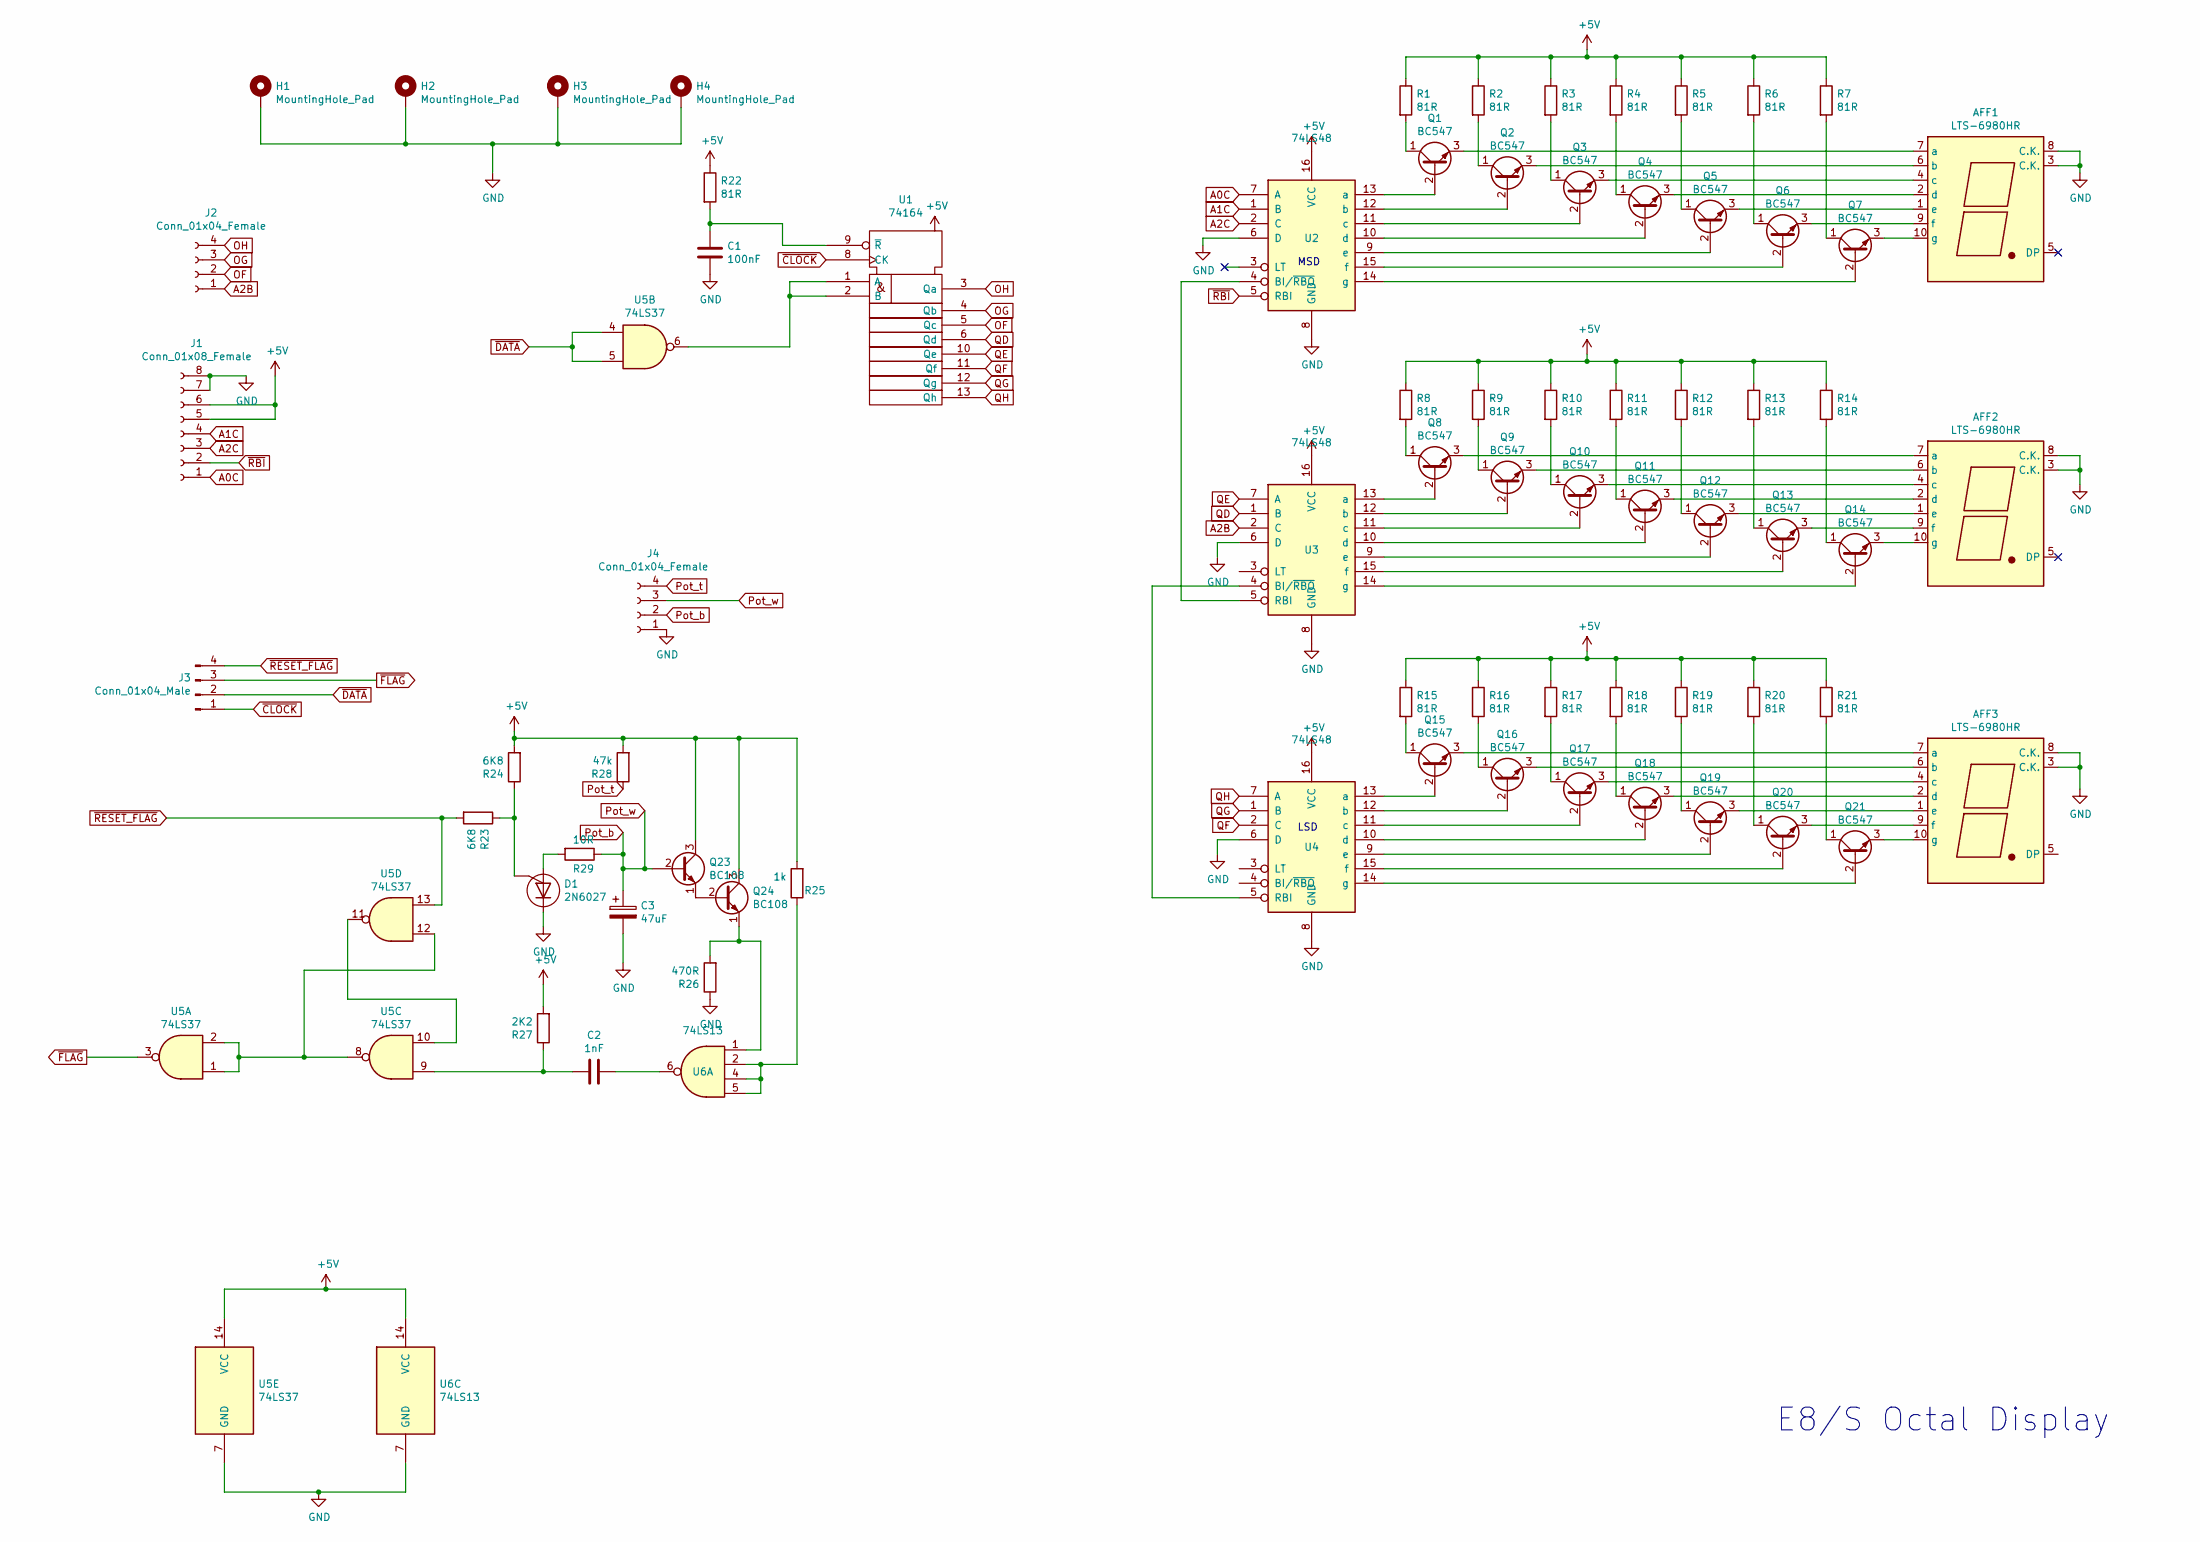
[picture p269: schematic Octal display.kicad_sch]

Parts:
AFF1, AFF2, AFF3: LTS-6980HR; 7SegmentLED_LTS6760_LTS6780
C1: 100nF; C_Rect_L7.0mm_W2.5mm_P5.00mm
C2: 1nF; C_Disc_D5.0mm_W2.5mm_P5.00mm
C3: 47uF; CP_Radial_D5.0mm_P2.50mm
D1: 2N6027; TO-92_Inline_Wide
H1, H2, H3, H4: MountingHole_Pad; MountingHole_3.2mm_M3_Pad_Via
J1: Conn_01x08_Female; PinSocket_1x08_P2.54mm_Vertical
J2, J4: Conn_01x04_Female; PinSocket_1x04_P2.54mm_Vertical
J3: Conn_01x04_Male; PinHeader_1x04_P2.54mm_Vertical
Q1, Q2, Q3, Q4, Q5, Q6, Q7, Q8, Q9, Q10, Q11, Q12, Q13, Q14, Q15, Q16, Q17, Q18, Q19, Q20, Q21: BC547; TO-92_Inline_Wide
Q23, Q24: BC108; TO-18-3
R1, R2, R3, R4, R5, R6, R7, R8, R9, R10, R11, R12, R13, R14, R15, R16, R17, R18, R19, R20, R21, R22: 81R; R_Axial_DIN0207_L6.3mm_D2.5mm_P10.16mm_Horizontal
R23, R24: 6K8; R_Axial_DIN0207_L6.3mm_D2.5mm_P10.16mm_Horizontal
R25: 1k; R_Axial_DIN0207_L6.3mm_D2.5mm_P10.16mm_Horizontal
R26: 470R; R_Axial_DIN0207_L6.3mm_D2.5mm_P10.16mm_Horizontal
R27: 2K2; R_Axial_DIN0207_L6.3mm_D2.5mm_P10.16mm_Horizontal
R28: 47k; R_Axial_DIN0207_L6.3mm_D2.5mm_P10.16mm_Horizontal
R29: 10R; R_Axial_DIN0207_L6.3mm_D2.5mm_P10.16mm_Horizontal
U1: 74164; DIP-14_W7.62mm_LongPads
U2, U3, U4: 74LS48; DIP-16_W7.62mm
U5: 74LS37; DIP-14_W7.62mm
U6: 74LS13; DIP-14_W7.62mm

Connections:
+5V: J1.5, J1.6, Q23.3 (C), Q24.3 (C), R1.1, R2.1, R3.1, R4.1, R5.1, R6.1, R7.1, R8.1, R9.1, R10.1, R11.1, R12.1, R13.1, R14.1, R15.1, R16.1, R17.1, R18.1, R19.1, R20.1, R21.1, R22.1, R24.2, R25.2, R27.2, R28.2, U1.14 (Vdd), U2.16 (VCC), U3.16 (VCC), U4.16 (VCC), U5.14 (VCC), U6.14 (VCC)
A0C: J1.1, U2.7 (A)
A1C: J1.4, U2.1 (B)
A2B: J2.1, U3.2 (C)
A2C: J1.3, U2.2 (C)
GND: AFF1.3 (C.K.), AFF1.8 (C.K.), AFF2.3 (C.K.), AFF2.8 (C.K.), AFF3.3 (C.K.), AFF3.8 (C.K.), C1.2, C3.2, D1.3 (K), H1.1, H2.1, H3.1, H4.1, J1.7, J1.8, J4.1, R26.1, U2.6 (D), U2.8 (GND), U3.6 (D), U3.8 (GND), U4.6 (D), U4.8 (GND), U5.7 (GND), U6.7 (GND)
unnamed: AFF1.1 (e), Q5.3 (E)
unnamed: AFF1.2 (d), Q4.3 (E)
unnamed: AFF1.4 (c), Q3.3 (E)
unnamed: AFF1.6 (b), Q2.3 (E)
unnamed: AFF1.7 (a), Q1.3 (E)
unnamed: AFF1.9 (f), Q6.3 (E)
unnamed: AFF1.10 (g), Q7.3 (E)
unnamed: AFF2.1 (e), Q12.3 (E)
unnamed: AFF2.2 (d), Q11.3 (E)
unnamed: AFF2.4 (c), Q10.3 (E)
unnamed: AFF2.6 (b), Q9.3 (E)
unnamed: AFF2.7 (a), Q8.3 (E)
unnamed: AFF2.9 (f), Q13.3 (E)
unnamed: AFF2.10 (g), Q14.3 (E)
unnamed: AFF3.1 (e), Q19.3 (E)
unnamed: AFF3.2 (d), Q18.3 (E)
unnamed: AFF3.4 (c), Q17.3 (E)
unnamed: AFF3.6 (b), Q16.3 (E)
unnamed: AFF3.7 (a), Q15.3 (E)
unnamed: AFF3.9 (f), Q20.3 (E)
unnamed: AFF3.10 (g), Q21.3 (E)
unnamed: C1.1, R22.2, U1.9 (~R)
unnamed: C2.1, U6.6
unnamed: C2.2, R27.1, U5.9
unnamed: D1.1 (A), R29.2
unnamed: D1.2 (G), R23.1, R24.1
unnamed: Q1.1 (C), R1.2
unnamed: Q1.2 (B), U2.13 (a)
unnamed: Q2.1 (C), R2.2
unnamed: Q2.2 (B), U2.12 (b)
unnamed: Q3.1 (C), R3.2
unnamed: Q3.2 (B), U2.11 (c)
unnamed: Q4.1 (C), R4.2
unnamed: Q4.2 (B), U2.10 (d)
unnamed: Q5.1 (C), R5.2
unnamed: Q5.2 (B), U2.9 (e)
unnamed: Q6.1 (C), R6.2
unnamed: Q6.2 (B), U2.15 (f)
unnamed: Q7.1 (C), R7.2
unnamed: Q7.2 (B), U2.14 (g)
unnamed: Q8.1 (C), R8.2
unnamed: Q8.2 (B), U3.13 (a)
unnamed: Q9.1 (C), R9.2
unnamed: Q9.2 (B), U3.12 (b)
unnamed: Q10.1 (C), R10.2
unnamed: Q10.2 (B), U3.11 (c)
unnamed: Q11.1 (C), R11.2
unnamed: Q11.2 (B), U3.10 (d)
unnamed: Q12.1 (C), R12.2
unnamed: Q12.2 (B), U3.9 (e)
unnamed: Q13.1 (C), R13.2
unnamed: Q13.2 (B), U3.15 (f)
unnamed: Q14.1 (C), R14.2
unnamed: Q14.2 (B), U3.14 (g)
unnamed: Q15.1 (C), R15.2
unnamed: Q15.2 (B), U4.13 (a)
unnamed: Q16.1 (C), R16.2
unnamed: Q16.2 (B), U4.12 (b)
unnamed: Q17.1 (C), R17.2
unnamed: Q17.2 (B), U4.11 (c)
unnamed: Q18.1 (C), R18.2
unnamed: Q18.2 (B), U4.10 (d)
unnamed: Q19.1 (C), R19.2
unnamed: Q19.2 (B), U4.9 (e)
unnamed: Q20.1 (C), R20.2
unnamed: Q20.2 (B), U4.15 (f)
unnamed: Q21.1 (C), R21.2
unnamed: Q21.2 (B), U4.14 (g)
unnamed: Q23.1 (E), Q24.2 (B)
unnamed: Q24.1 (E), R26.2, U6.1
unnamed: R25.1, U6.2, U6.4, U6.5
unnamed: U1.1 (A), U1.2 (B), U5.6
unnamed: U2.4 (BI/~RBO), U3.5 (RBI)
unnamed: U3.4 (BI/~RBO), U4.5 (RBI)
unnamed: U5.1, U5.2, U5.8, U5.12
unnamed: U5.10, U5.11
OF: J2.2, U1.5 (Qc)
OG: J2.3, U1.4 (Qb)
OH: J2.4, U1.3 (Qa)
Pot_b: C3.1, J4.2, J4.3, Q23.2 (B), R29.1
Pot_t: J4.4, R28.1
QD: U1.6 (Qd), U3.1 (B)
QE: U1.10 (Qe), U3.7 (A)
QF: U1.11 (Qf), U4.2 (C)
QG: U1.12 (Qg), U4.1 (B)
QH: U1.13 (Qh), U4.7 (A)
Vss: U1.7 (Vss)
~CLOCK: J3.1, U1.8 (CK)
~DATA: J3.2, U5.4, U5.5
~FLAG: J3.3, U5.3
~RBI: J1.2, U2.5 (RBI)
~RESET_FLAG: J3.4, R23.2, U5.13

Notes on the sheet:
E8/S Octal Display
LSD
MSD

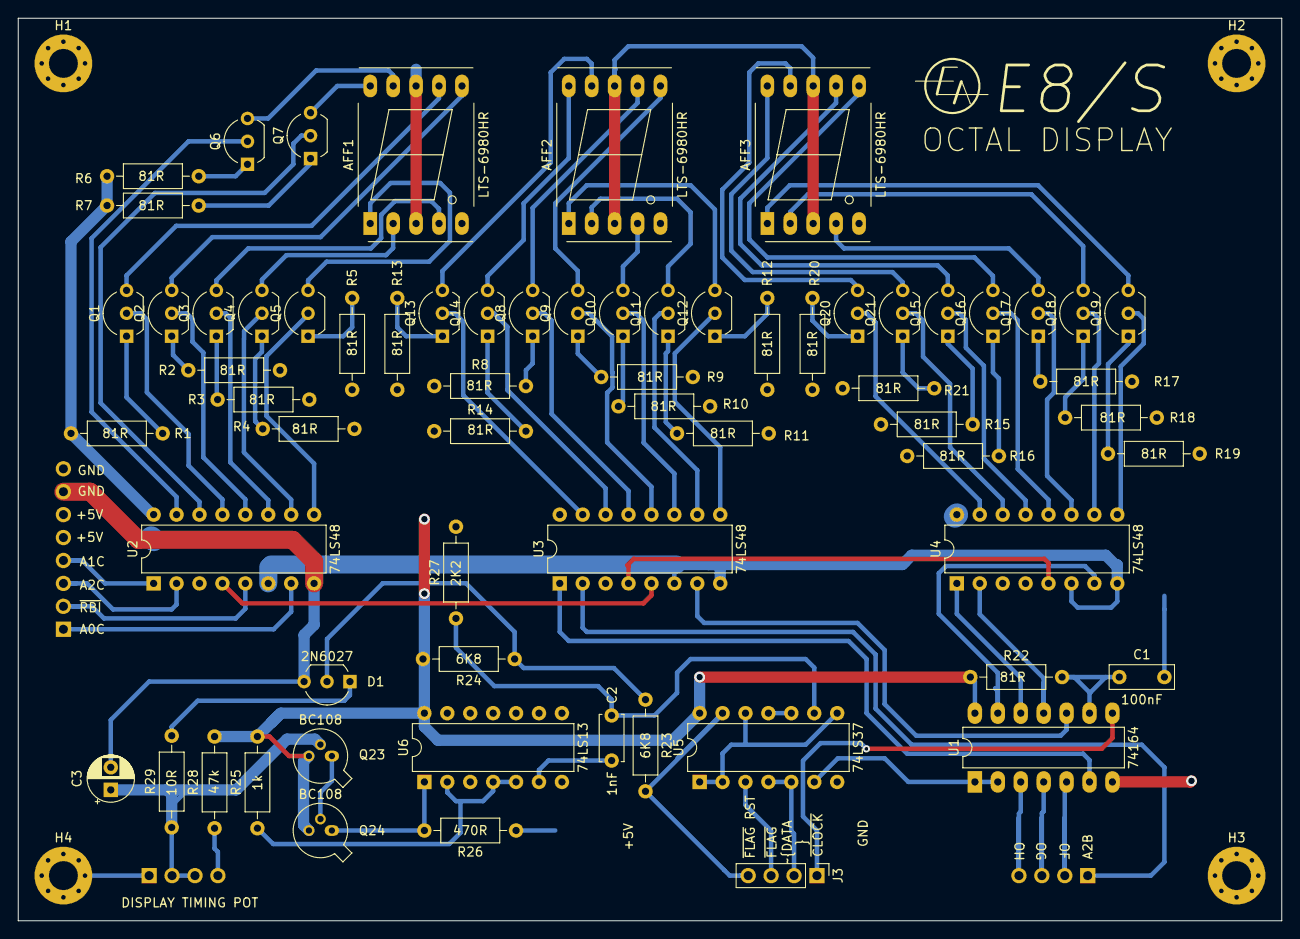
[picture p270: board Octal display.kicad_pcb from above]

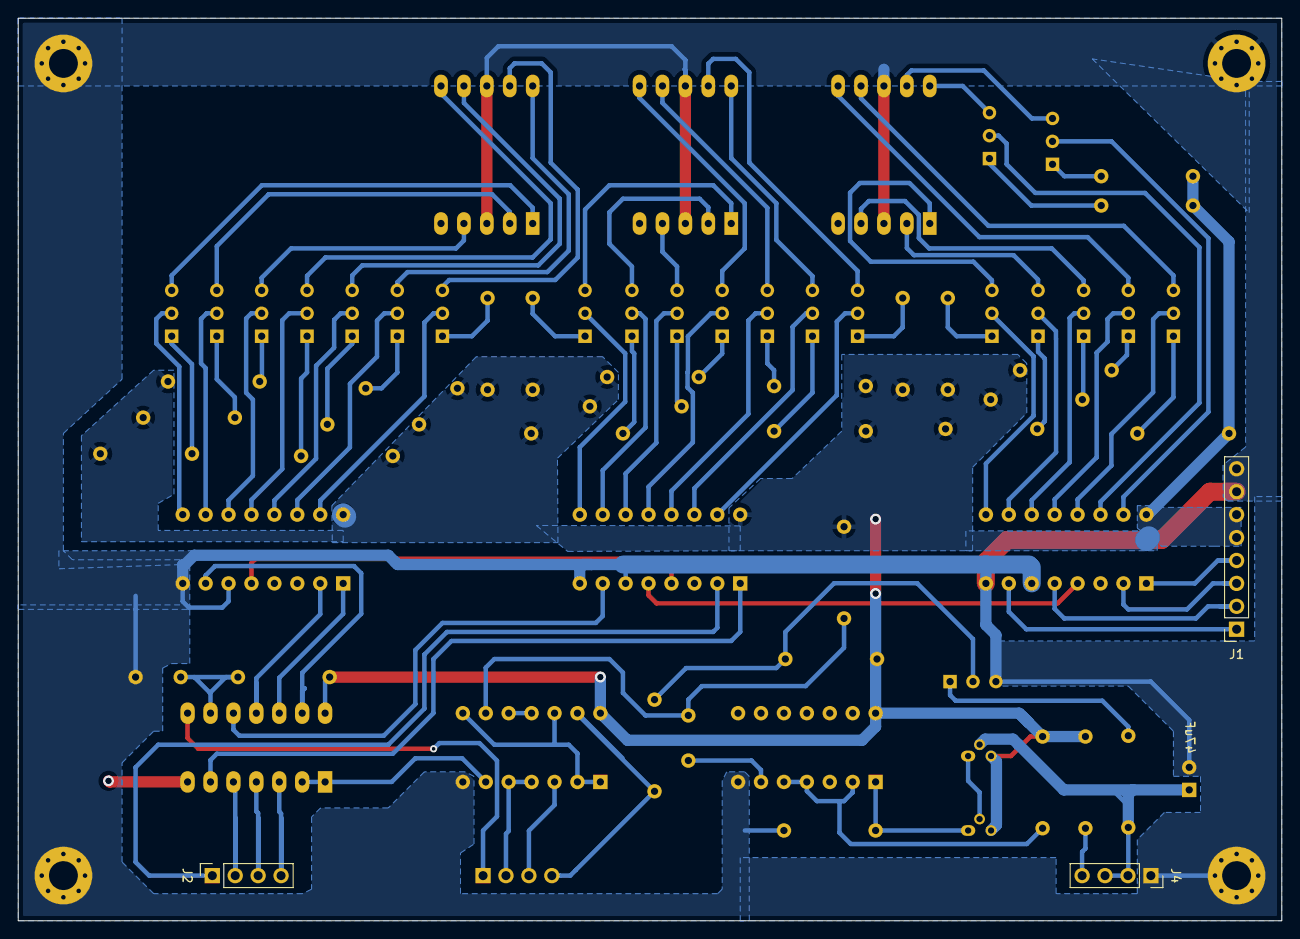
[picture p271: board Octal display.kicad_pcb from below]

Board: 2 copper layers, 140.0 x 100.0 mm, 73 parts (3 on the bottom side), 97 nets.
