ibm2030/EDUC8/octal. keyboard/octal keyboard/Octal Keyboard/octal keyboard.kicad_pcb

## KiCad design octal. keyboard/octal keyboard/Octal Keyboard/octal keyboard.kicad_pcb (2024-06-13)

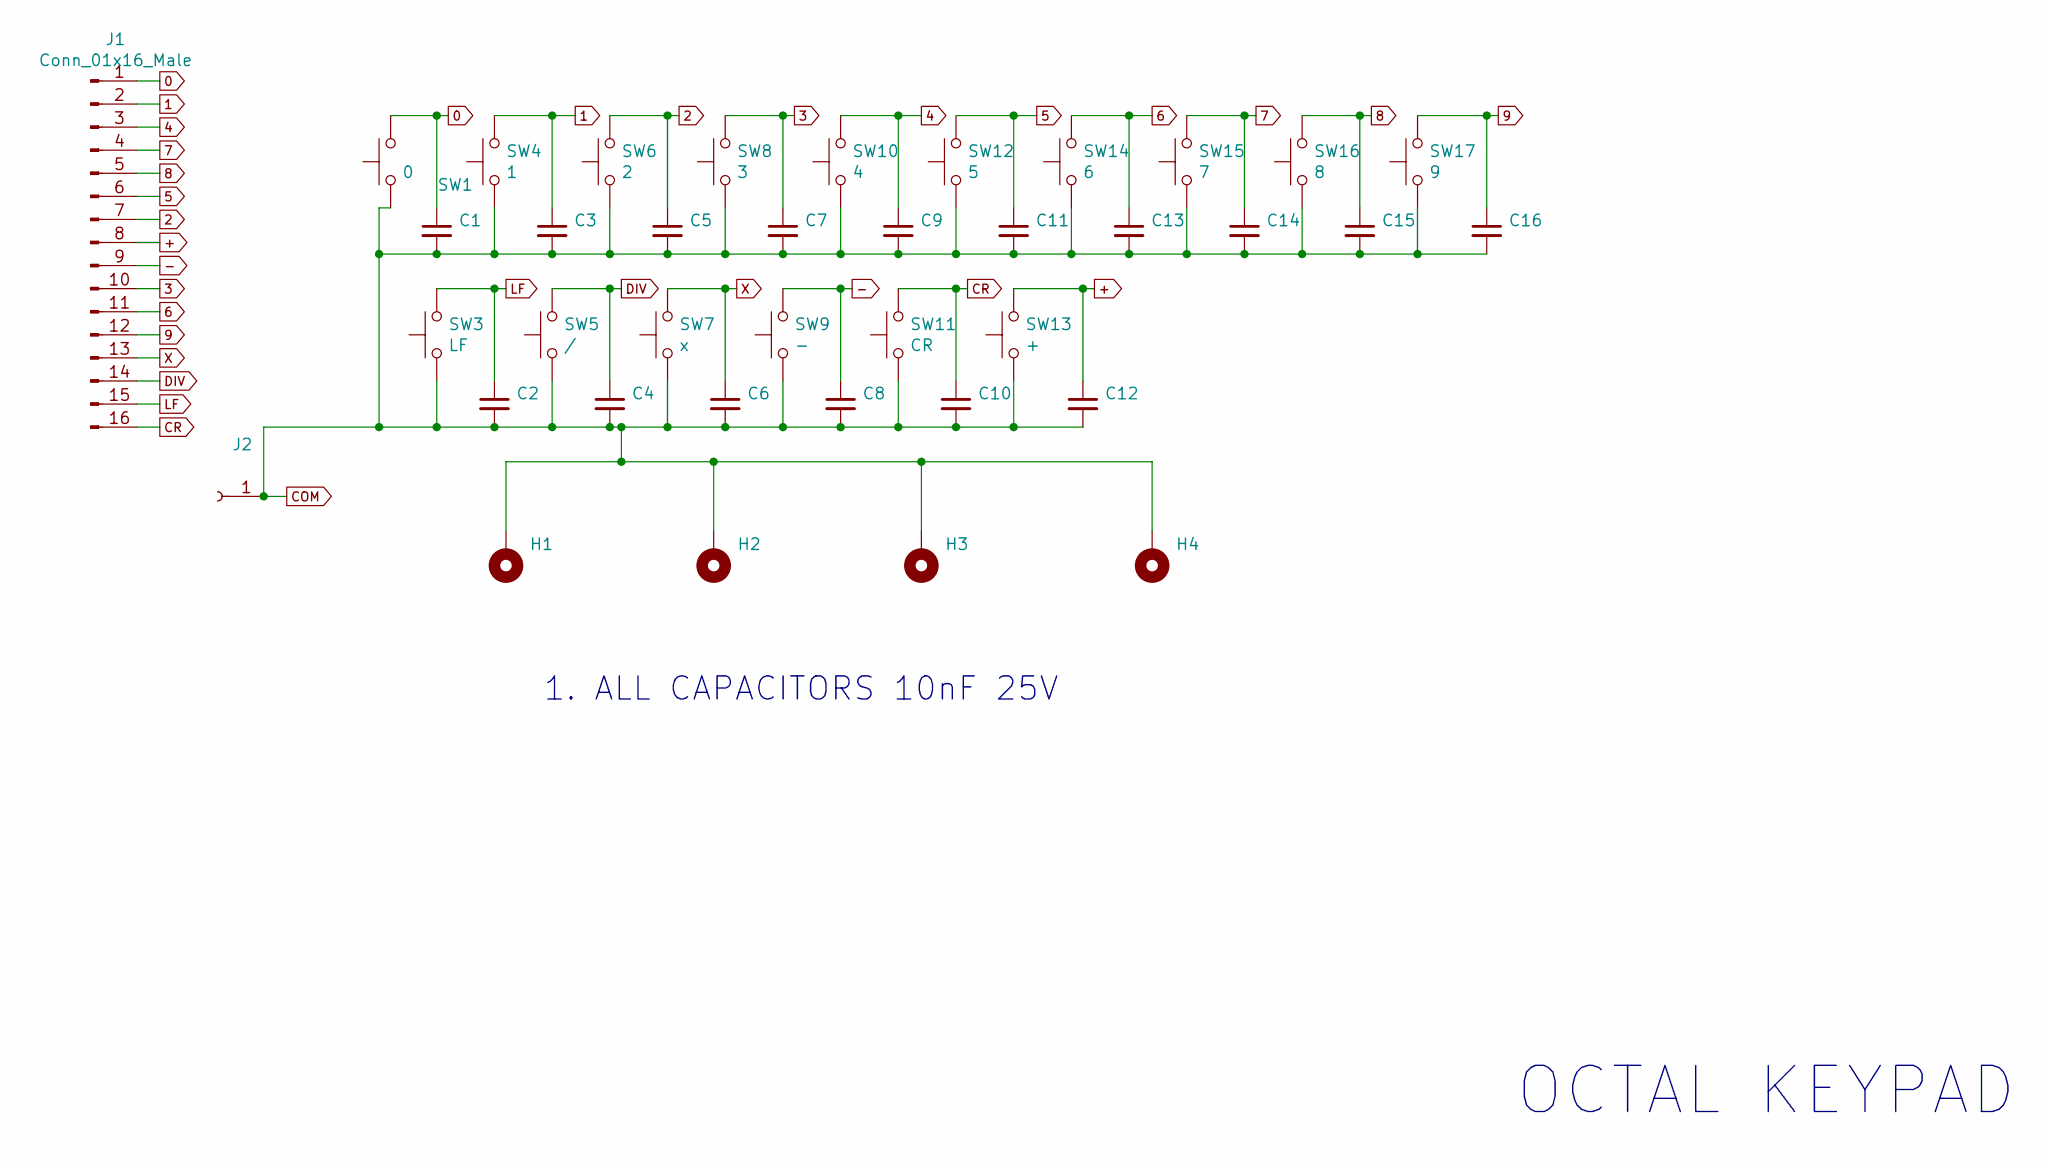
[picture p272: schematic octal keyboard.kicad_sch]

Parts:
C1, C3, C4, C5, C6, C7, C8, C9, C10, C11, C12, C13, C14, C15, C16: C_Small; C_Disc_D7.5mm_W2.5mm_P5.00mm
C2: 10nF; C_Disc_D7.5mm_W2.5mm_P5.00mm
H1, H2, H3, H4: MountingHole_Pad; MountingHole_3.2mm_M3_Pad_Via
J1: Conn_01x16_Male; PinHeader_1x16_P2.54mm_Vertical
J2: Conn_01x01_Female; PinHeader_1x01_P2.54mm_Vertical
SW1: 0; SW_Cherry_MX_1.00u_PCB
SW3: LF; SW_Cherry_MX_1.00u_PCB
SW4: 1; SW_Cherry_MX_1.00u_PCB
SW5: /; SW_Cherry_MX_1.00u_PCB
SW6: 2; SW_Cherry_MX_1.00u_PCB
SW7: x; SW_Cherry_MX_1.00u_PCB
SW8: 3; SW_Cherry_MX_1.00u_PCB
SW9: -; SW_Cherry_MX_1.00u_PCB
SW10: 4; SW_Cherry_MX_1.00u_PCB
SW11: CR; SW_Cherry_MX_1.00u_PCB
SW12: 5; SW_Cherry_MX_1.00u_PCB
SW13: +; SW_Cherry_MX_1.00u_PCB
SW14: 6; SW_Cherry_MX_1.00u_PCB
SW15: 7; SW_Cherry_MX_1.00u_PCB
SW16: 8; SW_Cherry_MX_1.00u_PCB
SW17: 9; SW_Cherry_MX_1.00u_PCB

Connections:
0: C1.1, J1.1, SW1.2
1: C3.1, J1.2, SW4.2
2: C5.1, J1.7, SW6.2
3: C7.1, J1.10, SW8.2
4: C9.1, J1.3, SW10.2
5: C11.1, J1.6, SW12.2
6: C13.1, J1.11, SW14.2
7: C14.1, J1.4, SW15.2
8: C15.1, J1.5, SW16.2
9: C16.1, J1.12, SW17.2
+: C12.1, J1.8, SW13.2
-: C8.1, J1.9, SW9.2
COM: C1.2, C2.2, C3.2, C4.2, C5.2, C6.2, C7.2, C8.2, C9.2, C10.2, C11.2, C12.2, C13.2, C14.2, C15.2, C16.2, H1.1, H2.1, H3.1, H4.1, J2.1, SW1.1, SW3.1, SW4.1, SW5.1, SW6.1, SW7.1, SW8.1, SW9.1, SW10.1, SW11.1, SW12.1, SW13.1, SW14.1, SW15.1, SW16.1, SW17.1
CR: C10.1, J1.16, SW11.2
DIV: C4.1, J1.14, SW5.2
LF: C2.1, J1.15, SW3.2
X: C6.1, J1.13, SW7.2

Notes on the sheet:
OCTAL KEYPAD
1. ALL CAPACITORS 10nF 25V

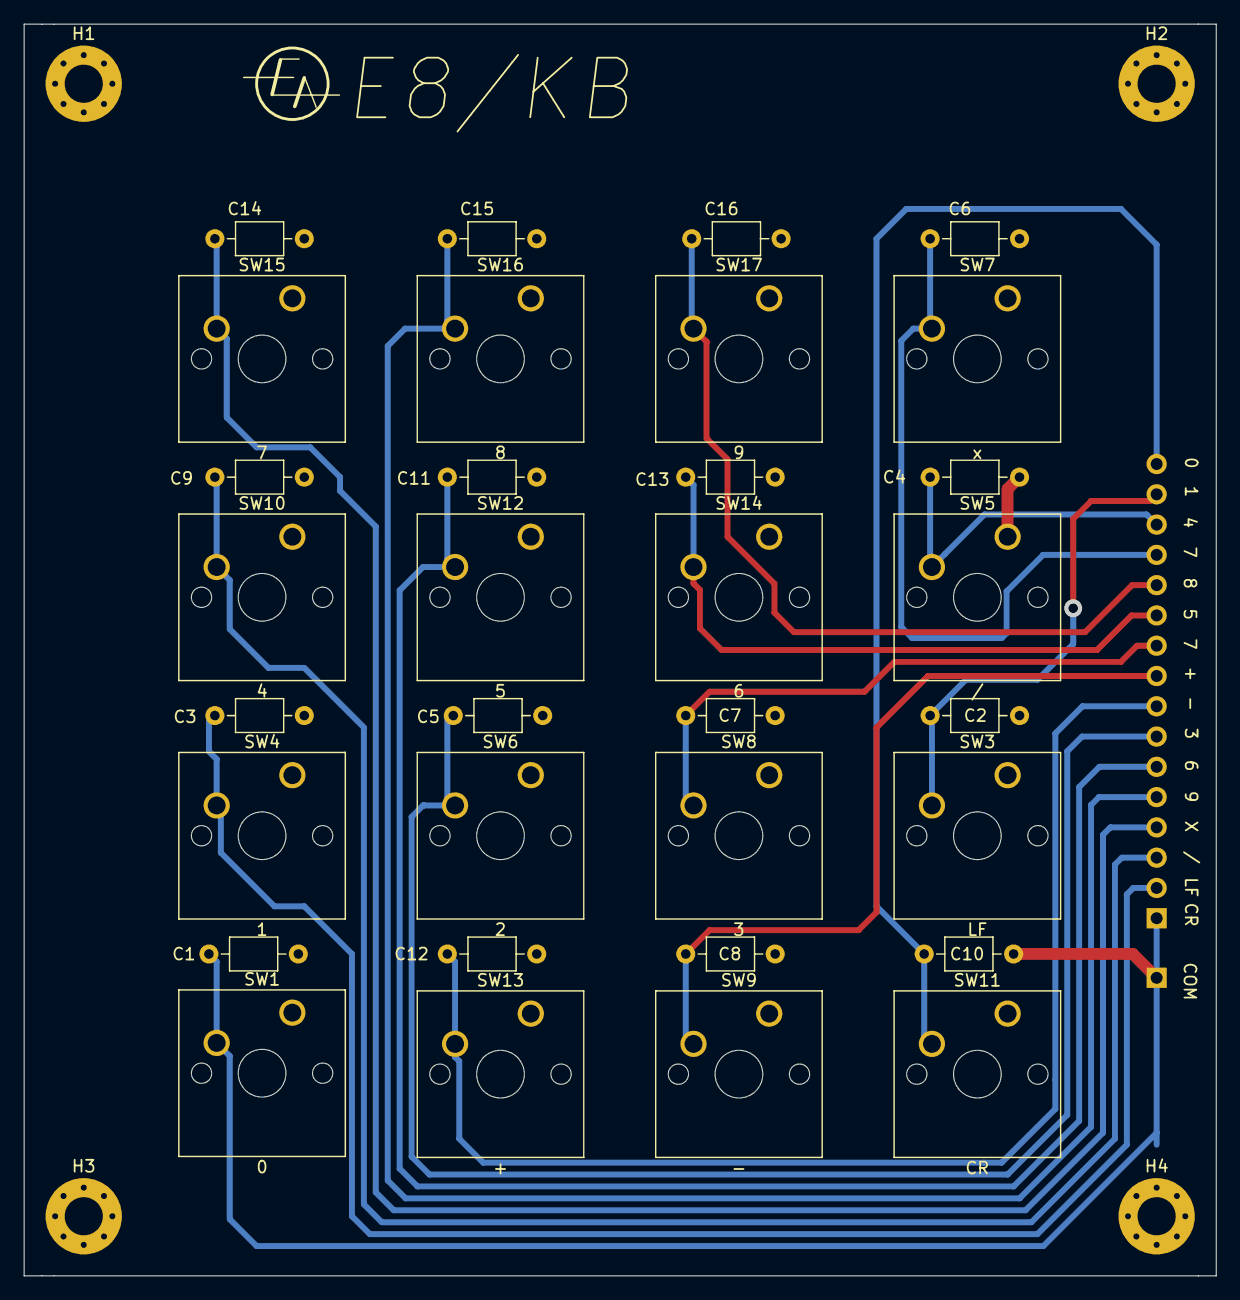
[picture p273: board octal keyboard.kicad_pcb from above]

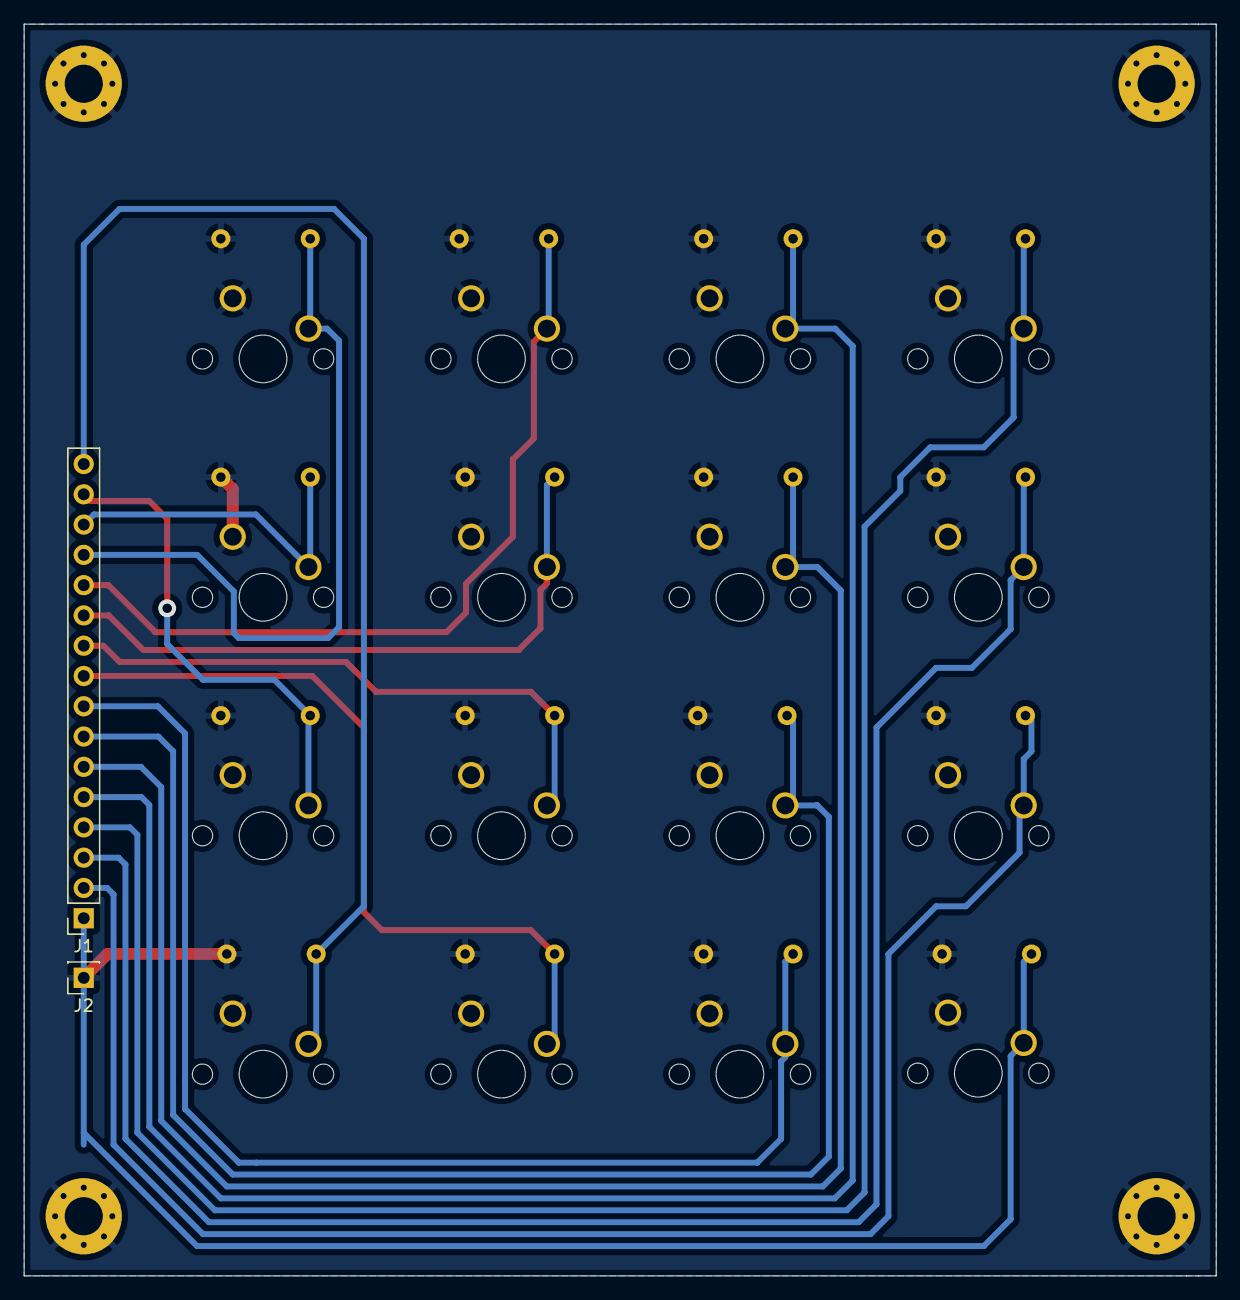
[picture p274: board octal keyboard.kicad_pcb from below]

Board: 2 copper layers, 100.0 x 105.0 mm, 38 parts (2 on the bottom side), 17 nets.
