ibm2030/EDUC8/Octal display/Pot and switch board/support PCB/support PCB.kicad_pcb

## KiCad design Octal display/Pot and switch board/support PCB/support PCB.kicad_pcb (2024-06-13)

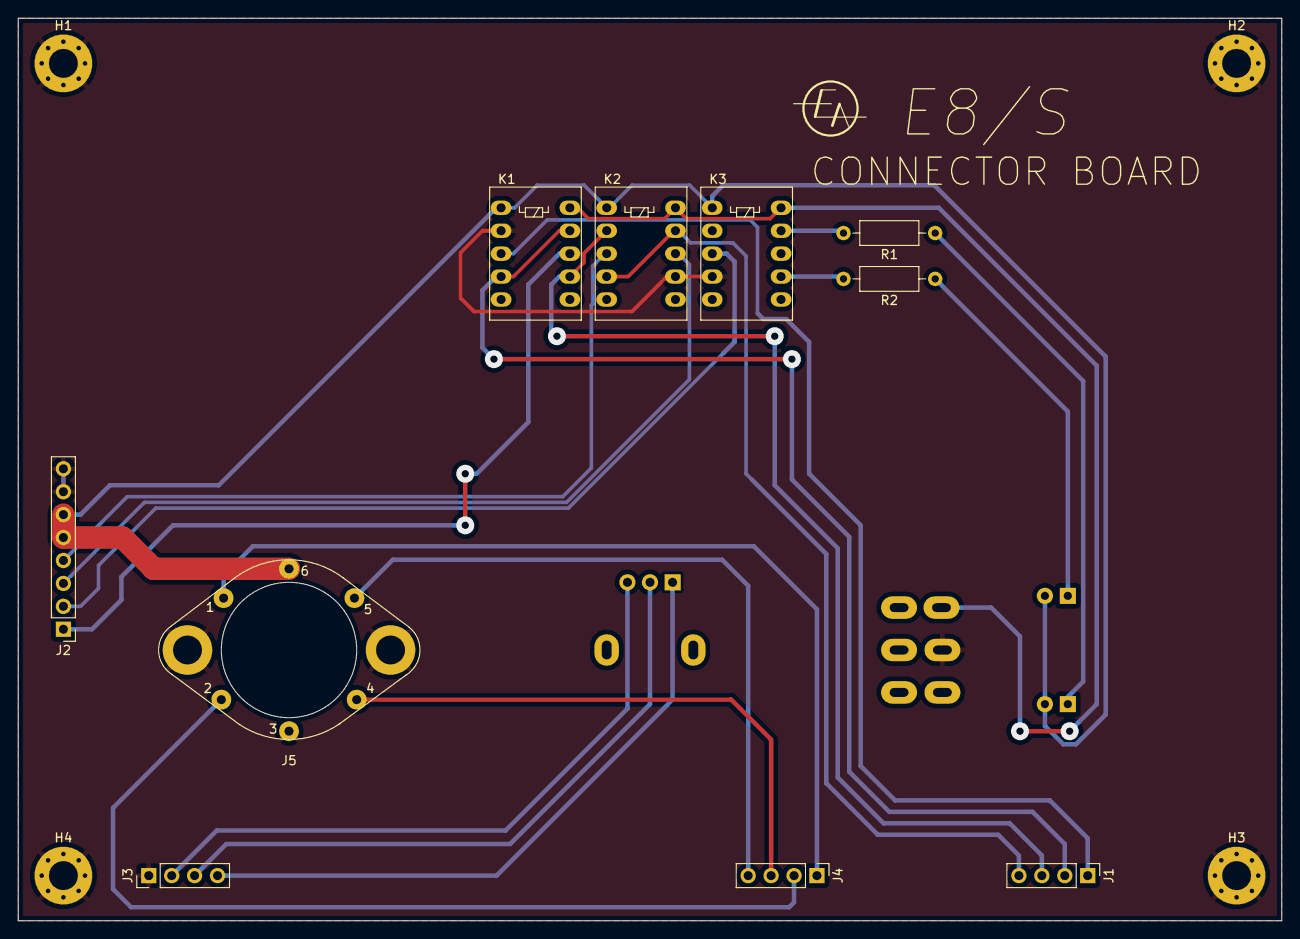
[picture p275: board support PCB.kicad_pcb from above]

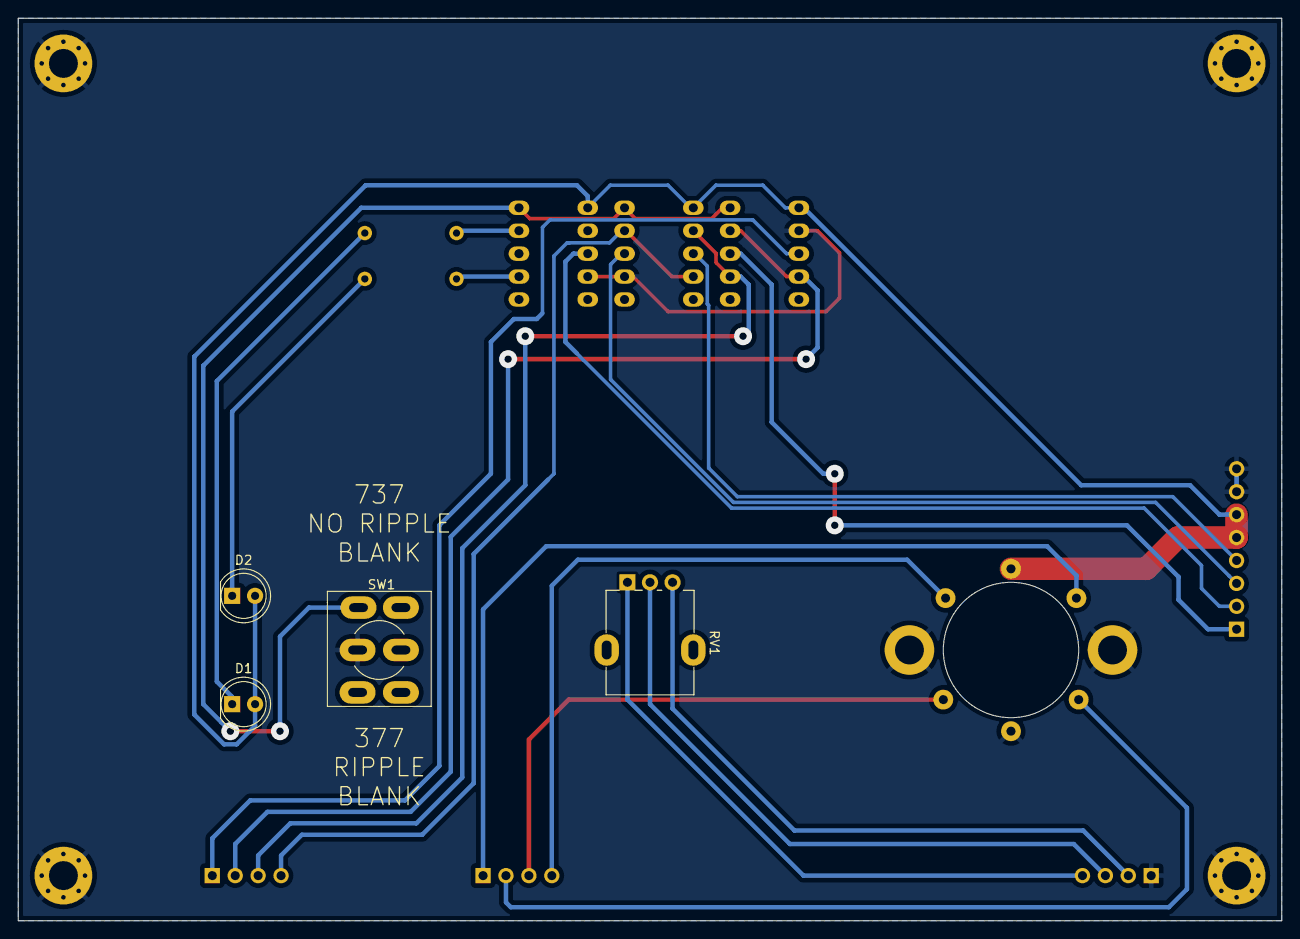
[picture p276: board support PCB.kicad_pcb from below]

Board: 2 copper layers, 140.0 x 100.0 mm, 18 parts (4 on the bottom side), 22 nets.

Parts:
D1: 377; LED_D5.0mm
D2: 737; LED_D5.0mm
H1, H2, H3, H4: MountingHole_Pad; MountingHole_3.2mm_M3_Pad_Via
J1, J3, J4: Conn_01x04_Male; PinHeader_1x04_P2.54mm_Vertical
J2: Conn_01x08_Male; PinHeader_1x08_P2.54mm_Vertical
J5: DIN-6_SH; 6_PIN_DIN_SOCKET
K1, K2, K3: FRT5; Relay_DPDT_FRT5
R1, R2: R; R_Axial_DIN0207_L6.3mm_D2.5mm_P10.16mm_Horizontal
RV1: R_POT; Potentiometer_Alpha_RD901F-40-00D_Single_Vertical
SW1: SW_DPDT_x2; DPDT_toggle_switch_wired

Connections:
+5V: D1.2, D2.2, J2.5, J2.6, J5.6, K1.1, K2.1, K3.1
A0C: J2.1, K1.8
A1C: J2.4, K2.3
A2B: J1.1, K1.3
A2C: J2.3, K2.8
GND: H1.1, H2.1, H3.1, H4.1, J2.7, J2.8, J3.1, J5.0, J5.3, K1.2, K2.7, K3.4, SW1.2
unnamed: D1.1, R1.1
unnamed: D2.1, R2.1
unnamed: J3.2, RV1.3
unnamed: J3.3, RV1.2
unnamed: J3.4, RV1.1
unnamed: K1.10, K2.10, K3.8, K3.10, SW1.3
unnamed: K3.7, R2.2
unnamed: K3.9, R1.2
OF: J1.2, K1.4, K1.9
OG: J1.3, K1.7, K2.2
OH: J1.4, K2.4, K2.9
~CLOCK: J4.1, J5.1
~DATA: J4.2, J5.2
~FLAG_RESET: J4.4, J5.5
~FLAG: J4.3, J5.4
~RBI: J2.2, K3.3
