ibm2030/EDUC8/octal. keyboard/octal keyboard/octal keyboard interface/Keyboard interface.kicad_pcb

## KiCad design octal. keyboard/octal keyboard/octal keyboard interface/Keyboard interface.kicad_pcb (2024-06-13)

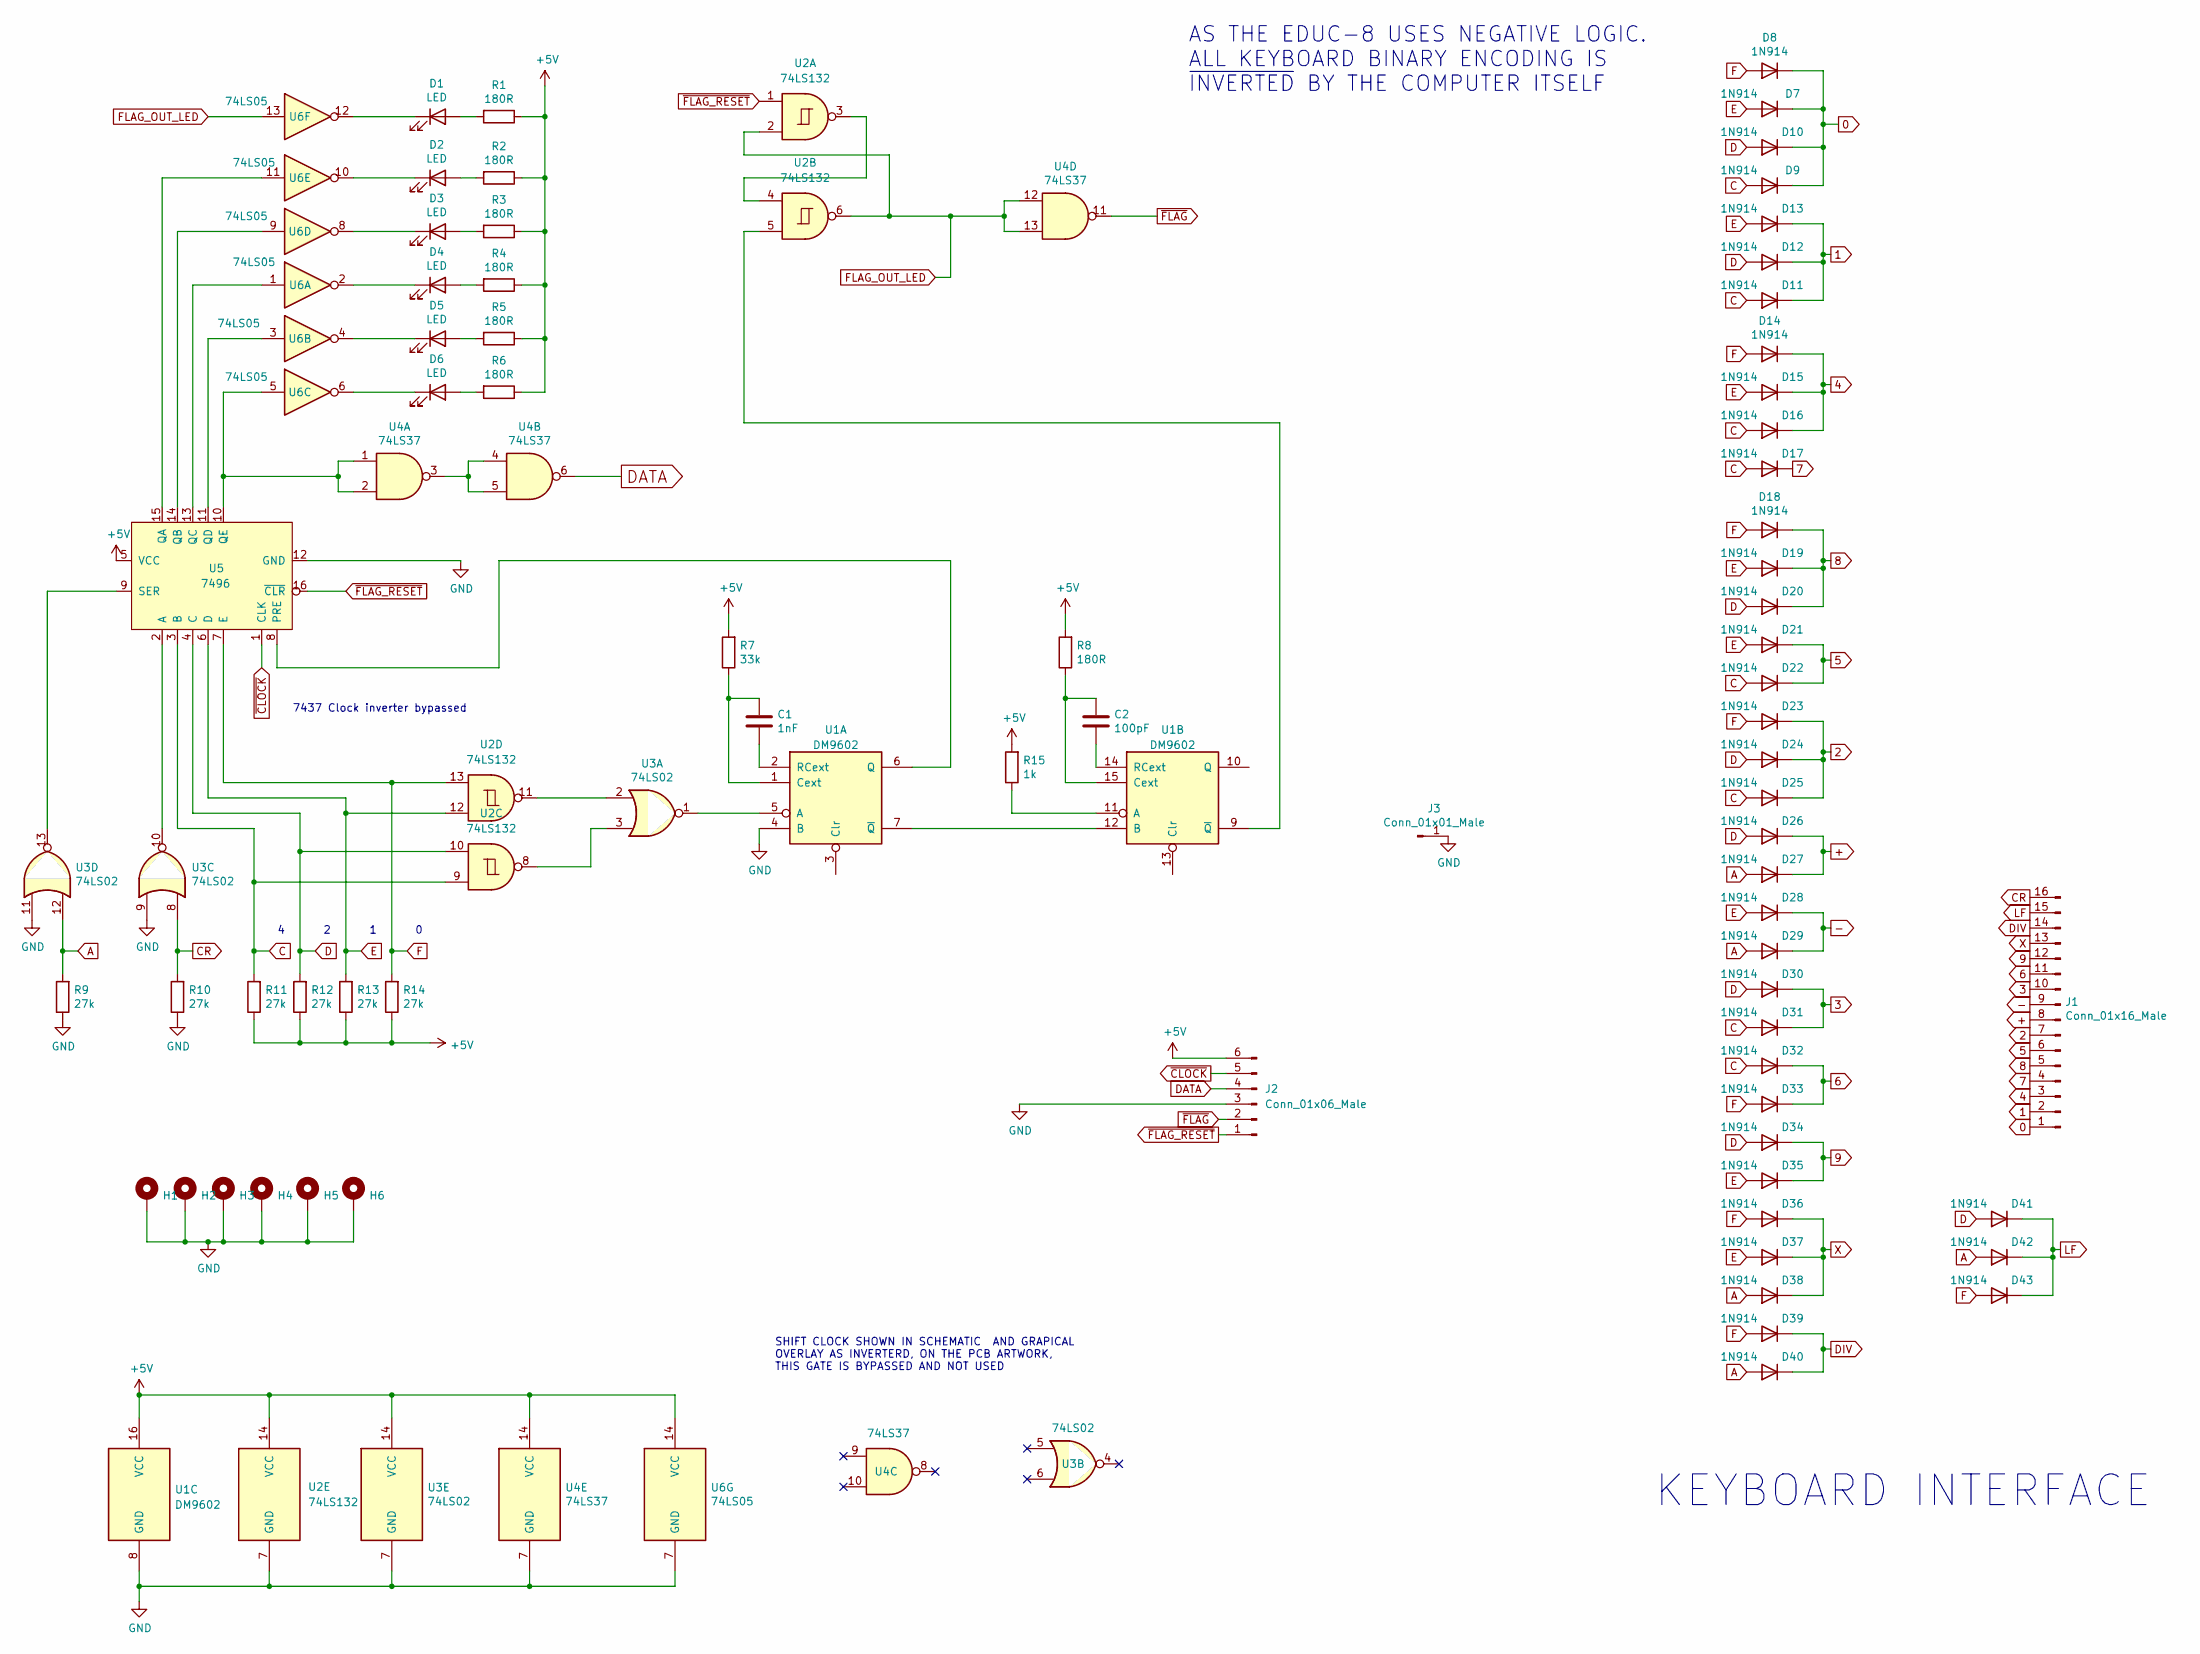
[picture p277: schematic Keyboard interface.kicad_sch]

Parts:
C1: 1nF; C_Disc_D5.0mm_W2.5mm_P5.00mm
C2: 100pF; C_Disc_D5.0mm_W2.5mm_P5.00mm
D1, D2, D3, D4, D5, D6: LED; LED_D5.0mm
D7, D13, D15, D19, D21, D28, D35, D37: 1N914; D_DO-35_SOD27_P7.62mm_Horizontal
D8, D14, D18, D23, D33, D36, D39, D43: 1N914; D_DO-35_SOD27_P5.08mm_Vertical_KathodeUp
D9, D11, D16, D17, D22, D25, D27, D29, D31, D32, D38, D40, D42: 1N914; D_DO-35_SOD27_P12.70mm_Horizontal
D10, D12, D20, D24, D26, D30, D34, D41: 1N914; D_DO-35_SOD27_P10.16mm_Horizontal
H1, H2, H3, H4, H5, H6: MountingHole_Pad; MountingHole_3.2mm_M3_Pad_Via
J1: Conn_01x16_Male; PinHeader_1x16_P2.54mm_Vertical
J2: Conn_01x06_Male; JST_XH_B6B-XH-A_1x06_P2.50mm_Vertical
J3: Conn_01x01_Male; PinHeader_1x01_P2.54mm_Vertical
R1, R2, R3, R4, R5, R6, R8: 180R; R_Axial_DIN0207_L6.3mm_D2.5mm_P10.16mm_Horizontal
R7: 33k; R_Axial_DIN0207_L6.3mm_D2.5mm_P10.16mm_Horizontal
R9, R10, R11, R12, R13, R14: 27k; R_Axial_DIN0207_L6.3mm_D2.5mm_P10.16mm_Horizontal
R15: 1k; R_Axial_DIN0207_L6.3mm_D2.5mm_P10.16mm_Horizontal
U1: DM9602; DIP-16_W7.62mm_Socket_LongPads
U2: 74LS132; DIP-14_W7.62mm_LongPads
U3: 74LS02; DIP-14_W7.62mm_LongPads
U4: 74LS37; DIP-14_W7.62mm_LongPads
U5: 7496; DIP-16_W7.62mm_LongPads
U6: 74LS05; DIP-14_W7.62mm_LongPads

Connections:
0: D7.1 (K), D8.1 (K), D9.1 (K), D10.1 (K), J1.1
1: D11.1 (K), D12.1 (K), D13.1 (K), J1.2
2: D23.1 (K), D24.1 (K), D25.1 (K), J1.7
3: D30.1 (K), D31.1 (K), J1.10
4: D14.1 (K), D15.1 (K), D16.1 (K), J1.3
5: D21.1 (K), D22.1 (K), J1.6
6: D32.1 (K), D33.1 (K), J1.11
7: D17.1 (K), J1.4
8: D18.1 (K), D19.1 (K), D20.1 (K), J1.5
9: D34.1 (K), D35.1 (K), J1.12
+: D26.1 (K), D27.1 (K), J1.8
+5V: J2.6, R1.1, R2.1, R3.1, R4.1, R5.1, R6.1, R7.2, R8.2, R11.1, R12.1, R13.1, R14.1, R15.2, U1.16 (VCC), U2.14 (VCC), U3.14 (VCC), U4.14 (VCC), U5.5 (VCC), U6.14 (VCC)
-: D28.1 (K), D29.1 (K), J1.9
A: D27.2 (A), D29.2 (A), D38.2 (A), D40.2 (A), D42.2 (A), R9.2, U3.12
C: D9.2 (A), D11.2 (A), D16.2 (A), D17.2 (A), D22.2 (A), D25.2 (A), D31.2 (A), D32.2 (A), R11.2, U2.9, U5.3 (B)
CR: J1.16, R10.2, U3.8
D: D10.2 (A), D12.2 (A), D20.2 (A), D24.2 (A), D26.2 (A), D30.2 (A), D34.2 (A), D41.2 (A), R12.2, U2.10, U5.4 (C)
DATA: J2.4, U4.6
DIV: D39.1 (K), D40.1 (K), J1.14
E: D7.2 (A), D13.2 (A), D15.2 (A), D19.2 (A), D21.2 (A), D28.2 (A), D35.2 (A), D37.2 (A), R13.2, U2.12, U5.6 (D)
F: D8.2 (A), D14.2 (A), D18.2 (A), D23.2 (A), D33.2 (A), D36.2 (A), D39.2 (A), D43.2 (A), R14.2, U2.13, U5.7 (E)
FLAG_OUT_LED: U2.2, U2.6, U4.12, U4.13, U6.13
GND: H1.1, H2.1, H3.1, H4.1, H5.1, H6.1, J2.3, J3.1, R9.1, R10.1, U1.4 (B), U1.8 (GND), U2.7 (GND), U3.7 (GND), U3.9, U3.11, U4.7 (GND), U5.12 (GND), U6.7 (GND)
LF: D41.1 (K), D42.1 (K), D43.1 (K), J1.15
unnamed: C1.1, R7.1, U1.1 (Cext)
unnamed: C1.2, U1.2 (RCext)
unnamed: C2.1, R8.1, U1.15 (Cext)
unnamed: C2.2, U1.14 (RCext)
unnamed: D1.1 (K), U6.12
unnamed: D1.2 (A), R1.2
unnamed: D2.1 (K), U6.10
unnamed: D2.2 (A), R2.2
unnamed: D3.1 (K), U6.8
unnamed: D3.2 (A), R3.2
unnamed: D4.1 (K), U6.2
unnamed: D4.2 (A), R4.2
unnamed: D5.1 (K), U6.4
unnamed: D5.2 (A), R5.2
unnamed: D6.1 (K), U6.6
unnamed: D6.2 (A), R6.2
unnamed: R15.1, U1.11 (A)
unnamed: U1.5 (A), U3.1
unnamed: U1.6 (Q), U5.8 (PRE)
unnamed: U1.9 (~Q), U2.5
unnamed: U1.7 (~Q), U1.12 (B)
unnamed: U2.3, U2.4
unnamed: U2.8, U3.3
unnamed: U2.11, U3.2
unnamed: U3.10, U5.2 (A)
unnamed: U3.13, U5.9 (SER)
unnamed: U4.1, U4.2, U5.10 (QE), U6.5
unnamed: U4.3, U4.4, U4.5
unnamed: U5.11 (QD), U6.3
unnamed: U5.13 (QC), U6.1
unnamed: U5.14 (QB), U6.9
unnamed: U5.15 (QA), U6.11
X: D36.1 (K), D37.1 (K), D38.1 (K), J1.13
~CLOCK: J2.5, U5.1 (CLK)
~FLAG_RESET: J2.1, U2.1, U5.16 (~CLR)
~FLAG: J2.2, U4.11

Notes on the sheet:
7437 Clock inverter bypassed
KEYBOARD INTERFACE
SHIFT CLOCK SHOWN IN SCHEMATIC AND GRAPICAL OVERLAY AS INVERTERD, ON THE PCB ARTWORK, THIS GATE IS BYPASSED AND NOT USED
AS THE EDUC-8 USES NEGATIVE LOGIC. ALL KEYBOARD BINARY ENCODING IS ~{INVERTED} BY THE COMPUTER ITSELF

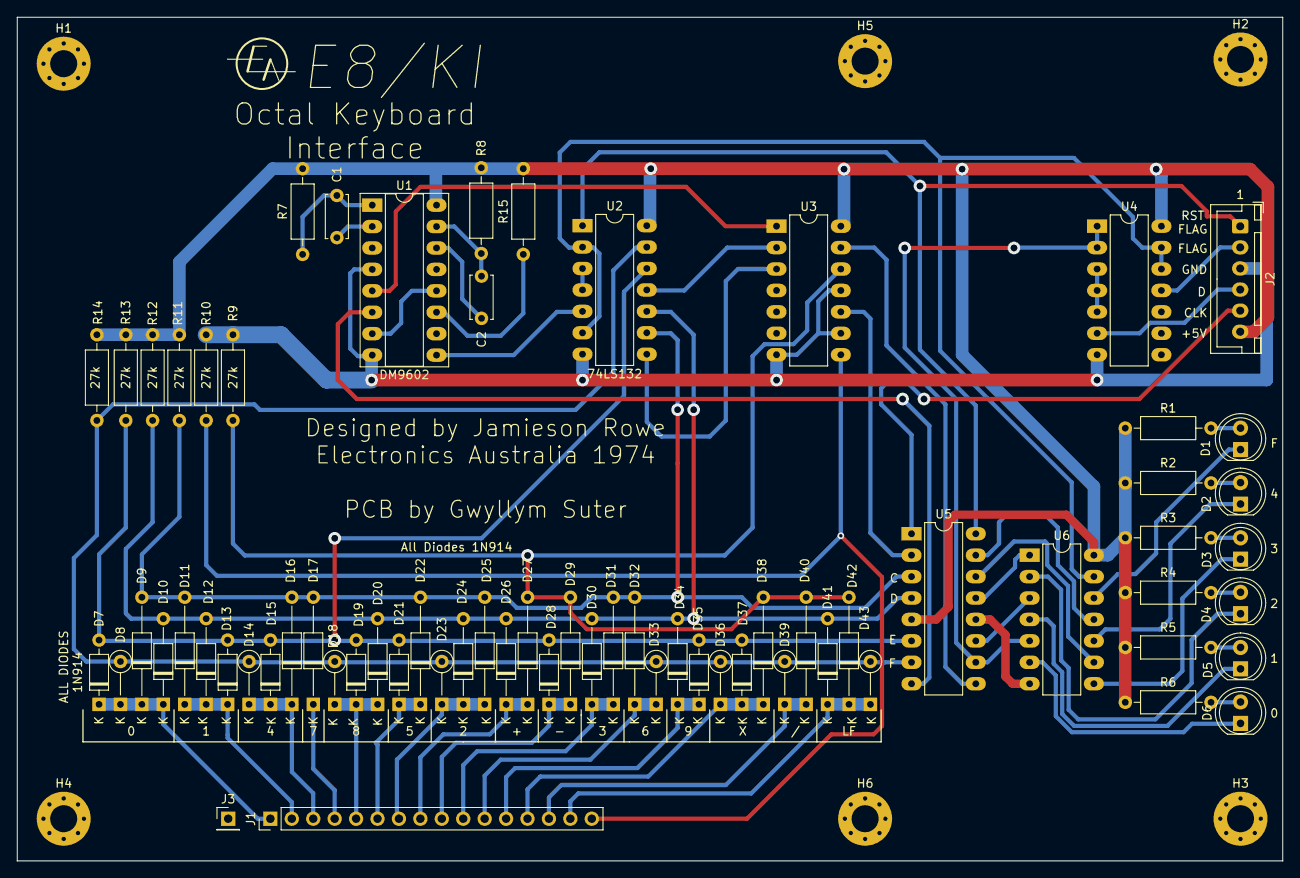
[picture p278: board Keyboard interface.kicad_pcb from above]

Board: 2 copper layers, 150.0 x 100.0 mm, 75 parts (0 on the bottom side), 60 nets.
