ibm2030/EDUC8/Serial interface/E8Serial/WIFI-MODEM/RS232.kicad_pcb

## KiCad design Serial interface/E8Serial/WIFI-MODEM/RS232.kicad_pcb (2023-03-05)

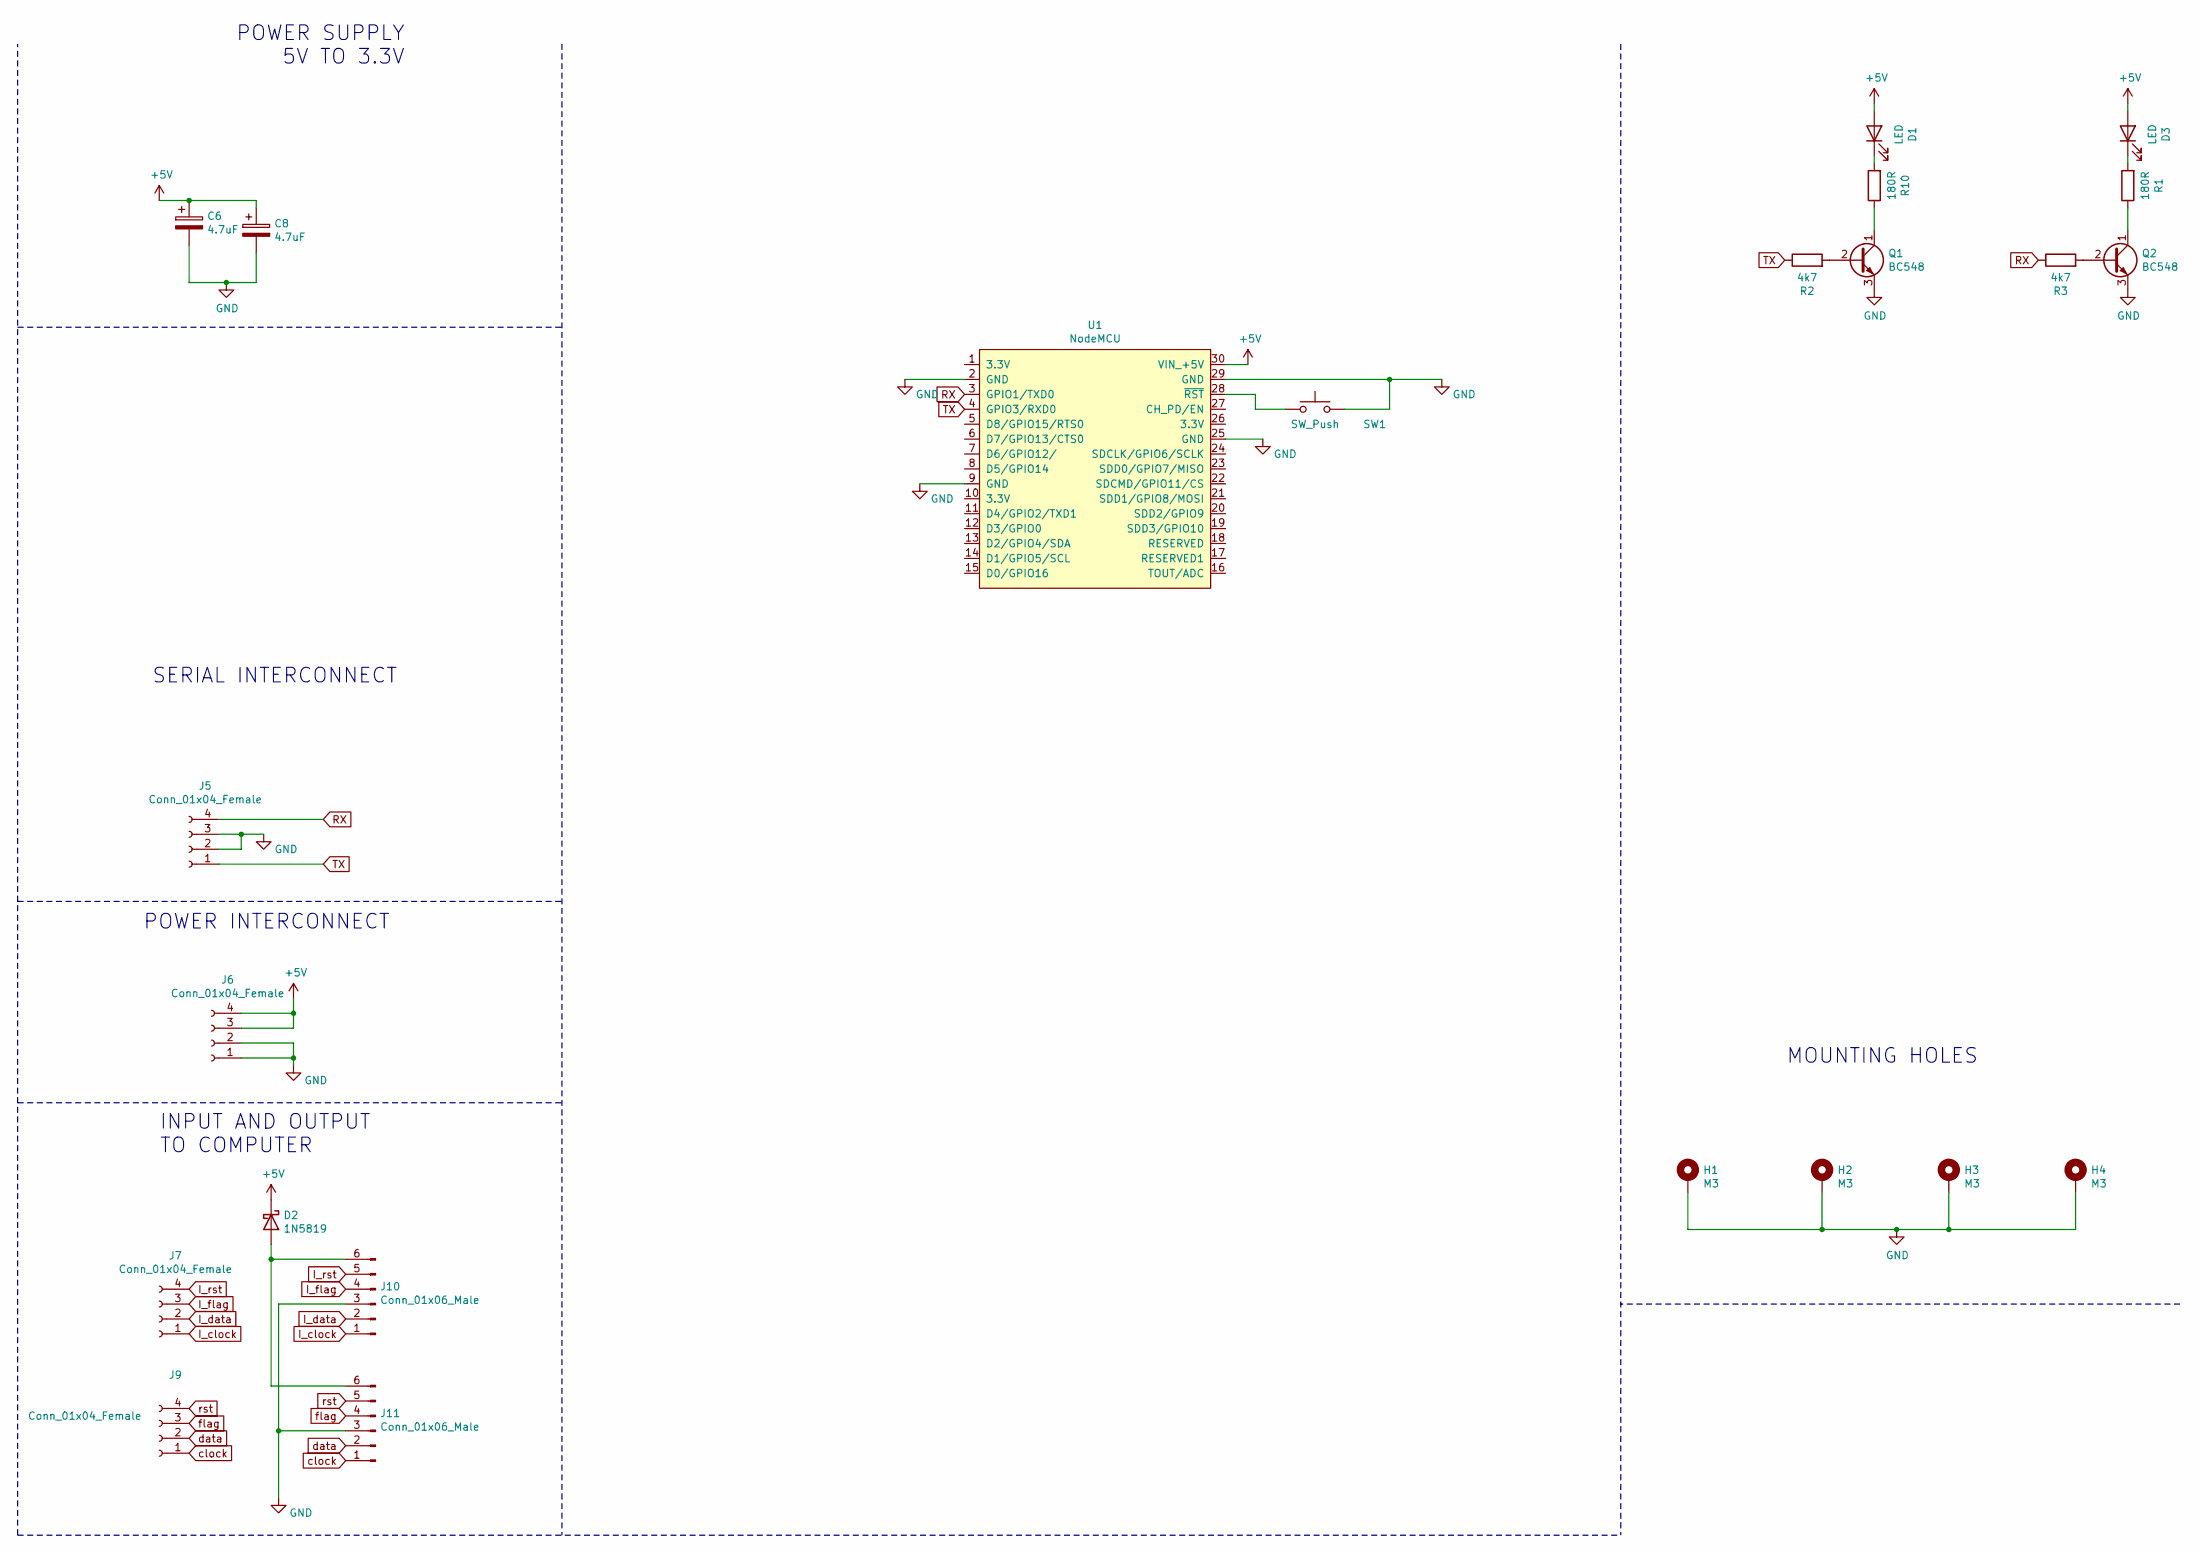
[picture p279: schematic RS232.sch, ASCII VIDEO TERMINAL]

Parts:
C6, C8: 4.7uF; CP_Axial_L11.0mm_D6.0mm_P18.00mm_Horizontal
D1, D3: LED; LED_D5.0mm_Horizontal_O1.27mm_Z3.0mm
D2: 1N5819; D_DO-41_SOD81_P10.16mm_Horizontal
H1, H2, H3, H4: M3; MountingHole_3.2mm_M3_Pad_Via
J5, J6, J7, J9: Conn_01x04_Female; PinSocket_1x04_P2.54mm_Vertical
J10, J11: Conn_01x06_Male; Molex_KK-254_AE-6410-06A_1x06_P2.54mm_Vertical
Q1, Q2: BC548; TO-92_Inline_Wide
R1, R10: 180R; R_Axial_DIN0207_L6.3mm_D2.5mm_P10.16mm_Horizontal
R2, R3: 4k7; R_Axial_DIN0207_L6.3mm_D2.5mm_P10.16mm_Horizontal
SW1: SW_Push; Push_E-Switch_KS01Q01
U1: NodeMCU

Connections:
+5V: C6.1, C8.1, D1.2 (A), D2.1 (K), D3.2 (A), J6.3, J6.4, U1.30 (VIN_+5V)
GND: C6.2, C8.2, H1.1, H2.1, H3.1, H4.1, J5.2, J5.3, J6.1, J6.2, J10.3, J11.3, Q1.3 (E), Q2.3 (E), SW1.2, U1.2 (GND), U1.9 (GND), U1.25 (GND), U1.29 (GND)
I_clock: J7.1, J10.1
I_data: J7.2, J10.2
I_flag: J7.3, J10.4
I_rst: J7.4, J10.5
unnamed: D1.1 (K), R10.2
unnamed: D2.2 (A), J10.6, J11.6
unnamed: D3.1 (K), R1.2
unnamed: Q1.1 (C), R10.1
unnamed: Q1.2 (B), R2.2
unnamed: Q2.1 (C), R1.1
unnamed: Q2.2 (B), R3.2
unnamed: SW1.1, U1.28 (~RST)
RX: J5.4, R3.1, U1.3 (GPIO1/TXD0)
TX: J5.1, R2.1, U1.4 (GPIO3/RXD0)
clock: J9.1, J11.1
data: J9.2, J11.2
flag: J9.3, J11.4
rst: J9.4, J11.5

Notes on the sheet:
SERIAL INTERCONNECT
POWER INTERCONNECT
INPUT AND OUTPUT TO COMPUTER
POWER SUPPLY 5V TO 3.3V
MOUNTING HOLES
