ibm2030/EDUC8/Serial interface/E8Serial/WIFI-MODEM/RS232.kicad_pcb

## KiCad design Serial interface/E8Serial/WIFI-MODEM/RS232.kicad_pcb (continued)

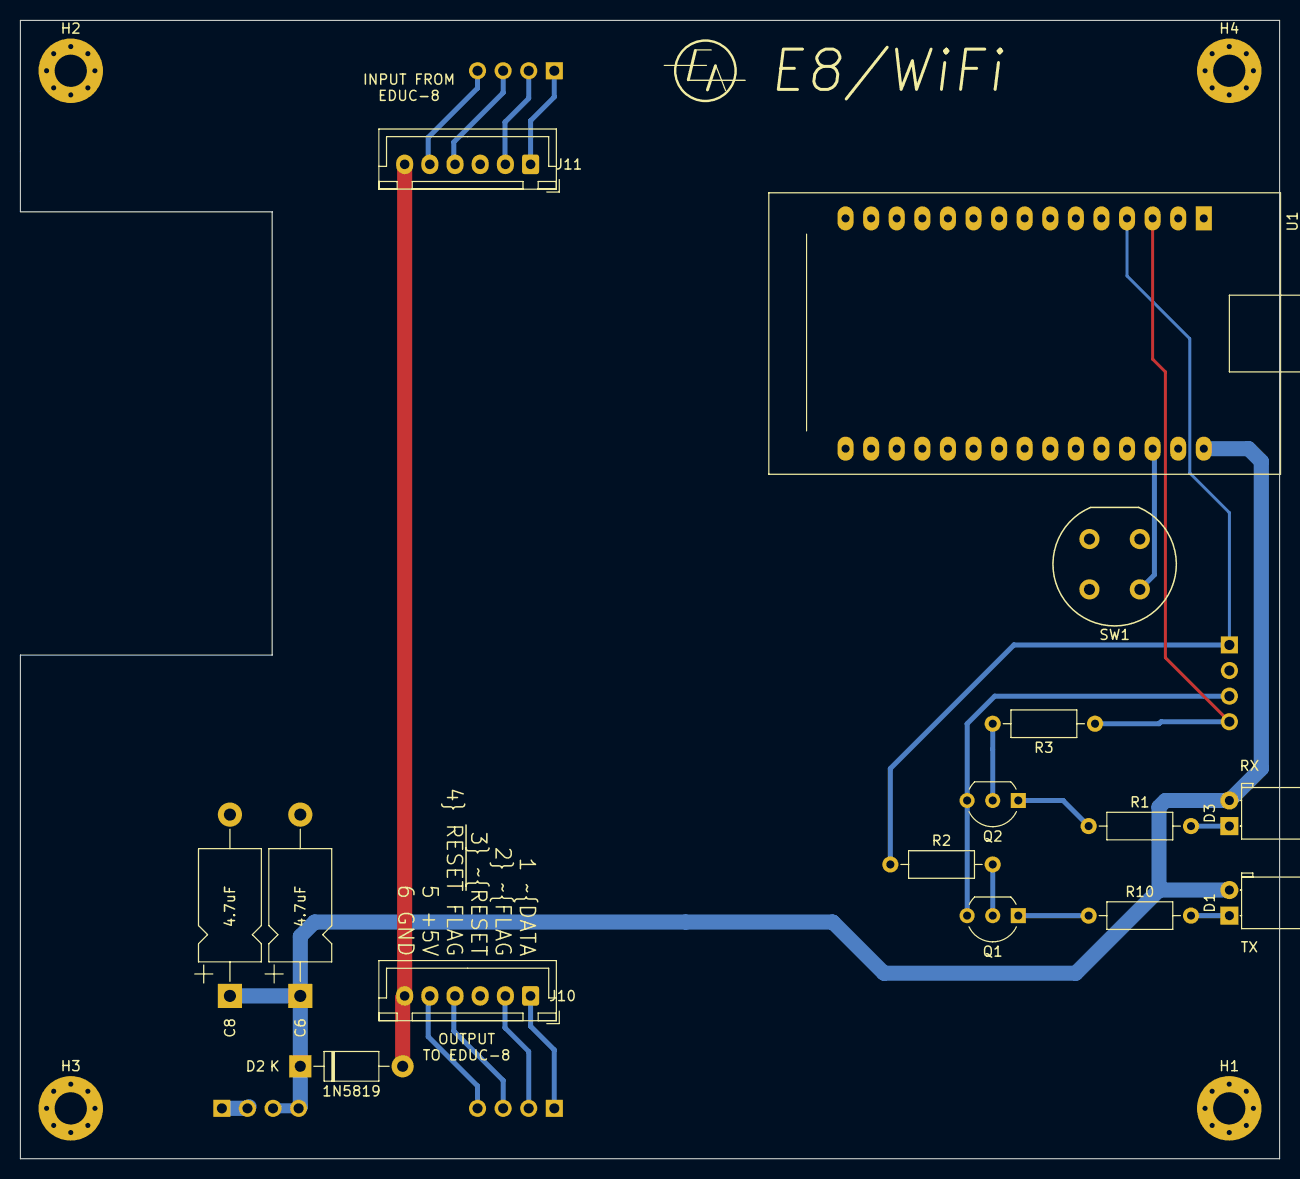
[picture p280: board Serial interface/E8Serial/WIFI-MODEM/RS232.kicad_pcb from above]

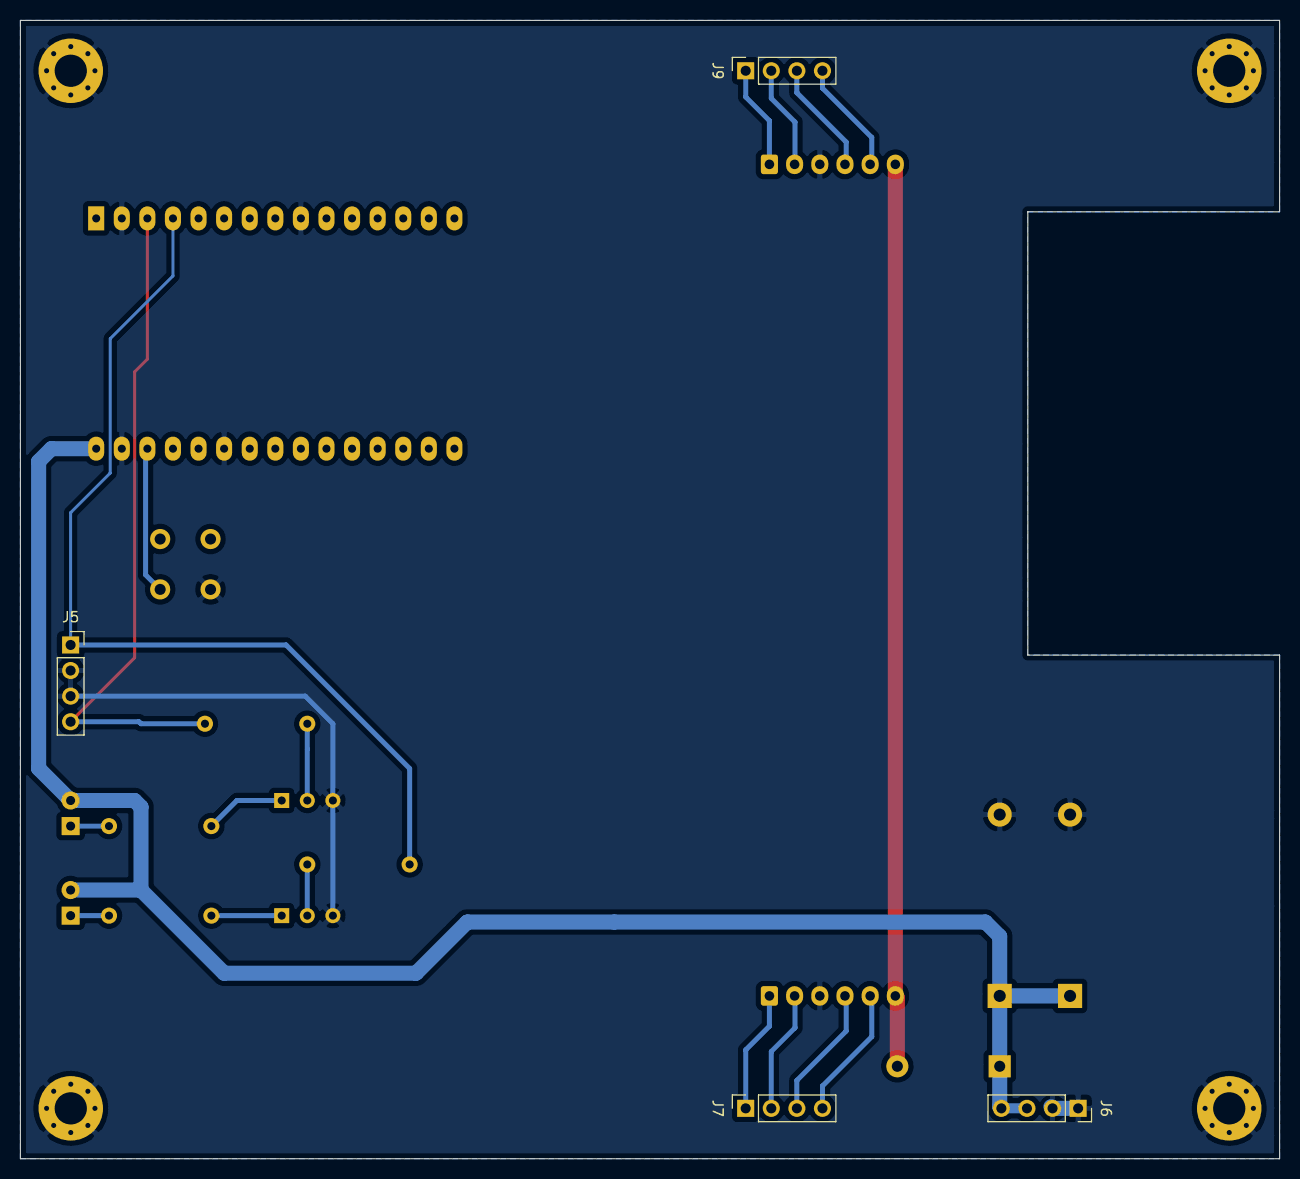
[picture p281: board Serial interface/E8Serial/WIFI-MODEM/RS232.kicad_pcb from below]

Board: 2 copper layers, 125.0 x 113.0 mm, 23 parts (4 on the bottom side), 20 nets.
