ibm2030/EDUC8/octal. keyboard/octal keyboard/octal keyboard interface/octal keyboard interface.kicad_pcb

## KiCad design octal. keyboard/octal keyboard/octal keyboard interface/octal keyboard interface.kicad_pcb (2023-03-05)

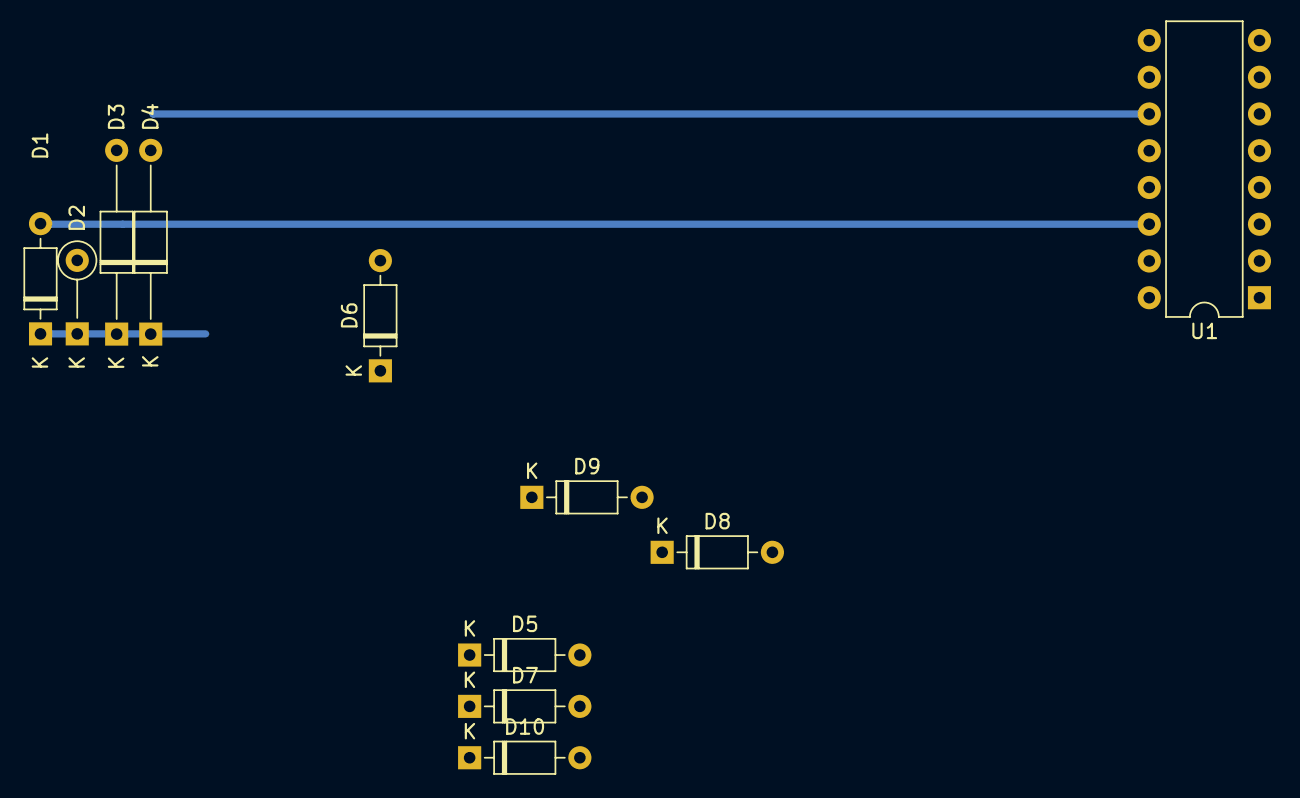
[picture p282: board octal keyboard interface.kicad_pcb from above]

Board: 2 copper layers, 11 parts (0 on the bottom side), 8 nets.

Parts:
D1, D5, D6, D7, D8, D9, D10: 1N914; D_DO-35_SOD27_P7.62mm_Horizontal
D2: 1N914; D_DO-35_SOD27_P5.08mm_Vertical_KathodeUp
D3, D4: 1N914; D_DO-35_SOD27_P12.70mm_Horizontal
U1: 7496; DIP-16_W7.62mm

Connections:
0: D1.1, D2.1, D3.1, D4.1
1: D5.1, D6.1, D7.1
4: D8.1, D9.1, D10.1
K0: D2.2, U1.15
K1: D1.2, D7.2, U1.14
K2: D6.2, U1.13
K3: D4.2, D5.2, U1.11
K4: D3.2, U1.10
