ibm2030/EDUC8/Music Player/Music player/Music player.kicad_pcb

## KiCad design Music Player/Music player/Music player.kicad_pcb (2023-03-05)

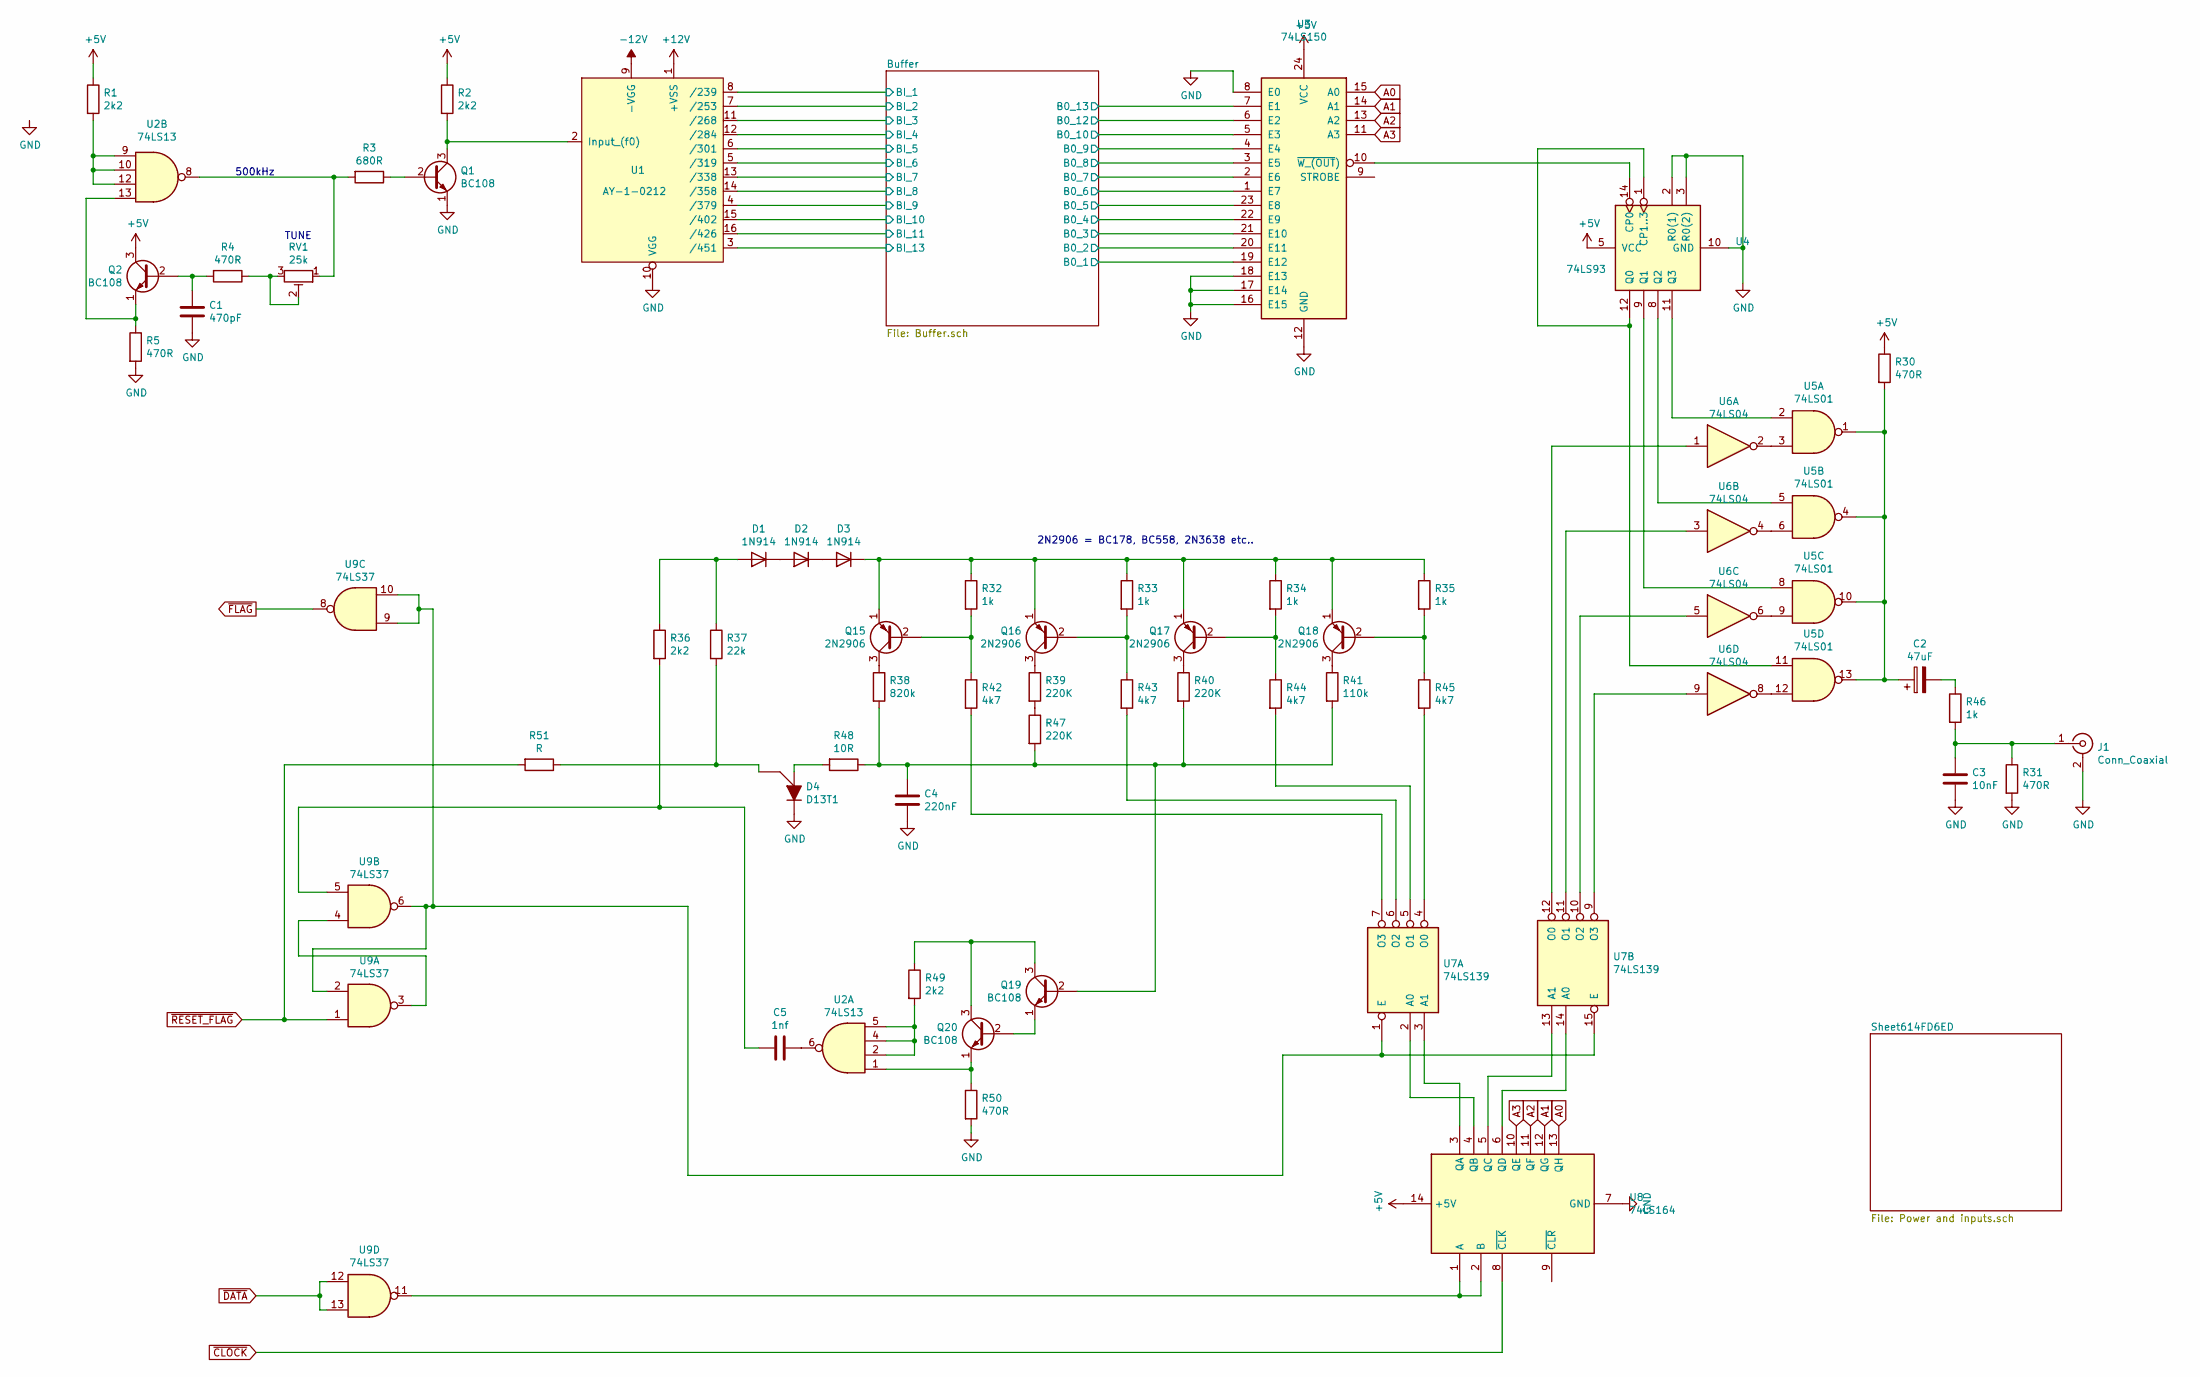
[picture p283: schematic Music player.sch, EDUC-8 Music Player]

Parts:
C1: 470pF; C_Disc_D8.0mm_W2.5mm_P5.00mm
C2: 47uF; CP_Axial_L11.0mm_D6.0mm_P18.00mm_Horizontal
C3: 10nF; C_Disc_D8.0mm_W2.5mm_P5.00mm
C4: 220nF; C_Disc_D8.0mm_W2.5mm_P5.00mm
C5: 1nf; C_Disc_D8.0mm_W2.5mm_P5.00mm
D1, D2, D3: 1N914; D_DO-35_SOD27_P7.62mm_Horizontal
D4: D13T1; TO-92L_Inline_Wide
J1: Conn_Coaxial
Q1, Q2, Q19, Q20: BC108; TO-18-3
Q15, Q16, Q17, Q18: 2N2906; TO-18-3
R1, R2, R36, R49: 2k2; R_Axial_DIN0207_L6.3mm_D2.5mm_P10.16mm_Horizontal
R3: 680R; R_Axial_DIN0207_L6.3mm_D2.5mm_P10.16mm_Horizontal
R4, R5, R30, R31, R50: 470R; R_Axial_DIN0207_L6.3mm_D2.5mm_P10.16mm_Horizontal
R32, R33, R34, R35, R46: 1k; R_Axial_DIN0207_L6.3mm_D2.5mm_P10.16mm_Horizontal
R37: 22k; R_Axial_DIN0207_L6.3mm_D2.5mm_P10.16mm_Horizontal
R38: 820k; R_Axial_DIN0207_L6.3mm_D2.5mm_P10.16mm_Horizontal
R39, R40, R47: 220K; R_Axial_DIN0207_L6.3mm_D2.5mm_P10.16mm_Horizontal
R41: 110k; R_Axial_DIN0207_L6.3mm_D2.5mm_P10.16mm_Horizontal
R42, R43, R44, R45: 4k7; R_Axial_DIN0207_L6.3mm_D2.5mm_P10.16mm_Horizontal
R48: 10R; R_Axial_DIN0207_L6.3mm_D2.5mm_P10.16mm_Horizontal
R51: R; R_Axial_DIN0207_L6.3mm_D2.5mm_P10.16mm_Horizontal
RV1: 25k; Potentiometer_Bourns_3005_Horizontal
U1: AY-1-0212; DIP-16_W7.62mm_LongPads
U2: 74LS13; DIP-14_W7.62mm_LongPads
U3: 74LS150; DIP-24_W15.24mm_LongPads
U4: 74LS93; DIP-14_W7.62mm_LongPads
U5: 74LS01; DIP-14_W7.62mm_LongPads
U6: 74LS04; DIP-14_W7.62mm_LongPads
U7: 74LS139; DIP-16_W7.62mm_LongPads
U8: 74LS164; DIP-14_W7.62mm_LongPads
U9: 74LS37; DIP-14_W7.62mm_LongPads

Connections:
+5V: Q2.3 (C), R1.1, R2.1, R30.1, U3.24 (VCC), U4.5 (VCC), U8.14 (+5V); also elsewhere on the board
+12V: U1.1 (+VSS); also elsewhere on the board
-12V: U1.9 (-VGG); also elsewhere on the board
/Buffer/B0_1: U3.19 (E12); also elsewhere on the board
/Buffer/B0_2: U3.20 (E11); also elsewhere on the board
/Buffer/B0_3: U3.21 (E10); also elsewhere on the board
/Buffer/B0_4: U3.22 (E9); also elsewhere on the board
/Buffer/B0_5: U3.23 (E8); also elsewhere on the board
/Buffer/B0_6: U3.1 (E7); also elsewhere on the board
/Buffer/B0_7: U3.2 (E6); also elsewhere on the board
/Buffer/B0_8: U3.3 (E5); also elsewhere on the board
/Buffer/B0_9: U3.4 (E4); also elsewhere on the board
/Buffer/B0_10: U3.5 (E3); also elsewhere on the board
/Buffer/B0_12: U3.6 (E2); also elsewhere on the board
/Buffer/B0_13: U3.7 (E1); also elsewhere on the board
/Buffer/BI_1: U1.8 (/239); also elsewhere on the board
/Buffer/BI_2: U1.7 (/253); also elsewhere on the board
/Buffer/BI_3: U1.11 (/268); also elsewhere on the board
/Buffer/BI_4: U1.12 (/284); also elsewhere on the board
/Buffer/BI_5: U1.6 (/301); also elsewhere on the board
/Buffer/BI_6: U1.5 (/319); also elsewhere on the board
/Buffer/BI_7: U1.13 (/338); also elsewhere on the board
/Buffer/BI_8: U1.14 (/358); also elsewhere on the board
/Buffer/BI_9: U1.4 (/379); also elsewhere on the board
/Buffer/BI_10: U1.15 (/402); also elsewhere on the board
/Buffer/BI_11: U1.16 (/426); also elsewhere on the board
/Buffer/BI_13: U1.3 (/451); also elsewhere on the board
A0: U3.15 (A0), U8.13 (QH)
A1: U3.14 (A1), U8.12 (QG)
A2: U3.13 (A2), U8.11 (QF)
A3: U3.11 (A3), U8.10 (QE)
GND: C1.2, C3.2, C4.2, D4.3 (K), J1.2 (Ext), Q1.1 (E), R5.2, R31.2, R50.2, U1.10 (VGG), U3.8 (E0), U3.12 (GND), U3.16 (E15), U3.17 (E14), U3.18 (E13), U4.2 (R0(1)), U4.3 (R0(2)), U4.10 (GND), U8.7 (GND); also elsewhere on the board
unnamed: C1.1, Q2.2 (B), R4.2
unnamed: C2.1, R30.2, U5.1, U5.4, U5.10, U5.13
unnamed: C2.2, R46.1
unnamed: C3.1, J1.1 (In), R31.1, R46.2
unnamed: C4.1, Q19.2 (B), R38.2, R40.2, R41.2, R47.2, R48.1
unnamed: C5.1, U2.6
unnamed: C5.2, R36.2, U9.5
unnamed: D1.1 (K), D2.2 (A)
unnamed: D1.2 (A), R36.1, R37.1
unnamed: D2.1 (K), D3.2 (A)
unnamed: D3.1 (K), Q15.1 (E), Q16.1 (E), Q17.1 (E), Q18.1 (E), R32.1, R33.1, R34.1, R35.1
unnamed: D4.1 (A), R48.2
unnamed: D4.2 (G), R37.2, R51.1
unnamed: Q1.2 (B), R3.1
unnamed: Q1.3 (C), R2.2, U1.2 (Input_(f0))
unnamed: Q2.1 (E), R5.1, U2.13
unnamed: Q15.2 (B), R32.2, R42.1
unnamed: Q15.3 (C), R38.1
unnamed: Q16.2 (B), R33.2, R43.1
unnamed: Q16.3 (C), R39.1
unnamed: Q17.2 (B), R34.2, R44.1
unnamed: Q17.3 (C), R40.1
unnamed: Q18.2 (B), R35.2, R45.1
unnamed: Q18.3 (C), R41.1
unnamed: Q19.1 (E), Q20.2 (B)
unnamed: Q19.3 (C), Q20.3 (C), R49.1
unnamed: Q20.1 (E), R50.1, U2.1
unnamed: R1.2, U2.9, U2.10, U2.12
unnamed: R3.2, RV1.1, U2.8
unnamed: R4.1, RV1.2, RV1.3
unnamed: R39.2, R47.1
unnamed: R42.2, U7.7 (O3)
unnamed: R43.2, U7.6 (O2)
unnamed: R44.2, U7.5 (O1)
unnamed: R45.2, U7.4 (O0)
unnamed: R49.2, U2.2, U2.4, U2.5
unnamed: U3.10 (~W_(OUT)), U4.14 (CP0)
unnamed: U4.1 (CP1..3), U4.12 (Q0), U5.11
unnamed: U4.8 (Q2), U5.5
unnamed: U4.9 (Q1), U5.8
unnamed: U4.11 (Q3), U5.2
unnamed: U5.3, U6.2
unnamed: U5.6, U6.4
unnamed: U5.9, U6.6
unnamed: U5.12, U6.8
unnamed: U6.1, U7.12 (O0)
unnamed: U6.3, U7.11 (O1)
unnamed: U6.5, U7.10 (O2)
unnamed: U6.9, U7.9 (O3)
unnamed: U7.1 (E), U7.15 (E), U9.2, U9.6, U9.9, U9.10
unnamed: U7.2 (A0), U8.4 (QB)
unnamed: U7.3 (A1), U8.3 (QA)
unnamed: U7.13 (A1), U8.5 (QC)
unnamed: U7.14 (A0), U8.6 (QD)
unnamed: U8.1 (A), U8.2 (B), U9.11
unnamed: U9.3, U9.4
~CLOCK: U8.8 (~CLK); also elsewhere on the board
~DATA: U9.12, U9.13; also elsewhere on the board
~FLAG: U9.8; also elsewhere on the board
~RESET_FLAG: R51.2, U9.1

Notes on the sheet:
TUNE
500kHz
2N2906 = BC178, BC558, 2N3638 etc..

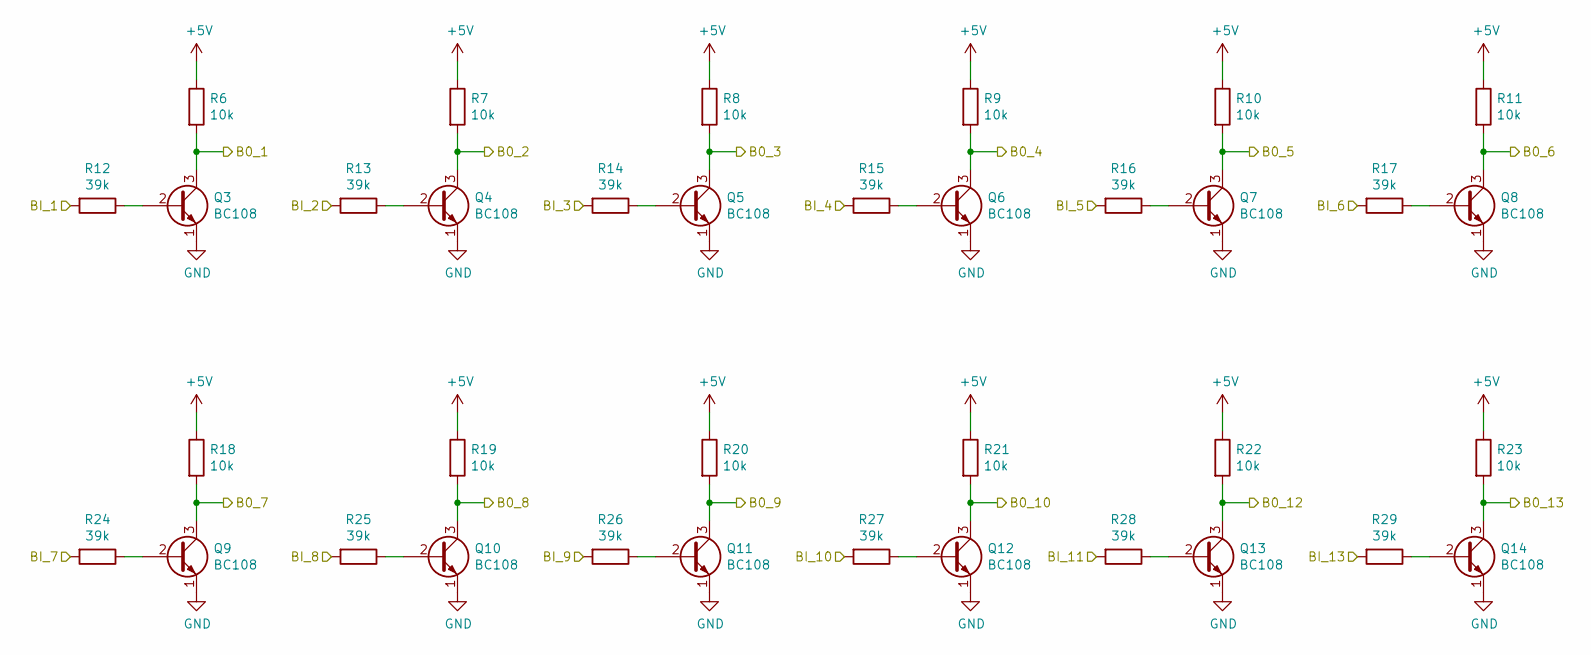
[picture p284: schematic Buffer.sch, Level Buffers]

Parts:
Q3, Q4, Q5, Q6, Q7, Q8, Q9, Q10, Q11, Q12, Q13, Q14: BC108; TO-18-3
R6, R7, R8, R9, R10, R11, R18, R19, R20, R21, R22, R23: 10k; R_Axial_DIN0207_L6.3mm_D2.5mm_P10.16mm_Horizontal
R12, R13, R14, R15, R16, R17, R24, R25, R26, R27, R28, R29: 39k; R_Axial_DIN0207_L6.3mm_D2.5mm_P10.16mm_Horizontal

Connections:
+5V: R6.1, R7.1, R8.1, R9.1, R10.1, R11.1, R18.1, R19.1, R20.1, R21.1, R22.1, R23.1; also elsewhere on the board
/Buffer/B0_1: Q3.3 (C), R6.2; also elsewhere on the board
/Buffer/B0_2: Q4.3 (C), R7.2; also elsewhere on the board
/Buffer/B0_3: Q5.3 (C), R8.2; also elsewhere on the board
/Buffer/B0_4: Q6.3 (C), R9.2; also elsewhere on the board
/Buffer/B0_5: Q7.3 (C), R10.2; also elsewhere on the board
/Buffer/B0_6: Q8.3 (C), R11.2; also elsewhere on the board
/Buffer/B0_7: Q9.3 (C), R18.2; also elsewhere on the board
/Buffer/B0_8: Q10.3 (C), R19.2; also elsewhere on the board
/Buffer/B0_9: Q11.3 (C), R20.2; also elsewhere on the board
/Buffer/B0_10: Q12.3 (C), R21.2; also elsewhere on the board
/Buffer/B0_12: Q13.3 (C), R22.2; also elsewhere on the board
/Buffer/B0_13: Q14.3 (C), R23.2; also elsewhere on the board
/Buffer/BI_1: R12.2; also elsewhere on the board
/Buffer/BI_2: R13.2; also elsewhere on the board
/Buffer/BI_3: R14.2; also elsewhere on the board
/Buffer/BI_4: R15.2; also elsewhere on the board
/Buffer/BI_5: R16.2; also elsewhere on the board
/Buffer/BI_6: R17.2; also elsewhere on the board
/Buffer/BI_7: R24.2; also elsewhere on the board
/Buffer/BI_8: R25.2; also elsewhere on the board
/Buffer/BI_9: R26.2; also elsewhere on the board
/Buffer/BI_10: R27.2; also elsewhere on the board
/Buffer/BI_11: R28.2; also elsewhere on the board
/Buffer/BI_13: R29.2; also elsewhere on the board
GND: Q3.1 (E), Q4.1 (E), Q5.1 (E), Q6.1 (E), Q7.1 (E), Q8.1 (E), Q9.1 (E), Q10.1 (E), Q11.1 (E), Q12.1 (E), Q13.1 (E), Q14.1 (E); also elsewhere on the board
unnamed: Q3.2 (B), R12.1
unnamed: Q4.2 (B), R13.1
unnamed: Q5.2 (B), R14.1
unnamed: Q6.2 (B), R15.1
unnamed: Q7.2 (B), R16.1
unnamed: Q8.2 (B), R17.1
unnamed: Q9.2 (B), R24.1
unnamed: Q10.2 (B), R25.1
unnamed: Q11.2 (B), R26.1
unnamed: Q12.2 (B), R27.1
unnamed: Q13.2 (B), R28.1
unnamed: Q14.2 (B), R29.1

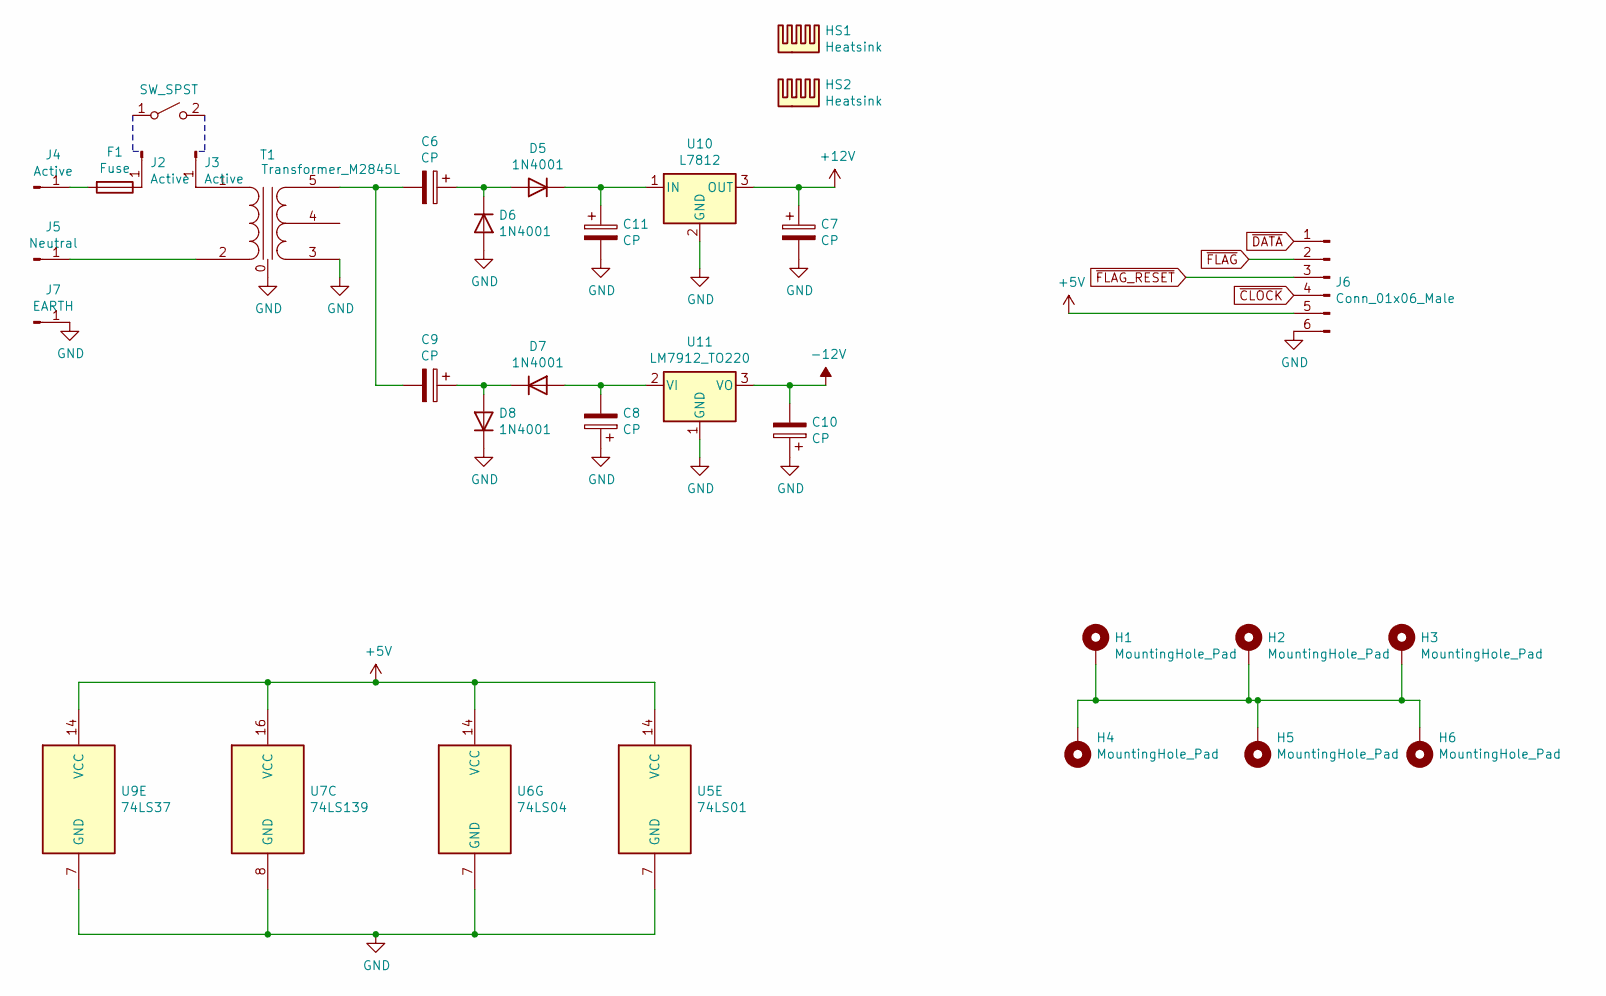
[picture p285: schematic Power and inputs.sch]

Parts:
C6, C9: CP; CP_Radial_D10.0mm_P5.00mm
C7, C10: CP; CP_Radial_D6.3mm_P2.50mm
C8, C11: CP; CP_Radial_D18.0mm_P7.50mm
D5, D6, D7, D8: 1N4001; D_DO-41_SOD81_P10.16mm_Horizontal
F1: Fuse; Fuseholder_Cylinder-5x20mm_Schurter_FAB_0031-355x_Horizonta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
H1, H2, H3, H4, H5, H6: MountingHole_Pad; MountingHole_3.2mm_M3_Pad_Via
HS1, HS2: Heatsink; Heatsink_Aavid-TV5G_TO220_Horizontal
J2, J3, J4: Active; QC_Terminal_PCB_W6.3mm_P5mm_
J5: Neutral; QC_Terminal_PCB_W6.3mm_P5mm_
J6: Conn_01x06_Male; Molex_KK-254_AE-6410-06A_1x06_P2.54mm_Vertical
J7: EARTH; QC_Terminal_PCB_W6.3mm_P5mm_
SW1: SW_SPST
T1: Transformer_M2845L; M2845L
U5: 74LS01
U6: 74LS04
U7: 74LS139
U9: 74LS37
U10: L7812; TO-220F-3_Horizontal_TabDown
U11: LM7912_TO220; TO-220-3_Horizontal_TabDown

Connections:
+5V: J6.5, U5.14 (VCC), U6.14 (VCC), U7.16 (VCC), U9.14 (VCC); also elsewhere on the board
+12V: C7.1, U10.3 (OUT); also elsewhere on the board
-12V: C10.2, U11.3 (VO); also elsewhere on the board
GND: C7.2, C8.1, C10.1, C11.2, D6.2 (A), D8.1 (K), J6.6, J7.1, T1.0 (GND), T1.3 (SA), U5.7 (GND), U6.7 (GND), U7.8 (GND), U9.7 (GND), U10.2 (GND), U11.1 (GND); also elsewhere on the board
unnamed: C6.1, D5.2 (A), D6.1 (K)
unnamed: C6.2, C9.2, T1.5 (SB)
unnamed: C8.2, D7.2 (A), U11.2 (VI)
unnamed: C9.1, D7.1 (K), D8.2 (A)
unnamed: C11.1, D5.1 (K), U10.1 (IN)
unnamed: F1.1, J2.1
unnamed: F1.2, J4.1
unnamed: H1.1, H2.1, H3.1, H4.1, H5.1, H6.1
unnamed: J3.1, T1.1 (AA)
unnamed: J5.1, T1.2 (AB)
~CLOCK: J6.4; also elsewhere on the board
~DATA: J6.1; also elsewhere on the board
~FLAG: J6.2; also elsewhere on the board
~FLAG_RESET: J6.3

Board: 2 copper layers, 120 parts (0 on the bottom side), 114 nets, no tracks yet.

Other parts of the board:
C8#2, C11#2: CP; CP_Radial_D5.0mm_P2.50mm

Their connections:
+12V: C8#2.1; also elsewhere on the board
-12V: C11#2.1; also elsewhere on the board
GND: C8#2.2, C11#2.2; also elsewhere on the board
