ibm2030/EDUC8/multiplexer/E8MX:M/multiplexer.kicad_pcb

## KiCad design multiplexer/E8MX:M/multiplexer.kicad_pcb (2023-03-05)

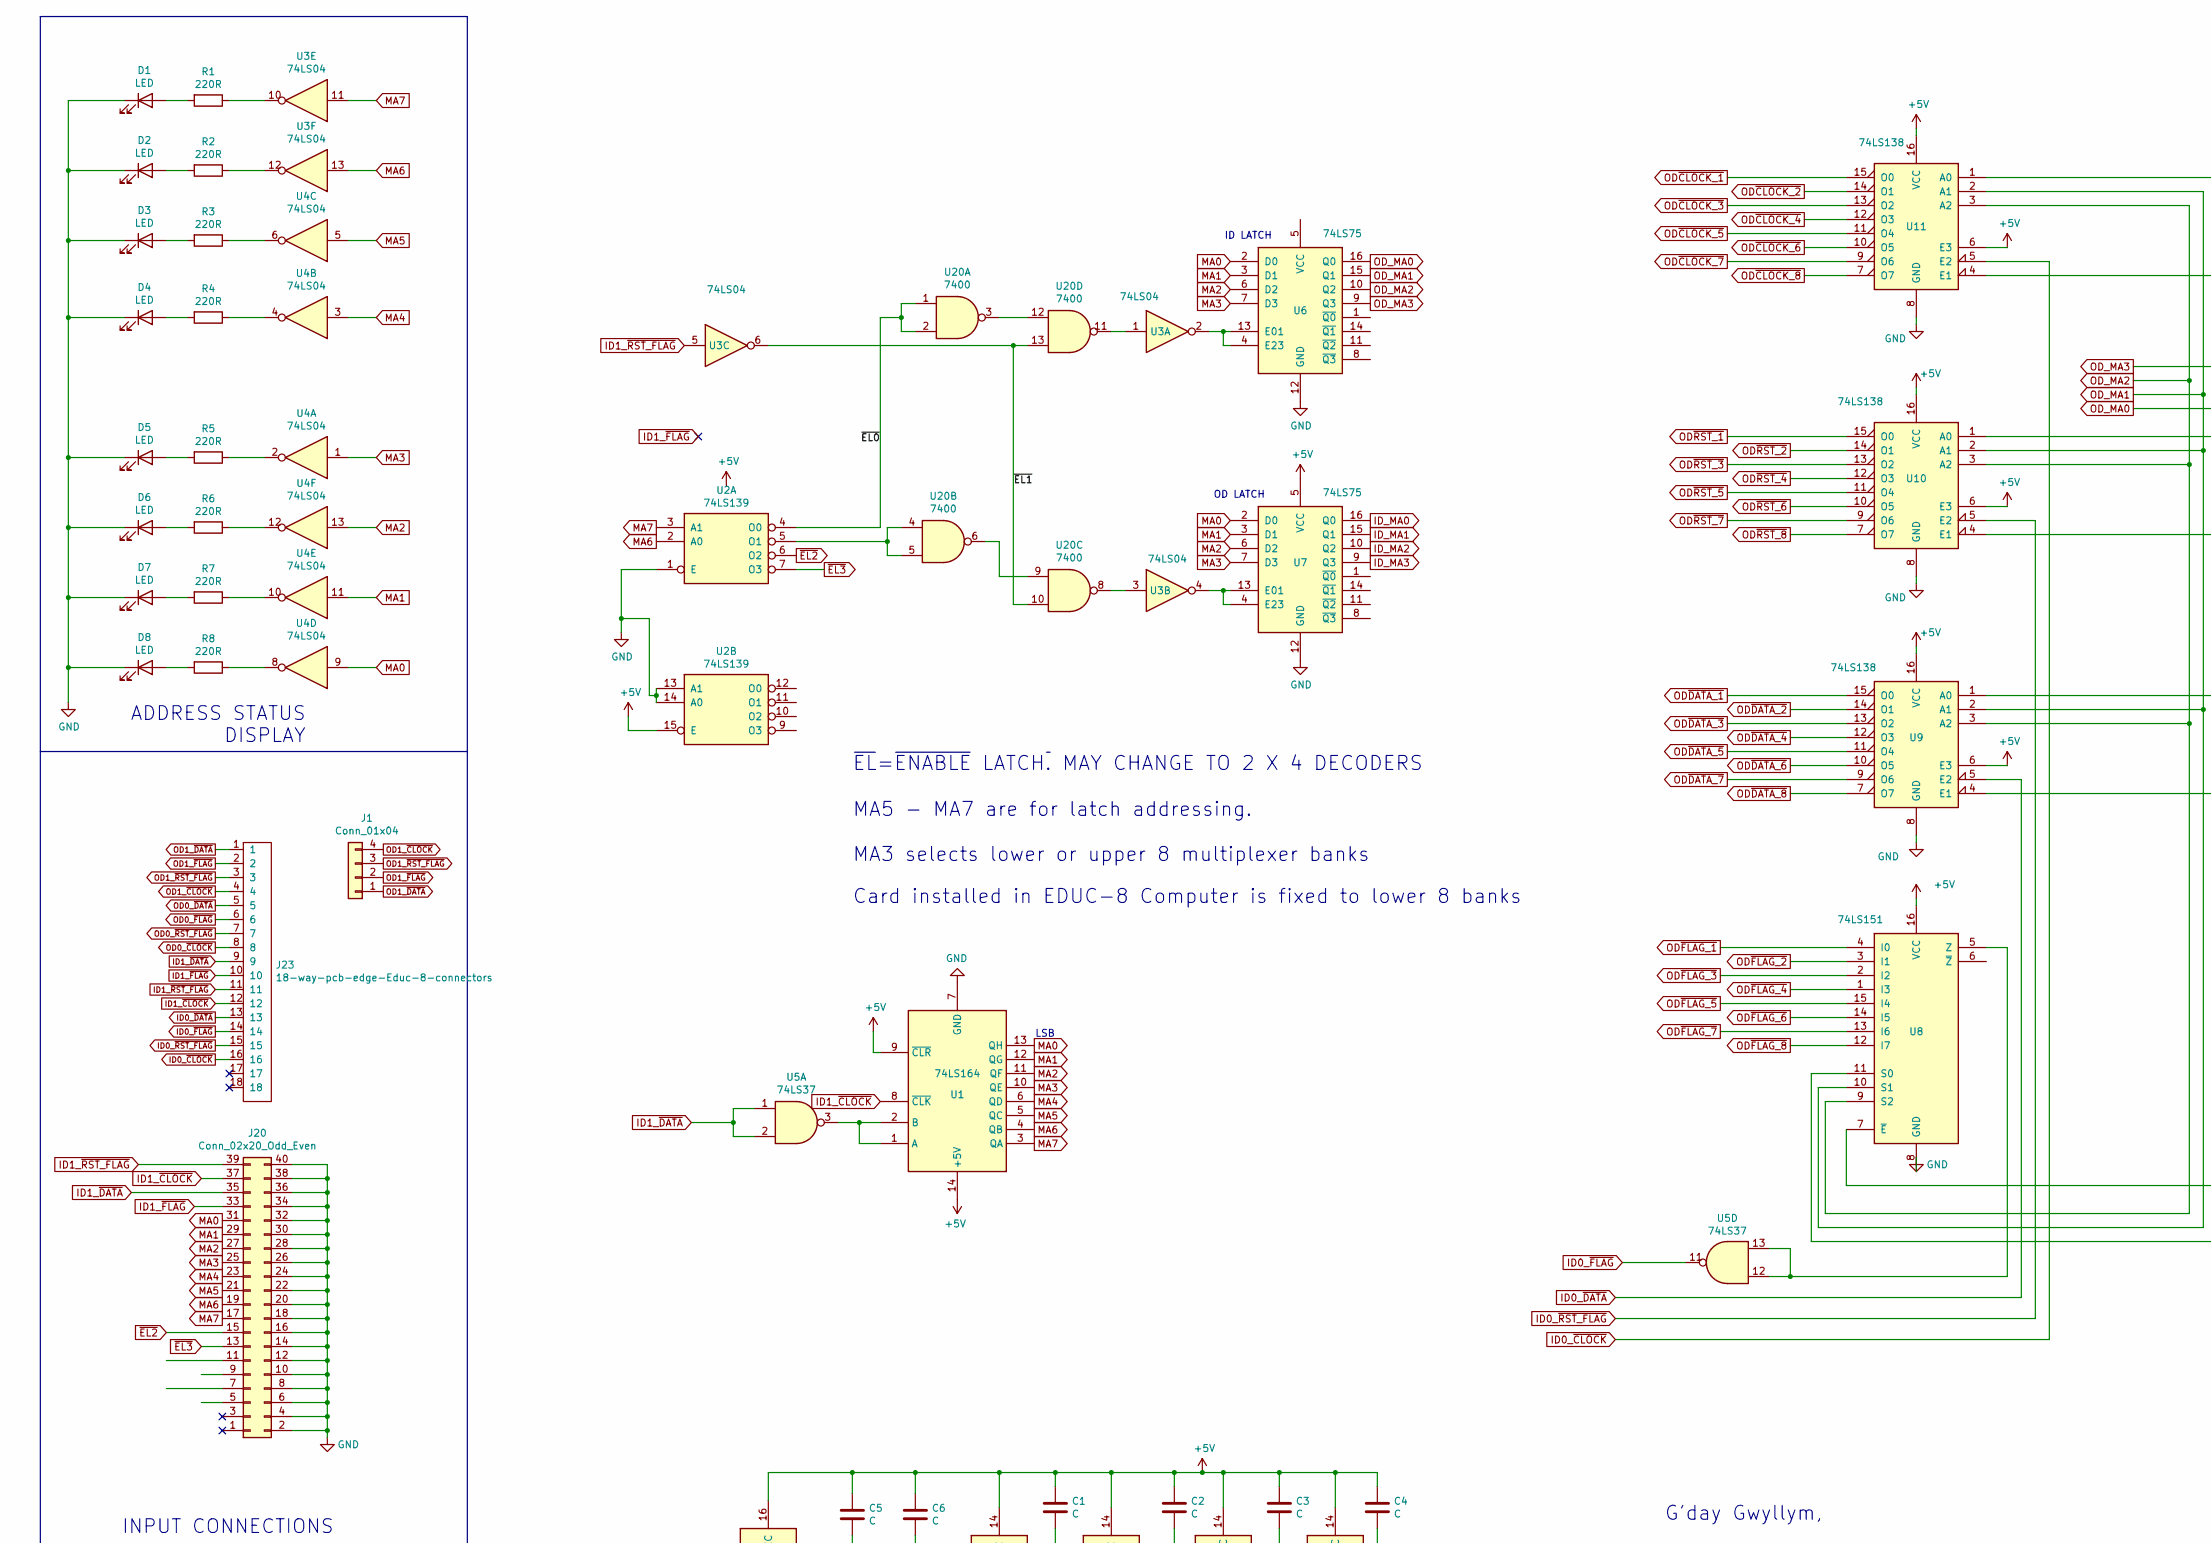
[picture p286: schematic multiplexer.kicad_sch, part in row 1, column 1]

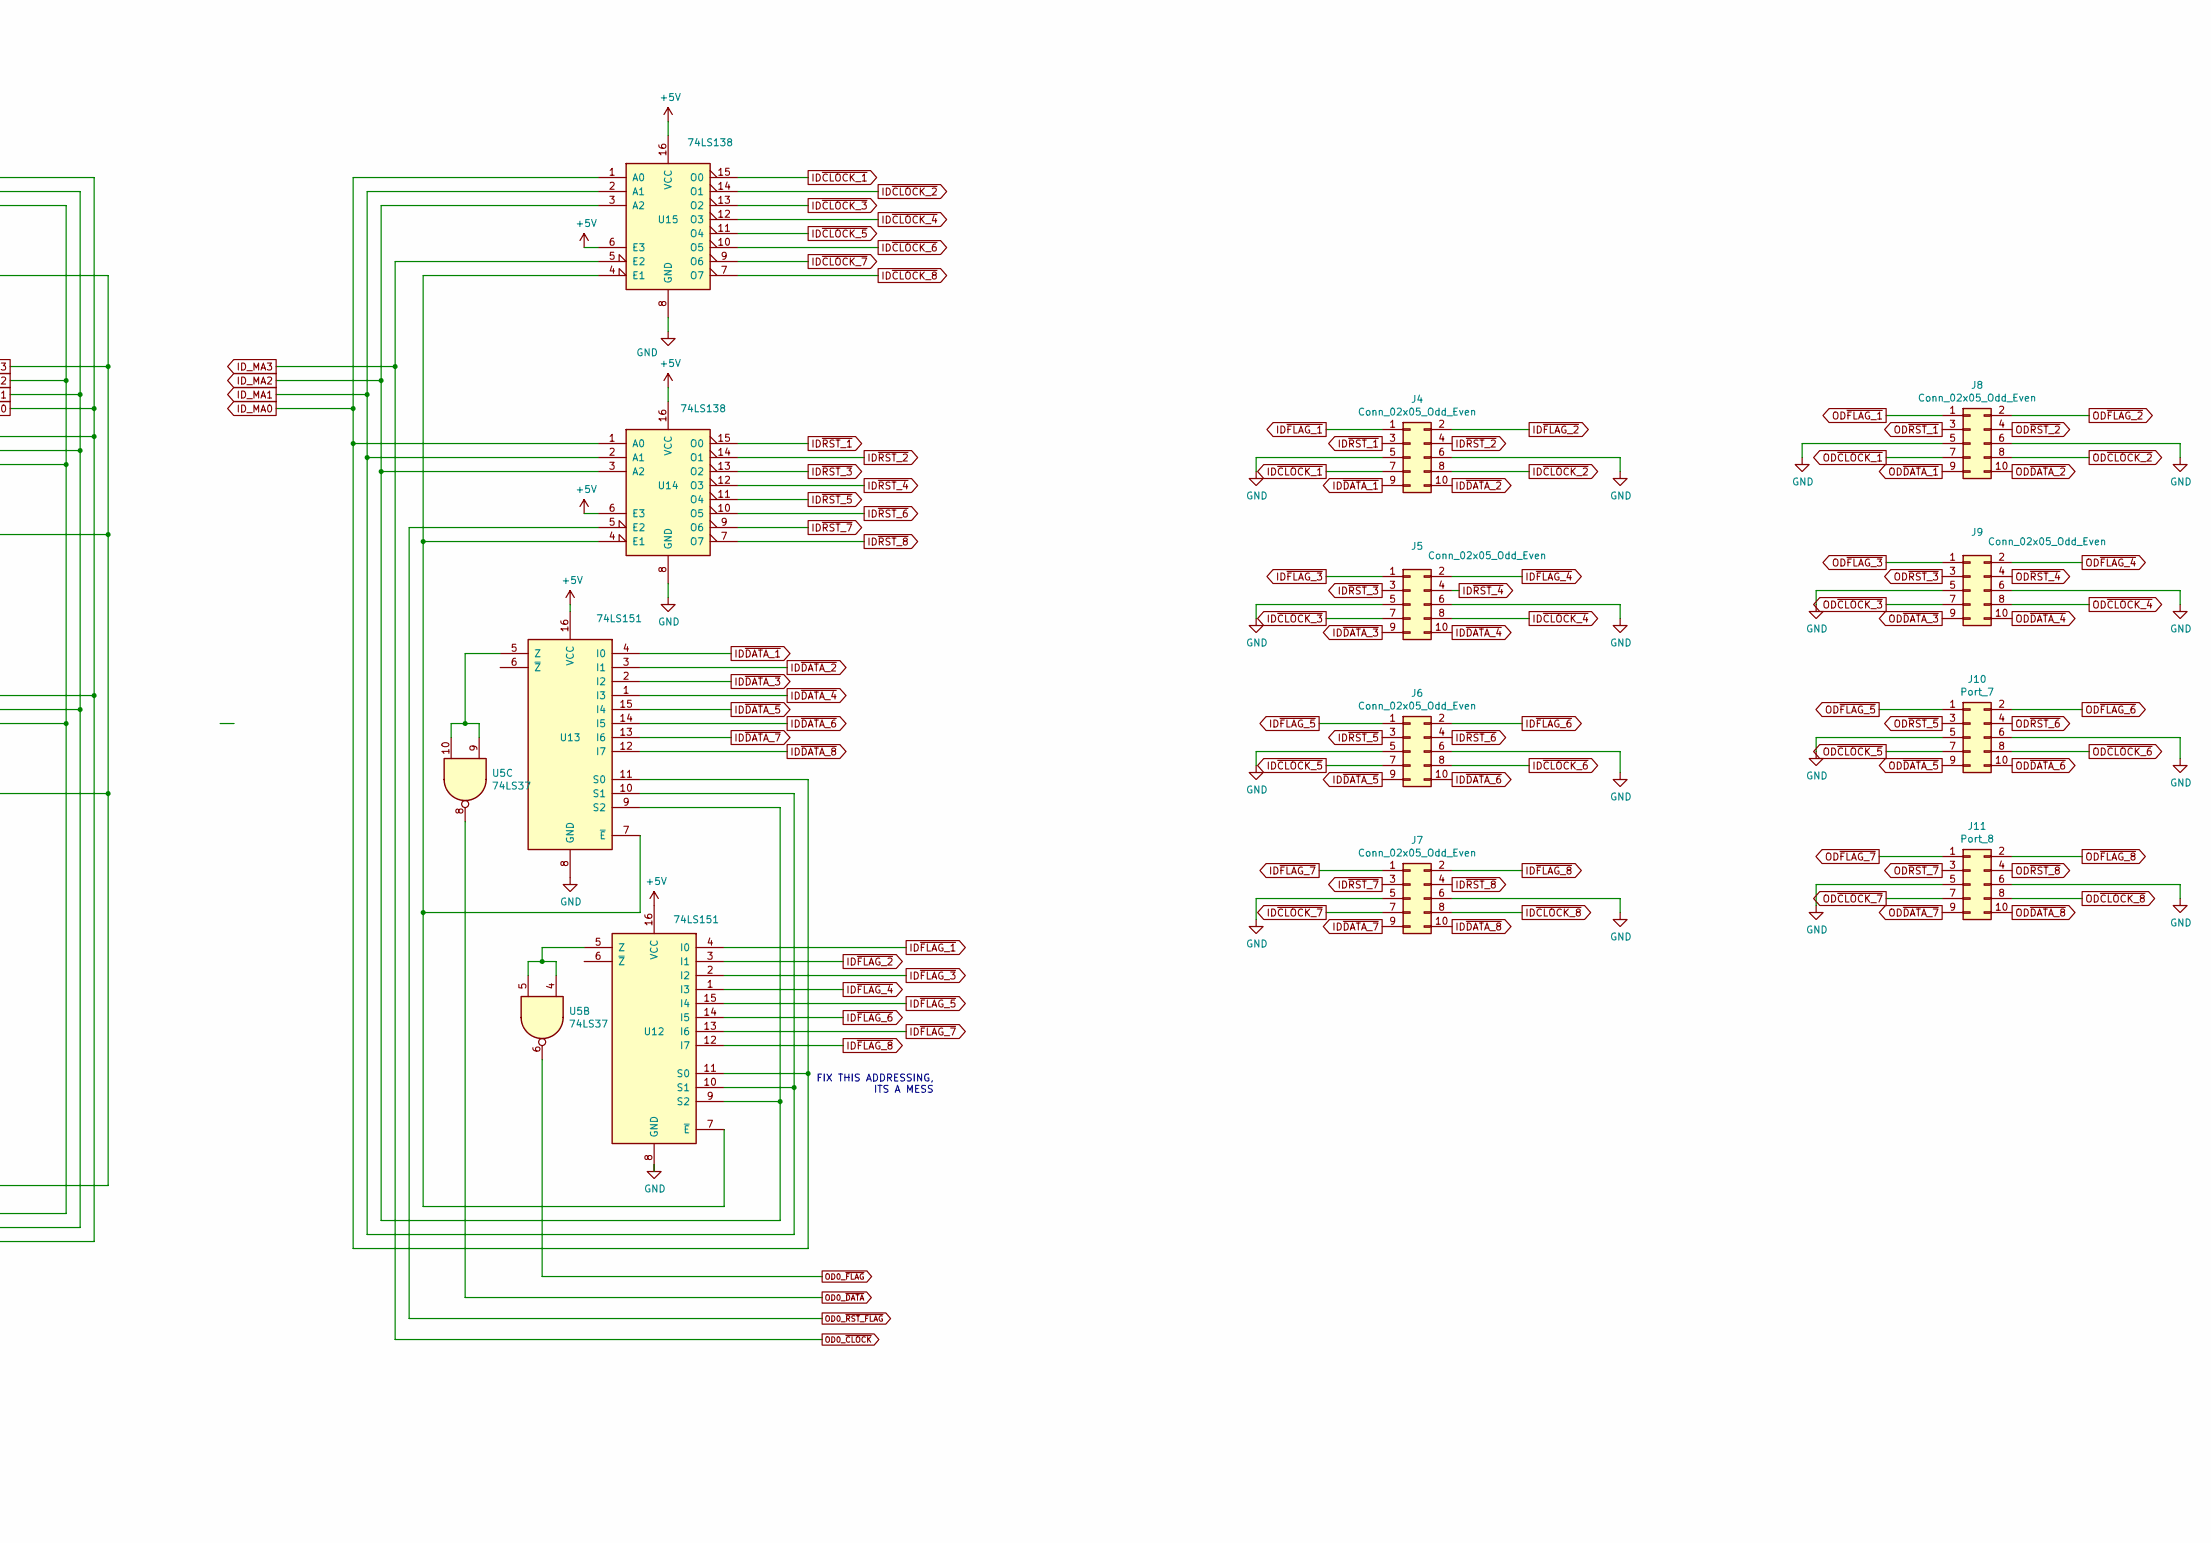
[picture p287: schematic multiplexer.kicad_sch, part in row 1, column 2]

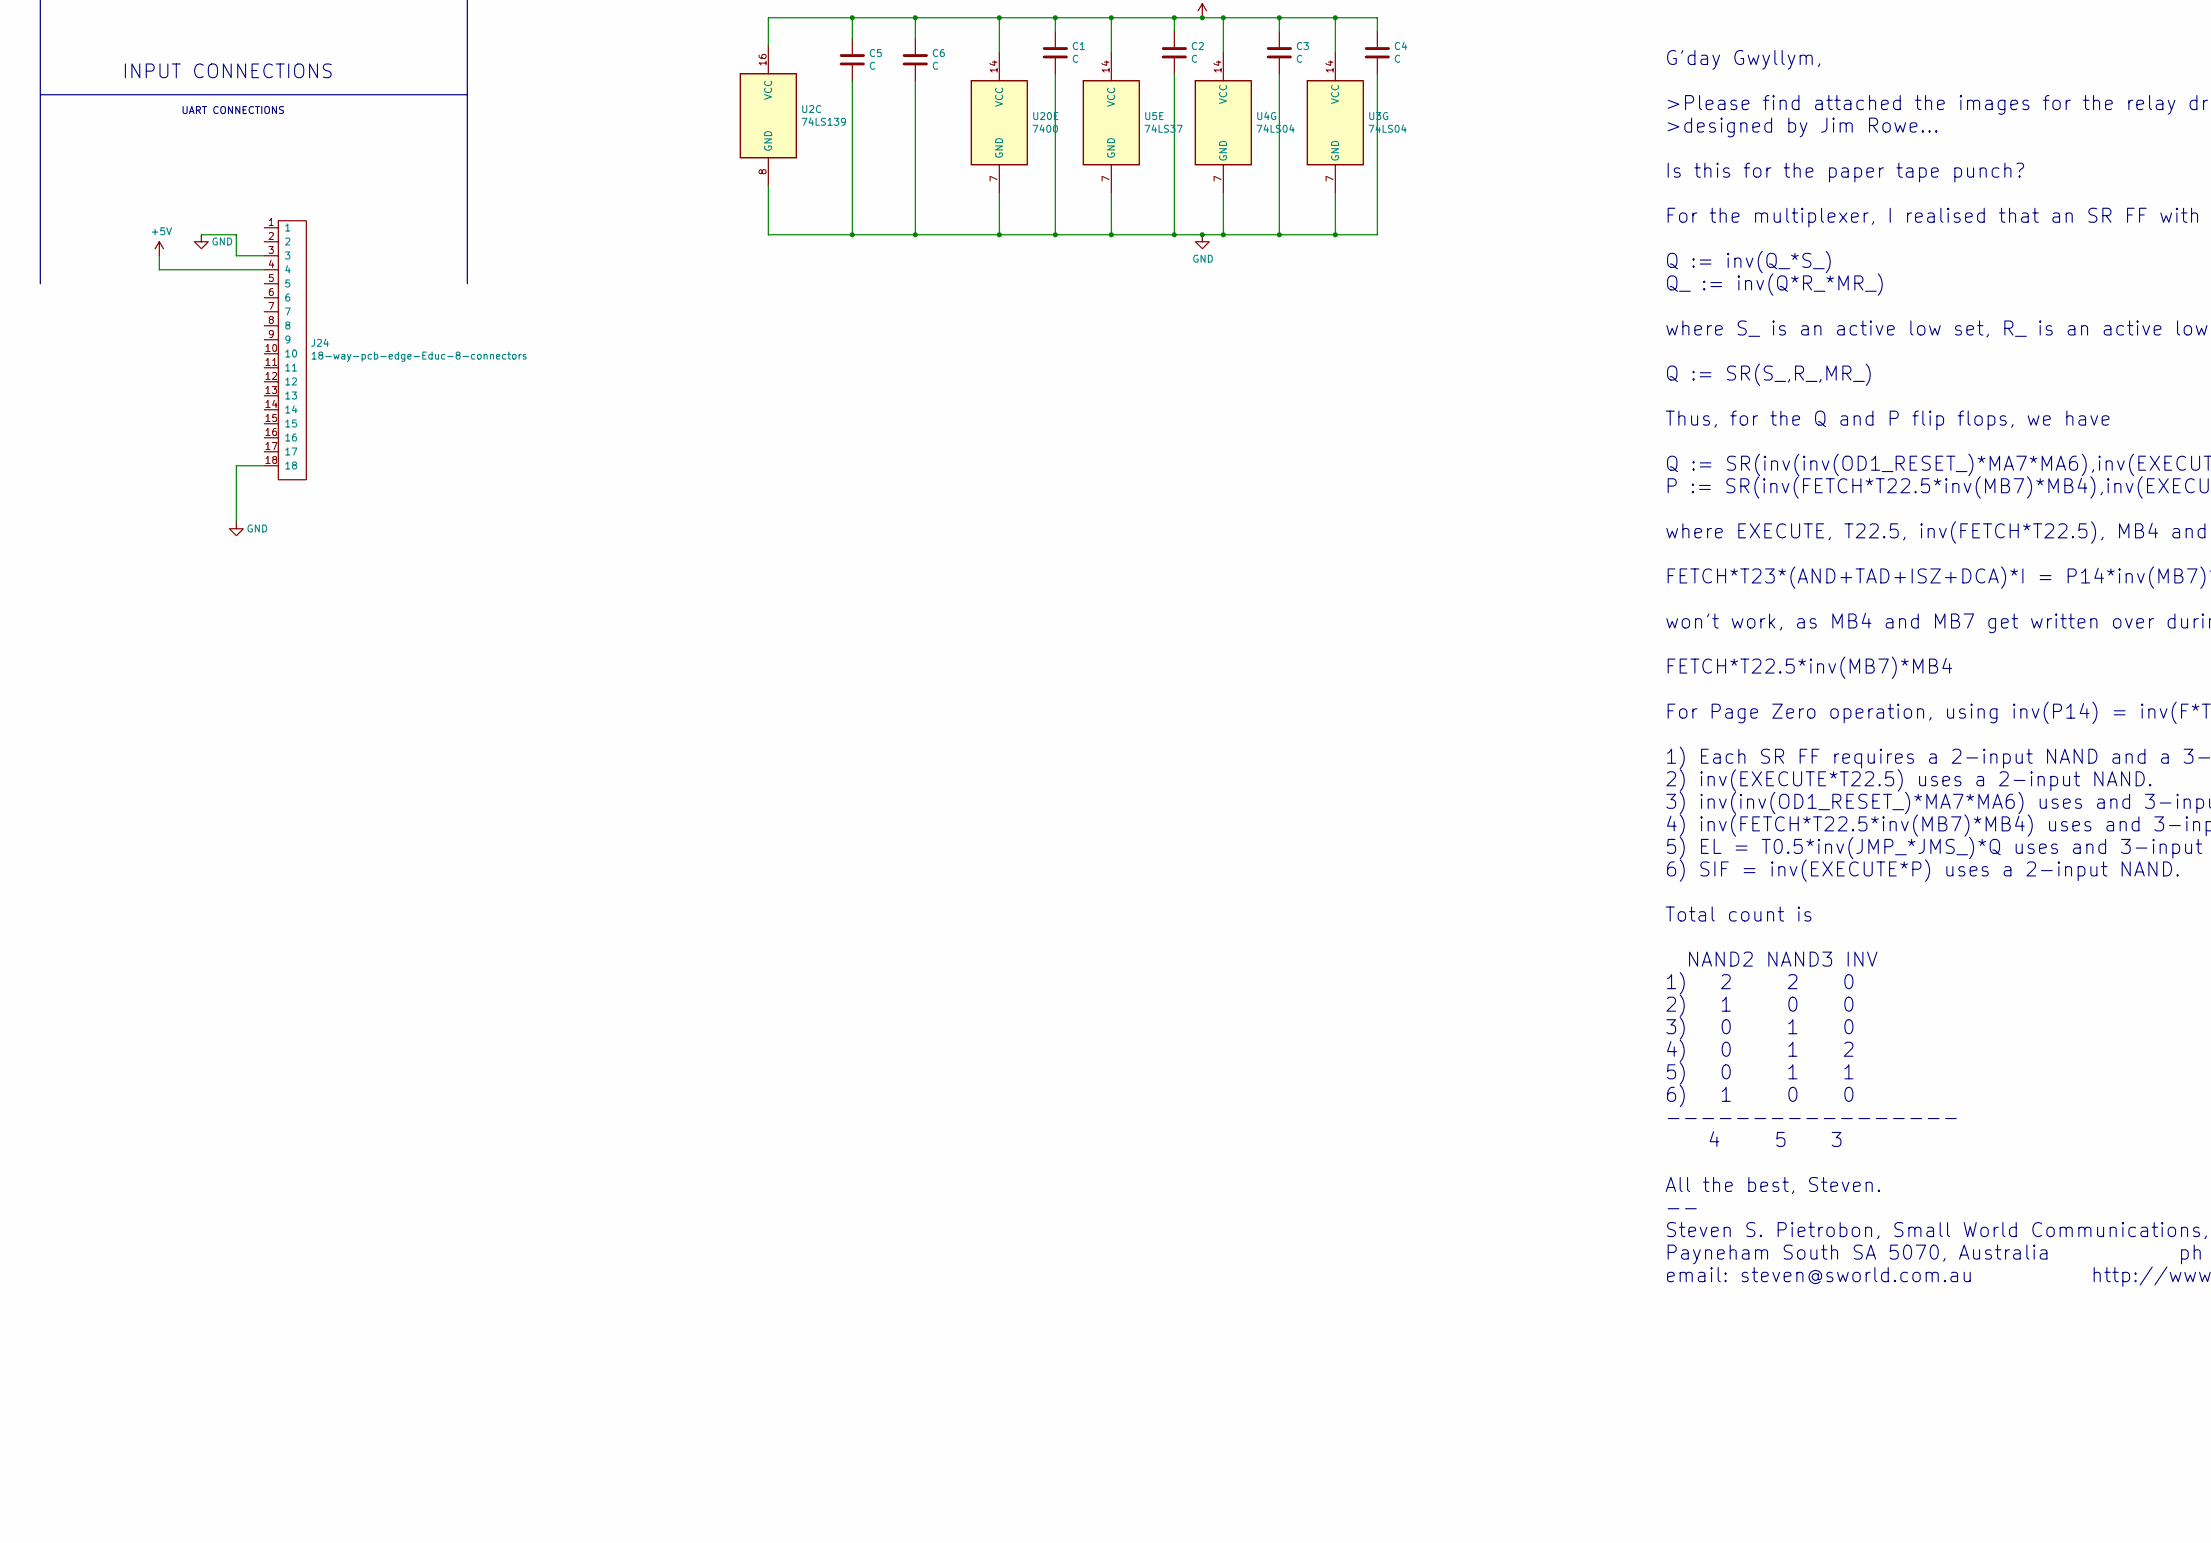
[picture p288: schematic multiplexer.kicad_sch, part in row 2, column 1]

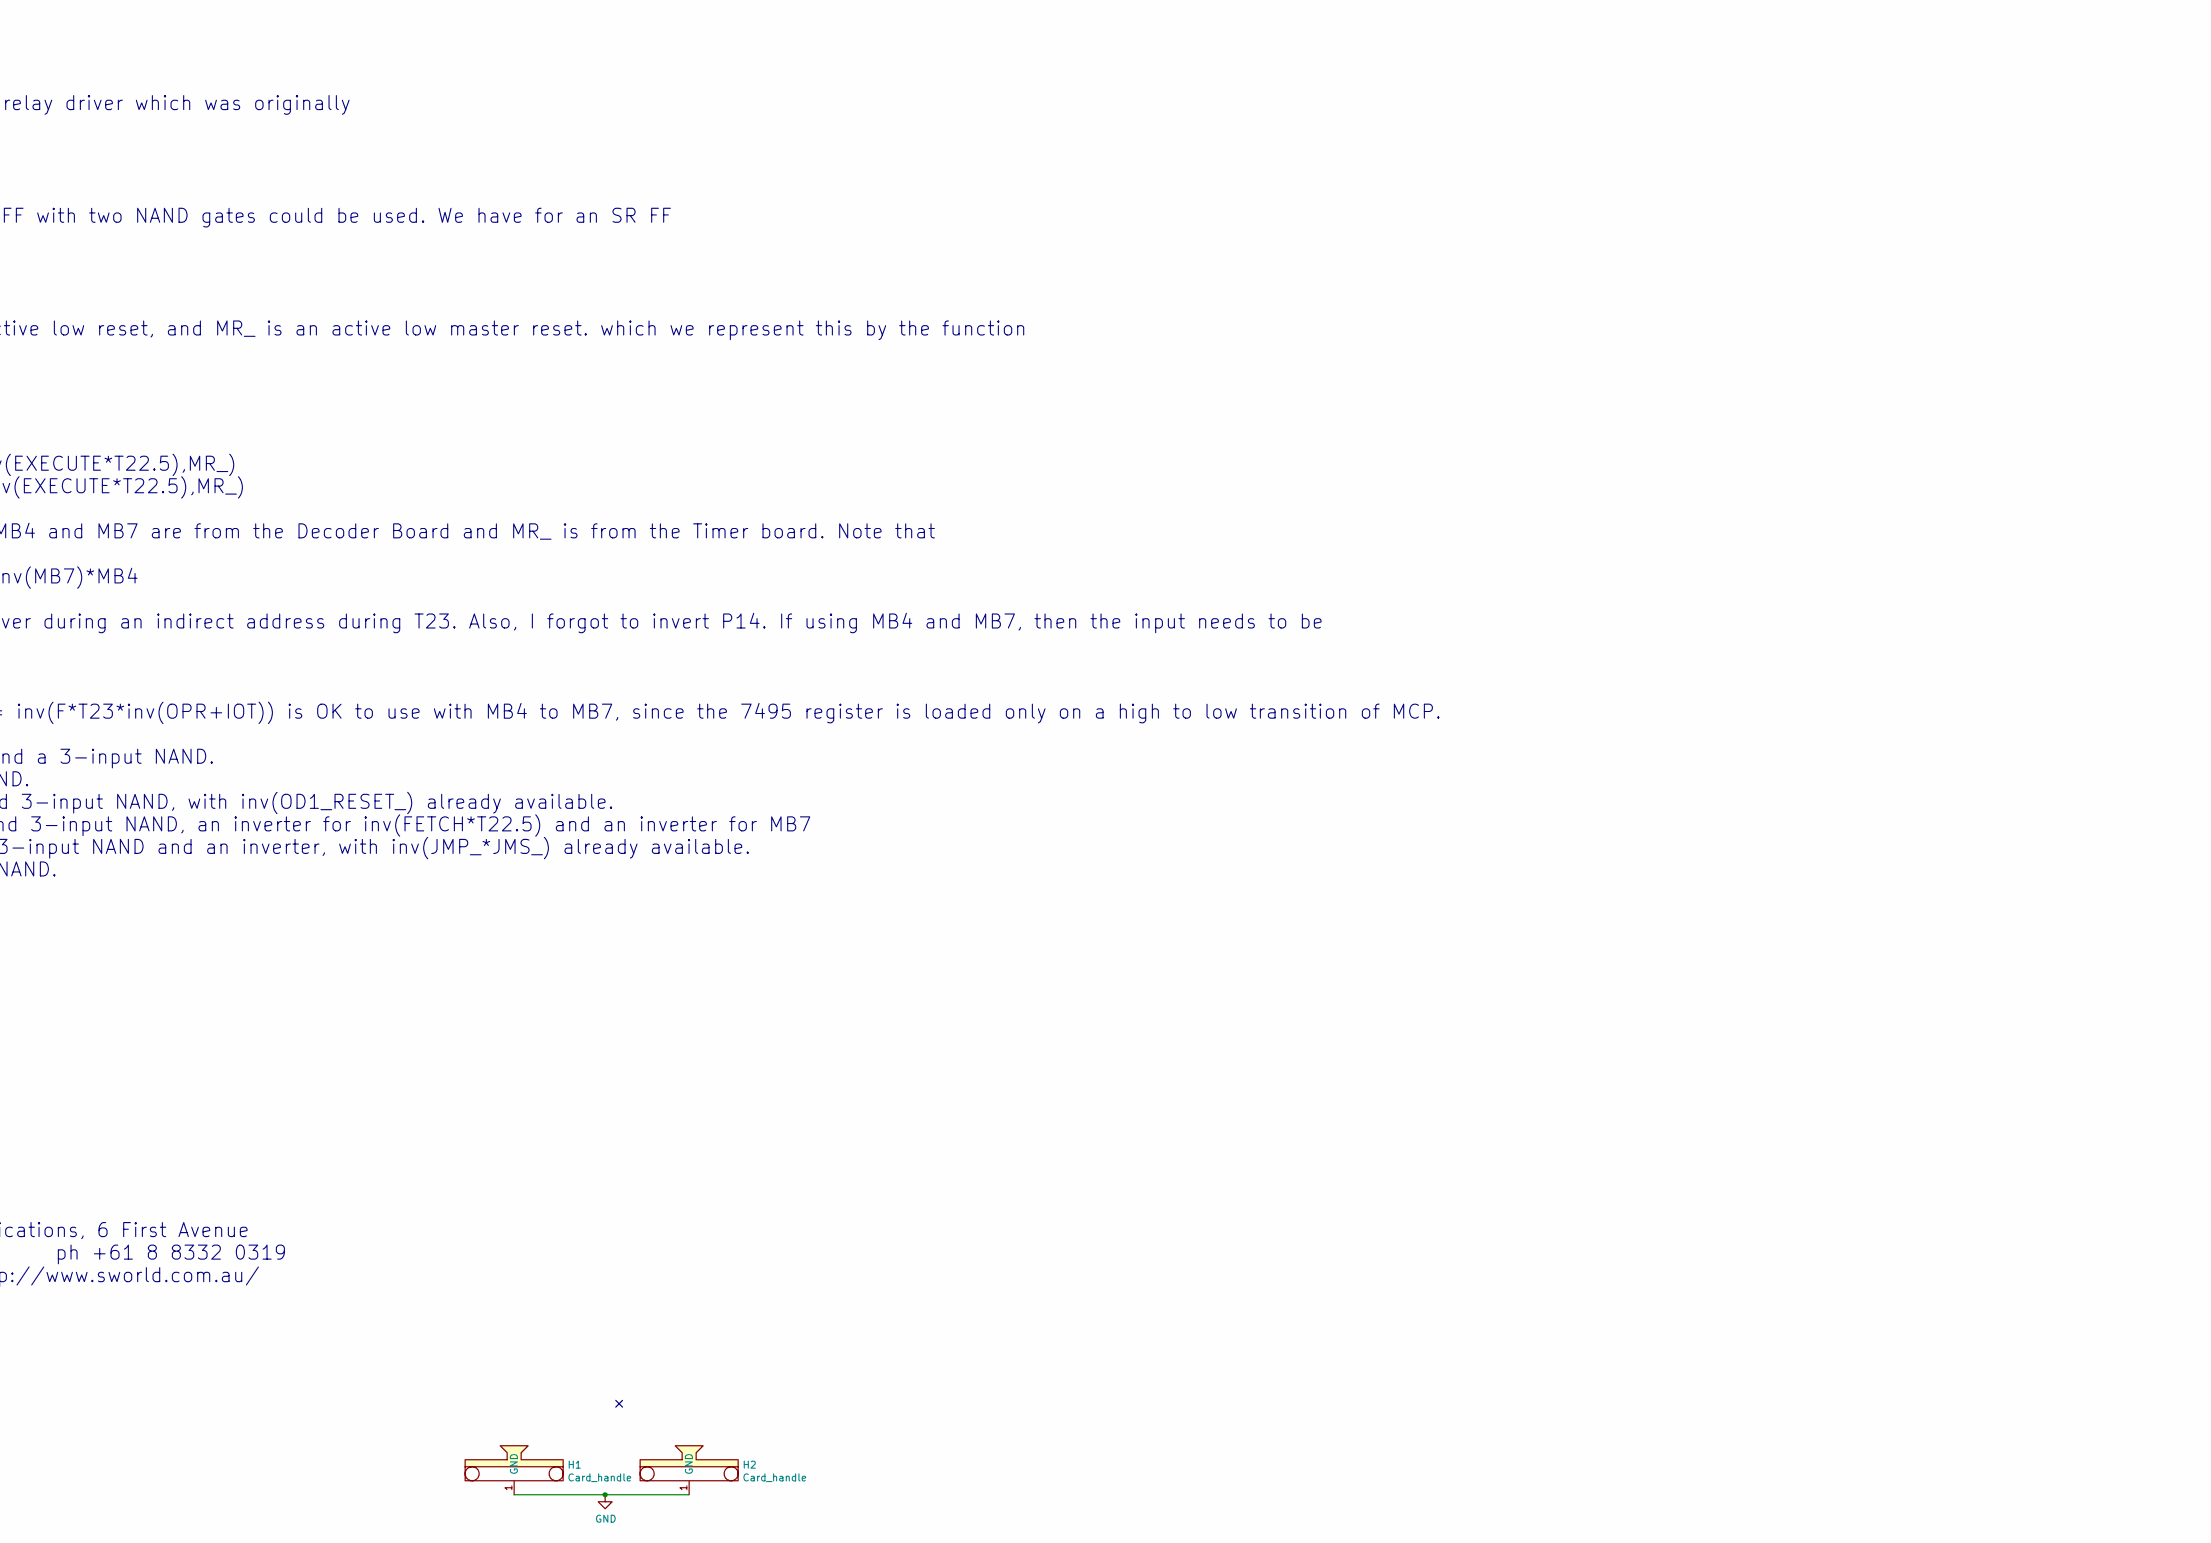
[picture p289: schematic multiplexer.kicad_sch, part in row 2, column 2]

Parts:
C1, C2, C3, C4, C5, C6: C; C_Rect_L7.2mm_W2.5mm_P5.00mm_FKS2_FKP2_MKS2_MKP2
D1, D2, D3, D4, D5, D6, D7, D8: LED; LED_D5.0mm
H1, H2: Card_handle
J1: Conn_01x04; PinHeader_1x04_P2.54mm_Vertical
J4, J5, J6, J7, J8, J9: Conn_02x05_Odd_Even; IDC-Header_2x05_P2.54mm_Vertical
J10: Port_7; IDC-Header_2x05_P2.54mm_Vertical
J11: Port_8; IDC-Header_2x05_P2.54mm_Vertical
J20: Conn_02x20_Odd_Even; IDC-Header_2x20_P2.54mm_Horizontal
J23, J24: 18-way-pcb-edge-Educ-8-connectors; PCB_18pin
R1, R2, R3, R4, R5, R6, R7, R8: 220R; R_Axial_DIN0207_L6.3mm_D2.5mm_P15.24mm_Horizontal
U1: 74LS164; DIP-14_W7.62mm
U2: 74LS139; DIP-16_W7.62mm
U3: 74LS04
U4: 74LS04; DIP-14_W7.62mm_LongPads
U5: 74LS37; DIP-14_W7.62mm
U6, U7: 74LS75; DIP-16_W7.62mm
U8, U12, U13: 74LS151; DIP-16_W7.62mm
U9: 74LS138; DIP-16_W7.62mm_LongPads
U10, U11, U14, U15: 74LS138; DIP-16_W7.62mm
U20: 7400

Connections:
+5V: C1.1, C2.1, C3.1, C4.1, C5.1, C6.1, J24.4, U1.9 (~CLR), U1.14 (+5V), U2.15 (E), U2.16 (VCC), U3.14 (VCC), U4.14 (VCC), U5.14 (VCC), U7.5 (VCC), U8.16 (VCC), U9.6 (E3), U9.16 (VCC), U10.6 (E3), U10.16 (VCC), U11.6 (E3), U11.16 (VCC), U12.16 (VCC), U13.16 (VCC), U14.6 (E3), U14.16 (VCC), U15.6 (E3), U15.16 (VCC), U20.14 (VCC)
/~EL1: U3.6, U20.10, U20.13
ID0_~CLOCK: J23.16, U11.5 (E2)
ID0_~DATA: J23.13, U9.5 (E2)
ID0_~FLAG: J23.14, U5.11
ID0_~RST_FLAG: J23.15, U10.5 (E2)
ID1_~CLOCK: J20.37, J23.12, U1.8 (~CLK)
ID1_~DATA: J20.35, J23.9, U5.1, U5.2
ID1_~FLAG: J20.33, J23.10
ID1_~RST_FLAG: J20.39, J23.11, U3.5
ID_MA0: U7.16 (Q0), U12.11 (S0), U13.11 (S0), U14.1 (A0), U15.1 (A0)
ID_MA1: U7.15 (Q1), U12.10 (S1), U13.10 (S1), U14.2 (A1), U15.2 (A1)
ID_MA2: U7.10 (Q2), U12.9 (S2), U13.9 (S2), U14.3 (A2), U15.3 (A2)
ID_MA3: J23.8, U7.9 (Q3), U15.5 (E2)
ID~CLOCK_1: J4.7, U15.15 (O0)
ID~CLOCK_2: J4.8, U15.14 (O1)
ID~CLOCK_3: J5.7, U15.13 (O2)
ID~CLOCK_4: J5.8, U15.12 (O3)
ID~CLOCK_5: J6.7, U15.11 (O4)
ID~CLOCK_6: J6.8, U15.10 (O5)
ID~CLOCK_7: J7.7, U15.9 (O6)
ID~CLOCK_8: J7.8, U15.7 (O7)
ID~DATA_1: J4.9, U13.4 (I0)
ID~DATA_2: J4.10, U13.3 (I1)
ID~DATA_3: J5.9, U13.2 (I2)
ID~DATA_4: J5.10, U13.1 (I3)
ID~DATA_5: J6.9, U13.15 (I4)
ID~DATA_6: J6.10, U13.14 (I5)
ID~DATA_7: J7.9, U13.13 (I6)
ID~DATA_8: J7.10, U13.12 (I7)
ID~FLAG_1: J4.1, U12.4 (I0)
ID~FLAG_2: J4.2, U12.3 (I1)
ID~FLAG_3: J5.1, U12.2 (I2)
ID~FLAG_4: J5.2, U12.1 (I3)
ID~FLAG_5: J6.1, U12.15 (I4)
ID~FLAG_6: J6.2, U12.14 (I5)
ID~FLAG_7: J7.1, U12.13 (I6)
ID~FLAG_8: J7.2, U12.12 (I7)
ID~RST_1: J4.3, U14.15 (O0)
ID~RST_2: J4.4, U14.14 (O1)
ID~RST_3: J5.3, U14.13 (O2)
ID~RST_4: J5.4, U14.12 (O3)
ID~RST_5: J6.3, U14.11 (O4)
ID~RST_6: J6.4, U14.10 (O5)
ID~RST_7: J7.3, U14.9 (O6)
ID~RST_8: J7.4, U14.7 (O7)
MA0: J20.31, U1.13 (QH), U4.9, U6.2 (D0), U7.2 (D0)
MA1: J20.29, U1.12 (QG), U4.11, U6.3 (D1), U7.3 (D1)
MA2: J20.27, U1.11 (QF), U4.13, U6.6 (D2), U7.6 (D2)
MA3: J20.25, U1.10 (QE), U4.1, U6.7 (D3), U7.7 (D3)
MA4: J20.23, U1.6 (QD), U4.3
MA5: J20.21, U1.5 (QC), U4.5
MA6: J20.19, U1.4 (QB), U2.2 (A0), U3.13
MA7: J20.17, U1.3 (QA), U2.3 (A1), U3.11
unnamed: D1.2 (A), R1.2
unnamed: D2.2 (A), R2.2
unnamed: D3.2 (A), R3.2
unnamed: D4.2 (A), R4.2
unnamed: D5.2 (A), R5.2
unnamed: D6.2 (A), R6.2
unnamed: D7.2 (A), R7.2
unnamed: D8.2 (A), R8.2
unnamed: R1.1, U3.10
unnamed: R2.1, U3.12
unnamed: R3.1, U4.6
unnamed: R4.1, U4.4
unnamed: R5.1, U4.2
unnamed: R6.1, U4.12
unnamed: R7.1, U4.10
unnamed: R8.1, U4.8
unnamed: U1.1 (A), U1.2 (B), U5.3
unnamed: U2.4 (O0), U20.1, U20.2
unnamed: U2.5 (O1), U20.4, U20.5
unnamed: U3.2, U6.4 (E23), U6.13 (E01)
unnamed: U3.4, U7.4 (E23), U7.13 (E01)
unnamed: U5.12, U5.13, U8.5 (Z)
unnamed: U5.4, U5.5, U12.5 (Z)
unnamed: U12.7 (~E), U13.7 (~E), U14.4 (E1), U15.4 (E1)
unnamed: U5.9, U5.10, U13.5 (Z)
unnamed: U20.6, U20.9
unnamed: U3.3, U20.8
unnamed: U3.1, U20.11
unnamed: U20.3, U20.12
OD0_~DATA: J23.5, U5.8
OD0_~FLAG: J23.6, U5.6
OD0_~RST_FLAG: J23.7, U14.5 (E2)
OD1_~CLOCK: J1.4, J23.4
OD1_~DATA: J1.1, J23.1
OD1_~FLAG: J1.2, J23.2
OD1_~RST_FLAG: J1.3, J23.3
OD_MA0: U6.16 (Q0), U8.11 (S0), U9.1 (A0), U10.1 (A0), U11.1 (A0)
OD_MA1: U6.15 (Q1), U8.10 (S1), U9.2 (A1), U10.2 (A1), U11.2 (A1)
OD_MA2: U6.10 (Q2), U8.9 (S2), U9.3 (A2), U10.3 (A2), U11.3 (A2)
OD_MA3: U6.9 (Q3), U8.7 (~E), U9.4 (E1), U10.4 (E1), U11.4 (E1)
OD~CLOCK_1: J8.7, U11.15 (O0)
OD~CLOCK_2: J8.8, U11.14 (O1)
OD~CLOCK_3: J9.7, U11.13 (O2)
OD~CLOCK_4: J9.8, U11.12 (O3)
OD~CLOCK_5: J10.7, U11.11 (O4)
OD~CLOCK_6: J10.8, U11.10 (O5)
OD~CLOCK_7: J11.7, U11.9 (O6)
OD~CLOCK_8: J11.8, U11.7 (O7)
OD~DATA_1: J8.9, U9.15 (O0)
OD~DATA_2: J8.10, U9.14 (O1)
OD~DATA_3: J9.9, U9.13 (O2)
OD~DATA_4: J9.10, U9.12 (O3)
OD~DATA_5: J10.9, U9.11 (O4)
OD~DATA_6: J10.10, U9.10 (O5)
OD~DATA_7: J11.9, U9.9 (O6)
OD~DATA_8: J11.10, U9.7 (O7)
OD~FLAG_1: J8.1, U8.4 (I0)
OD~FLAG_2: J8.2, U8.3 (I1)
OD~FLAG_3: J9.1, U8.2 (I2)
OD~FLAG_4: J9.2, U8.1 (I3)
OD~FLAG_5: J10.1, U8.15 (I4)
OD~FLAG_6: J10.2, U8.14 (I5)
OD~FLAG_7: J11.1, U8.13 (I6)
OD~FLAG_8: J11.2, U8.12 (I7)
OD~RST_1: J8.3, U10.15 (O0)
OD~RST_2: J8.4, U10.14 (O1)
OD~RST_3: J9.3, U10.13 (O2)
OD~RST_4: J9.4, U10.12 (O3)
OD~RST_5: J10.3, U10.11 (O4)
OD~RST_6: J10.4, U10.10 (O5)
OD~RST_7: J11.3, U10.9 (O6)
OD~RST_8: J11.4, U10.7 (O7)
~EL2: J20.15, U2.6 (O2)
~EL3: J20.13, U2.7 (O3)

Notes on the sheet:
Card installed in EDUC-8 Computer is fixed to lower 8 banks
MA5 - MA7 are for latch addressing. MA3 selects lower or upper 8 multiplexer banks
G'day Gwyllym, >Please find attached the images for the relay driver which was originally >designed by Jim Rowe... Is this for the paper tape punch? For the multiplexer, I realised that an SR FF with two NAND gates could be used. We have for an SR FF Q := inv(Q_*S_) Q_ := inv(Q*R_*MR_) where S_ is 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
FIX THIS ADDRESSING, ITS A MESS
ID LATCH
OD LATCH
LSB
UART CONNECTIONS
~{EL}=~{ENABLE} LATCH~{.} MAY CHANGE TO 2 X 4 DECODERS
ADDRESS STATUS DISPLAY
INPUT CONNECTIONS

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
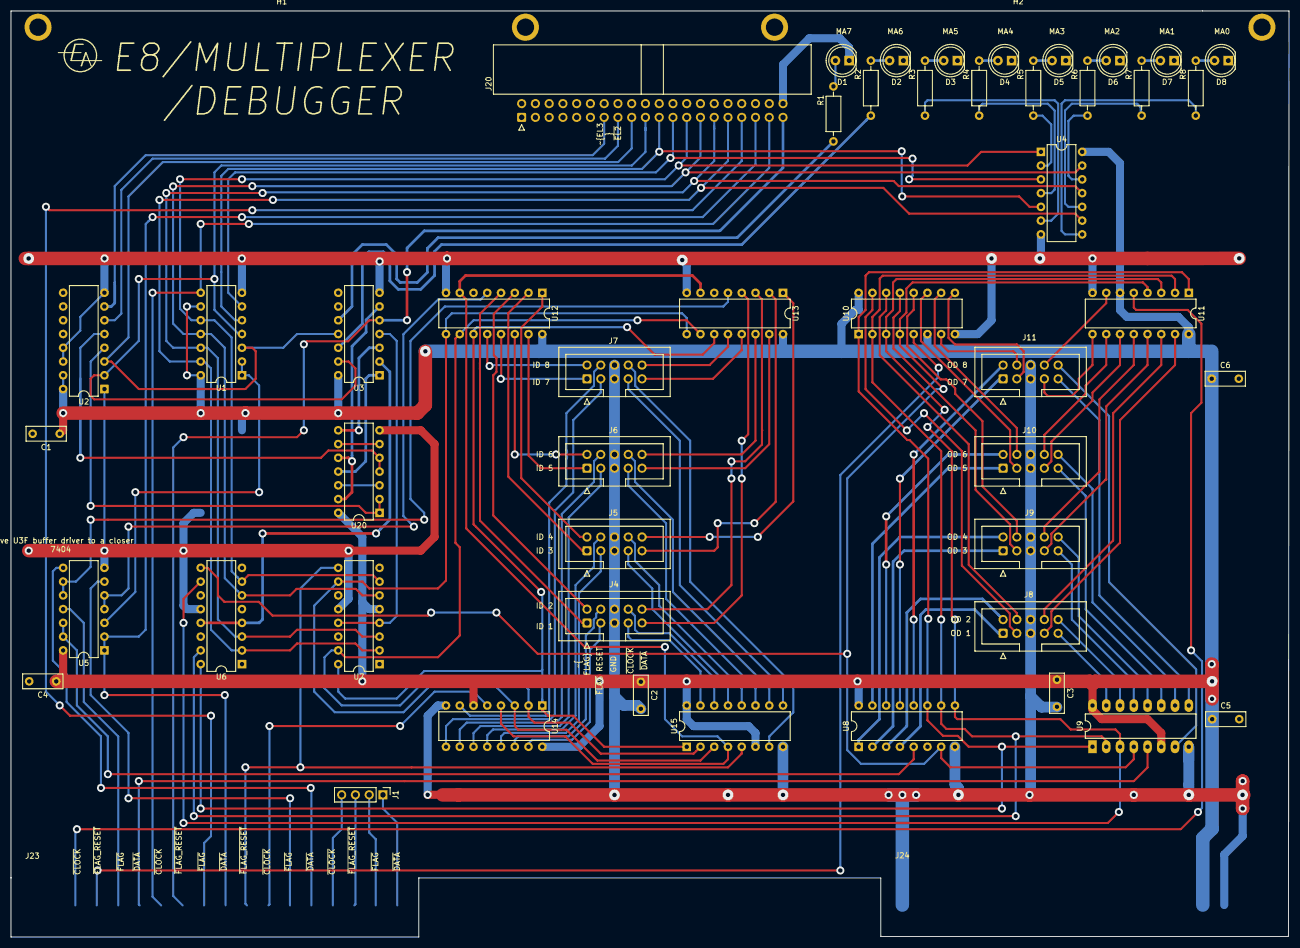
[picture p290: board multiplexer.kicad_pcb from above]

Board: 2 copper layers, 236.0 x 171.0 mm, 52 parts (0 on the bottom side), 129 nets.
