ibm2030/EDUC8/multiplexer/E8MX:M/E8Memory expansion/E8ME/E8ME.kicad_pcb

## KiCad design multiplexer/E8MX:M/E8Memory expansion/E8ME/E8ME.kicad_pcb (2023-03-05)

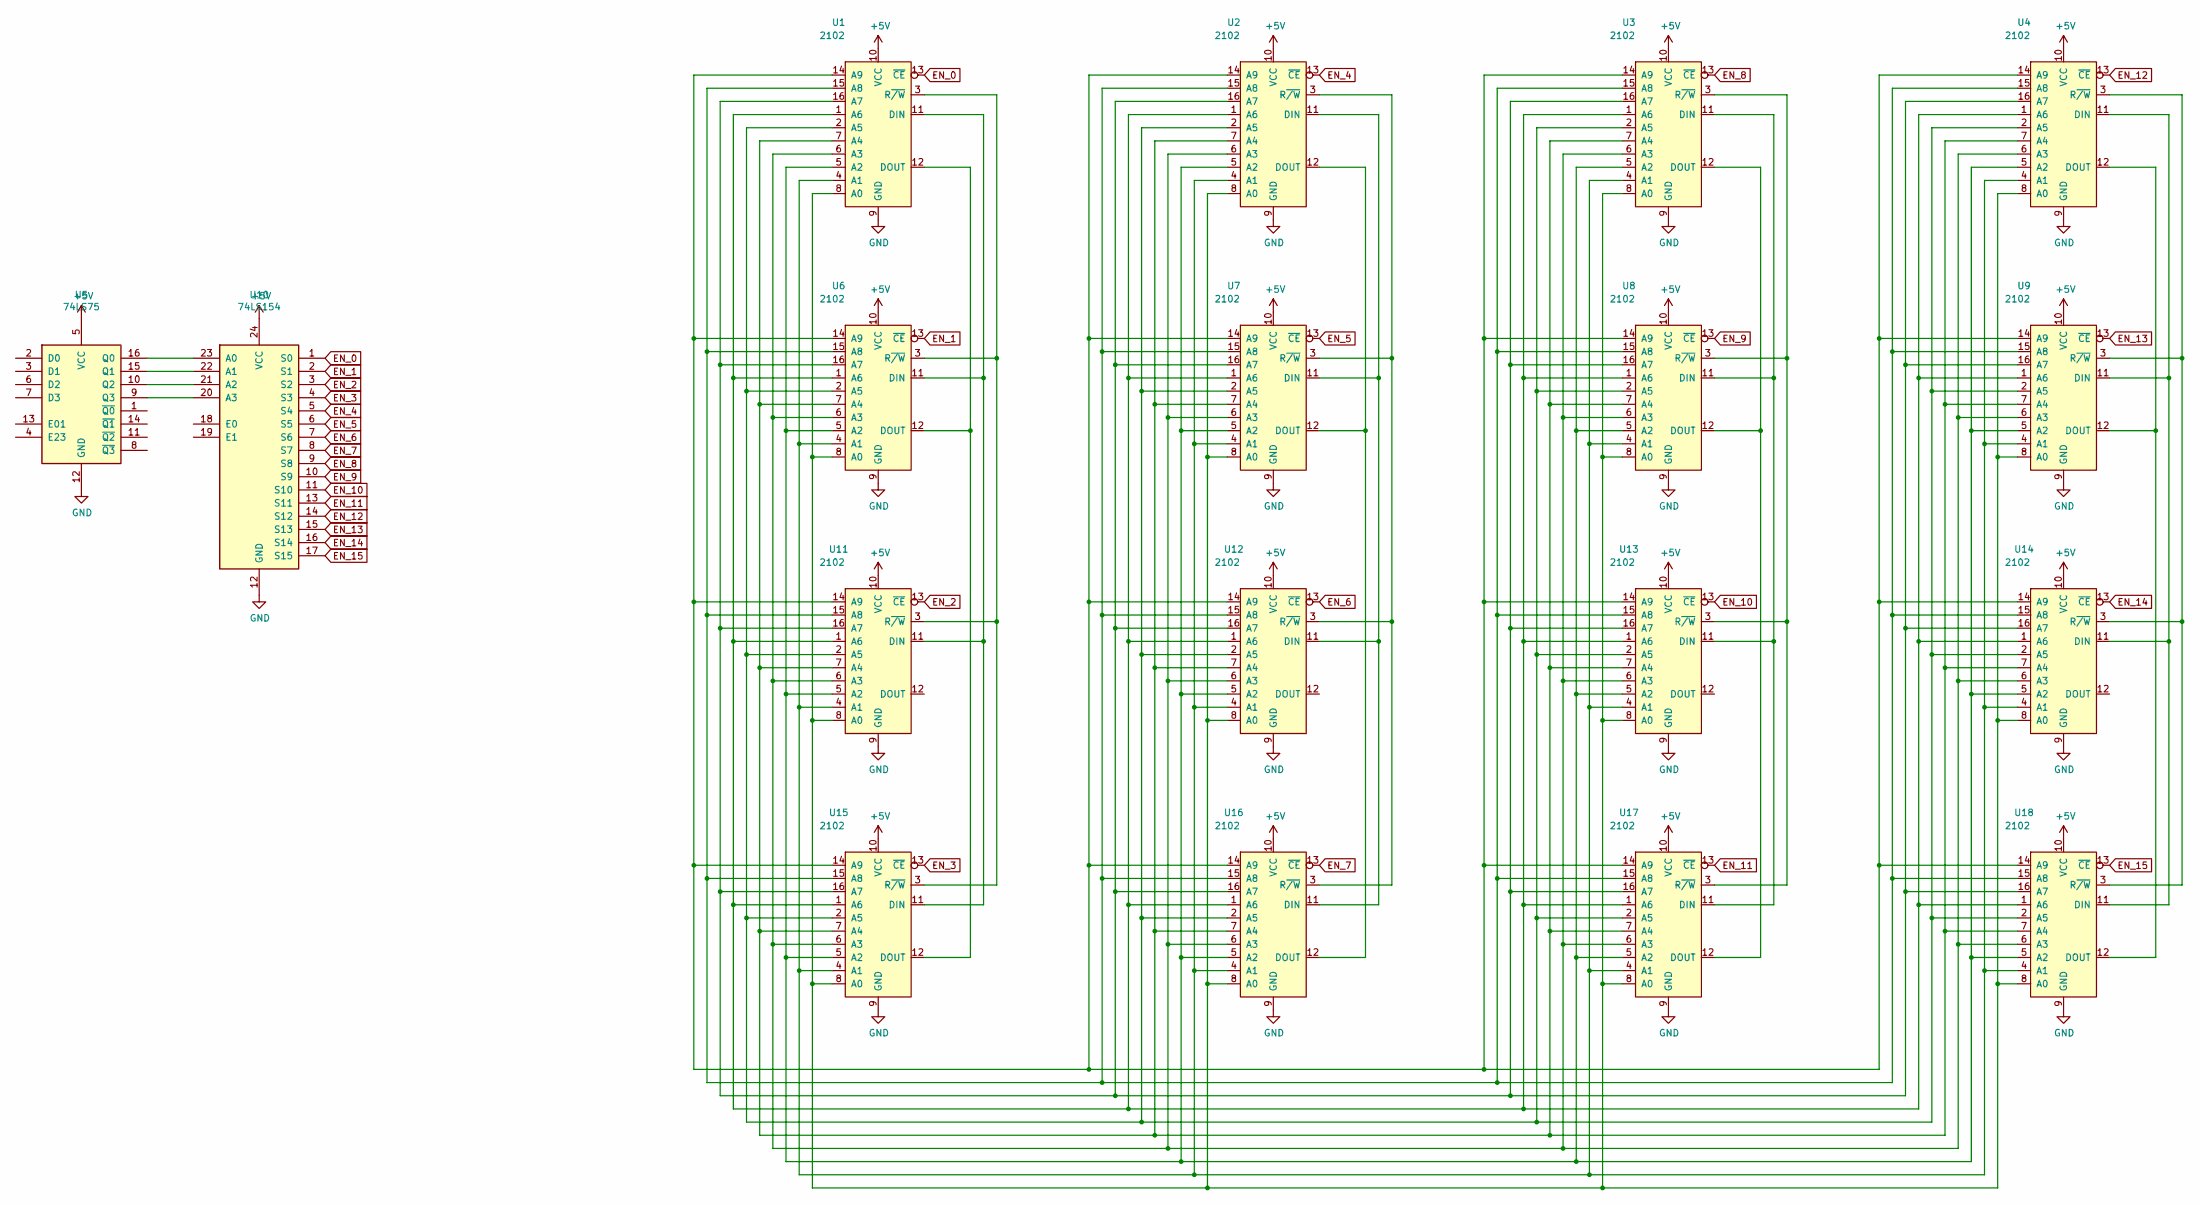
[picture p291: schematic E8ME.sch]

Parts:
U1, U2, U3, U4, U6, U7, U8, U9, U11, U12, U13, U14, U15, U16, U17, U18: 2102; DIP-16_W7.62mm_LongPads
U5: 74LS75; DIP-16_W7.62mm_LongPads
U10: 74LS154; DIP-24_W15.24mm_LongPads

Connections:
+5V: U1.10 (VCC), U2.10 (VCC), U3.10 (VCC), U4.10 (VCC), U5.5 (VCC), U6.10 (VCC), U7.10 (VCC), U8.10 (VCC), U9.10 (VCC), U10.24 (VCC), U11.10 (VCC), U12.10 (VCC), U13.10 (VCC), U14.10 (VCC), U15.10 (VCC), U16.10 (VCC), U17.10 (VCC), U18.10 (VCC)
EN_0: U1.13 (~CE), U10.1 (S0)
EN_1: U6.13 (~CE), U10.2 (S1)
EN_2: U10.3 (S2), U11.13 (~CE)
EN_3: U10.4 (S3), U15.13 (~CE)
EN_4: U2.13 (~CE), U10.5 (S4)
EN_5: U7.13 (~CE), U10.6 (S5)
EN_6: U10.7 (S6), U12.13 (~CE)
EN_7: U10.8 (S7), U16.13 (~CE)
EN_8: U3.13 (~CE), U10.9 (S8)
EN_9: U8.13 (~CE), U10.10 (S9)
EN_10: U10.11 (S10), U13.13 (~CE)
EN_11: U10.13 (S11), U17.13 (~CE)
EN_12: U4.13 (~CE), U10.14 (S12)
EN_13: U9.13 (~CE), U10.15 (S13)
EN_14: U10.16 (S14), U14.13 (~CE)
EN_15: U10.17 (S15), U18.13 (~CE)
GND: U1.9 (GND), U2.9 (GND), U3.9 (GND), U4.9 (GND), U5.12 (GND), U6.9 (GND), U7.9 (GND), U8.9 (GND), U9.9 (GND), U10.12 (GND), U11.9 (GND), U12.9 (GND), U13.9 (GND), U14.9 (GND), U15.9 (GND), U16.9 (GND), U17.9 (GND), U18.9 (GND)
unnamed: U1.1 (A6), U2.1 (A6), U3.1 (A6), U4.1 (A6), U6.1 (A6), U7.1 (A6), U8.1 (A6), U9.1 (A6), U11.1 (A6), U12.1 (A6), U13.1 (A6), U14.1 (A6), U15.1 (A6), U16.1 (A6), U17.1 (A6), U18.1 (A6)
unnamed: U1.2 (A5), U2.2 (A5), U3.2 (A5), U4.2 (A5), U6.2 (A5), U7.2 (A5), U8.2 (A5), U9.2 (A5), U11.2 (A5), U12.2 (A5), U13.2 (A5), U14.2 (A5), U15.2 (A5), U16.2 (A5), U17.2 (A5), U18.2 (A5)
unnamed: U1.3 (R~/W), U6.3 (R~/W), U11.3 (R~/W), U15.3 (R~/W)
unnamed: U1.4 (A1), U2.4 (A1), U3.4 (A1), U4.4 (A1), U6.4 (A1), U7.4 (A1), U8.4 (A1), U9.4 (A1), U11.4 (A1), U12.4 (A1), U13.4 (A1), U14.4 (A1), U15.4 (A1), U16.4 (A1), U17.4 (A1), U18.4 (A1)
unnamed: U1.5 (A2), U2.5 (A2), U3.5 (A2), U4.5 (A2), U6.5 (A2), U7.5 (A2), U8.5 (A2), U9.5 (A2), U11.5 (A2), U12.5 (A2), U13.5 (A2), U14.5 (A2), U15.5 (A2), U16.5 (A2), U17.5 (A2), U18.5 (A2)
unnamed: U1.6 (A3), U2.6 (A3), U3.6 (A3), U4.6 (A3), U6.6 (A3), U7.6 (A3), U8.6 (A3), U9.6 (A3), U11.6 (A3), U12.6 (A3), U13.6 (A3), U14.6 (A3), U15.6 (A3), U16.6 (A3), U17.6 (A3), U18.6 (A3)
unnamed: U1.7 (A4), U2.7 (A4), U3.7 (A4), U4.7 (A4), U6.7 (A4), U7.7 (A4), U8.7 (A4), U9.7 (A4), U11.7 (A4), U12.7 (A4), U13.7 (A4), U14.7 (A4), U15.7 (A4), U16.7 (A4), U17.7 (A4), U18.7 (A4)
unnamed: U1.8 (A0), U2.8 (A0), U3.8 (A0), U4.8 (A0), U6.8 (A0), U7.8 (A0), U8.8 (A0), U9.8 (A0), U11.8 (A0), U12.8 (A0), U13.8 (A0), U14.8 (A0), U15.8 (A0), U16.8 (A0), U17.8 (A0), U18.8 (A0)
unnamed: U1.11 (DIN), U6.11 (DIN), U11.11 (DIN), U15.11 (DIN)
unnamed: U1.12 (DOUT), U6.12 (DOUT), U15.12 (DOUT)
unnamed: U1.14 (A9), U2.14 (A9), U3.14 (A9), U4.14 (A9), U6.14 (A9), U7.14 (A9), U8.14 (A9), U9.14 (A9), U11.14 (A9), U12.14 (A9), U13.14 (A9), U14.14 (A9), U15.14 (A9), U16.14 (A9), U17.14 (A9), U18.14 (A9)
unnamed: U1.15 (A8), U2.15 (A8), U3.15 (A8), U4.15 (A8), U6.15 (A8), U7.15 (A8), U8.15 (A8), U9.15 (A8), U11.15 (A8), U12.15 (A8), U13.15 (A8), U14.15 (A8), U15.15 (A8), U16.15 (A8), U17.15 (A8), U18.15 (A8)
unnamed: U1.16 (A7), U2.16 (A7), U3.16 (A7), U4.16 (A7), U6.16 (A7), U7.16 (A7), U8.16 (A7), U9.16 (A7), U11.16 (A7), U12.16 (A7), U13.16 (A7), U14.16 (A7), U15.16 (A7), U16.16 (A7), U17.16 (A7), U18.16 (A7)
unnamed: U5.9 (Q3), U10.20 (A3)
unnamed: U5.10 (Q2), U10.21 (A2)
unnamed: U5.15 (Q1), U10.22 (A1)
unnamed: U5.16 (Q0), U10.23 (A0)
unnamed: U2.3 (R~/W), U7.3 (R~/W), U12.3 (R~/W), U16.3 (R~/W)
unnamed: U2.11 (DIN), U7.11 (DIN), U12.11 (DIN), U16.11 (DIN)
unnamed: U3.3 (R~/W), U8.3 (R~/W), U13.3 (R~/W), U17.3 (R~/W)
unnamed: U3.11 (DIN), U8.11 (DIN), U13.11 (DIN), U17.11 (DIN)
unnamed: U4.3 (R~/W), U9.3 (R~/W), U14.3 (R~/W), U18.3 (R~/W)
unnamed: U4.11 (DIN), U9.11 (DIN), U14.11 (DIN), U18.11 (DIN)
unnamed: U2.12 (DOUT), U7.12 (DOUT), U16.12 (DOUT)
unnamed: U3.12 (DOUT), U8.12 (DOUT), U17.12 (DOUT)
unnamed: U4.12 (DOUT), U9.12 (DOUT), U18.12 (DOUT)

Board: 2 copper layers, 18 parts (0 on the bottom side), 44 nets, no tracks yet.
