ibm2030/EDUC8/multiplexer/Rear connector board/Rear connector board .kicad_pcb

## KiCad design multiplexer/Rear connector board/Rear connector board .kicad_pcb (2023-03-05)

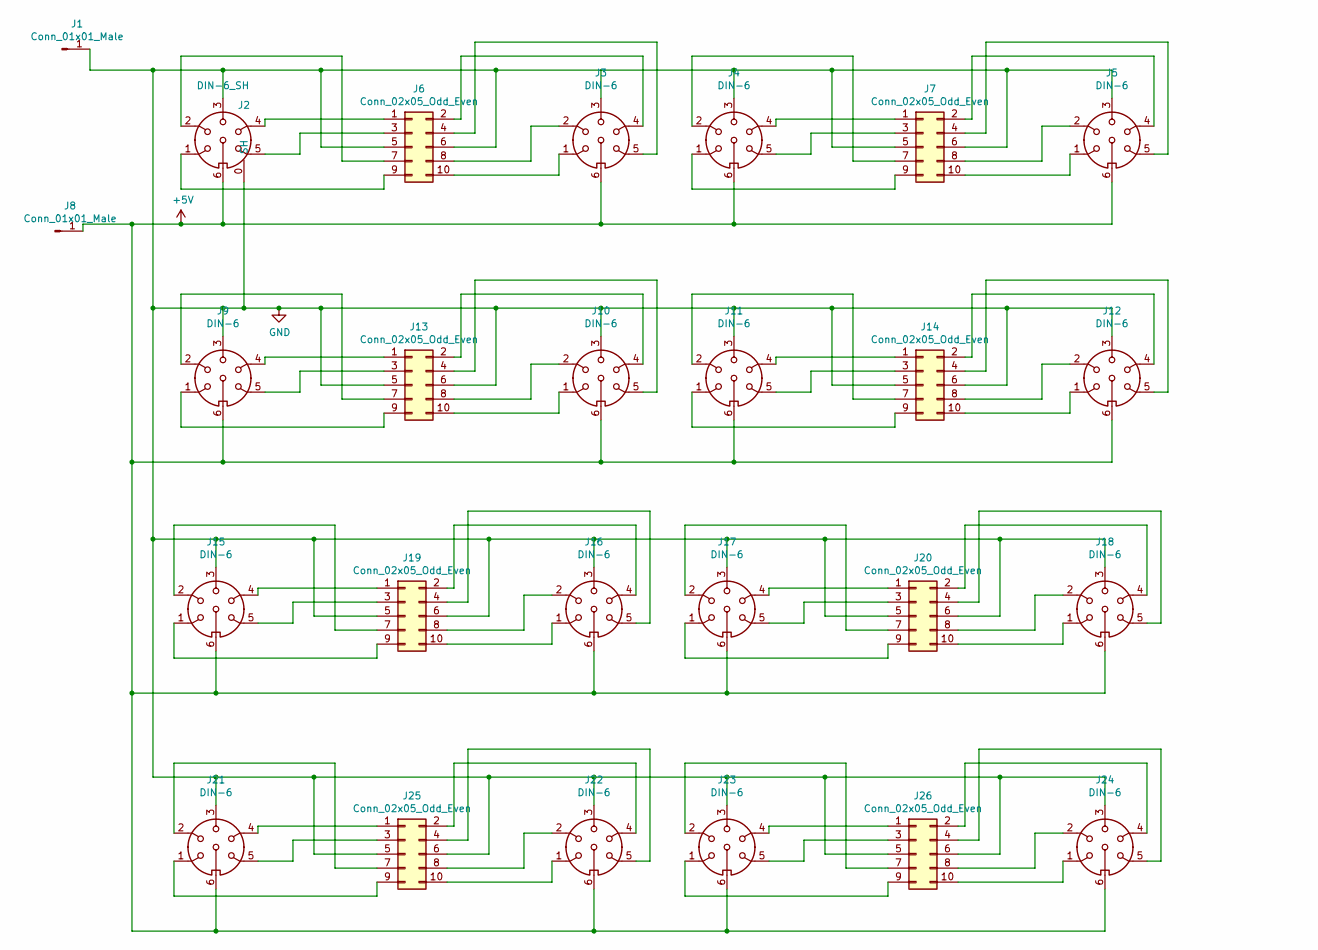
[picture p292: schematic Rear connector board .sch, part in row 1, column 1]

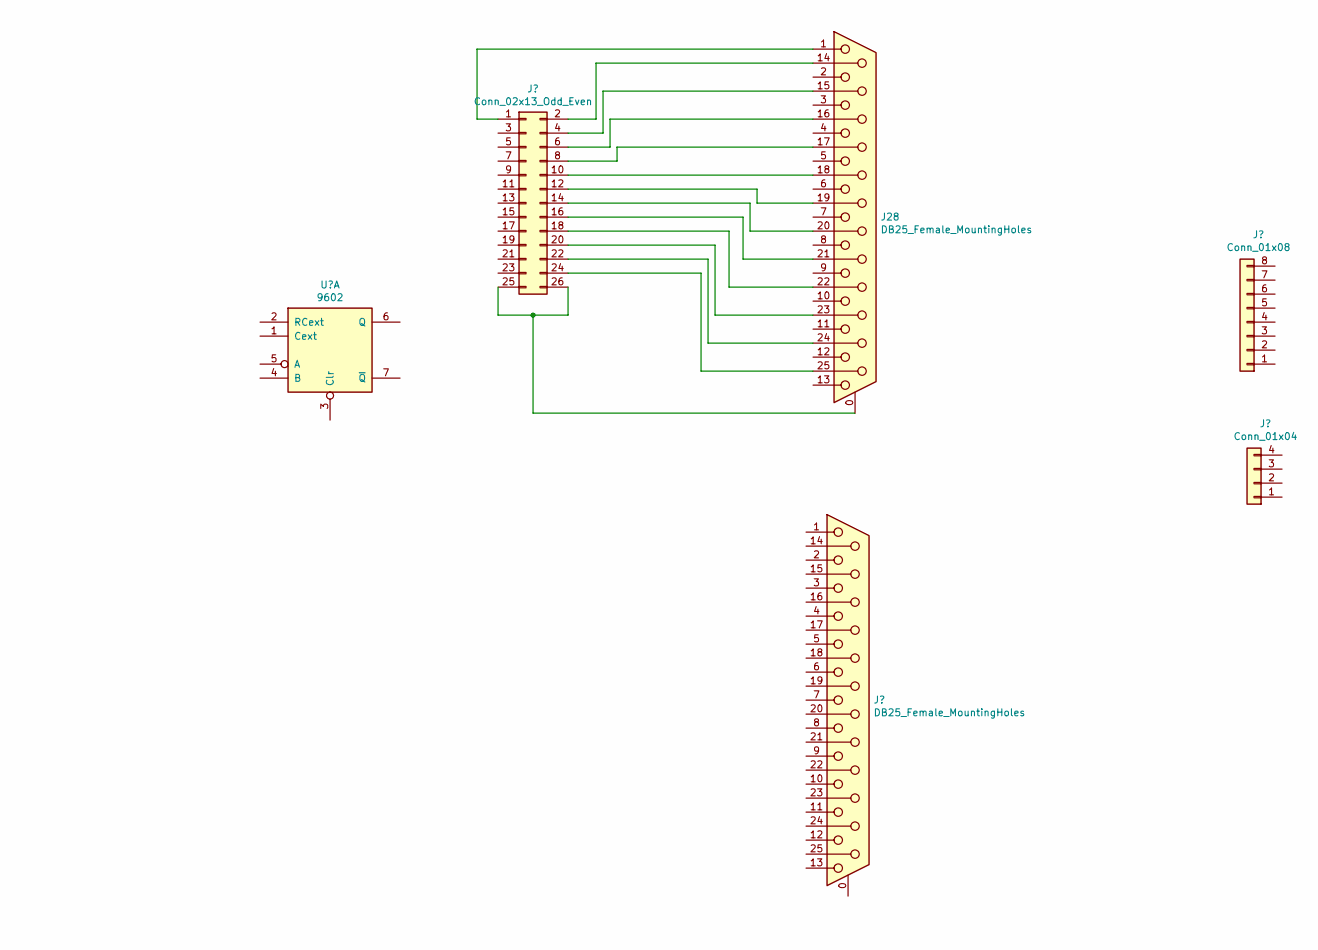
[picture p293: schematic Rear connector board .sch, part in row 1, column 2]

Parts:
J1, J8: Conn_01x01_Male; QC_Terminal_PCB_W6.3mm_P5mm_
J2: DIN-6_SH; 6_PIN_DIN_SOCKET
J3, J4, J5, J9, J10, J11, J12, J15, J16, J17, J18, J21, J22, J23, J24: DIN-6; 6_PIN_DIN_SOCKET
J6, J7, J13, J14, J19, J20, J25, J26: Conn_02x05_Odd_Even; IDC-Header_2x05_P2.54mm_Vertical
J28: DB25_Female_MountingHoles; DSUB-25_Female_Vertical_P2.77x2.84mm_MountingHoles

Connections:
+5V: J2.6, J3.6, J4.6, J5.6, J8.1, J9.6, J10.6, J11.6, J12.6, J15.6, J16.6, J17.6, J18.6, J21.6, J22.6, J23.6, J24.6
GND: J1.1, J2.0 (SH), J2.3, J3.3, J4.3, J5.3, J6.5, J6.6, J7.5, J7.6, J9.3, J10.3, J11.3, J12.3, J13.5, J13.6, J14.5, J14.6, J15.3, J16.3, J17.3, J18.3, J19.5, J19.6, J20.5, J20.6, J21.3, J22.3, J23.3, J24.3, J25.5, J25.6, J26.5, J26.6
unnamed: J2.1, J6.9
unnamed: J2.2, J6.7
unnamed: J2.4, J6.1
unnamed: J2.5, J6.3
unnamed: J3.1, J6.10
unnamed: J3.2, J6.8
unnamed: J3.4, J6.2
unnamed: J3.5, J6.4
unnamed: J4.1, J7.9
unnamed: J4.2, J7.7
unnamed: J4.4, J7.1
unnamed: J4.5, J7.3
unnamed: J5.1, J7.10
unnamed: J5.2, J7.8
unnamed: J5.4, J7.2
unnamed: J5.5, J7.4
unnamed: J10.1, J13.10
unnamed: J10.2, J13.8
unnamed: J10.4, J13.2
unnamed: J10.5, J13.4
unnamed: J11.1, J14.9
unnamed: J11.2, J14.7
unnamed: J11.4, J14.1
unnamed: J11.5, J14.3
unnamed: J12.1, J14.10
unnamed: J12.2, J14.8
unnamed: J12.4, J14.2
unnamed: J12.5, J14.4
unnamed: J9.4, J13.1
unnamed: J9.5, J13.3
unnamed: J9.2, J13.7
unnamed: J9.1, J13.9
unnamed: J15.1, J19.9
unnamed: J15.2, J19.7
unnamed: J15.4, J19.1
unnamed: J15.5, J19.3
unnamed: J16.1, J19.10
unnamed: J16.2, J19.8
unnamed: J16.4, J19.2
unnamed: J16.5, J19.4
unnamed: J17.1, J20.9
unnamed: J17.2, J20.7
unnamed: J17.4, J20.1
unnamed: J17.5, J20.3
unnamed: J18.1, J20.10
unnamed: J18.2, J20.8
unnamed: J18.4, J20.2
unnamed: J18.5, J20.4
unnamed: J21.1, J25.9
unnamed: J21.2, J25.7
unnamed: J21.4, J25.1
unnamed: J21.5, J25.3
unnamed: J22.1, J25.10
unnamed: J22.2, J25.8
unnamed: J22.4, J25.2
unnamed: J22.5, J25.4
unnamed: J23.1, J26.9
unnamed: J23.2, J26.7
unnamed: J23.4, J26.1
unnamed: J23.5, J26.3
unnamed: J24.1, J26.10
unnamed: J24.2, J26.8
unnamed: J24.4, J26.2
unnamed: J24.5, J26.4

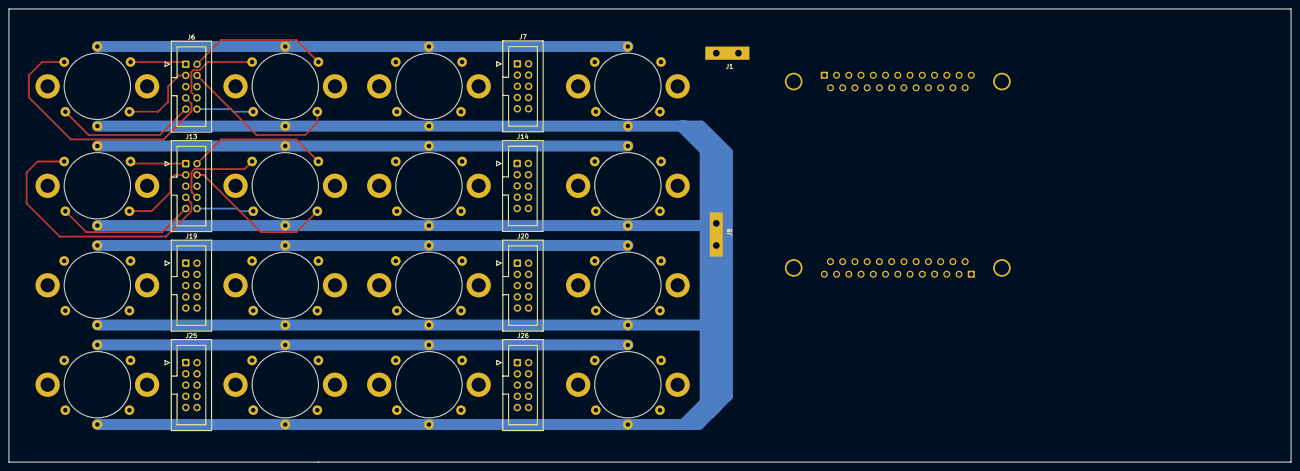
[picture p294: board Rear connector board .kicad_pcb from above]

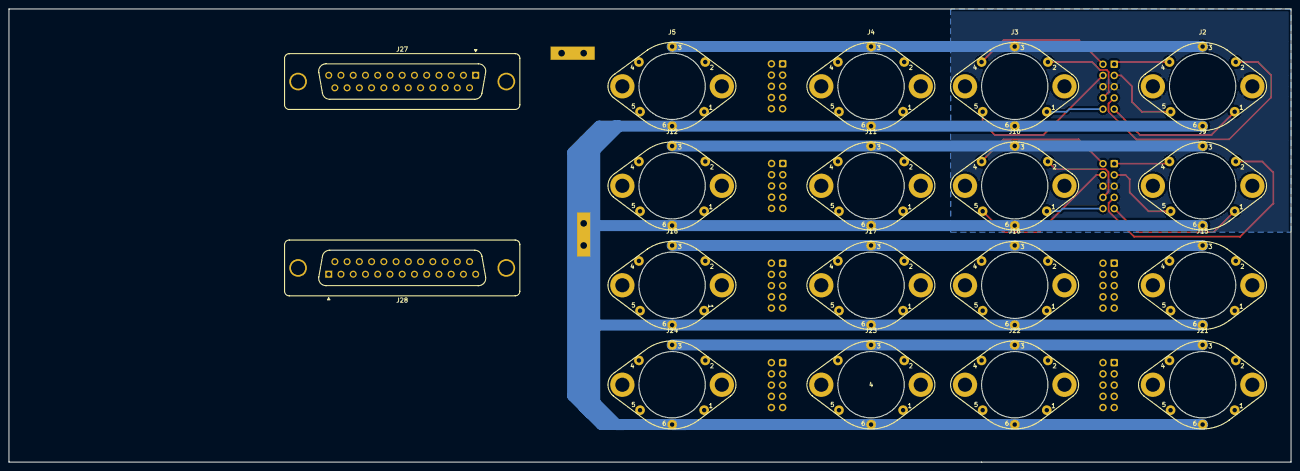
[picture p295: board Rear connector board .kicad_pcb from below]

Board: 2 copper layers, 290.0 x 102.5 mm, 28 parts (18 on the bottom side), 66 nets.

Other parts of the board:
J27: DB25_Female_MountingHoles; DSUB-25_Female_Vertical_P2.77x2.84mm_MountingHoles
