ibm2030/EDUC8/Buffer/Buffer.kicad_pcb

## KiCad design Buffer/Buffer.kicad_pcb (2023-03-05)

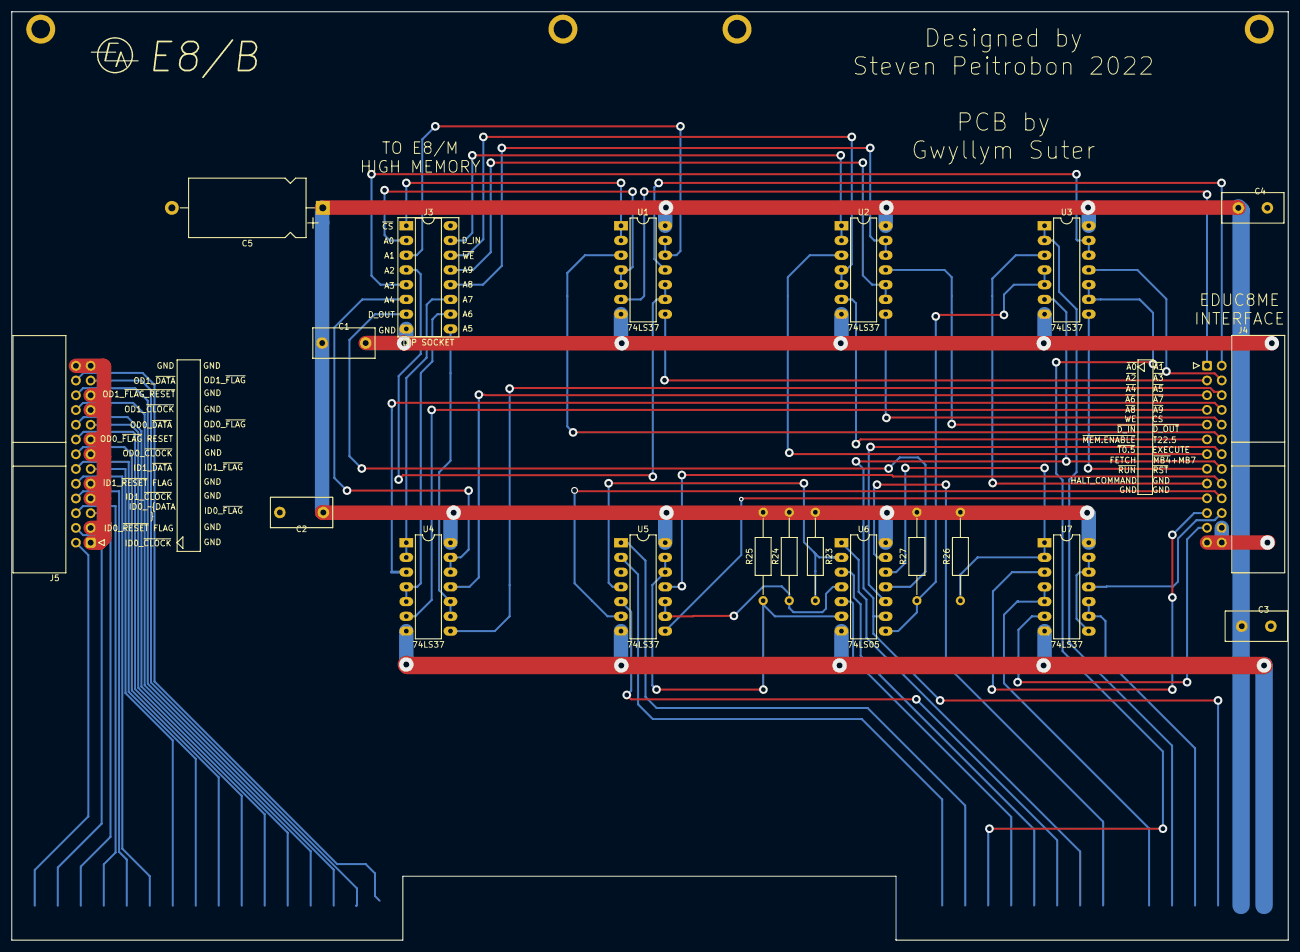
[picture p296: board Buffer.kicad_pcb from above]

Board: 2 copper layers, 220.0 x 160.0 mm, 24 parts (0 on the bottom side), 72 nets.

Parts:
C1, C2: 470nF; C_Disc_D10.5mm_W5.0mm_P7.50mm
C3, C4: 470nF; C_Disc_D10.5mm_W5.0mm_P5.00mm
C5: 100uF; CP_Axial_L20.0mm_D10.0mm_P26.00mm_Horizontal
H1, H2: Card_handle
J1, J2: 16-way-pcb-edge-Educ-8-connectors; PCB_16pin
J3: DIP SOCKET; DIP-16_W7.62mm_Socket_LongPads
J4, J5: Conn_02x13_Odd_Even; IDC-Header_2x13_P2.54mm_Horizontal
R23, R24, R25, R26, R27: R_Small; R_Axial_DIN0207_L6.3mm_D2.5mm_P15.24mm_Horizontal
U1, U2, U3, U4, U5, U7: 74LS37; DIP-14_W7.62mm_LongPads
U6: 74LS05; DIP-14_W7.62mm_LongPads

Connections:
*EXECUTE: J4.18, U5.11
*FETCH: J4.19, U5.8
+5V: C1.1, C2.1, C3.1, C4.1, C5.1, J1.2, R23.1, R24.2, R25.2, R26.2, R27.2, U1.14, U2.14, U3.14, U4.14, U5.14, U6.14, U7.14
A0: J3.2, U1.4, U1.5
A1: J3.3, U1.12, U1.13
A2: J3.4, U1.9, U1.10
A3: J3.5, U3.12, U3.13
A4: J3.6, U4.12, U4.13
A5: J3.9, U4.9, U4.10
A6: J3.10, U4.4, U4.5
A7: J3.11, U4.1, U4.2
A8: J3.12, U2.12, U2.13
A9: J3.13, U2.9, U2.10
CS: J4.12, U1.3
D_IN: J3.15, U2.1, U2.2
D_OUT: J3.7, U6.11
EXECUTE: J1.12, U6.5
FETCH: J1.11, U6.3
GND: C1.2, C2.2, C3.2, C4.2, C5.2, H1.1, H2.1, J1.1, J1.16, J3.8, J4.24, J4.25, J4.26, J5.1, J5.3, J5.7, J5.9, J5.13, J5.15, J5.19, J5.21, J5.25, J5.26, U1.7, U2.7, U3.7, U4.7, U5.7, U6.7, U7.7
HALT_COMMAND: J1.6, U7.4, U7.5
ID0_~CLOCK: J2.16, J5.2
ID0_~DATA: J2.13, J5.6
ID0_~FLAG: J2.14, J5.5
ID0_~RESET_FLAG: J2.15, J5.4
ID1_~CLOCK: J2.12, J5.8
ID1_~DATA: J2.9, J5.12
ID1_~FLAG: J2.10, J5.11
ID1_~RESET_FLAG: J2.11, J5.10
JMP: J1.15, U5.2
JMS: J1.14, U5.1
MB4: J1.9, U6.1
MB7: J1.10, U5.5
MEM.ENABLE: J1.13, U3.9, U3.10
unnamed: R23.2, U5.4, U6.2
unnamed: R24.1, U5.9, U5.10, U6.4
unnamed: R25.1, U5.12, U5.13, U6.6
unnamed: R26.1, U6.12, U7.1, U7.2
unnamed: R27.1, U3.4, U3.5, U6.8
unnamed: U7.8, U7.12, U7.13
OD0_~CLOCK: J2.8, J5.14
OD0_~DATA: J2.5, J5.18
OD0_~FLAG: J2.6, J5.17
OD0_~RESET_FLAG: J2.7, J5.16
OD1_~CLOCK: J2.4, J5.20
OD1_~DATA: J2.1, J5.24
OD1_~FLAG: J2.2, J5.23
OD1_~RESET_FLAG: J2.3, J5.22
T0.5: J1.5, U3.1, U3.2
T22.5: J1.3, J4.16, U3.6, U6.9
WE: J4.11, U2.6
~A0: J4.1, U1.6
~A1: J4.2, U1.11
~A2: J4.3, U1.8
~A3: J4.4, U3.11
~A4: J4.5, U4.11
~A5: J4.6, U4.8
~A6: J4.7, U4.6
~A7: J4.8, U4.3
~A8: J4.9, U2.11
~A9: J4.10, U2.8
~CS: J3.1, U1.1, U1.2
~D_IN: J4.13, U2.3
~D_OUT: J4.14, U6.10
~HALT_COMMAND: J4.23, U7.6
~MB4+~MB7: J4.20, U5.6
~MEMORY_ENABLE: J4.15, U3.8
~RST: J1.4, U7.9, U7.10
~RST*: J4.22, U7.11
~RUN: J1.8, U6.13
~RUN*: J4.21, U7.3
~T0.5: J4.17, U3.3
~WE: J3.14, U2.4, U2.5
