ibm2030/EDUC8/16 way multiplexer/Motherboard/motherboard 2.0.sch

## KiCad design 16 way multiplexer/Motherboard/motherboard 2.0.sch (2023-03-05)

Schematic: motherboard 2.0.sch

Parts:
C1, C2, C3: 100nF; C_Disc_D8.0mm_W5.0mm_P7.50mm
H1, H2, H3, H4, H5, H6: MountingHole_Pad; MountingHole_3.2mm_M3_Pad_Via
J1: E8/T; 72_way_3.96mm_card_edge_socket
J2, J3, J4: 36-way-pcb-edge-socket-Educ-8-connectors; 72_way_3.96mm_card_edge_socket
J5, J6, J7, J8, J9, J10, J11, J25, J26: 36-way-edge-connector; 36_way_3.96mm_card_edge_socket
J12, J13, J19: Conn_01x08_Female; PinHeader_1x08_P2.54mm_Vertical
J14: Conn_01x16_Female; PinHeader_1x16_P2.54mm_Vertical
J15, J16, J18, J20, J21, J22, J23, J24: Conn_01x04_Female; PinHeader_1x04_P2.54mm_Vertical
J17, J27, J29: Conn_01x01_Female; PinHeader_1x01_P2.54mm_Vertical
R1, R2: 470R; R_Axial_DIN0207_L6.3mm_D2.5mm_P10.16mm_Horizontal
R3: 680R; R_Axial_DIN0207_L6.3mm_D2.5mm_P10.16mm_Horizontal
R4: R; R_Axial_DIN0207_L6.3mm_D2.5mm_P10.16mm_Horizontal

Notes on the sheet:
E8-T (TIMING)
E8-D DECODER
E8-M MEMORY
E8-P PROGRAM COUNTER AND ADDER
E8A ACCUMULATOR
E8-IOT
Bus Terminating Resistors
On Motherboard
D_BUS IS NOT USED ON PC. ONLY CONNECTED TO ASSIST WITH TACKING
additional IO to bus board
MULTIPLEXER PORT
