ibm2030/EDUC8/(commit log)

2023-04-08 New PCB with all the corrections made
    [front panel 9602-B_Cu.gbr, front panel 9602-B_Mask.gbr, front panel 9602-B_Paste.gbr, front panel 9602-B_Silkscreen.gbr, front panel 9602-Edge_Cuts.gbr, front panel 9602-F_Cu.gbr, front panel 9602-F_Mask.gbr, front panel 9602-F_Paste.gbr]
2024-04-01 Schematic update for 9001/74105 to 74LS74
2024-04-01 Schematic fixes
2024-06-13 Schematic update 2024-04-14 plus fixes
    [256 word memory 3.kicad_sch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]
2024-06-13 Schematic update 2024-04-14 done
2024-06-29 EDUC-8ME update:\nI've made a fairly large update to EDUC-8ME, a memory and I/O port expansion for EDUC-8. I have moved the unit selection and address decoding logic from E8ME/D to E8ME/I. This means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
2025-07-23 Changes 20-7-2025 E8/T. Connected 3 missing supply rail tracks to ICS Added flood fill top and bottom to reduce noise E8/F Corrected labelling on RHS board to reflect EXT_LA not GND Changed fast slow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
    [128 X 16 RAM V4 FINAL -B_Cu.gbr, 128 X 16 RAM V4 FINAL -B_Mask.gbr, 128 X 16 RAM V4 FINAL -Edge_Cuts.gbr, 128 X 16 RAM V4 FINAL -F_Cu.gbr, 128 X 16 RAM V4 FINAL -F_Mask.gbr, 128 X 16 RAM V4 FINAL -F_Silkscreen.gbr, 128 X 16 RAM V4 FINAL -In1_Cu.gbr, 128 X 16 RAM V4 FINAL -In2_Cu.gbr]
2025-08-27 128x16 RAM V5 update
    [128 X 16 RAM V4 FINAL -B_Cu.gbr, 128 X 16 RAM V4 FINAL -B_Mask.gbr, 128 X 16 RAM V4 FINAL -Edge_Cuts.gbr, 128 X 16 RAM V4 FINAL -F_Cu.gbr, 128 X 16 RAM V4 FINAL -F_Mask.gbr, 128 X 16 RAM V4 FINAL -F_Silkscreen.gbr, 128 X 16 RAM V4 FINAL -In1_Cu.gbr, 128 X 16 RAM V4 FINAL -In2_Cu.gbr]
